TNH510/5_DOF_Robot_Arm/docs/mechatronic_project/report/tinh-toan-tai.md

# TÍNH TOÁN TẢI CHO TAY GẮP

Mục tiêu thiết kế tay gắp:

+ Cải thiện nhược điểm của tay gắp cũ: Không linh hoạt, chỉ có thể gắp vật với hình dạng cố định

+ Thông số vật cần gắp :
  
  | Hình dạng        | Kích thước ước tính | Dạng tay gắp lựa chọn     |
  | ---------------- | ------------------- | ------------------------- |
  | Hình vuông, tròn | max: 15x15x15       | Cơ cấu tay quay con trượt |

+ Tham khảo:
  
  [(PDF) Nghiên cứu thiết kế và điều khiển tay máy gắp các thùng CARTON sắp xếp lên PALLET | CƯỜNG Nguyễn Mạnh - Academia.edu](https://www.academia.edu/44552057/Nghi%C3%AAn_c%E1%BB%A9u_thi%E1%BA%BFt_k%E1%BA%BF_v%C3%A0_%C4%91i%E1%BB%81u_khi%E1%BB%83n_tay_m%C3%A1y_g%E1%BA%AFp_c%C3%A1c_th%C3%B9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)[(PDF) Nghiên cứu thiết kế và điều khiển tay máy gắp các thùng CARTON sắp xếp lên PALLET | CƯỜNG Nguyễn Mạnh - Academia.edu](https://www.academia.edu/44552057/Nghi%C3%AAn_c%E1%BB%A9u_thi%E1%BA%BFt_k%E1%BA%BF_v%C3%A0_%C4%91i%E1%BB%81u_khi%E1%BB%83n_tay_m%C3%A1y_g%E1%BA%AFp_c%C3%A1c_th%C3%B9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)

+ Link thông số động cơ: https://www.tinytronics.nl/shop/en/mechanics-and-actuators/motors/servomotors/td-8120mg-waterproof-digital-servo-20kg

+
