TNH510/5_DOF_Robot_Arm/control_glove/docs/UART_NOTE.txt

- ENTER AT MODE:
    + Connect all pins and VCC (NOT CONNECT SET PIN)
    + Connect SET PIN to GND
- Test on terminal:
    + MUST CHOOSE: Baurate 9600, Mode auto send CR+LF
    + Test: Send "AT" and wait for respone
- Exit AT MODE:
    + MUST DISCONNECT SET PIN FIRST
    + Disconnect VCC and checks
-----------------------------------------------------------
Send: AT+RX
Rp:
OK+B115200<\r><\n>
 OK+C150<\r><\n>
 OK+RP:+8dBm<\r><\n>
 OK+FU3
-------------------------------
AT
AT+P5
AT+FU1
