TNH510/5_DOF_Robot_Arm/control_glove/docs/thiet_ke_chon_bo_truyen.md

# Thiết kế bộ truyền cho khớp khủy tay găng tay điều khiển
## Yêu cầu bộ truyền
- Nhỏ gọn do cần đeo trong thời gian dài
- Chỉ cần truyền ở khoảng cách gần do chỉ cần truyền đến biến trở
- Chịu được lực gây ra khi gập và duỗi khủy tay
## Các loại bộ truyền có thể lựa chọn
- Bộ truyền xích: Cồng kềnh, không phù hợp để đeo lên tay
- Bộ truyền đai: Dễ tìm mua, nhỏ gọn tuy nhiên so với bộ truyền bánh răng thì vẫn
cồng kềnh hơn, tốn diện tích thiết kế hơn, giá thành đắt hơn
- Bộ truyền bánh răng trụ: Dễ tìm mua, nhỏ gọn dễ thiết kế
## Tính toán lựa chọn các kích thước
- Kích thước đã biết: 
  - Trục biến trở: 6mm
- Chọn trục tại vị trí khủy tay là 6mm
- Chọn bánh răng trụ đồng: [Bánh răng trụ thép](https://www.thegioiic.com/1m40t-6-banh-rang-40-rang-buoc-3-14mm-day-dai-10mm-lo-6mm) 
- Bộ truyền bánh răng có tỉ số truyền 1:1
## Vẽ mô hình 3D
