TNH510/5_DOF_Robot_Arm/control_glove/docs/general.md

## Găng tay điều khiển 
### Các thành phần cần có:
- Bộ điều khiển trung tâm: STM32F4
- Cảm biến phát hiện chuyển động: MPU6050
- Cảm biến từ trường: HMC5883L
- Pin
- Nút nhấn
- Module RF
- Găng tay
