TNH510/5_DOF_Robot_Arm/docs/final_project/thach/Content_to_be_done.md

# Những nội dung chính
## Kiến thức cơ bản
### Giới thiệu về C#
1. Sơ lược về C#
2. Ứng dụng của C#
### Giới thiệu về WPF trong C#
1. Sơ lược về WPF
2. Ứng dụng của WPF
3. Làm việc với giao diện
   - Điều khiển trên giao diện
   - Cách cài đặt thư viện
4. Làm việc với code
   - Giới thiệu về Timer
   - Giới thiệu về Luồng (Thread)
   - Giới thiệu sơ lược về cách tạo hàm tạo biến trong C#
     - Cấu trúc quản lí code
     - Các kiểu khai báo dữ liệu.
     - Các kiểu tạo hàm
