TNH510/5_DOF_Robot_Arm/docs/final_project/other/adaptive_control.md

1. Connect UART
2. Click the ENABLE button (Glove_Connect_Click function)
3. Type as format: "Xaxis","Yaxis", "Zaxis", "theta5"
4. Enjoy
