TNH510/5_DOF_Robot_Arm/docs/final_project/hieu/main_idea.md

# Những nội dung chính
## Kiến thức cơ bản
### Vi điều khiển ARM Cotex M3/M4
1. Giới thiệu về vi điều khiển ARM Cotex M
2. Ngôn ngữ lập trình C
### Cảm biến gygroscope, cảm biến gia tốc và cảm biến từ trường
1. Cảm biến Gygroscope
2. Cảm biến gia tốc
3. Cảm biến từ trường
### Biểu diễn hướng của vật thể trong không gian
1. Các góc Euler
2. Ma trận Quaternion
### Chuẩn giao tiếp UART và I2C
1. UART
2. I2C
## Thiết kế nguyên lí và cách điều khiển 
1. Các nghiên cứu trên thế giới
2. Lựa chọn giải pháp
3. Thiết kế lưu đồ giải thuật cho hệ thống
## Tính toán lựa chọn phần cứng cho găng tay điều khiển
1. Chọn lựa linh kiện chính
-  Vi điều khiển STM32F401CCU
- Cảm biến 6 trục MPU6050
- Cảm biến từ trường HMC5883L
- Biến trở
- Module UART không dây GT-38
1. Thiết kế mạch in
2. Thiết kế cơ khí 
## Quá trình thực hiện
1. Thực hiện giao tiếp giữa MCU và các cảm biến
2. Tiến hành lấy data và calib lại các cảm biến
3. Viết thuật toán lọc nhiễu và xử lí giá trị góc thu được
4. Giao tiếp không dây giữa vi điều khiển và máy tính
5. Tiến hành vẽ mạch in và in mạch thử nghiệm
6. Tiến hành chế tạo mô hình găng tay thử nghiệm
7. Thực hiện tính toán động học thuận của găng tay
8. Viết thuật toán chuyển đổi từ vị trí cánh tay sang vị trí của robot cần điều khiển
9. Tiến hành chạy thử nghiệm
10.  Cải tiến và hoàn thiện thiết kế mạch in
11.  Hoàn thiện phần thiết kế cơ khí
12.  Tối ưu hóa tín hiệu điều khiển
