TNH510/5_DOF_Robot_Arm/docs/mechatronic_project/gripper/note.md

<div align="center">
  <h1>GRIPPER RESEARCH</h1>
</div>
<div align = "justify">
<p>
    Based on the mobility of the robotic grippers, exists three main categories that classify the design of the grippers:
    - Completely constrained.
    - Underconstrained.
    - Deformable.
</p>
</div>

## 1. Completely contrained

<div align = "justify">
    <p>
        Completely constrained finger mechanisms are devices with a DOF equivalent to their number of actuators, which allows the trajectory of the tip of the finger to follow a predefined path. Note that the number of DOF is computed using the Gruebler-Kutzbach:
    </p>
</div>
<blockquote>
    <div align = "center">
        <p>M = 3L - 2J</p>
    </div>
</blockquote>
<div align = "justify">
    <p>
        Where:
        <li>M: the total DOF</li>
        <li>L: The number of the links</li>
        <li>J: The number of the joints</li>
    </p>
</div>

### 1.1. Compliant Mechanism
