TNH510/5_DOF_Robot_Arm/docs/final_project/thach/moment_robot/moment_robot.md

# Runtime (D1400 -> 1409) --> Trigger M3200(Reset error) + M600 (Relay to start runtime)
1. Send data from uart
2. Receive data with x y z and velocity
3. Velocity will be analyze
4. trigger velocity in a special memory
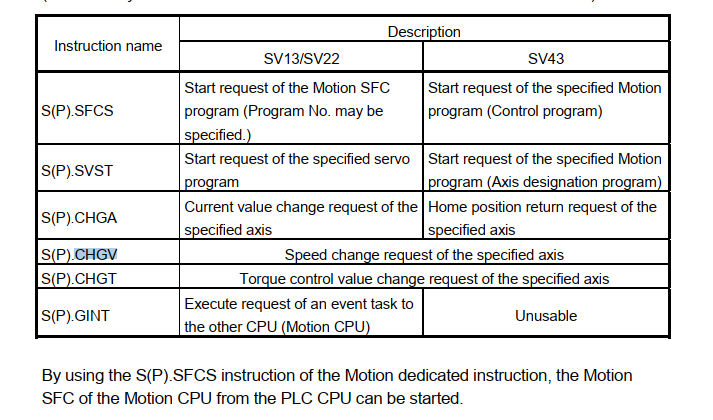
[picture p1: docs/final_project/thach/moment_robot/image.png]
5.
