TNH510/5_DOF_Robot_Arm/drawing/ban_ve_dien/PLC.pdf

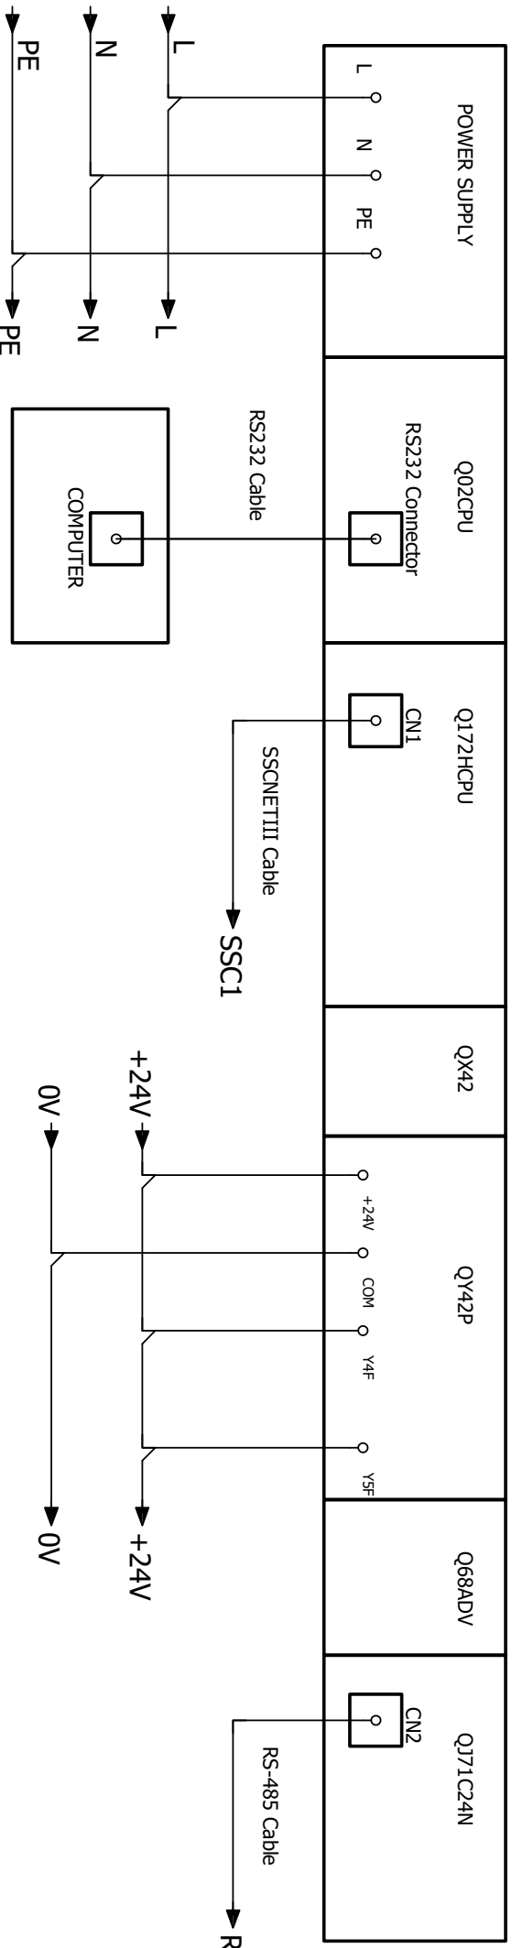
[picture p39: figure]

PLC Q02 30.12.23 Trường ĐH. SPKT TPHCM - Khoa: CKM Kiểm tra Người vẽ Gang 01.03 1:2 POWER SUPPLY Q02CPU Q172HCPU QX42 QY42P Q68ADV QJ71C24N COMPUTER RS232 Cable CN1 RS232 Connector SSCNETIII Cable CN2RS-485 Cable L N PE +24V COM Y4F Y5F PENL PENL SSC1 +24V0V 0V+24V RS-485 N.X. Quang Lê Tấn Lộc
