TNH510/5_DOF_Robot_Arm/tong_hop_ban_ve/ban_ve_thiet_bi_theo_doi_chuyen_dong/pdf/HCMUTE-0011-001.pdf

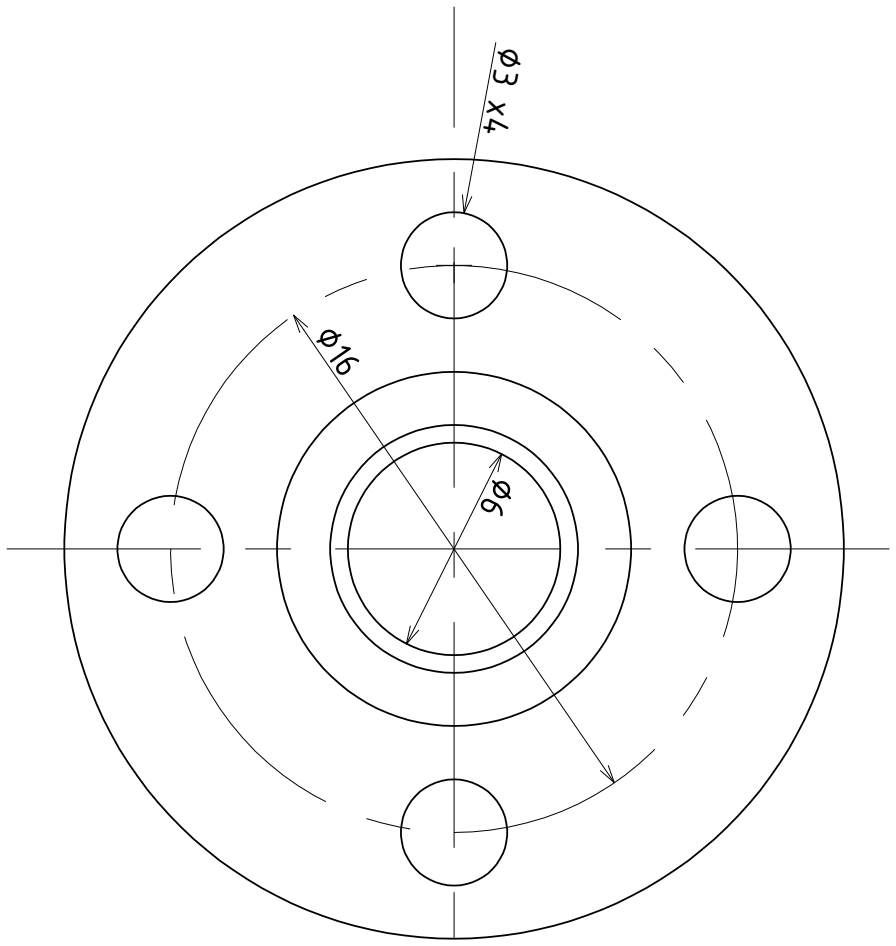
[picture p41: figure]

ĐỆM MẶT BÍCH 23.06.24 Trần Ngọc Hiểu Trường ĐH. SPKT TPHCM - Khoa: CKM Kiểm tra Người vẽ Nhựa PLA 5:1 ∅22 ∅7 ∅10 ∅3 x4 ∅6 HCMUTE-0011-001 N.X.Quang 6.3 2 ±IT13 – Các bề mặt khác: – Bề mặt bị bao: h13 – Bề mặt bao: H13 Sai lệch giới hạn của các kích thước không chỉ dẫn: Các góc bo không chỉ dẫn kích thước có bán kính 2mm ∅16
