TNH510/5_DOF_Robot_Arm/tong_hop_ban_ve/ban_ve_thiet_bi_theo_doi_chuyen_dong/pdf/HCMUTE-0013-001.pdf

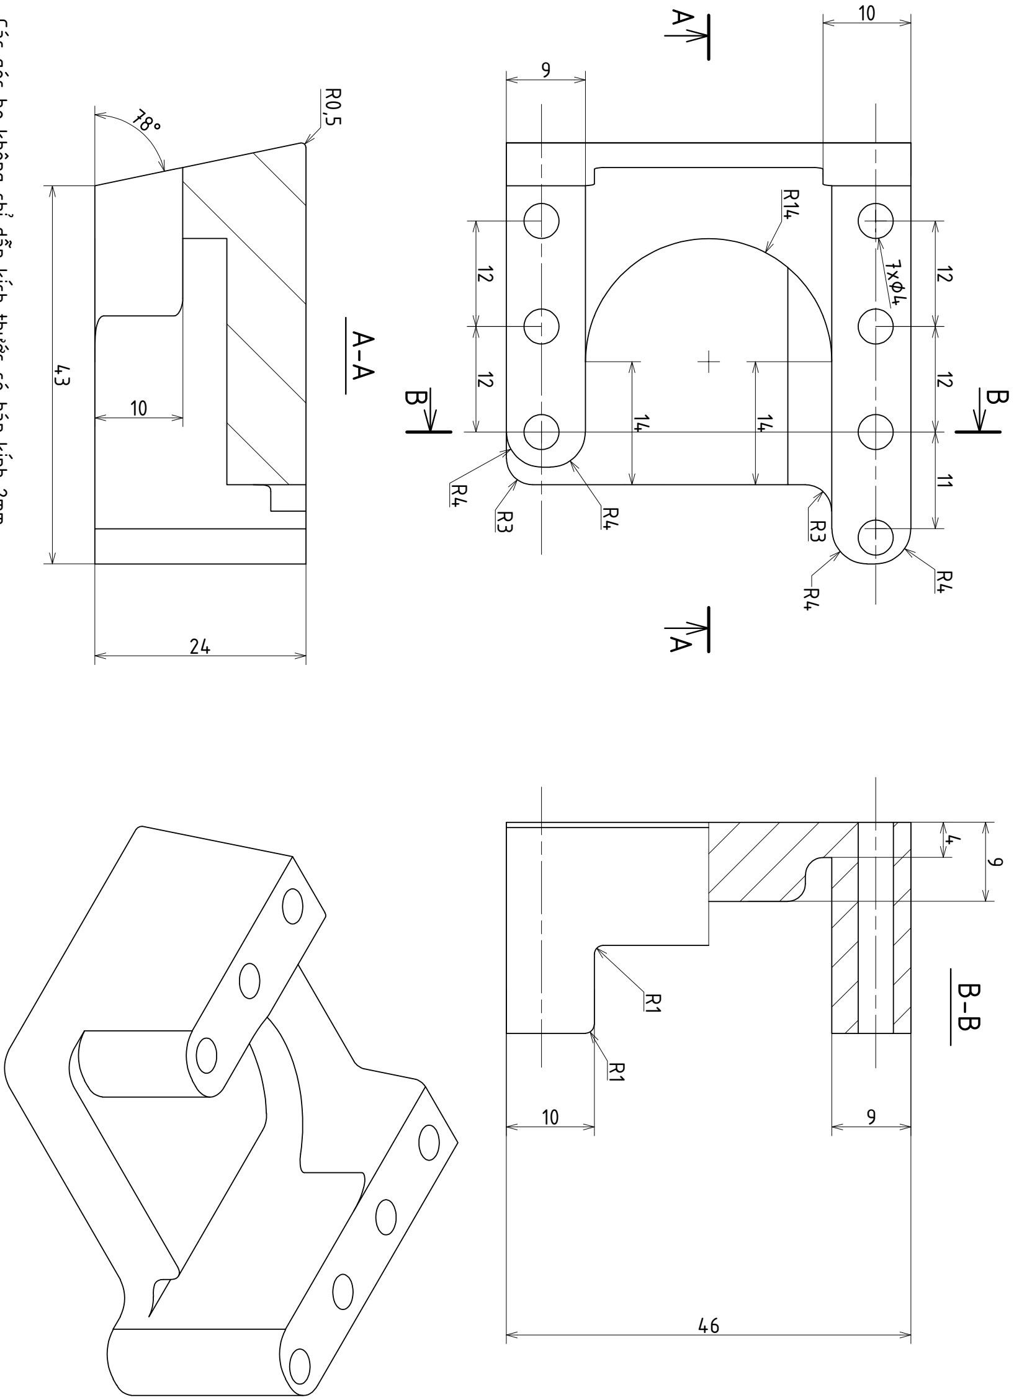
[picture p42: figure]

A A BB A-A B-B ĐỆM NỐI CẲNG TAY 23.06.24 Trần Ngọc Hiểu Trường ĐH. SPKT TPHCM - Khoa: CKM Kiểm tra Người vẽ Mica đen 2:1 HCMUTE-0013-001 N.X.Quang 6.3 2 ±IT13 – Các bề mặt khác: – Bề mặt bị bao: h13 – Bề mặt bao: H13 Sai lệch giới hạn của các kích thước không chỉ dẫn: 7x∅4 R3 R4R4 R4R4 Các góc bo không chỉ dẫn kích thước có bán kính 2mm
