TNH510/5_DOF_Robot_Arm/drawing/ban_ve_dien/New project/PLC-BANGTAI1.pdf

PLC - BĂNG TẢI 30.06.24 Trường ĐH. SPKT TPHCM - Khoa: CKM Kiểm tra Người vẽ 01.03 N.X. Quang Lê Tấn Lộc Module UART PLC S7-1214C Module IO IO-Links AL1100 Module UART to TTL Profinet RS232 Connector Module GT38 Sensor O5D150(1) Sensor O5D150(2) Bộ điều khiển băng tải Buck - Boost INOUT 0V0V 5V5V TXTX RXRX X1 X3 Q8.7 0V 24V RUN 1413 /2.6 K1 A1 A2 /6.6 14 13 /3.8 14 13 /6.7 A2A1 K1 I7.5 1413 START 0V 5V 0V 24V +24V / 4.7 0V / 4.7
