TNH510/5_DOF_Robot_Arm/docs/report/Project_report.md

# HỒ SƠ TRƯỚC VÀ TẠI BUỔI BẢO VỆ

- [ ] Poster khổ A1 đứng (594x841) được in và trưng bày tại sảnh tòa nhà khoa Cơ khí chế tạo máy (mỗi nhóm chuẩn bị 8 nam châm để gắn poster) từ ngày ... đến ...
- [ ] Trưng bày mô hình máy / máy tại sảnh tòa nhà khoa Cơ khí chế tạo máy từ ngày ... đến ...
- [ ] Thuyết minh ĐATN bìa mềm (01 cuốn, có tờ nhiệm vụ và chữ kí của GVHD)
- [ ] Báo cáo tóm tắt (05 cuốn).
- [ ] Tập bản vẽ
- [ ] Nhận xét của GVHD đã có chữ kí (SV nhận từ GVHD hoặc GVHD chuyển cho VPK trước 3 ngày hoặc GVHD trực tiếp cho thư kí hội đồng trước ngày ...)
- [ ] Nhận xét của GVPB đã có chữ kí (SV nhận từ GVPB và chuyển cho VPK hoặc GVPB đưa trực tiếp cho thư kí hội đồng trước 20/3/2024)
- [ ] Phiếu chấm điểm dành cho các thành viên của hội đồng bảo vệ (đã điền sẵn thông tin về sinh viên, tên đề tài và in theo số lượng thành viên hội đồng)
# HỒ SƠ SAU BẢO VỆ
- [ ] Sinh viên sửa chữa thuyết minh, bản vẽ, báo cáo tóm tắt theo yêu cầu của GVPB và hội đồng. Chuẩn bị biên bản chỉnh sửa xin chữ kí xác nhận của GVHD.
- [ ] Chuẩn bị 02 bộ hồ sơ đặt trogn túi nilon đựng hồ sơ bao gồm:
> - [ ] Thuyết minh ĐATN đóng bìa mạ vàng, 
> - [ ] Tập bản vẽ tóm tắt, 
> - [ ] Biên bản chỉnh sửa ĐATN. 
> - [ ] Bên ngoài túi nilon đựng hồ sơ dán tờ thông tin đề tài như biểu mẫu hướng dẫn.
- [ ] Sinh viên nộp 01 bộ hồ sơ cho thư viện, nhận giấy xác nhận đã nộp ĐATN từ thư viện
- [ ] Sinh viên nộp 01 bộ hồ sơ, giấy xác nhận đã nộp ĐATN của thư viện cho GVHD chậm nhất đến ngày ...
