TNH510/5_DOF_Robot_Arm/video_link/link_video_do_an_tot_nghiep.md

# Link video đồ án tốt nghiệp
[Link Google Drive](https://drive.google.com/drive/folders/1jYKLXKs6jVpjPCr_2RwzEJFNu_sJjdsJ?usp=sharing)
