TNH510/5_DOF_Robot_Arm/docs/final_project/thach/WPF.md

# Những nội dung chính
## Thiết kế, lập trình giao diện hệ thống với WPF
Lí do chọn PLC trong việc điều khiển robot
- Tầm quan trọng của PLC trong công nghiệp
- Khả năng của PLC trong điều khiển robot.
## Viết chương trình điều khiển cho robot
1. **Giới thiệu tổng quan về C# và Q02HCPU**
   1. Cách cấu hình thông qua phần mềm Communication Setup Utility
   2. Thư viện hỗ trợ
   3. Chức năng cơ bản
   4. Các hàm cơ bản

## Giới thiệu về giao diện WPF trong C#
1. **Sơ lược về WPF**
2. **Ứng dụng của WPF**
3. **Làm việc với giao diện điều khiển**
   - Điều khiển trên giao diện
   - Cách cài đặt thư viện.
4. **Làm việc với code**
   - Giới thiệu về Timer.
   - Giới thiệu về Luồng (Thread).
   - Giới thiệu sơ lược về cấu trúc chương trình.
     - Cấu trúc quản lí code.
     - Các kiểu khai báo dữ liệu.
