TNH510/5_DOF_Robot_Arm/docs/mechatronic_project/report/chuong_6_thach.docx

BỘ GIÁO DỤC VÀ ĐÀO TẠO

TRƯỜNG ĐẠI HỌC SƯ PHẠM KỸ THUẬT THÀNH PHỐ HỒ CHÍ MINH

KHOA CƠ KHÍ CHẾ TẠO MÁY


ĐỒ ÁN CƠ ĐIỆN TỬ

Đề tài: “NGHIÊN CỨU, PHÁT TRIỂN TAY MÁY 5 BẬC TỰ DO ỨNG DỤNG TRONG BỐC XẾP”

GVHD: TS. NGUYỄN XUÂN QUANG

SVTH: TRẦN NGỌC HIỂU

MSSV: 20146127

SVTH: NGUYỄN BÁ VŨ THẠCH

MSSV: 20146530

SVTH: LÊ TẤN LỘC

MSSV: 20146121

Tp. Hồ Chí Minh, tháng 12/2023

TRƯỜNG ĐẠI HỌC SƯ PHẠM KỸ THUẬT THÀNH PHỐ HỒ CHÍ MINH

KHOA CƠ KHÍ CHẾ TẠO MÁY

BỘ MÔN CƠ ĐIỆN TỬ

Không có mô tả ảnh.

ĐỒ ÁN CƠ ĐIỆN TỬ

Đề tài: “NGHIÊN CỨU, PHÁT TRIỂN TAY MÁY 5 BẬC TỰ DO ỨNG DỤNG TRONG BỐC XẾP”

GVHD: TS. NGUYỄN XUÂN QUANG

SVTH: TRẦN NGỌC HIỂU

MSSV: 20146127

SVTH: NGUYỄN BÁ VŨ THẠCH

MSSV: 20146530

SVTH: LÊ TẤN LỘC

MSSV: 20146121

Tp. Hồ Chí Minh, tháng 12/2023

TRƯỜNG ĐẠI HỌC SƯ PHẠM KỸ THUẬT TP.HCM

KHOA CƠ KHÍ CHẾ TẠO MÁY

Bộ môn: Cơ điện tử

CỘNG HÒA XÃ HỘI CHỦ NGHĨA VIỆT NAM

Độc lập – Tự do – Hạnh phúc

# NHIỆM VỤ ĐỒ ÁN CƠ ĐIỆN TỬ

Học kỳ I/ Năm học 2023 – 2024

Giảng viên hướng dẫn: TS. Nguyễn Xuân Quang

Sinh viên thực hiện:

1. Trần Ngọc Hiểu. MSSV: 20146127. Điện thoại: 0328743450.
2. Nguyễn Bá Vũ Thạch. MSSV: 20146530. Điện thoại: ….
3. Lê Tấn Lộc. MSSV: 20146121. Điện thoại: ….
1. Mã số đề tài: …
- Tên đề tài: Nghiên cứu phát triển tay máy 5 bậc tự do ứng dụng trong bốc xếp.
2. Các số liệu, tài liệu ban đầu

Nguyên lý hoạt động: Tay máy 5 bậc tự do được sử dụng để bốc các sản phẩm hình hộp chữ nhật với nhiều kích thước khác nhau chuyển từ hệ thống băng tải này sang băng tải khác, quỹ đạo chuyển động của tay máy được điều khiển từ máy tính.

Chức năng: Gắp và xếp có chọn lọc các loại sản phẩm.

Yêu cầu kỹ thuật:

- Tay máy có thể gắp các sản phẩm hình hộp chữ nhật với đa dạng kích thước.
- Có thể hoạt động dựa trên chương trình được lập trình từ trước bởi người dùng.
3. Nội dung chính của đồ án

Hoàn thiện bản vẽ cơ khí, bản vẽ điện, tính toán động học, động lực học, viết chương trình điều khiển và giám sát trên máy tính.

Thiết kế lại tay gắp của robot.

4. Các sản phẩm dự kiến

Tay máy 5 bậc tự do và găng tay điều khiển.

5. Ngày giao đồ án: 30/09/2023
6. Ngày nộp đồ án: 05/01/2024
7. Ngôn ngữ trình bày: Bản báo cáo: Tiếng Anh ☐ Tiếng Việt ☐

Trình bày bảo vệ: Tiếng Anh ☐ Tiếng Việt ☐

TRƯỞNG KHOA TRƯỞNG BỘ MÔN GIẢNG VIÊN HƯỚNG DẪN

(Ký, ghi rõ họ tên) (Ký, ghi rõ họ tên) (Ký, ghi rõ họ tên)

☐ Được phép bảo vệ: ............................................

(GVHD ký, ghi rõ họ tên)

TRƯỜNG ĐẠI HỌC SƯ PHẠM KỸ THUẬT TP.HCM

KHOA CƠ KHÍ CHẾ TẠO MÁY

Bộ môn: Cơ điện tử

CỘNG HÒA XÃ HỘI CHỦ NGHĨA VIỆT NAM

Độc lập – Tự do – Hạnh phúc

# PHIẾU NHẬN XÉT ĐỒ ÁN CƠ ĐIỆN TỬ

(Dành cho giảng viên hướng dẫn)

Họ tên sinh viên:

Trần Ngọc Hiểu :20146127

Nguyễn Bá Vũ Thạch :20146530

Lê Tấn Lộc :20146121

- Tên đề tài: Nghiên cứu phát triển tay máy 5 bậc tự do ứng dụng trong bốc xếp.

Ngành đào tạo: Công nghệ kỹ thuật cơ điện tử.

Giảng viên hướng dẫn: Nguyễn Xuân Quang

Ý KIẾN NHẬN XÉT

1. Nhận xét về tinh thần, thái độ làm việc của sinh viên.
2. Nhận xét về kết quả thực hiện của đồ án cơ điện tử
  2.1. Kết cấu, cách thức trình bày đồ án cơ điện tử

………………………………………………………………………………………………………………………………………………………………………………………………………………………………………………………………………………....................................

  2.2. Nội dung đồ án cơ điện tử

………………………………………………………………………………………………………………………………………………………………………………………………………………………………………………………………………………....................................

  2.3. Kết quả đạt được

………………………………………………………………………………………………………………………………………………………………………………………………………………………………………………………………………………....................................

  2.4. Những tồn tại (nếu có)

………………………………………………………………………………………………………………………………………………………………………………………………………………………………………………………………………………....................................

3. Đánh giá

TT | Mục đánh giá | Điểm tối đa | Điểm đạt được
1. | Hình thức và kết cấu ĐACĐT | 30
| Đúng format với đầy đủ cả hình thức và nội dung của các mục | 10
| Mục tiêu, nhiệm vụ, tổng quan của đề tài | 10
| Tính cấp thiết của đề tài | 10
2. | Nội dung ĐACĐT | 50
| Khả năng ứng dụng kiến thức toán học, khoa học và kỹ thuật, khoa học xã hội… | 5
| Khả năng thực hiện/phân tích/tổng hợp/đánh giá | 10
| Khả năng thiết kế chế tạo một hệ thống, thành phần, hoặc quy trình đáp ứng yêu cầu đưa ra với những ràng buộc thực tế. | 15
| Khả năng cải tiến và phát triển | 5
| Khả năng sử dụng công cụ kỹ thuật, phần mềm chuyên ngành… | 5
3. | Đánh giá về khả năng ứng dụng của đề tài. | 10
4. | Sản phẩm cụ thể của ĐACĐT | 10
| Tổng | 100

4. Kết luận:

☐ Được phép bảo vệ

☐ Không được phép bảo vệ

TP.HCM, ngày.....tháng.....năm

Giảng viên hướng dẫn

(Ký, ghi rõ họ tên)

TRƯỜNG ĐẠI HỌC SƯ PHẠM KỸ THUẬT TP.HCM

KHOA CƠ KHÍ CHẾ TẠO MÁY

Bộ môn: Cơ điện tử

CỘNG HÒA XÃ HỘI CHỦ NGHĨA VIỆT NAM

Độc lập – Tự do – Hạnh phúc

# PHIẾU NHẬN XÉT ĐỒ ÁN CƠ ĐIỆN TỬ

(Dành cho giảng viên phản biện)

Họ tên sinh viên:

Trần Ngọc Hiểu Trần :20146127

Nguyễn Bá Vũ Thạch :20146530

Lê Tấn Lộc :20146121

Tên đề tài: Nghiên cứu phát triển tay máy 5 bậc tự do ứng dụng trong bốc xếp.

Ngành đào tạo: Công nghệ kỹ thuật cơ điện tử.

Giảng viên hướng dẫn: Nguyễn Xuân Quang

Ý KIẾN NHẬN XÉT

1. Nhận xét về tinh thần, thái độ làm việc của sinh viên.
2. Nhận xét về kết quả thực hiện của đồ án cơ điện tử
  2.1. Kết cấu, cách thức trình bày đồ án cơ điện tử

………………………………………………………………………………………………………………………………………………………………………………………………………………………………………………………………………………....................................

  2.2. Nội dung đồ án cơ điện tử

………………………………………………………………………………………………………………………………………………………………………………………………………………………………………………………………………………....................................

  2.3. Kết quả đạt được

………………………………………………………………………………………………………………………………………………………………………………………………………………………………………………………………………………....................................

  2.4. Những tồn tại (nếu có)

………………………………………………………………………………………………………………………………………………………………………………………………………………………………………………………………………………....................................

3. Đánh giá

TT | Mục đánh giá | Điểm tối đa | Điểm đạt được
1. | Hình thức và kết cấu ĐACĐT | 30
| Đúng format với đầy đủ cả hình thức và nội dung của các mục | 10
| Mục tiêu, nhiệm vụ, tổng quan của đề tài | 10
| Tính cấp thiết của đề tài | 10
2. | Nội dung ĐACĐT | 50
| Khả năng ứng dụng kiến thức toán học, khoa học và kỹ thuật, khoa học xã hội… | 5
| Khả năng thực hiện/phân tích/tổng hợp/đánh giá | 10
| Khả năng thiết kế chế tạo một hệ thống, thành phần, hoặc quy trình đáp ứng yêu cầu đưa ra với những ràng buộc thực tế. | 15
| Khả năng cải tiến và phát triển | 5
| Khả năng sử dụng công cụ kỹ thuật, phần mềm chuyên ngành… | 5
3. | Đánh giá về khả năng ứng dụng của đề tài. | 10
4. | Sản phẩm cụ thể của ĐACĐT | 10
| Tổng | 100

4. Kết luận:

☐ Được phép bảo vệ

☐ Không được phép bảo vệ

TP.HCM, ngày.....tháng.....năm

Giảng viên phản biện

(Ký, ghi rõ họ tên)

# LỜI CẢM ƠN

Lời đầu tiên nhóm xin gửi lời cảm ơn sâu sắc đối với thầy hướng dẫn đề tài là thầy Nguyễn Xuân Quang đã luôn đồng hành với nhóm trong quãng thời gian một học kỳ vừa qua. Thầy đã kịp thời có những giúp đỡ, sự định hướng và giải đáp những thắc mắc của nhóm trong lúc khó khăn khi thực hiện đồ án "Tay máy 5 bậc tự do và điều khiển chuyển động bằng cử động tay ứng dụng trong xếp sản phẩm".

Bên cạnh đó nhóm cũng xin cảm ơn các thầy cô thuộc khoa Cơ khí Chế tạo máy đã tận tình chỉ dẫn, trang bị những kiến thức cần thiết cho chúng em ngay từ khi bước vào giảng đường đại học đến nay. Những kiến thức đó là nền tảng rất quý báu và hữu ích, được sử dụng trong đồ án này.

Tuy nhiên vì kiến thức chuyên môn và mỗi cá nhân trong nhóm còn thiếu kinh nghiệm thực tế nên đề tài không tránh khỏi những thiếu sót. Nhóm rất mong được sự góp ý, chỉ bảo thêm của quý thầy cô để bài báo cáo này hoàn thiện hơn.

Cuối cùng, nhóm xin một lần nữa gửi lời cảm ơn chân thành đến Quý thầy cô.

TP.Hồ Chí Minh, tháng 12 năm 2023

Sinh viên thực hiện

Trần Ngọc Hiểu

Nguyễn Bá Vũ Thạch

Lê Tấn Lộc

# TÓM TẮT ĐỀ TÀI

Sự xuất hiện của robot đã tạo nên một cuộc cách mạng thay đổi cuộc sống của con người nói chung và nền công nghiệp nói riêng.

Trong nhận thức của nhiều người, hình ảnh robot là những chú robot với trí thông minh nhân tạo, có thể giao tiếp, giúp đỡ việc nhà, bán hàng trong siêu thị, chăm sóc các cụ già hay trông trẻ…

Nhưng robot cũng có vai trò đặc biệt quan trọng trong công nghiệp và sự xuất hiện ngày một nhiều của robot trong những ngành công nghiệp, chế tạo, lắp ráp và sản xuất hiện đại ở khắp các nhà máy, công xưởng trên thế giới, giúp tiết kiệm nhân công và chi phí vận hành, tăng năng suất lao động.

Một trong những robot phổ biến nhất trong thế giới sản xuất là cánh tay robot. Cánh tay robot trong hầu hết các trường hợp được lập trình và sử dụng để thực hiện các nhiệm vụ cụ thể, phổ biến nhất cho sản xuất, chế tạo và các ứng dụng công nghiệp.

Tuy nhiên, ở Việt Nam chỉ mới có thể lắp ráp chứ chưa thể thiết kế và chế tạo được một cánh tay robot như nước ngoài. Vì vậy nhóm thực hiện đề tài này để giải quyết bài toán về thiết kế, chế tạo một cánh tay robot có thể điều khiển bằng cử động tay ứng dụng trong xếp các sản phẩm như các loại hộp.

# CHƯƠNG 1: GIỚI THIỆU CHUNG

## 1.1. Tính cấp thiết của đề tài

Tác động của cánh tay robot công nghiệp trong ngành sản xuất ngày càng lớn với ưu điểm tiết kiệm chi phí, năng suất và hiệu quả cao hơn. Nhiều công ty có cánh tay robot có thể tiết kiệm chi phí như lao động tay nghề thấp, ít lãng phí và sai sót của con người. Ở một số khu vực, các cánh tay robot có thể lấp đầy các vị trí mà nhà tuyển dụng yêu cầu.

Tuy nhiên, hiện nay các cánh tay robot được áp dụng trong các dây chuyền sản xuất ở Việt Nam đều được nhập nguyên con từ nước ngoài hoặc mua linh kiện nước ngoài và lắp ráp ở Việt Nam. Một số hãng thường hay gặp trên thị trường có thể kể đến là ABB/Fanuc/Yaskawa. Và thường thì chúng sẽ hoạt động trên một quy trình cho trước cố định.

Trên cơ sở đó, nhóm đã thực hiện đồ án này với mong muốn có thể thiết kế, chế tạo một cánh tay robot "Made in Vietnam” có thể đáp ứng tốt các yêu cầu khi xếp, dỡ hàng hóa, gắp sản phẩm với hiệu quả gần như cánh tay nhập ngoại. Bên cạnh đó, cánh tay không chỉ được điều khiển theo chu trình có sẵn mà còn có thể được điều khiển thông qua thao tác tay của người vận hành.

## 1.2. Mục tiêu đề tài

- Chọn cấu hình cánh tay robot thích hợp với yêu cầu đặt ra.

- Tính toán bài toán động học tay máy.

- Tính toán bài toán động lực học tay máy.

- Xây dựng hệ thống điều khiển cánh tay robot.

- Xây dựng giao diện điều khiển, giám sát hoạt động cánh tay robot.

## 1.3. Giới hạn đề tài

Tay máy 5 bậc tự do được sử dụng để bốc các sản phẩm hình hộp chữ nhật chuyển từ hệ thống băng tải này sang băng tải hệ thống băng tải khác với quỹ đạo chuyển động của tay máy được điều khiển dựa vào phần mềm trên máy tính.

+ Hình dạng: Hình hộp chữ nhật

+ Vật liệu: Hộp bìa giấy

+ Kích thước: Có ít nhất chiều rộng hoặc chiều dài không quá 140 mm, 2 chiều còn lại không quá 300 mm

## 1.4. Kết cấu của đồ án cơ điện tử

Nội dung báo cáo gồm 8 chương:

- Chương 1: Giới thiệu
- Chương 2: Cơ sở lý thuyết
- Chương 3: Động học và động lực học tay máy
- Chương 4: Tính toán, thiết kế phần cơ khí
- Chương 5: Thiết kế hệ thống điều khiển bằng PLC
- Chương 6: Thiết kế ứng dụng giám sát và ứng dụng điều khiển
- Chương 7: Kết quả, nhận xét, hướng phát triển

# CHƯƠNG 2: CƠ SỞ LÝ THUYẾT

## 2.1. Cơ sở lý thuyết về công nghệ

## 2.2 Cơ sở lý thuyết về cơ khí

## 2.3 Cơ sở lý thuyết về điện điện tử

## 2.4 Cơ sở lý thuyết về lập trình giao diện

# CHƯƠNG 3: NGHIÊN CỨU ĐỘNG HỌC VÀ ĐỘNG LỰC HỌC TAY MÁY

# Tính toán

# Mô phỏng MATLAB

## 3.1. Động học vị trí

## 3.1.1 Động học thuận

Sơ đồ động robot

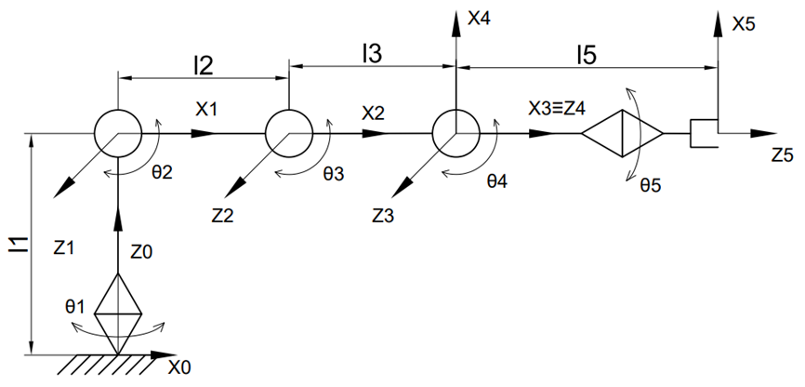
[picture p45: figure]

Hình 3.1: Sơ đồ động robot

Bảng DH

Khâu | θ | l | α | d | Biến
1 | θ1 | 0 | π/2 | l1 | θ1
2 | θ2 | l2 | 0 | 0 | θ2
3 | θ3 | l3 | 0 | 0 | θ3
4 | θ4 + π/2 | 0 | π/2 | 0 | θ4
5 | θ5 | 0 | 0 | l5 | θ5

Bảng 3.1: Bảng Denavit–Hartenberg của robot

Các ma trận chuyển trục và động học thuận

Ma trận chuyển trục Ai:

A_i = [c_i , -γ_i s_i , σ_i s_i , l_i c_i s_i , γ_i c_i , -σ_i c_i , l_i s_i 0, σ_i , γ_i , d_i 0, 0, 0, 1] (1)

A_1 = [c_1 , 0, s_1 , 0s_1 , 0, -c_1 , 00, 1, 0, l_1 0, 0, 0, 1] A_2 = [c_2 , -s_2 , 0, l_2 c_2 s_2 , c_2 , 0, l_2 s_2 0, 0, 1, 00, 0, 0, 1]

A_3 = [c_3 , -s_3 , 0, l_3 c_3 s_3 , c_3 , 0, l_3 s_3 0, 0, 1, 00, 0, 0, 1] A_4 = [-s_4 , 0, c_4 , 0c_4 , 0, s_4 , 00, 1, 0, 00, 0, 0, 1]

A_5 = [c_5 , -s_5 , 0, 0s_5 , c_5 , 0, 00, 0, 1, l_5 0, 0, 0, 1]

⁰T5 = A1 A2 A3 A4 A5

= [s_1 s_5 -s_234 c_1 c_5 , c_5 s_1 +s_234 c_1 s_5 , c_234 c_1 , c_1 (l_3 c_23 +l_2 c_2 +l_5 c_234 )-s_234 c_5 s_1 -c_1 s_5 , -c_1 c_5 +s_234 s_1 s_5 , c_234 s_1 , s_1 (l_3 c_23 +l_2 c_2 +l_5 c_234 )c_234 c_5 , -c_234 s_5 , s_234 , l_1 +l_3 s_23 +l_2 s_2 +l_5 s_234 0, 0, 0, 1] (2)

Theo động học thuận, tọa độ điểm P là:

{P_x = cosθ_1 (l_3 cos(θ_2 +θ_3 )+l_2 cosθ_2 +l_5 cos(θ_2 +θ_3 +θ_4 ))P_y = sinθ_1 (l_3 cos(θ_2 +θ_3 )+l_2 cosθ_2 +l_5 cos(θ_2 +θ_3 +θ_4 ))P_z = l_1 +l_3 sin(θ_2 +θ_3 )+l_2 sinθ_2 +l_5 sin(θ_2 +θ_3 +θ_4 )

Mô phỏng MATLAB

- Các giới hạn của các khớp
- Không gian hoạt động

## 3.2. Động học nghịch

Giá trị đầu vào Px, Py, Pz, φ, γ

{, P_x = cosθ_1 (l_3 cos(θ_2 +θ_3 )+l_2 cosθ_2 +l_5 cos(θ_2 +θ_3 +θ_4 ))P_y = sinθ_1 (l_3 cos(θ_2 +θ_3 )+l_2 cosθ_2 +l_5 cos(θ_2 +θ_3 +θ_4 ))P_z = l_1 +l_3 sin(θ_2 +θ_3 )+l_2 sinθ_2 +l_5 sin(θ_2 +θ_3 +θ_4 ) , , φ=θ_1 +θ_5 , γ=θ_2 +θ_3 +θ_4

(P_x)/(P_y)=(cosθ_1)/(sinθ_1)

⇒ θ_1 =atan2(P_y ,P_x ) (4)

⇒ θ_5 =φ-θ_1

Đặt

m=√(P_x^2 +P_y^2) -l_5 cos(θ_2 +θ_3 +θ_4 )=l_3 cos(θ_2 +θ_3 )+l_2 cosθ_2

n=P_z -l_1 -l_5 sin(θ_2 +θ_3 +θ_4 )=l_3 sin(θ_2 +θ_3 )+l_2 sinθ_2

m^2 +n^2 =l_3 ^2 +l_2 ^2 +2l_3 l_2 cosθ_3

⇒cosθ_3 =(m^2 +n^2 -l_3 ^2 -l_2 ^2)/(2l_3 l_2)

⇒sinθ_3 =±√(1-(cosθ_3 )^2)

⇒ θ_3 =atan2(sinθ_3 ,cosθ_3 ) (5)

{, m=l_3 cos(θ_2 +θ_3 )+l_2 cosθ_2 =cosθ_2 (l_3 cosθ_3 +l_2 )+sinθ_2 (-l_3 sinθ_3 ), n=l_3 sin(θ_2 +θ_3 )+l_2 sinθ_2 =cosθ_2 (l_3 sinθ_3 )+sinθ_2 (l_3 cosθ_3 +l_2 )

[mn]=[l_3 cosθ_3 +l_2 , -l_3 sinθ_3 l_3 sinθ_3 , l_3 cosθ_3 +l_2 ][cosθ_2 sinθ_2 ]

⇒cosθ_2 =(m(l_3 cosθ_3 +l_2 )+n(l_3 sinθ_3 ))/D

sinθ_2 =(n(l_3 cosθ_3 +l_2 )-m(l_3 sinθ_3 ))/D

⇒ θ_2 =atan2(sinθ_2 ,cosθ_2 ) (6)

⇒ θ_4 =β-θ_2 -θ_3

3.2 Động học vận tốc

3.2.1 Động học thuận

Ma trận Jacobian vận tốc dài của khâu

J_(v1) =[0, 0, 00, 0, 00, 0, 0 0, 00, 00, 0] (22)

J_(v2) =[-l_(c2) c_2 s_1 , -l_(c2) c_1 s_2 , 0l_(c2) c_1 c_2 , -l_(c2) s_1 s_2 , 00, l_(c2) c_2 , 0 0, 00, 00, 0] (23)

J_(v3) =[-s_1 (l_(c3) c_23 +l_2 c_2 ), -c_1 (l_(c3) s_23 +l_2 s_2 ), -l_(c3) s_23 c_1 c_1 (l_(c3) c_23 +l_2 c_2 ), -s_1 (l_(c3) s_23 +l_2 s_2 ), -l_(c3) s_23 s_1 0, l_(c3) c_23 +l_2 c_2 , l_(c3) c_23 0, 00, 00, 0] (24)

J_(v4) =[-s_1 (l_3 c_23 +l_2 c_2 +l_(c4) c_234 ), -c_1 (l_3 s_23 +l_2 s_2 +l_(c4) s_234 ), -c_1 (l_3 s_23 +l_(c4) s_234 )c_1 (l_3 c_23 +l_2 c_2 +l_(c4) c_234 ), -s_1 (l_3 s_23 +l_2 s_2 +l_(c4) s_234 ), -s_1 (l_3 s_23 +l_(c4) s_234 )0, l_3 c_23 +l_2 c_2 +l_(c4) c_234 , l_3 c_23 +l_(c4) c_234 -l_(c4) s_234 c_1 , 0-l_(c4) s_234 s_1 , 0l_(c4) c_234 , 0]

(25)

J_(v5) =[-s_1 (l_3 c_23 +l_2 c_2 +l_(c5) c_234 ), -c_1 (l_3 s_23 +l_2 s_2 +l_(c5) s_234 ), -c_1 (l_3 s_23 +l_(c5) s_234 )c_1 (l_3 c_23 +l_2 c_2 +l_(c5) c_234 ), -s_1 (l_3 s_23 +l_2 s_2 +l_(c5) s_234 ), -s_1 (l_3 s_23 +l_(c5) s_234 )0, l_3 c_23 +l_2 c_2 +l_(c5) c_234 , l_3 c_23 +l_(c5) c_234 -l_(c5) s_234 c_1 , 0-l_(c5) s_234 s_1 , 0l_(c5) c_234 , 0]

(26)

Vận tốc góc khâu

⁰ ω_i =ω_1 +R_1 ω_2 +…+R_(i-1) ω_i

ω_1 =[00θ_1 ] ; ω_2 =[00θ_2 ] ; ω_3 =[00θ_3 ] ; ω_4 =[00θ_4 ] ; ω_5 =[00θ_5 ] (27)

⁰ ω_1 =[00θ_1 ] ; ⁰ ω_2 =[θ_2 s_1 -θ_2 c_1 θ_1 ] ; ⁰ ω_3 =[(θ_2 +θ_3 )s_1 -(θ_2 +θ_3 )c_1 θ_1 ] ; ⁰ ω_4 =[-(θ_2 +θ_3 +θ_4 )s_1 (θ_2 +θ_3 +θ_4 )c_1 θ_1 ] ;

⁰ ω_5 =[-(θ_2 +θ_3 +θ_4 )s_1 +θ_5 c_234 c_1 (θ_2 +θ_3 +θ_4 )c_1 +θ_5 c_234 s_1 θ_1 +θ_5 s_234 ] ; (28)

Ma trận Jacobian vận tốc góc của khâu

J_(ω1) =[0, 0, 00, 0, 01, 0, 0 0, 00, 00, 0] ; J_(ω2) =[0, s_1 , 00, -c_1 , 01, 0, 0 0, 00, 00, 0] ; J_(ω3) =[0, s_1 , s_1 0, -c_1 , -c_1 1, 0, 0 0, 00, 00, 0] ;

J_(ω4) =[0, s_1 , s_1 0, -c_1 , -c_1 1, 0, 0 s_1 , 0-c_1 , 00, 0] ; J_(ω5) =[0, s_1 , s_1 0, -c_1 , -c_1 1, 0, 0 s_1 , c_234 c_1 -c_1 , c_234 s_1 0, s_234 ] ; (29)

## 3.3. Động lực học

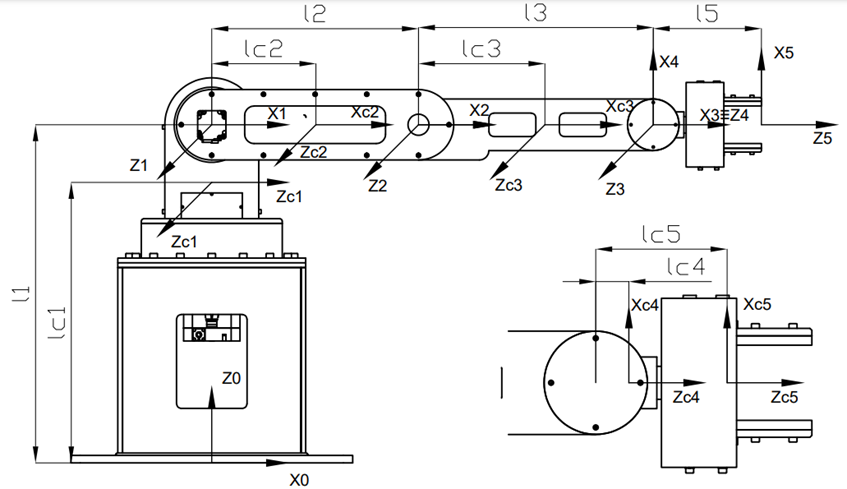
[picture p46: figure]

Hình 3.2: Sơ đồ tính động học robot

Phương trình động lực học

τ_k =∑_j d_(kj) q_j +∑_(i,j) ((∂d_(kj))/(∂q_i)-1/2(∂d_(ij))/(∂q_k))q_i q_j -(∂P)/(∂q_k) (8)

Hoặc

τ=D(q)q+V(q,q)+G(q) (9)

Với

q = [θ1 θ2 θ3 θ4 θ5]T (10)

q=[θ_1 θ_2 θ_3 θ_4 θ_5 ] T (11)

q=[θ_1 θ_2 θ_3 θ_4 θ_5 ] T (12)

(13)

Jvi là ma trận Jacobian vận tốc dài của khâu i

Jωi là ma trận Jacobian vận tốc góc của khâu i

Ri = ⁰Ri là ma trận biểu diễn hướng của hệ trục đặt ở trọng tâm khâu i

Ii là ma trận quán tính của khâu i

Thế năng P=∑_(i=1)^n g^T r_(ci) m_i (14)

g = [0 0 g]T là vectơ gia tốc trọng trường với g ≈ 9,81 m/s²

Tại tâm khối lượng của khâu i đặt hệ trục tọa độ c thứ i. Hệ trục tọa độ c thứ i có ba trục xci yci zci song song với ba trục xi yi zi của hệ trục tọa độ thứ i. Do đó ma trận biểu diễn hướng của hệ trục đặt tại độ c thứ i bằng với ma trận chỉ hướng của hệ trục tọa độ thứ i.

Ma trận biểu diễn hướng của hệ trục đặt ở trọng tâm khâu

R_1 =[c_1 , 0, s_1 s_1 , 0, -c_1 0, 1, 0] ; R_2 =[c_1 c_2 , -c_1 s_2 , s_1 s_1 c_2 , -s_1 s_2 , -c_1 s_2 , c_2 , 0] ; R_3 =[c_1 c_23 , -c_1 s_23 , s_1 s_1 c_23 , -s_1 s_23 , -c_1 s_23 , c_23 , 0]

R_4 =[-c_1 s_234 , s_1 , c_1 c_234 -s_1 s_234 , -c_1 , s_1 c_234 c_234 , 0, s_234 ] ;

R_5 =[s_1 s_5 -s_234 c_1 c_5 , s_1 c_5 +s_234 c_1 s_5 , c_234 c_1 -c_1 s_5 -s_234 s_1 c_5 , -c_1 c_5 +s_234 s_1 s_5 , c_234 s_1 c_234 c_5 , -c_234 s_5 , s_234 ] (15

Ma trận moment quán tính khâu trong hệ tọa độ đặt ở trọng tâm khâu

I=[I_(xx) , I_(xy) , I_(xz) I_(yx) , I_(yy) , I_(yz) I_(zx) , I_(zy) , I_(zz) ] (16)

Với

I_(xy) =I_(yx) (17)

I_(xz) =I_(zx) (18)

I_(yz) =I_(zy) (19)

Xem khâu 2,3,4 có dạng thanh thẳng tiết diện ngang không đáng kể; khâu 1,5 có dạng hình trụ tròn ⇒ I_(xy) =I_(yx) = I_(xz) =I_(zx) = I_(yz) =I_(zy) = 0

I_1 =[I_(xx1) , 0, 00, I_(yy1) , 00, 0, I_(xx1) ] ; I_2 =[0, 0, 00, I_(yy2) , 00, 0, I_(yy2) ] ; I_3 =[0, 0, 00, I_(yy3) , 00, 0, I_(yy3) ] ;

I_4 =[I_(yy4) , 0, 00, I_(yy4) , 00, 0, 0] ; I_5 =[I_(yy5) , 0, 00, I_(yy5) , 00, 0, I_(zz5) ] (20)

Ma trận biểu diễn vị trí trọng tâm khâu trong hệ tọa độ cơ sở

p_(c1) =[00l_(c1) ] ; p_(c2) =[l_(c2) c_1 c_2 l_(c2) s_1 c_2 l_1 +l_(c2) s_2 ] ; p_(c3) =[c_1 (l_(c3) c_23 +l_2 c_2 )s_1 (l_(c3) c_23 +l_2 c_2 )l_1 +l_(c3) s_23 +l_2 s_2 ] ;

p_(c4) =[c_1 (l_3 c_23 +l_2 c_2 +l_(c4) c_234 )s_1 (l_3 c_23 +l_2 c_2 +l_(c4) c_234 )l_1 +l_3 s_23 +l_2 s_2 +l_(c4) s_234 ]

p_(c5) =[c_1 (l_3 c_23 +l_2 c_2 +l_(c5) c_234 )s_1 (l_3 c_23 +l_2 c_2 +l_(c5) c_234 )l_1 +l_3 s_23 +l_2 s_2 +l_(c5) s_234 ] (21)

Ma trận quán tính

D(q)=[d_11 , d_12 , d_13 , d_14 , d_15 d_21 , d_22 , d_23 , d_24 , d_25 d_31 , d_32 , d_33 , d_34 , d_35 d_41 , d_42 , d_43 , d_44 , d_45 d_51 , d_52 , d_54 , d_54 , d_55 ] (30)

Vector hướng tâm

V(q,q)=[v_1 , v_2 , v_3 , v_4 , v_5 ] ^T được tính với công thức

v_k =∑_(i,j) ((∂d_(kj))/(∂q_i)-1/2(∂d_(ij))/(∂q_k))q_i q_j (31)

Vector trọng lực

G(q)=[g_1 , g_2 , g_3 , g_4 , g_5 ] ^T được tính với công thức g_k =(∂P)/(∂q_k) (32)

Véc tơ lực

τ=[τ_1 , τ_2 , τ_3 , τ_4 , τ_5 ] ^T =D(q)q+V(q,q)+G(q) (33)

Trong đó:

Ixx1=461147 N.mm² ; Iyy1=299920 N.mm² ; Iyy2=803322 N.mm² ; Iyy3=1604504 N.mm² Iyy4=6328 N.mm² ; Iyy5=24861 N.mm² ; Izz5=14388 N.mm²

m1=27,5 [kg]; m2=21 [kg]; m3=25,1 [kg]; m4=3 [kg]; m5=5,2 [kg];

l1=690 [mm]; l2=440 [mm]; l3=500 [mm]; l5=230 [mm];

lc1=660 [mm]; lc2=255 [mm]; lc3=143 [mm]; lc4=6 [mm]; lc5=143 [mm];

g=9,81 [m/s²]

Để xác định được giá trị moment tại các khâu cần phải có các giá trị θ,θ,θ do đó cần tạo một quỹ đạo chuyển động mẫu cho robot từ đó tìm được θ,θ,θ

Trong một chu kì robot gắp hàng từ vị trí A sang vị trí B rồi đến vị trí C sau đó qua B và về vị trí A và tiếp tục lặp lại. Giả sử chọn quỹ đạo di chuyển của tay gắp là đường thẳng với vị trí A(800,0,400), vị trí B(0,600,1000), vị trí C(-800,0,400)

Điều kiện:

γ=θ_2 +θ_3 +θ_4 =(-π)/2 hay tay gắp luôn luôn vuông góc với mặt đất và hướng xuống

φ=θ_1 +θ_5 =0

Do quỹ đạo đi từ vị trí A sang vị trí B rồi đến vị trí C và từ vị trí C đi qua B về vị trí A là như nhau nên chỉ tính toán trên đoạn từ vị trí A qua vị trí B và đến vị trí C.

Thời gian thực hiện đi từ vị trí A qua vị trí B và đến vị trí C là nửa nửa chu kì là 2,5 giây.

Với quỹ đạo như trên ta xác định được biểu đồ vị trí khâu chấp hành cuối trong nửa chu kì từ 0 đến 2,5 giây. Từ đó ta tìm được biểu đồ giá trị của θ,θ và θ .

# CHƯƠNG 4: NGHIÊN CỨU, PHÁT TRIỂN THIẾT KẾ CƠ KHÍ

# Nghiên cứu cơ khí phần cánh tay robot

# Phát triển phần đầu tay gắp cho cánh tay robot

# CHƯƠNG 5: THIẾT KẾ HỆ THỐNG ĐIỀU KHIỂN

# Thiết kế hệ thống điện

# Thiết kế giải thuật điều khiển khiển

# CHƯƠNG 6: THIẾT KẾ ỨNG DỤNG GIÁM SÁT VÀ ĐIỀU KHIỂN

# Thiết kế giao diện điều khiển bằng C#

# Thiết kế giao diện giám sát bằng MATLAB

# CHƯƠNG 7: THI CÔNG, THỰC NGHIỆM VÀ PHÂN TÍCH KẾT QUẢ

# Thi công cơ khí

# Thi công hệ thống điện

# Thi công ứng dụng điều khiển

# Thực nghiệm chạy robot

# Phân tích kết quả

# CHƯƠNG 8: KẾT LUẬN

# Các vấn đề đã đạt được

# Các hạn chế của hệ thống

# Các giải pháp và hướng phát triển trong tương lai
