TNH510/5_DOF_Robot_Arm/docs/mechatronic_project/report/hieu/chuong_3_hieu.docx

# CHƯƠNG 3: NGHIÊN CỨU ĐỘNG HỌC VÀ ĐỘNG LỰC HỌC TAY MÁY

# 3.1 Tính toán

# 3.1.3 Tính toán động lực học


Hình 3.2: Sơ đồ tính động học robot

Phương trình động lực học tổng quát

τ_k =∑_j d_(kj) q_j +∑_(i,j) ((∂d_(kj))/(∂q_i)-1/2(∂d_(ij))/(∂q_k))q_i q_j -(∂P)/(∂q_k)

Hay

τ=D(q)q+V(q,q)+G(q)

với

D(q) là ma trận quán tính

V(q,q) là vector hướng tâm

G(q) là vector trọng lực

+Tính ma trận quán tính D(q) :

Ta có:

- Ma trận chỉ hướng Ri là ma trận lấy các phần tử của 3 hàng và 3 cột đầu của ma trận chuyển vị Ti (đã tính ở phần động học thuận)

R_1 =[c_1 , 0, s_1 s_1 , 0, -c_1 0, 1, 0] R_2 =[c_1 c_2 , -c_1 s_2 , s_1 s_1 c_2 , -s_1 s_2 , -c_1 s_2 , c_2 , 0] R_3 =[c_1 c_23 , -c_1 s_23 , s_1 s_1 c_23 , -s_1 s_23 , -c_1 s_23 , c_23 , 0]

R_4 =[-c_1 s_234 , s_1 , c_1 c_234 -s_1 s_234 , -c_1 , s_1 c_234 c_234 , 0, s_234 ]

R_5 =[s_1 s_5 -s_234 c_1 c_5 , s_1 c_5 +s_234 c_1 s_5 , c_234 c_1 -c_1 s_5 -s_234 s_1 c_5 , -c_1 c_5 +s_234 s_1 s_5 , c_234 s_1 c_234 c_5 , -c_234 s_5 , s_234 ]

- Ma trận moment quán tính Ii (là ma trận đặt trưng cho moment quán tính của các khâu)

I=[I_(xx) , I_(xy) , I_(xz) I_(yx) , I_(yy) , I_(yz) I_(zx) , I_(zy) , I_(zz) ]

Để đơn giản hóa việc tính toán, giả sử các khâu đều đối xứng qua các trục xx, yy, zz

Ta có

I_(xy) =I_(yx)

I_(xz) =I_(zx)

I_(yz) =I_(zy)

Xét hình dáng của các khâu 2,3,4 là thanh thẳng có tiết diện ngnang không đáng kể.

Xét hình dáng của các khâu 1,5 là hình trụ tròn.

Ta có hình dáng tổng quát cùng vị trí đặt trục tọa độ như sau:

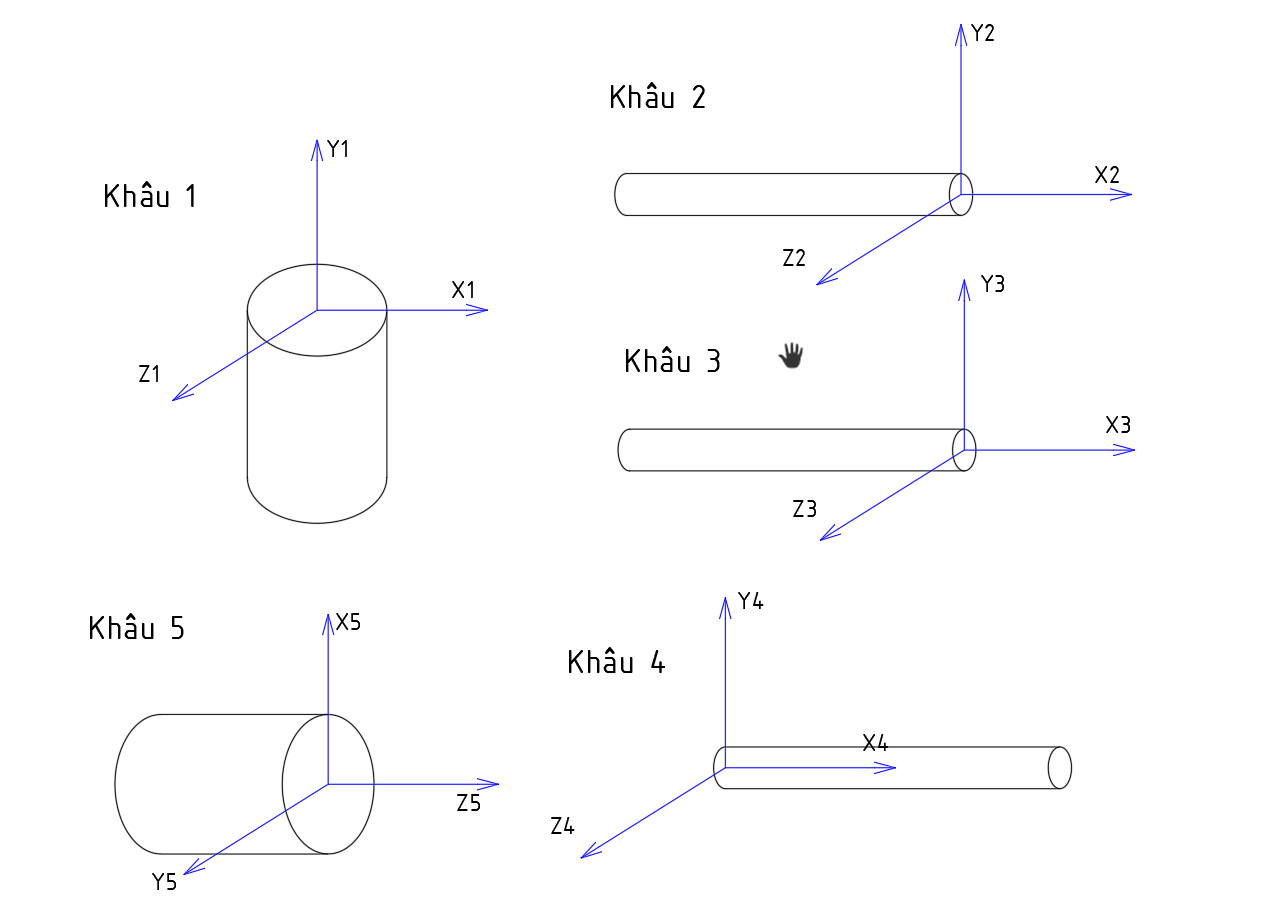
[picture p79: figure]

Ta có:

I1: I_(xx) = I_(xx1) , I_(yy) = I_(yy1) , I_(zz) = I_(xx) =I_(xx1)

I2: I_(xx) ≈ 0 , I_(yy) = I_(yy2) , I_(zz) = I_(yy) =I_(yy2)

I3: I_(xx) ≈ 0 , I_(yy) = I_(yy3) , I_(zz) = I_(yy) =I_(yy3)

I4: I_(xx) = I_(yy) =I_(yy4) , I_(yy) = I_(yy4) , I_(zz) ≈ 0

I5: I_(xx) = I_(yy) =I_(yy5) , I_(yy) = I_(yy5) , I_(zz) = I_(zz) =I_(zz5)

Tổng hợp lại ta có:

I_1 =[I_(xx1) , 0, 00, I_(yy1) , 00, 0, I_(xx1) ] ; I_2 =[0, 0, 00, I_(yy2) , 00, 0, I_(yy2) ] ; I_3 =[0, 0, 00, I_(yy3) , 00, 0, I_(yy3) ] ;

I_4 =[I_(yy4) , 0, 00, I_(yy4) , 00, 0, 0] ; I_5 =[I_(yy5) , 0, 00, I_(yy5) , 00, 0, I_(zz5) ]

Sử dụng công thức tính moment quán tính cho các khối cơ bản ta xác định được giá trị của các phần tử trong ma trận I.

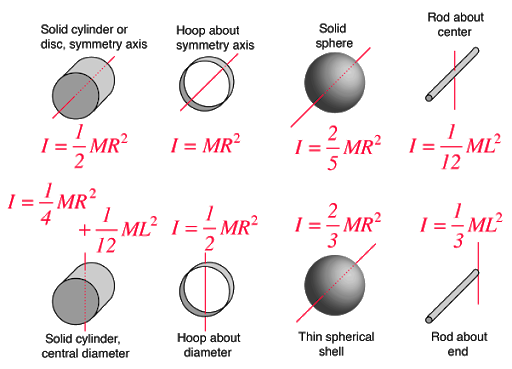
[picture p80: figure]
Momen quán tính là gì? | Cốp Pha Việt

- Ma trận biểu diễn vi trí trọng tâm khâu p_(ci) so với hệ tọa độ gốc O0 (Các giá trị được tính bằng phương pháp hình học)

p_(c1) =[00l_(c1) ] ; p_(c2) =[l_(c2) c_1 c_2 l_(c2) s_1 c_2 l_1 +l_(c2) s_2 ] ; p_(c3) =[c_1 (l_(c3) c_23 +l_2 c_2 )s_1 (l_(c3) c_23 +l_2 c_2 )l_1 +l_(c3) s_23 +l_2 s_2 ] ;

p_(c4) =[c_1 (l_3 c_23 +l_2 c_2 +l_(c4) c_234 )s_1 (l_3 c_23 +l_2 c_2 +l_(c4) c_234 )l_1 +l_3 s_23 +l_2 s_2 +l_(c4) s_234 ]

p_(c5) =[c_1 (l_3 c_23 +l_2 c_2 +l_(c5) c_234 )s_1 (l_3 c_23 +l_2 c_2 +l_(c5) c_234 )l_1 +l_3 s_23 +l_2 s_2 +l_(c5) s_234 ]

- Ma trận Jacobi khâu

Ma trận Jacobi vận tốc gốc ω_i :

⁰ ω_i =ω_1 +R_1 ω_2 +…+R_(i-1) ω_i với ω_i là vận tốc gốc của khâu thứ i

R_(i-1) là ma trận chỉ hướng của khâu thứ i

Ta có:

ω_1 =[00θ_1 ] ; ω_2 =[00θ_2 ] ; ω_3 =[00θ_3 ] ; ω_4 =[00θ_4 ] ; ω_5 =[00θ_5 ]

⁰ ω_1 =[00θ_1 ] ; ⁰ ω_2 =[θ_2 s_1 -θ_2 c_1 θ_1 ] ; ⁰ ω_3 =[(θ_2 +θ_3 )s_1 -(θ_2 +θ_3 )c_1 θ_1 ] ; ⁰ ω_4 =[-(θ_2 +θ_3 +θ_4 )s_1 (θ_2 +θ_3 +θ_4 )c_1 θ_1 ] ;

⁰ ω_5 =[-(θ_2 +θ_3 +θ_4 )s_1 +θ_5 c_234 c_1 (θ_2 +θ_3 +θ_4 )c_1 +θ_5 c_234 s_1 θ_1 +θ_5 s_234 ] ;

Ma trận Jacobi vận tốc dài J_(vi) :

J_(v1) =[(dpc1[1])/(dθ_1), 0, 0 0 0(dpc1[2])/(dθ_1), 0, 0 0 0(dpc1[3])/(dθ_1), 0, 0 0 0 ] J_(v2) =[(dpc2[1])/(dθ_1), (dpc2[1])/(dθ_2), 0 0 0(dpc2[2])/(dθ_1), (dpc2[2])/(dθ_2), 0 0 0(dpc2[3])/(dθ_1), (dpc2[3])/(dθ_2), 0 0 0 ]

J_(v3) =[(dpc3[1])/(dθ_1), (dpc3[1])/(dθ_2), (dpc3[1])/(dθ_3) 0 0(dpc3[2])/(dθ_1), (dpc3[2])/(dθ_2), (dpc3[2])/(dθ_3) 0 0(dpc3[3])/(dθ_1), (dpc3[3])/(dθ_2), (dpc3[3])/(dθ_3) 0 0 ] J_(v4) =[(dpc4[1])/(dθ_1), (dpc4[1])/(dθ_2), (dpc4[1])/(dθ_3) (dpc4[1])/(dθ_4) 0(dpc4[2])/(dθ_1), (dpc4[2])/(dθ_2), (dpc4[2])/(dθ_3) (dpc4[1])/(dθ_4) 0(dpc4[3])/(dθ_1), (dpc4[3])/(dθ_2), (dpc4[3])/(dθ_3) (dpc4[1])/(dθ_4) 0 ]

J_(v5) =[(dpc5[1])/(dθ_1), (dpc5[1])/(dθ_2), (dpc5[1])/(dθ_3) (dpc5[1])/(dθ_4) (dpc5[1])/(dθ_5)(dpc5[2])/(dθ_1), (dpc5[2])/(dθ_2), (dpc5[2])/(dθ_3) (dpc5[2])/(dθ_4) (dpc5[2])/(dθ_5)(dpc5[3])/(dθ_1), (dpc5[3])/(dθ_2), (dpc5[3])/(dθ_3) (dpc5[3])/(dθ_4) (dpc5[3])/(dθ_5) ]

Kết quả:

J_(v1) =[0, 0, 00, 0, 00, 0, 0 0, 00, 00, 0] (22)

J_(v2) =[-l_(c2) c_2 s_1 , -l_(c2) c_1 s_2 , 0l_(c2) c_1 c_2 , -l_(c2) s_1 s_2 , 00, l_(c2) c_2 , 0 0, 00, 00, 0] (23)

J_(v3) =[-s_1 (l_(c3) c_23 +l_2 c_2 ), -c_1 (l_(c3) s_23 +l_2 s_2 ), -l_(c3) s_23 c_1 c_1 (l_(c3) c_23 +l_2 c_2 ), -s_1 (l_(c3) s_23 +l_2 s_2 ), -l_(c3) s_23 s_1 0, l_(c3) c_23 +l_2 c_2 , l_(c3) c_23 0, 00, 00, 0] (24)

J_(v4) =[-s_1 (l_3 c_23 +l_2 c_2 +l_(c4) c_234 ), -c_1 (l_3 s_23 +l_2 s_2 +l_(c4) s_234 ), -c_1 (l_3 s_23 +l_(c4) s_234 )c_1 (l_3 c_23 +l_2 c_2 +l_(c4) c_234 ), -s_1 (l_3 s_23 +l_2 s_2 +l_(c4) s_234 ), -s_1 (l_3 s_23 +l_(c4) s_234 )0, l_3 c_23 +l_2 c_2 +l_(c4) c_234 , l_3 c_23 +l_(c4) c_234 -l_(c4) s_234 c_1 , 0-l_(c4) s_234 s_1 , 0l_(c4) c_234 , 0]

J_(v5) = [-s_1 (l_3 c_23 +l_2 c_2 +l_(c4) c_234 ), -c_1 (l_3 s_23 +l_2 s_2 +l_(c4) s_234 ), -c_1 (l_3 s_23 +l_(c4) s_234 )c_1 (l_3 c_23 +l_2 c_2 +l_(c4) c_234 ), -s_1 (l_3 s_23 +l_2 s_2 +l_(c4) s_234 ), -s_1 (l_3 s_23 +l_(c4) s_234 )0, l_3 c_23 +l_2 c_2 +l_(c4) c_234 , l_3 c_23 +l_(c4) c_234 -l_(c5) s_234 c_1 , 0-l_(c5) s_234 s_1 , 0l_(c5) c_234 , 0]

Với giá trị i chạy từ 1 đến 5, thay các giá trị vừa tính được vào biểu thức ban đầu, ta tìm được ma trận quán tính D(q).

D(q)=[d_11 , d_12 , d_13 , d_14 , d_15 d_21 , d_22 , d_23 , d_24 , d_25 d_31 , d_32 , d_33 , d_34 , d_35 d_41 , d_42 , d_43 , d_44 , d_45 d_51 , d_52 , d_54 , d_54 , d_55 ]

- Tính Vector hướng tâm V(q,q)

V(q,q)=[v_1 , v_2 , v_3 , v_4 , v_5 ] ^T

v_k =∑_(i,j) ((∂d_(kj))/(∂q_i)-1/2(∂d_(ij))/(∂q_k))q_i q_j với k chạy từ 1 đến 5 và i và j thể hiện vị trí phần tử của ma trận quán tính

- Tính Vector trọng lực G(q)

G(q)=[g_1 , g_2 , g_3 , g_4 , g_5 ] ^T với g_k =(∂P)/(∂q_k)

P là thế năng tổng cộng của cánh tay được tính bằng P=-∑_(i=1)^n m_i g^T p_(ci)

- với g_k =-∑_(i=1)^n m_i g^T (∂p_(ci))/(∂q_k)

Mà (∂p_(ci))/(∂q_k) chính là cột thứ k trong ma trận J_(vi)

- Tiến thành tính toán số liệu cụ thể

Ta có các thông số đã biết:

- m1=27,5 [kg]; m2=21 [kg]; m3=25,1 [kg]; m4=3 [kg]; m5=5,2 [kg];
- l1=690 [mm]; l2=440 [mm]; l3=500 [mm]; l5=230 [mm];
- lc1=660 [mm]; lc2=255 [mm]; lc3=143 [mm]; lc4=6 [mm]; lc5=143 [mm];
- g=9,81 [m/s²]
- Ixx1=461147 N.mm²; Iyy1=299920 N.mm²; Iyy2=803322 N.mm²; Iyy3=1604504 N.mm² Iyy4=6328 N.mm²; Iyy5=24861 N.mm²; Izz5=14388 N.mm²

Vì khối lượng tính toán rất phức tạp nên ta sẽ sử dụng MATLAB để tăng độ chính xác và tin cậy cho quá trình tính toán. Ta sẽ thế giá trị trực tiếp và áp dụng thêm điều kiện ràng buộc θ_2 +θ_3 +θ_4 =(-π)/2 để kết quả tính toán ngắn gọn nhất có thể.

- Xây dựng file MATLAB tính toán động lực học:

%% MA TRAN CHI HUONG (Ri)

syms l1 l2 l3 l4 l5 lc1 lc2 lc3 lc4 lc5

syms t1 t2 t3 t4 t5

R1 = [cos(t1) 0 sin(t1); sin(t1) 0 -cos(t1); 0 1 0];

R2 = [cos(t1)*cos(t2) -cos(t1)*sin(t2) sin(t1); sin(t1)*cos(t2) -sin(t1)*sin(t2) -cos(t1); sin(t2) cos(t2) 0];

R3 = [cos(t1)*cos(t2 + t3) -cos(t1)*sin(t2 + t3) sin(t1); sin(t1)*cos(t2 + t3) -sin(t1)*sin(t2 + t3) -cos(t1); sin(t2 + t3) cos(t2 + t3) 0];

R4 = [-cos(t1)*(-1) sin(t1) cos(t1)*0; -sin(t1)*(-1) -cos(t1) sin(t1)*0; 0 0 (-1)];

R5 = [(sin(t1)*sin(t5) - (-1)*cos(t1)*cos(t5)) (sin(t1)*cos(t5) + (-1)*cos(t1)*sin(t5)) (0*cos(t1)); (-cos(t1)*sin(t5) - (-1)*sin(t1)*cos(t5) ) (-cos(t1)*cos(t5) + (-1)*sin(t1)*sin(t5)) (0*sin(t1)); 0*cos(t5) -0*sin(t5) (-1)];

%% MA TRAN MOMENT QUAN TINH (I)

syms Ixx1 Iyy1 Iyy2 Iyy3 Iyy4 Iyy5 Izz5

I1 = [Ixx1 0 0; 0 Iyy1 0; 0 0 Ixx1];

I2 = [0 0 0; 0 Iyy2 0; 0 0 Iyy2];

I3 = [0 0 0; 0 Iyy3 0; 0 0 Iyy3];

I4 = [Iyy4 0 0; 0 Iyy4 0; 0 0 0];

I5 = [Iyy5 0 0; 0 Iyy5 0; 0 0 Izz5];

%% MA TRAN BIEU DIEN VI TRI TRONG TAM KHAU (pci)

pc1 = [0 ; 0 ; lc1];

pc2 = [lc2*cos(t1)*cos(t2) ; lc2*sin(t1)*cos(t2) ; (l1 + lc2*sin(t2))];

pc3 = [(cos(t1)*(lc3*cos(t2 + t3) + l2*cos(t2))) ; (sin(t1)*(lc3*cos(t2 + t3) + l2*cos(t2))) ; (l1 + lc3*sin(t2 + t3) + l2*sin(t2))];

pc4 = [(cos(t1)*(l3*cos(t2 + t3) + l2*cos(t2) + lc4*0)) ; (sin(t1)*(l3*cos(t2 + t3) + l2*cos(t2) + lc4*0)) ; (l1 + l3*sin(t2 + t3) + l2*sin(t2) + lc4*sin((-pi / 2)))];

pc5 = [(cos(t1)*(l3*cos(t2 + t3) + l2*cos(t2) + lc5*0)) ; (sin(t1)*(l3*cos(t2 + t3) + l2*cos(t2) + lc5*0)) ; (l1 + l3*sin(t2 + t3) + l2*sin(t2) + lc5*sin((-pi / 2)))];

%% MA TRAN JACOBI KHAU (Jw)

Jw1 = [0 0 0 0 0; 0 0 0 0 0; 1 0 0 0 0];

Jw2 = [0 sin(t1) 0 0 0; 0 -cos(t1) 0 0 0; 1 0 0 0 0];

Jw3 = [0 sin(t1) sin(t1) 0 0; 0 -cos(t1) -cos(t1) 0 0; 1 0 0 0 0];

Jw4 = [0 sin(t1) sin(t1) sin(t1) 0; 0 -cos(t1) -cos(t1) -cos(t1) 0; 1 0 0 0 0];

Jw5 = [0 sin(t1) sin(t1) sin(t1) 0*cos(t1); 0 -cos(t1) -cos(t1) -cos(t1) 0*sin(t1); 1 0 0 0 (-1)];

%% MA TRAN JACOBI VAN TOC DAI (Jv)

Jv1 = [diff(pc1(1),t1) 0 0 0 0 ; diff(pc1(2),t1) 0 0 0 0; diff(pc1(3),t1) 0 0 0 0];

Jv2 = [diff(pc2(1),t1) diff(pc2(1),t2) 0 0 0 ; diff(pc2(2),t1) diff(pc2(2),t2) 0 0 0; diff(pc2(3),t1) diff(pc2(3),t2) 0 0 0];

Jv3 = [diff(pc3(1),t1) diff(pc3(1),t2) diff(pc3(1),t3) 0 0 ; diff(pc3(2),t1) diff(pc3(2),t2) diff(pc3(2),t3) 0 0; diff(pc3(3),t1) diff(pc3(3),t2) diff(pc3(3),t3) 0 0];

Jv4 = [diff(pc4(1),t1) diff(pc4(1),t2) diff(pc4(1),t3) diff(pc4(1),t4) 0 ; diff(pc4(2),t1) diff(pc4(2),t2) diff(pc4(2),t3) diff(pc4(2),t4) 0; diff(pc4(3),t1) diff(pc4(3),t2) diff(pc4(3),t3) diff(pc4(3),t4) 0];

Jv5 = [diff(pc5(1),t1) diff(pc5(1),t2) diff(pc5(1),t3) diff(pc5(1),t4) diff(pc5(1),t5) ; diff(pc5(2),t1) diff(pc5(2),t2) diff(pc5(2),t3) diff(pc5(2),t4) diff(pc5(2),t5); diff(pc5(3),t1) diff(pc5(3),t2) diff(pc5(3),t3) diff(pc5(3),t4) diff(pc5(3),t5)];

%% MA TRAN QUAN TINH

syms m1 m2 m3 m4 m5

m = [m1 ; m2 ; m3 ; m4 ; m5]

D1 = m1*(Jv1')*Jv1 + (Jw1')*R1*I1*(R1')*Jw1;

D2 = m2*(Jv2')*Jv2 + (Jw2')*R2*I2*(R2')*Jw2;

D3 = m3*(Jv3')*Jv3 + (Jw3')*R3*I3*(R3')*Jw3;

D4 = m4*(Jv4')*Jv4 + (Jw4')*R4*I4*(R4')*Jw4;

D5 = m5*(Jv5')*Jv5 + (Jw5')*R5*I5*(R5')*Jw5;

D = D1 + D2 + D3 + D4 + D5;

%% VECTOR HUONG TAM

V1 = 0; V2 = 0; V3 = 0; V4 = 0; V5 = 0;

syms t1_d t2_d t3_d t4_d t5_d

q_d = [t1_d ; t2_d ; t3_d ; t4_d ; t5_d]

q = [t1 ; t2 ; t3 ; t4 ; t5]

for i = 1:1:5

for j = 1:1:5

V1 = V1 + (diff(D(1,j),q(i)) - 1/2 * diff(D(i,j),q(1))) * q_d(i) * q_d(j);

V2 = V2 + (diff(D(2,j),q(i)) - 1/2 * diff(D(i,j),q(2))) * q_d(i) * q_d(j);

V3 = V3 + (diff(D(3,j),q(i)) - 1/2 * diff(D(i,j),q(3))) * q_d(i) * q_d(j);

V4 = V4 + (diff(D(4,j),q(i)) - 1/2 * diff(D(i,j),q(4))) * q_d(i) * q_d(j);

V5 = V5 + (diff(D(5,j),q(i)) - 1/2 * diff(D(i,j),q(5))) * q_d(i) * q_d(j);

end

end

V = [V1 ; V2 ; V3 ; V4 ; V5];

%% VECTOR TRONG LUC

gT = [0 , 0, -9.8]

G1 = - (m(1) * gT * Jv1(:, 1) + m(2) * gT * Jv2(:, 1) + m(3) * gT * Jv3(:, 1) + m(4) * gT * Jv4(:, 1) + m(5) * gT * Jv5(:, 1));

G2 = - (m(1) * gT * Jv1(:, 2) + m(2) * gT * Jv2(:, 2) + m(3) * gT * Jv3(:, 2) + m(4) * gT * Jv4(:, 2) + m(5) * gT * Jv5(:, 2));

G3 = - (m(1) * gT * Jv1(:, 3) + m(2) * gT * Jv2(:, 3) + m(3) * gT * Jv3(:, 3) + m(4) * gT * Jv4(:, 3) + m(5) * gT * Jv5(:, 3));

G4 = - (m(1) * gT * Jv1(:, 4) + m(2) * gT * Jv2(:, 4) + m(3) * gT * Jv3(:, 4) + m(4) * gT * Jv4(:, 4) + m(5) * gT * Jv5(:, 4));

G5 = - (m(1) * gT * Jv1(:, 5) + m(2) * gT * Jv2(:, 5) + m(3) * gT * Jv3(:, 5) + m(4) * gT * Jv4(:, 5) + m(5) * gT * Jv5(:, 5));

G = [simplify(G1) ; simplify(G2) ; simplify(G3) ; simplify(G4) ; simplify(G5)];

- Xác định tải tĩnh lớn nhất mà cánh tay robot chịu được:

Xét trường hợp cánh tay robot ở trạng thái tĩnh, khi đó các giá trị vận tốc và gia tốc sẽ bằng 0, từ đó dẫn đến D(q)q +V(q,q)=0 . Phương trình động lực học khi đó chỉ còn phụ thuộc vào vector trọng lực G(q) :

τ=D(q)q+V(q,q)+G(q)= G(q)

τ2 = (49*m4*(l3*cos(t2 + t3) + l2*cos(t2)))/5 + (49*m5*(l3*cos(t2 + t3) + l2*cos(t2)))/5 + (49*m3*(lc3*cos(t2 + t3) + l2*cos(t2)))/5 + (49*lc2*m2*cos(t2))/5

τ3 = (49*cos(t2 + t3)*(l3*m4 + l3*m5 + lc3*m3))/5

Khi đó, ta xác định vị trí mà cánh tay robot chịu moment lớn nhất. Về nguyên tắc, moment được xác định bằng tích của lực và độ dài cánh tay đòn. Lực ở đây chính là trọng lực của vật thể cần gắp, cánh tay đòn là khoảng cách từ vật gắp đến gốc tọa độ ban đầu của robot. Ta xác định được cấu hình mà cánh tay chịu lực lớn nhất đó chính là khi cánh tay bị duỗi thẳng như hình:

Khi đó, các giá trị góc như sau:

θ_1 =,θ_1 =,θ_1 =,θ_1 =,θ_1 =

Khối lượng các khâu là

Với khâu 5 gắn với vật cần gắp nên ta đặt là 1 biến số. Cho biến m5 tăng dần, ta thu được biểu đồ liên hệ giữa khối lượng vật càn gắp và moment phải chịu của các động cơ:

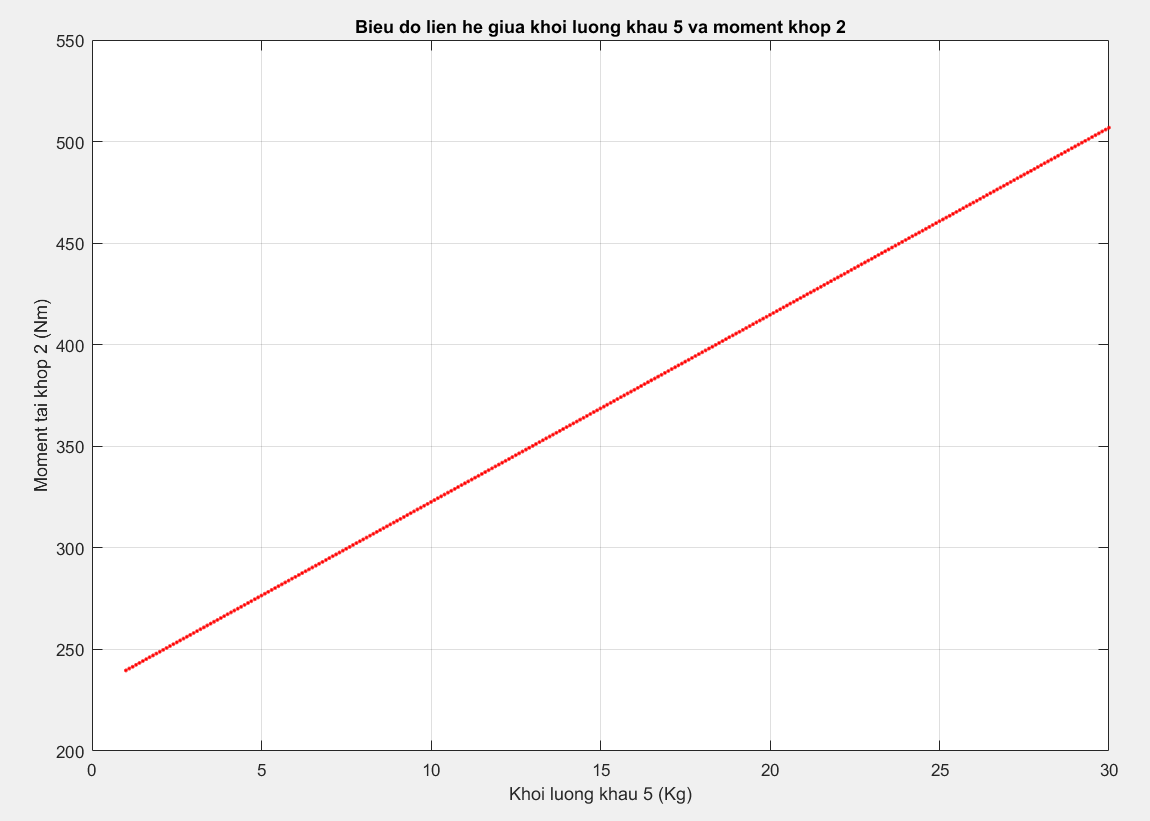
[picture p81: figure]

Tra thông số động cơ tại khớp 2 của robot (HG-KR73) ta có:

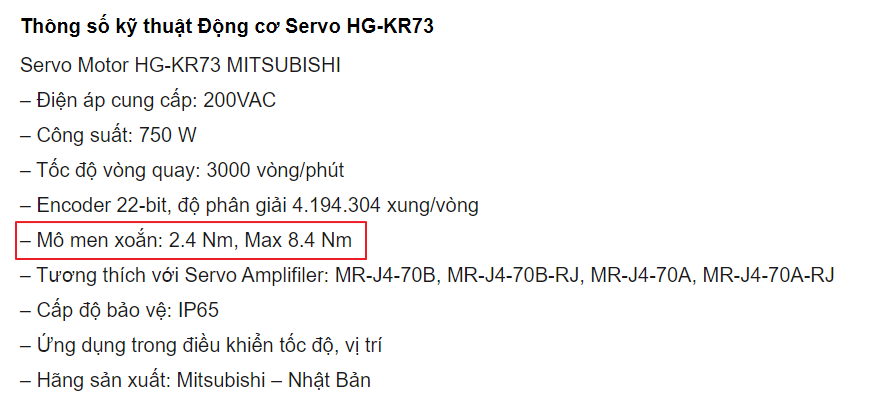
[picture p82: figure]

Bộ truyền Hamornic có tỉ số truyền 1:180, cho hiệu suất bộ truyền, do đó moment mà khớp 2 chịu được sẽ là:

T2max = 2.4 * 180 = 432 Nm

Suy ra khối lượng lớn nhất của khâu số 5 mà động cơ vẫn chịu được là 19Kg

Từ đó, vật lớn nhất mà robot gắp được sẽ khoảng 17kg
