TNH510/5_DOF_Robot_Arm/tong_hop_ban_ve/bia/ban ve chi tiet part 1.docx

BỘ GIÁO DỤC VÀ ĐÀO TẠO

TRƯỜNG ĐẠI HỌC SƯ PHẠM KỸ THUẬT TP.HCM

KHOA CƠ KHÍ CHẾ TẠO MÁY

BỘ MÔN CƠ ĐIỆN TỬ

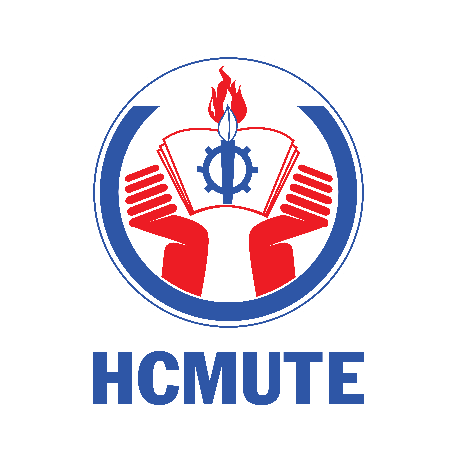
[picture p93: figure]

TẬP BẢN VẼ CHI TIẾT

Đề tài: “ĐIỀU KHIỂN TAY MÁY ỨNG DỤNG TRONG XẾP SẢN PHẨM”

GVHD: TS. NGUYỄN XUÂN QUANG

SVTH:

TRẦN NGỌC HIỂU 20146127

NGUYỄN BÁ VŨ THẠCH 20146530

LÊ TẤN LỘC 20146121

Tp. Hồ Chí Minh, tháng 7/2024

TẬP BẢN VẼ CHI TIẾT

CHO THIẾT BỊ THEO DÕI CHUYỂN ĐỘNG CÁNH TAY
