TNH510/5_DOF_Robot_Arm/tong_hop_ban_ve/bia/ban ve lap A3 part 2.docx

TẬP BẢN VẼ LẮP

CHO CÁNH TAY ROBOT 5 BẬC TỰ DO
