TNH510/5_DOF_Robot_Arm/tong_hop_ban_ve/bia/ban ve chi tiet part 2 - Copy.docx

TẬP BẢN VẼ CHI TIẾT

CHO CÁNH TAY ROBOT 5 BẬC TỰ DO
