TNH510/5_DOF_Robot_Arm/tong_hop_ban_ve/bia/ban ve điện part 2.docx

TẬP BẢN VẼ ĐIỆN

CHO CÁNH TAY ROBOT 5 BẬC TỰ DO
