TNH510/5_DOF_Robot_Arm/docs/final_project/main_final.docx

BỘ GIÁO DỤC VÀ ĐÀO TẠO

TRƯỜNG ĐẠI HỌC SƯ PHẠM KỸ THUẬT THÀNH PHỐ HỒ CHÍ MINH

KHOA CƠ KHÍ CHẾ TẠO MÁY


ĐỒ ÁN TỐT NGHIỆP

Đề tài: “ĐIỀU KHIỂN TAY MÁY ỨNG DỤNG TRONG XẾP SẢN PHẨM”

GVHD: TS. NGUYỄN XUÂN QUANG

SVTH: TRẦN NGỌC HIỂU

MSSV: 20146127

SVTH: NGUYỄN BÁ VŨ THẠCH

MSSV: 20146530

SVTH: LÊ TẤN LỘC

MSSV: 20146121

Tp. Hồ Chí Minh, tháng 6/2024

TRƯỜNG ĐẠI HỌC SƯ PHẠM KỸ THUẬT THÀNH PHỐ HỒ CHÍ MINH

KHOA CƠ KHÍ CHẾ TẠO MÁY

BỘ MÔN CƠ ĐIỆN TỬ

Không có mô tả ảnh.

ĐỒ ÁN TỐT NGHIỆP

Đề tài: “ĐIỀU KHIỂN TAY MÁY ỨNG DỤNG TRONG XẾP SẢN PHẨM”

GVHD: TS. NGUYỄN XUÂN QUANG

SVTH: TRẦN NGỌC HIỂU

MSSV: 20146127

SVTH: NGUYỄN BÁ VŨ THẠCH

MSSV: 20146530

SVTH: LÊ TẤN LỘC

MSSV: 20146121

Tp. Hồ Chí Minh, tháng 6/2024

TRƯỜNG ĐẠI HỌC SƯ PHẠM KỸ THUẬT TP.HCM

KHOA CƠ KHÍ CHẾ TẠO MÁY

Bộ môn: Cơ điện tử

CỘNG HÒA XÃ HỘI CHỦ NGHĨA VIỆT NAM

Độc lập – Tự do – Hạnh phúc

# NHIỆM VỤ ĐỒ ÁN TỐT NGHIỆP

Học kỳ I/ Năm học 2023 – 2024

Giảng viên hướng dẫn: TS. Nguyễn Xuân Quang

Sinh viên thực hiện:

1. Trần Ngọc Hiểu. MSSV: 20146127. Điện thoại: 0328743450.
2. Nguyễn Bá Vũ Thạch. MSSV: 20146530. Điện thoại: 0985075354
3. Lê Tấn Lộc. MSSV: 20146121. Điện thoại: 0877708465
1. Mã số đề tài: …
- Tên đề tài: Điều khiển tay máy ứng dụng trong xếp sản phẩm.
2. Các số liệu, tài liệu ban đầu

Nguyên lý hoạt động: Tay máy 5 bậc tự do được sử dụng để bốc các sản phẩm hình hộp chữ nhật với nhiều kích thước khác nhau chuyển từ hệ thống băng tải này sang băng tải khác, quỹ đạo chuyển động của tay máy được điều khiển từ máy tính.

Chức năng: Gắp và xếp có chọn lọc các loại sản phẩm.

Yêu cầu kỹ thuật:

- Tay máy có thể gắp các sản phẩm hình hộp chữ nhật với đa dạng kích thước.
- Có thể hoạt động dựa trên chương trình được lập trình từ trước bởi người dùng.
3. Nội dung chính của đồ án

Hoàn thiện bản vẽ cơ khí, bản vẽ điện, tính toán động học, động lực học, viết chương trình điều khiển và giám sát trên máy tính.

Thiết kế lại tay gắp của robot.

4. Các sản phẩm dự kiến

Tay máy 5 bậc tự do và găng tay điều khiển.

5. Ngày giao đồ án: 19/02/2024
6. Ngày nộp đồ án: 01/07/2024
7. Ngôn ngữ trình bày: Bản báo cáo: Tiếng Anh ☐ Tiếng Việt ☐

Trình bày bảo vệ: Tiếng Anh ☐ Tiếng Việt ☐

TRƯỞNG KHOA TRƯỞNG BỘ MÔN GIẢNG VIÊN HƯỚNG DẪN

(Ký, ghi rõ họ tên) (Ký, ghi rõ họ tên) (Ký, ghi rõ họ tên)

☐ Được phép bảo vệ: ............................................

(GVHD ký, ghi rõ họ tên)

TRƯỜNG ĐẠI HỌC SƯ PHẠM KỸ THUẬT TP.HCM

KHOA CƠ KHÍ CHẾ TẠO MÁY

Bộ môn: Cơ điện tử

CỘNG HÒA XÃ HỘI CHỦ NGHĨA VIỆT NAM

Độc lập – Tự do – Hạnh phúc

# PHIẾU NHẬN XÉT ĐỒ ÁN TỐT NGHIỆP

(Dành cho giảng viên hướng dẫn)

Họ tên sinh viên:

Trần Ngọc Hiểu :20146127

Nguyễn Bá Vũ Thạch :20146530

Lê Tấn Lộc :20146121

- Tên đề tài: Điều khiển tay máy ứng dụng trong xếp sản phẩm.

Ngành đào tạo: Công nghệ kỹ thuật cơ điện tử.

Giảng viên hướng dẫn: Nguyễn Xuân Quang

Ý KIẾN NHẬN XÉT

1. Nhận xét về tinh thần, thái độ làm việc của sinh viên.
2. Nhận xét về kết quả thực hiện của đồ án tốt nghiệp
  2.1. Kết cấu, cách thức trình bày đồ án tốt nghiệp

………………………………………………………………………………………………………………………………………………………………………………………………………………………………………………………………………………....................................

  2.2. Nội dung đồ án tốt nghiệp

………………………………………………………………………………………………………………………………………………………………………………………………………………………………………………………………………………....................................

  2.3. Kết quả đạt được

………………………………………………………………………………………………………………………………………………………………………………………………………………………………………………………………………………....................................

  2.4. Những tồn tại (nếu có)

………………………………………………………………………………………………………………………………………………………………………………………………………………………………………………………………………………....................................

3. Đánh giá

TT | Mục đánh giá | Điểm tối đa | Điểm đạt được
1. | Hình thức và kết cấu ĐACĐT | 30
| Đúng format với đầy đủ cả hình thức và nội dung của các mục | 10
| Mục tiêu, nhiệm vụ, tổng quan của đề tài | 10
| Tính cấp thiết của đề tài | 10
2. | Nội dung ĐACĐT | 50
| Khả năng ứng dụng kiến thức toán học, khoa học và kỹ thuật, khoa học xã hội… | 5
| Khả năng thực hiện/phân tích/tổng hợp/đánh giá | 10
| Khả năng thiết kế chế tạo một hệ thống, thành phần, hoặc quy trình đáp ứng yêu cầu đưa ra với những ràng buộc thực tế. | 15
| Khả năng cải tiến và phát triển | 5
| Khả năng sử dụng công cụ kỹ thuật, phần mềm chuyên ngành… | 5
3. | Đánh giá về khả năng ứng dụng của đề tài. | 10
4. | Sản phẩm cụ thể của ĐACĐT | 10
| Tổng | 100

4. Kết luận:

☐ Được phép bảo vệ

☐ Không được phép bảo vệ

TP.HCM, ngày.....tháng.....năm

Giảng viên hướng dẫn

(Ký, ghi rõ họ tên)

TRƯỜNG ĐẠI HỌC SƯ PHẠM KỸ THUẬT TP.HCM

KHOA CƠ KHÍ CHẾ TẠO MÁY

Bộ môn: Cơ điện tử

CỘNG HÒA XÃ HỘI CHỦ NGHĨA VIỆT NAM

Độc lập – Tự do – Hạnh phúc

# PHIẾU NHẬN XÉT ĐỒ ÁN TỐT NGHIỆP

(Dành cho giảng viên phản biện)

Họ tên sinh viên:

Trần Ngọc Hiểu :20146127

Nguyễn Bá Vũ Thạch :20146530

Lê Tấn Lộc :20146121

Tên đề tài: Điều khiển tay máy ứng dụng trong xếp sản phẩm.

Ngành đào tạo: Công nghệ kỹ thuật cơ điện tử.

Giảng viên hướng dẫn: Nguyễn Xuân Quang

Ý KIẾN NHẬN XÉT

1. Nhận xét về tinh thần, thái độ làm việc của sinh viên.
2. Nhận xét về kết quả thực hiện của đồ án tốt nghiệp
  2.1. Kết cấu, cách thức trình bày đồ án tốt nghiệp

………………………………………………………………………………………………………………………………………………………………………………………………………………………………………………………………………………....................................

  2.2. Nội dung đồ án tốt nghiệp

………………………………………………………………………………………………………………………………………………………………………………………………………………………………………………………………………………....................................

  2.3. Kết quả đạt được

………………………………………………………………………………………………………………………………………………………………………………………………………………………………………………………………………………....................................

  2.4. Những tồn tại (nếu có)

………………………………………………………………………………………………………………………………………………………………………………………………………………………………………………………………………………....................................

3. Đánh giá

TT | Mục đánh giá | Điểm tối đa | Điểm đạt được
1. | Hình thức và kết cấu ĐACĐT | 30
| Đúng format với đầy đủ cả hình thức và nội dung của các mục | 10
| Mục tiêu, nhiệm vụ, tổng quan của đề tài | 10
| Tính cấp thiết của đề tài | 10
2. | Nội dung ĐACĐT | 50
| Khả năng ứng dụng kiến thức toán học, khoa học và kỹ thuật, khoa học xã hội… | 5
| Khả năng thực hiện/phân tích/tổng hợp/đánh giá | 10
| Khả năng thiết kế chế tạo một hệ thống, thành phần, hoặc quy trình đáp ứng yêu cầu đưa ra với những ràng buộc thực tế. | 15
| Khả năng cải tiến và phát triển | 5
| Khả năng sử dụng công cụ kỹ thuật, phần mềm chuyên ngành… | 5
3. | Đánh giá về khả năng ứng dụng của đề tài. | 10
4. | Sản phẩm cụ thể của ĐACĐT | 10
| Tổng | 100

4. Kết luận:

☐ Được phép bảo vệ

☐ Không được phép bảo vệ

TP.HCM, ngày.....tháng.....năm

Giảng viên phản biện

(Ký, ghi rõ họ tên)

# LỜI CẢM ƠN

Lời đầu tiên nhóm xin gửi lời cảm ơn sâu sắc đối với thầy hướng dẫn đề tài là thầy Nguyễn Xuân Quang đã luôn đồng hành với nhóm trong quãng thời gian một học kỳ vừa qua. Thầy đã kịp thời có những giúp đỡ, sự định hướng và giải đáp những thắc mắc của nhóm trong lúc khó khăn khi thực hiện đồ án "Điều khiển tay máy ứng dụng trong xếp sản phẩm ".

Bên cạnh đó nhóm cũng xin cảm ơn các thầy cô thuộc khoa Cơ khí Chế tạo máy đã tận tình chỉ dẫn, trang bị những kiến thức cần thiết cho chúng em ngay từ khi bước vào giảng đường đại học đến nay. Những kiến thức đó là nền tảng rất quý báu và hữu ích, được sử dụng trong đồ án này.

Tuy nhiên vì kiến thức chuyên môn và mỗi cá nhân trong nhóm còn thiếu kinh nghiệm thực tế nên đề tài không tránh khỏi những thiếu sót. Nhóm rất mong được sự góp ý, chỉ bảo thêm của quý thầy cô để bài báo cáo này hoàn thiện hơn.

Cuối cùng, nhóm xin một lần nữa gửi lời cảm ơn chân thành đến Quý thầy cô.

TP. Hồ Chí Minh, tháng 06 năm 2024

Sinh viên thực hiện

Trần Ngọc Hiểu

Nguyễn Bá Vũ Thạch

Lê Tấn Lộc

# TÓM TẮT ĐỀ TÀI

Sự bùng nổ của công nghệ robot trong những năm gần đây đang tạo nên một cuộc cách mạng lớn trong đời sống con người cũng như các ngành công nghiệp. Trong khi robot được biết đến rộng rãi là những thiết bị giúp việc vặt, chăm sóc sức khỏe hoặc hỗ trợ bán hàng, thì trên thực tế chúng đang đóng một vai trò quan trọng hơn nhiều trong sản xuất công nghiệp.

Các nhà máy, xí nghiệp trên khắp thế giới ngày càng trang bị nhiều robot hơn để thực hiện các công đoạn lặp đi lặp lại, nhờ đó tiết kiệm chi phí nhân công và nâng cao năng suất, chất lượng. Một trong những loại robot phổ biến nhất là cánh tay robot, thường được lập trình để thực hiện các công việc chế tạo, lắp ráp hay xếp hộp sản phẩm.

Tại Việt Nam, chúng ta mới chỉ lắp ráp được cánh tay robot nhập khẩu, việc thiết kế và sản xuất trong nước vẫn còn nhiều hạn chế. Do đó, đề tài nghiên cứu của nhóm sinh viên chúng em nhằm giải quyết bài toán thiết kế và chế tạo một cánh tay robot có khả năng điều khiển bằng cử động tay, ứng dụng trong xếp hộp sản phẩm.

# CHƯƠNG 1: GIỚI THIỆU CHUNG

# 1.1. Tính cấp thiết của đề tài

# Tăng năng suất và hiệu quả sản xuất: Tay máy có thể làm việc liên tục và không mệt mỏi, giúp tăng năng suất và giảm thời gian sản xuất so với lao động thủ công

# Giảm chi phí lao động: Sử dụng tay máy có thể giảm chi phí lao động, đặc biệt trong các công việc lặp đi lặp lại và đòi hỏi độ chính xác cao. Việc này cũng giúp giảm bớt sự phụ thuộc vào nguồn lao động thủ công, vốn có thể khan hiếm hoặc không ổn định

# Đảm bảo an toàn lao động: Trong các ngành công nghiệp có môi trường làm việc nguy hiểm, việc sử dụng tay máy giúp bảo vệ sức khỏe và an toàn cho người lao động, giảm thiểu nguy cơ tai nạn lao động

# Nâng cao chất lượng sản phẩm: Tay máy có khả năng làm việc với độ chính xác cao, giúp giảm thiểu sai sót và nâng cao chất lượng sản phẩm.

# Ứng dụng công nghệ cao: Đề tài ứng dụng xử lý ảnh để nhận dạng vật thể nhằm phân loại sản phẩm trong công nghiệp, thiết kế và phát triển thiết bị theo dõi chuyển động kết hợp giữa chuyển động của người - máy nhằm nâng cao hiệu quả sản xuất và tạo ra các cơ hội nghiên cứu và phát triển mới.

# 1.2. Ý nghĩa khoa học và thực tiễn của đề tài

# 1.2.1. Ý nghĩa khoa học

# Mở rộng ứng dụng của tự động hóa trong sản xuất: Kết quả nghiên cứu có thể áp dụng vào nhiều lĩnh vực sản xuất khác nhau, từ đó mở rộng phạm vi ứng dụng của công nghệ tự động hóa, đặc biệt là trong việc xếp sản phẩm

# Phát triển các thuật toán và mô hình mới: Đề tài này có thể dẫn đến sự phát triển của các thuật toán điều khiển và mô hình mô phỏng mới, góp phần nâng cao hiệu suất và độ chính xác của các hệ thống tay máy

# Nghiên cứu và phát triển công nghệ điều khiển mới: Đề tài này tập trung vào việc phát triển các phương pháp điều khiển tiên tiến cho tay máy, góp phần nâng cao hiểu biết về cơ chế hoạt động và khả năng ứng dụng của các hệ thống robot trong công nghiệp

# 1.2.2. Ý nghĩa thực tiễn

# Tối ưu hóa quy trình xếp sản phẩm: Đề tài giúp cải thiện các quy trình xếp sản phẩm hiện tại, làm cho chúng trở nên hiệu quả và tiết kiệm thời gian hơn, đồng thời giảm thiểu sự cố và lỗi trong quá trình sản xuất

# Thúc đẩy sự đổi mới và sáng tạo trong sản xuất: Việc nghiên cứu và ứng dụng các phương pháp điều khiển tay máy tiên tiến sẽ thúc đẩy sự đổi mới và sáng tạo trong sản xuất, giúp các doanh nghiệp duy trì và nâng cao sức cạnh tranh trên thị trường

# Tạo điều kiện thuận lợi cho việc triển khai công nghệ mới: Đề tài cung cấp cơ sở lý thuyết và thực tiễn cho việc triển khai các công nghệ điều khiển tay máy mới, giúp các doanh nghiệp dễ dàng áp dụng các giải pháp công nghệ hiện đại vào quy trình sản xuất của mình

# 1.3. Mục tiêu nghiên cứu của đề tài

# Thiết kế giao diện sử dụng WPF nhằm giám sát, điều khiển cũng như mô phỏng robot một cách tùy biến và linh hoạt.

# Tính toán, thiết kế và chế tạo thiết bị theo dõi chuyển động, kết hợp chuyển động từ cơ thể người để thực hiện điều khiển cánh tay robot.

# Xây dựng thuật toán nhận diện và phân loại vật thể sử dụng camera công nghiệp.

# Xây dựng hệ thống tự động hóa trong bốc xếp và phân loại sản phẩm.

# Tạo quỹ đạo từ chuyển động của cơ thể người áp dụng cho việc điều khiển cánh tay robot.

# 1.4. Đối tượng và phạm vi nghiên cứu

# 1.4.1. Đối tượng nghiên cứu

# Cánh tay robot 5 bậc tự do

# Thiết bị theo dõi chuyển động

# Thuật toán nhận dạng vật thể

# 1.4.2. Phạm vi nghiên cứu

# Nghiên cứu, thiết kế thiết bị theo dõi chuyển động.

# Điều khiển cánh tay robot 5 bậc tự do sử dụng PLC Mitsubishi.

# Thiết kế và lập trình thuật toán nhận dạng vật thể sử dụng camera công nghiệp.

# Điều khiển băng tải và lấy dữ liệu từ cảm biến dùng PLC Siemens.

# Thiết kế, lập trình giao diện hệ thống với WPF.

# 1.5. Phương pháp nghiên cứu

# Tra cứu tài liệu các tài liệu của nhà sản xuất cũng như bên ngoài để hỗ trợ trong việc điều khiển robot và thuật toán nhận dạng vật thể.

# Kiểm tra các cơ sở lý thuyết bằng cách tính toán, thực nghiệm điều khiển robot nhằm so sánh và đối chiếu.

# 1.6. Kết cấu của đồ án tốt nghiệp

# Báo cáo đồ án tốt nghiệp được chia làm 6 chương, với các nội dung:

# CHƯƠNG 1: GIỚI THIỆU CHUNG: Trình bày rõ tính cấp thiết và mục đích chọn đề tài, mục tiêu nghiên cứu đề tài, đối tượng nghiên cứu và phạm vi nghiên cứu và đưa ra được những phương pháp được áp dụng để nghiên cứu đề tài.

# CHƯƠNG 2: TỔNG QUAN NGHIÊN CỨU ĐỀ TÀI: Đưa ra được những đặc tính và kết cấu của hệ thống điều khiển, liên hệ đến những nghiên cứu liên quan đến đề tài và nêu ra những gì còn tồn đọng của hệ thống điều khiển từ đó đặt ra những giải pháp và cải tiến phù hợp.

# CHƯƠNG 3: CƠ SỞ LÝ THUYẾT: Trình bày các lý thuyết được sử dụng để giải quyết vấn đề trong đề tài và hệ thống hóa các công thức cần sử dụng.

# CHƯƠNG 4: THIẾT KẾ PHẦN CỨNG HỆ THỐNG: Thiết kế phần cứng cho cánh tay robot, cho băng tải và thiết bị theo dõi chuyển động. Bao gồm: Thiết kế cơ khí và thiết kế điện.

# CHƯƠNG 5: XÂY DỰNG PHẦN MỀM CHO HỆ THỐNG: Xây dựng phần mềm cho cánh tay robot, băng tải kết hợp cảm biến và thiết bị theo dõi chuyển động.

# CHƯƠNG 6: KẾT LUẬN, HƯỚNG PHÁT TRIỂN: Kiểm nghiệm lại kết quả và đúc kết lại quá trình thực hiện đồ án tốt nghiệp.

# CHƯƠNG 2: TỔNG QUAN NGHIÊN CỨU ĐỀ TÀI

# 2.1. Giới thiệu về đối tượng nghiên cứu và các vấn đề liên quan dến đề tài nghiên cứu

# 2.1.1. Cánh tay robot 5 bậc tự do

# Tính toán và điều khiển vị trí cho robot.

# Tính toán và điều khiển vận tốc cho robot.

# Tính toán, thiết kế và điều khiển quỹ đạo mong muốn cho robot.

# Tính toán và điều khiển robot ứng dụng trong bốc xếp hàng hóa theo một dây chuyền tự động.

# 2.1.2. Thiết bị theo dõi chuyển động

# Tương tác giữa người và máy nhằm tối ưu hóa quá trình tạo quỹ đạo cho robot

# 2.1.3. Thuật toán nhận dạng vật thể

# Nhận dạng các loại hàng hóa khác nhau nhằm tự động hóa quá trình sản xuất và phân loại sản phẩm.

# 2.2. Đặc tính của hệ thống

# Khả năng điều khiển và tùy chỉnh linh hoạt

# Độ an toàn cao trong quá trình vận hành

# Tốc độ nhận dạng vật thể và xử lí cao

# 2.3. Kết cấu của hệ thống

# Chương trình điều khiển chính

# Bộ điều khiển PLC và cánh tay robot công nghiệp

# Cụm camera và băng tải kết hợp với cảm biến công nghiệp

# Thiết bị tương tác giữa người và máy

# 2.4. Các nghiên cứu liên quan đến đề tài

# 2.4.1. Nghiên cứu ngoài nước:

# Robot bán tự động vận hành từ xa với khả năng tránh chướng ngại vật thông qua điều khiển dự đoán mô hình: https://www.researchgate.net/publication/333335847_Semi-Autonomous_Robot_Teleoperation_With_Obstacle_Avoidance_via_Model_Predictive_Control

# Hệ thống theo dõi chuyển động cánh tay người không dây 7DOF: https://www.ncbi.nlm.nih.gov/pmc/articles/PMC7309037/

# Thuật toán điều khiển IMU và AHRS: https://x-io.co.uk/open-source-imu-and-ahrs-algorithms/

# Thuật toán lọc nhiễu Kanman: https://kdientu.duytan.edu.vn/media/133474/bo-loc-kalman.pdf

# 2.4.2. Nghiên cứu trong nước

# Thiết kế hệ thống điều khiển mô phỏng chuyển động cánh tay: https://www.slideshare.net/man2017/thit-k-h-thng-iu-khin-m-phng-chuyn-ng-cnh-taypdf

# TAY MÁY 5 BẬC TỰ DO VÀ ĐIỀU KHIỂN CHUYỂN ĐỘNG BẰNG CỬ ĐỘNG TAY ỨNG DỤNG TRONG XẾP SẢN PHẨM

# 2.5. Các tồn tại của hệ thống

# 2.5.1. Các tồn đọng của hệ thống

# Giao diện còn đơn giản, chưa thân thiện với người dùng, chưa có khả năng giám sát, mô phỏng robot.

# Cách điều khiển bằng găng tay chưa ổn định, khó có thể áp dụng vào thực tế.

# Hệ thống nhận diện vật thể còn phụ thuộc vào tool của hãng, nên chưa thể áp dụng linh hoạt vào thực tế.

# 2.5.2. Phương hướng giải quyết

# Sử dụng WPF thay cho Winform để tăng khả năng tùy biến của ứng dụng, viết thêm tính năng giám sát robot trên tool.

# Thiết kế lại thiết bị điều khiển robot dựa trên cử động của cánh tay thay vì dùng ngón tay

# Thực hiện lấy ảnh trực tiếp từ camera và viết lại thuật toán nhận dạng vật thể sử dụng C#

# CHƯƠNG 3: CƠ SỞ LÝ THUYẾT

## 3.1. Cơ sở lý thuyết về điều khiển

## 3.1.1. Lý thuyết về điều khiển robot

## 3.1.1.1. Tính toán động học cho cánh tay robot 5 DOF

## 3.1.1.1.1. Động học thuận

Sơ đồ động Robot:


Sơ đồ động Robot

Biểu diễn Denavit – Hartenberg:

Mô hình hóa Denavit-Hartenberg (Viết tắt là phương pháp D - H) là cách biểu diễn đơn giản mô hình các khâu và khớp của robot và có thể sử dụng cho bất cứ cấu hình robot nào, kể cả bài toán phức tạp hay đơn giản.

Áp dụng phương pháp D – H, ta gắn một hệ trục tham chiếu tới mỗi khớp và sau đó xác định sự chuyển vị từ khớp này đến khớp kế tiếp, với mỗi khớp chúng ta sẽ gắn trục z và trục x lên chúng (hình 3.1).

Áp dụng phương pháp D - H cho khớp 1, tương tự với các khớp còn lại. Ta có:

- Đánh số trục z của khớp 1 là 0. Như vậy, trục z biểu diễn khớp 1 là z0. Trục x sẽ song song với đường vuông góc chung giữa các trục khớp của khâu, tương tự với các khớp còn lại.
- Với:
- l: biểu diễn khoảng cách dường vuông góc chung giữa trục z0 và trục z1.
- θ1: góc quay từ trục x0 tới x1 xung quanh trục z0.
- α1: góc quay của trục z0 tới z1 xung quanh trục x1.
- d1: khoảng cách từ gốc tọa độ thứ 0 tới giao điểm của của trục z0 và x1 dọc theo trục z0.

→ Từ đó, ta có thể lập ra bảng D – H với 5 khớp một cách tương ứng dựa theo hình 3.1:

Bảng D-H:

Khâu | θ | l | α | d | Biến
1 | | 0 | | l1
2 | | | 0 | 0
3 | | | 0 | 0
4 | | 0 | | 0
5 | | 0 | 0 | l5

Bảng Denavit–Hartenberg của robot

Ở hệ trục thứ i sẽ mô tả ma trận vị trí và hướng so với hệ trục thứ i-1 như sau:

Ma trận chuyển trục Ai:

(1)

Với .

Từ đó, ta có ma trận chuyển trục của 5 khớp từ A1 đến A5 như sau:

Với kết quả trên, ta có ma trận chuyển vị tổng giữa nền Robot và cánh tay là:

=

(2)

Theo động học thuận, tọa độ điểm P là:

## 3.1.1.1.2. Động học nghịch

## Bài toán động học thuận gồm việc giải quyết vị trí và hướng của tay gắp hay cơ cấu chấp hành cuối khi biết tất cả các biến khớp. Bài toán động học nghịch yêu cầu tìm tập hay nhiều tập nghiệm của các khớp khi biết vị trí và hướng tay gắp.


Điều khiển vị trí của cánh tay robot

Với các giá trị đầu vào là Px, Py, Pz, φ, γ, Ta có:

(4)

Ta đặt:

(6)

## 3.1.1.2. Tính toán động lực học cho cánh tay robot 5DOF


Sơ đồ tính động học robot

Phương trình động lực học tổng quát:

Hay

Với

D(q) là ma trận quán tính

V(q,q) là vector hướng tâm

G(q) là vector trọng lực

Tính ma trận quán tính D(q) :

Ta có:

Ma trận chỉ hướng Ri là ma trận lấy các phần tử của 3 hàng và 3 cột đầu của ma trận chuyển vị Ti (đã tính ở phần động học thuận)

R_1 =[c_1 , 0, s_1 s_1 , 0, -c_1 0, 1, 0] R_2 =[c_1 c_2 , -c_1 s_2 , s_1 s_1 c_2 , -s_1 s_2 , -c_1 s_2 , c_2 , 0] R_3 =[c_1 c_23 , -c_1 s_23 , s_1 s_1 c_23 , -s_1 s_23 , -c_1 s_23 , c_23 , 0]

R_4 =[-c_1 s_234 , s_1 , c_1 c_234 -s_1 s_234 , -c_1 , s_1 c_234 c_234 , 0, s_234 ]

R_5 =[s_1 s_5 -s_234 c_1 c_5 , s_1 c_5 +s_234 c_1 s_5 , c_234 c_1 -c_1 s_5 -s_234 s_1 c_5 , -c_1 c_5 +s_234 s_1 s_5 , c_234 s_1 c_234 c_5 , -c_234 s_5 , s_234 ]

Ma trận moment quán tính Ii (là ma trận đặt trưng cho moment quán tính của các khâu)

I=[I_(xx) , I_(xy) , I_(xz) I_(yx) , I_(yy) , I_(yz) I_(zx) , I_(zy) , I_(zz) ]

Để đơn giản hóa việc tính toán, giả sử các khâu đều đối xứng qua các trục xx, yy, zz

Ta có

I_(xy) =I_(yx)

I_(xz) =I_(zx)

I_(yz) =I_(zy)

Xét hình dáng của các khâu 2,3,4 là thanh thẳng có tiết diện ngnang không đáng kể.

Xét hình dáng của các khâu 1,5 là hình trụ tròn.

Ta có hình dáng tổng quát cùng vị trí đặt trục tọa độ như sau:


Hình 3.16: Hình dáng tổng quát để tính Moment quán tính của các khớp

Ta có:

I1: I_(xx) = I_(xx1) , I_(yy) = I_(yy1) , I_(zz) = I_(xx) =I_(xx1)

I2: I_(xx) ≈ 0 , I_(yy) = I_(yy2) , I_(zz) = I_(yy) =I_(yy2)

I3: I_(xx) ≈ 0 , I_(yy) = I_(yy3) , I_(zz) = I_(yy) =I_(yy3)

I4: I_(xx) = I_(yy) =I_(yy4) , I_(yy) = I_(yy4) , I_(zz) ≈ 0

I5: I_(xx) = I_(yy) =I_(yy5) , I_(yy) = I_(yy5) , I_(zz) = I_(zz) =I_(zz5)

Tổng hợp lại ta có:

I_1 =[I_(xx1) , 0, 00, I_(yy1) , 00, 0, I_(xx1) ] ; I_2 =[0, 0, 00, I_(yy2) , 00, 0, I_(yy2) ] ; I_3 =[0, 0, 00, I_(yy3) , 00, 0, I_(yy3) ] ;

I_4 =[I_(yy4) , 0, 00, I_(yy4) , 00, 0, 0] ; I_5 =[I_(yy5) , 0, 00, I_(yy5) , 00, 0, I_(zz5) ]

Sử dụng công thức tính moment quán tính cho các khối cơ bản ta xác định được giá trị của các phần tử trong ma trận I.

Momen quán tính là gì? | Cốp Pha Việt

Các công thức tính moment quán tính cho các khối cơ bản

Ma trận biểu diễn vi trí trọng tâm khâu p_(ci) so với hệ tọa độ gốc O0 (Các giá trị được tính bằng phương pháp hình học)

p_(c1) =[00l_(c1) ] ; p_(c2) =[l_(c2) c_1 c_2 l_(c2) s_1 c_2 l_1 +l_(c2) s_2 ] ; p_(c3) =[c_1 (l_(c3) c_23 +l_2 c_2 )s_1 (l_(c3) c_23 +l_2 c_2 )l_1 +l_(c3) s_23 +l_2 s_2 ] ;

p_(c4) =[c_1 (l_3 c_23 +l_2 c_2 +l_(c4) c_234 )s_1 (l_3 c_23 +l_2 c_2 +l_(c4) c_234 )l_1 +l_3 s_23 +l_2 s_2 +l_(c4) s_234 ]

p_(c5) =[c_1 (l_3 c_23 +l_2 c_2 +l_(c5) c_234 )s_1 (l_3 c_23 +l_2 c_2 +l_(c5) c_234 )l_1 +l_3 s_23 +l_2 s_2 +l_(c5) s_234 ]

Ma trận Jacobi khâu

Ma trận Jacobi vận tốc gốc ω_i :

⁰ ω_i =ω_1 +R_1 ω_2 +…+R_(i-1) ω_i với ω_i là vận tốc gốc của khâu thứ i

R_(i-1) là ma trận chỉ hướng của khâu thứ i

Ta có:

ω_1 =[00θ_1 ] ; ω_2 =[00θ_2 ] ; ω_3 =[00θ_3 ] ; ω_4 =[00θ_4 ] ; ω_5 =[00θ_5 ]

⁰ ω_1 =[00θ_1 ] ; ⁰ ω_2 =[θ_2 s_1 -θ_2 c_1 θ_1 ] ; ⁰ ω_3 =[(θ_2 +θ_3 )s_1 -(θ_2 +θ_3 )c_1 θ_1 ] ; ⁰ ω_4 =[-(θ_2 +θ_3 +θ_4 )s_1 (θ_2 +θ_3 +θ_4 )c_1 θ_1 ] ;

⁰ ω_5 =[-(θ_2 +θ_3 +θ_4 )s_1 +θ_5 c_234 c_1 (θ_2 +θ_3 +θ_4 )c_1 +θ_5 c_234 s_1 θ_1 +θ_5 s_234 ] ;

Ma trận Jacobi vận tốc dài J_(vi) :

J_(v1) =[(dpc1[1])/(dθ_1), 0, 0 0 0(dpc1[2])/(dθ_1), 0, 0 0 0(dpc1[3])/(dθ_1), 0, 0 0 0 ] J_(v2) =[(dpc2[1])/(dθ_1), (dpc2[1])/(dθ_2), 0 0 0(dpc2[2])/(dθ_1), (dpc2[2])/(dθ_2), 0 0 0(dpc2[3])/(dθ_1), (dpc2[3])/(dθ_2), 0 0 0 ]

J_(v3) =[(dpc3[1])/(dθ_1), (dpc3[1])/(dθ_2), (dpc3[1])/(dθ_3) 0 0(dpc3[2])/(dθ_1), (dpc3[2])/(dθ_2), (dpc3[2])/(dθ_3) 0 0(dpc3[3])/(dθ_1), (dpc3[3])/(dθ_2), (dpc3[3])/(dθ_3) 0 0 ] J_(v4) =[(dpc4[1])/(dθ_1), (dpc4[1])/(dθ_2), (dpc4[1])/(dθ_3) (dpc4[1])/(dθ_4) 0(dpc4[2])/(dθ_1), (dpc4[2])/(dθ_2), (dpc4[2])/(dθ_3) (dpc4[1])/(dθ_4) 0(dpc4[3])/(dθ_1), (dpc4[3])/(dθ_2), (dpc4[3])/(dθ_3) (dpc4[1])/(dθ_4) 0 ]

J_(v5) =[(dpc5[1])/(dθ_1), (dpc5[1])/(dθ_2), (dpc5[1])/(dθ_3) (dpc5[1])/(dθ_4) (dpc5[1])/(dθ_5)(dpc5[2])/(dθ_1), (dpc5[2])/(dθ_2), (dpc5[2])/(dθ_3) (dpc5[2])/(dθ_4) (dpc5[2])/(dθ_5)(dpc5[3])/(dθ_1), (dpc5[3])/(dθ_2), (dpc5[3])/(dθ_3) (dpc5[3])/(dθ_4) (dpc5[3])/(dθ_5) ]

Kết quả:

J_(v1) =[0, 0, 00, 0, 00, 0, 0 0, 00, 00, 0] (22)

J_(v2) =[-l_(c2) c_2 s_1 , -l_(c2) c_1 s_2 , 0l_(c2) c_1 c_2 , -l_(c2) s_1 s_2 , 00, l_(c2) c_2 , 0 0, 00, 00, 0] (23)

J_(v3) =[-s_1 (l_(c3) c_23 +l_2 c_2 ), -c_1 (l_(c3) s_23 +l_2 s_2 ), -l_(c3) s_23 c_1 c_1 (l_(c3) c_23 +l_2 c_2 ), -s_1 (l_(c3) s_23 +l_2 s_2 ), -l_(c3) s_23 s_1 0, l_(c3) c_23 +l_2 c_2 , l_(c3) c_23 0, 00, 00, 0] (24)

J_(v4) =[-s_1 (l_3 c_23 +l_2 c_2 +l_(c4) c_234 ), -c_1 (l_3 s_23 +l_2 s_2 +l_(c4) s_234 ), -c_1 (l_3 s_23 +l_(c4) s_234 )c_1 (l_3 c_23 +l_2 c_2 +l_(c4) c_234 ), -s_1 (l_3 s_23 +l_2 s_2 +l_(c4) s_234 ), -s_1 (l_3 s_23 +l_(c4) s_234 )0, l_3 c_23 +l_2 c_2 +l_(c4) c_234 , l_3 c_23 +l_(c4) c_234 -l_(c4) s_234 c_1 , 0-l_(c4) s_234 s_1 , 0l_(c4) c_234 , 0]

Với giá trị i chạy từ 1 đến 5, thay các giá trị vừa tính được vào biểu thức ban đầu, ta tìm được ma trận quán tính D(q).

D(q)=[d_11 , d_12 , d_13 , d_14 , d_15 d_21 , d_22 , d_23 , d_24 , d_25 d_31 , d_32 , d_33 , d_34 , d_35 d_41 , d_42 , d_43 , d_44 , d_45 d_51 , d_52 , d_54 , d_54 , d_55 ]

Tính Vector hướng tâm V(q,q)

V(q,q)=[v_1 , v_2 , v_3 , v_4 , v_5 ] ^T

v_k =∑_(i,j) ((∂d_(kj))/(∂q_i)-1/2(∂d_(ij))/(∂q_k))q_i q_j với k chạy từ 1 đến 5 và i và j thể hiện vị trí phần tử của ma trận quán tính

- Tính Vector trọng lực G(q):

G(q)=[g_1 , g_2 , g_3 , g_4 , g_5 ] ^T với g_k =(∂P)/(∂q_k)

P là thế năng tổng cộng của cánh tay được tính bằng P=-∑_(i=1)^n m_i g^T p_(ci)

→ với g_k =-∑_(i=1)^n m_i g^T (∂p_(ci))/(∂q_k)

Mà (∂p_(ci))/(∂q_k) chính là cột thứ k trong ma trận J_(vi)

Tiến thành tính toán số liệu cụ thể

Ta có các thông số đã biết:

- m1=27,5 [kg]; m2=21 [kg]; m3=25,1 [kg]; m4=3 [kg]; m5=5,2 [kg];
- l1=690 [mm]; l2=440 [mm]; l3=500 [mm]; l5=230 [mm];
- lc1=660 [mm]; lc2=255 [mm]; lc3=143 [mm]; lc4=6 [mm]; lc5=143 [mm];
- g=9,81 [m/s²]
- Ixx1=461147 N.mm²; Iyy1=299920 N.mm²; Iyy2=803322 N.mm²; Iyy3=1604504 N.mm² Iyy4=6328 N.mm²; Iyy5=24861 N.mm²; Izz5=14388 N.mm²

Vì khối lượng tính toán rất phức tạp nên ta sẽ sử dụng MATLAB để tăng độ chính xác và tin cậy cho quá trình tính toán. Ta sẽ thế giá trị trực tiếp và áp dụng thêm điều kiện ràng buộc θ_2 +θ_3 +θ_4 =(-π)/2 để kết quả tính toán ngắn gọn nhất có thể.

Xác định tải tĩnh lớn nhất mà cánh tay robot chịu được:

Xét trường hợp cánh tay robot ở trạng thái tĩnh, khi đó các giá trị vận tốc và gia tốc sẽ bằng 0, từ đó dẫn đến D(q)q +V(q,q)=0 . Phương trình động lực học khi đó chỉ còn phụ thuộc vào vector trọng lực G(q) :

τ=D(q)q+V(q,q)+G(q)= G(q)

τ2 = (49*m4*(l3*cos(t2 + t3) + l2*cos(t2)))/5 + (49*m5*(l3*cos(t2 + t3) + l2*cos(t2)))/5 + (49*m3*(lc3*cos(t2 + t3) + l2*cos(t2)))/5 + (49*lc2*m2*cos(t2))/5

τ3 = (49*cos(t2 + t3)*(l3*m4 + l3*m5 + lc3*m3))/5

Khi đó, ta xác định vị trí mà cánh tay robot chịu moment lớn nhất. Về nguyên tắc, moment được xác định bằng tích của lực và độ dài cánh tay đòn. Lực ở đây chính là trọng lực của vật thể cần gắp, cánh tay đòn là khoảng cách từ vật gắp đến gốc tọa độ ban đầu của robot. Ta xác định được cấu hình mà cánh tay chịu lực lớn nhất đó chính là khi cánh tay bị duỗi thẳng như hình:

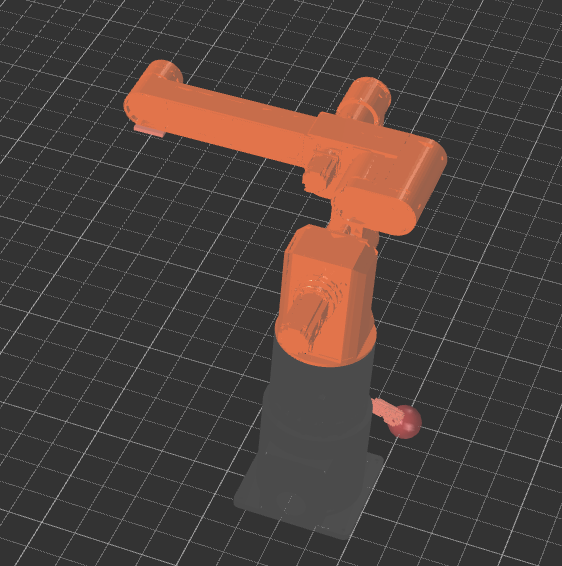
[picture p136: figure]

Vị trí của robot mà động cơ chịu moment lớn nhất thõa mãn đầu tay gắp vuông góc với mặt đất

Với khâu 5 gắn với vật cần gắp nên ta đặt là 1 biến số. Cho biến m5 tăng dần, ta thu được biểu đồ liên hệ giữa khối lượng vật càn gắp và moment phải chịu của các động cơ:


Mối liên hệ giữa khối lượng khâu 5 và moment phải chịu của khớp 2

Tra thông số động cơ tại khớp 2 của robot (HG-KR73) ta có:


Thông số động cơ tại khớp 2

Bộ truyền Hamornic có tỉ số truyền 1:180, cho hiệu suất bộ truyền, do đó moment mà khớp 2 chịu được sẽ là:

T2max = 2.4 * 180 = 432 Nm

Suy ra khối lượng lớn nhất của khâu số 5 mà động cơ vẫn chịu được là 19Kg

Từ đó, vật lớn nhất mà robot gắp được sẽ khoảng 17kg.

Ma trận Jacobi nghịch sử dụng phương pháp The Pseudo-Inverse:

Từ ma trận Jacobi thuận Jv5 . Vì ma trận cho robot 5 bậc tự do là một ma trận không vuông, ta không thể tính Jacobi nghịch theo cách thông thường. Ta sẽ áp dụng công thức Pseudo-Inverse:

Với và là vận tốc dài của robot trong tọa độ Oxyz, từ dó ta sẽ có được ma trận chứa vận tốc cho từng khớp của robot.

## Từ những kiến thức nêu trên, ta có thể áp dụng đưa vào hệ thống điều khiển để tính toán cũng như đưa ra những giải thuật điều khiển robot về vị trí cũng như vận tốc, đảm bảo tính linh hoạt và hiệu quả trong quy trình hoạt động.

## 3.1.2. Lý thuyết áp dụng trong thiết bị theo dõi chuyển động

## 3.2. Cơ sở lý thuyết về lập trình

## 3.2.1. Lập trình WPF

Windows Presentation Foundation (WPF) là một công nghệ của Microsoft dùng để xây dựng các ứng dụng giao diện đồ họa trên Windows. WPF cung cấp một hệ thống mạnh mẽ và linh hoạt để phát triển ứng dụng, sử dụng XAML (Extensible Application Markup Language) kết hợp với C# để thiết kế giao diện người dùng và xử lý logic.

## 3.2.1.1. Cấu trúc cơ bản của WPF

## 3.2.1.1.1. XAML

## Là ngôn ngữ đánh dấu XML-based dùng để định nghĩa và khởi tạo các đối tượng WPF.

<Window x:Class="WpfApp.MainWindow"

xmlns="http://schemas.microsoft.com/winfx/2006/xaml/presentation"

xmlns:x="http://schemas.microsoft.com/winfx/2006/xaml"

Title="MainWindow" Height="350" Width="525">

<Grid>

<Button Content="Click Me" HorizontalAlignment="Left" VerticalAlignment="Top" Width="100" Height="50" Click="Button_Click"/>

</Grid>

</Window>

## 3.2.1.1.2. Code-behind

## Là file C# chứa logic xử lý cho giao diện người dùng được định nghĩa trong XAML. Code-behind và XAML được liên kết với nhau thông qua thuộc tính ‘x:Class’

using System.Windows;

namespace WpfApp

{

public partial class MainWindow : Window

{

public MainWindow()

{

InitializeComponent();

}

private void Button_Click(object sender, RoutedEventArgs e)

{

MessageBox.Show("Button clicked!");

}

}

}

## 3.2.1.2. Giới thiệu về Helixtookit với WPF

## 3.2.1.2.1. Khái niệm

## Là một thư viện mã nguồn mở bổ sung cho WPF, cung cấp các công cụ và thành phần để làm việc với đồ họa 3D một cách dễ dàng và mạnh mẽ hơn. HelixToolkit mở rộng khả năng của WPF trong việc xử lý và hiển thị các mô hình 3D.

## 3.2.1.2.2. Tính năng chính của HelixToolkit

- Dễ dàng hiển thị mô hình 3D: Cung cấp các điều khiển và tiện ích để hiển thị các mô hình 3D với ít mã cần viết.
- Hỗ trợ nhiều định dạng mô hình 3D: Hỗ trợ đọc và hiển thị các định dạng mô hình phổ biến như .obj, .3ds, .stl, .lwo.
- Các công cụ tương tác: Bao gồm các công cụ để di chuyển, xoay, phóng to, thu nhỏ các mô hình 3D.
- Hiệu ứng và ánh sáng: Cung cấp các hiệu ứng và ánh sáng để cải thiện việc hiển thị mô hình 3D.

## 3.2.2. Lập trình C

Lập trình C là một trong những ngôn ngữ lập trình phổ biến và cơ bản nhất, được phát triển vào những năm 1970 bởi Dennis Ritchie tại Bell Labs. Ngôn ngữ C nổi bật với tính linh hoạt, hiệu suất cao và khả năng kiểm soát phần cứng, khiến nó trở thành một lựa chọn phổ biến trong nhiều lĩnh vực, từ phát triển hệ điều hành đến lập trình nhúng.

## 3.2.2.1. Cấu trúc cơ bản của chương trình C

## Một chương trình C cơ bản gồm các thành phần sau:

## Tiêu đề thư viện: Các thư viện chuẩn được đưa vào để cung cấp các hàm và macro hữu ích.

## Hàm chính (main): Điểm bắt đầu của chương trình, nơi thực hiện các lệnh và xử lý logic.

#include <stdio.h>

int main() {

printf("Hello, World!\n");

return 0;

}

## 3.2.2.2. Các khác niệm cơ bản trong chương trình C

## Một số khái niệm cơ bản cần được nắm trong ngôn ngữ lập trình C:

## Kiểu dữ liệu: Các kiểu dữ liệu cơ bản như kiểu số thực, kiểu số nguyên, kiểu ký tự và kiểu con trỏ.

## Toán tử và biểu thức: C hỗ trợ nhiều loại toán tử để thực hiện các phép toán số học, logic và so sánh.

## Cấu trúc điều khiển: Bao gồm các câu lệnh điều khiển như: If, Else if, Else, Switch… và vòng lặp như: For, While, Do-while…

## Hàm: là một phần của mã nguồn được định nghĩa để thực hiện một nhiệm vụ cụ thể. Hàm giúp phân chia chương trình thành các phần nhỏ, dễ quản lý và tái sử dụng

## Mảng và chuỗi: Mảng là một tập hợp các phần tử cùng kiểu dữ liệu, được lưu trữ liên tiếp trong bộ nhớ, Chuỗi là một mảng các ký tự kết thúc bằng ký tự null (‘\0’).

## Con trỏ: là một biến lưu trữ địa chỉ của một biến khác. Con trỏ rất mạnh mẽ và linh hoạt, cho phép thao tác trực tiếp với bộ nhớ.

## Cấu trúc (Struct): cho phép nhóm các biến khác nhau lại với nhau dưới một tên duy nhất, giúp quản lý dữ liệu phức tạp hơn.

## Quản lý bộ nhớ: các hàm để quản lý bộ nhớ động như malloc, calloc, realloc, và free.

## Tiền xử lý (Preprocessor): Trình tiền xử lý của C thực hiện các thao tác như bao gồm thư viện (#include), định nghĩa macro (#define), và các điều kiện tiền xử lý (#if, #ifdef, #ifndef)

## 3.2.3. Ngôn ngữ lập trình ladder/SFC trong PLC

## 3.2.3.1. Ngôn ngữ lập trình ladder

## Ladder Logic (hay còn gọi là Ladder Diagram - LD) là một ngôn ngữ lập trình được phát triển dựa trên sơ đồ mạch điện và sử dụng rộng rãi trong các hệ thống điều khiển công nghiệp. Nó được thiết kế để mô phỏng các mạch relay và contactor điện tử.

## 3.2.3.1.1. Cấu trúc cơ bản của ladder

## Rungs: Mỗi chương trình Ladder được chia thành các rungs (bậc thang), mỗi rung tương đương với một mạch điều khiển độc lập.

## Contacts: Đại diện cho các đầu vào và các điều kiện logic (NO - Normally Open, NC - Normally Closed).

## Coils: Đại diện cho các đầu ra, thường là các thiết bị hoặc tác vụ được điều khiển

## Timers and Counters: Được sử dụng để thực hiện các tác vụ liên quan đến thời gian và đếm.

## 3.2.3.2. Ngôn ngữ lập trình SFC

## 3.3. Cơ sở lý thuyết về xử lí ảnh

## 3.4. Cơ sở lý thuyết về điện – điện tử

# CHƯƠNG 4: THIẾT KẾ PHẦN CỨNG HỆ THỐNG

## 4.1. Thiết kế phần cứng cho cánh tay robot

## 4.2. Thiết kế phần cứng cho băng tải

## 4.3. Thiết kế phần cứng cho thiết bị theo dõi chuyển động

# CHƯƠNG 5: XÂY DỰNG PHẦN MỀM CHO HỆ THỐNG

## 5.1. Xây dựng phần mềm cho cánh tay robot

## 5.2. Xây dựng phần mềm cho băng tải

## 5.3. Xây dựng phần mềm cho thiết bị theo dõi chuyển động

## 5.4. Xây dựng giao diện giám sát, điều khiển cho hệ thống bằng WPF

# CHƯƠNG 6: KẾT QUẢ - THỰC NGHIỆM – HƯỚNG PHÁT TRIỂN
