TNH510/5_DOF_Robot_Arm/docs/powerpoint/thuyet_trinh_do_an_co_dien_tu.pptx

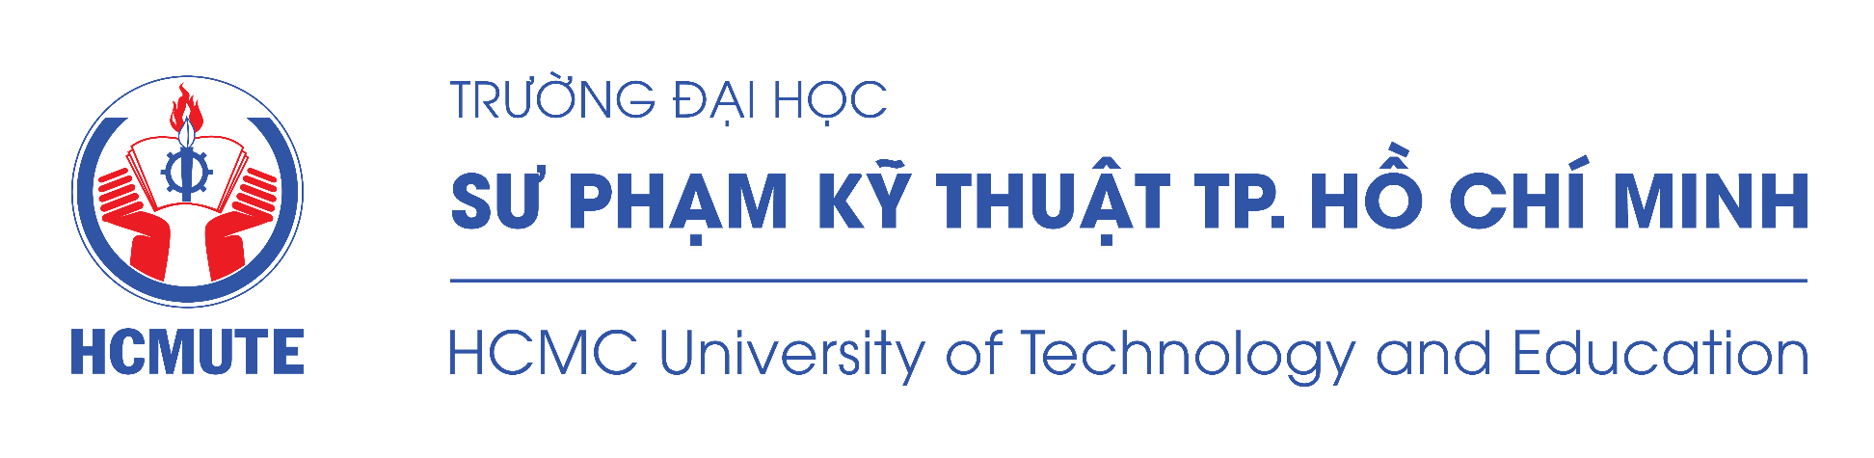
[picture p154: figure]

ĐỒ ÁN CƠ ĐIỆN TỬ

NGHIÊN CỨU, PHÁT TRIỂN TAY MÁY 5 BẬC TỰ DO ỨNG DỤNG TRONG BỐC XẾP

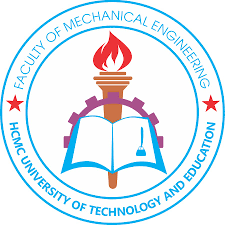
[picture p155: figure]

GVHD: TS. Nguyễn Xuân Quang
SVTH: Trần Ngọc Hiểu 20146127
Nguyễn Bá Vũ Thạch 20146530
Lê Tấn Lộc 20146121

## Slide 2

NỘI DUNG BÁO CÁO

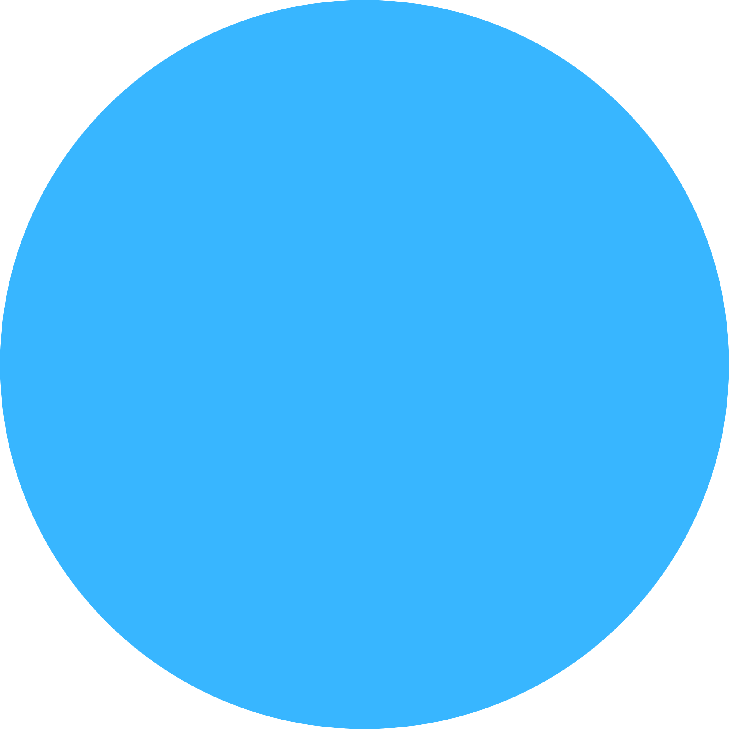
[picture p156: figure]

1

2

3

Tổng quan đề tài

- Cấu trúc đề tài đồ án
- Các nghiên cứu liên quan
- Mục tiêu và giới han đề tài

Quy trình thực hiện

Kết luận

- Kết quả đạt được
- Hạn chế
- Hướng phát triển

- Xây dựng thuật toán và hệ thống điều khiển
- Thiết kế giao diện điều khiển và giám sát
- Thiết kế găng tay điều khiển

## Slide 3

CẤU TRÚC ĐỀ TÀI ĐỒ ÁN

- Chương 1: Giới thiệu
- Chương 2: Cơ sở lý thuyết
- Chương 3: Động học và động lực học tay máy
- Chương 4: Tính toán, thiết kế phần cơ khí
- Chương 5: Thiết kế hệ thống điều khiển bằng PLC và STM32F207 ESP8266
- Chương 6: Thiết kế và thuật toán điều khiển găng tay
- Chương 7: Thiết kế ứng dụng giám sát và ứng dụng điều khiển
- Chương 8: Kết quả, nhận xét, hướng phát triển

## Slide 4

MỤC TIÊU VÀ GIỚI HẠN ĐỀ TÀI

Mục tiêu đề tài:
- Chọn cấu hình cánh tay robot thích hợp với yêu cầu đặt ra.
- Tính toán bài toán động học tay máy.
- Tính toán bài toán động lực học tay máy.
- Xây dựng hệ thống điều khiển cánh tay robot.
- Xây dựng giao diện điều khiển, giám sát hoạt động cánh tay robot.
- Thiết kế, chế tạo găng tay điều khiển.
Giới hạn đề tài:
Tay máy 5 bậc tự do được sử dụng để sắp xếp các sản phẩm hình hộp chuyển từ hệ thống băng tải này sang băng tải hệ thống băng tải khác. Ngoài ra tay máy còn có thể được điều khiển dựa vào cử động của bàn tay người dùng.
