TNH510/5_DOF_Robot_Arm/docs/final_project/ppt/main_ppt.pptx

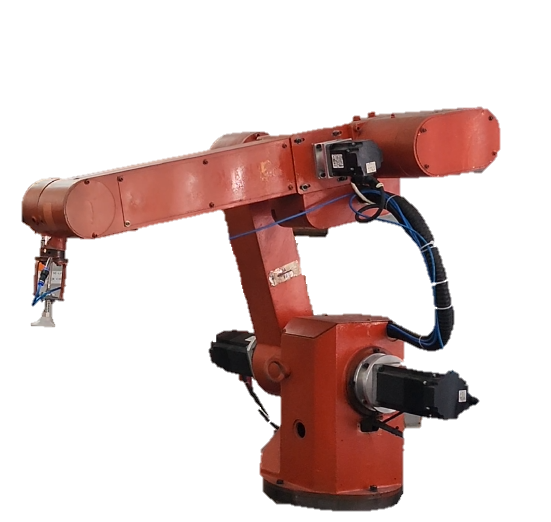
[picture p157: figure]
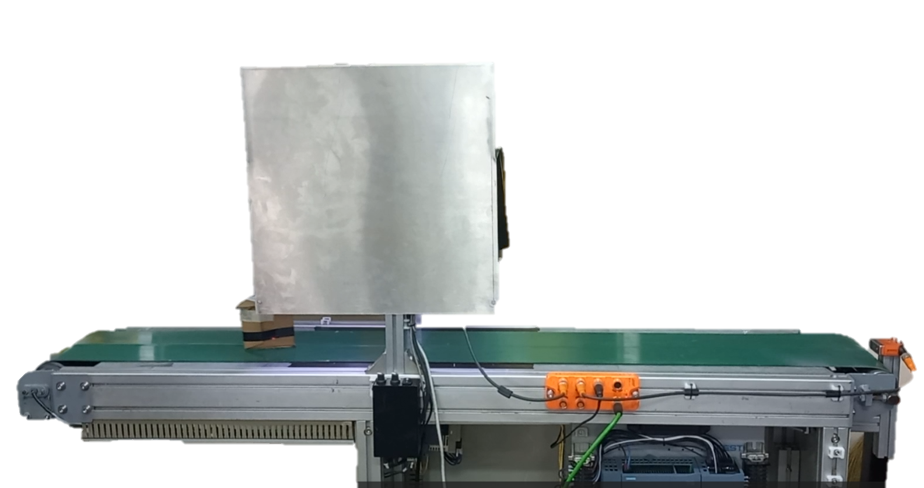
[picture p158: figure]
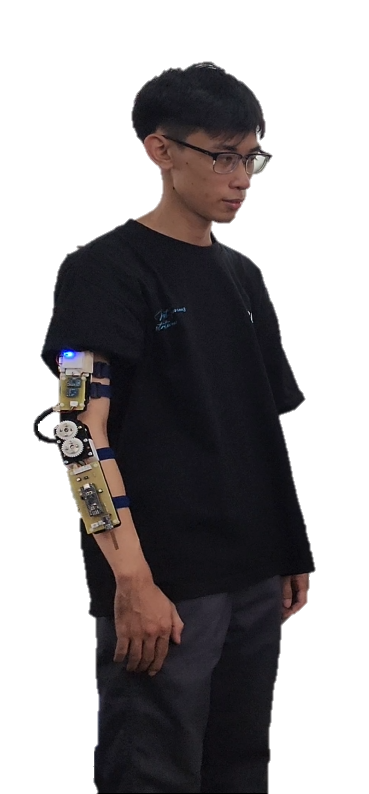
[picture p159: figure]
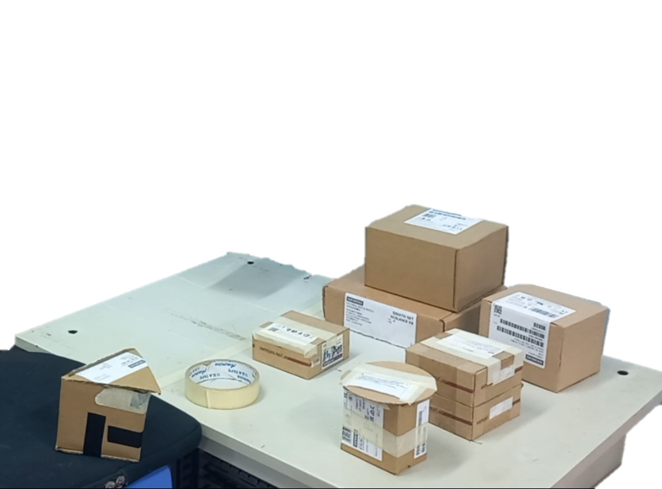
[picture p160: figure]

## Slide 2

## Slide 3
