TNH510/5_DOF_Robot_Arm/tong_hop_ban_ve/bia/tập bản vẽ chi tiết part 2.pdf

TẬP BẢN VẼ CHI TIẾT
CHO CÁNH TAY ROBOT 5 BẬC TỰ DO
