TNH510/5_DOF_Robot_Arm/drawing/tua_de_ban_ve/tap-ban-ve-chi-tiet.pdf

BỘ GIÁO DỤC VÀ ĐÀO TẠO

TRƯỜNG ĐẠI HỌC SƯ PHẠM KỸ THUẬT TP.HCM

KHOA CƠ KHÍ CHẾ TẠO MÁY

BỘ MÔN CƠ ĐIỆN TỬ

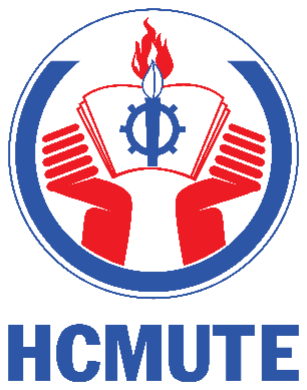
[picture p163: figure]

# TẬP BẢN VẼ CHI TIẾT

GVHD: TS. NGUYỄN XUÂN QUANG

SVTH:
TRẦN NGỌC HIỂU | 20146127

NGUYỄN BÁ VŨ THẠCH 20146530

LÊ TẤN LỘC | 20146121

Năm học: 2023-2024
