TNH510/5_DOF_Robot_Arm/tong_hop_ban_ve/ban_ve_canh_tay_robot/pdf/[K0]Vo_De.pdf

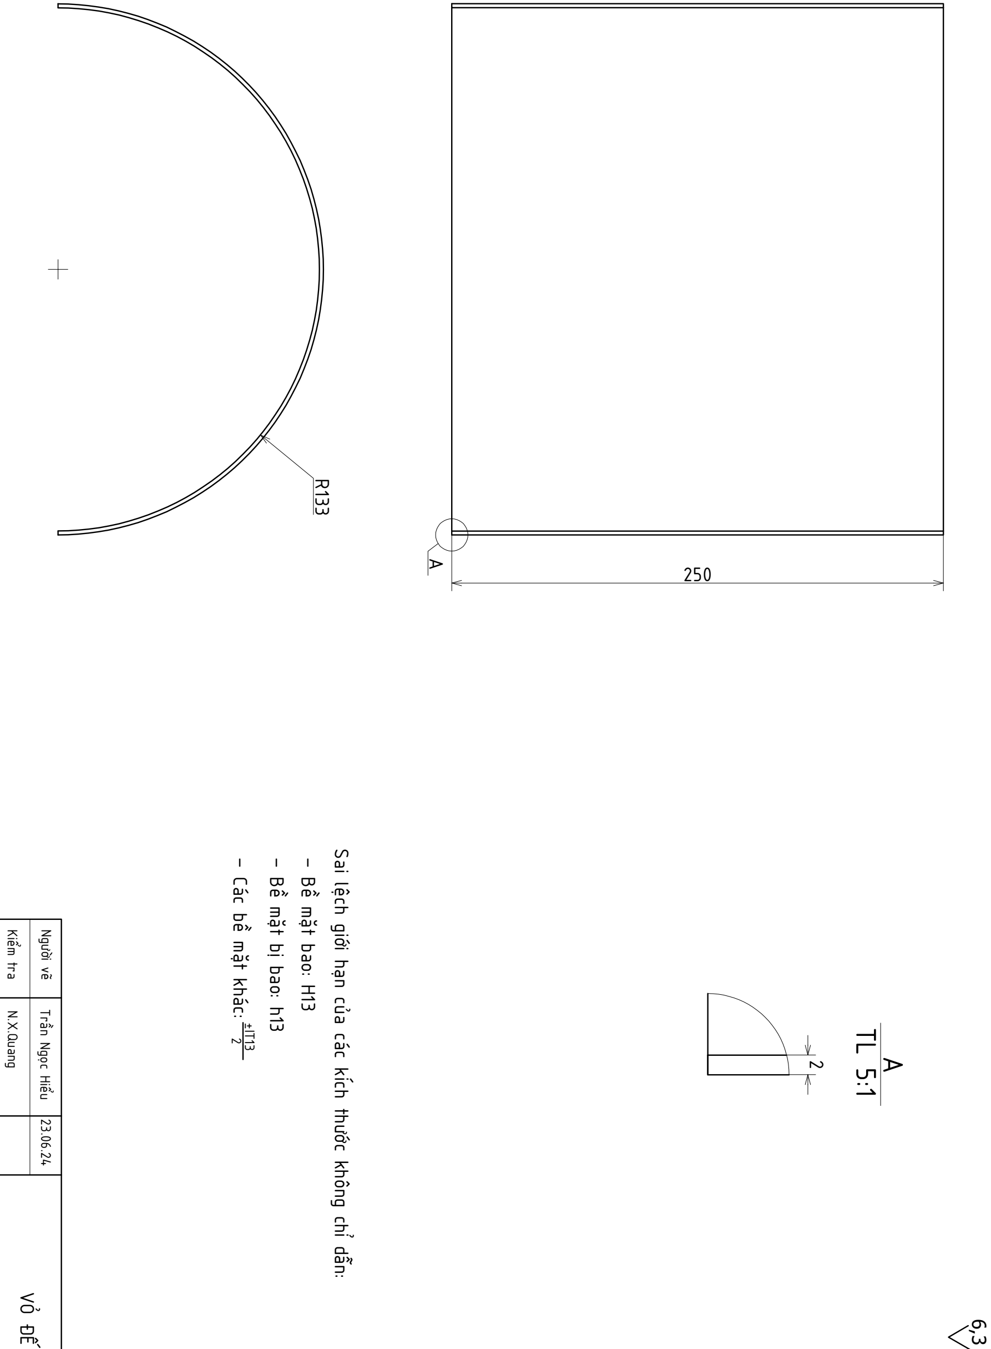
[picture p164: figure]
TL 5:1 A 23.06.24 N.X.Quang; Trần Ngọc Hiểu

2 ±IT13 – Các bề mặt khác: – Bề mặt bị bao: h13 – Bề mặt bao: H13 Sai lệch giới hạn của các kích thước không chỉ dẫn: VỎ ĐẾ Trường ĐH. SPKT TPHCM - Khoa: CKM Kiểm tra Người vẽ Sắt 1:2

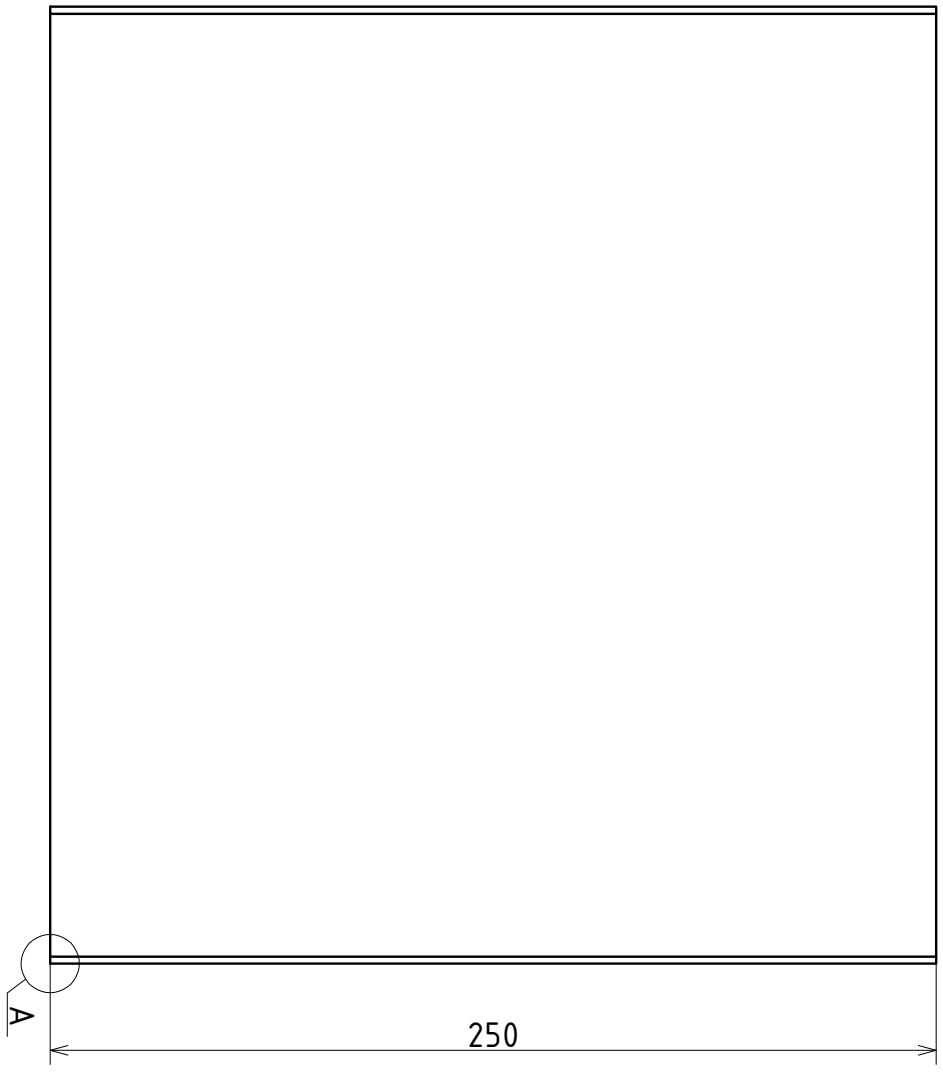
[picture p165: figure]
