TNH510/5_DOF_Robot_Arm/tong_hop_ban_ve/ban_ve_thiet_bi_theo_doi_chuyen_dong/pdf/HCMUTE-0005-001.pdf

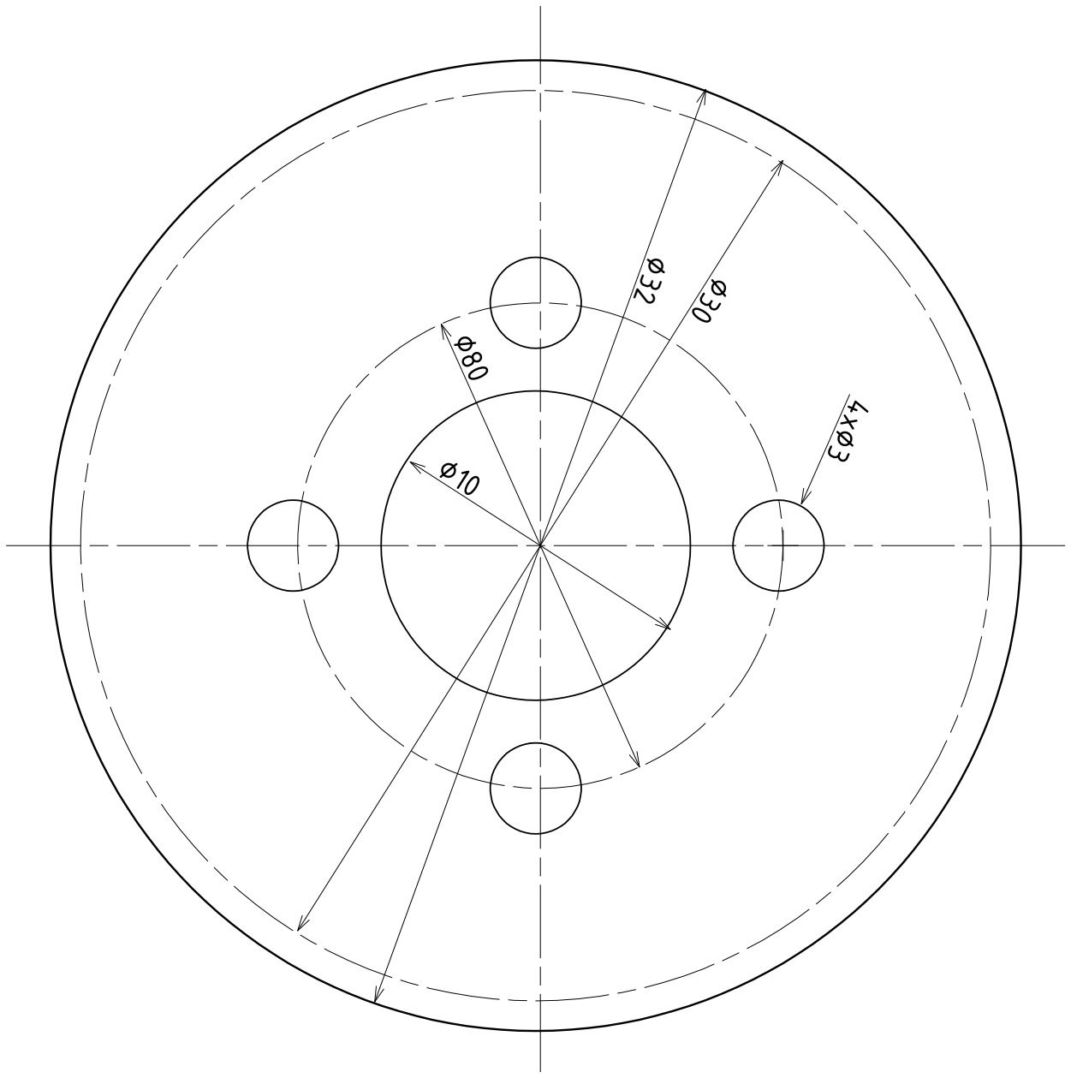
[picture p166: figure]

BÁNH RĂNG 23.06.24 Trần Ngọc Hiểu Trường ĐH. SPKT TPHCM - Khoa: CKM Kiểm tra Người vẽ ∅32 ∅30 5 ∅80 ∅10 Nhựa PLA 5:1 HCMUTE-0005-001 N.X.Quang 2 ±IT13 – Các bề mặt khác: – Bề mặt bị bao: h13 – Bề mặt bao: H13 Sai lệch giới hạn của các kích thước không chỉ dẫn: 6.3 Góc tiếp xúc a Số răng z = 30 Mô đun m = 1 ĐẶC TÍNH ĂN KHỚP = 20° 4x∅3
