TNH510/5_DOF_Robot_Arm/tong_hop_ban_ve/ban_ve_thiet_bi_theo_doi_chuyen_dong/pdf/HCMUTE-0007-001.pdf

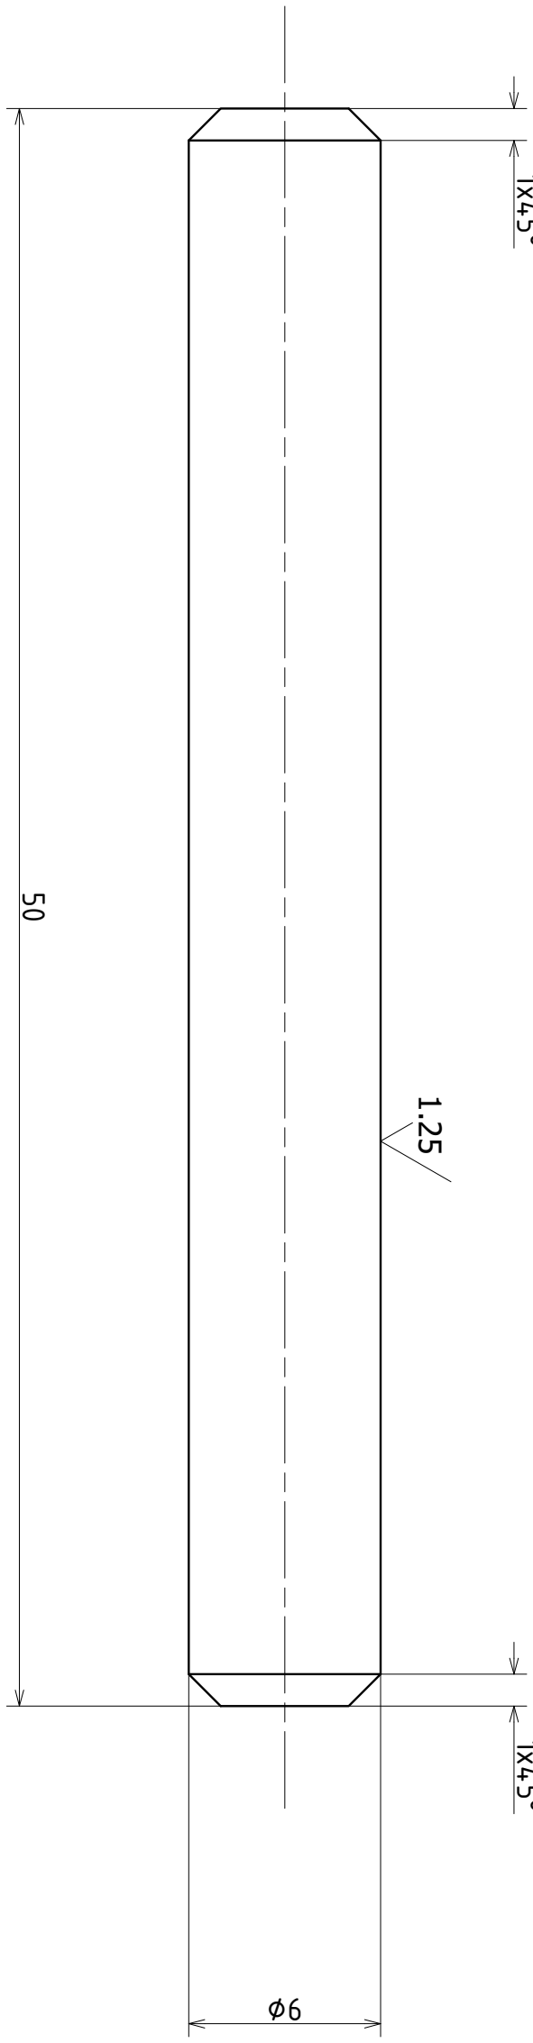
[picture p167: figure]

TRỤC KHỦY TAY 23.06.24 Trần Ngọc Hiểu Trường ĐH. SPKT TPHCM - Khoa: CKM Kiểm tra Người vẽ Thép 5:1 1x45° 1x45° 6.3 2 ±IT13 – Các bề mặt khác: – Bề mặt bị bao: h13 – Bề mặt bao: H13 Sai lệch giới hạn của các kích thước không chỉ dẫn: ∅6 50 HCMUTE-0007-001 N.X.Quang 1.25
