TNH510/5_DOF_Robot_Arm/tong_hop_ban_ve/ban_ve_thiet_bi_theo_doi_chuyen_dong/pdf/HCMUTE-0008-001.pdf

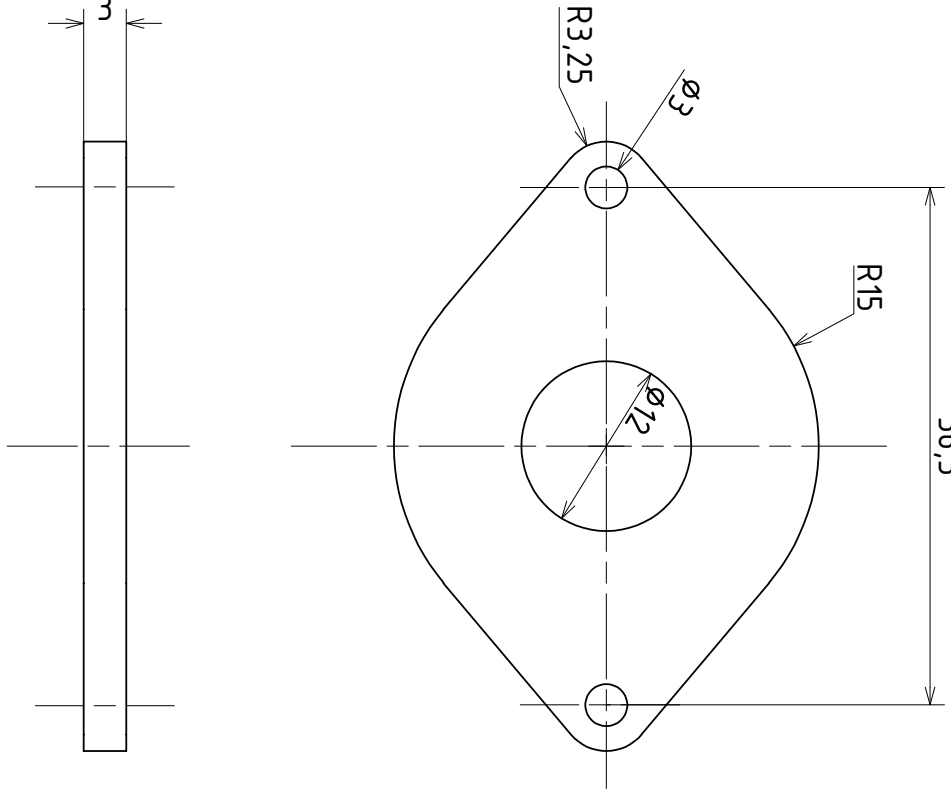
[picture p168: figure]

23.06.24 Trần Ngọc Hiểu Trường ĐH. SPKT TPHCM - Khoa: CKM Kiểm tra Người vẽ Mica đen 2:1 ∅12 R15 ∅3R3,25 3 36,5 HCMUTE-0008-001 N.X.Quang 6.3 2 ±IT13 – Các bề mặt khác: – Bề mặt bị bao: h13 – Bề mặt bao: H13 Sai lệch giới hạn của các kích thước không chỉ dẫn: MIẾNG CHE Ổ LĂN 1
