TNH510/5_DOF_Robot_Arm/tong_hop_ban_ve/ban_ve_thiet_bi_theo_doi_chuyen_dong/pdf/HCMUTE-0009-001.pdf

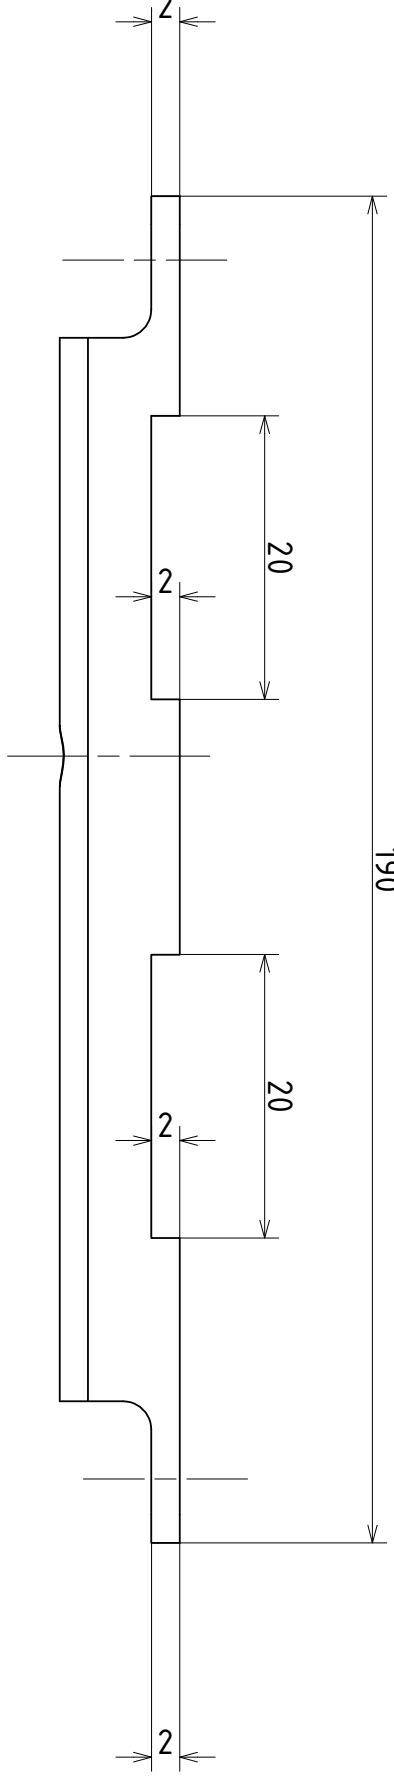
[picture p169: figure]
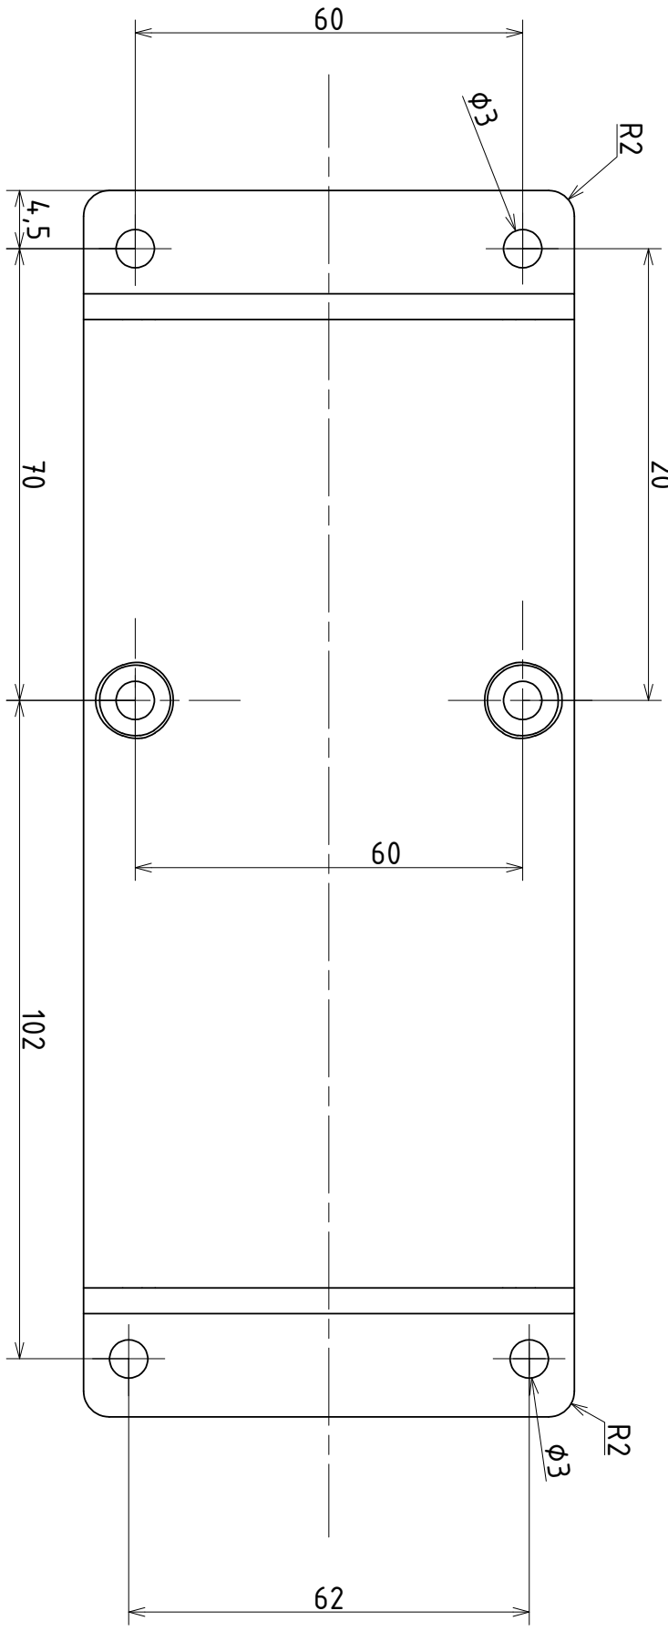
[picture p170: figure]

BB B-BMIẾNG ĐỆM CÁNH TAY 23.06.24 Trần Ngọc Hiểu Trường ĐH. SPKT TPHCM - Khoa: CKM Kiểm tra Người vẽ Nhựa PLA 2:1 HCMUTE-0009-001 N.X.Quang 6.3 2 ±IT13 – Các bề mặt khác: – Bề mặt bị bao: h13 – Bề mặt bao: H13 Sai lệch giới hạn của các kích thước không chỉ dẫn: 20

∅3 22 | 20 20 2 | 102 70 2 | 4,5 190 | R2 R2 Các góc bo không chỉ dẫn kích thước có bán kính 0.2mm | R2 R2 30° | 5 | ∅3

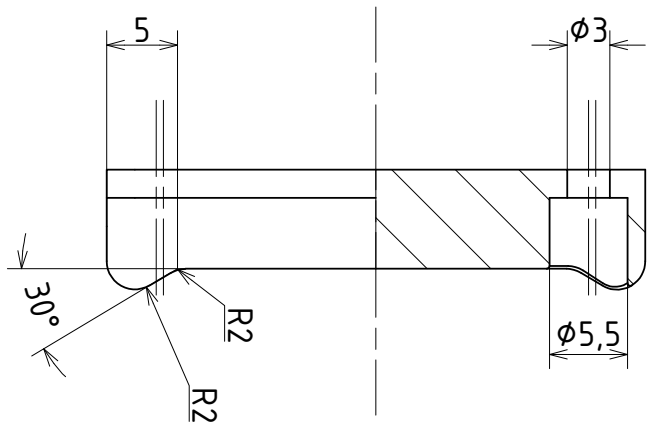
[picture p171: figure]
