TNH510/5_DOF_Robot_Arm/3d/robot_gripper/thuc-hien/Gripper_Loc/Gripper_Mica/Assem1_mica.PNG

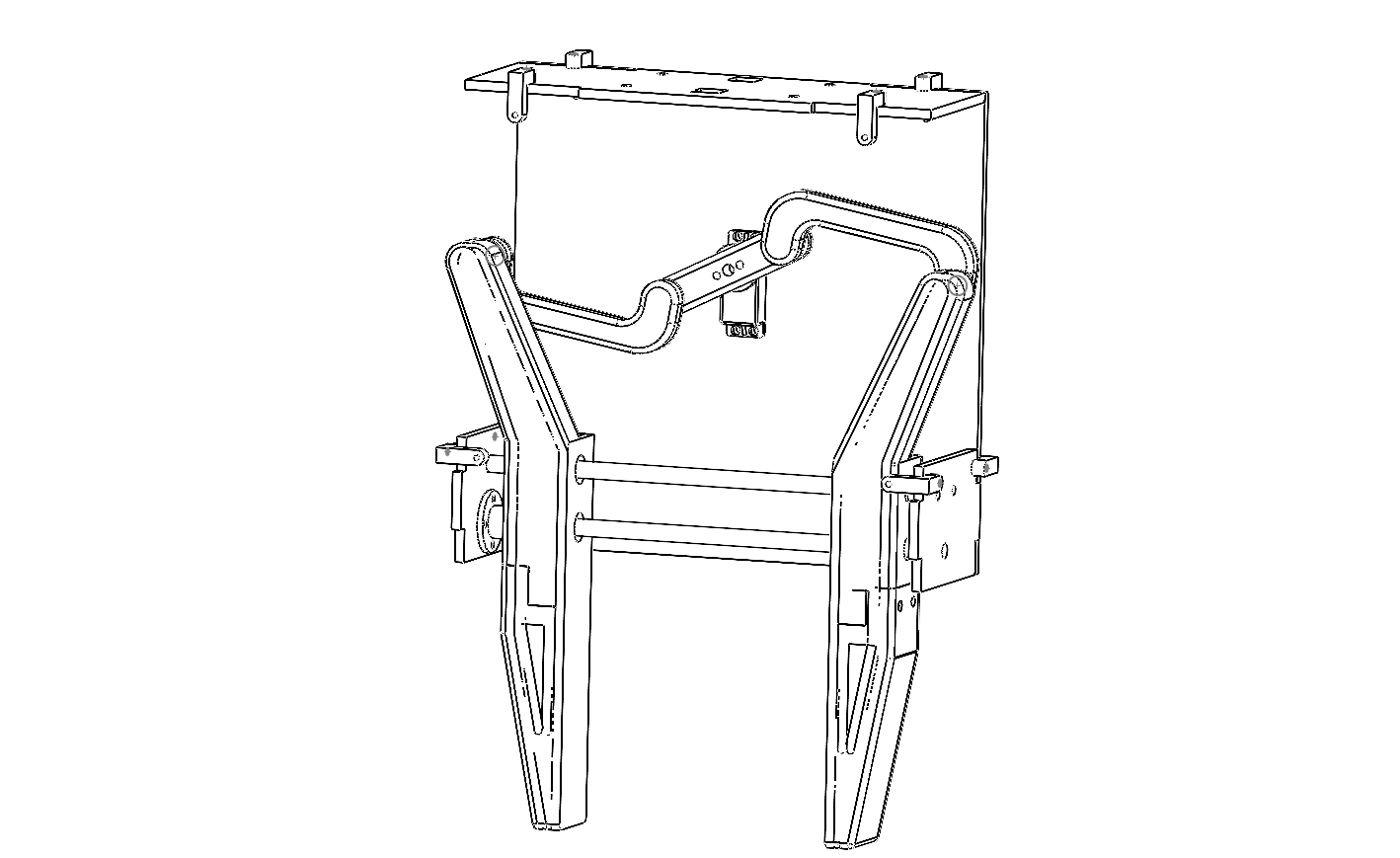
3d/robot_gripper/thuc-hien/Gripper_Loc/Gripper_Mica/Assem1_mica.PNG
