TNH510/5_DOF_Robot_Arm/control_glove/datasheet/stm32f401ccu.jpg

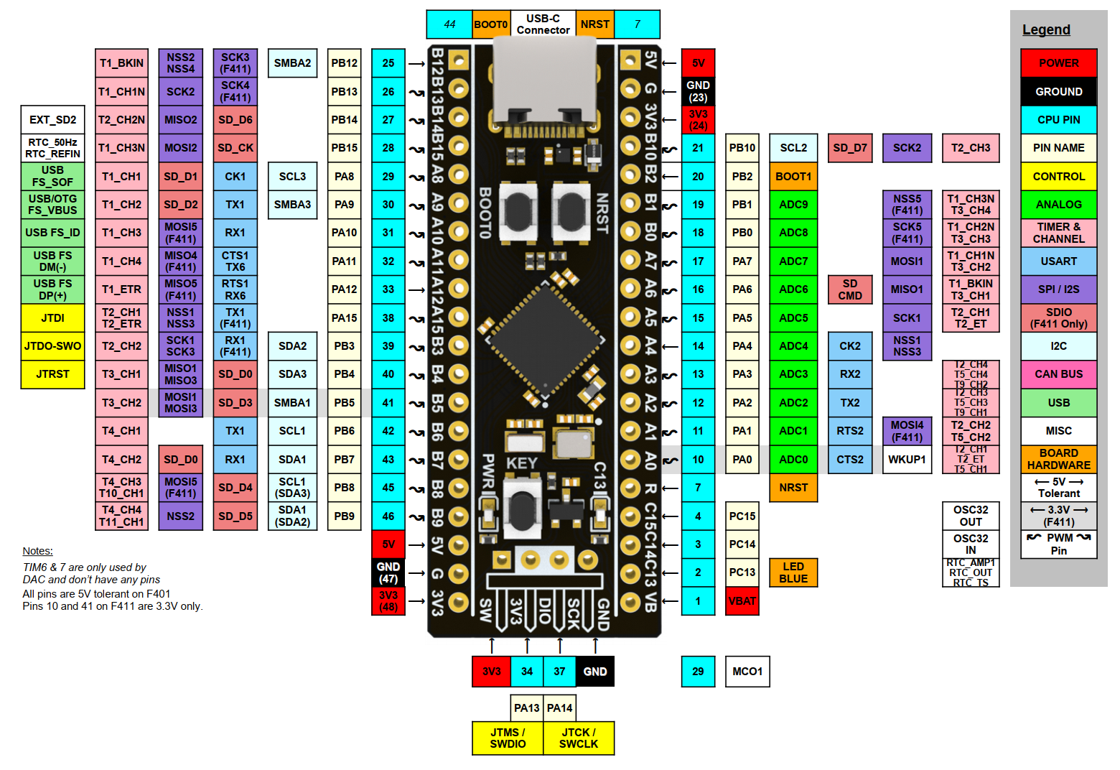
control_glove/datasheet/stm32f401ccu.jpg
