TNH510/5_DOF_Robot_Arm/control_glove/docs/2024-04-18 22 08 48.png

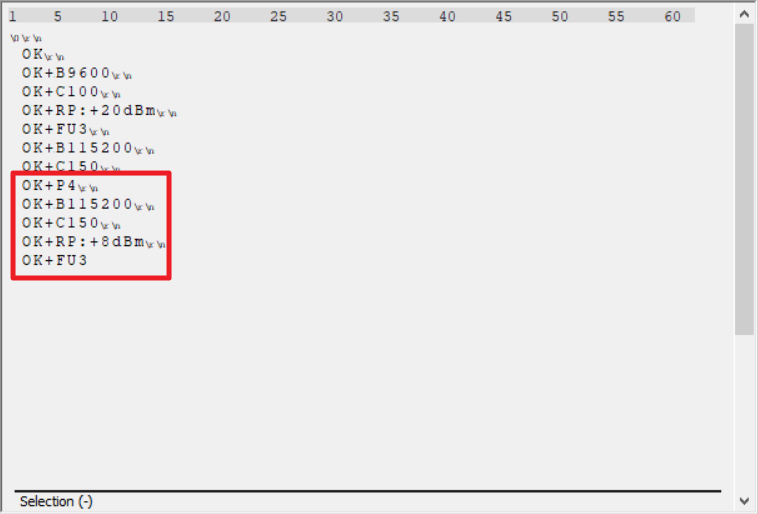
control_glove/docs/2024-04-18 22 08 48.png
