TNH510/5_DOF_Robot_Arm/control_glove/docs/bill/8.jpg

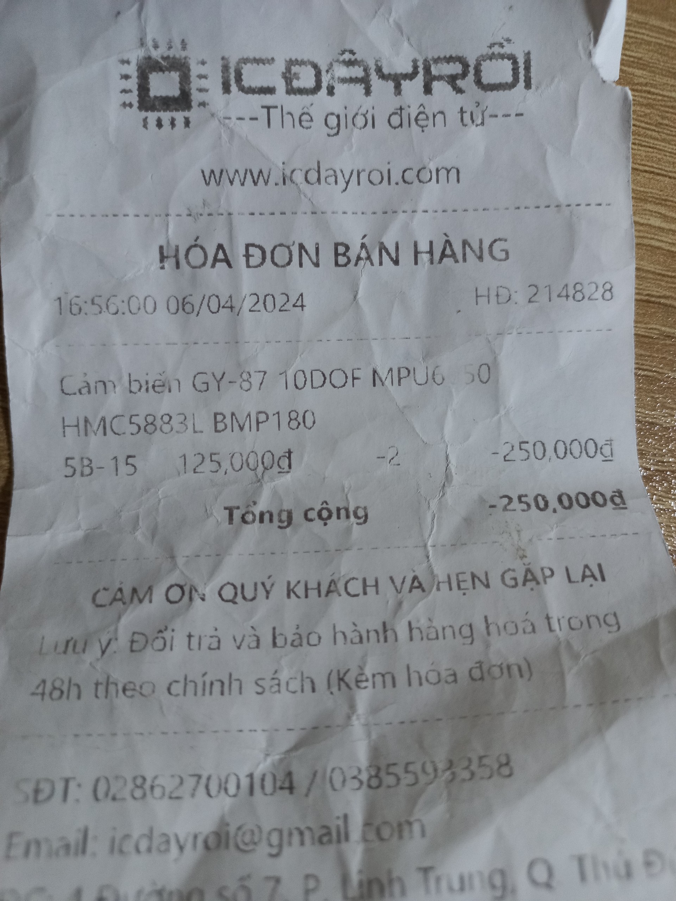
control_glove/docs/bill/8.jpg
