TNH510/5_DOF_Robot_Arm/control_glove/docs/bill/tổng hợp.jpg

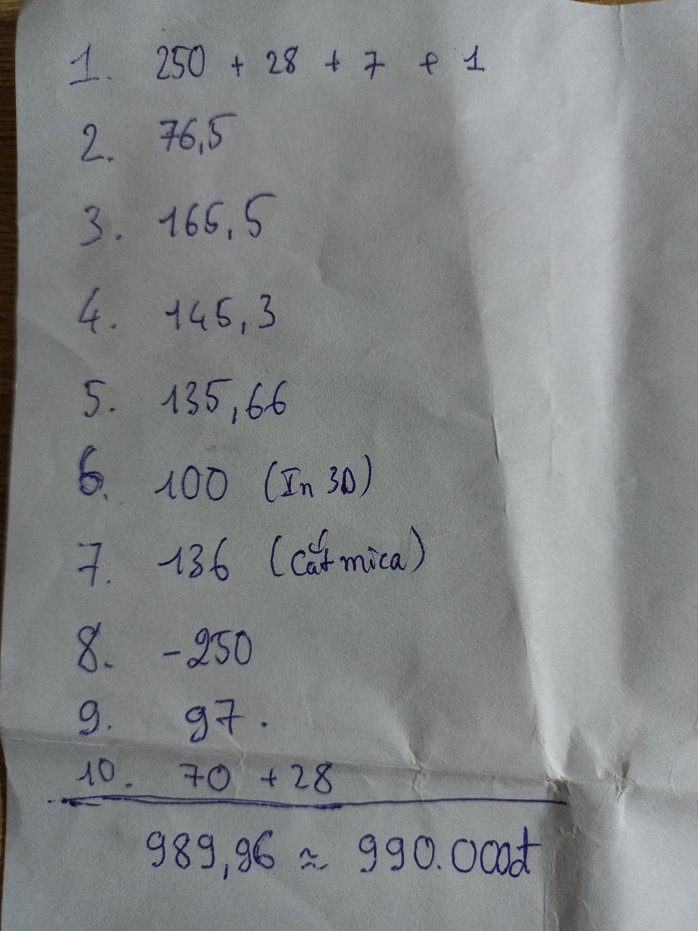
control_glove/docs/bill/tổng hợp.jpg
