TNH510/5_DOF_Robot_Arm/control_glove/docs/gang_tay.png

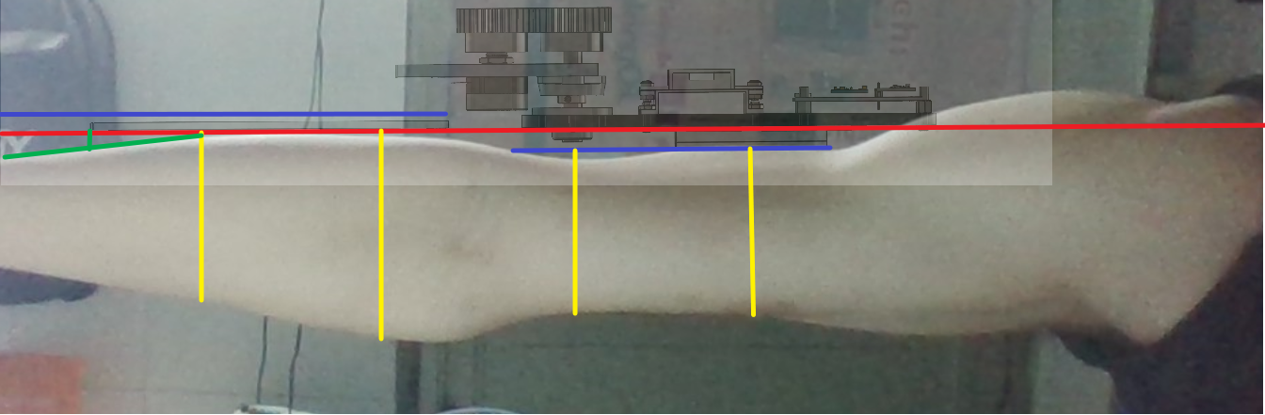
control_glove/docs/gang_tay.png
