TNH510/5_DOF_Robot_Arm/control_glove/docs/khong_gian_XZ.png

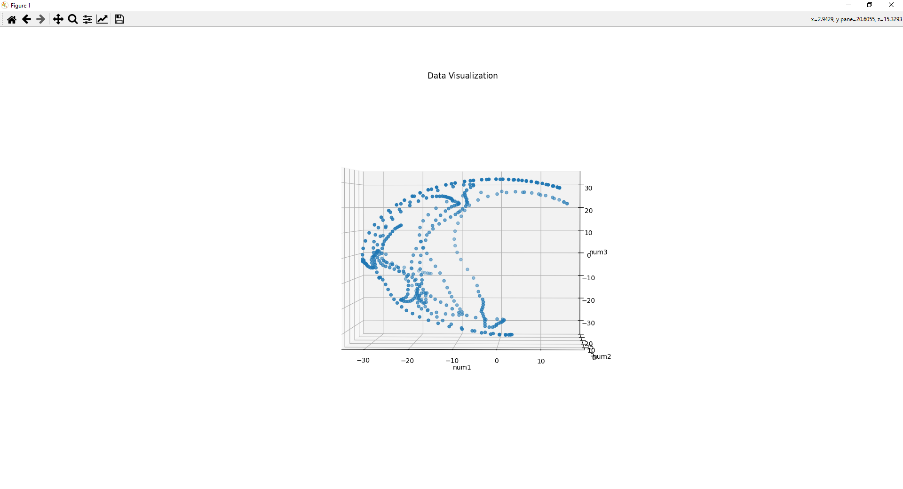
control_glove/docs/khong_gian_XZ.png
