TNH510/5_DOF_Robot_Arm/control_glove/docs/robot_safety_pos_x_y.png

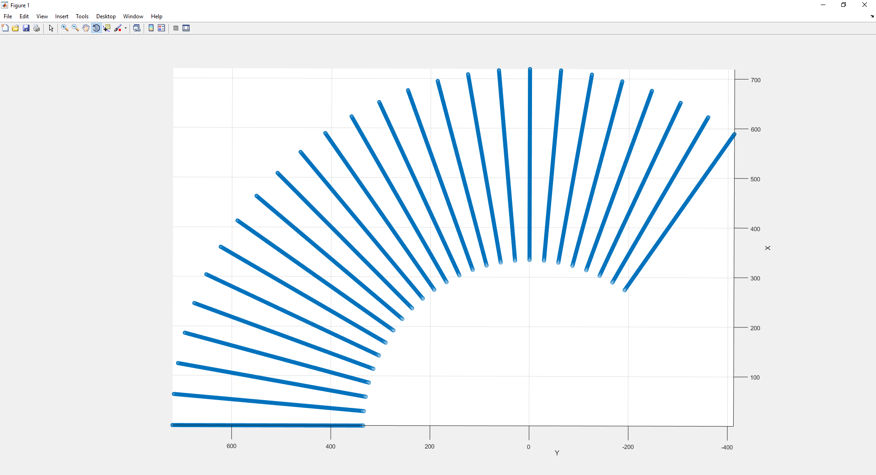
control_glove/docs/robot_safety_pos_x_y.png
