TNH510/5_DOF_Robot_Arm/control_glove/docs/tang_do_ben.png

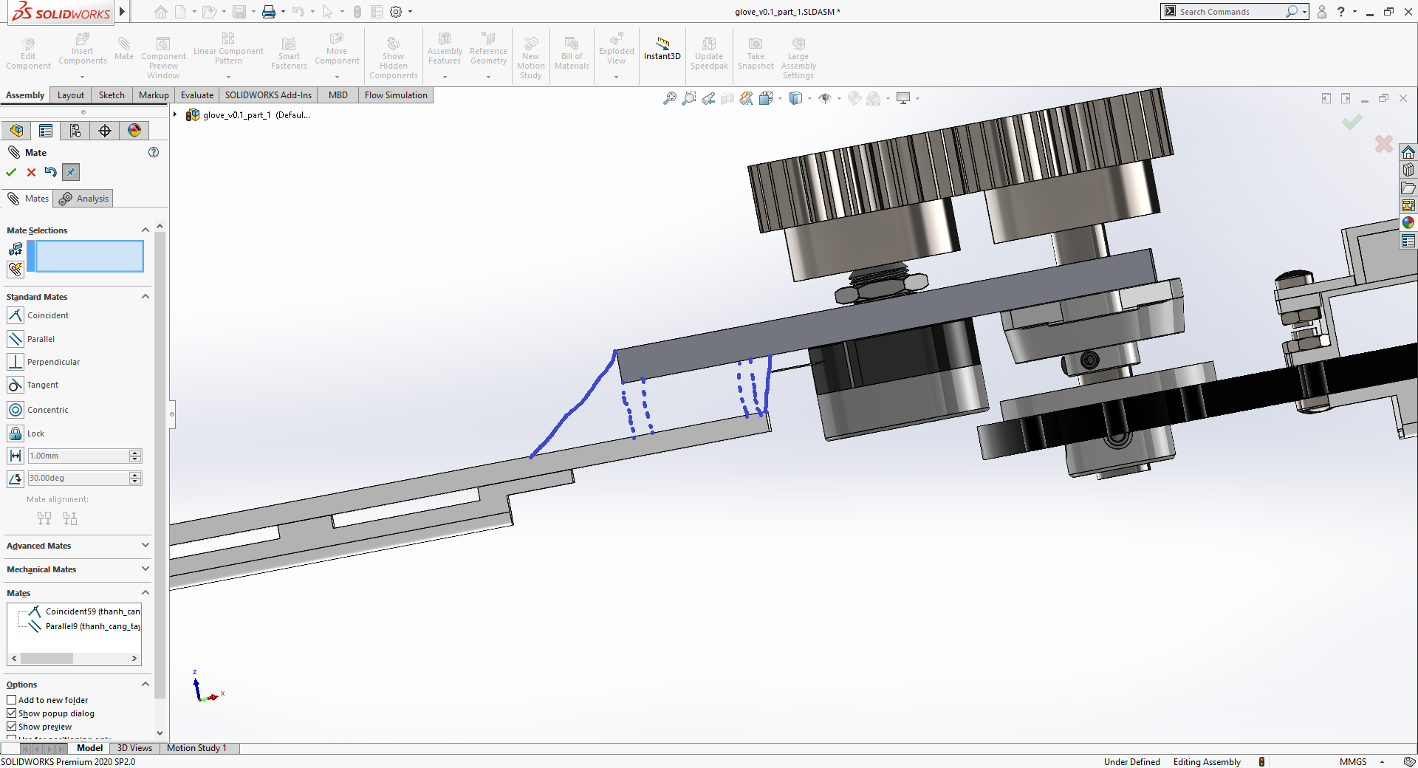
control_glove/docs/tang_do_ben.png
