TNH510/5_DOF_Robot_Arm/control_glove/docs/toi_uu_di_day.png

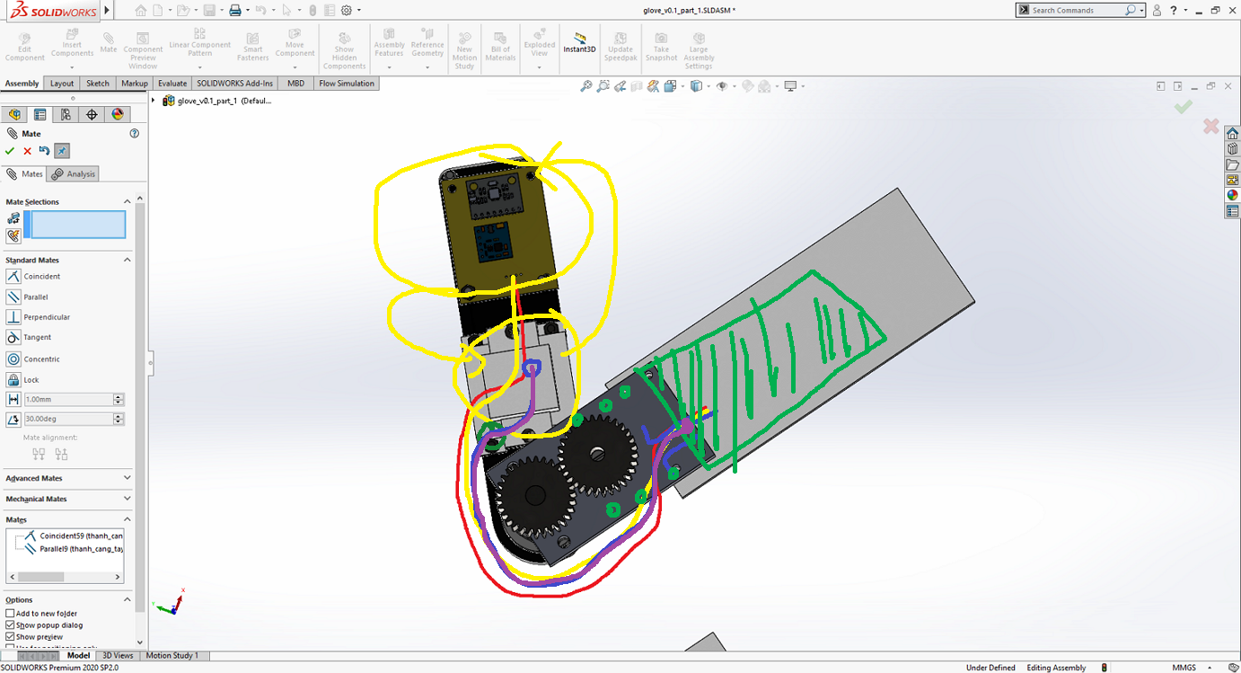
control_glove/docs/toi_uu_di_day.png
