TNH510/5_DOF_Robot_Arm/control_glove/docs/toi_uu_luc_va_di_day.png

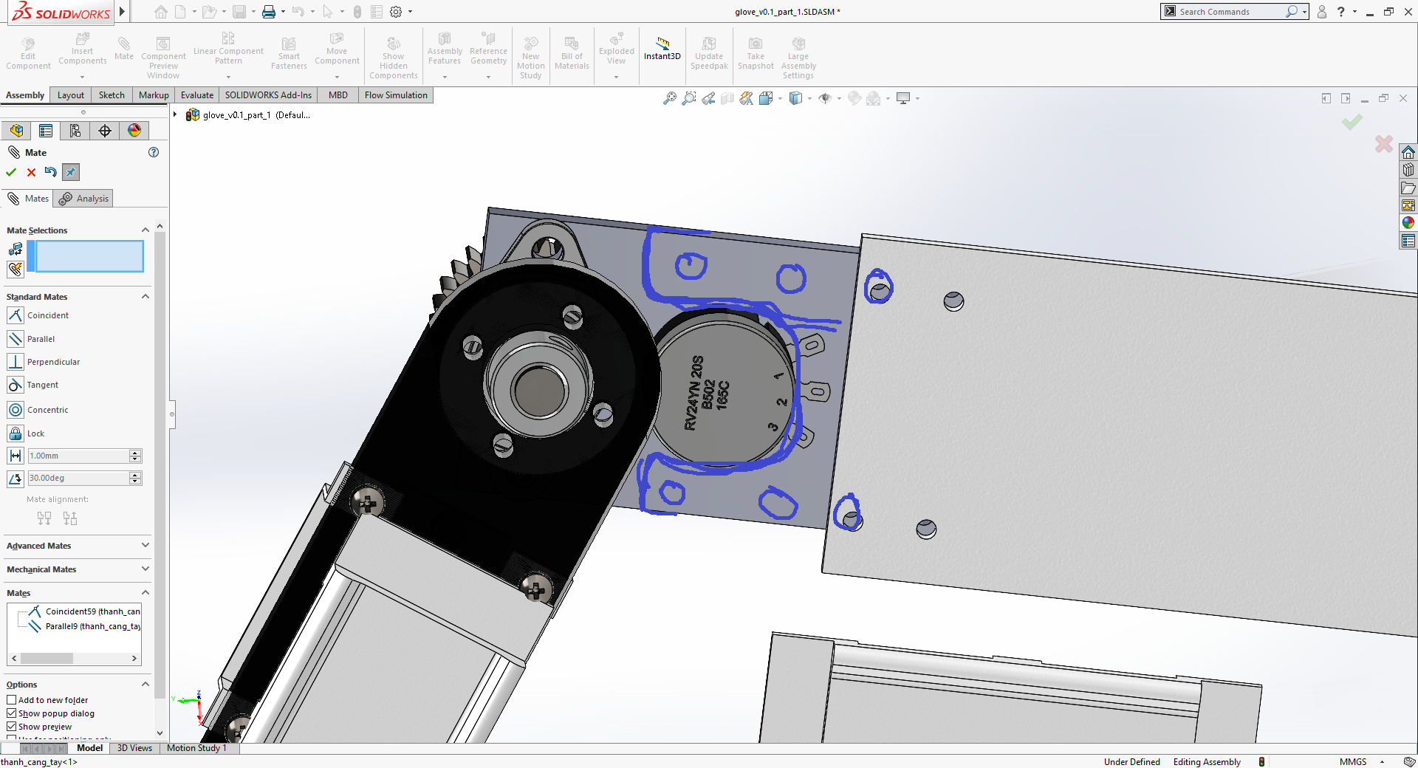
control_glove/docs/toi_uu_luc_va_di_day.png
