TNH510/5_DOF_Robot_Arm/control_glove/list/mach._on_appng.png

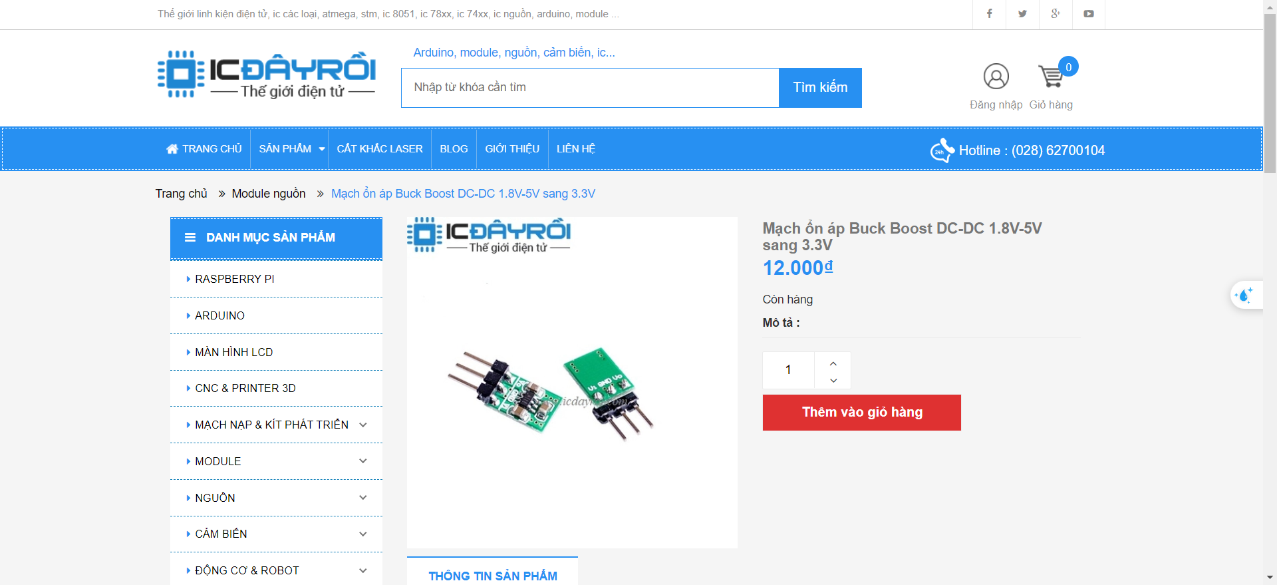
control_glove/list/mach._on_appng.png
