TNH510/5_DOF_Robot_Arm/control_glove/list/uart.png

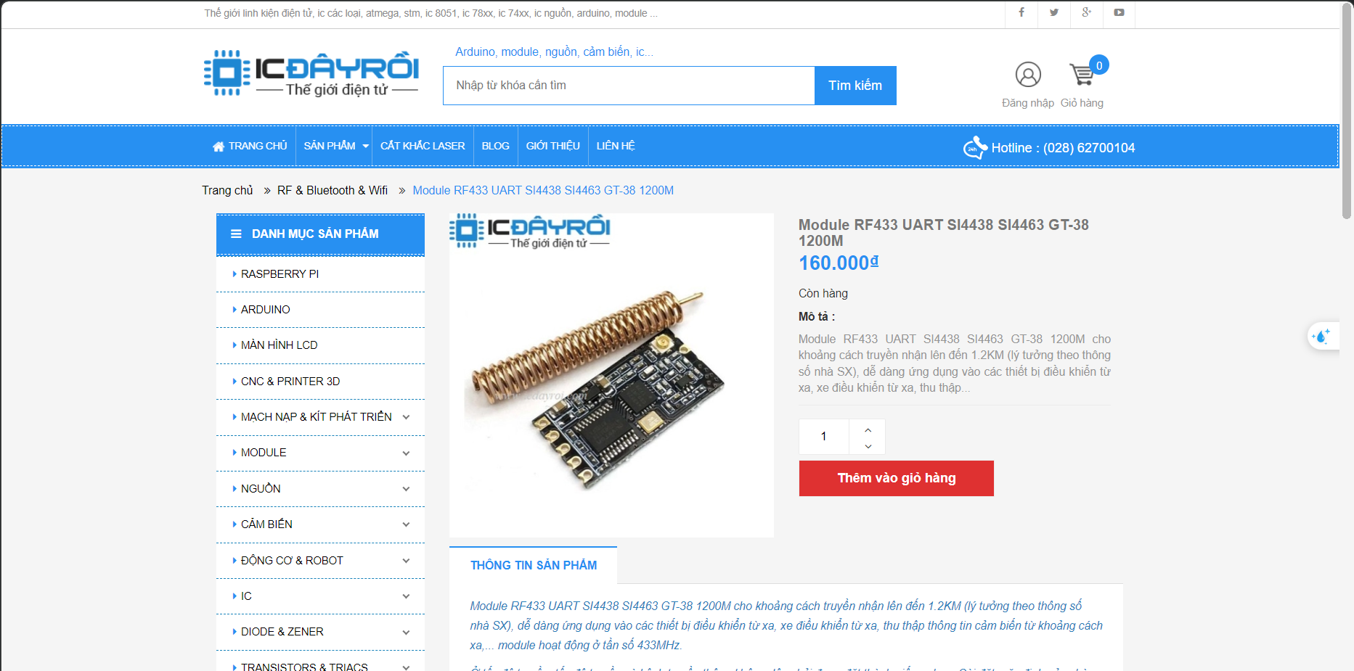
control_glove/list/uart.png
