TNH510/5_DOF_Robot_Arm/control_glove/pics/truc.png

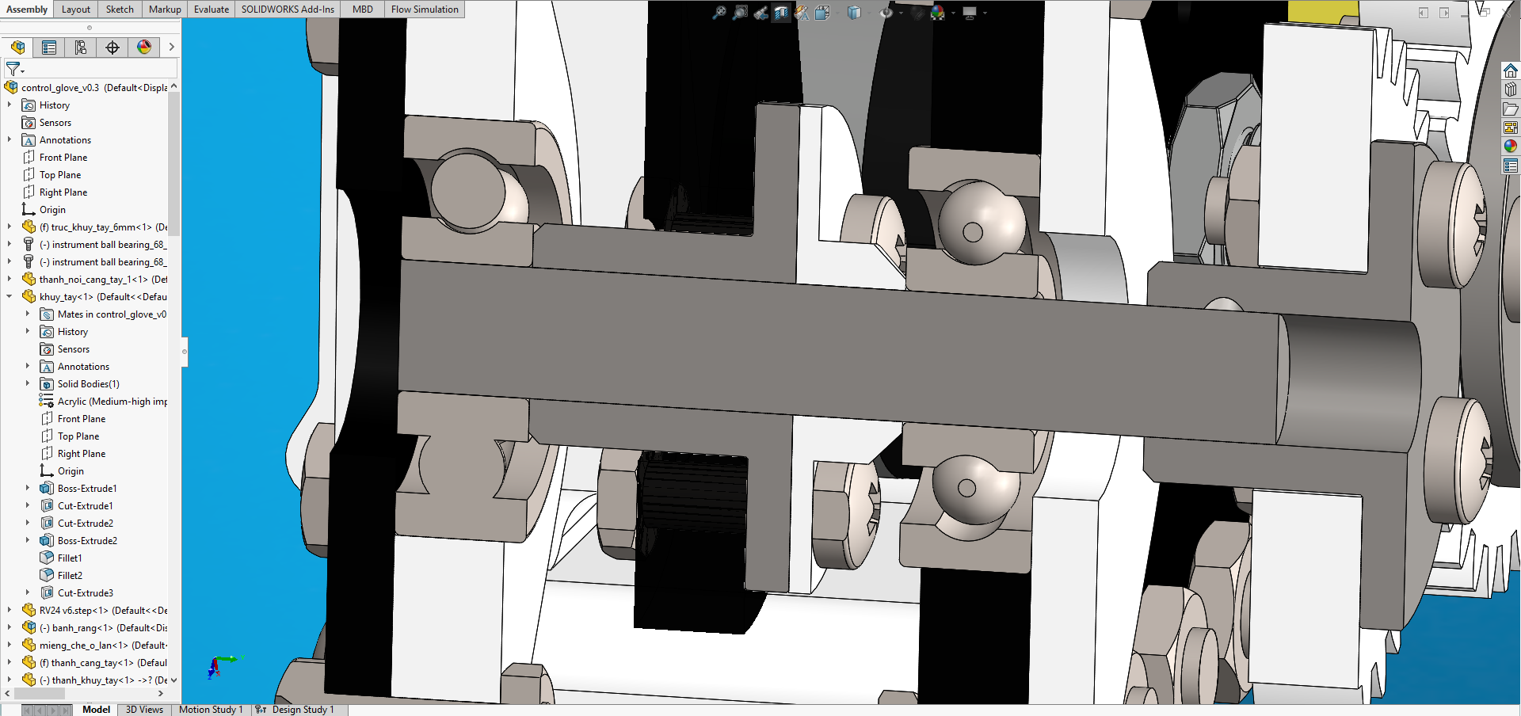
control_glove/pics/truc.png
