TNH510/5_DOF_Robot_Arm/control_glove/pics/view_1.png

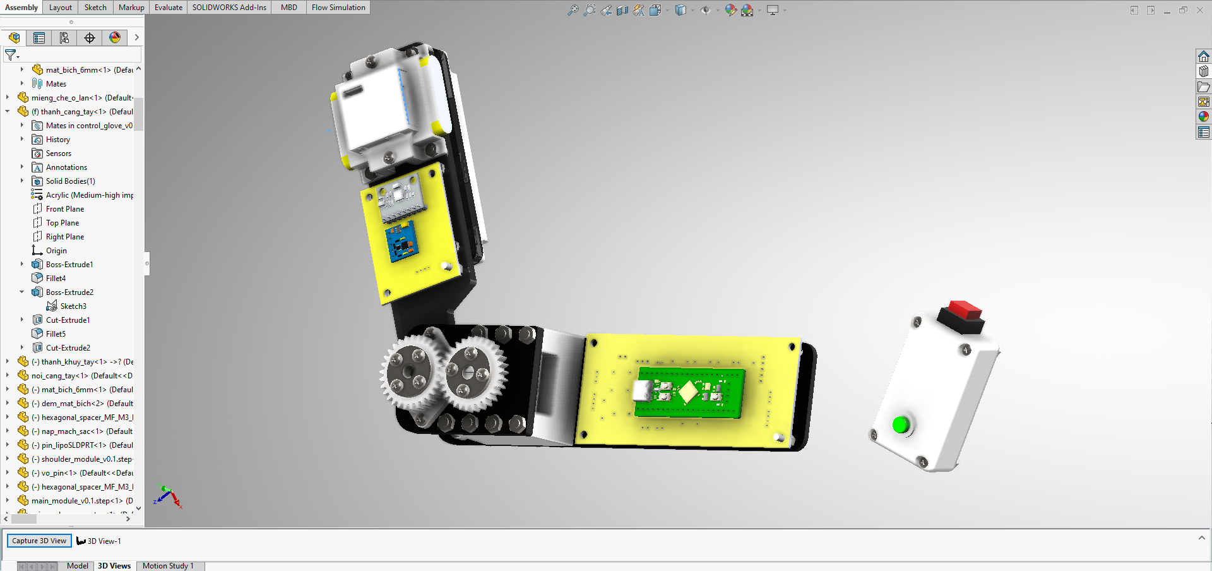
control_glove/pics/view_1.png
