TNH510/5_DOF_Robot_Arm/control_glove/reference/mag-cal-example-main/2024-04-18 14 19 38.png

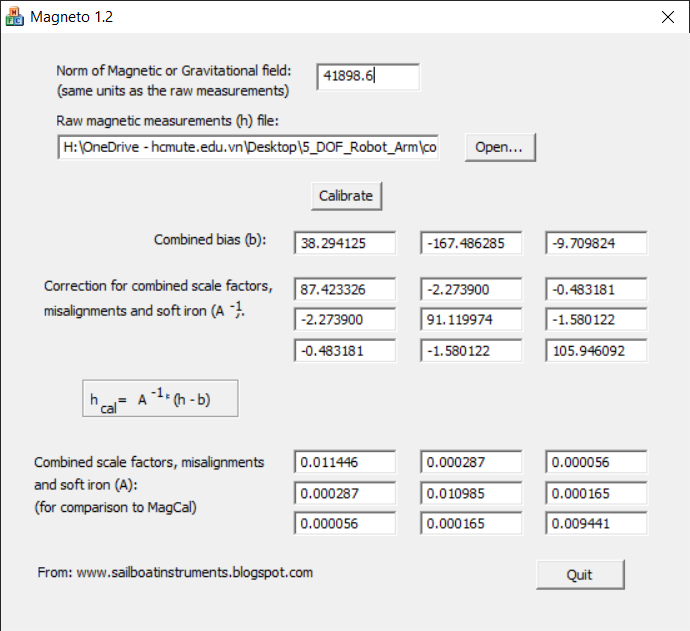
control_glove/reference/mag-cal-example-main/2024-04-18 14 19 38.png
