TNH510/5_DOF_Robot_Arm/docs/final_project/hieu/flowchart/smart_desk_clock_architecture.png

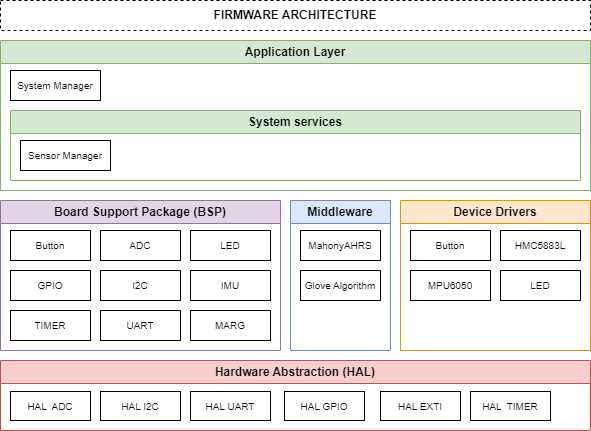
docs/final_project/hieu/flowchart/smart_desk_clock_architecture.png
