TNH510/5_DOF_Robot_Arm/docs/final_project/hieu/pics/control_use_panel.png

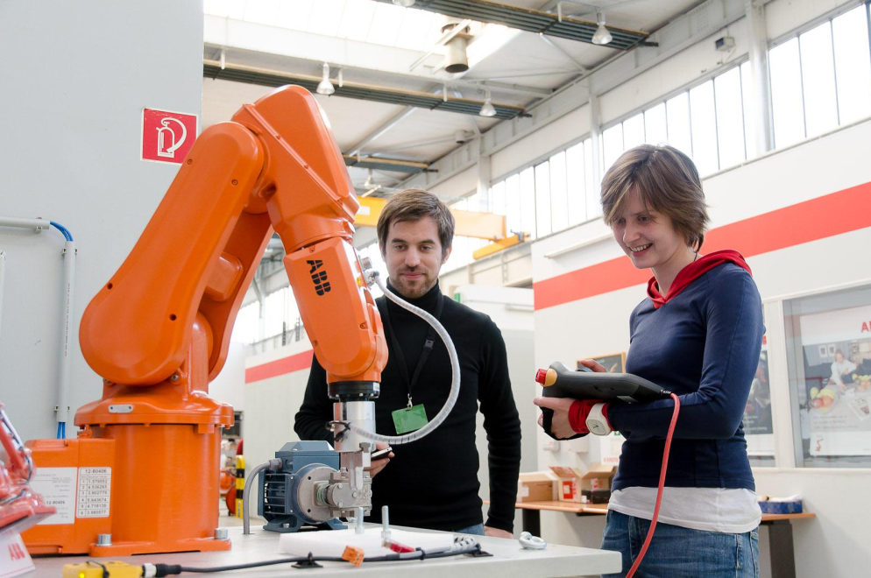
docs/final_project/hieu/pics/control_use_panel.png
