TNH510/5_DOF_Robot_Arm/docs/final_project/hieu/pics/e-controller.png

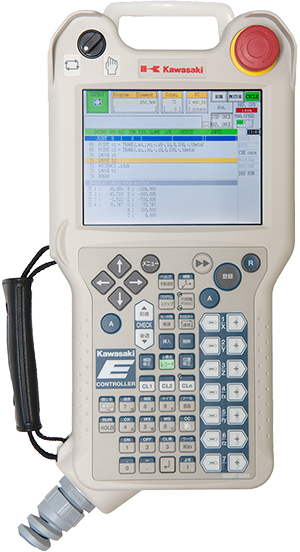
docs/final_project/hieu/pics/e-controller.png
