TNH510/5_DOF_Robot_Arm/docs/final_project/hieu/pics/smartPAD_KUKA.jpg

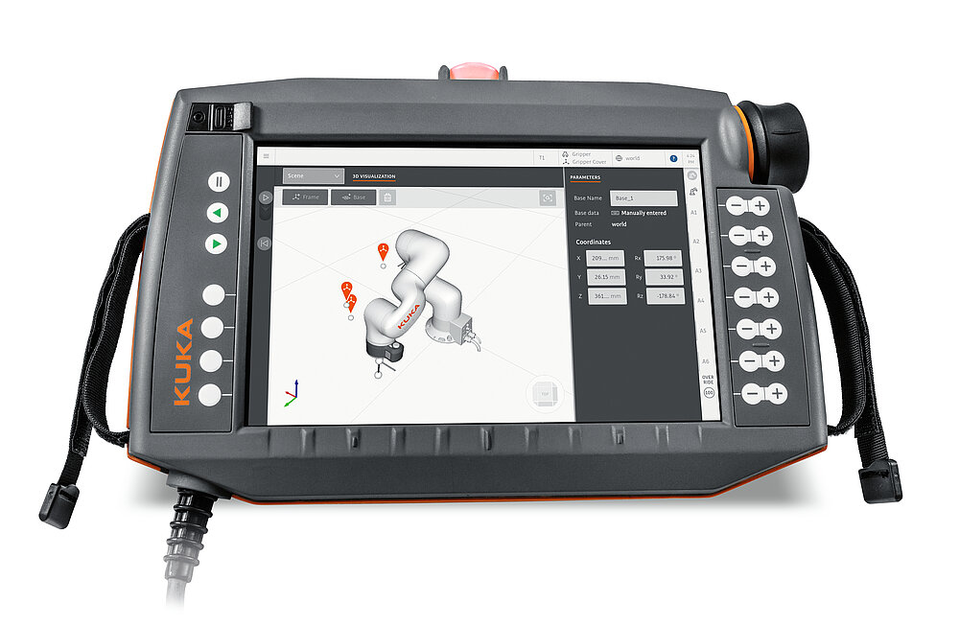
docs/final_project/hieu/pics/smartPAD_KUKA.jpg
