TNH510/5_DOF_Robot_Arm/docs/final_project/hieu/pics/thiet-ke-he-thong.png

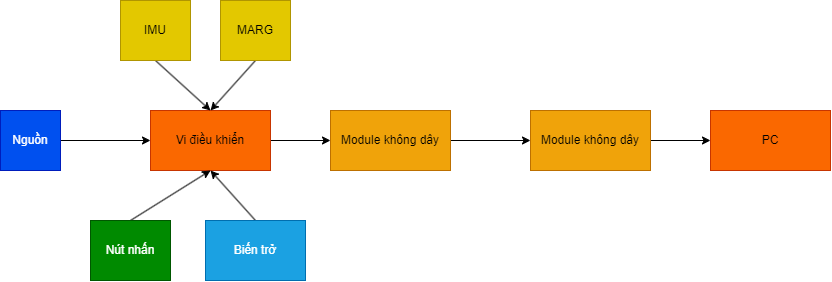
docs/final_project/hieu/pics/thiet-ke-he-thong.png
