TNH510/5_DOF_Robot_Arm/docs/final_project/thach/moment_robot/image-1.png

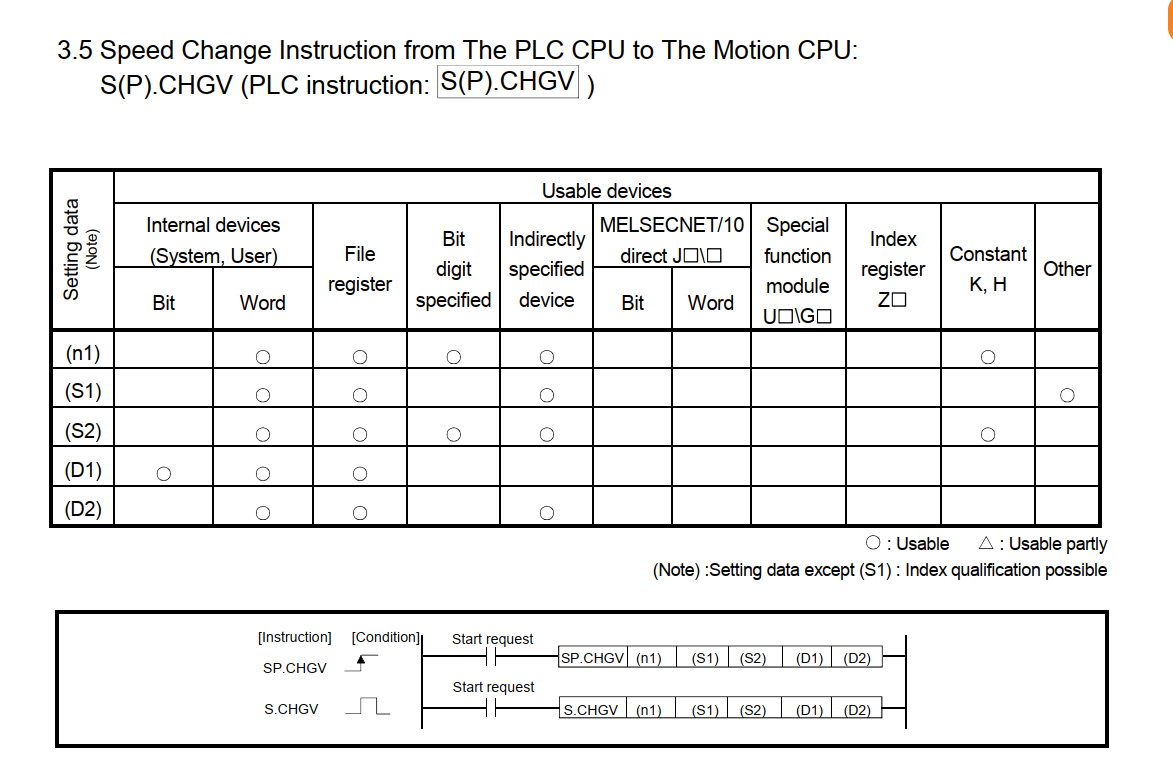
docs/final_project/thach/moment_robot/image-1.png
