TNH510/5_DOF_Robot_Arm/docs/mechatronic_project/note/chay_jog.png

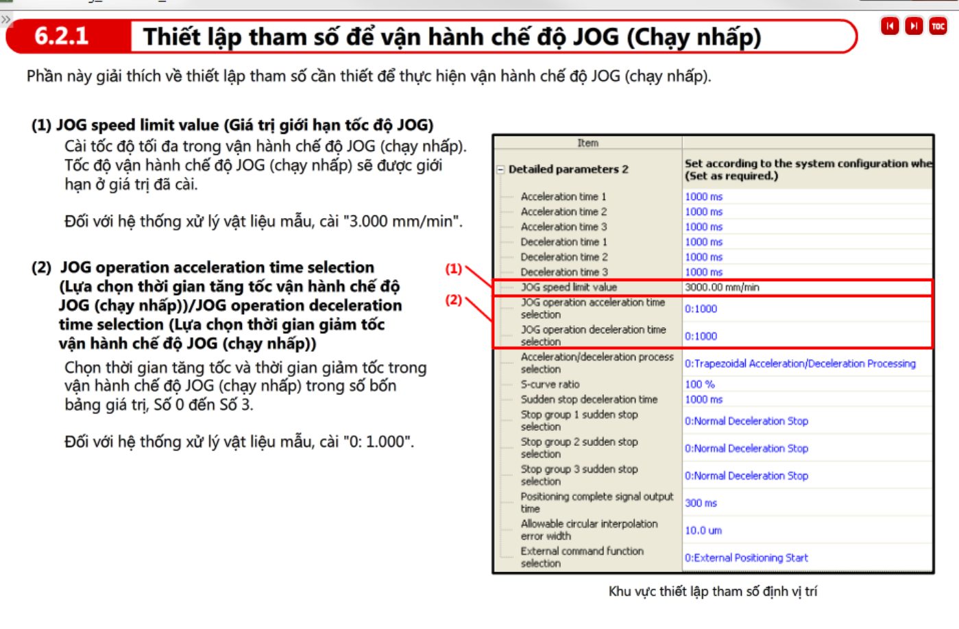
docs/mechatronic_project/note/chay_jog.png
