TNH510/5_DOF_Robot_Arm/docs/mechatronic_project/note/chuong_trinh_sfc.png

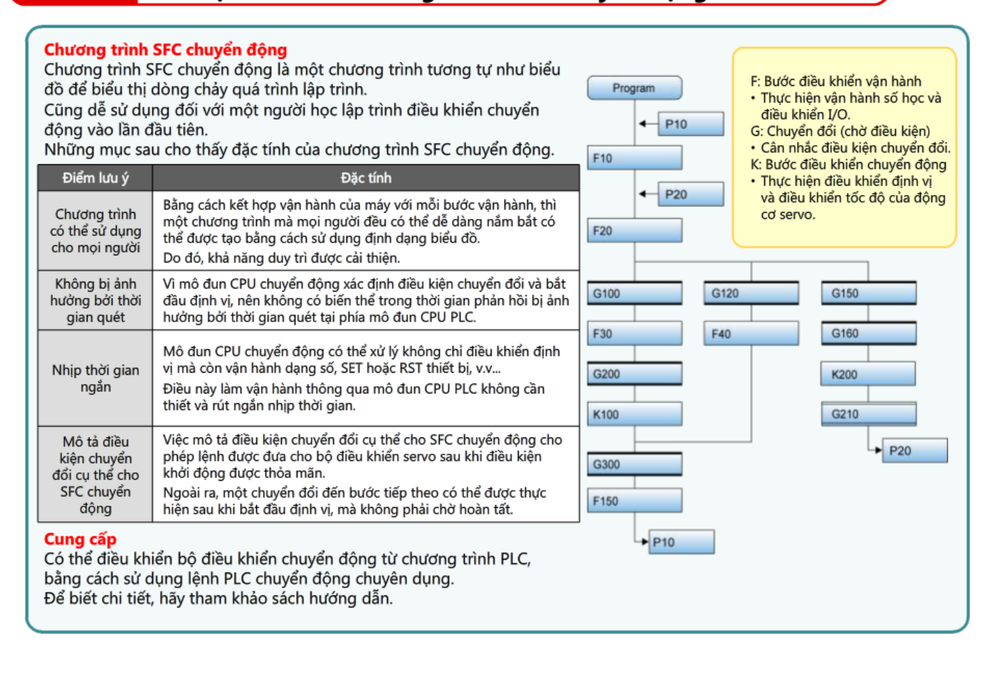
docs/mechatronic_project/note/chuong_trinh_sfc.png
