TNH510/5_DOF_Robot_Arm/docs/mechatronic_project/note/ki_hieu_bien_plc.png

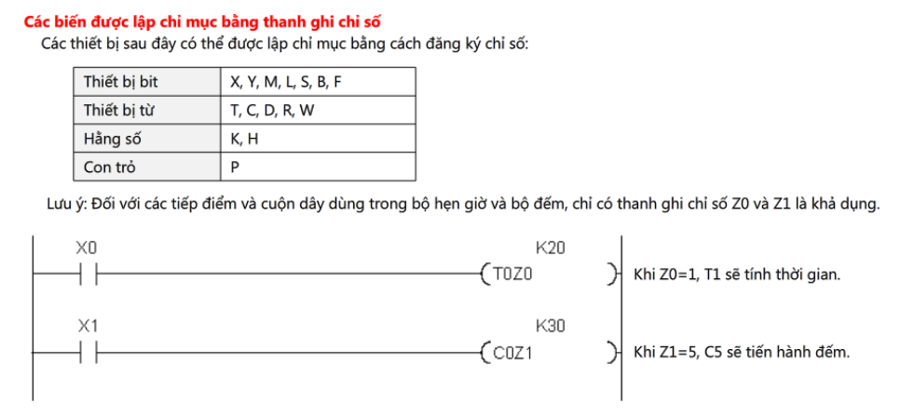
docs/mechatronic_project/note/ki_hieu_bien_plc.png
