TNH510/5_DOF_Robot_Arm/docs/mechatronic_project/note/kiemtra_so_thu_tu_module.png

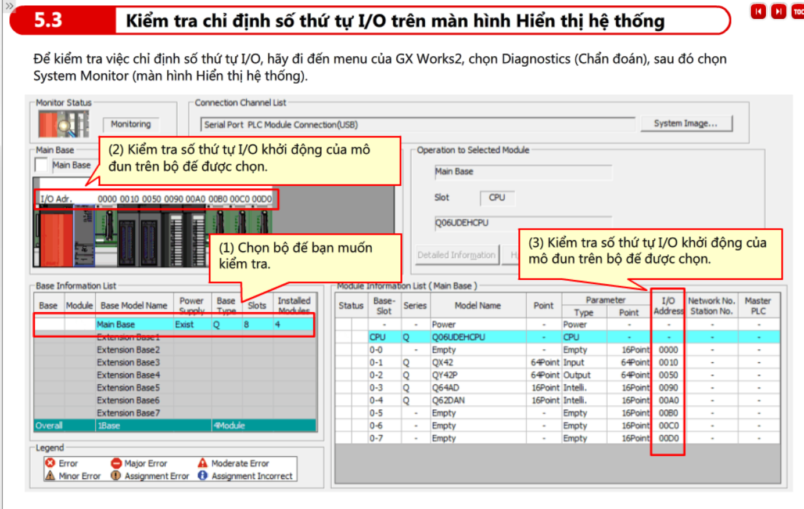
docs/mechatronic_project/note/kiemtra_so_thu_tu_module.png
