TNH510/5_DOF_Robot_Arm/docs/mechatronic_project/note/moi_quan_he_giua_cac_chuong_trinh.png

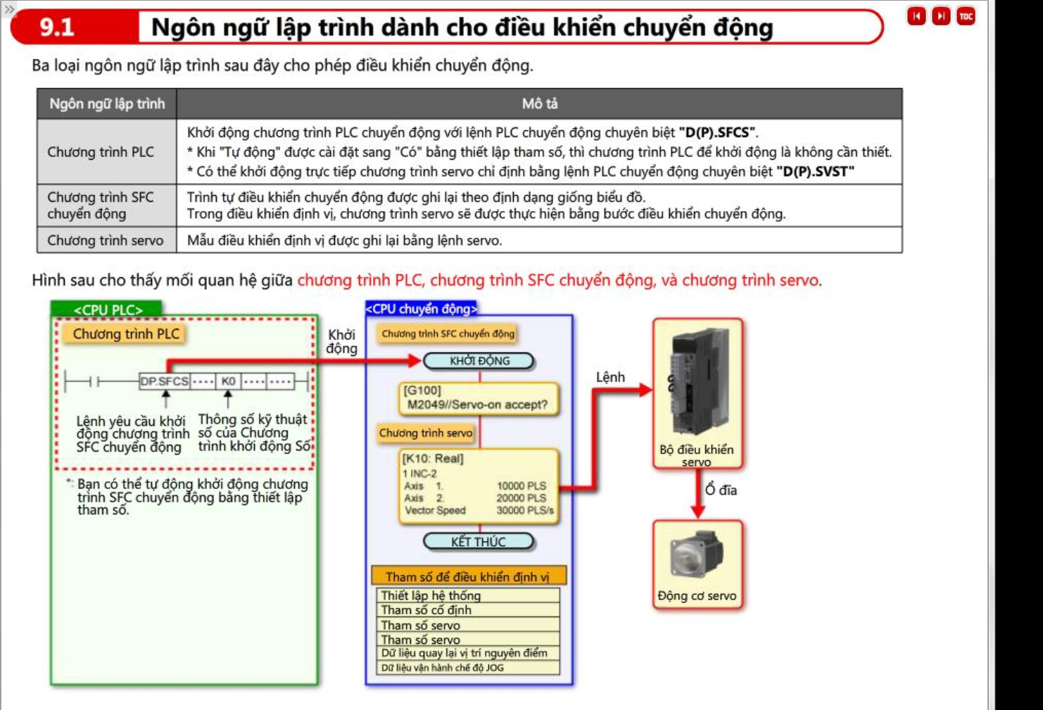
docs/mechatronic_project/note/moi_quan_he_giua_cac_chuong_trinh.png
