TNH510/5_DOF_Robot_Arm/docs/mechatronic_project/note/pin.png

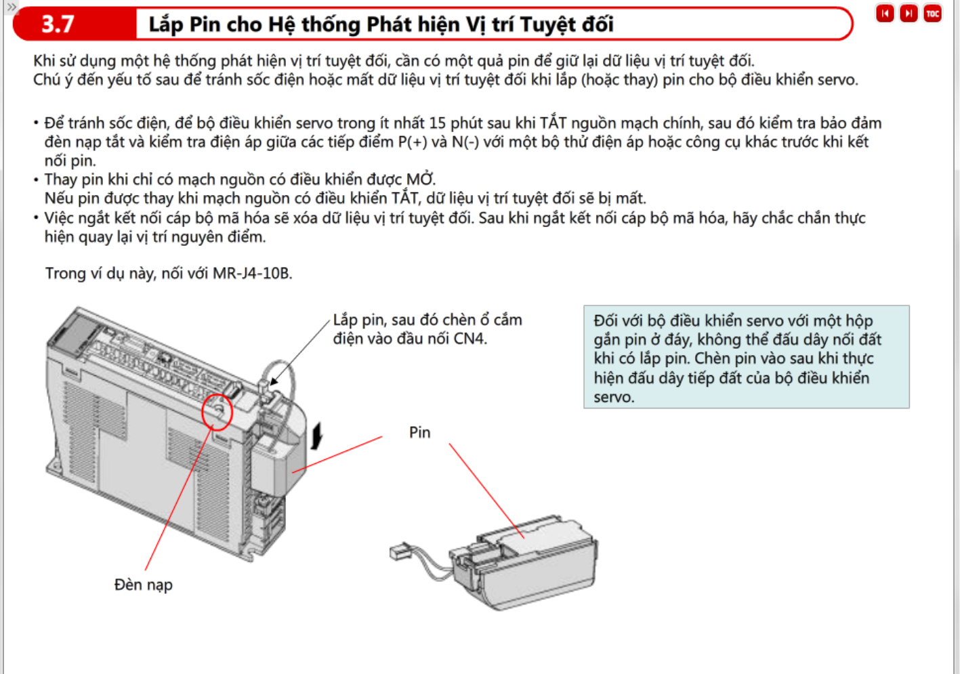
docs/mechatronic_project/note/pin.png
