TNH510/5_DOF_Robot_Arm/docs/mechatronic_project/note/so_thuc_trong_plc.png

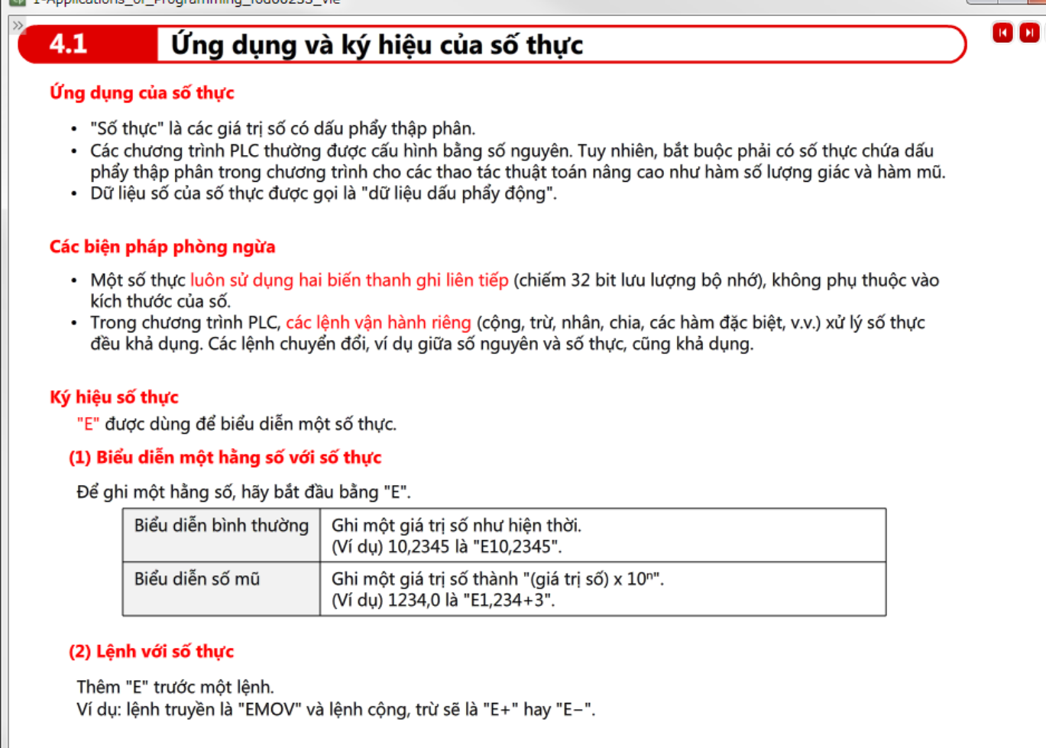
docs/mechatronic_project/note/so_thuc_trong_plc.png
