TNH510/5_DOF_Robot_Arm/docs/mechatronic_project/note/start_sfc_from_plc.png

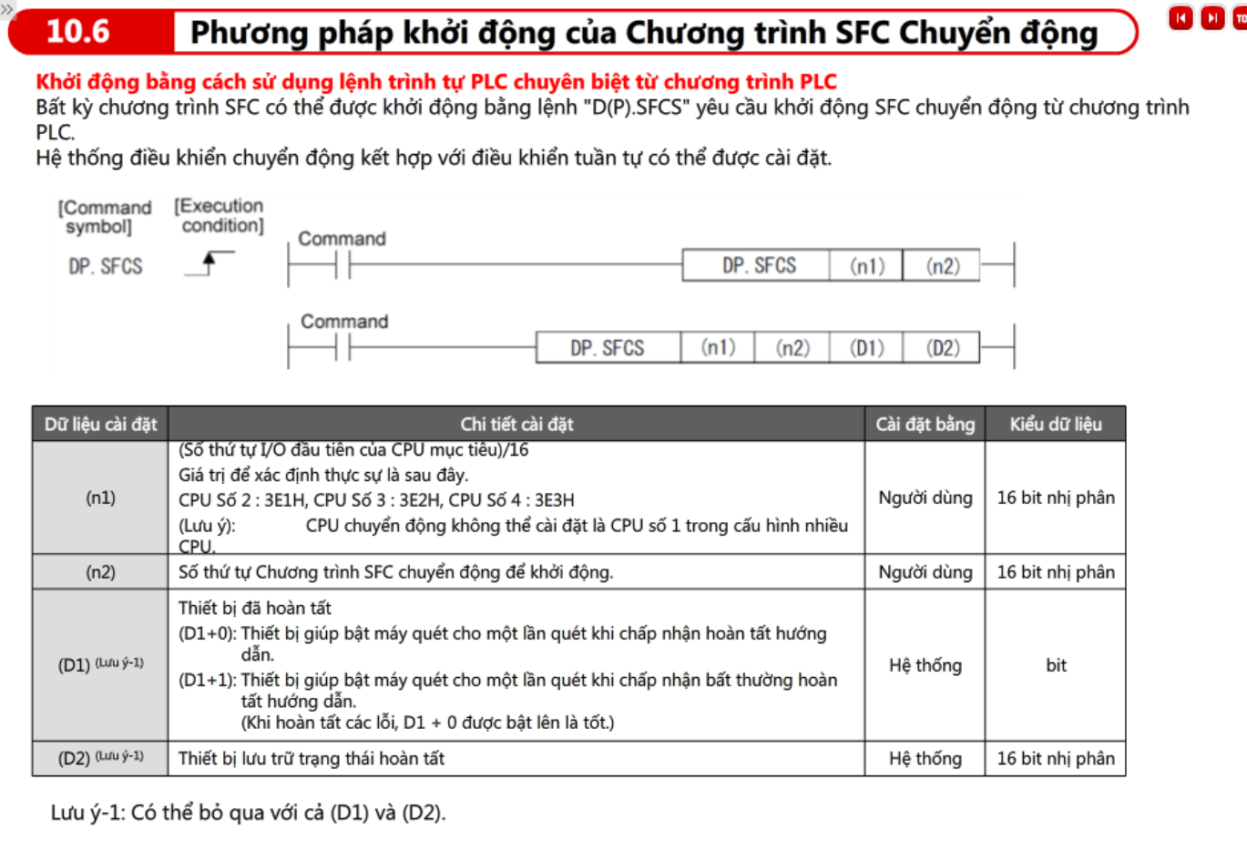
docs/mechatronic_project/note/start_sfc_from_plc.png
