TNH510/5_DOF_Robot_Arm/docs/mechatronic_project/pics/axis.png

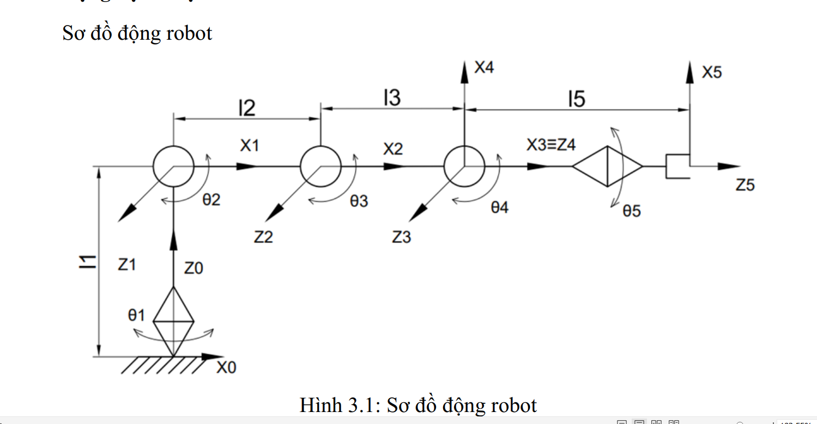
docs/mechatronic_project/pics/axis.png
