TNH510/5_DOF_Robot_Arm/docs/mechatronic_project/pics/general_hardware_connection.jpg

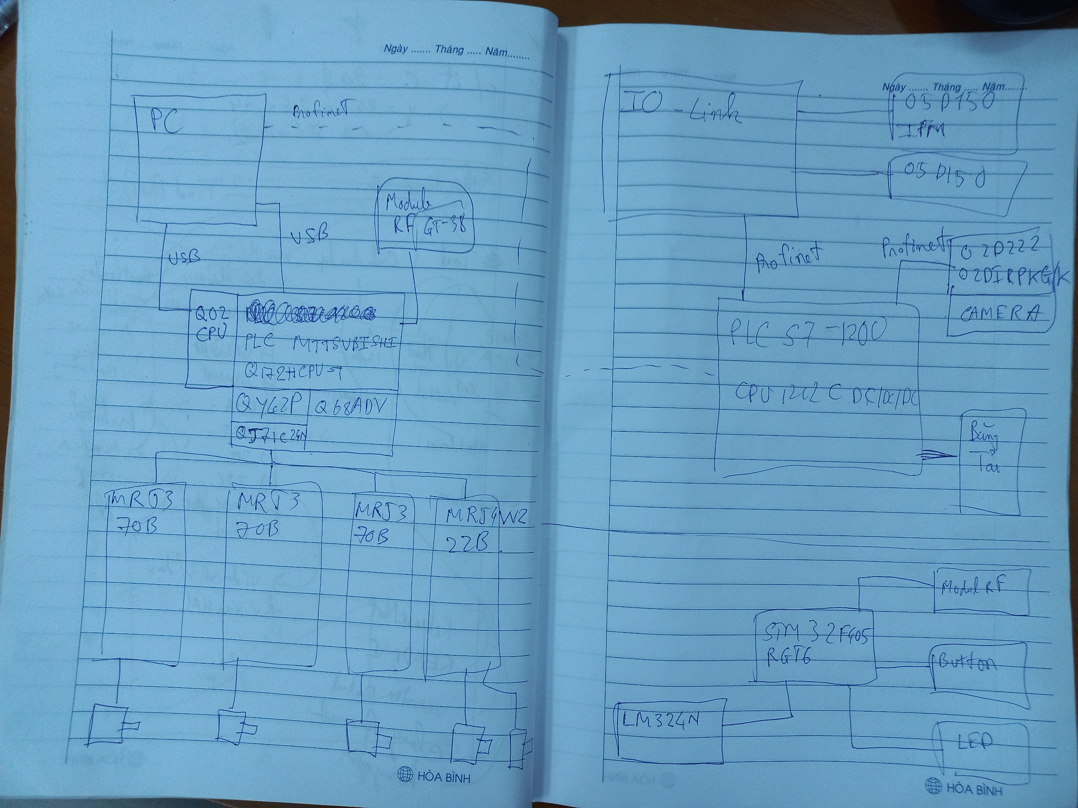
docs/mechatronic_project/pics/general_hardware_connection.jpg
