TNH510/5_DOF_Robot_Arm/docs/mechatronic_project/pics/khong_gian_xy.png

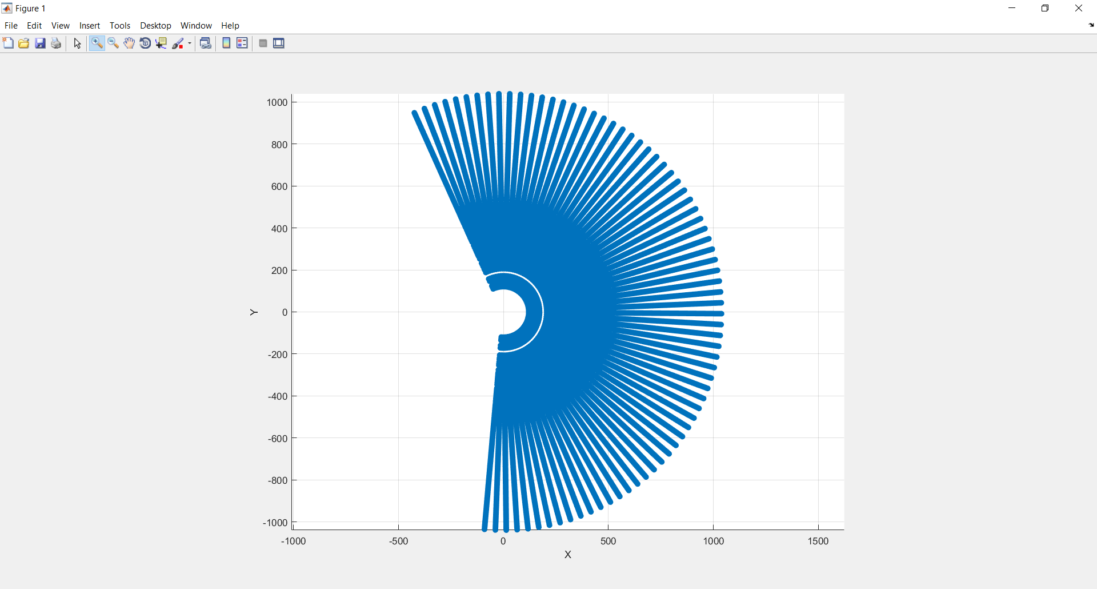
docs/mechatronic_project/pics/khong_gian_xy.png
