TNH510/5_DOF_Robot_Arm/docs/mechatronic_project/pics/m_bang_tai.jpg

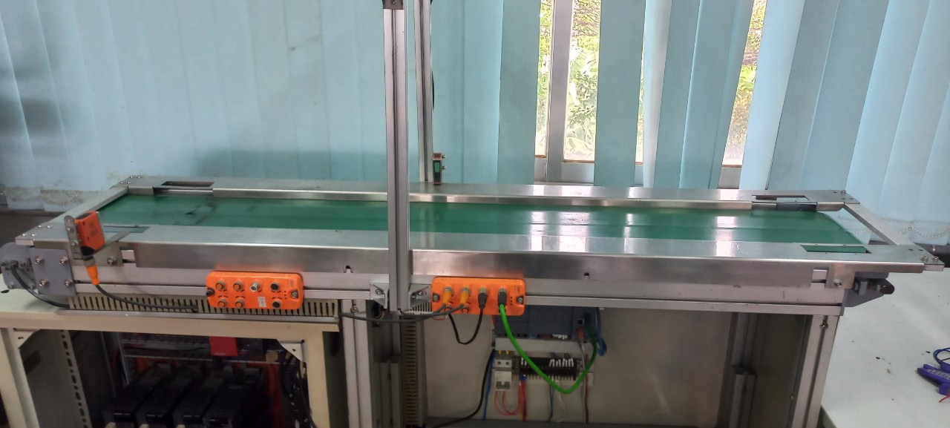
docs/mechatronic_project/pics/m_bang_tai.jpg
