TNH510/5_DOF_Robot_Arm/docs/mechatronic_project/pics/m_khau_1.jpg

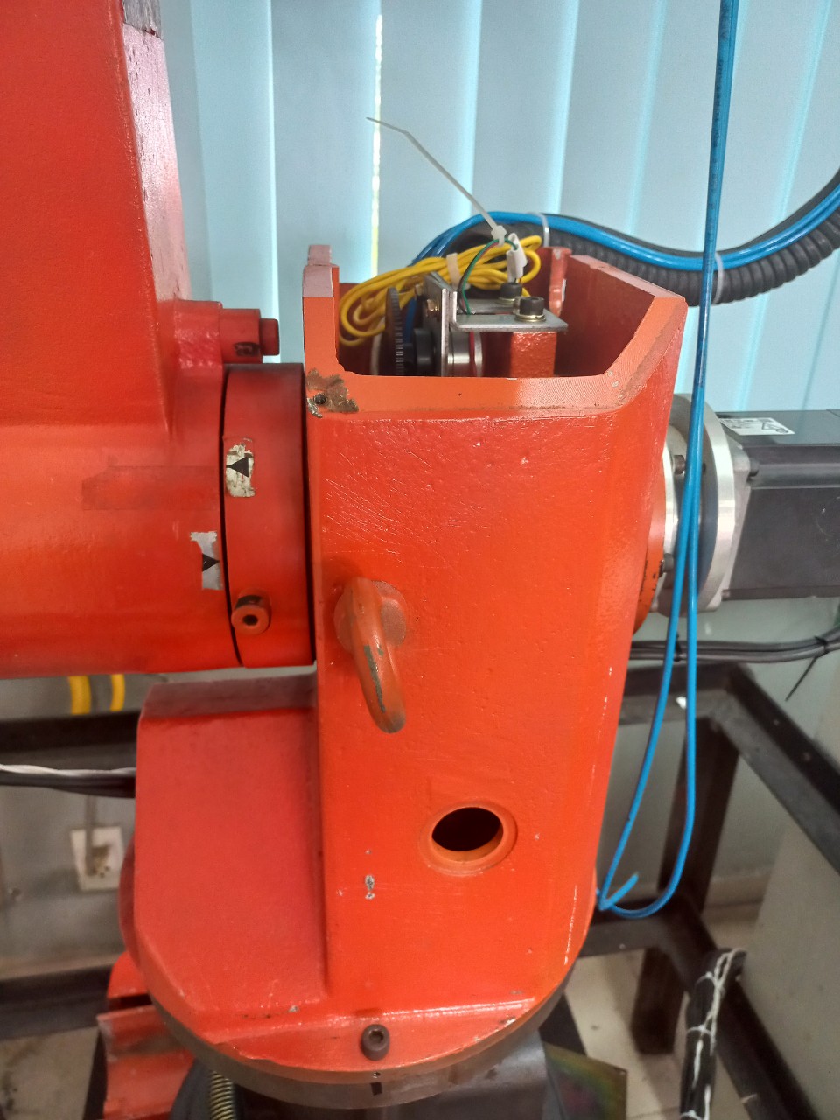
docs/mechatronic_project/pics/m_khau_1.jpg
