TNH510/5_DOF_Robot_Arm/docs/mechatronic_project/pics/m_khung_duoi.jpg

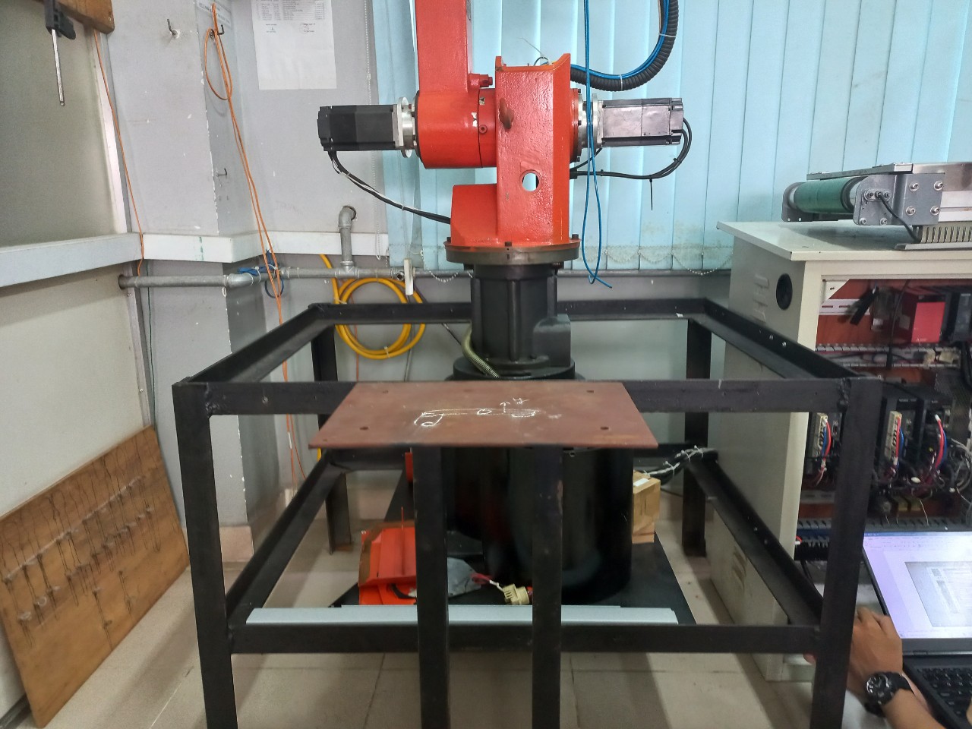
docs/mechatronic_project/pics/m_khung_duoi.jpg
