TNH510/5_DOF_Robot_Arm/docs/mechatronic_project/pics/requirement.jpg

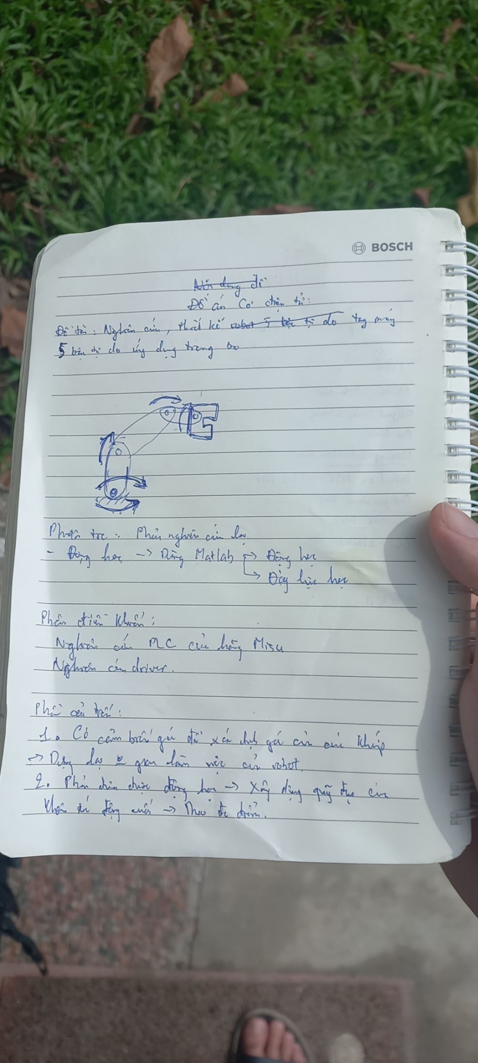
docs/mechatronic_project/pics/requirement.jpg
