TNH510/5_DOF_Robot_Arm/docs/mechatronic_project/pics/requirement_1.jpg

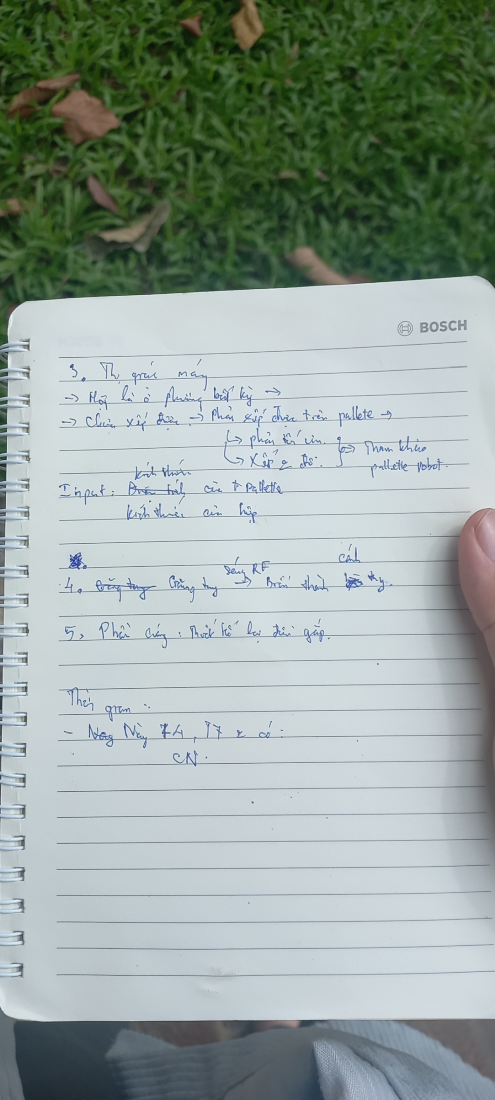
docs/mechatronic_project/pics/requirement_1.jpg
