TNH510/5_DOF_Robot_Arm/docs/mechatronic_project/pics/sfc_prog_format.jpg

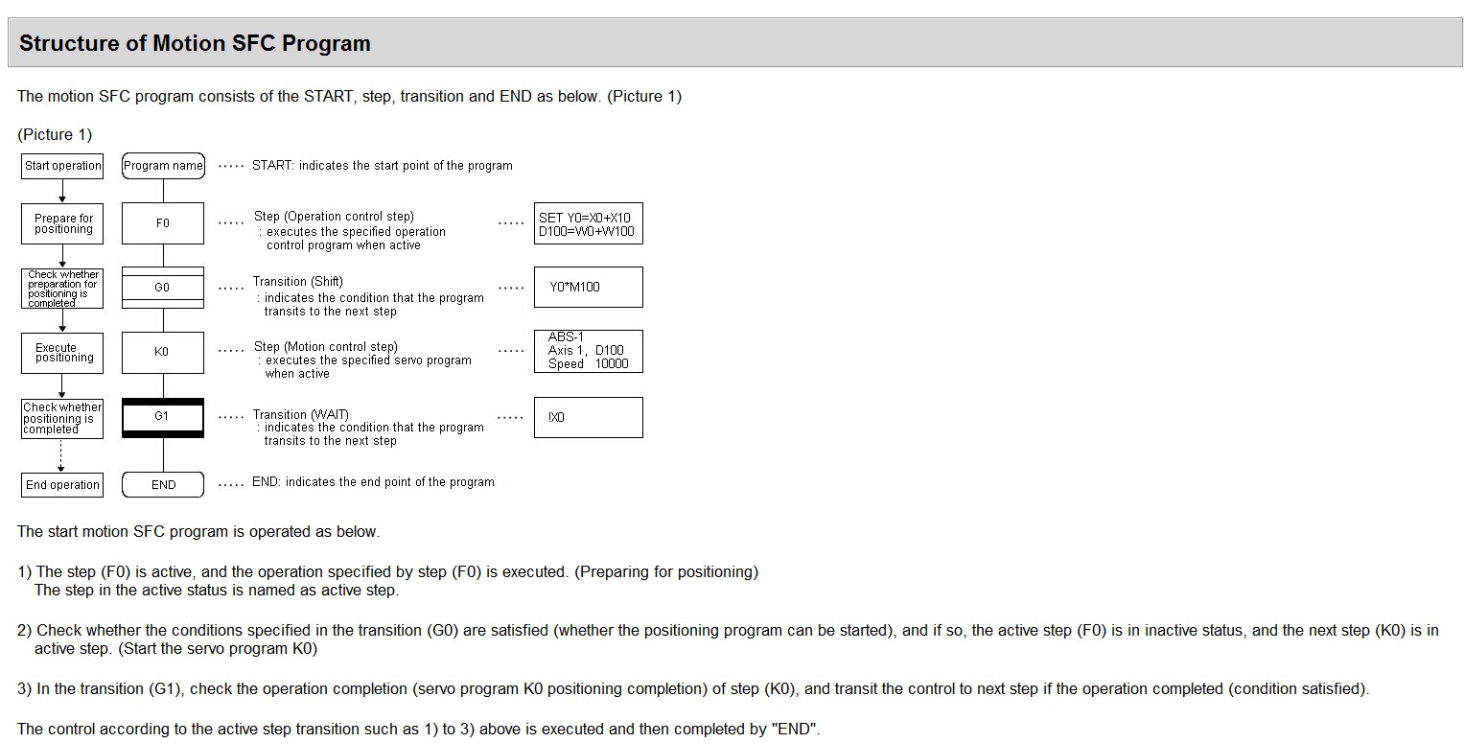
docs/mechatronic_project/pics/sfc_prog_format.jpg
