TNH510/5_DOF_Robot_Arm/docs/mechatronic_project/report/thach/flow_chart/chuong6_muc_1.png

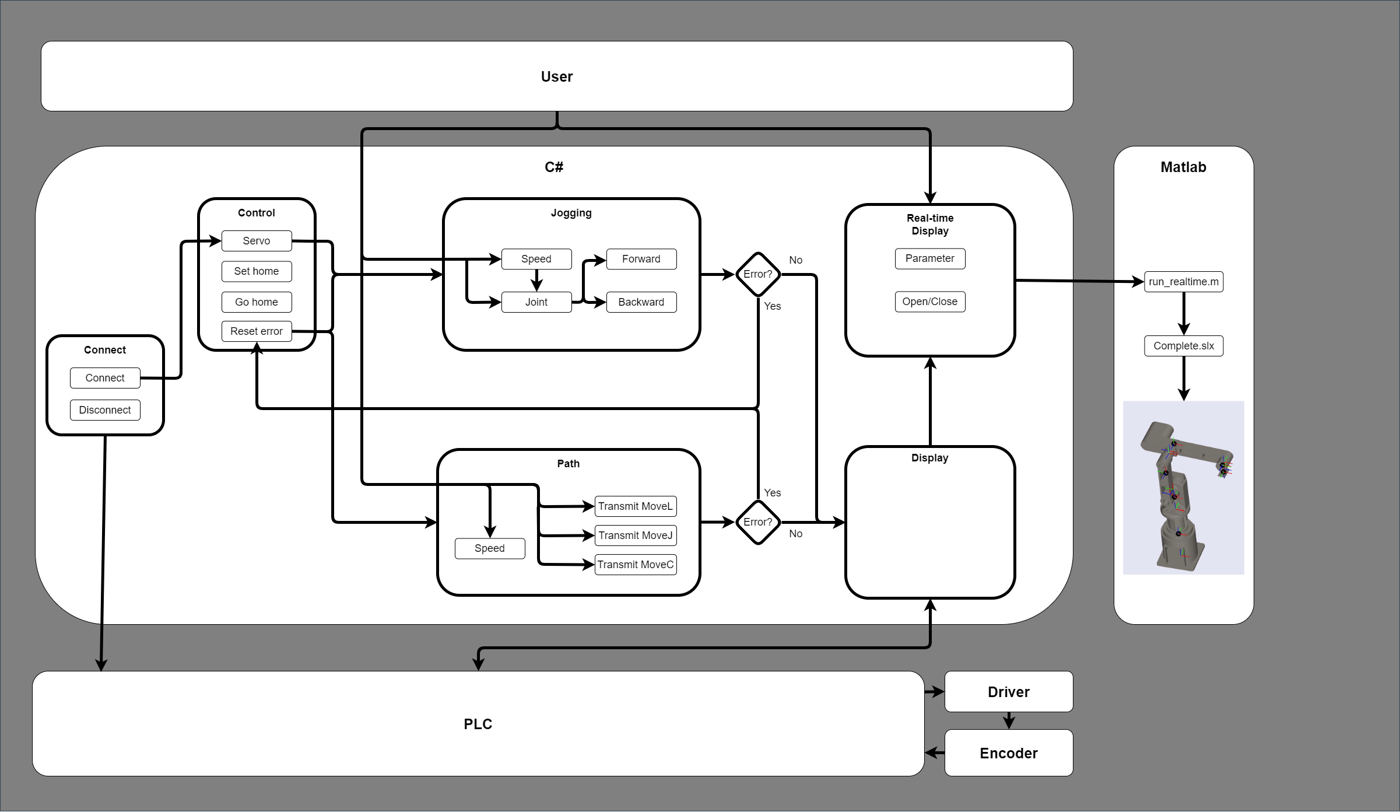
docs/mechatronic_project/report/thach/flow_chart/chuong6_muc_1.png
