TNH510/5_DOF_Robot_Arm/gui/robot-tool-c#/Images/2a45fe61348fd6894f2a9442b7e511b4.jpg

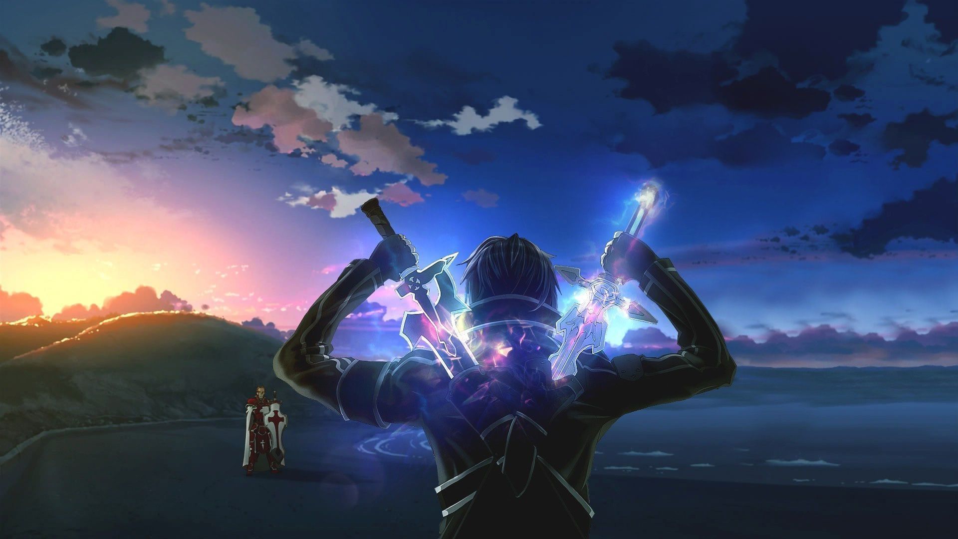
gui/robot-tool-c#/Images/2a45fe61348fd6894f2a9442b7e511b4.jpg
