TNH510/5_DOF_Robot_Arm/gui/robot-tool-c#/Images/bg_cv.jpg

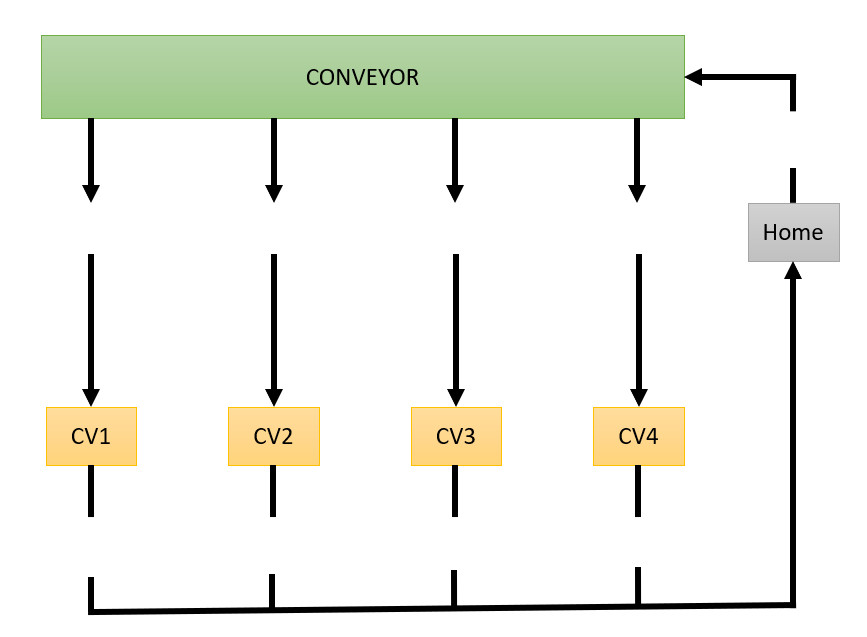
gui/robot-tool-c#/Images/bg_cv.jpg
