TNH510/5_DOF_Robot_Arm/gui/robot-tool-c#/Images/hinh-nen-windows-10-dep-32.jpg

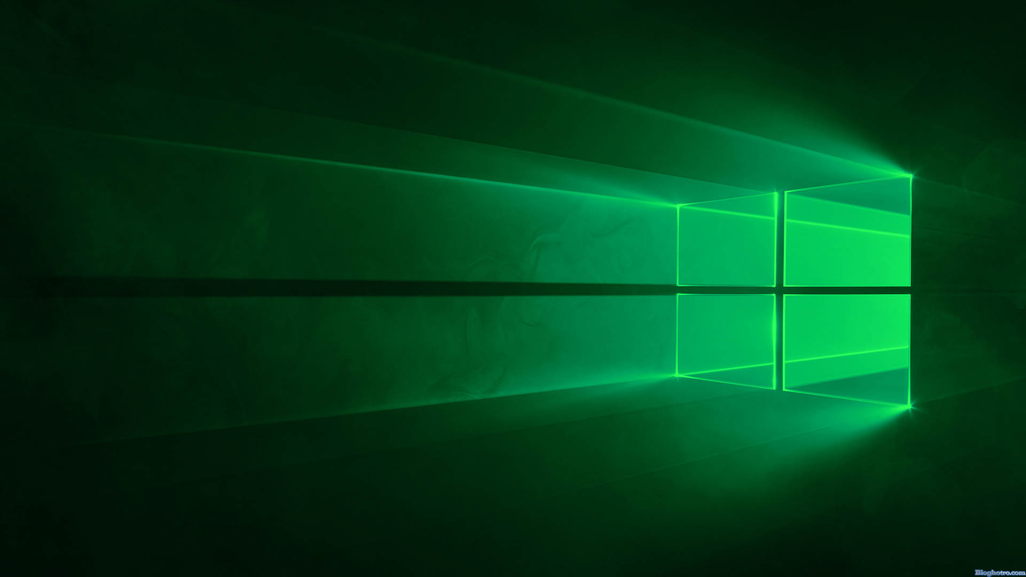
gui/robot-tool-c#/Images/hinh-nen-windows-10-dep-32.jpg
