TNH510/5_DOF_Robot_Arm/gui/robot-tool-c#/RobotArmHelix/hinh-nen-win-10-dep-nhat-04.jpg

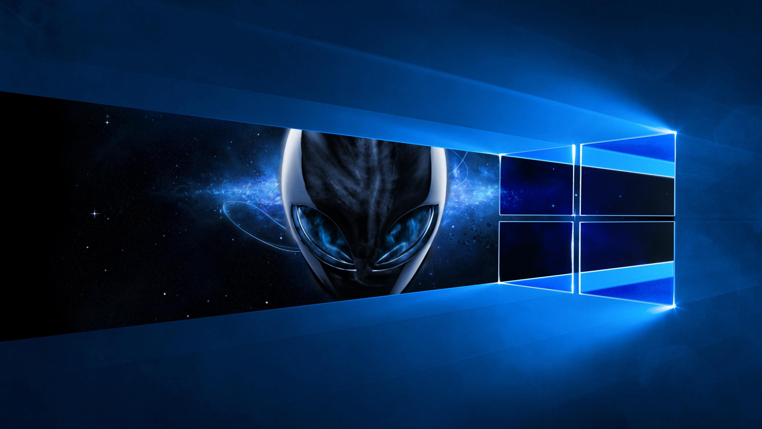
gui/robot-tool-c#/RobotArmHelix/hinh-nen-win-10-dep-nhat-04.jpg
