TNH510/5_DOF_Robot_Arm/gui/robot-tool-c#/RobotArmHelix/image/120.bmp

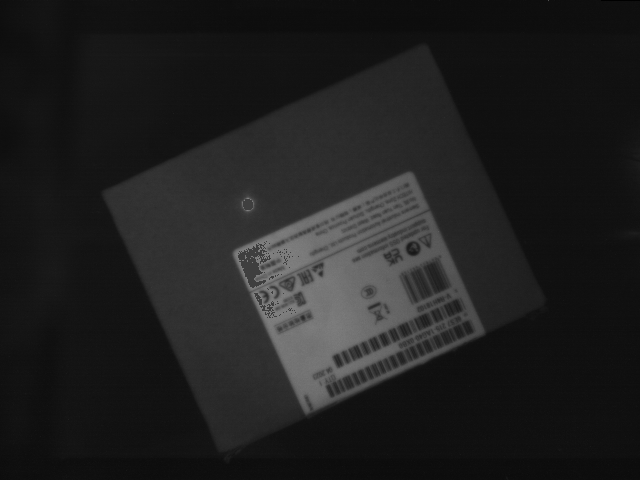
gui/robot-tool-c#/RobotArmHelix/image/120.bmp
