TNH510/5_DOF_Robot_Arm/plc/camera/read_success.png

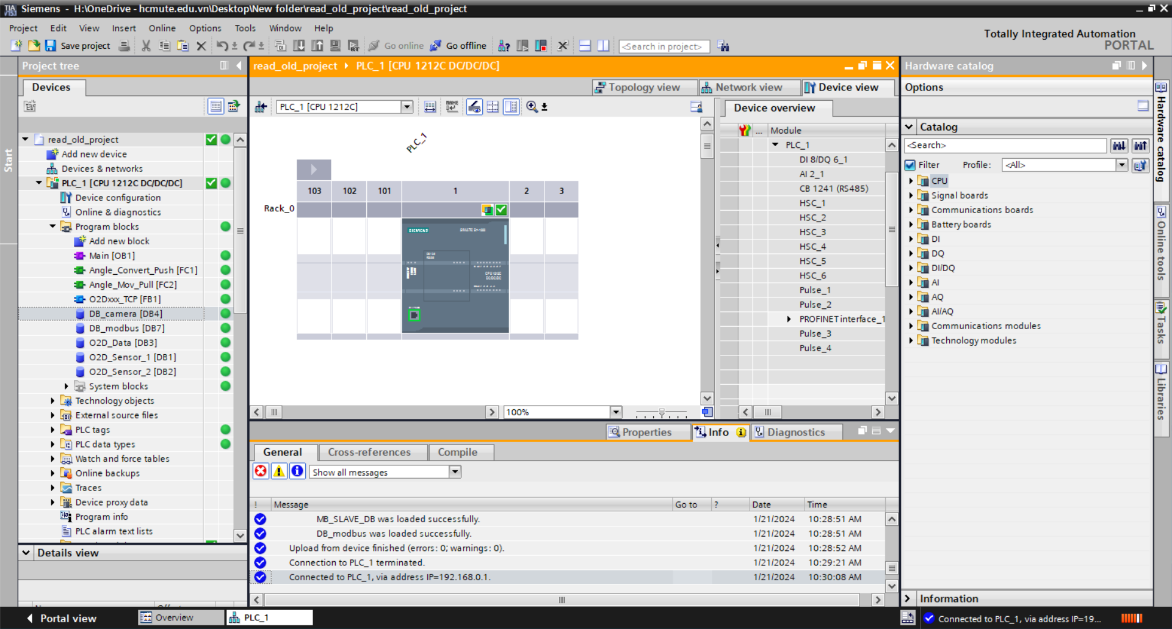
plc/camera/read_success.png
