TNH510/5_DOF_Robot_Arm/control_glove/list/component_list.md

# Control Glove v0.1 Components List

| Tên | Số lượng | Giá | Hình Ảnh |
| --- | --- | --- | --- |
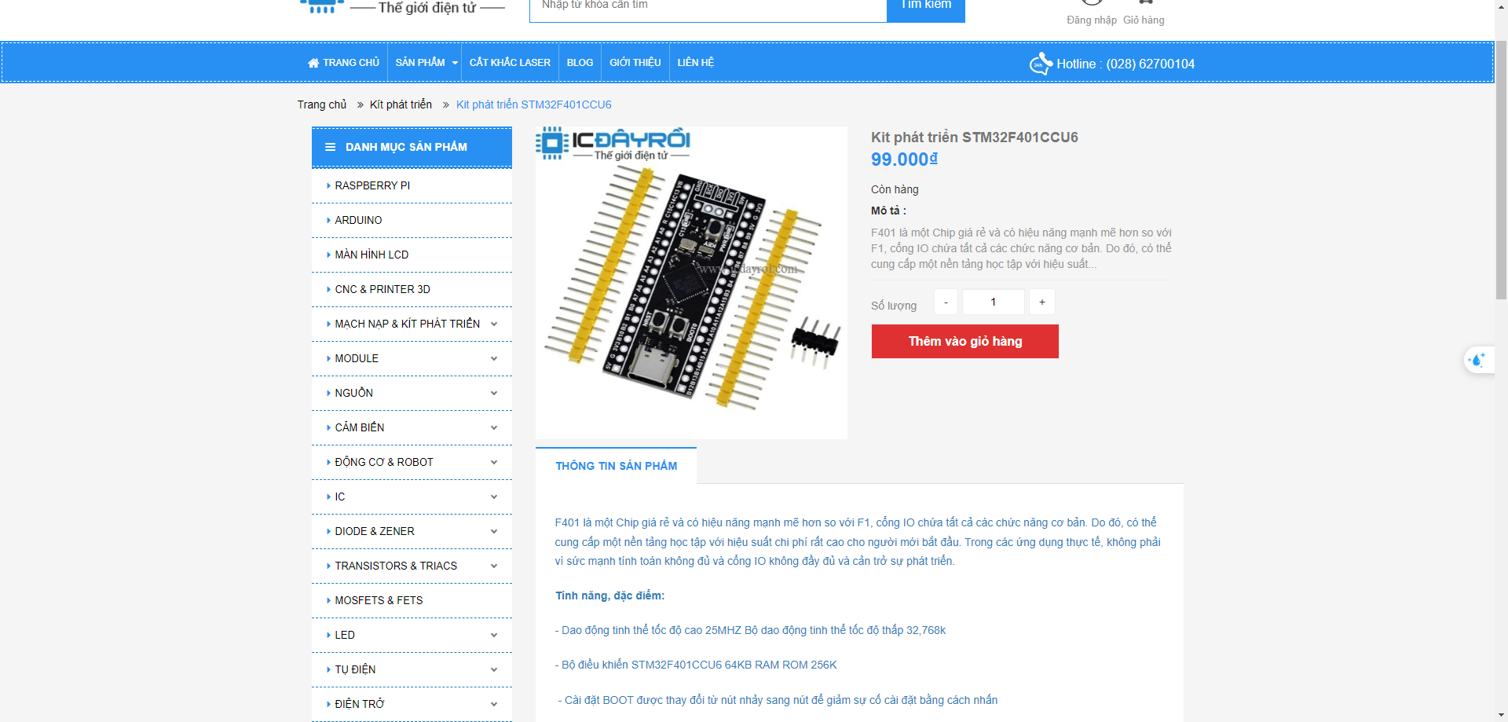
[picture p244: control_glove/list/module_stm32f4.png]
MiniSTM32F4x1
| MiniSTM32F4x1 Module | 1 | 99.000  |  |
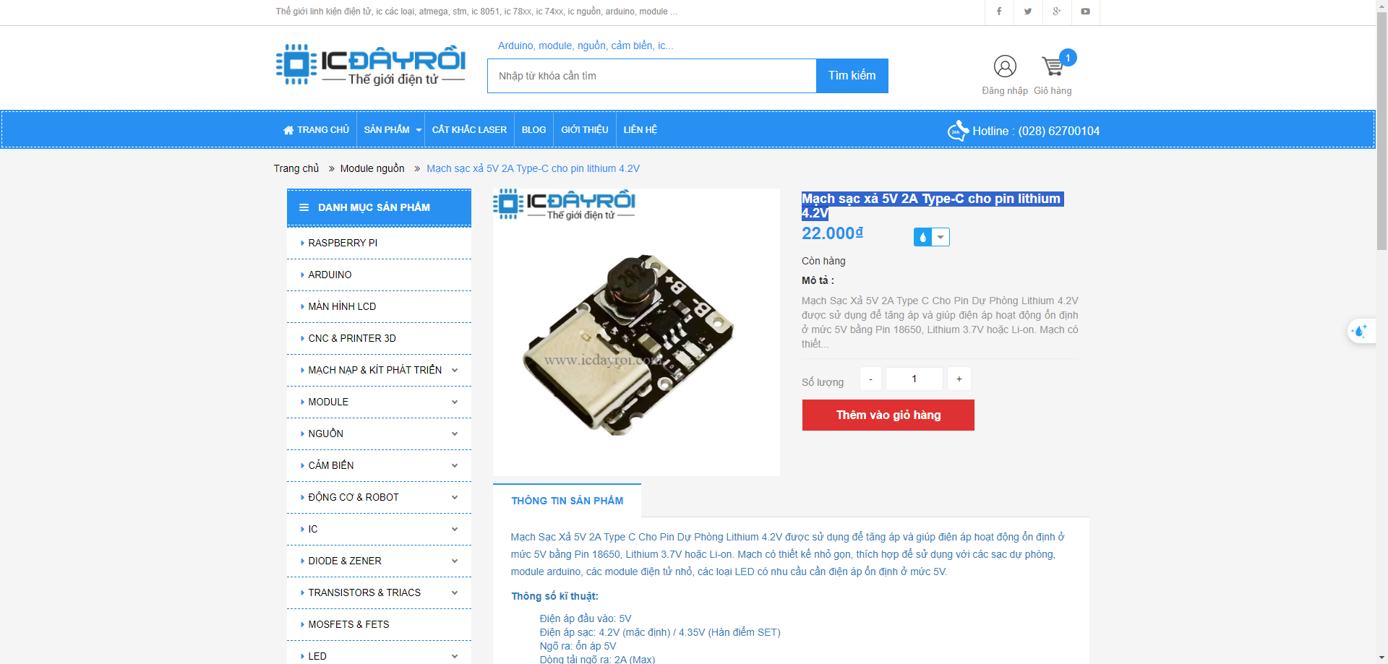
[picture p245: control_glove/list/mach_sac_xa.png]
Mạch sạc xả
| Mạch sạc xả 5V 2A Type-C cho pin lithium 4.2V | 1 | 22.000  |  |
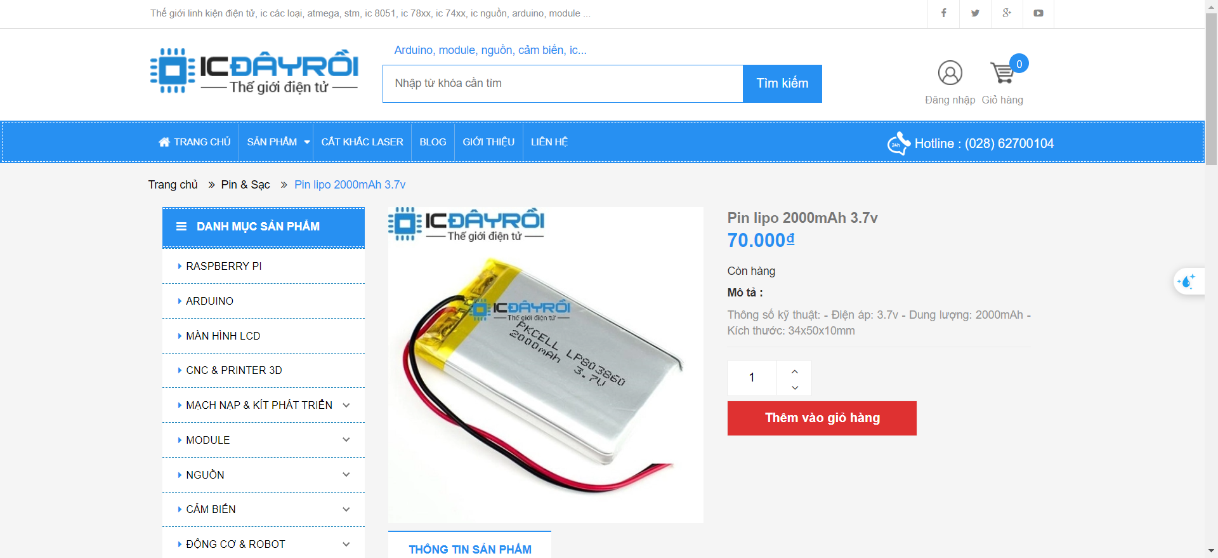
[picture p246: control_glove/list/pin_lipo.png]
Pin
| Pin Lipo 2000 mAh | 1 | 70.000  |  |
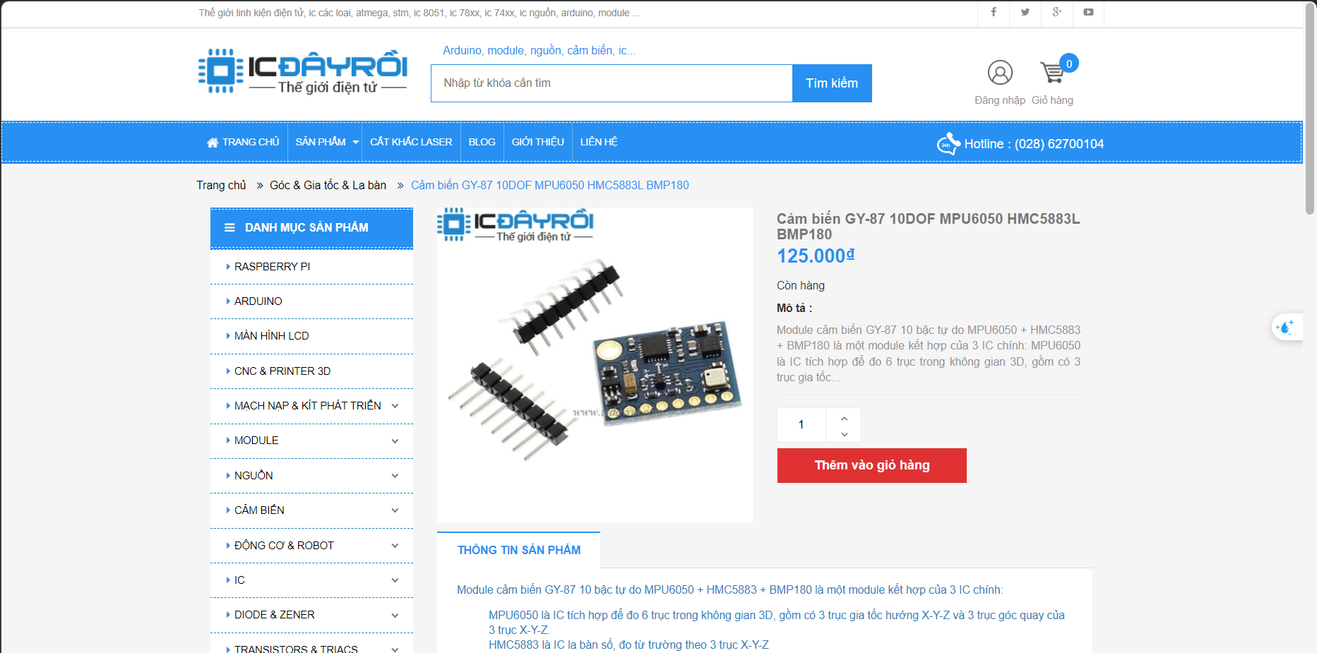
[picture p247: control_glove/list/imu.png]
IMU
| GY-87 | 2 | 125.000 |  |
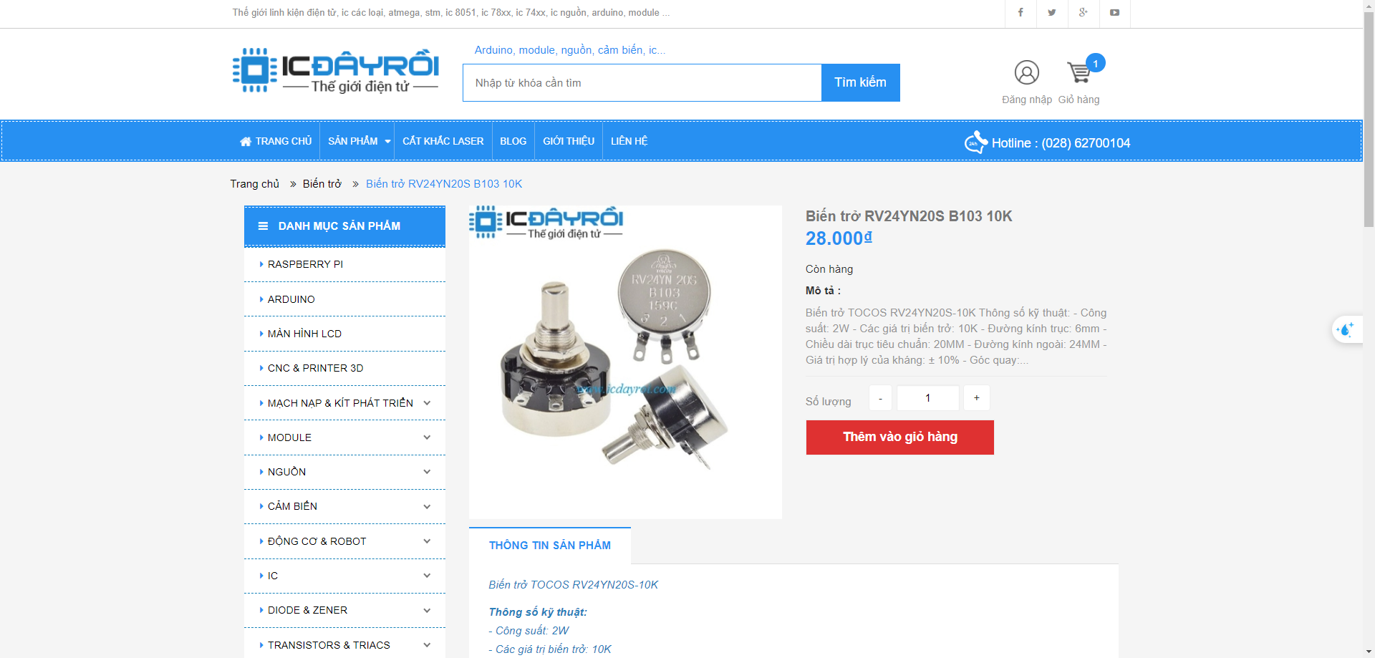
[picture p248: control_glove/list/bien_tro.png]
Biến trở
| Biến trở 10K | 1 | 28.000  |  |
| | | 469.000 | |
