TNH510/5_DOF_Robot_Arm/3d/robot_component/Inventor_Convert/Khau-0.PNG

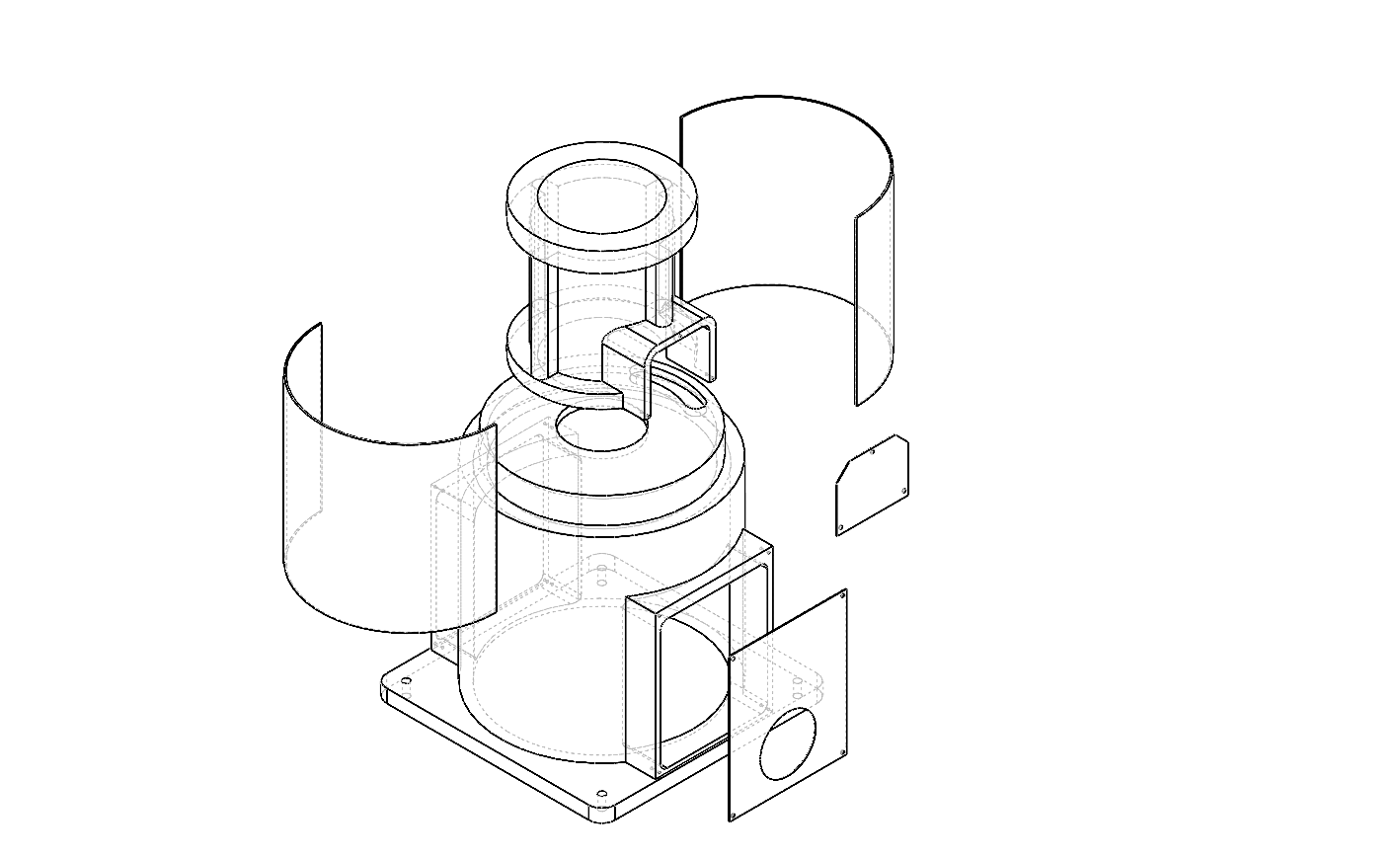
3d/robot_component/Inventor_Convert/Khau-0.PNG
