TNH510/5_DOF_Robot_Arm/3d/robot_component/Inventor_Convert/[KHAU-----3].SLDASM

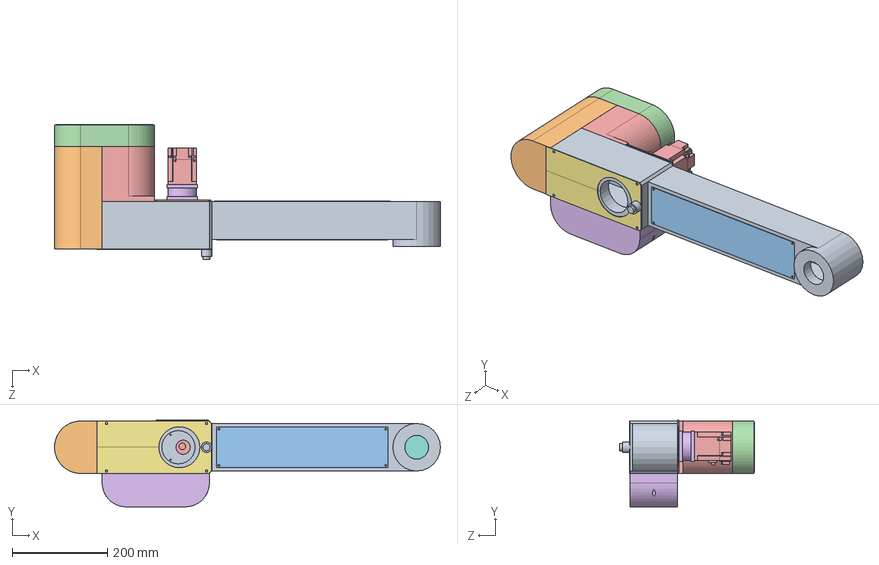
[picture p254: CAD file, 2024-07-07]
3d/robot_component/Inventor_Convert/[KHAU-----3].SLDASM
810.0 x 181.8 x 283.0 mm
[K3]Thân.stp
[K3[Nắp.stp
[K3]Căn_chỉnh_ĐC.stp
[K3]Đỡ DC.stp
[K3]Động_cơ.stp x 2
[K3]Mặt_Bích.stp
[K3]Nap.stp x 2
[K3]Nắp_Đầu.stp
[K3]Nắp_Đỡ DC.stp
[K3]Nắp_ĐộngCơ.stp
[K3]Nắp_Thân.stp
[K3]Nắp_Thân_22.stp
[K3]Ong.stp
[K3]Ốp.stp
