TNH510/5_DOF_Robot_Arm/3d/robot_final/robot.SLDASM

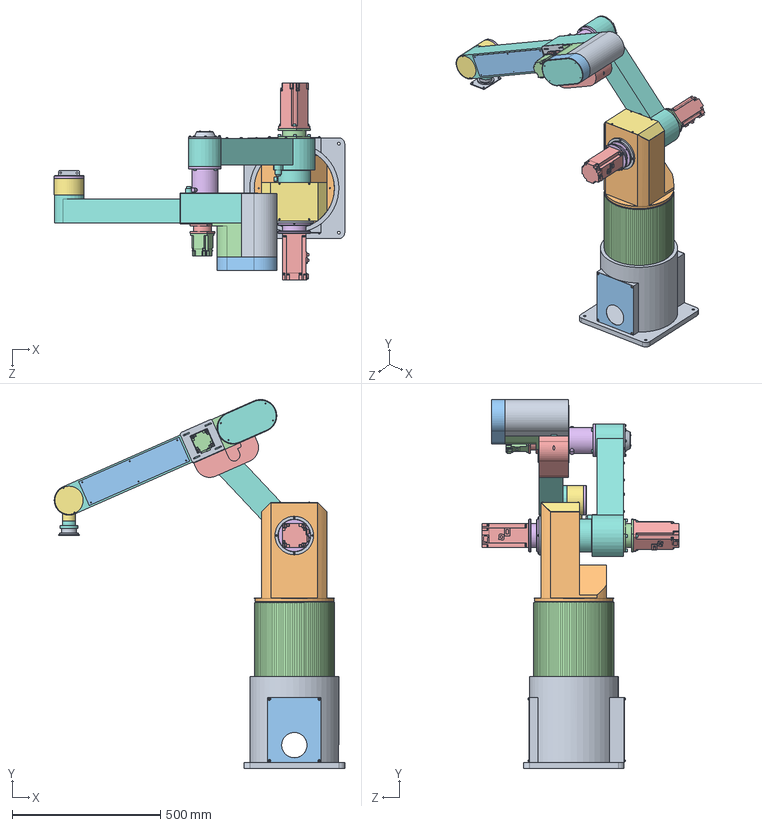
[picture p255: CAD file, 2024-07-07]
3d/robot_final/robot.SLDASM
978.9 x 1243.2 x 663.3 mm
[K0]De
[K0]Nắp.stp
[K0]Nắp_dây_điện.stp x 2
[K1]Động_cơ.stp x 2
[K0]Than_tru
[K0]Ốp_thân.stp x 4
socket button head screw_iso x 9
socket head cap screw_iso x 37
hex flange nut gradea_iso x 12
[K0]Truc
[K0]O_lan
[K0]Hop_giam_toc
socket countersunk head screw_iso x 3
[K1]Mặt_Bích.stp
[K1]Nắp_Đậy.stp
[K1]Vòng_Cản.stp
[K1]Mặt_nối.stp
[K1]Thân.oke
socket button head cap screw_am x 4
socket head cap screw_am x 13
pan cross head_am x 4
[K1]Truc
[K1]HopGiamToc
[K2]Thân_3D
[K2]Nắp.stp
[K2]Nắp_che.stp
[K2]Nắp_Thân.stp
[K2]Mặt_Bích.stp
[K2]Động_cơ.stp
[K2]Vòng_Cản.stp
pan head cross recess screw_iso x 8
[K3]Thân.stp
[K3[Nắp.stp
[K3]Căn_chỉnh_ĐC.stp
[K3]Đỡ DC.stp
[K3]Động_cơ.stp x 2
[K3]Mặt_Bích.stp
[K3]Nap.stp x 2
[K3]Nắp_Đầu.stp
[K3]Nắp_Đỡ DC.stp
[K3]Nắp_ĐộngCơ.stp
[K3]Nắp_Thân.stp
[K3]Nắp_Thân_22.stp
[K3]Ong.stp
[K3]Ốp.stp
[K4]Nắp.stp
[K4]Thân.stp
[K4]Trục.stp
Khop_6
