TNH510/5_DOF_Robot_Arm/3d/robot_gripper/Gripper_Mica/Assem1_mica.SLDASM

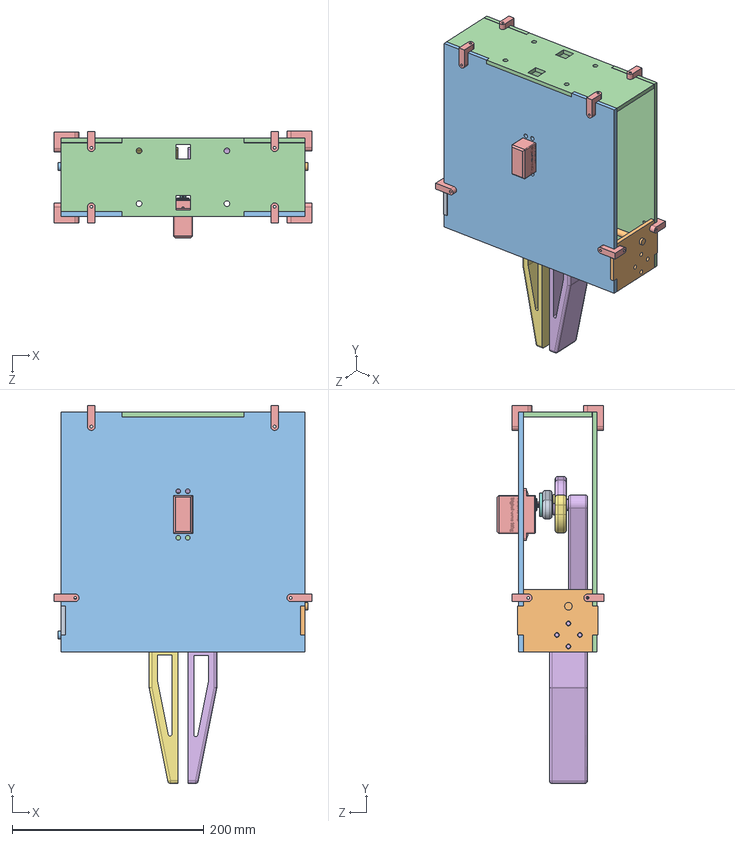
[picture p256: CAD file, 2024-07-06]
3d/robot_gripper/Gripper_Mica/Assem1_mica.SLDASM
269.0 x 394.5 x 111.5 mm
Part2_mica
Part2_mica - Copy
Part1_mica
Part3_mica
Servo 20 kg.stp
Part4-3 - Copy
Part2 - Copy
Part3 - Copy
Part1.1-print
Part1-print
