TNH510/5_DOF_Robot_Arm/3d/step_part/[K2]Assembly.STEP

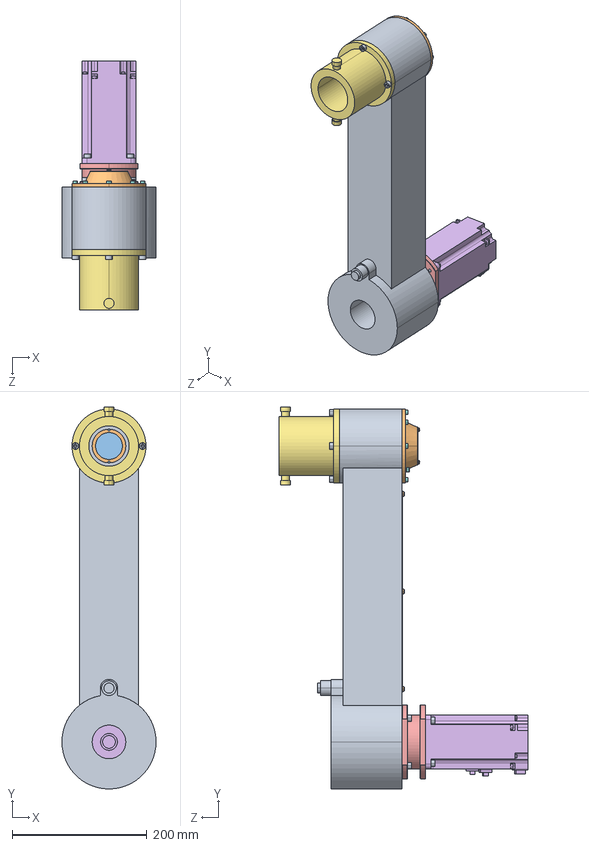
[picture p257: CAD file, 2024-07-05]
3d/step_part/[K2]Assembly.STEP
140.0 x 568.0 x 370.3 mm
[K2]Th滱_3D
[K2]N?p.stp
[K2]N?p_che.stp
[K2]N?p_Th滱.stp
[K2]M?t_B獳h.stp
[K2]ﾐ?ng_co.stp
[K2]V犥g_C?n.stp
socket head cap screw_iso_ISO 4762 M4 x 8 - 8S x 9
socket head cap screw_iso_ISO 4762 M6 x 16 - 16S x 12
pan head cross recess screw_iso_ISO 7045 - M4 x 8 - Z - 8S x 6
pan head cross recess screw_iso_ISO 7045 - M3 x 5 - Z - 5N x 2
