TNH510/5_DOF_Robot_Arm/control_glove/3d_new_version/banh_rang.SLDASM

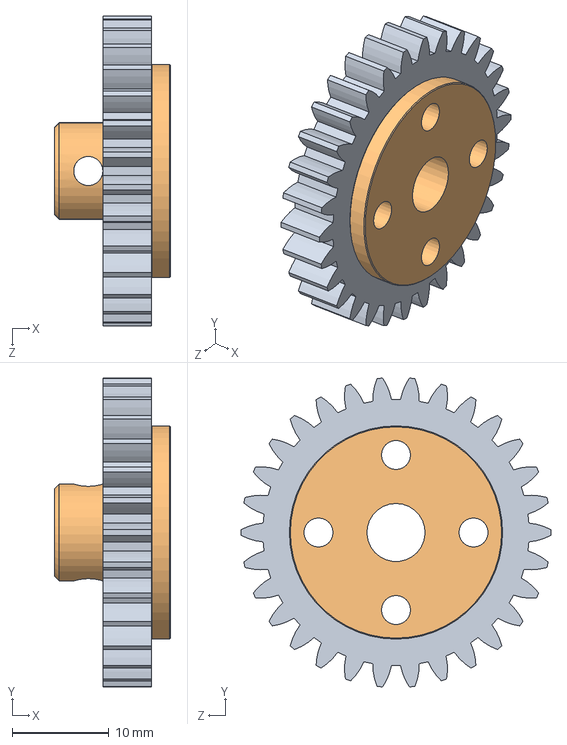
[picture p258: CAD file, 2024-07-03]
control_glove/3d_new_version/banh_rang.SLDASM
12.0 x 31.9 x 32.0 mm
spur gear_iso_m3
mat_bich_6mm
