TNH510/5_DOF_Robot_Arm/drawing/ban_ve_3d/K0/K0.SLDASM

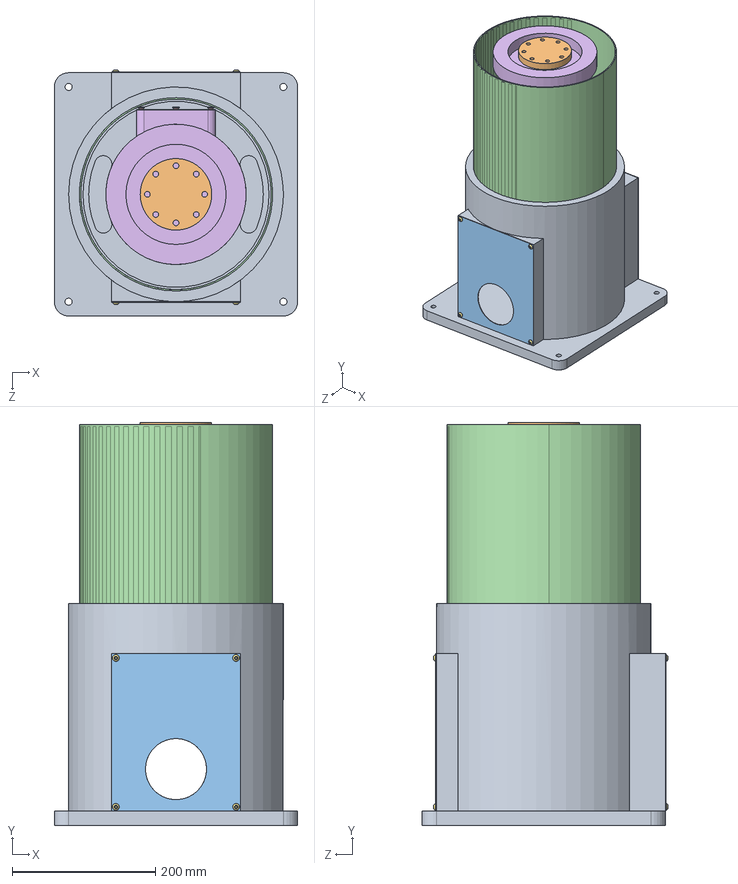
[picture p259: CAD file, 2024-07-07]
drawing/ban_ve_3d/K0/K0.SLDASM
340.0 x 563.0 x 343.8 mm
[K0]De
[K0]Nắp.stp
[K0]Nắp_dây_điện.stp x 2
[K1]Động_cơ.stp
[K0]Than_tru
socket button head screw_iso x 9
socket head cap screw_iso x 16
hex flange nut gradea_iso x 12
[K0]Truc
[K0]O_lan
[K0]Hop_giam_toc
socket countersunk head screw_iso x 3
[K0]Ốp_thân.stp x 2
