TNH510/5_DOF_Robot_Arm/drawing/ban_ve_3d/khau_4/[K4]Assembly.SLDASM

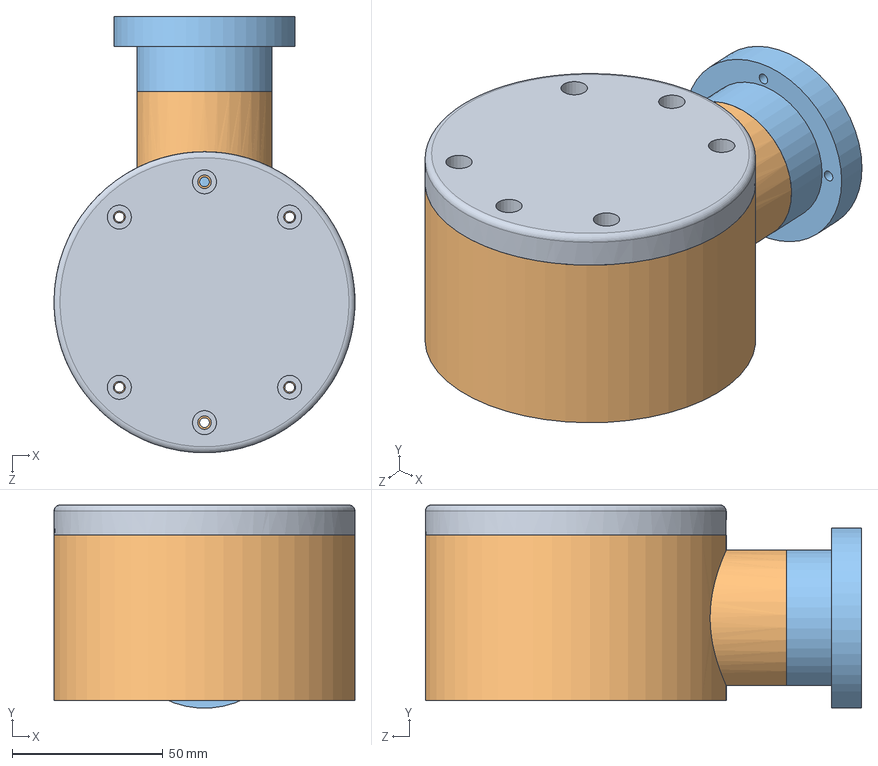
[picture p260: CAD file, 2024-07-07]
drawing/ban_ve_3d/khau_4/[K4]Assembly.SLDASM
100.0 x 67.4 x 145.0 mm
[K4]Nắp.stp
[K4]Thân.stp
[K4]Trục.stp
