TNH510/5_DOF_Robot_Arm/3d/robot_gripper/thuc-hien/Gripper_Loc/Assem1.SLDASM

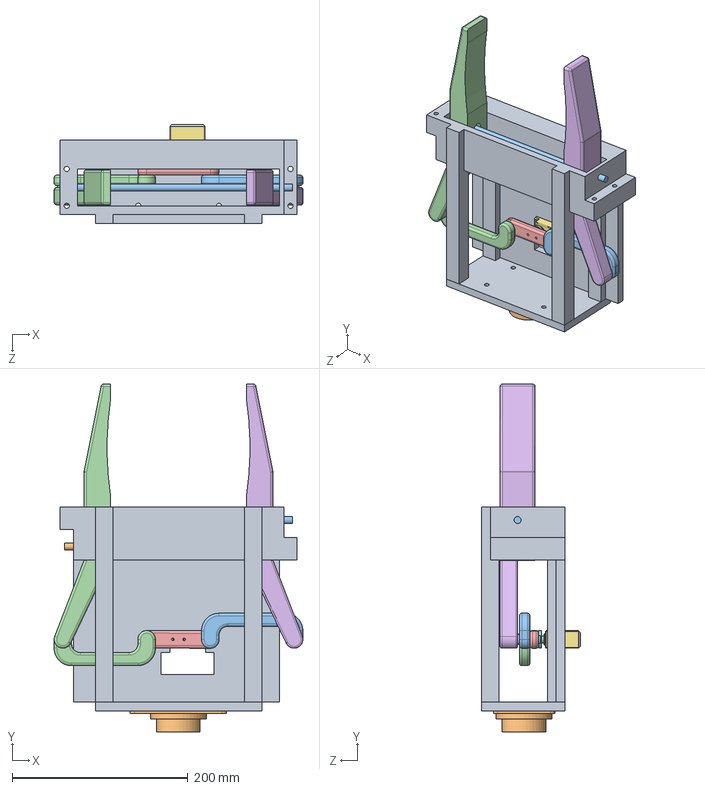
[picture p261: CAD file, 2023-12-29]
3d/robot_gripper/thuc-hien/Gripper_Loc/Assem1.SLDASM
283.5 x 396.5 x 112.5 mm
Part3 - Copy
Servo 20 kg.stp
Khop_6
Part4-3 - Copy
