TNH510/5_DOF_Robot_Arm/3d/robot_stl/robot - [K4]Assembly-1.STL

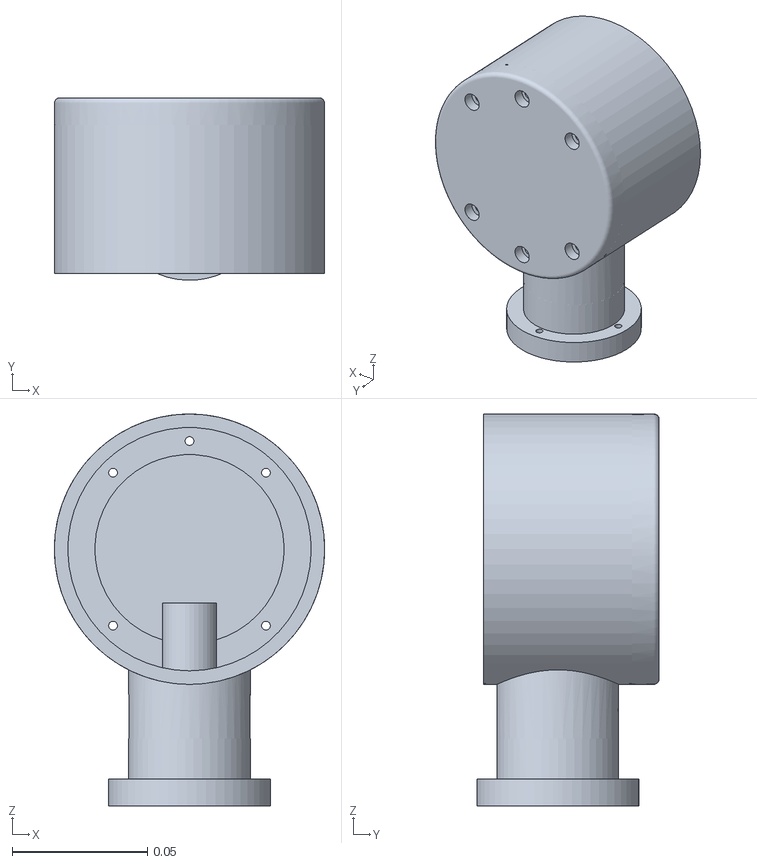
[picture p262: CAD file, 2024-01-22]
3d/robot_stl/robot - [K4]Assembly-1.STL
0.1 x 0.0675 x 0.145
