TNH510/5_DOF_Robot_Arm/control_glove/3d/glove_v0.1_part_1.SLDASM

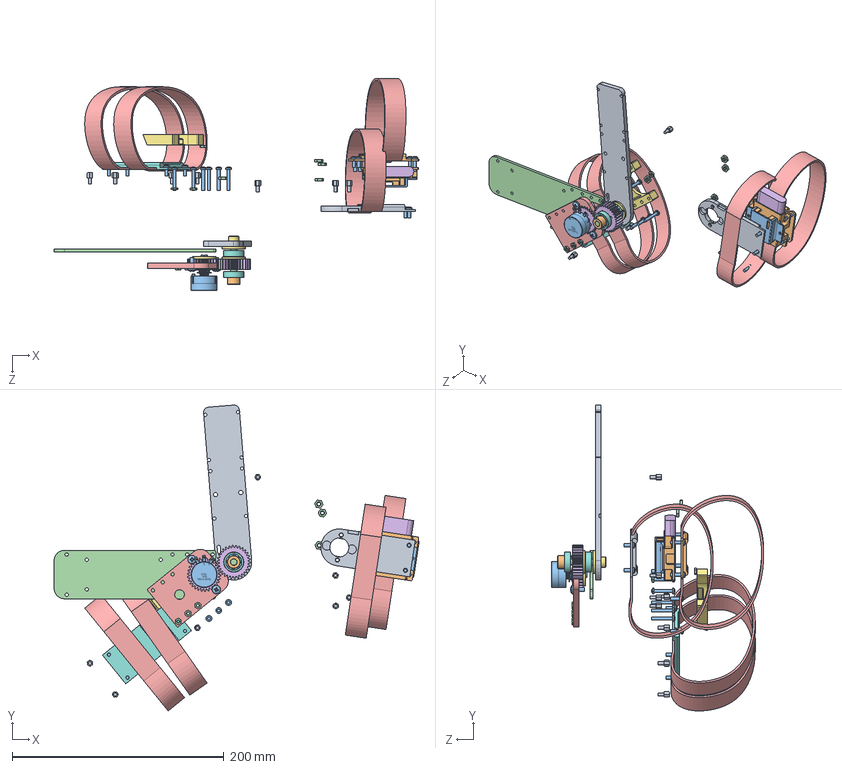
[picture p263: CAD file, 2024-06-17]
control_glove/3d/glove_v0.1_part_1.SLDASM
345.2 x 289.3 x 200.9 mm
hexagonal_spacer_MF_M3_H05_HEX5_FTD3_MTL8.step x 8
vo_pin
nap_mach_sac
truc_khuy_tay
khuy_tay
pin_lipoSLDPRT
noi_cang_tay
mieng_dem_cang_tay
mieng_dem_canh_tay
mieng_dem_canh_tay - 2
pan head cross recess screw_iso x 20
hex thin nut gradeb_iso x 12
day_vecro x 4
spur gear_iso_m3 x 2
6mm Rigid Flange Coupling v2.step x 3
instrument ball bearing_68_am x 2
thanh_khuy_tay
vong_chan_truc_6mm
RV24 v6.step
thanh_cang_tay
