TNH510/5_DOF_Robot_Arm/control_glove/3d_new_version/phan_canh_tay_asm.SLDASM

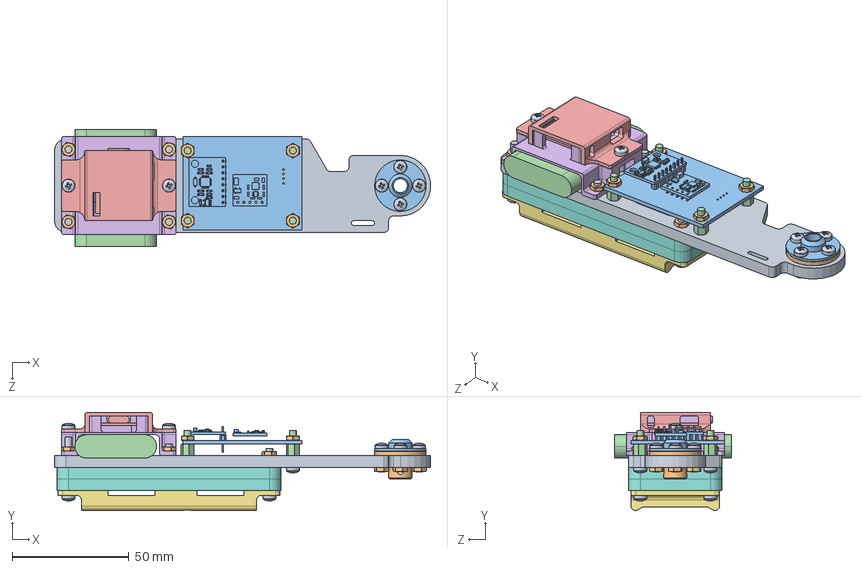
[picture p264: CAD file, 2024-07-03]
control_glove/3d_new_version/phan_canh_tay_asm.SLDASM
160.9 x 42.0 x 50.0 mm
thanh_khuy_tay
mat_bich_6mm
dem_mat_bich
hexagonal_spacer_MF_M3_H05_HEX5_FTD3_MTL8.step x 4
nap_mach_sac
vo_pin
mieng_dem_canh_tay - 2
mieng_lot_dem_canh_tay_1 x 2
pan head cross recess screw_iso x 16
hex thin nut chamfered gradeab_iso x 15
shoulder_module_v0.1.step
pin_lipoSLDPRT
mach_sac
