TNH510/5_DOF_Robot_Arm/3d/robot_gripper/thuc-hien/Gripper_Loc/Gripper_Mica/Mica_component/mica - complete.dxf

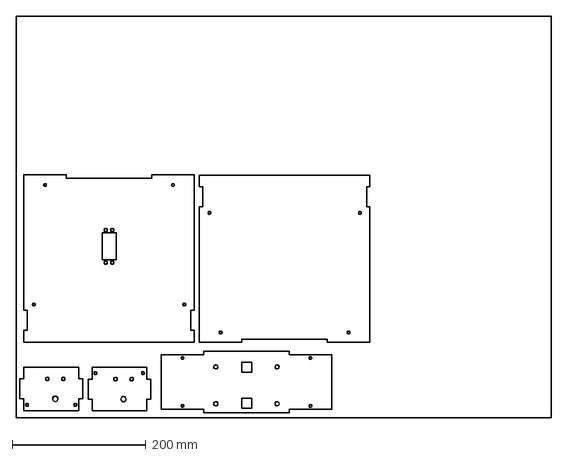
[picture p265: CAD file, 2023-12-29]
3d/robot_gripper/thuc-hien/Gripper_Loc/Gripper_Mica/Mica_component/mica - complete.dxf
800.0 x 600.0 mm
