TNH510/5_DOF_Robot_Arm/control_glove/3d_new_version/tay_cam_asm.SLDASM

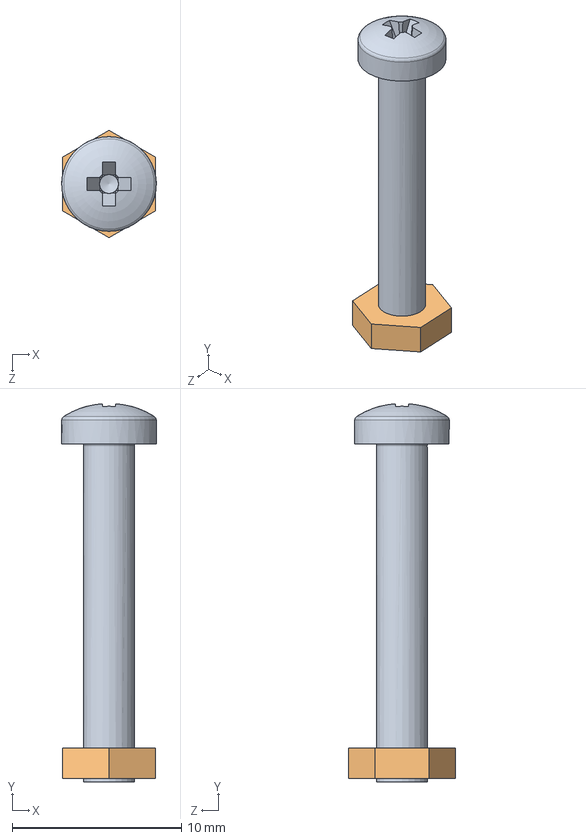
[picture p266: CAD file, 2024-06-29]
control_glove/3d_new_version/tay_cam_asm.SLDASM
5.60 x 22.4 x 6.35 mm
pan head cross recess screw_iso
hex thin nut gradeb_iso
