TNH510/5_DOF_Robot_Arm/3d/robot_component/Assem1.SLDASM

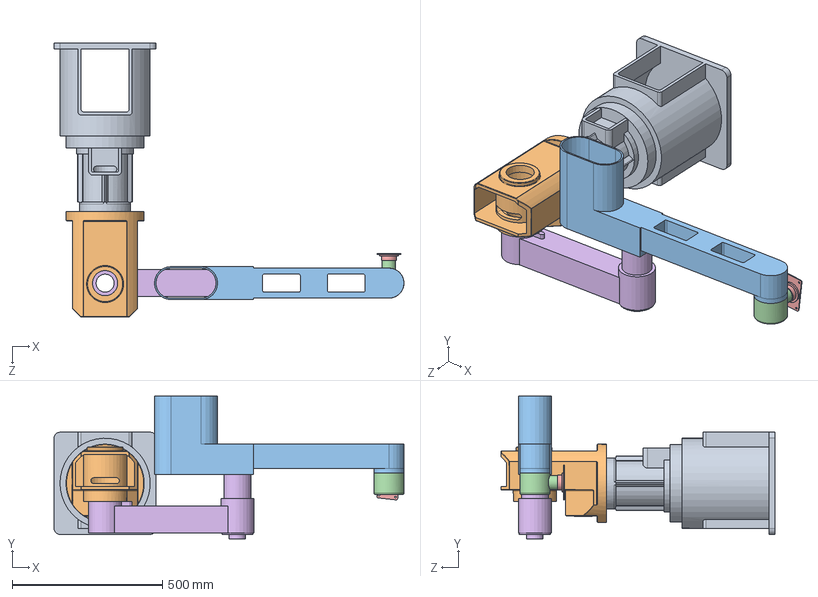
[picture p267: CAD file, 2024-07-06]
3d/robot_component/Assem1.SLDASM
1164.1 x 475.0 x 912.0 mm
Khop_1
Khop_2
Khop_4
Khop_5
Khop_6
Khop3
