TNH510/5_DOF_Robot_Arm/3d/robot_gripper_new/gripper.SLDASM

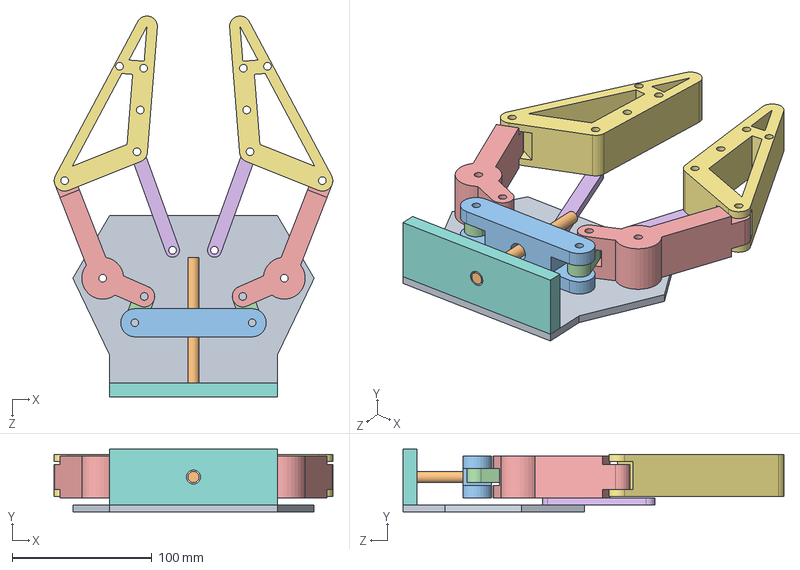
[picture p268: CAD file, 2024-01-22]
3d/robot_gripper_new/gripper.SLDASM
199.5 x 45.0 x 272.8 mm
