TNH510/5_DOF_Robot_Arm/3d/robot_gripper_new/demo/Gripper.SLDASM

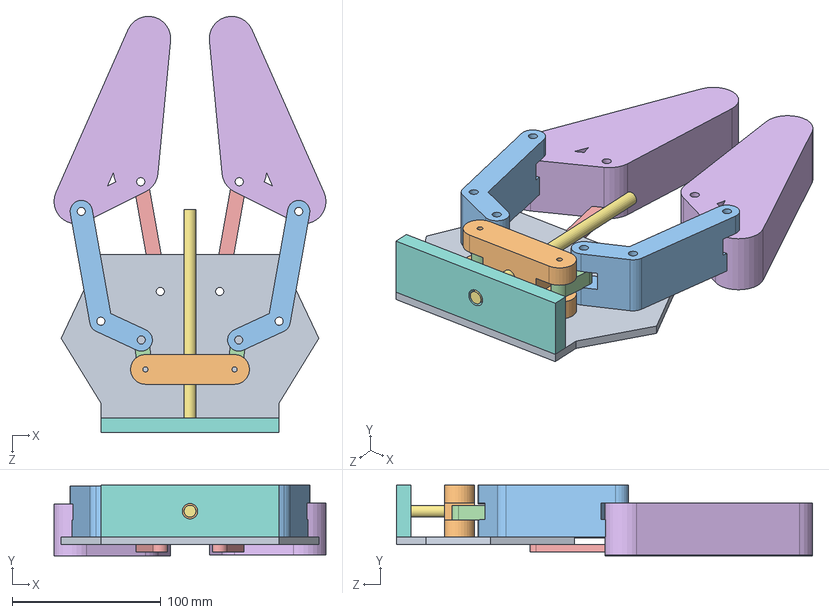
[picture p269: CAD file, 2024-01-22]
3d/robot_gripper_new/demo/Gripper.SLDASM
183.0 x 47.5 x 280.1 mm
