TNH510/5_DOF_Robot_Arm/3d/robot_gripper/thuc-hien/Gripper_Loc/Gripper_Mica/Assem1_mica.SLDASM

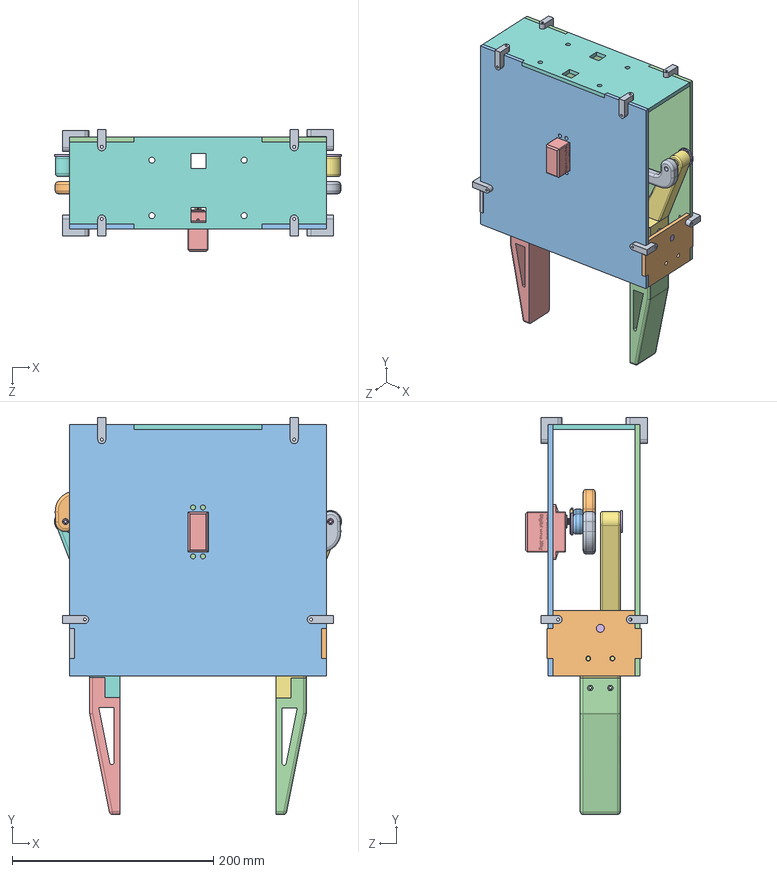
[picture p270: CAD file, 2024-01-04]
3d/robot_gripper/thuc-hien/Gripper_Loc/Gripper_Mica/Assem1_mica.SLDASM
285.2 x 394.5 x 121.5 mm
Part2_mica
Part2_mica - Copy
Part1_mica
Part3_mica
Servo 20 kg.stp
Part3 - Copy
Part2 - Copy
o-bi x 4
mat-bich-m3 x 4
Part1.left - p1
Part1.right - p1
Part4-3 - Copy
Part1.left - p2
Part1.right - p2
