TNH510/5_DOF_Robot_Arm/3d/robot_component/Inventor_Convert/[K3-K4].SLDASM

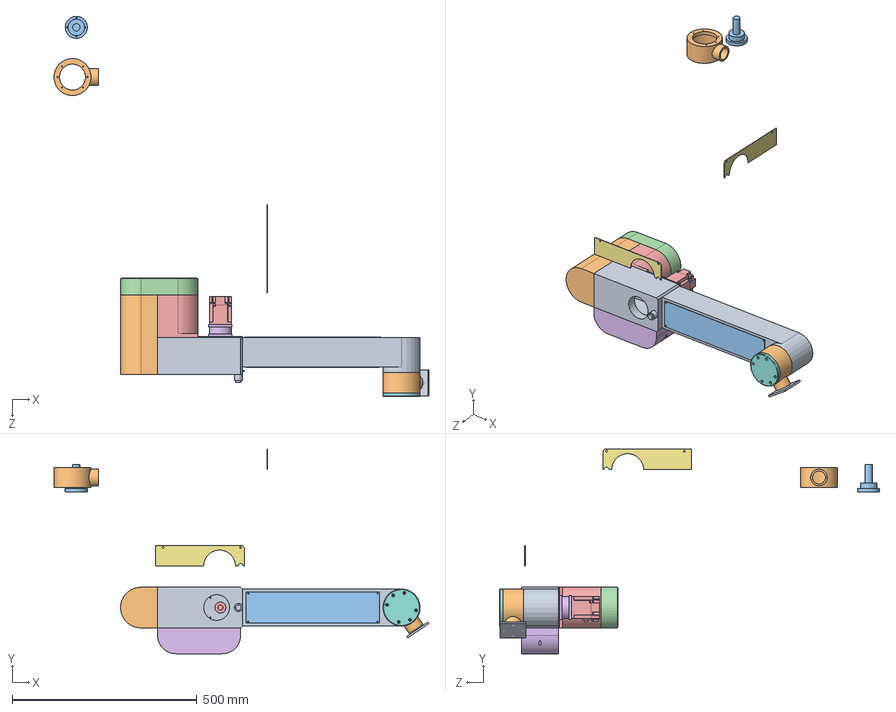
[picture p271: CAD file, 2024-01-04]
3d/robot_component/Inventor_Convert/[K3-K4].SLDASM
1014.1 x 553.1 x 1028.8 mm
[K3]Thân.stp
[K3[Nắp.stp
[K3]Căn_chỉnh_ĐC.stp
[K3]Đỡ DC.stp
[K3]Động_cơ.stp
[K3]Mặt_Bích.stp
[K3]Nap.stp x 2
[K3]Nắp_Đầu.stp
[K3]Nắp_Đỡ DC.stp
[K3]Nắp_ĐộngCơ.stp
[K3]Nắp_Thân.stp
[K3]Nắp_Thân_22.stp
[K3]Ong.stp
[K3]Ốp.stp
[K4]Động_cơ.stp
[K4]Nắp.stp
[K4]Tam noi.stp
[K4]Thân.stp x 2
[K4]Trục.stp
