TNH510/5_DOF_Robot_Arm/3d/robot_component/Inventor_Convert/K2.SLDASM

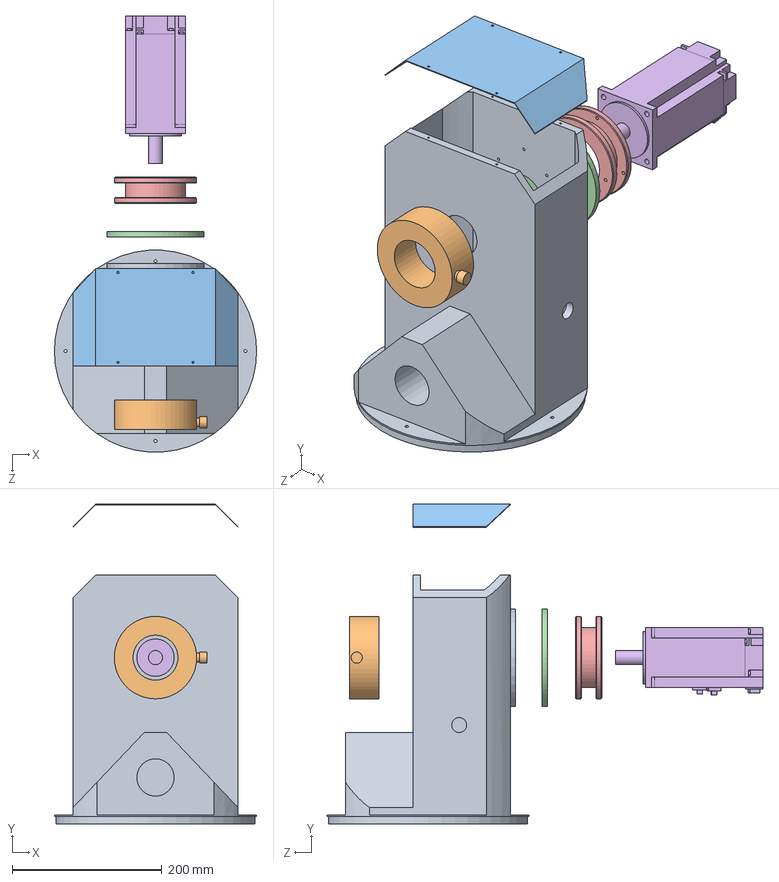
[picture p272: CAD file, 2024-01-01]
3d/robot_component/Inventor_Convert/K2.SLDASM
270.0 x 426.9 x 582.1 mm
[K1]Thân.stp
[K1]Vòng_Cản.stp
[K1]Nắp_Đậy.stp
[K1]Mặt_nối.stp
[K1]Mặt_Bích.stp
[K1]Động_cơ.stp
