TNH510/5_DOF_Robot_Arm/3d/robot_component/Khop3.SLDPRT

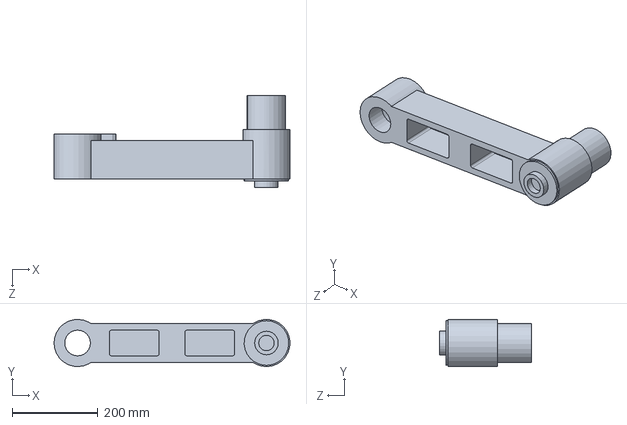
[picture p273: CAD file, 2024-07-06]
3d/robot_component/Khop3.SLDPRT
549.9 x 110.0 x 215.0 mm
