TNH510/5_DOF_Robot_Arm/3d/robot_gripper/thuc-hien/Gripper_Loc/Gripper_Mica/Part1.left - p1.SLDPRT

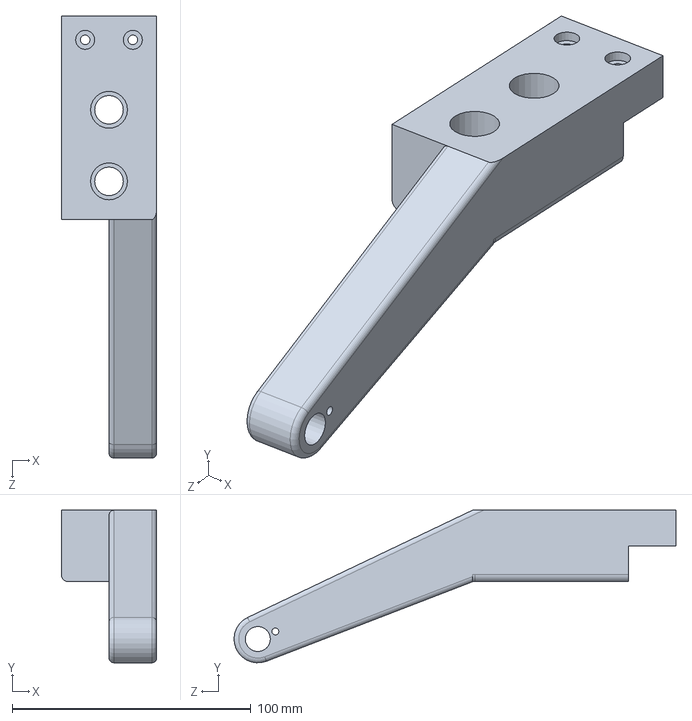
[picture p274: CAD file, 2024-01-04]
3d/robot_gripper/thuc-hien/Gripper_Loc/Gripper_Mica/Part1.left - p1.SLDPRT
40.0 x 64.0 x 185.3 mm
