TNH510/5_DOF_Robot_Arm/3d/robot_gripper/thuc-hien/Gripper_Loc/Print-component/Part4.STL

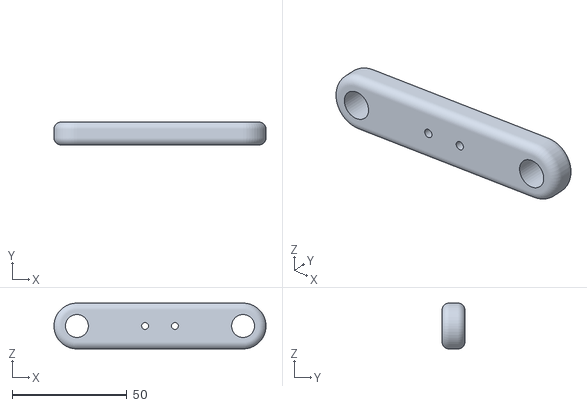
[picture p275: CAD file, 2023-12-29]
3d/robot_gripper/thuc-hien/Gripper_Loc/Print-component/Part4.STL
92.5 x 10.0 x 20.0
