TNH510/5_DOF_Robot_Arm/3d/robot_gripper_new/demo/Part3.SLDPRT

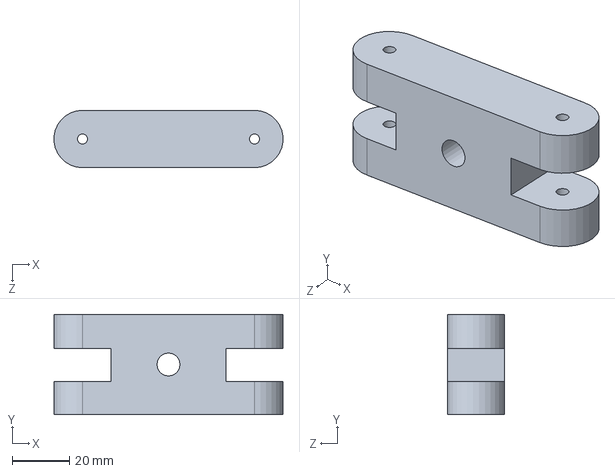
[picture p276: CAD file, 2024-01-22]
3d/robot_gripper_new/demo/Part3.SLDPRT
79.9 x 35.0 x 20.0 mm
