TNH510/5_DOF_Robot_Arm/3d/robot_gripper_new/Part4.SLDPRT

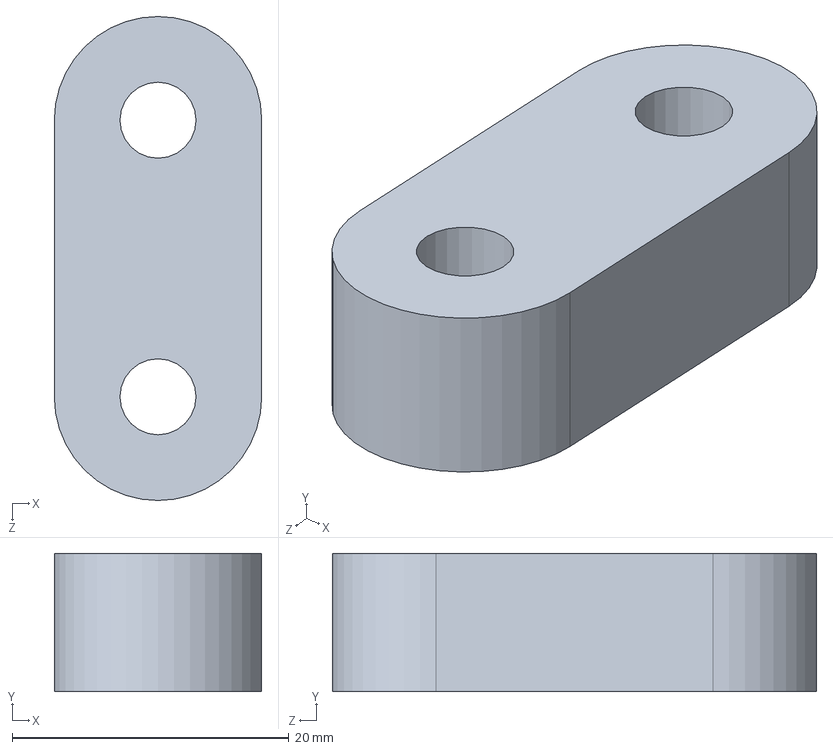
[picture p277: CAD file, 2024-01-22]
3d/robot_gripper_new/Part4.SLDPRT
15.0 x 10.0 x 35.0 mm
