TNH510/5_DOF_Robot_Arm/3d/robot_stl/robot - K1-1.STL

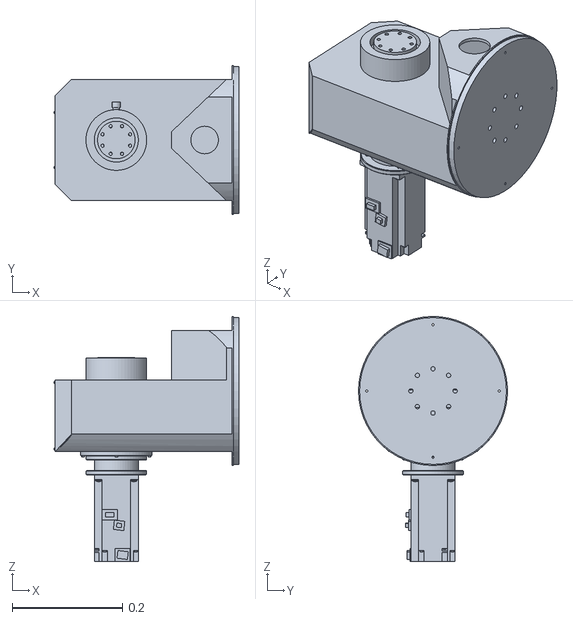
[picture p278: CAD file, 2024-01-22]
3d/robot_stl/robot - K1-1.STL
0.335 x 0.27 x 0.444
