TNH510/5_DOF_Robot_Arm/3d/stl_part/K4.STL

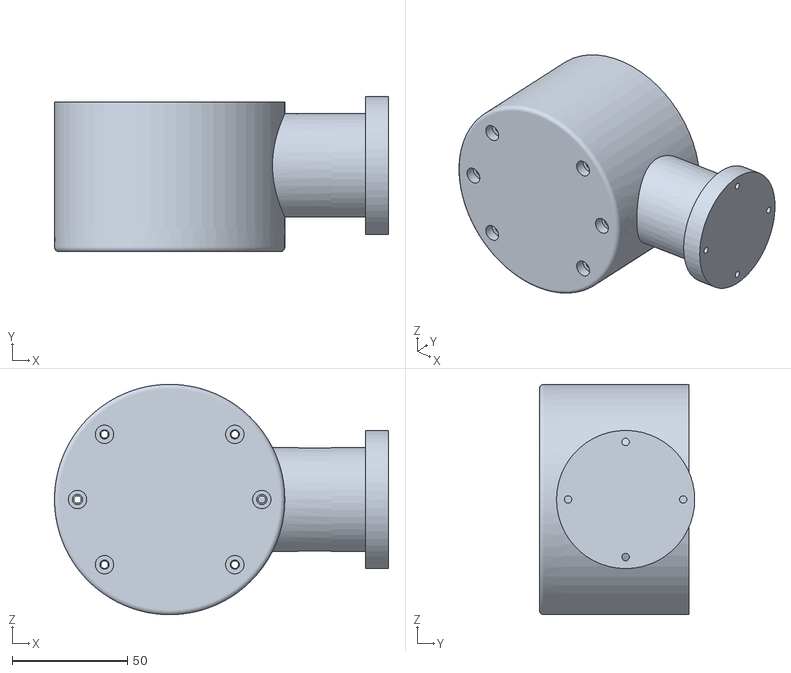
[picture p279: CAD file, 2024-01-22]
3d/stl_part/K4.STL
145.0 x 67.5 x 100.0
