TNH510/5_DOF_Robot_Arm/control_glove/2d/part_need_convert_2d/thanh_khuy_tay.SLDPRT

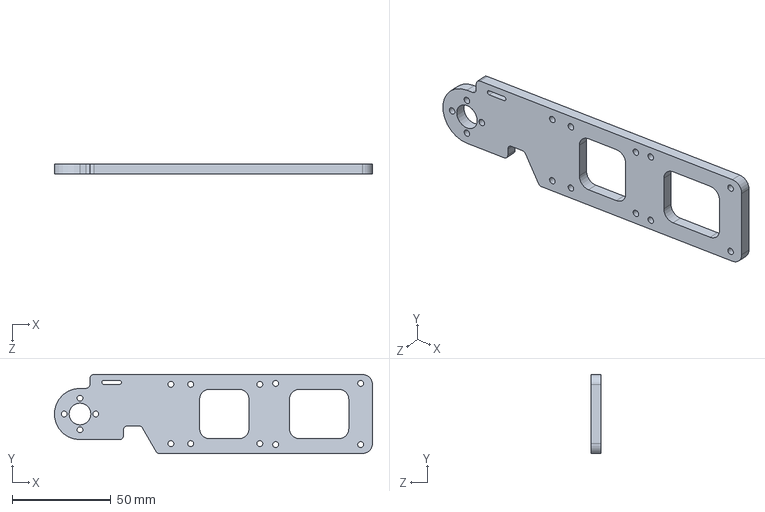
[picture p280: CAD file, 2024-07-05]
control_glove/2d/part_need_convert_2d/thanh_khuy_tay.SLDPRT
160.9 x 40.0 x 5.00 mm
