TNH510/5_DOF_Robot_Arm/control_glove/3d/in_cat/cat_mica/file_cat/khuy_tay_5mm.dxf

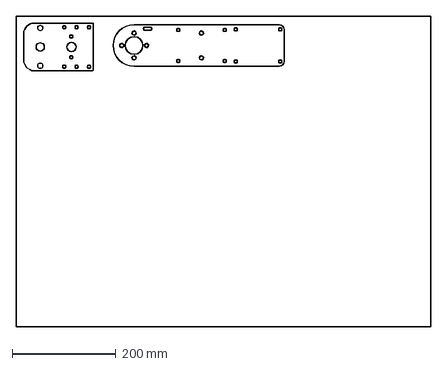
[picture p281: CAD file, 2024-05-24]
control_glove/3d/in_cat/cat_mica/file_cat/khuy_tay_5mm.dxf
800.0 x 600.0 mm
