TNH510/5_DOF_Robot_Arm/control_glove/3d/in_cat/cat_mica/file_gui/cat_lai_5mm.dxf

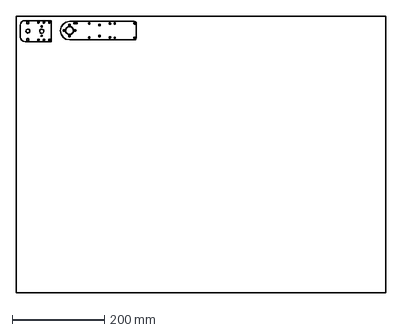
[picture p282: CAD file, 2024-05-28]
control_glove/3d/in_cat/cat_mica/file_gui/cat_lai_5mm.dxf
800.0 x 600.0 mm
