TNH510/5_DOF_Robot_Arm/control_glove/3d/in_cat/in_3d/vo_pin_v2.STL

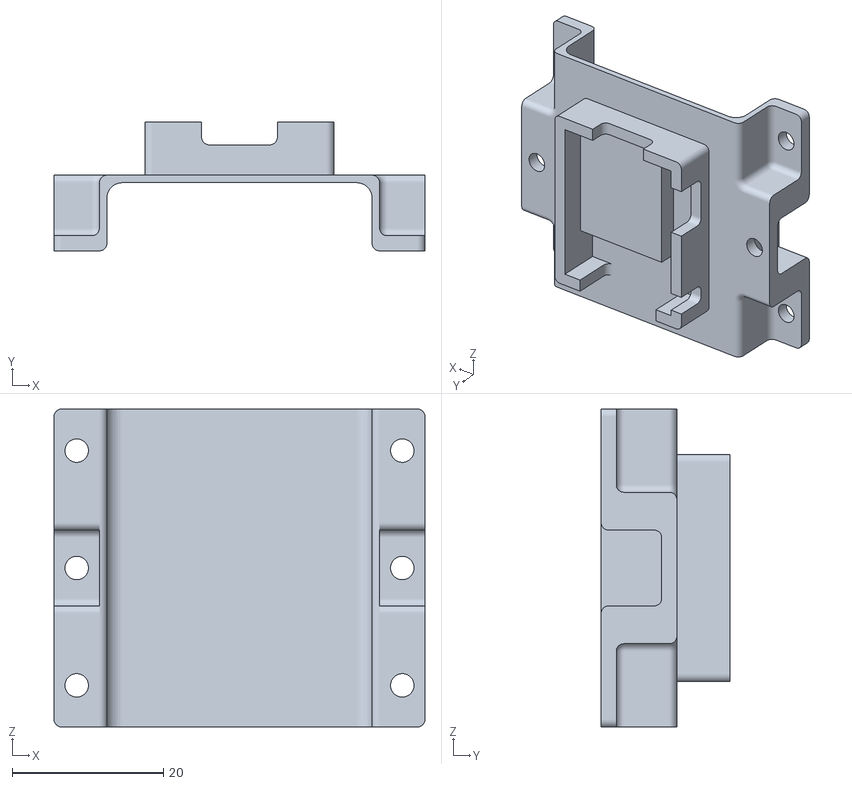
[picture p283: CAD file, 2024-06-07]
control_glove/3d/in_cat/in_3d/vo_pin_v2.STL
49.0 x 17.0 x 42.0
