TNH510/5_DOF_Robot_Arm/control_glove/3d/truc_khuy_tay_6mm.SLDPRT

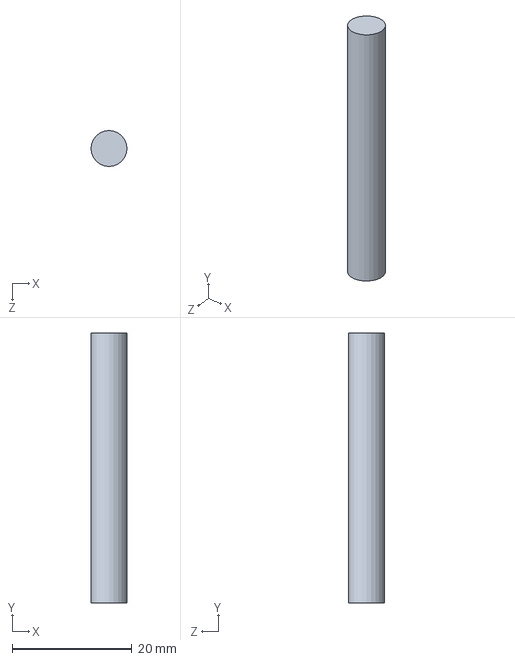
[picture p284: CAD file, 2024-06-29]
control_glove/3d/truc_khuy_tay_6mm.SLDPRT
6.00 x 45.0 x 6.00 mm
