TNH510/5_DOF_Robot_Arm/control_glove/3d_new_version/cat_mica/mica_3mm/3mm.dxf

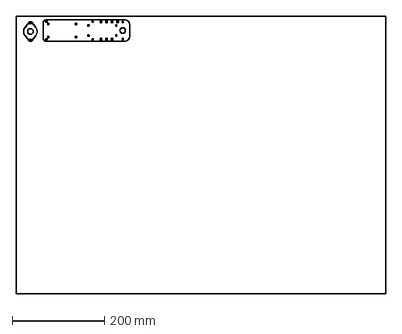
[picture p285: CAD file, 2024-06-28]
control_glove/3d_new_version/cat_mica/mica_3mm/3mm.dxf
800.0 x 600.0 mm
