TNH510/5_DOF_Robot_Arm/control_glove/3d_new_version/cat_mica/thanh_cang_tay.SLDPRT

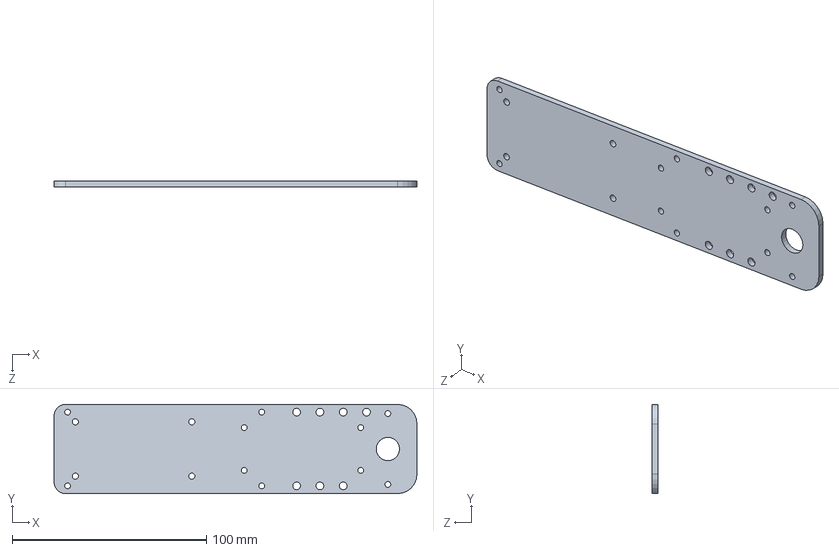
[picture p287: CAD file, 2024-06-28]
control_glove/3d_new_version/cat_mica/thanh_cang_tay.SLDPRT
187.0 x 46.0 x 3.00 mm
