TNH510/5_DOF_Robot_Arm/control_glove/3d_new_version/in_3d/60%/mieng_dem_canh_tay - 2.SLDPRT

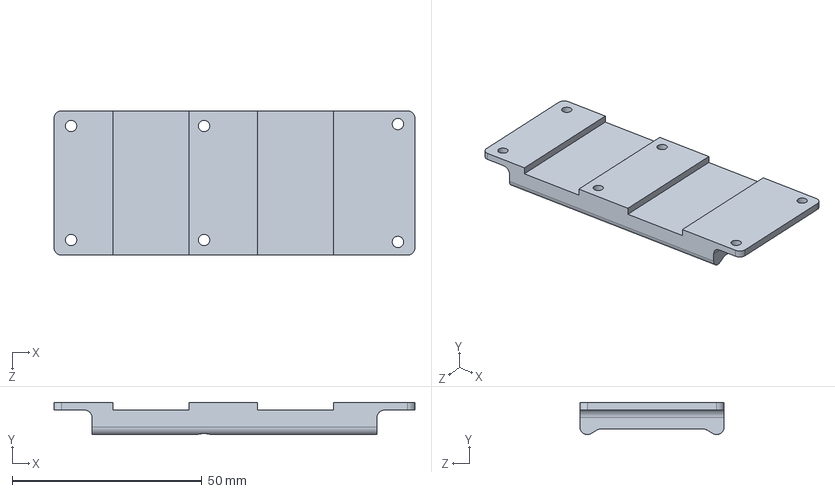
[picture p288: CAD file, 2024-06-21]
control_glove/3d_new_version/in_3d/60%/mieng_dem_canh_tay - 2.SLDPRT
95.0 x 8.47 x 38.0 mm
