TNH510/5_DOF_Robot_Arm/control_glove/3d_new_version/in_3d/90%/banh_rang_2.STL

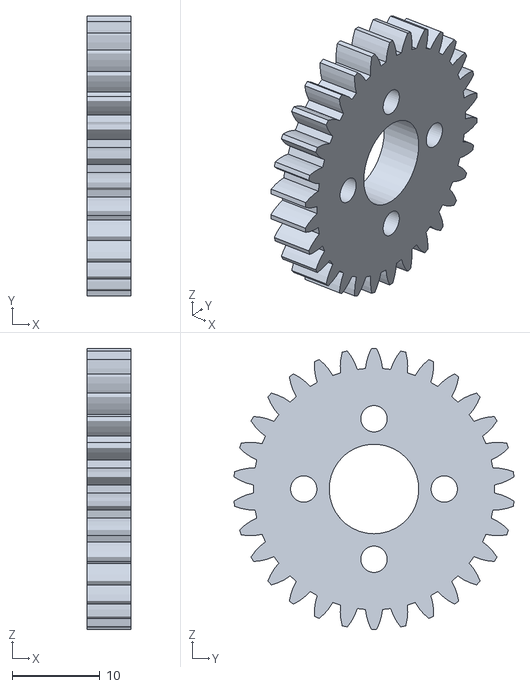
[picture p289: CAD file, 2024-06-28]
control_glove/3d_new_version/in_3d/90%/banh_rang_2.STL
5.00 x 31.9 x 32.0
