TNH510/5_DOF_Robot_Arm/control_glove/3d_new_version/in_3d/lan_2/vo_tay_cam_2.SLDPRT

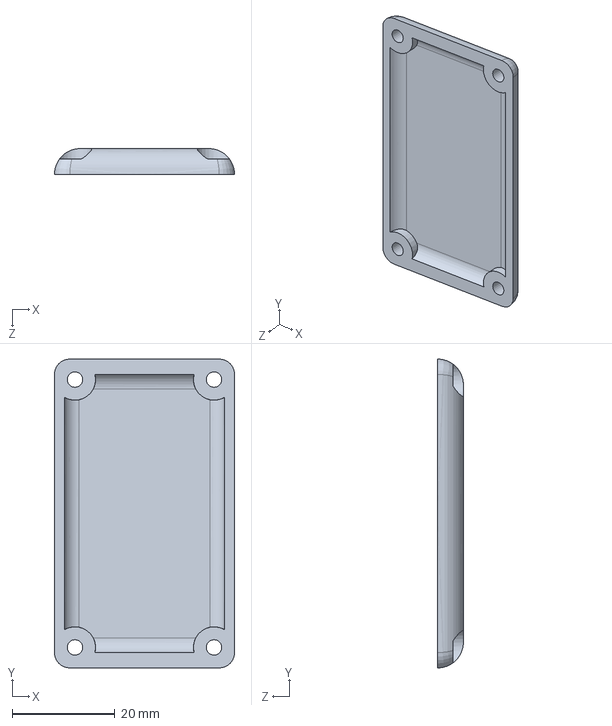
[picture p290: CAD file, 2024-06-28]
control_glove/3d_new_version/in_3d/lan_2/vo_tay_cam_2.SLDPRT
35.0 x 60.0 x 5.00 mm
