TNH510/5_DOF_Robot_Arm/control_glove/ban_ve_dien/control_glove_v0.1_dung_ki_hieu.dxf

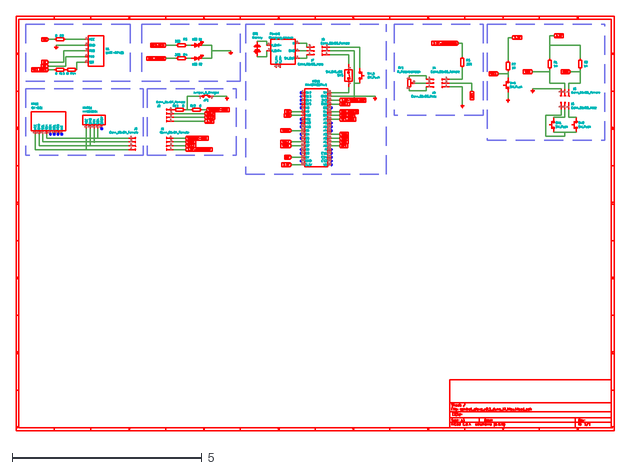
[picture p291: CAD file, 2024-06-28]
control_glove/ban_ve_dien/control_glove_v0.1_dung_ki_hieu.dxf
15.7 x 10.9
