TNH510/5_DOF_Robot_Arm/control_glove/pcb/control_glove_v0.1/kicad_lib/MPU6050.stp

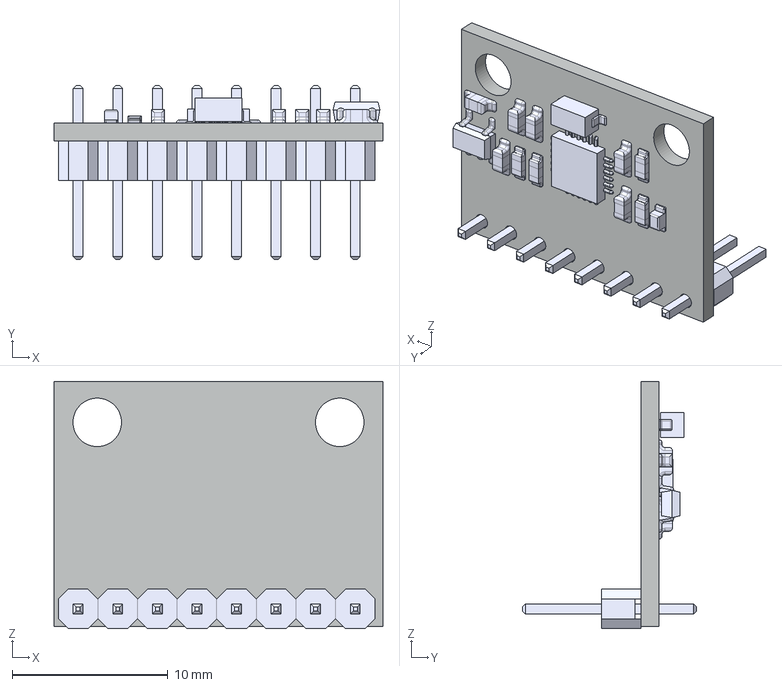
[picture p292: CAD file, 2024-05-06]
control_glove/pcb/control_glove_v0.1/kicad_lib/MPU6050.stp
21.1 x 11.2 x 15.9 mm
