TNH510/5_DOF_Robot_Arm/drawing/ban_ve_3d/K1/[K1]Vòng_Cản.stp.SLDPRT

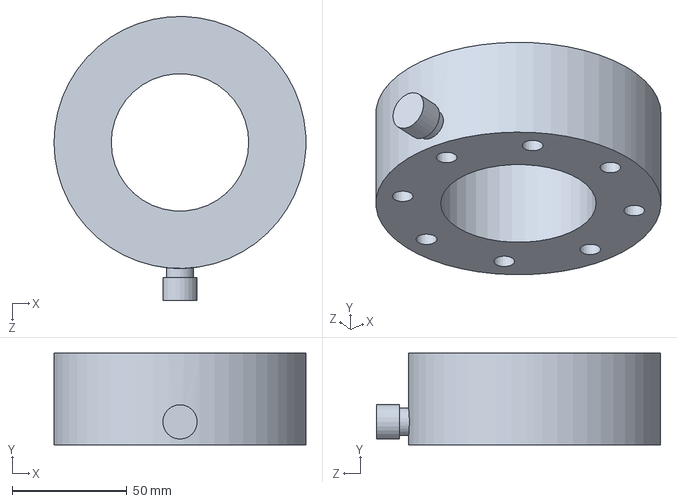
[picture p293: CAD file, 2024-07-07]
drawing/ban_ve_3d/K1/[K1]Vòng_Cản.stp.SLDPRT
110.0 x 40.0 x 124.0 mm
