TNH510/5_DOF_Robot_Arm/drawing/HOÀN CHỈNH/BẢN VẼ ĐIỆN/BĂNG TẢI/BĂNG TẢI.dxf

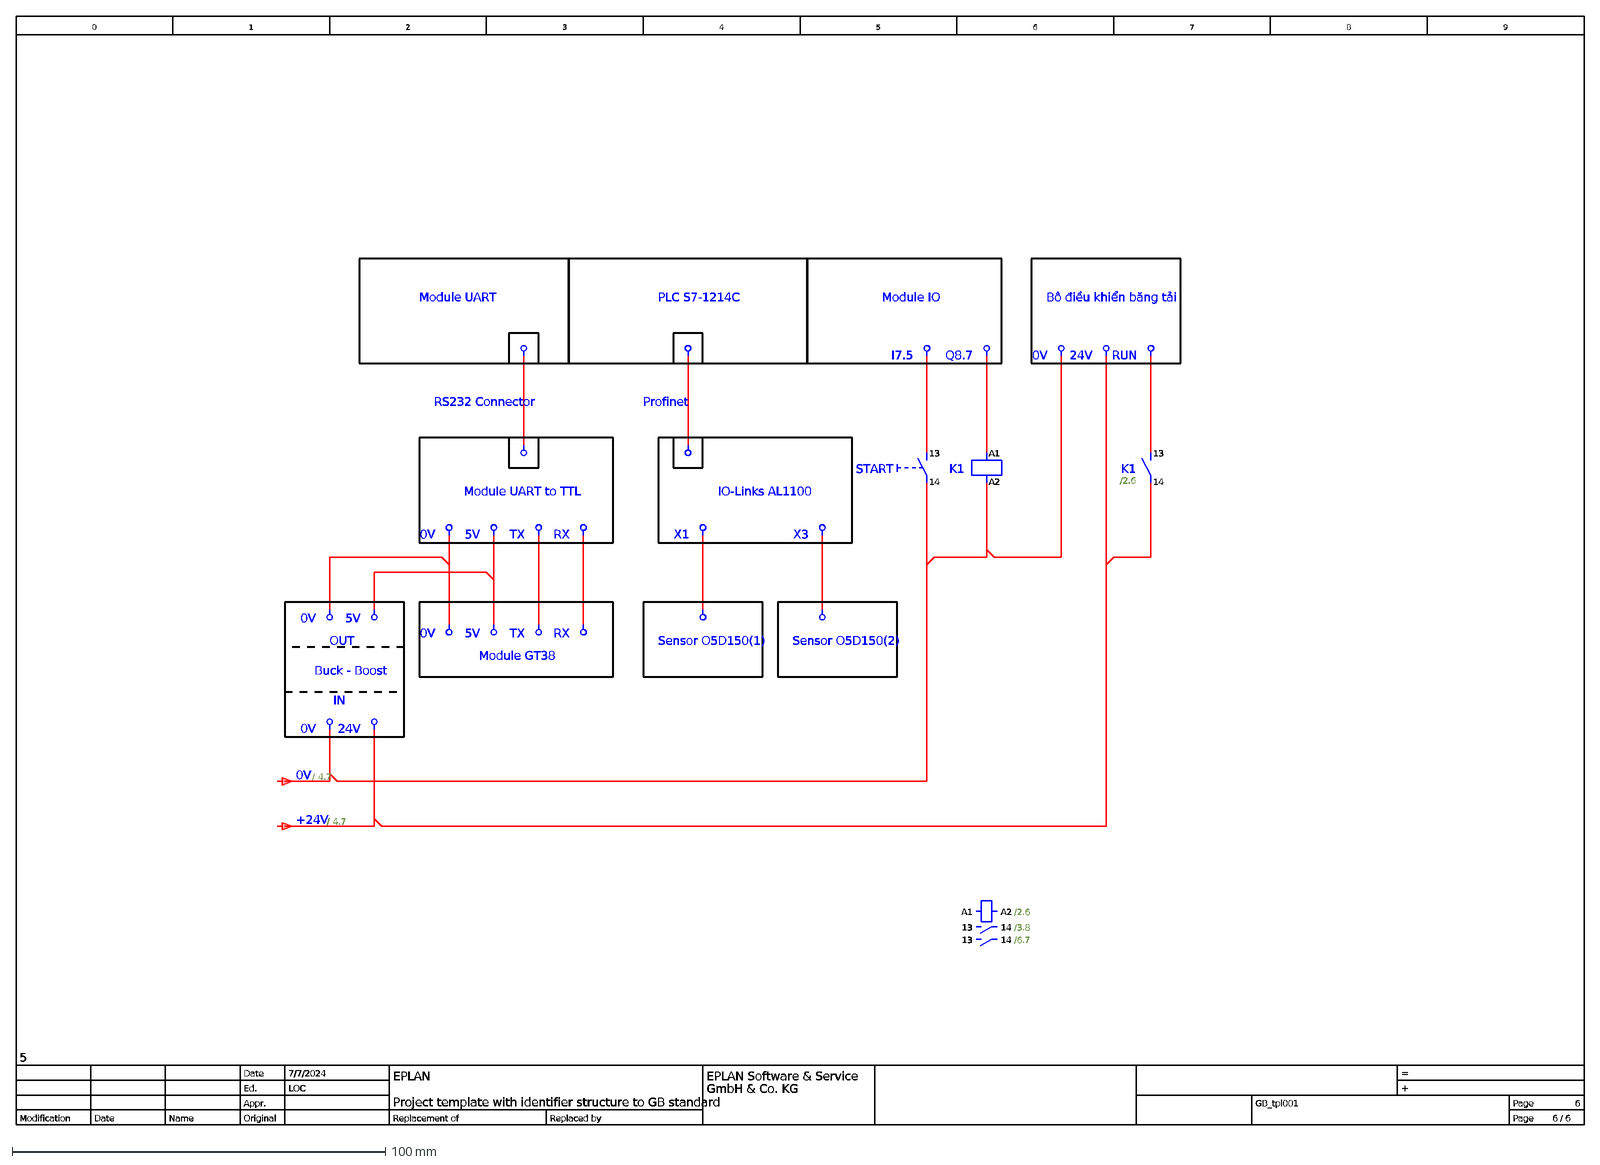
[picture p294: CAD file, 2024-08-18]
drawing/HOÀN CHỈNH/BẢN VẼ ĐIỆN/BĂNG TẢI/BĂNG TẢI.dxf
Project template with identifier structure to GB standard
5
GB_tpl001
EPLAN
LOC
1
0
7
6
8
9
3
4
7/7/2024
EPLAN Software & Service
2
GmbH & Co. KG
Page
Ed.
Original
+
Date
Replaced by
Modification
Appr.
Replacement of
=
Name
/
Module UART
PLC S7-1214C
Module IO
IO-Links AL1100
Module UART to TTL
Profinet
RS232 Connector
Module GT38
Sensor O5D150(1)
Sensor O5D150(2)
Bộ điều khiển băng tải
Buck - Boost
OUT
IN
0V
5V
TX
RX
X1
X3
Q8.7
24V
RUN
13
14
K1
/2.6
A1
A2
/3.8
/6.7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
