TNH510/5_DOF_Robot_Arm/drawing/HOÀN CHỈNH/BẢN VẼ ĐIỆN/CÁNH TAY ROBOT/CÁNH TAY ROBOT.dxf

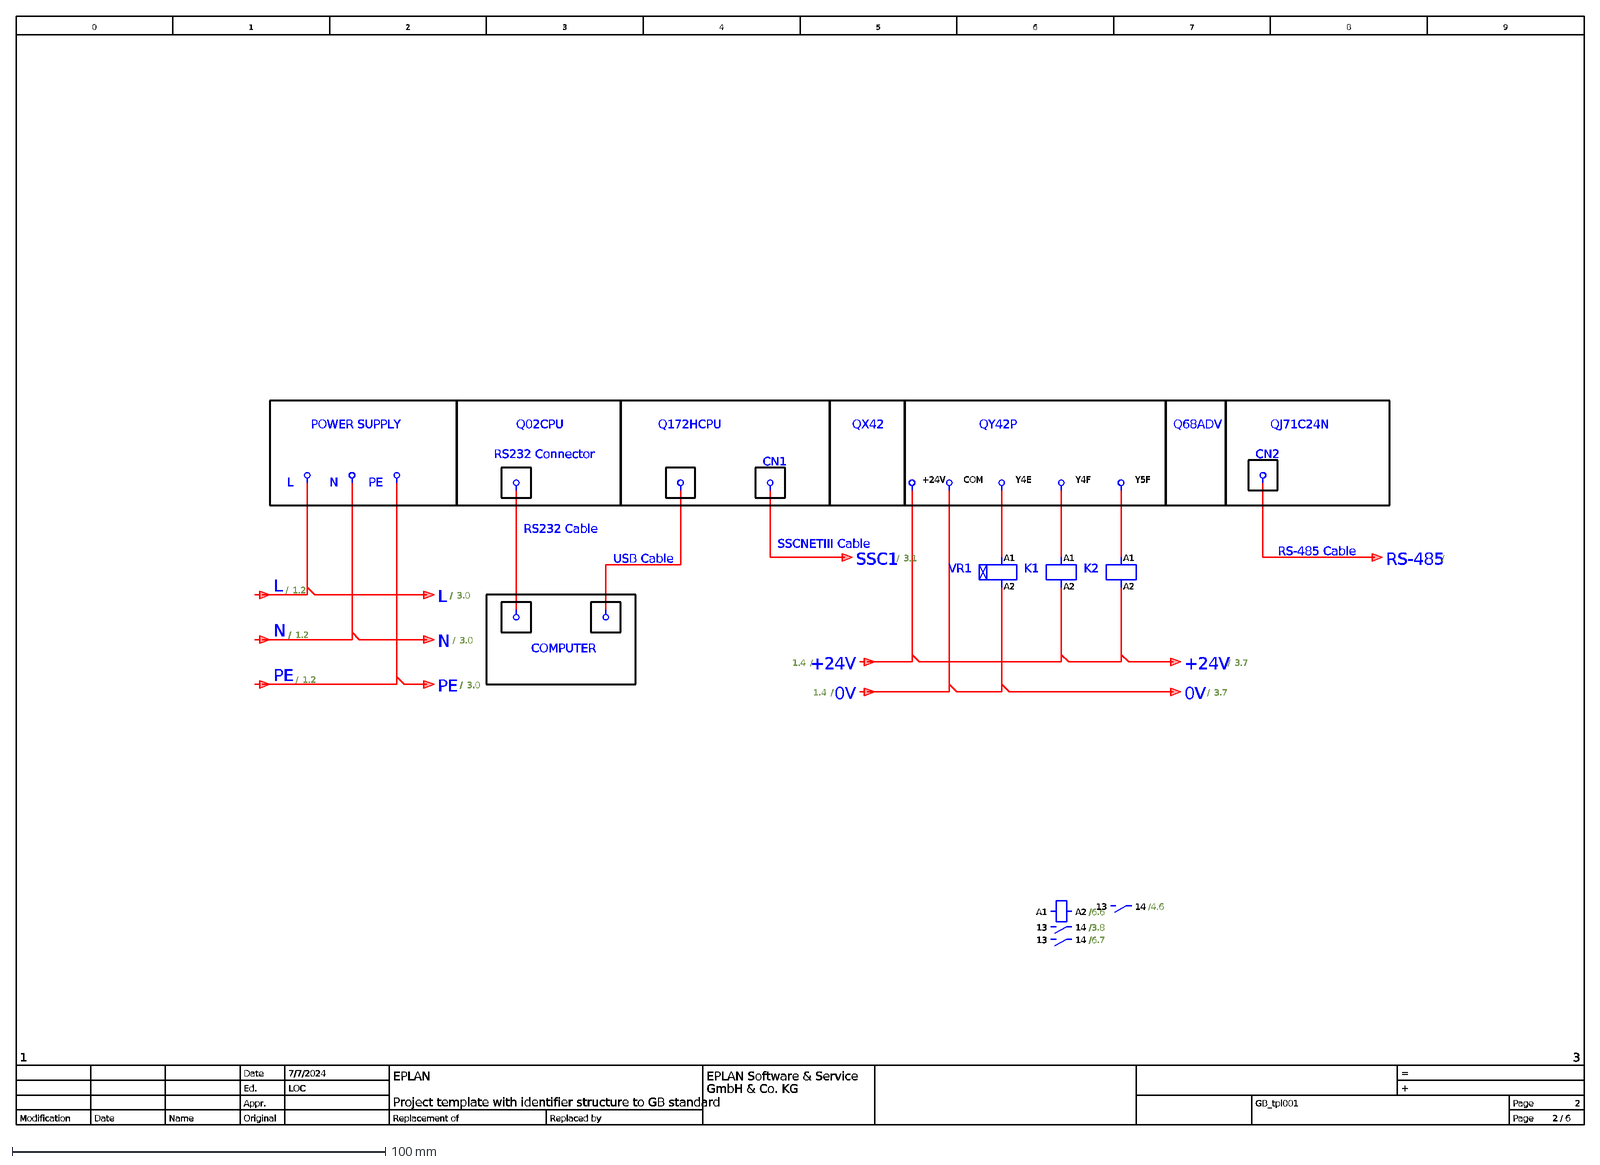
[picture p295: CAD file, 2024-08-18]
drawing/HOÀN CHỈNH/BẢN VẼ ĐIỆN/CÁNH TAY ROBOT/CÁNH TAY ROBOT.dxf
Project template with identifier structure to GB standard
1
GB_tpl001
EPLAN
LOC
0
7
6
8
9
3
4
7/7/2024
EPLAN Software & Service
2
5
GmbH & Co. KG
Page
Ed.
Original
+
Date
Replaced by
Modification
Appr.
Replacement of
=
Name
/
POWER SUPPLY
Q02CPU
Q172HCPU
QX42
QY42P
Q68ADV
QJ71C24N
COMPUTER
RS232 Cable
CN1
RS232 Connector
SSCNETIII Cable
CN2
RS-485 Cable
USB Cable
L
N
PE
+24V
COM
Y4F
Y5F
Y4E
VR1
A2
A1
K1
/6.6
14
13
/3.8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
