TNH510/5_DOF_Robot_Arm/matlab/guide_simulink/Assem1 - Khop_6-1.STL

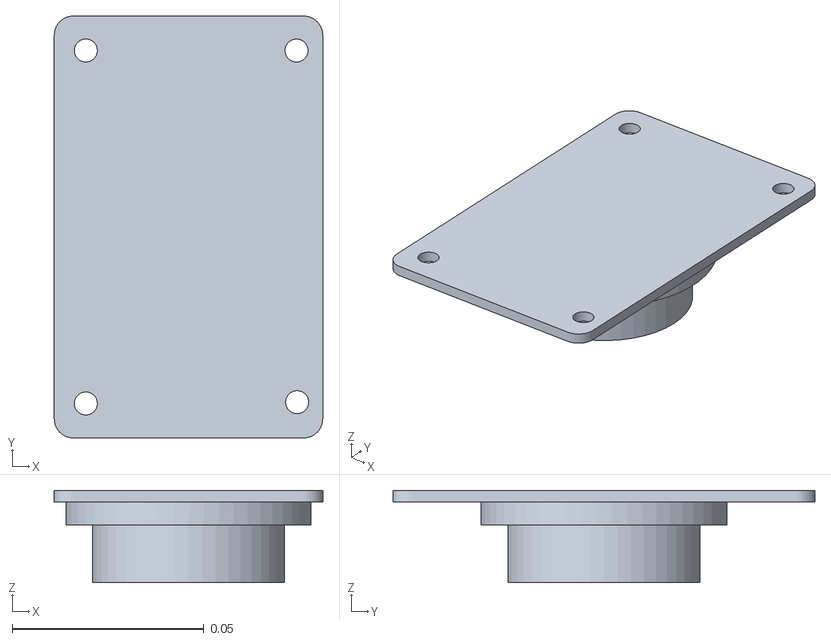
[picture p296: CAD file, 2023-11-08]
matlab/guide_simulink/Assem1 - Khop_6-1.STL
0.07 x 0.11 x 0.024
