TNH510/5_DOF_Robot_Arm/3d/robot_component/Inventor_Convert/[K3[Nắp.stp.SLDPRT

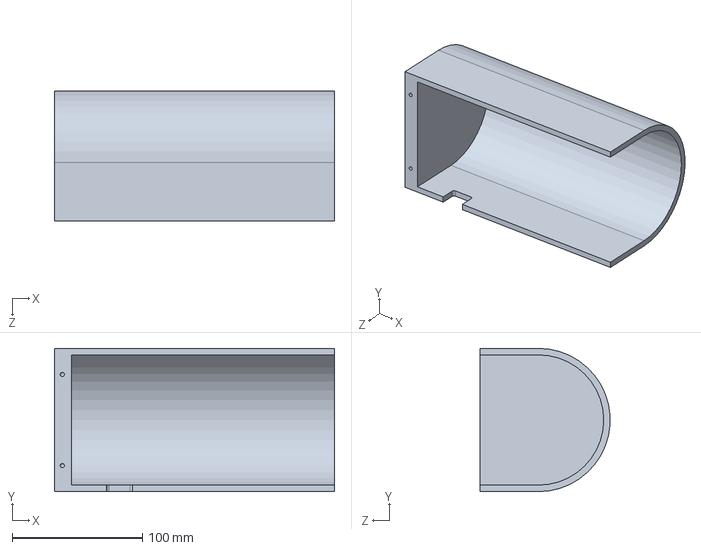
[picture p297: CAD file, 2024-07-07]
3d/robot_component/Inventor_Convert/[K3[Nắp.stp.SLDPRT
215.0 x 110.0 x 99.8 mm
