TNH510/5_DOF_Robot_Arm/3d/robot_component/Khop_2.SLDPRT

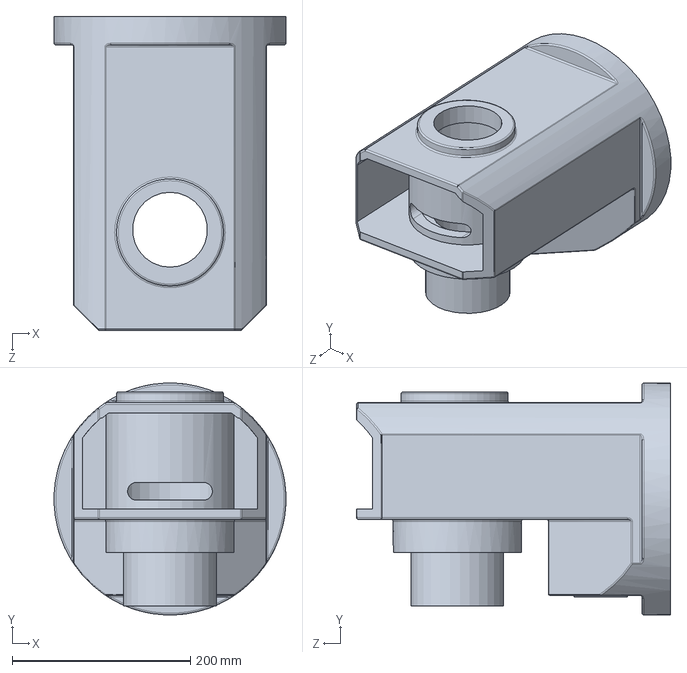
[picture p298: CAD file, 2024-07-06]
3d/robot_component/Khop_2.SLDPRT
260.0 x 259.8 x 352.0 mm
