TNH510/5_DOF_Robot_Arm/3d/robot_gripper/Gripper_Mica/Part5.SLDPRT

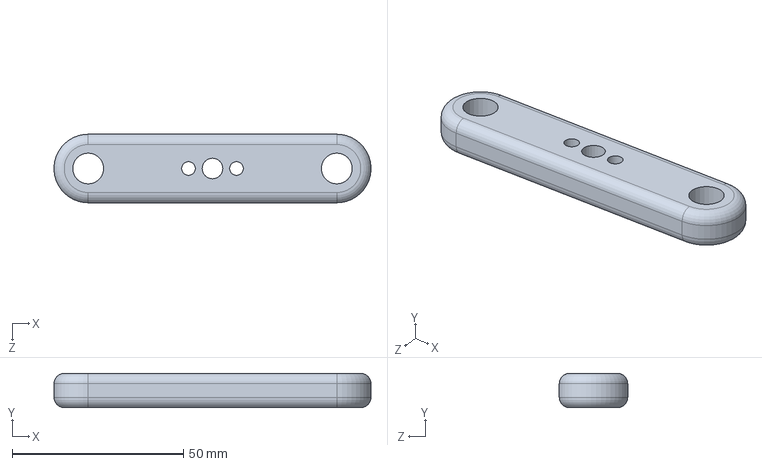
[picture p299: CAD file, 2024-01-08]
3d/robot_gripper/Gripper_Mica/Part5.SLDPRT
92.4 x 10.0 x 20.0 mm
