TNH510/5_DOF_Robot_Arm/3d/robot_gripper/thuc-hien/Gripper_Loc/Gripper_Mica/Mica_component/Part4.DXF

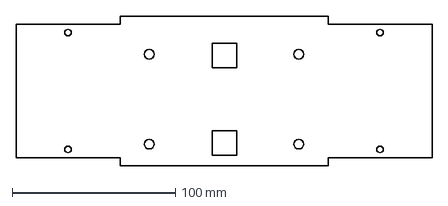
[picture p300: CAD file, 2023-12-29]
3d/robot_gripper/thuc-hien/Gripper_Loc/Gripper_Mica/Mica_component/Part4.DXF
255.0 x 91.6 mm
