TNH510/5_DOF_Robot_Arm/3d/robot_gripper/thuc-hien/Gripper_Loc/Gripper_Mica/Part1.right - p1.SLDPRT

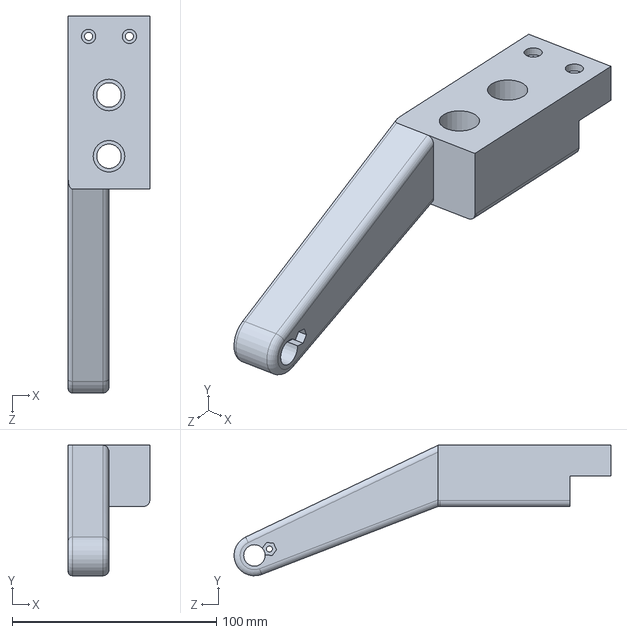
[picture p301: CAD file, 2024-01-04]
3d/robot_gripper/thuc-hien/Gripper_Loc/Gripper_Mica/Part1.right - p1.SLDPRT
40.0 x 64.0 x 184.7 mm
