TNH510/5_DOF_Robot_Arm/3d/robot_gripper/thuc-hien/Gripper_Loc/Print-component/Part1-1.SLDPRT

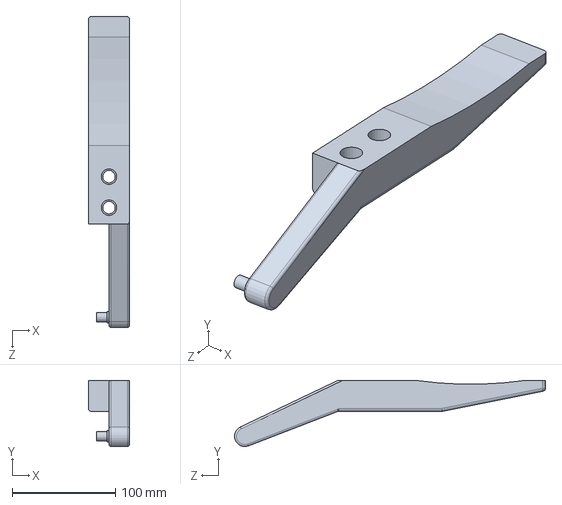
[picture p302: CAD file, 2023-12-29]
3d/robot_gripper/thuc-hien/Gripper_Loc/Print-component/Part1-1.SLDPRT
40.0 x 63.9 x 301.0 mm
