TNH510/5_DOF_Robot_Arm/3d/robot_gripper_new/demo/Part1.SLDPRT

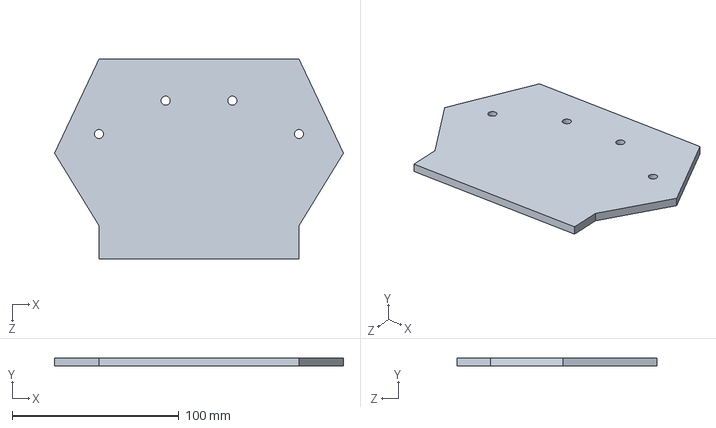
[picture p303: CAD file, 2024-01-22]
3d/robot_gripper_new/demo/Part1.SLDPRT
173.4 x 5.00 x 120.0 mm
