TNH510/5_DOF_Robot_Arm/3d/robot_gripper_new/Part1.SLDPRT

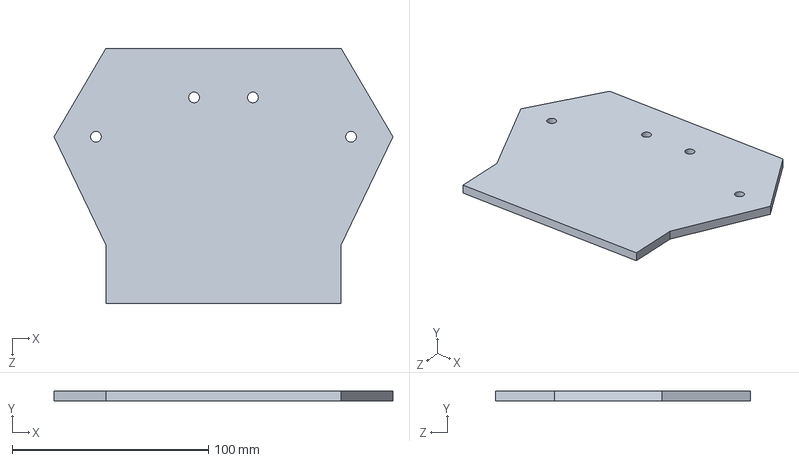
[picture p304: CAD file, 2024-01-22]
3d/robot_gripper_new/Part1.SLDPRT
172.8 x 5.00 x 130.0 mm
