TNH510/5_DOF_Robot_Arm/3d/step_part/K1.STEP

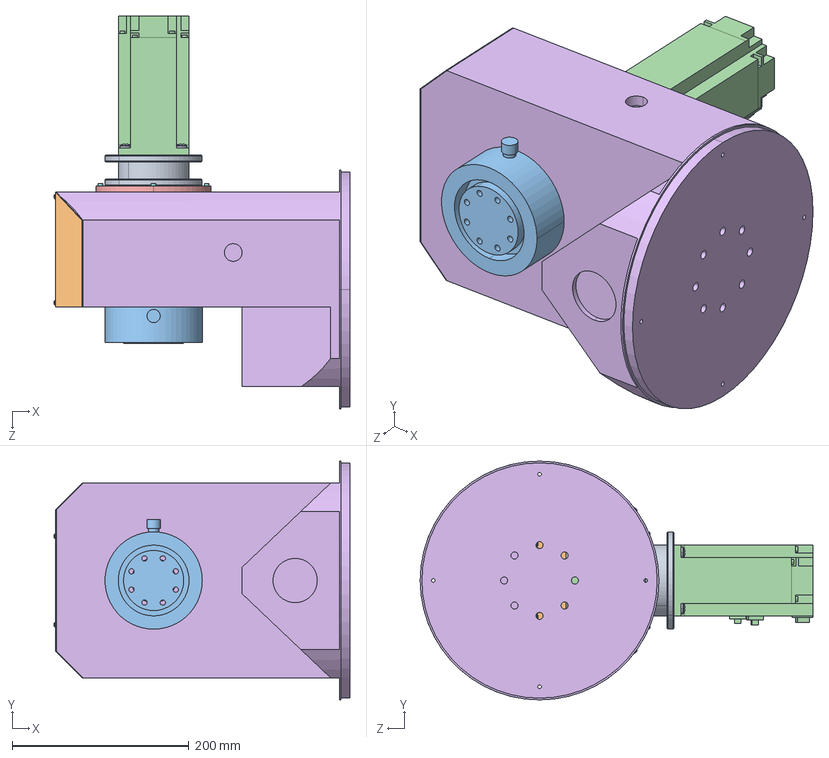
[picture p305: CAD file, 2024-07-05]
3d/step_part/K1.STEP
334.7 x 270.0 x 444.0 mm
[K1]M?t_B獳h.stp
[K1]N?p_ﾐ?y.stp
[K1]V犥g_C?n.stp
[K1]ﾐ?ng_co.stp
[K1]M?t_n?i.stp
[K1]Th滱.oke
socket button head cap screw_am_B18.3.4M - 3 x 0.5 x 3 SBHCS --N x 4
socket head cap screw_am_B18.3.1M - 3 x 0.5 x 20 Hex SHCS -- 20NHX x 4
pan cross head_am_B18.6.7M - M6 x 1.0 x 8 Type I Cross Recessed PHMS --8N x 4
socket head cap screw_am_B18.3.1M - 8 x 1.25 x 20 Hex SHCS -- 20NHX x 9
[K1]Truc
[K1]HopGiamToc
