TNH510/5_DOF_Robot_Arm/3d/stl_part/K5.STL

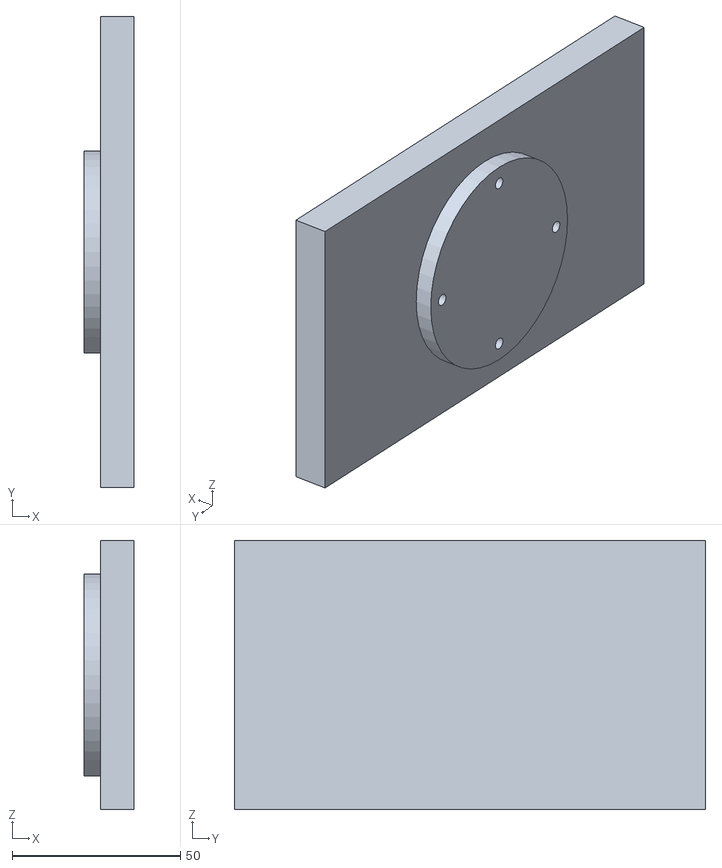
[picture p306: CAD file, 2024-01-22]
3d/stl_part/K5.STL
15.0 x 140.0 x 80.0
