TNH510/5_DOF_Robot_Arm/control_glove/3d/in_cat/cat_mica/file_gui/thanh_cang_tay_3mm.dxf

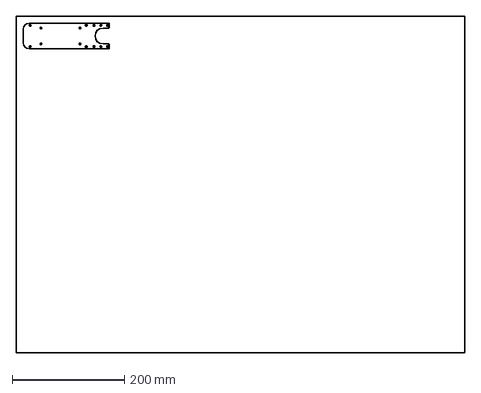
[picture p307: CAD file, 2024-05-24]
control_glove/3d/in_cat/cat_mica/file_gui/thanh_cang_tay_3mm.dxf
800.0 x 600.0 mm
