TNH510/5_DOF_Robot_Arm/control_glove/3d/in_cat/in_3d/nap_mach_sac_v2.STL

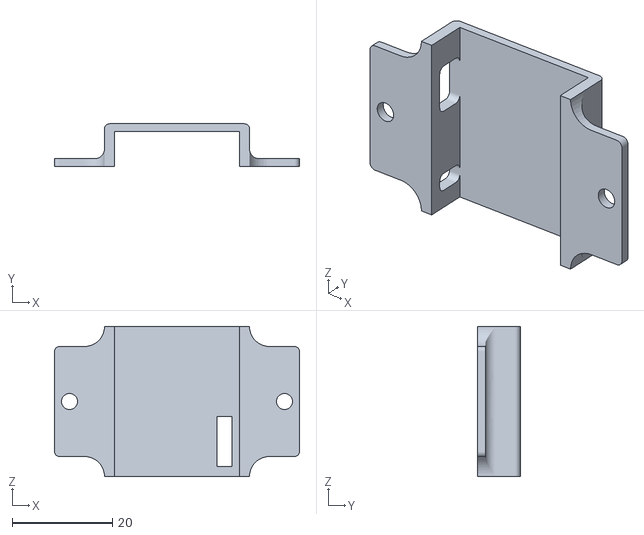
[picture p308: CAD file, 2024-06-07]
control_glove/3d/in_cat/in_3d/nap_mach_sac_v2.STL
49.0 x 8.50 x 30.0
