TNH510/5_DOF_Robot_Arm/control_glove/3d_new_version/cat_mica/khuy_tay.SLDPRT

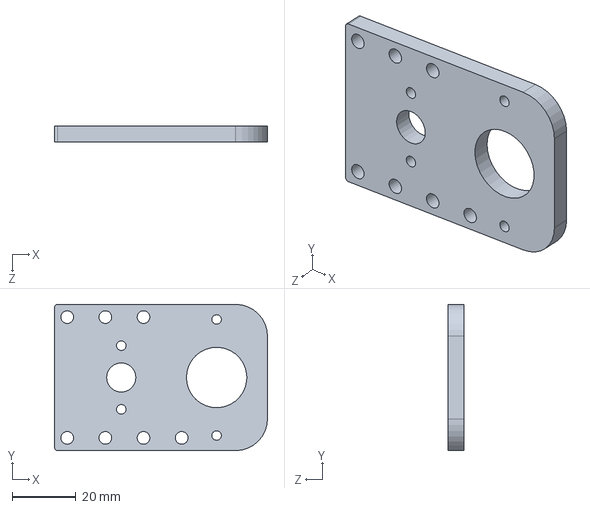
[picture p309: CAD file, 2024-06-28]
control_glove/3d_new_version/cat_mica/khuy_tay.SLDPRT
67.0 x 46.0 x 5.00 mm
