TNH510/5_DOF_Robot_Arm/control_glove/3d_new_version/in_3d/60%/mieng_dem_cang_tay.SLDPRT

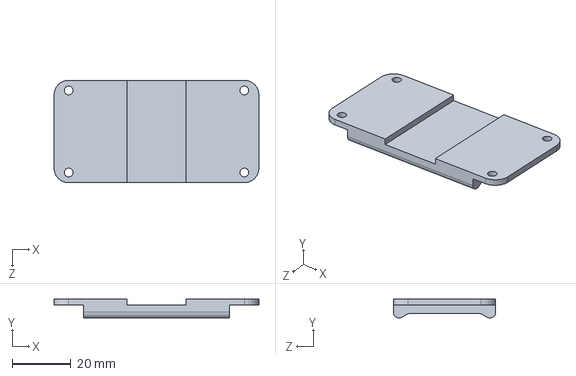
[picture p310: CAD file, 2024-06-21]
control_glove/3d_new_version/in_3d/60%/mieng_dem_cang_tay.SLDPRT
70.0 x 6.46 x 35.0 mm
