TNH510/5_DOF_Robot_Arm/control_glove/3d_new_version/in_3d/lan_2/tay_cam.SLDPRT

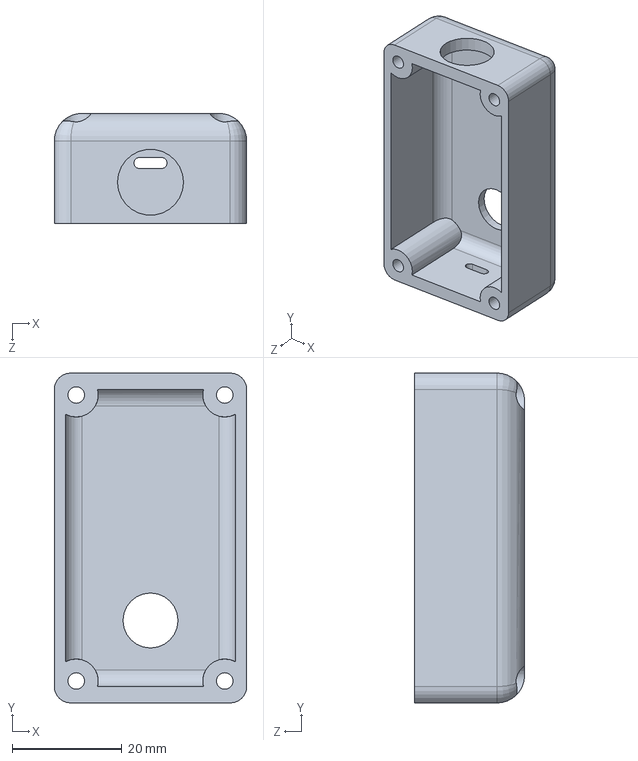
[picture p311: CAD file, 2024-06-28]
control_glove/3d_new_version/in_3d/lan_2/tay_cam.SLDPRT
35.0 x 60.0 x 20.0 mm
