TNH510/5_DOF_Robot_Arm/control_glove/pcb/control_glove_v0.1/kicad_lib/GY-271 HMC5883L Triple 3 Axis Digital Compass.step

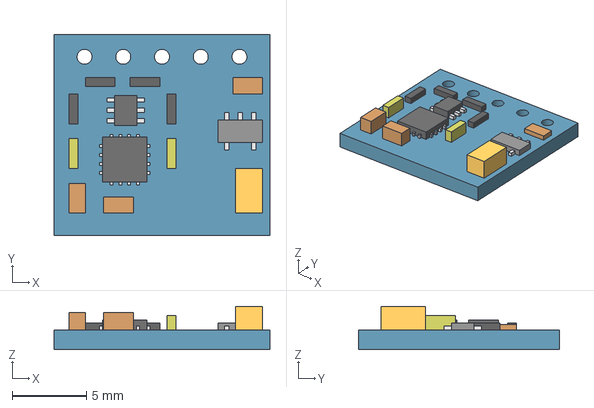
[picture p312: CAD file, 2024-05-06]
control_glove/pcb/control_glove_v0.1/kicad_lib/GY-271 HMC5883L Triple 3 Axis Digital Compass.step
14.5 x 13.5 x 2.90 mm
