TNH510/5_DOF_Robot_Arm/drawing/ban_ve_3d/K0/[K0]Ốp_thân.stp.SLDPRT

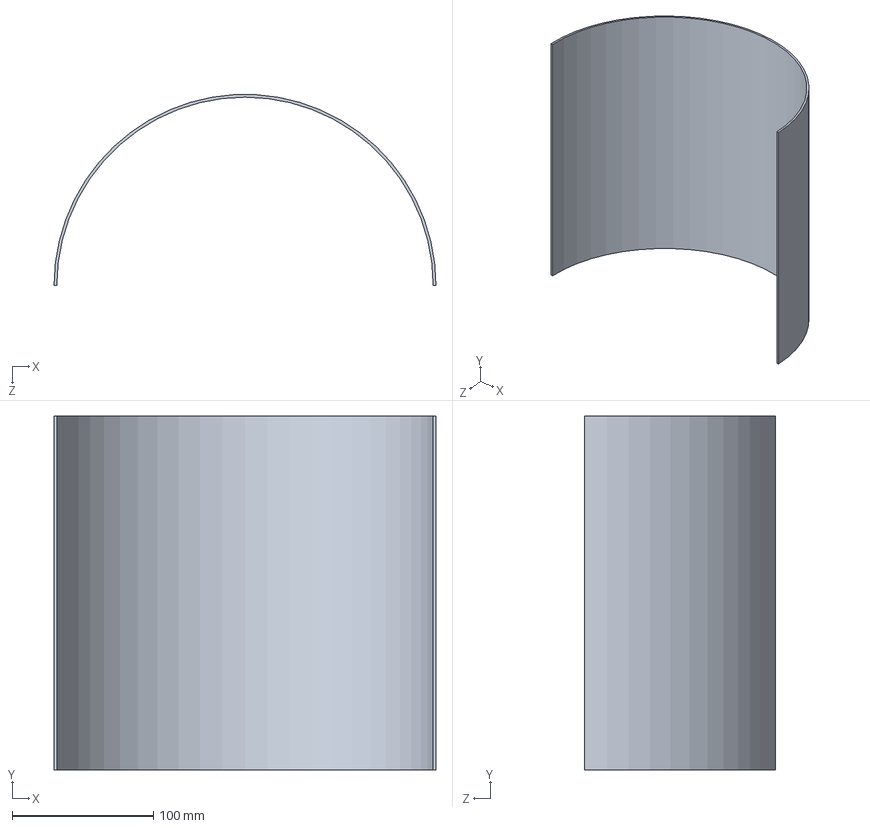
[picture p313: CAD file, 2024-07-07]
drawing/ban_ve_3d/K0/[K0]Ốp_thân.stp.SLDPRT
270.0 x 250.0 x 134.8 mm
