TNH510/5_DOF_Robot_Arm/drawing/ban_ve_3d/khau_2/[K2]Thân_3D.SLDPRT

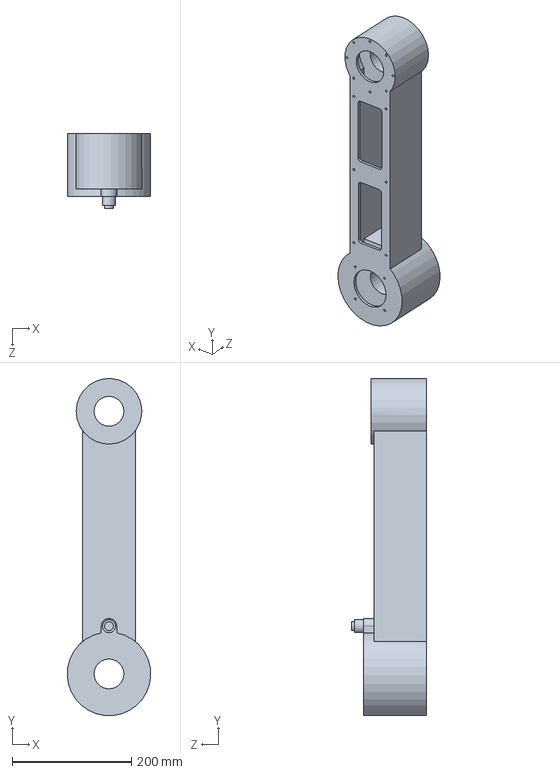
[picture p314: CAD file, 2024-01-04]
drawing/ban_ve_3d/khau_2/[K2]Thân_3D.SLDPRT
139.9 x 564.5 x 126.0 mm
