TNH510/5_DOF_Robot_Arm/drawing/ban_ve_dien/2.dxf

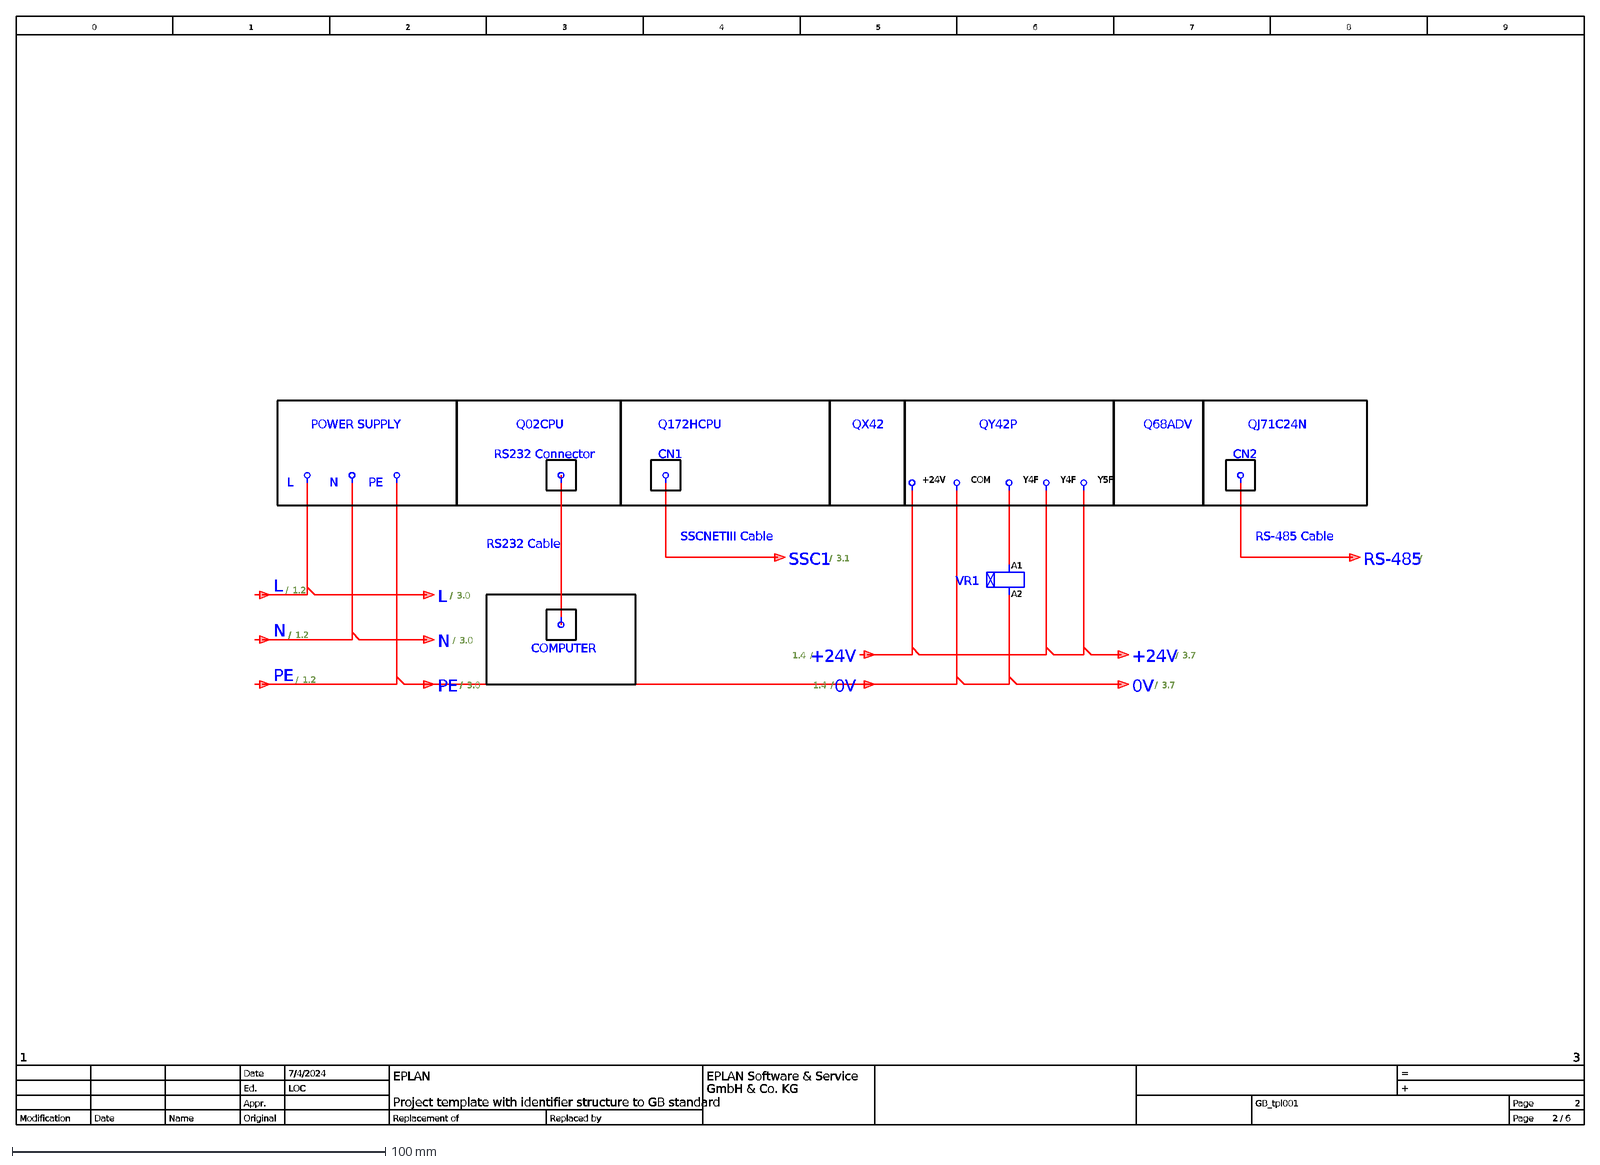
[picture p315: CAD file, 2024-07-05]
drawing/ban_ve_dien/2.dxf
Project template with identifier structure to GB standard
1
GB_tpl001
EPLAN
LOC
0
7
6
8
9
3
4
7/4/2024
EPLAN Software & Service
2
5
GmbH & Co. KG
Page
Ed.
Original
+
Date
Replaced by
Modification
Appr.
Replacement of
=
Name
/
POWER SUPPLY
Q02CPU
Q172HCPU
QX42
QY42P
Q68ADV
QJ71C24N
COMPUTER
RS232 Cable
CN1
RS232 Connector
SSCNETIII Cable
CN2
RS-485 Cable
L
N
PE
+24V
COM
Y4F
Y5F
A2
A1
VR1
1.2
3.0
SSC1
3.1
1.4
0V
3.7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
