TNH510/5_DOF_Robot_Arm/matlab/guide_simulink/Assem1 - Khop_1-1.STL

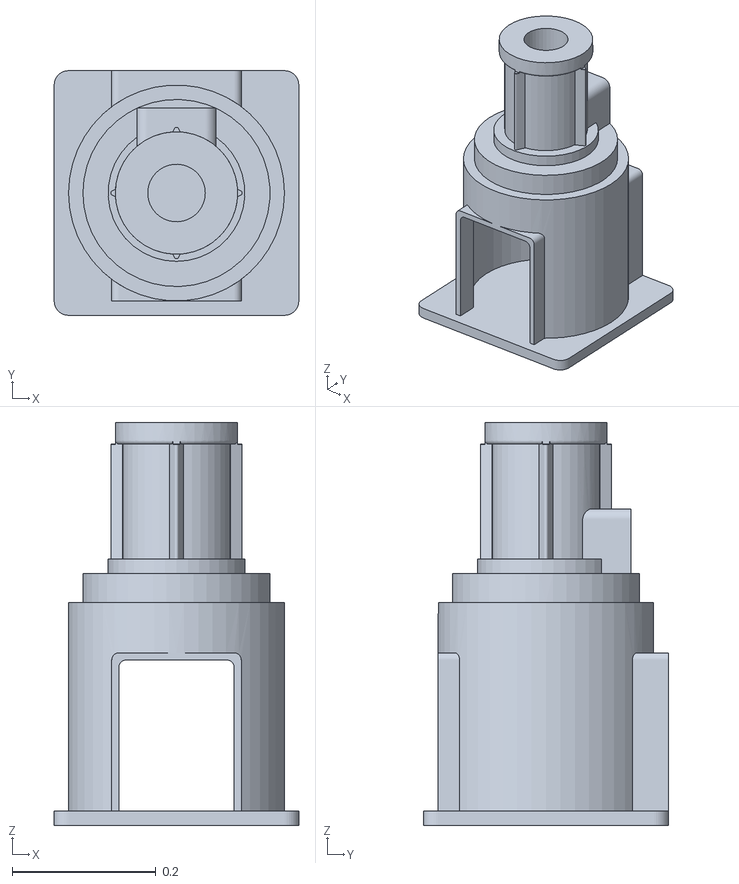
[picture p316: CAD file, 2023-11-08]
matlab/guide_simulink/Assem1 - Khop_1-1.STL
0.34 x 0.34 x 0.56
