TNH510/5_DOF_Robot_Arm/3d/robot_component/Inventor_Convert/[K3]Nắp_Đỡ DC.stp.SLDPRT

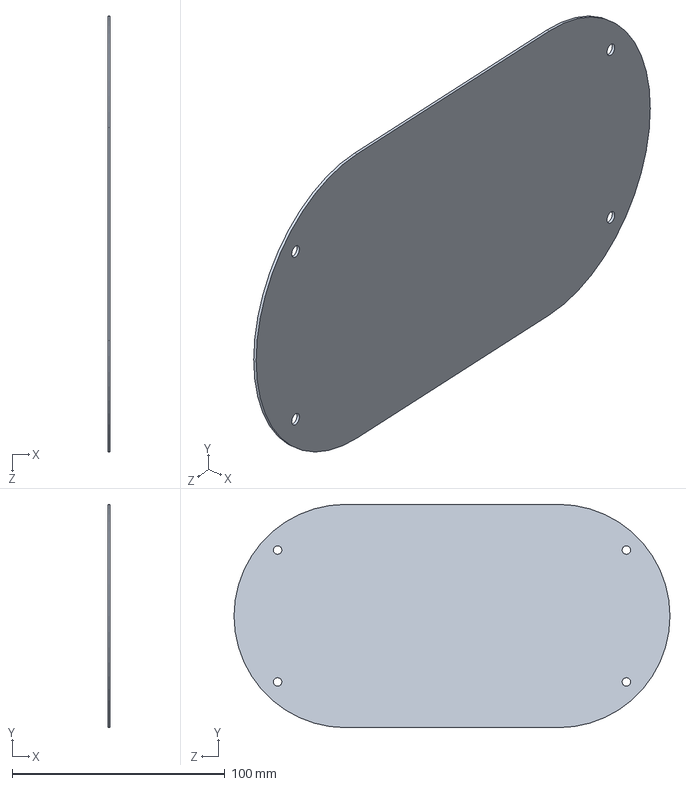
[picture p317: CAD file, 2024-07-07]
3d/robot_component/Inventor_Convert/[K3]Nắp_Đỡ DC.stp.SLDPRT
1.00 x 105.0 x 205.0 mm
