TNH510/5_DOF_Robot_Arm/3d/robot_component/Khop_4.SLDPRT

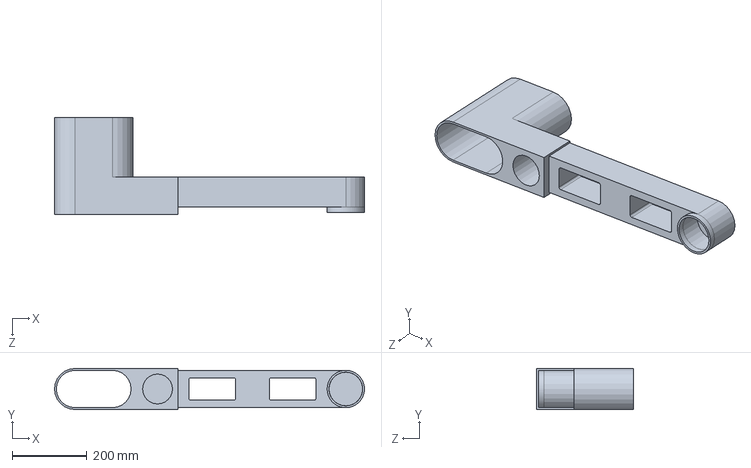
[picture p318: CAD file, 2024-07-06]
3d/robot_component/Khop_4.SLDPRT
830.0 x 110.0 x 260.0 mm
