TNH510/5_DOF_Robot_Arm/3d/robot_gripper/Gripper_Mica/Part1.1-print.SLDPRT

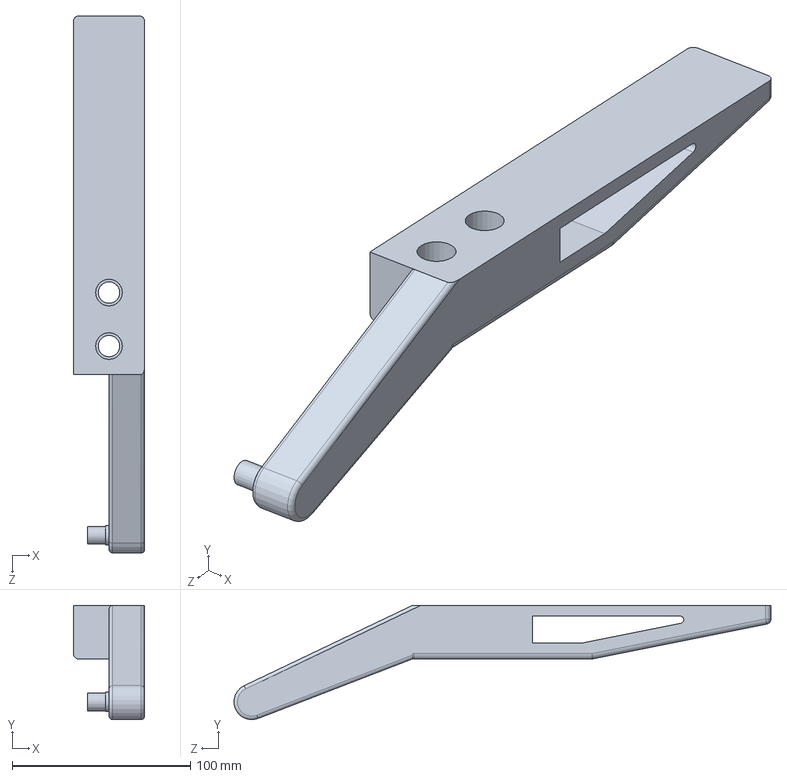
[picture p319: CAD file, 2023-11-30]
3d/robot_gripper/Gripper_Mica/Part1.1-print.SLDPRT
40.0 x 63.9 x 301.0 mm
