TNH510/5_DOF_Robot_Arm/3d/robot_gripper/thuc-hien/Gripper_Loc/Gripper_Mica/Part4-3.SLDPRT

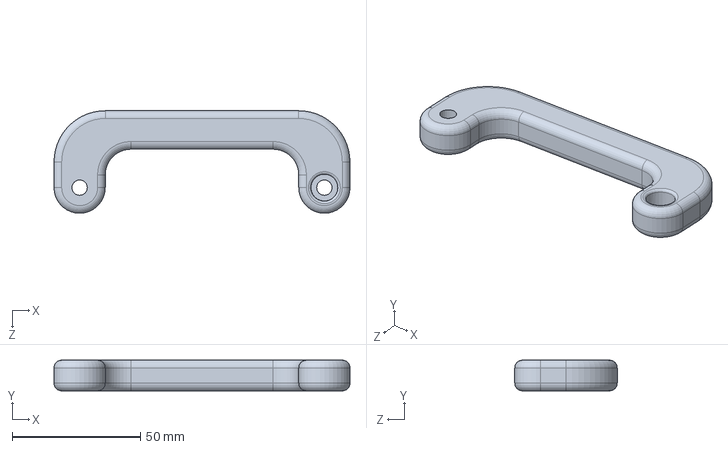
[picture p320: CAD file, 2024-01-04]
3d/robot_gripper/thuc-hien/Gripper_Loc/Gripper_Mica/Part4-3.SLDPRT
115.5 x 12.0 x 40.0 mm
