TNH510/5_DOF_Robot_Arm/3d/robot_gripper_new/demo/Part4.SLDPRT

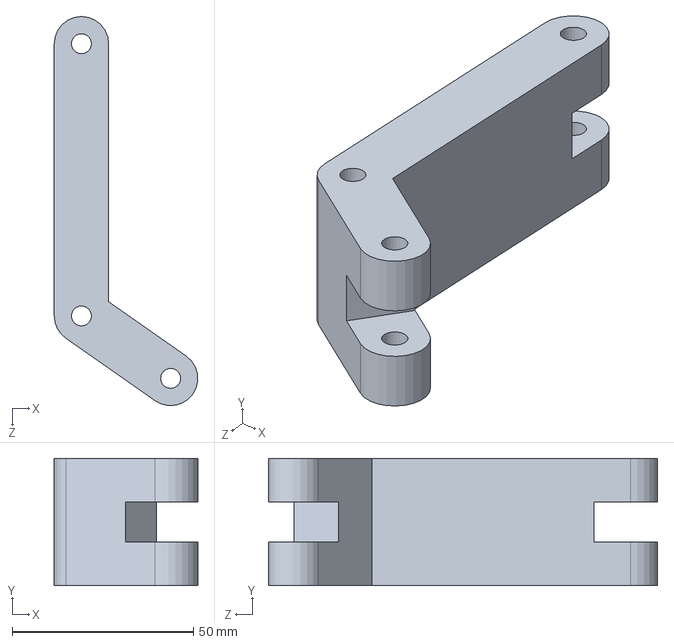
[picture p321: CAD file, 2024-01-22]
3d/robot_gripper_new/demo/Part4.SLDPRT
39.5 x 35.0 x 107.2 mm
