TNH510/5_DOF_Robot_Arm/3d/robot_gripper_new/Part8.SLDPRT

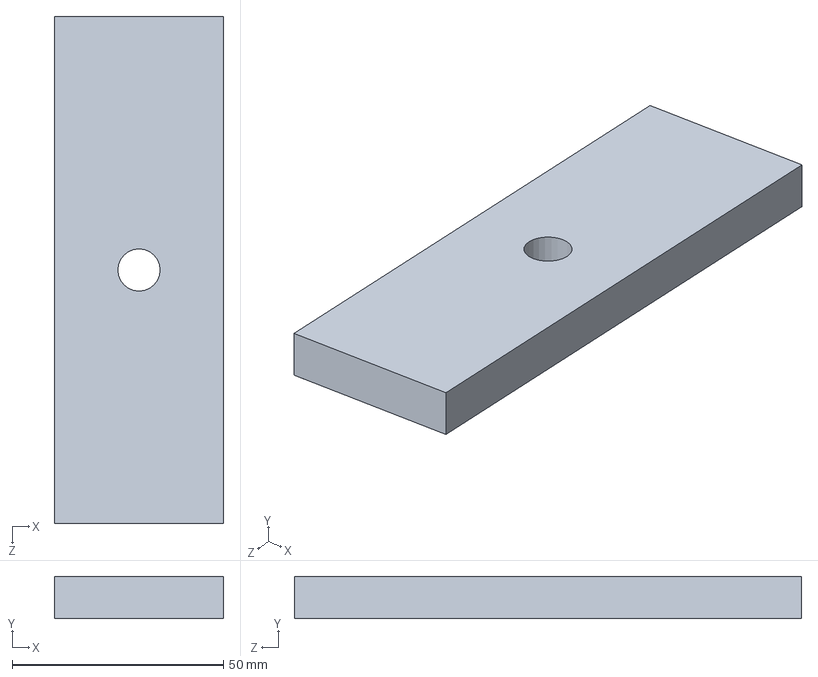
[picture p322: CAD file, 2024-01-22]
3d/robot_gripper_new/Part8.SLDPRT
40.0 x 10.0 x 120.0 mm
