TNH510/5_DOF_Robot_Arm/3d/robot_stl/robot - [KHAU-----3]-1.STL

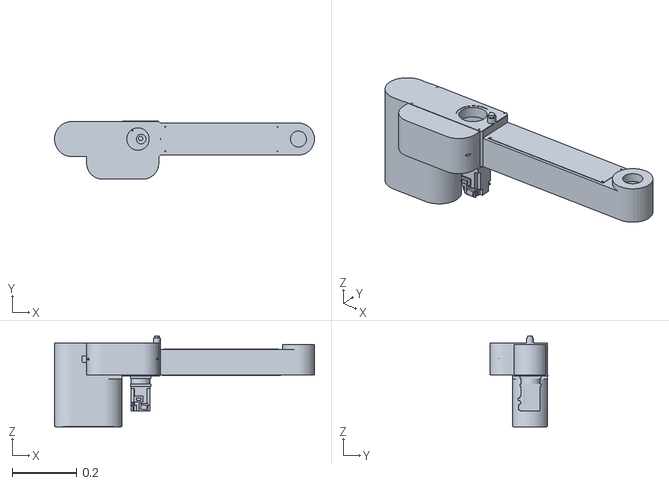
[picture p323: CAD file, 2024-01-22]
3d/robot_stl/robot - [KHAU-----3]-1.STL
0.81 x 0.182 x 0.283
