TNH510/5_DOF_Robot_Arm/control_glove/3d/in_cat/in_3d/mieng_dem_canh_tay - 2.STL

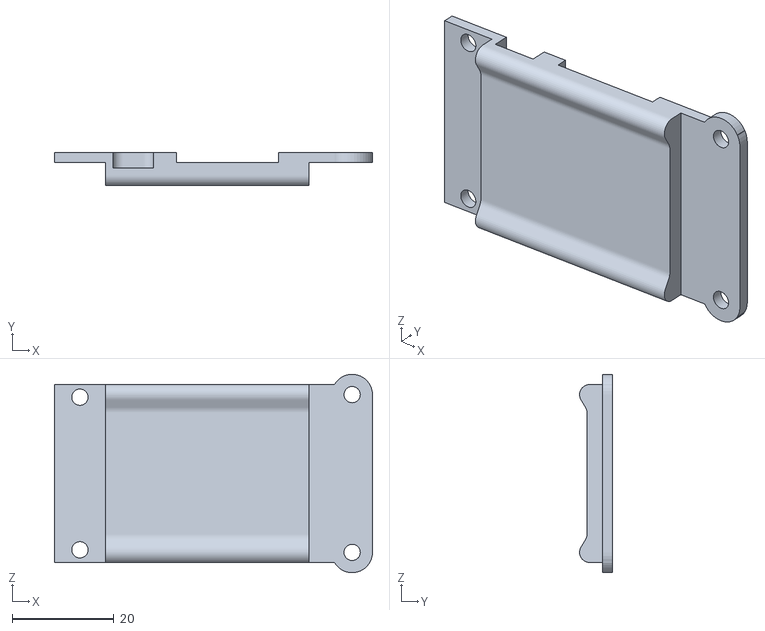
[picture p324: CAD file, 2024-05-24]
control_glove/3d/in_cat/in_3d/mieng_dem_canh_tay - 2.STL
62.5 x 6.46 x 39.0
