TNH510/5_DOF_Robot_Arm/control_glove/3d_new_version/in_3d/lan_2/noi_cang_tay.SLDPRT

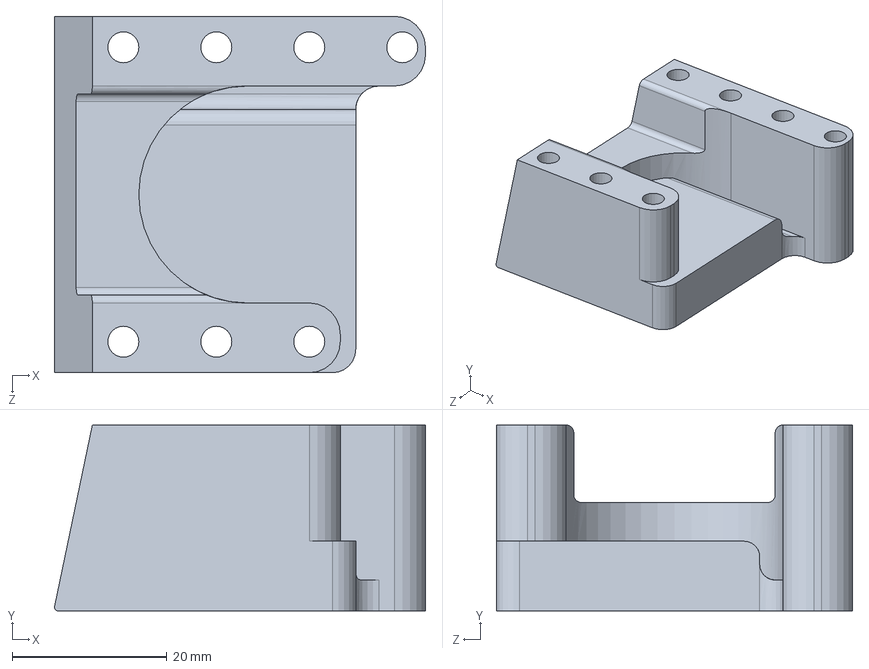
[picture p326: CAD file, 2024-06-21]
control_glove/3d_new_version/in_3d/lan_2/noi_cang_tay.SLDPRT
47.9 x 24.0 x 46.0 mm
