TNH510/5_DOF_Robot_Arm/drawing/ban_ve_3d/K0/[K1]Động_cơ.stp.SLDPRT

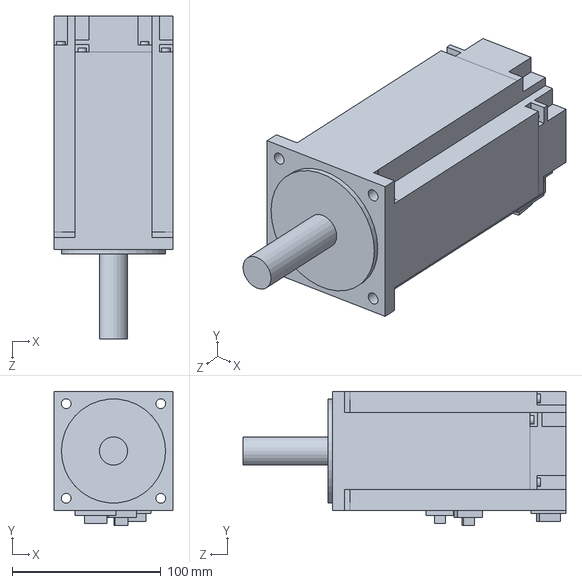
[picture p327: CAD file, 2024-07-07]
drawing/ban_ve_3d/K0/[K1]Động_cơ.stp.SLDPRT
80.0 x 90.1 x 217.0 mm
