TNH510/5_DOF_Robot_Arm/(list of files, cad)

Other CAD files:
drawing/ban_ve_3d/khau_2/[K2]Assembly.SLDASM
drawing/ban_ve_lap/temp/[K2]Assembly.DWG
control_glove/2d/solid_cad_files/canh_tay_cang_tay_asm.DWG
control_glove/2d/solid_cad_files/phan_canh_tay_asm.DWG
control_glove/2d/solid_cad_files/tay_cam_asm.DWG
3d/robot_gripper/thuc-hien/Gripper_Loc/Assem1_mica.DWG
3d/robot_gripper/thuc-hien/Gripper_Loc/Gripper_Mica/Printed_3d/Part1.left - p1 - x1 .STL
control_glove/2d/final_autocad/other/ban_ve_lap_thiet_bi_theo_doi_chuyen_dong.dwg
control_glove/2d/other/robot_cac_so_do.dwg
control_glove/2d/solid_cad_files/thanh_noi_canh_tay.DWG
control_glove/2d/thanh_cang_tay.dwg
docs/mechatronic_project/report/diagram/moment_quan_tinh.dwg
drawing/ban_ve_chi_tiet/ban_ve_cad_done/khau0/[K0]3.dwg
drawing/ban_ve_chi_tiet/hieu/[K1]Vòng cản.dwg
drawing/ban_ve_chi_tiet/khau_0/[K0]4.dwg
drawing/ban_ve_chi_tiet/khau_1/[K1]10.dwg
drawing/ban_ve_chi_tiet/loc/Khau_5/mica-mat-hong.dwg
drawing/ban_ve_chi_tiet/thach/[K2]Khau2_than.dwg
drawing/ban_ve_chi_tiet/thach/khau_2_temp/[K2]Thân_3D_temp.DWG
drawing/ban_ve_chi_tiet/thach/reference/[K2]Thân.dwg
drawing/ban_ve_dien/PLC Q02.dwg
drawing/ban_ve_lap/[K5]-1.dwg
drawing/ban_ve_lap/temp/robot.DWG
drawing/HOÀN CHỈNH/BẢN VẼ CHI TIẾT/CÁNH TAY ROBOT/HCMUTE_0011_001.dwg
drawing/HOÀN CHỈNH/BẢN VẼ CHI TIẾT/THIẾT BỊ THEO DÕI CHUYỂN ĐỘNG/HCMUTE-008.dwg
drawing/HOÀN CHỈNH/BẢN VẼ LẮP/CÁNH TAY ROBOT/A0/khau_0_A0.dwg
drawing/HOÀN CHỈNH/BẢN VẼ LẮP/CÁNH TAY ROBOT/A3/khau_1_A3.dwg
drawing/HOÀN CHỈNH/BẢN VẼ LẮP/THIẾT BỊ THEO DÕI CHUYỂN ĐỘNG/BAN_VE_LAP_THIET_BI_THEO_DOI_CHUYEN_DONG_A3.dwg
drawing/HOÀN CHỈNH/BẢN VẼ ĐIỆN/THIẾT BỊ THEO DÕI CHUYỂN ĐỘNG/THIẾT BỊ THEO DÕI CHUYỂN ĐỘNG.dwg
drawing/so_do_dat_luc/dat_luc.dwg
drawing/tham_khao/3D+2D/Bangve2D/[K3]Tấm căng động cơ 2.dwg
tong_hop_ban_ve/ban_ve_canh_tay_robot/dwg/A3_LAP/THIET_BI_THEO_DOI.dwg
tong_hop_ban_ve/ban_ve_canh_tay_robot/dwg/final/HCMUTE_0011_001.dwg
tong_hop_ban_ve/ban_ve_canh_tay_robot/dwg/hoan_thanh/[K0]1_oke.dwg
tong_hop_ban_ve/ban_ve_canh_tay_robot/dwg/rename/HCMUTE_0008_001_tmp.dwg
tong_hop_ban_ve/ban_ve_thiet_bi_theo_doi_chuyen_dong/dwg/BAN_VE_LAP_THIET_BI_THEO_DOI_CHUYEN_DONG.dwg
3d/robot_gripper/thuc-hien/Gripper_Loc/Gripper_Mica/Printed_3d/Part1.right - p1 - x1.STL
control_glove/2d/final_autocad/other/ban_ve_lap_tay_cam.dwg
control_glove/2d/part_need_convert_2d/thanh_cang_tay.SLDPRT
control_glove/2d/solid_cad_files/noi_khuy_tay.DWG
control_glove/2d/thanh_khuy_tay.dwg
control_glove/3d/in_cat/cat_mica/file_cat/thanh_khuy_tay.dwg
control_glove/3d_new_version/in_3d/90%/banh_rang.SLDPRT
drawing/ban_ve_3d/K1/K1.STEP
drawing/ban_ve_chi_tiet/hieu/[K1]Thân.dwg
drawing/ban_ve_chi_tiet/khau_0/[K0]1_oke.dwg
drawing/ban_ve_chi_tiet/khau_1/[K1]8.dwg
drawing/ban_ve_chi_tiet/loc/Khau_3/[K3]Nap.dwg
drawing/ban_ve_chi_tiet/loc/Khau_5/Part1-left-p1.dwg
drawing/ban_ve_chi_tiet/thach/reference/[K2]Nắp_Thân.dwg
drawing/HOÀN CHỈNH/BẢN VẼ CHI TIẾT/CÁNH TAY ROBOT/HCMUTE_0006_001.dwg
drawing/HOÀN CHỈNH/BẢN VẼ CHI TIẾT/THIẾT BỊ THEO DÕI CHUYỂN ĐỘNG/HCMUTE-002.dwg
drawing/HOÀN CHỈNH/BẢN VẼ LẮP/CÁNH TAY ROBOT/A0/khau_1_A0.dwg
drawing/HOÀN CHỈNH/BẢN VẼ LẮP/CÁNH TAY ROBOT/A3/khau_3_4_5_A3.dwg
drawing/HOÀN CHỈNH/BẢN VẼ LẮP/THIẾT BỊ THEO DÕI CHUYỂN ĐỘNG/BAN_VE_LAP_THIET_BI_THEO_DOI_CHUYEN_DONG_A0.dwg
drawing/tham_khao/3D+2D/Bangve2D/[K3]Tấm bắt_ĐộngCơ.dwg
tong_hop_ban_ve/ban_ve_canh_tay_robot/dwg/final/HCMUTE_0003_001.dwg
tong_hop_ban_ve/ban_ve_canh_tay_robot/dwg/hoan_thanh/[K1]7.dwg
tong_hop_ban_ve/ban_ve_canh_tay_robot/dwg/rename/HCMUTE_0014_001.dwg
3d/robot_gripper/thuc-hien/Gripper_Loc/Gripper_Mica/Printed_3d/Part4-3 - x2.STL
3d/robot_gripper/thuc-hien/Gripper_Loc/Part1.SLDPRT
3d/robot_gripper/thuc-hien/Gripper_Loc/Print-component/Part1.SLDPRT
3d/step_part/[KHAU-----3].STEP
3d/stl_part/K3.STL
control_glove/2d/solid_cad_files/mieng_dem_canh_tay.DWG
control_glove/2d/Template.dwg
control_glove/3d/in_cat/cat_mica/file_cat/khuy_tay.dwg
control_glove/3d_new_version/cat_mica/2d.DWG
drawing/ban_ve_3d/K1/[K1]Động_cơ.stp.SLDPRT
drawing/ban_ve_chi_tiet/hieu/[K0]Tấm ốp.dwg
drawing/ban_ve_chi_tiet/khau_0/[K0]2.dwg
drawing/ban_ve_chi_tiet/khau_1/[K1]9.dwg
drawing/ban_ve_chi_tiet/loc/Khau_5/Part 5.dwg
3d/robot_component/HG_KG73B.stp
3d/robot_component/Inventor_Convert/[K0]Nắp.stp
3d/robot_component/Inventor_Convert/[K0]Nắp.stp.SLDPRT
3d/robot_component/Inventor_Convert/[K0]Nắp_dây_điện.stp
3d/robot_component/Inventor_Convert/[K0]Thân_Trụ.stp
3d/robot_component/Inventor_Convert/[K0]Đế.stp
3d/robot_component/Inventor_Convert/[K0]Ốp_thân.stp
3d/robot_component/Inventor_Convert/[K1]Mặt_Bích.stp
3d/robot_component/Inventor_Convert/[K1]Mặt_nối.stp
3d/robot_component/Inventor_Convert/[K1]Nắp_Đậy.stp
3d/robot_component/Inventor_Convert/[K1]Thân.stp
3d/robot_component/Inventor_Convert/[K1]Vòng_Cản.stp
3d/robot_component/Inventor_Convert/[K1]Động_cơ.stp
3d/robot_component/Inventor_Convert/[K2]Mặt_Bích.stp
3d/robot_component/Inventor_Convert/[K2]Mặt_Bích.stp.SLDPRT
3d/robot_component/Inventor_Convert/[K2]Mặt_Bích_mod.stp
3d/robot_component/Inventor_Convert/[K2]Mặt_Bích_mod.stp.SLDPRT
3d/robot_component/Inventor_Convert/[K2]Nắp.stp
3d/robot_component/Inventor_Convert/[K2]Nắp.stp.SLDPRT
3d/robot_component/Inventor_Convert/[K2]Nắp_Thân.stp
3d/robot_component/Inventor_Convert/[K2]Nắp_che.stp
3d/robot_component/Inventor_Convert/[K2]Thân.stp
3d/robot_component/Inventor_Convert/[K2]Vòng_Cản.stp
3d/robot_component/Inventor_Convert/[K2]Động_cơ.stp
3d/robot_component/Inventor_Convert/[K3[Nắp.stp
3d/robot_component/Inventor_Convert/[K3]Căn_chỉnh_ĐC.stp
3d/robot_component/Inventor_Convert/[K3]Căn_chỉnh_ĐC.stp.SLDPRT
3d/robot_component/Inventor_Convert/[K3]Mặt_Bích.stp
3d/robot_component/Inventor_Convert/[K3]Mặt_Bích.stp.SLDPRT
3d/robot_component/Inventor_Convert/[K3]Nap.stp
3d/robot_component/Inventor_Convert/[K3]Nap.stp.SLDPRT
3d/robot_component/Inventor_Convert/[K3]Nắp_Thân.stp
3d/robot_component/Inventor_Convert/[K3]Nắp_Thân.stp.SLDPRT
3d/robot_component/Inventor_Convert/[K3]Nắp_Thân_22.stp
3d/robot_component/Inventor_Convert/[K3]Nắp_Thân_22.stp.SLDPRT
3d/robot_component/Inventor_Convert/[K3]Nắp_Đầu.stp
3d/robot_component/Inventor_Convert/[K3]Nắp_Đầu.stp.SLDPRT
3d/robot_component/Inventor_Convert/[K3]Nắp_ĐộngCơ.stp
3d/robot_component/Inventor_Convert/[K3]Nắp_ĐộngCơ.stp.SLDPRT
3d/robot_component/Inventor_Convert/[K3]Nắp_Đỡ DC.stp
3d/robot_component/Inventor_Convert/[K3]Ong.stp
3d/robot_component/Inventor_Convert/[K3]Ong.stp.SLDPRT
3d/robot_component/Inventor_Convert/[K3]Thân.stp
3d/robot_component/Inventor_Convert/[K3]Thân.stp.SLDPRT
3d/robot_component/Inventor_Convert/[K3]Động_cơ.stp
3d/robot_component/Inventor_Convert/[K3]Đỡ DC.stp
3d/robot_component/Inventor_Convert/[K3]Đỡ DC.stp.SLDPRT
3d/robot_component/Inventor_Convert/[K3]Ốp.stp
3d/robot_component/Inventor_Convert/[K3]Ốp.stp.SLDPRT
3d/robot_component/Inventor_Convert/[K4]Nắp.stp
3d/robot_component/Inventor_Convert/[K4]Nắp.stp.SLDPRT
3d/robot_component/Inventor_Convert/[K4]Tam noi.stp
3d/robot_component/Inventor_Convert/[K4]Tam noi.stp.SLDPRT
3d/robot_component/Inventor_Convert/[K4]Thân.stp
3d/robot_component/Inventor_Convert/[K4]Thân.stp.SLDPRT
3d/robot_component/Inventor_Convert/[K4]Trục.stp
3d/robot_component/Inventor_Convert/[K4]Trục.stp.SLDPRT
3d/robot_component/Inventor_Convert/[K4]Động_cơ.stp
3d/robot_component/Inventor_Convert/[K4]Động_cơ.stp.SLDPRT
3d/robot_component/Khop_3.SLDPRT
3d/robot_component/Khop_5.SLDPRT
3d/robot_component/Khop_6.SLDPRT
3d/robot_component/[K3]Động_cơ.stp.SLDPRT
3d/robot_final/robot.SLDDRW
3d/robot_gripper/Gripper_Mica/Part1-print.SLDPRT
3d/robot_gripper/Gripper_Mica/Part1-print.STL
3d/robot_gripper/Gripper_Mica/Part1.1-print.STL
3d/robot_gripper/Gripper_Mica/Part1x2.STL
3d/robot_gripper/Gripper_Mica/Part3x8.STL
3d/robot_gripper/Gripper_Mica/Part5.STL
3d/robot_gripper/thuc-hien/Gripper_Loc/Gripper_Mica/Khop_noi_mat_bich.stp.SLDPRT
3d/robot_gripper/thuc-hien/Gripper_Loc/Gripper_Mica/Mica_component/Part1_mica.DXF
3d/robot_gripper/thuc-hien/Gripper_Loc/Gripper_Mica/Mica_component/Part1_mica.dwg
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
