TNH510/5_DOF_Robot_Arm/drawing/print/ban-ve-chi-tiet.pdf

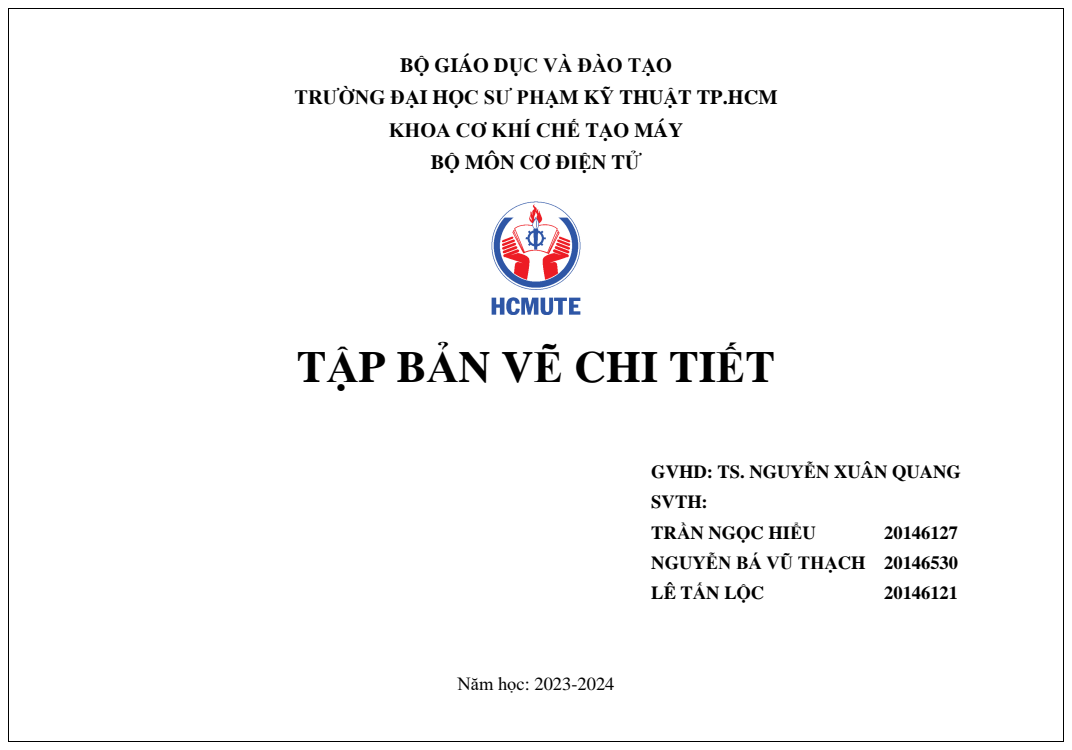
[picture p332: page 1]
TRẦN NGỌC HIỂU; LÊ TẤN LỘC; Năm học: 2023-2024

BỘ GIÁO DỤC VÀ ĐÀO TẠO

TRƯỜNG ĐẠI HỌC SƯ PHẠM KỸ THUẬT TP.HCM

KHOA CƠ KHÍ CHẾ TẠO MÁY
BỘ MÔN CƠ ĐIỆN TỬ

TẬP BẢN VẼ CHI TIẾT

GVHD: TS. NGUYỄN XUÂN QUANG

SVTH:
NGUYỄN BÁ VŨ THẠCH 20146530

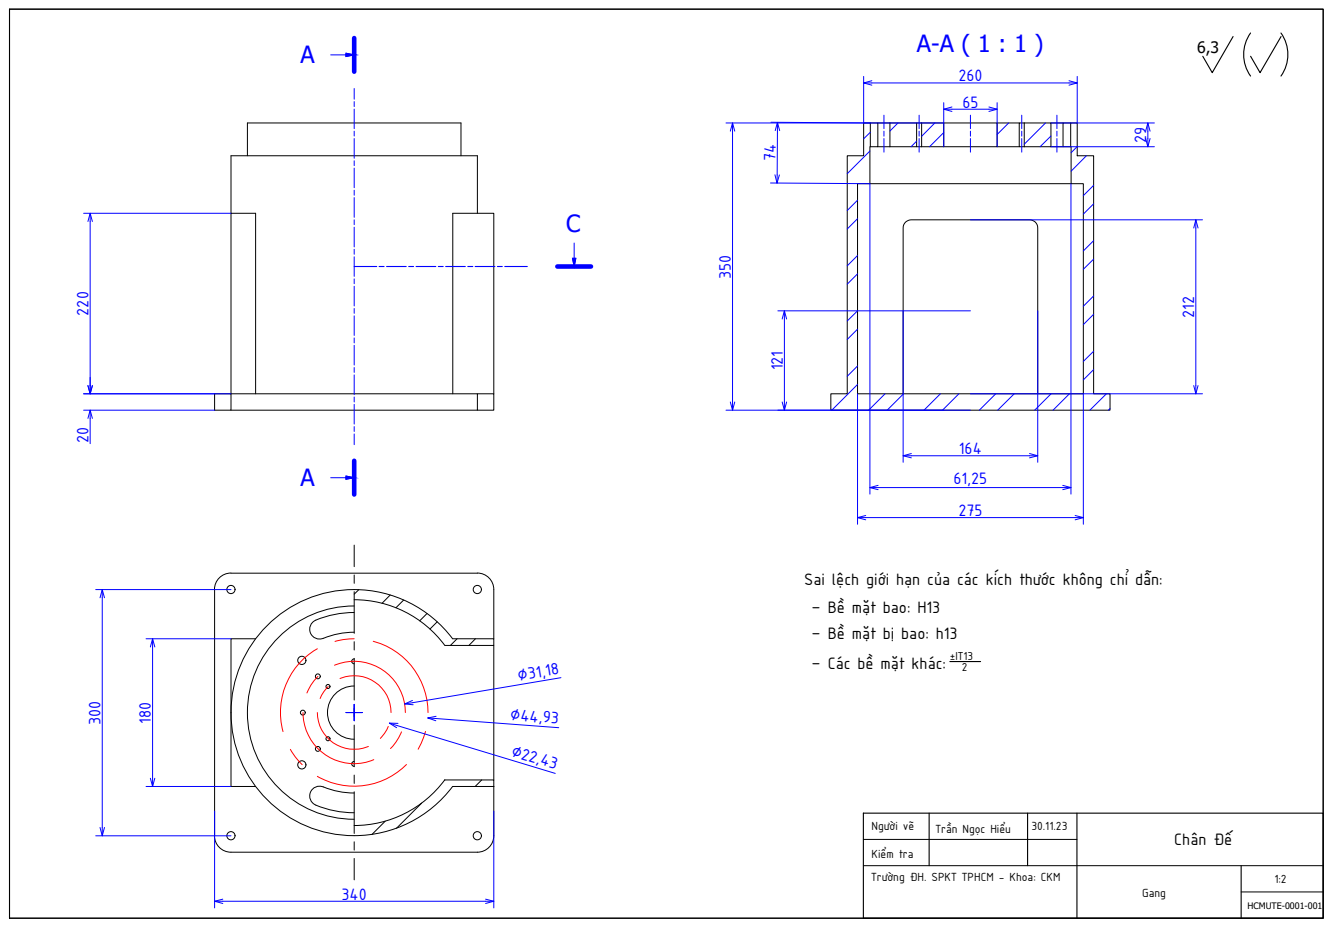
[picture p333: page 2]
Gang; HCMUTE-0001-001 1:2 6,3 ∅44,93 ∅31,18 ∅22,43 340

Sai lệch giới hạn của các kích thước không chỉ dẫn:

– Bề mặt bao: H13
– Bề mặt bị bao: h13
2 ±IT13 – Các bề mặt khác:

30.11.23 Kiểm tra Người vẽ | Chân Đế Trần Ngọc Hiểu

Trường ĐH. SPKT TPHCM - Khoa: CKM

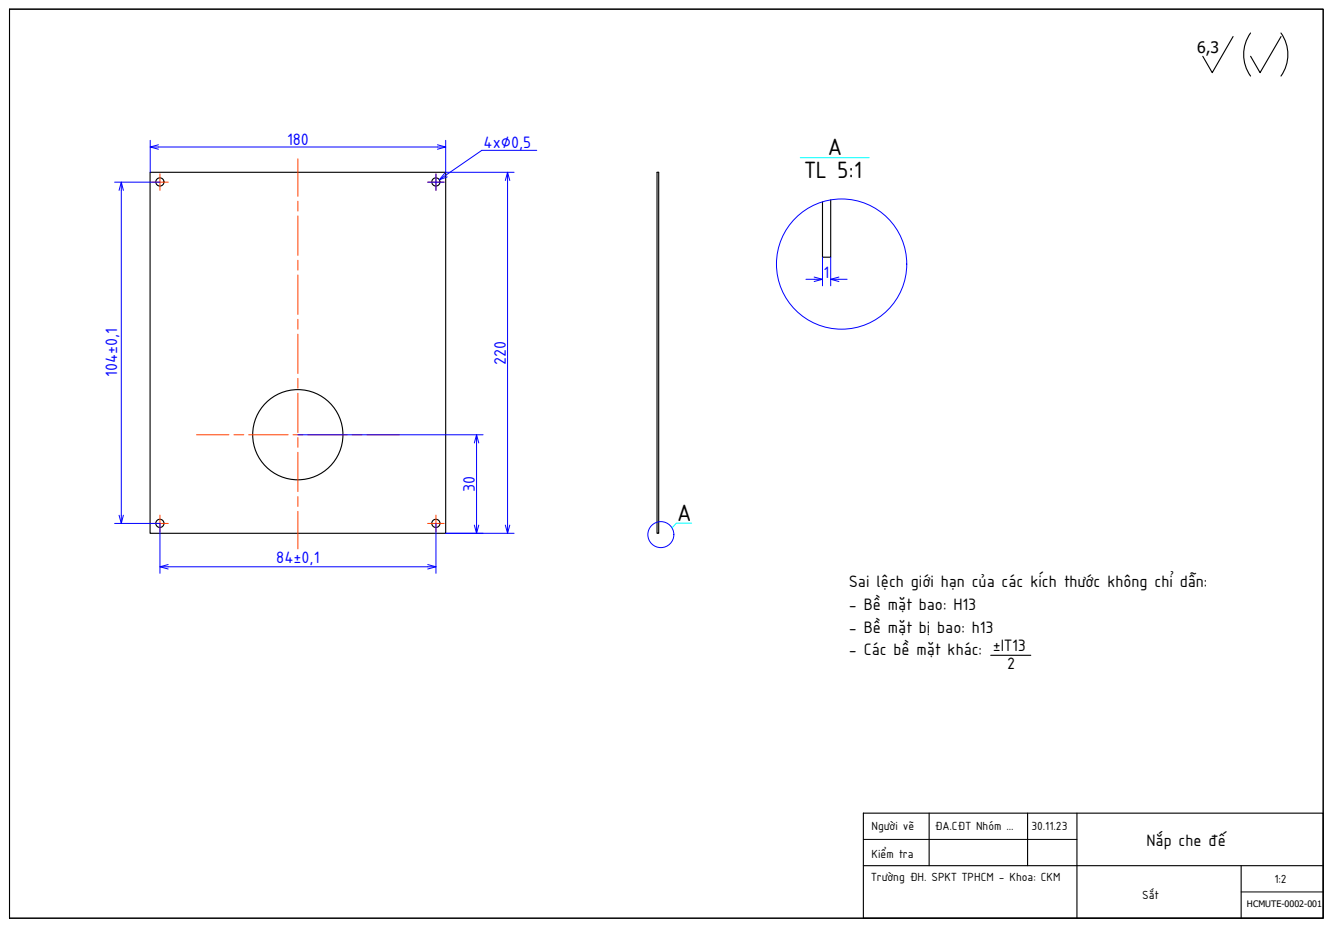
[picture p334: page 3]
Nắp che đế ĐA.CĐT Nhóm ...; 30.11.23 Kiểm tra Người vẽ; Sắt; HCMUTE-0002-001 1:2 6,3 180; - Các bề mặt khác: ±IT13 2 TL 5:1 A

30 4x∅0,5 Sai lệch giới hạn của các kích thước không chỉ dẫn:

- Bề mặt bao: H13
- Bề mặt bị bao: h13

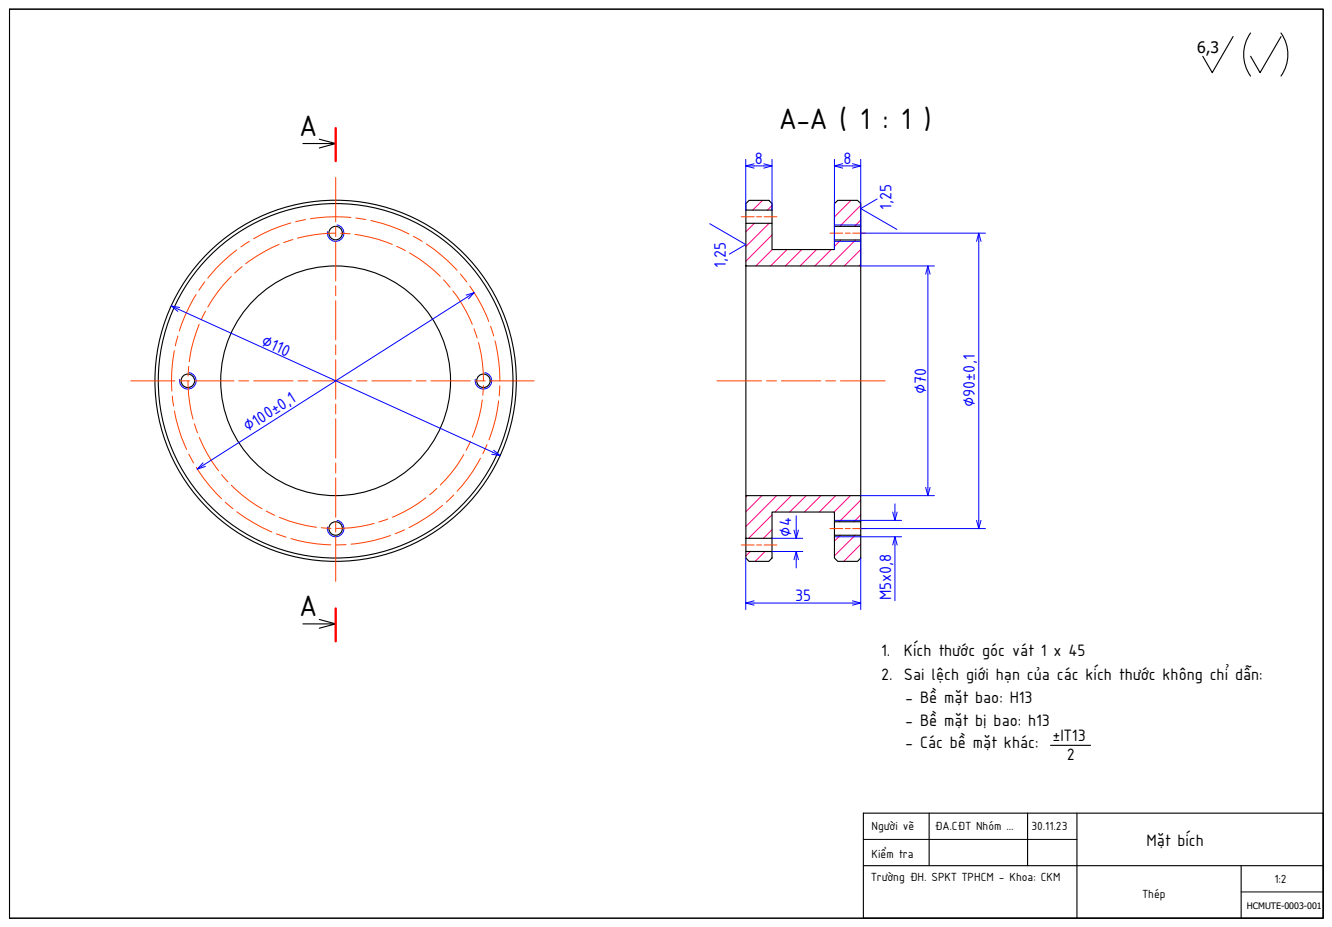
[picture p335: page 4]
Mặt bích ĐA.CĐT Nhóm ...; 30.11.23 Kiểm tra Người vẽ; Thép; HCMUTE-0003-001 1:2 6,3 1. Kích thước góc vát 1 x 45 2. Sai lệch giới hạn của các kích thước không chỉ dẫn: - Bề mặt bao: H13 - Bề mặt bị bao: h13 - Các bề mặt khác: ±IT13 2

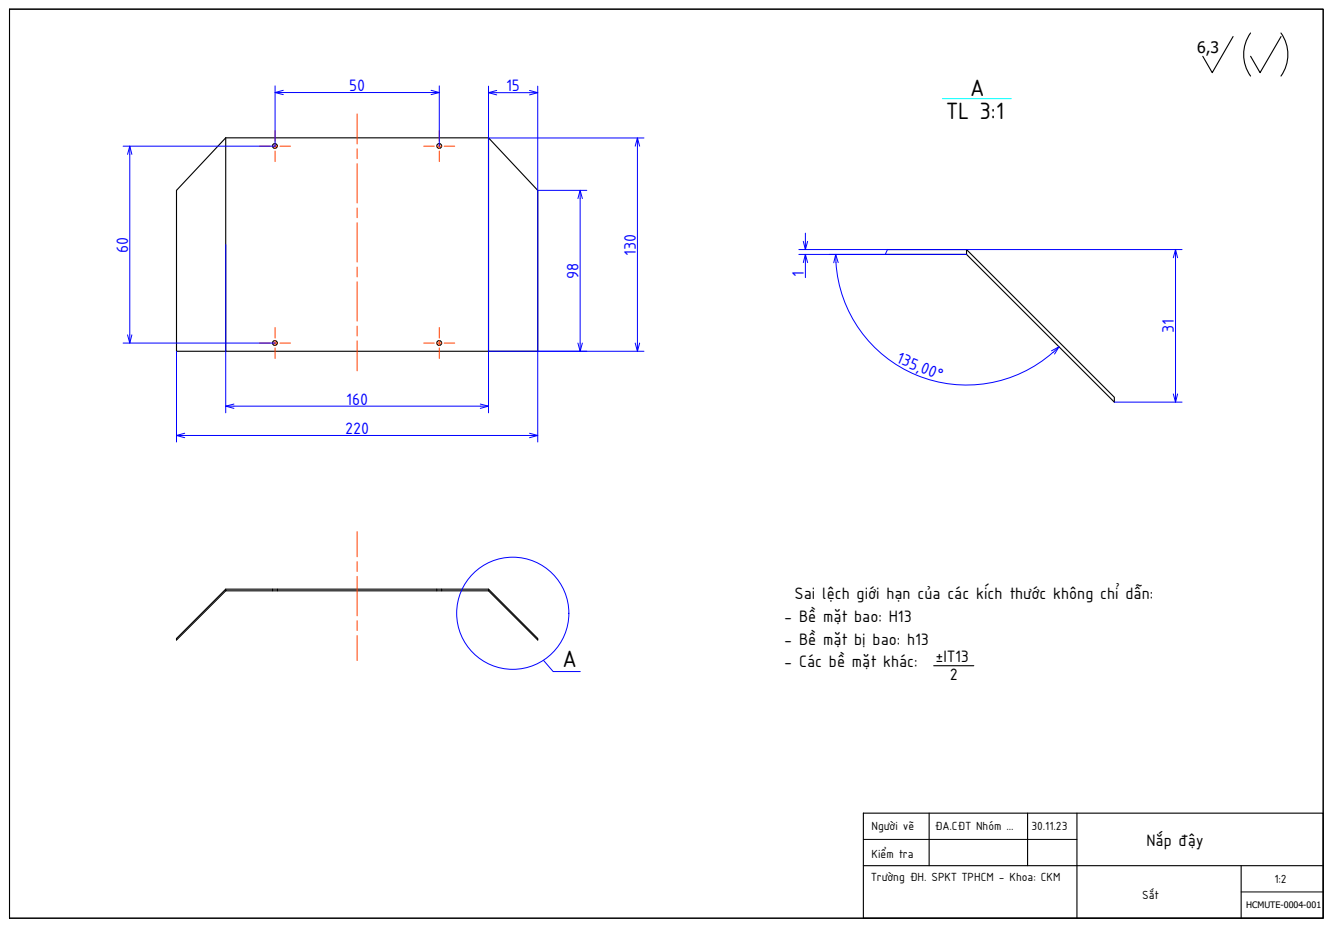
[picture p336: page 5]
Nắp đậy ĐA.CĐT Nhóm ...; 30.11.23 Kiểm tra Người vẽ; Sắt; HCMUTE-0004-001 1:2 6,3 Sai lệch giới hạn của các kích thước không chỉ dẫn: - Bề mặt bao: H13 - Bề mặt bị bao: h13 - Các bề mặt khác:

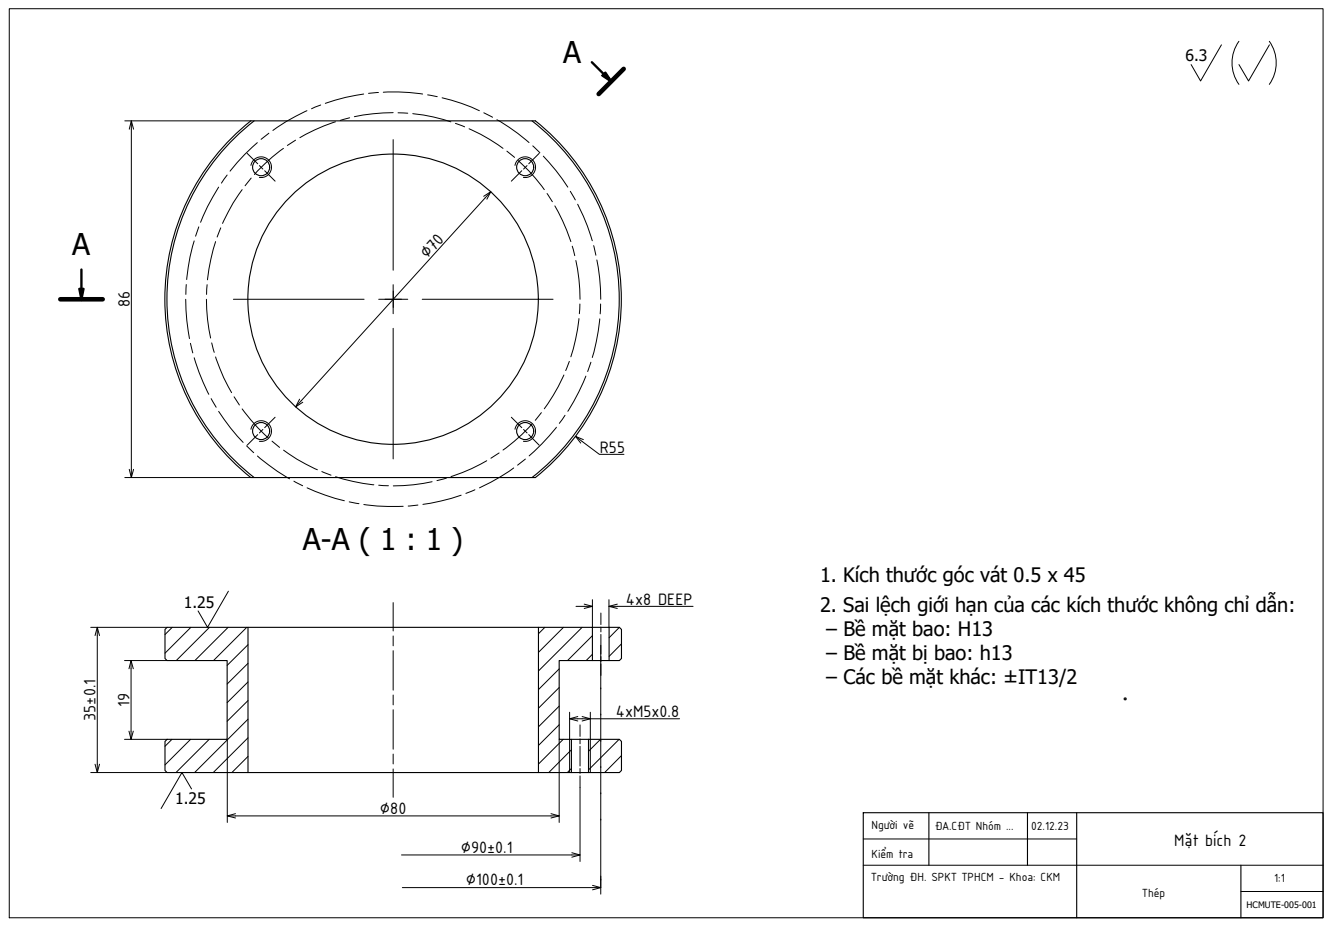
[picture p337: page 6]
2. Sai lệch giới hạn của các kích thước không chỉ dẫn: ~ 1. Kích thước góc vát 0.5 x 45 A A; Mặt bích 2 ĐA.CĐT Nhóm ...; 02.12.23 Kiểm tra Người vẽ; Thép; HCMUTE-005-001 1:1 6.3 ∅70; 19 4xM5x0.8 ∅100±0.1 ∅80 4x8 DEEP ∅90±0.1

– Bề mặt bao: H13
– Bề mặt bị bao: h13
– Các bề mặt khác: ±IT13/2

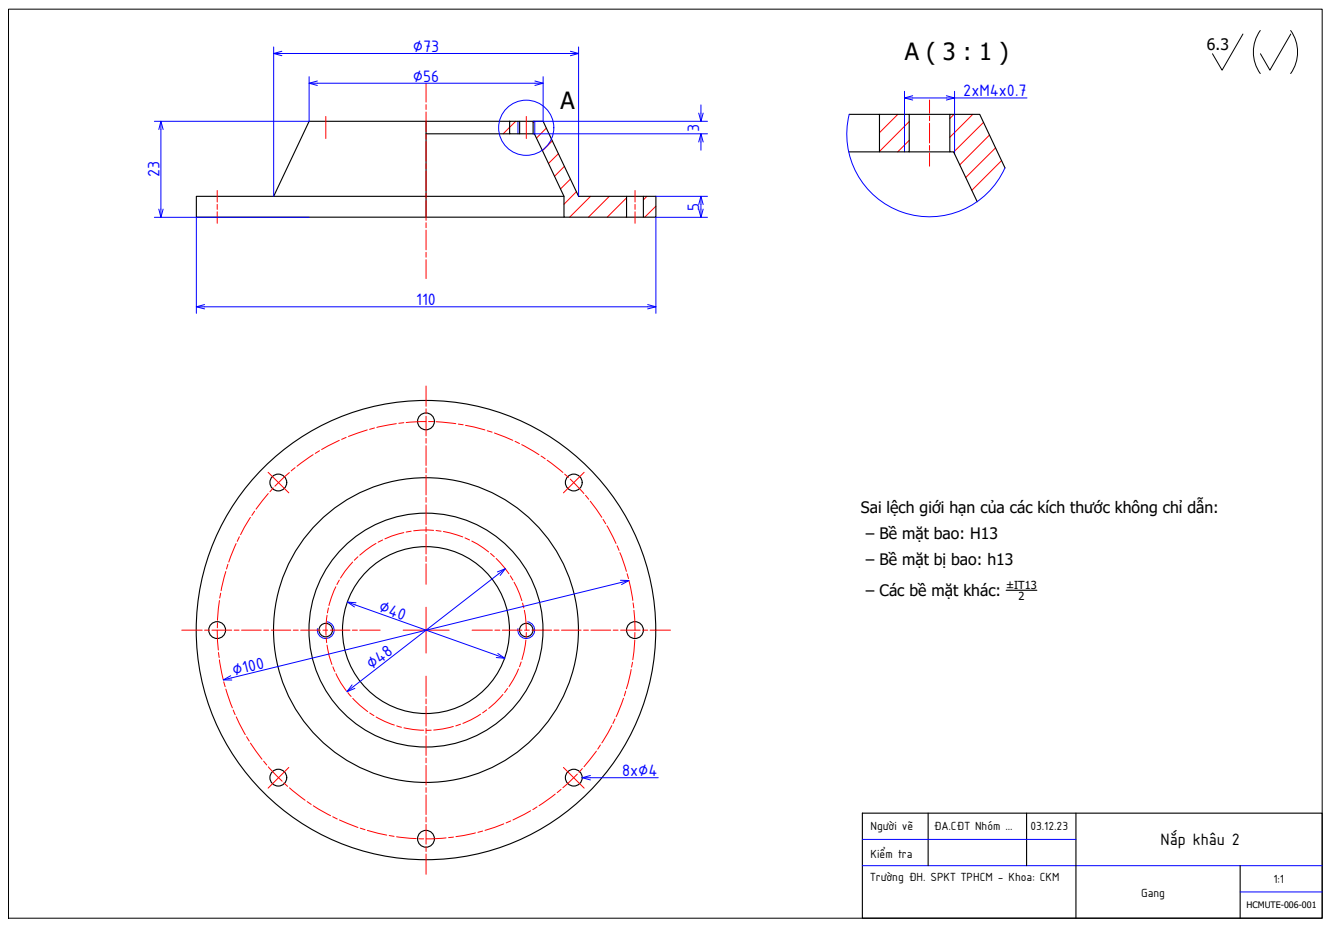
[picture p338: page 7]
Nắp khâu 2 ĐA.CĐT Nhóm ...; 03.12.23 Kiểm tra Người vẽ; Gang; HCMUTE-006-001 1:1 ∅40∅48 ∅100

23 2xM4x0.7 A ( 3 : 1 ) A 2 ±IT13 – Các bề mặt khác: – Bề mặt bị bao: h13 – Bề mặt bao: H13 Sai lệch giới hạn của các kích thước không chỉ dẫn:6.3 5

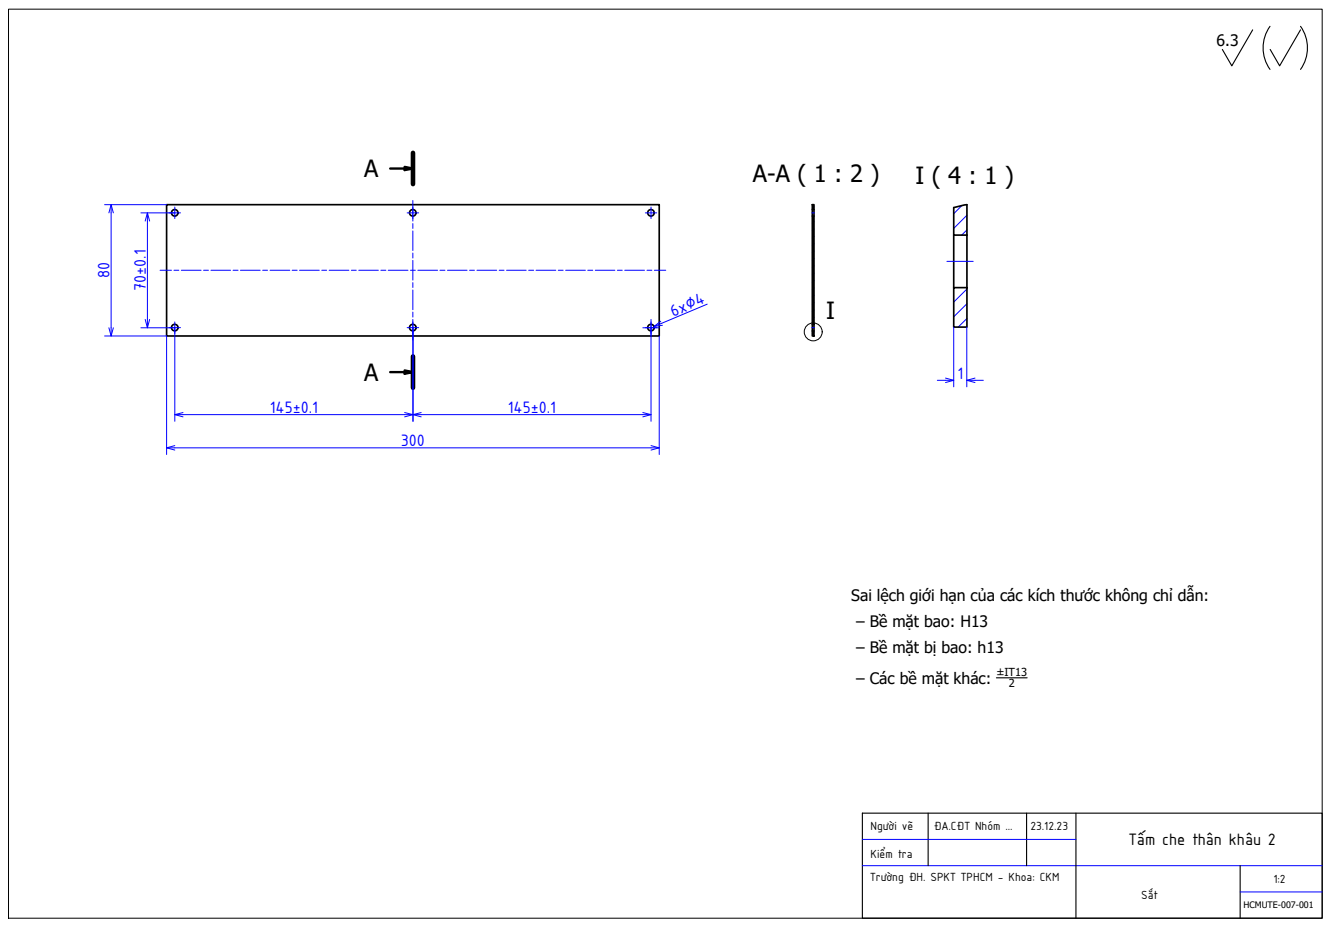
[picture p339: page 8]
Tấm che thân khâu 2 ĐA.CĐT Nhóm ...; 23.12.23 Kiểm tra Người vẽ; Sắt; HCMUTE-007-001 1:2 AA

70±0.1 1 6x∅4 300 145±0.1 145±0.1 I 2 ±IT13 – Các bề mặt khác: – Bề mặt bị bao: h13 – Bề mặt bao: H13 Sai lệch giới hạn của các kích thước không chỉ dẫn: 6.3

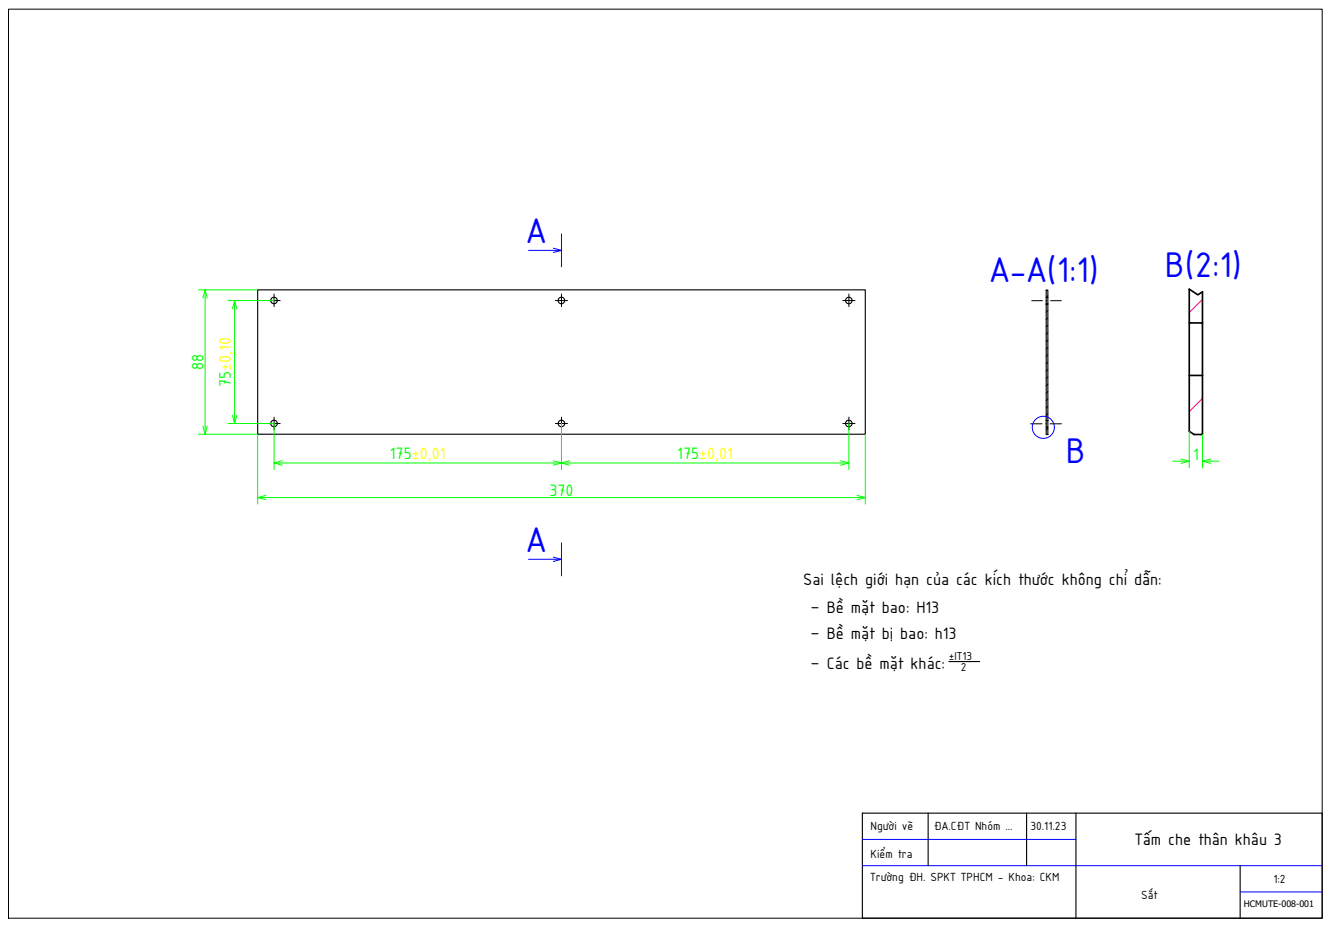
[picture p340: page 9]
Tấm che thân khâu 3 ĐA.CĐT Nhóm ...; 30.11.23 Kiểm tra Người vẽ; Sắt; HCMUTE-008-001 1:2 175±0,01

Sai lệch giới hạn của các kích thước không chỉ dẫn:

– Bề mặt bao: H13
– Bề mặt bị bao: h13
2 ±IT13 – Các bề mặt khác:

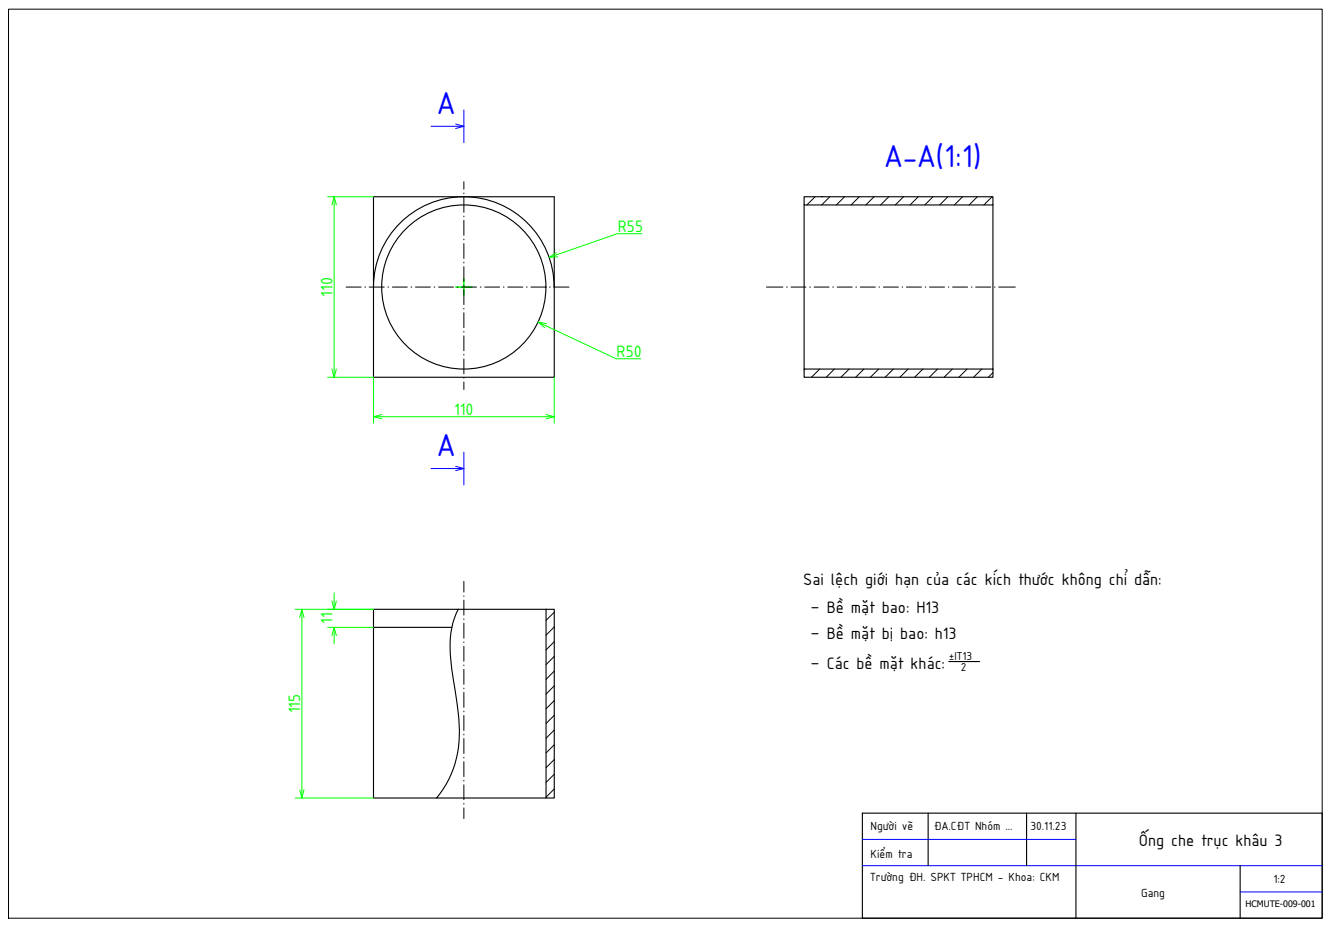
[picture p341: page 10]
Ống che trục khâu 3 ĐA.CĐT Nhóm ...; 30.11.23 Kiểm tra Người vẽ; Gang; HCMUTE-009-001 1:2 R50 R55

Sai lệch giới hạn của các kích thước không chỉ dẫn:

– Bề mặt bao: H13
– Bề mặt bị bao: h13
2 ±IT13 – Các bề mặt khác:

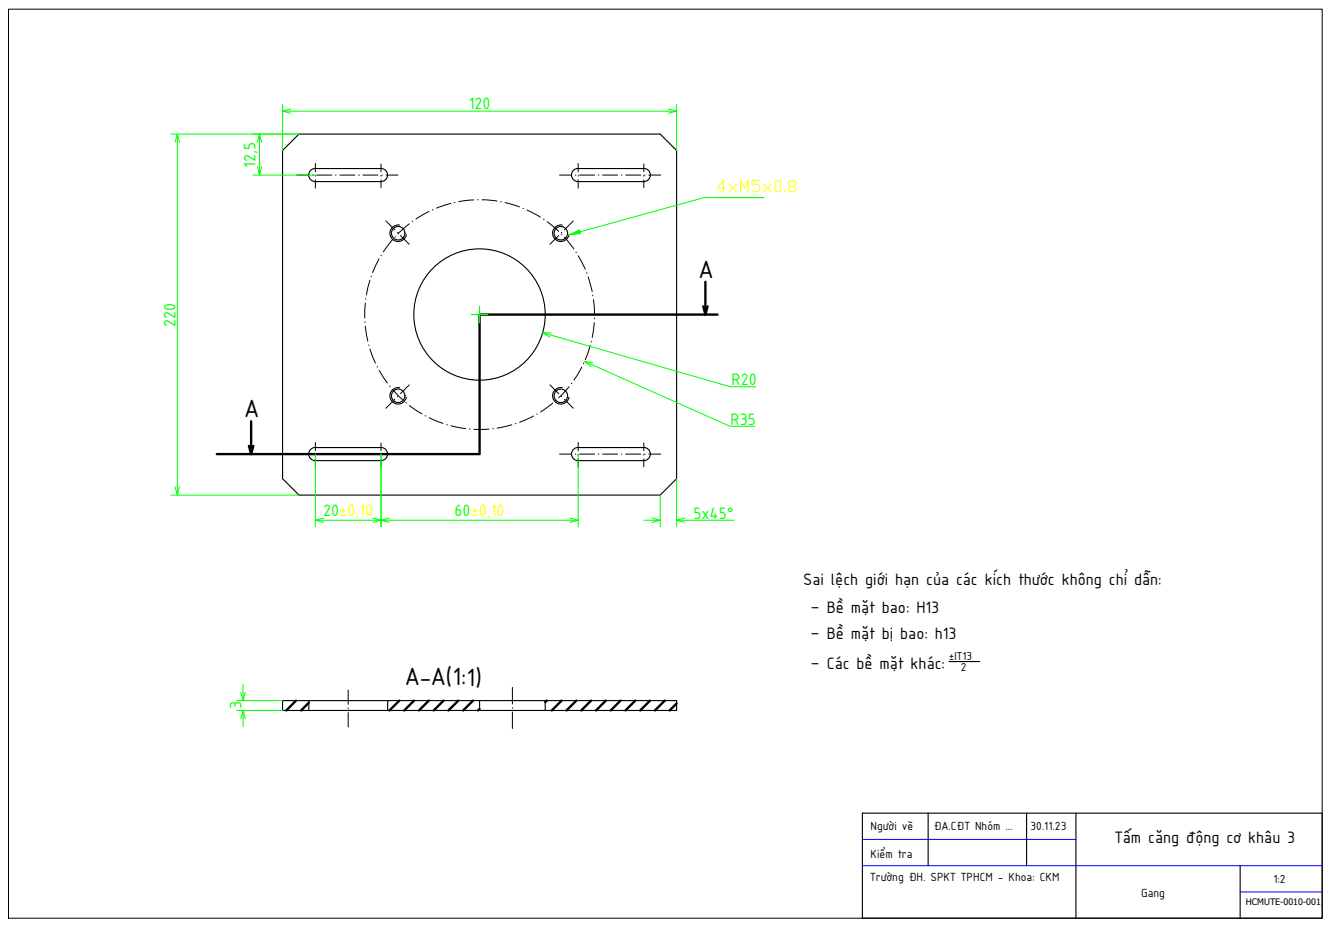
[picture p342: page 11]
Tấm căng động cơ khâu 3 ĐA.CĐT Nhóm ...; 30.11.23 Kiểm tra Người vẽ; Gang; HCMUTE-0010-001 1:2 A

Sai lệch giới hạn của các kích thước không chỉ dẫn:

– Bề mặt bao: H13
– Bề mặt bị bao: h13
2 ±IT13 – Các bề mặt khác:

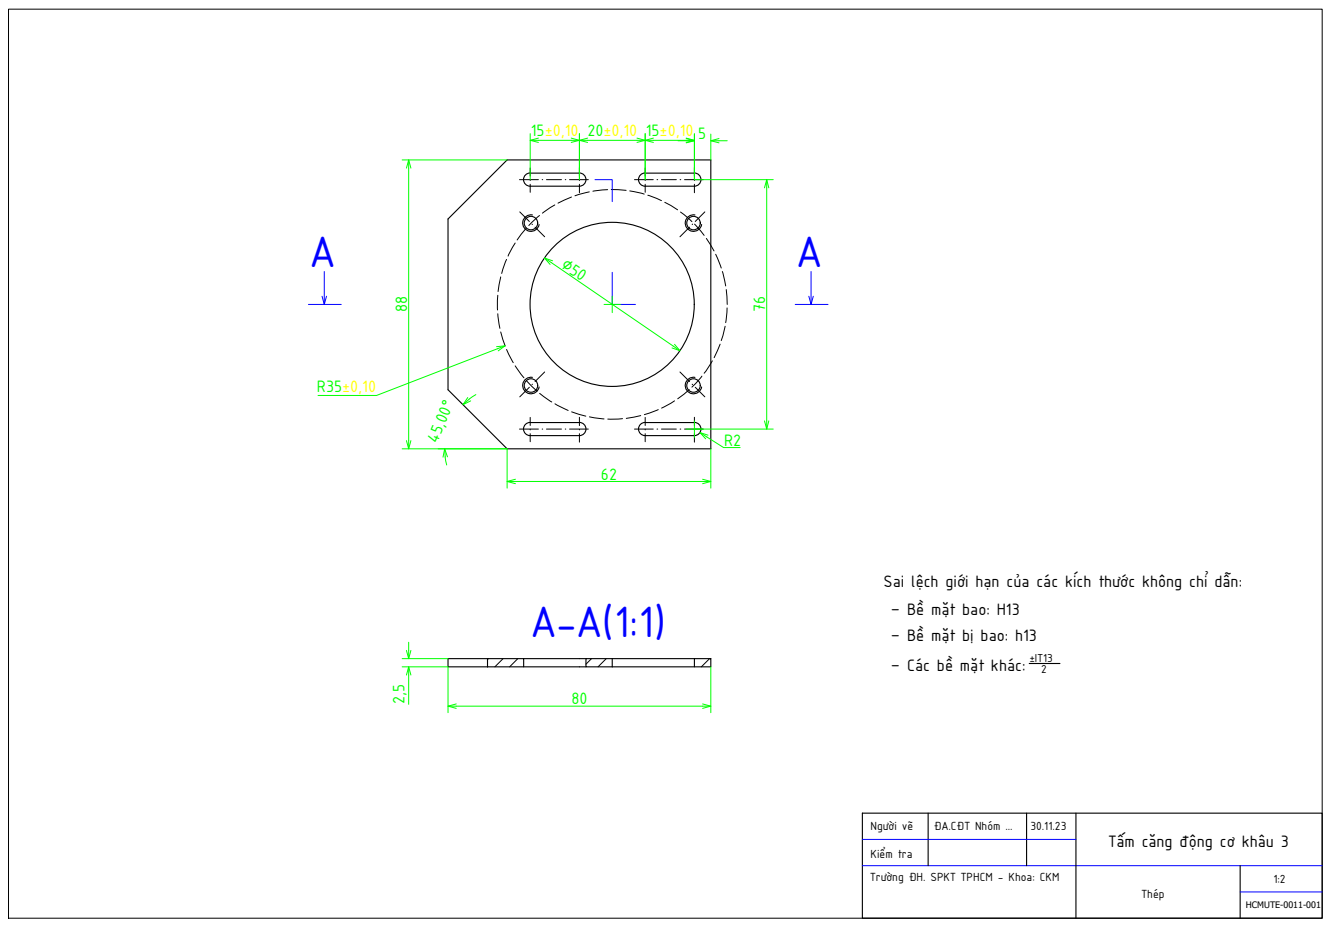
[picture p343: page 12]
Tấm căng động cơ khâu 3 ĐA.CĐT Nhóm ...; 30.11.23 Kiểm tra Người vẽ; Thép; HCMUTE-0011-001 1:2 A

Sai lệch giới hạn của các kích thước không chỉ dẫn:

– Bề mặt bao: H13
– Bề mặt bị bao: h13
2 ±IT13 – Các bề mặt khác:

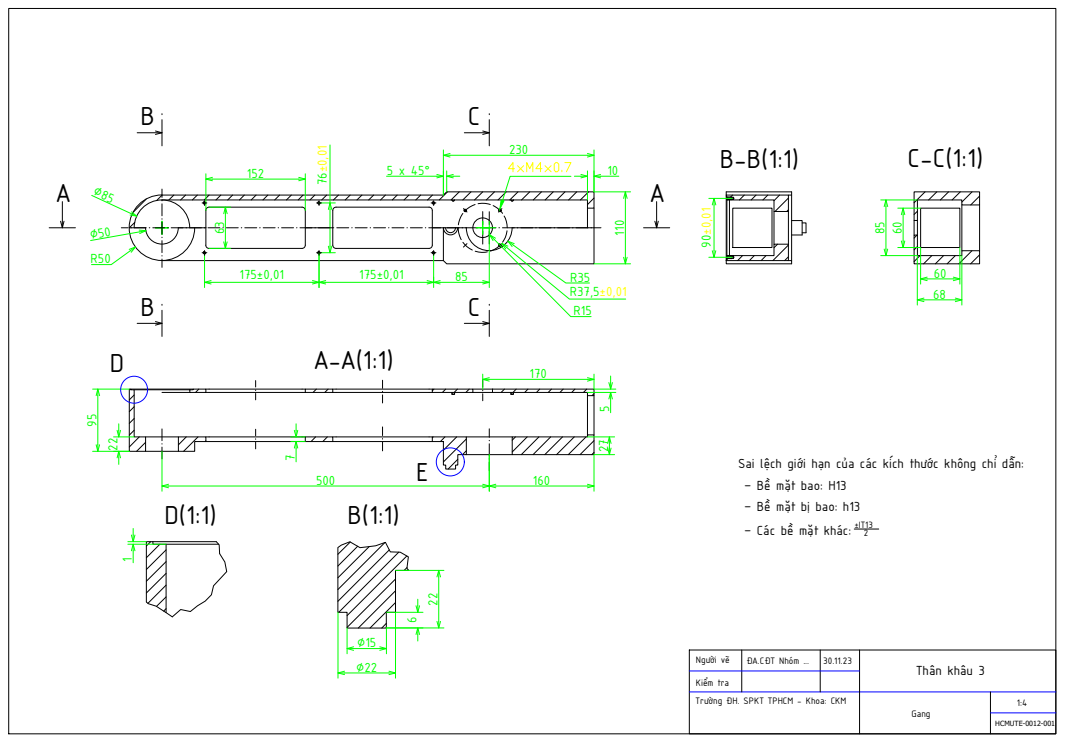
[picture p344: page 13]
Sai lệch giới hạn của các kích thước không chỉ dẫn: Thân khâu 3 ĐA.CĐT Nhóm ...; 30.11.23 Kiểm tra Người vẽ; Gang; HCMUTE-0012-001 1:4 ∅85∅50 R50

– Bề mặt bao: H13
– Bề mặt bị bao: h13
2 ±IT13 – Các bề mặt khác:

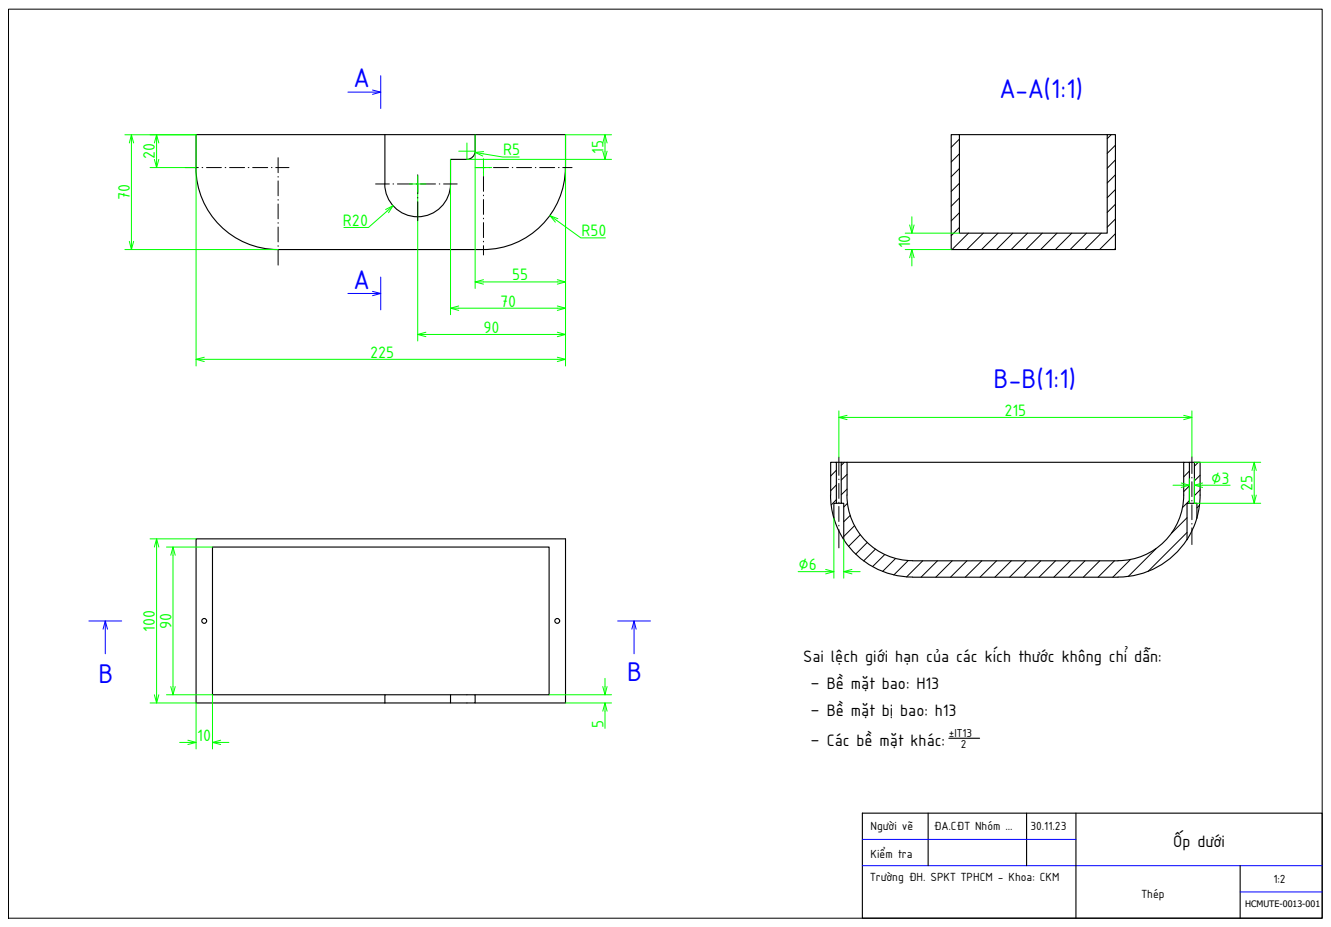
[picture p345: page 14]
Ốp dưới ĐA.CĐT Nhóm ...; 30.11.23 Kiểm tra Người vẽ; Thép; HCMUTE-0013-001 1:2 225

Sai lệch giới hạn của các kích thước không chỉ dẫn:

– Bề mặt bao: H13
– Bề mặt bị bao: h13
2 ±IT13 – Các bề mặt khác:

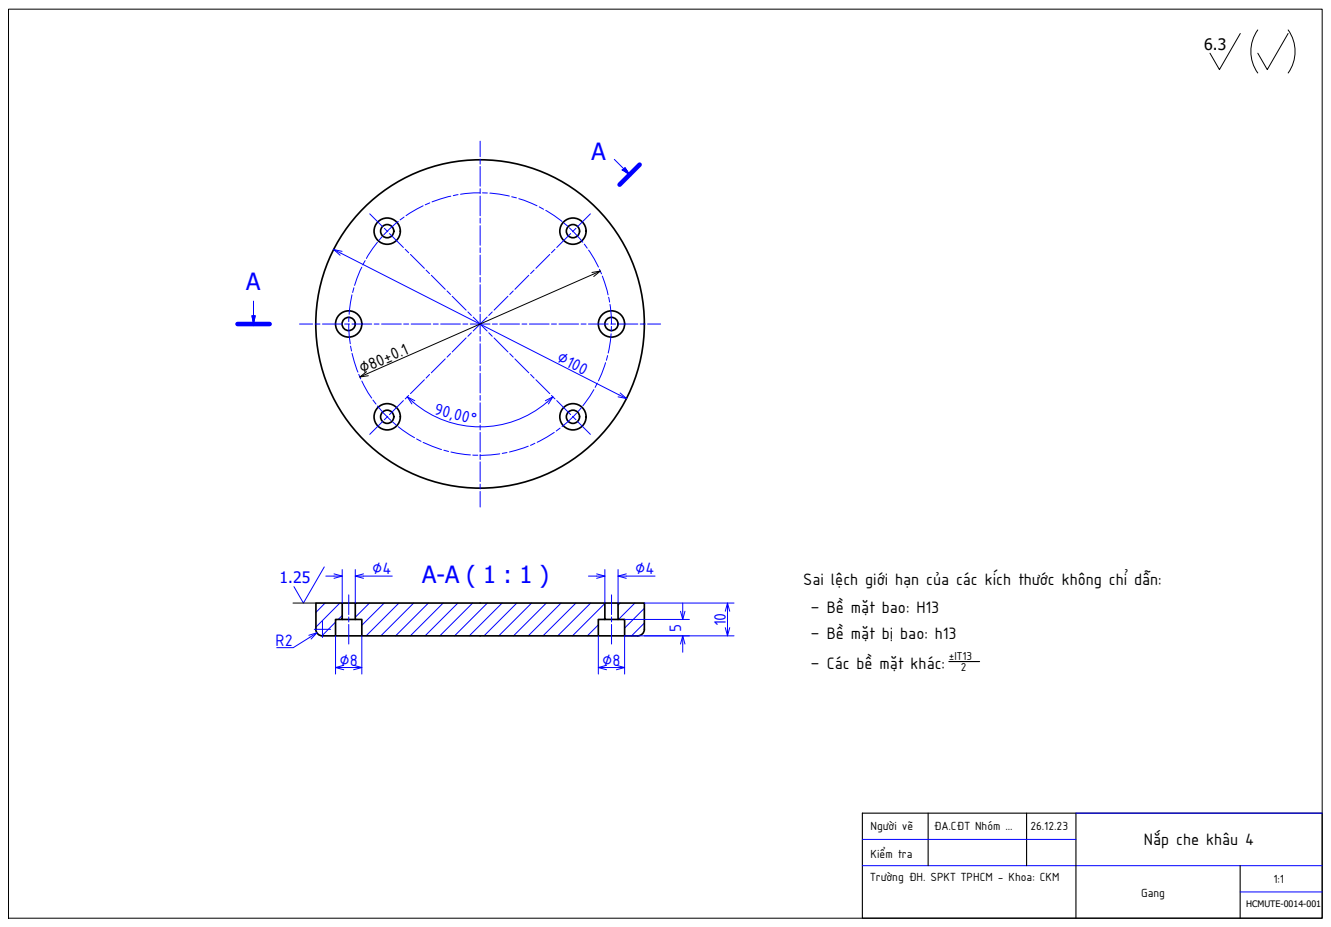
[picture p346: page 15]
Nắp che khâu 4 ĐA.CĐT Nhóm ...; 26.12.23 Kiểm tra Người vẽ; Gang; HCMUTE-0014-001 1:1 1.25 R2

Sai lệch giới hạn của các kích thước không chỉ dẫn:

– Bề mặt bao: H13
– Bề mặt bị bao: h13
2 ±IT13 – Các bề mặt khác:

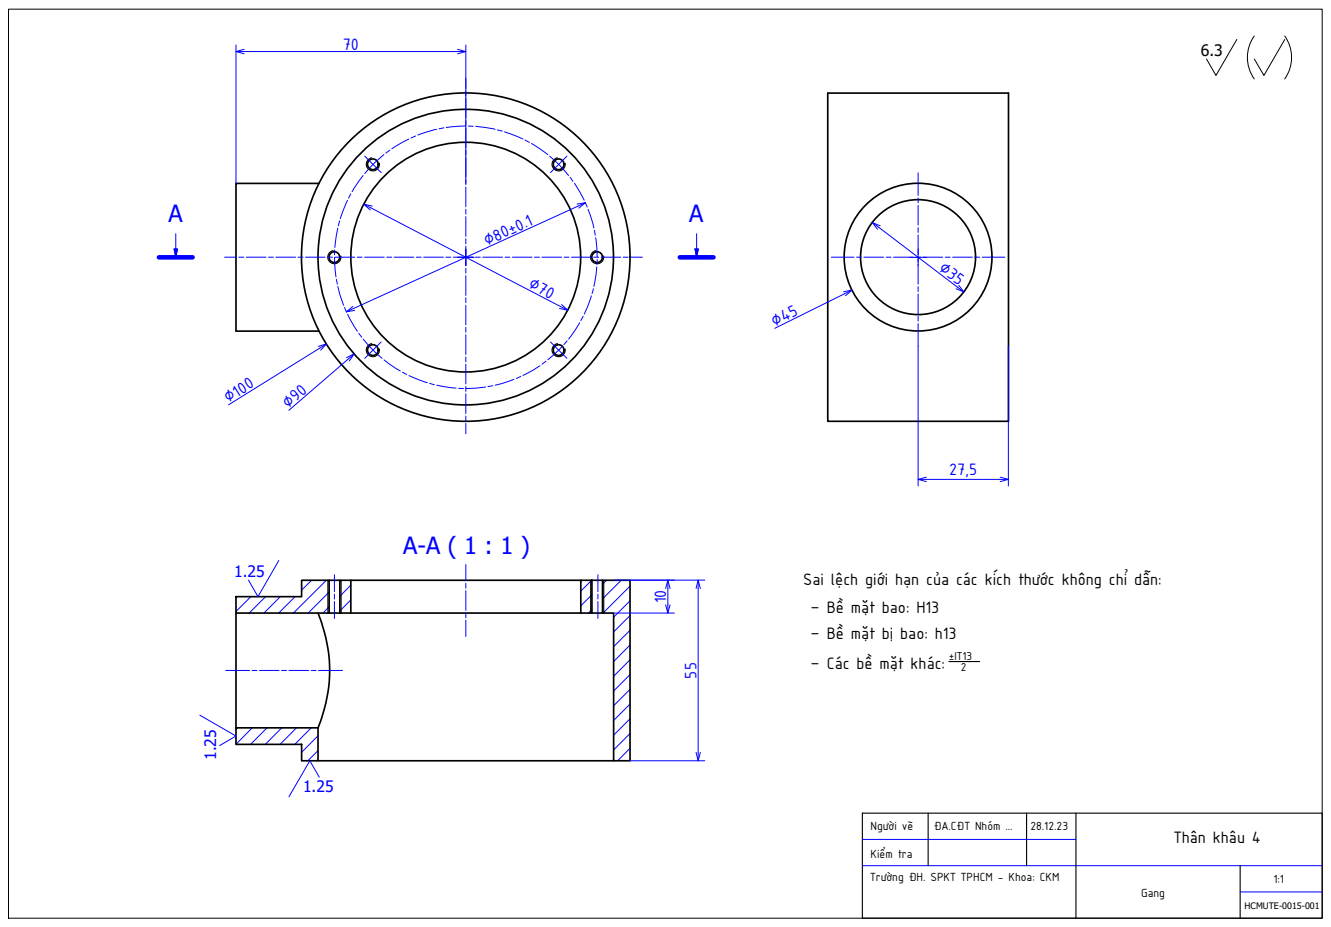
[picture p347: page 16]
Sai lệch giới hạn của các kích thước không chỉ dẫn: Thân khâu 4 ĐA.CĐT Nhóm ...; 28.12.23 Kiểm tra Người vẽ; Gang; HCMUTE-0015-001 1:1 70

– Bề mặt bao: H13
– Bề mặt bị bao: h13
2 ±IT13 – Các bề mặt khác:

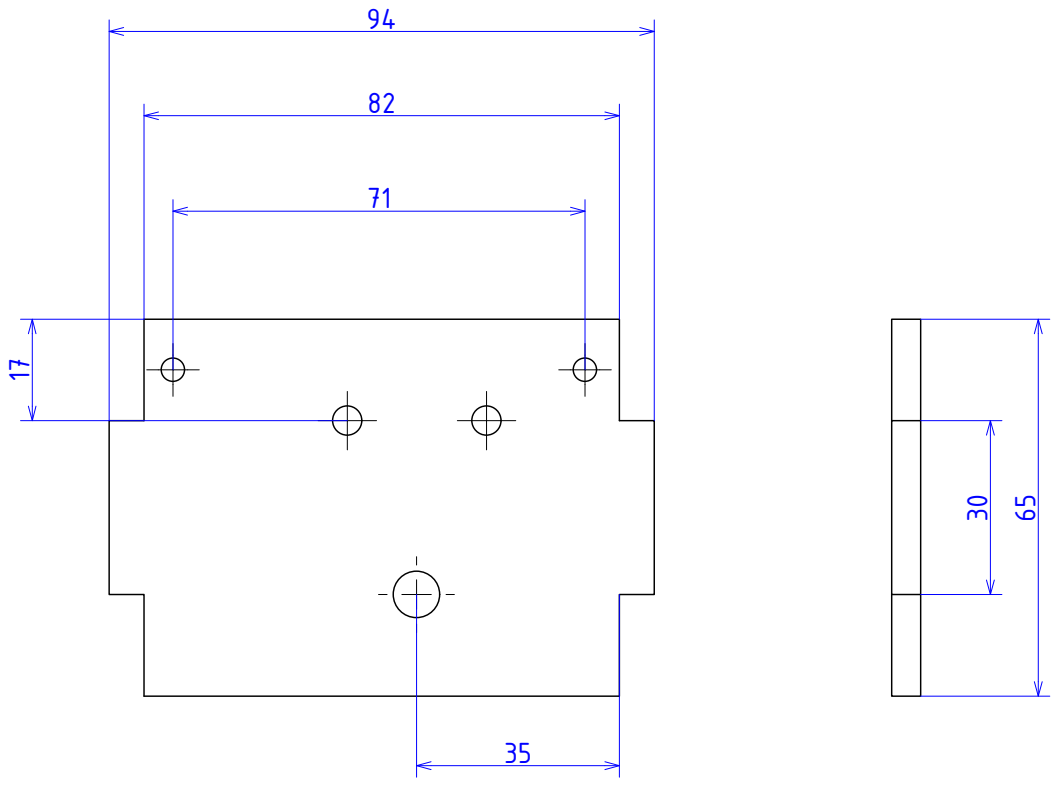
[picture p348: page 17]
MẶT BÊN Lê Tấn Lộc; 30.11.23 Kiểm tra Người vẽ; Gang; HCMUTE-0016-001 1:2 948271; 17 N.X. Quang

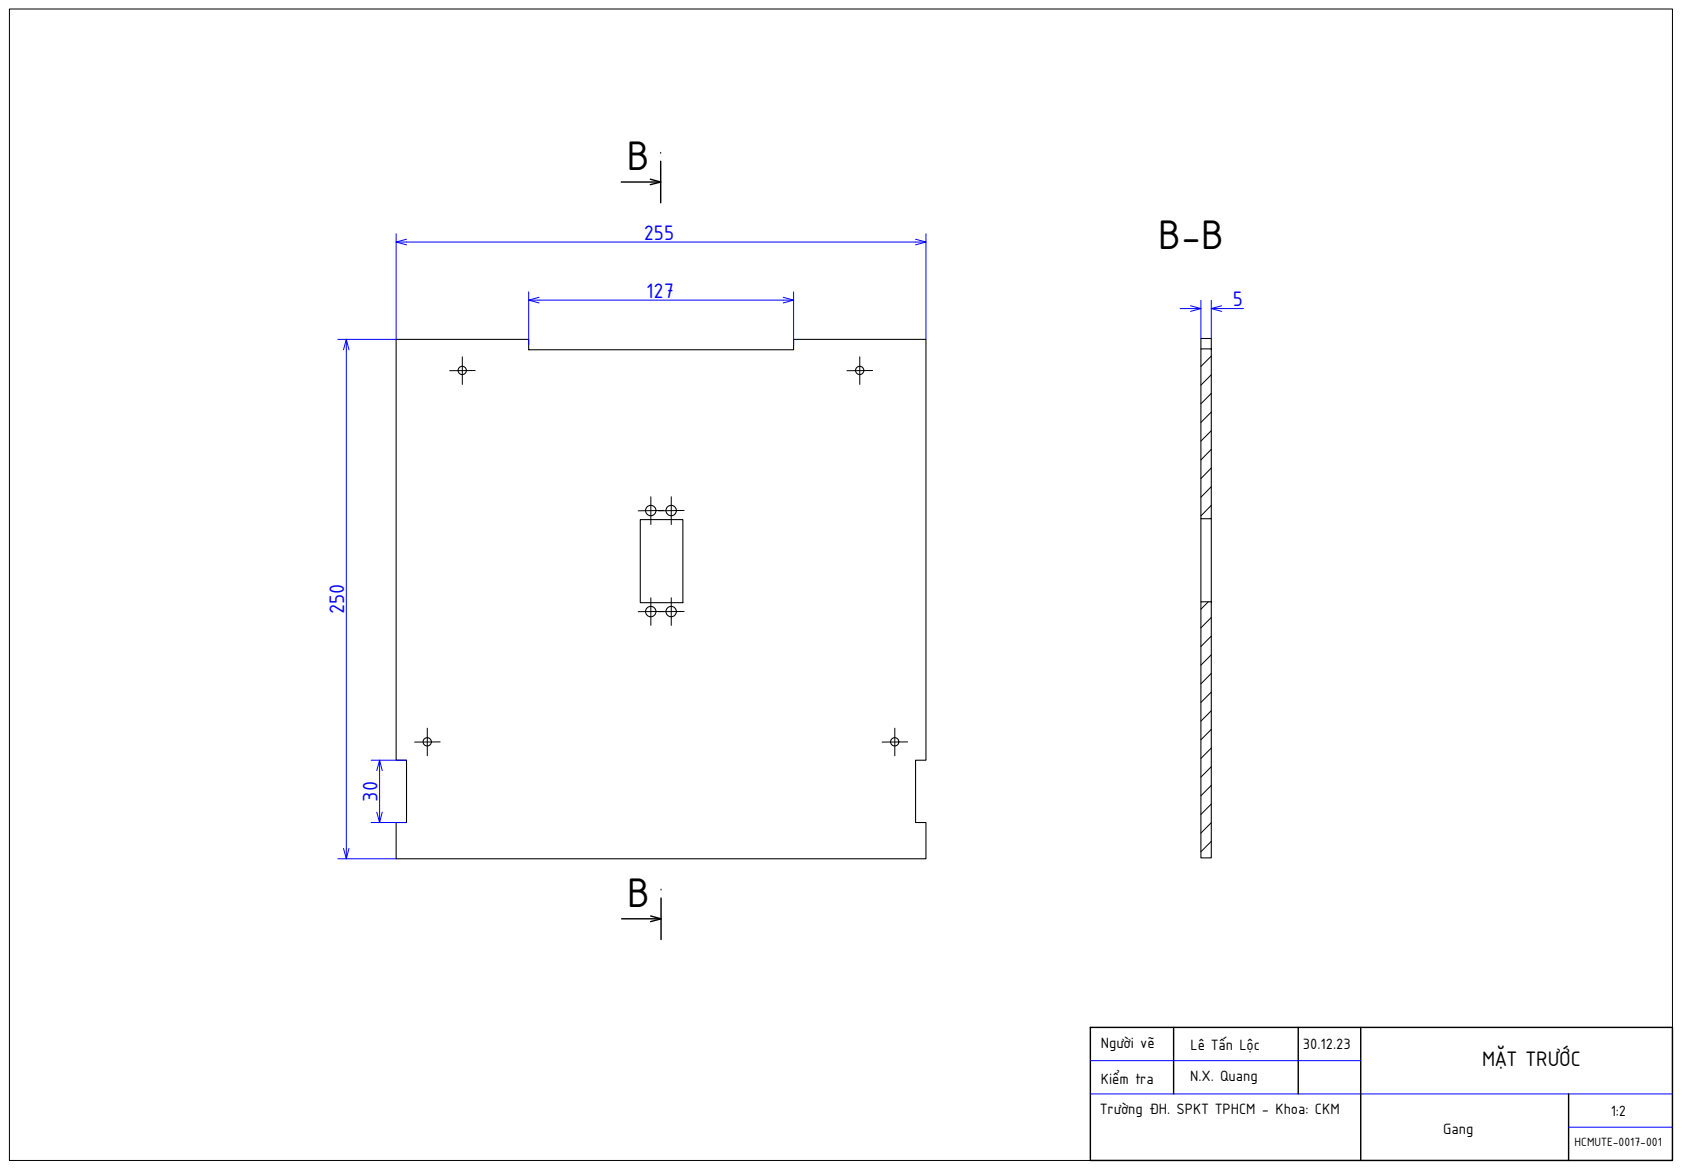
[picture p349: page 18]
MẶT TRƯỚC Lê Tấn Lộc; 30.12.23 Kiểm tra Người vẽ; Gang; HCMUTE-0017-001 1:2 255 127

30 5 BB B-BN.X. Quang

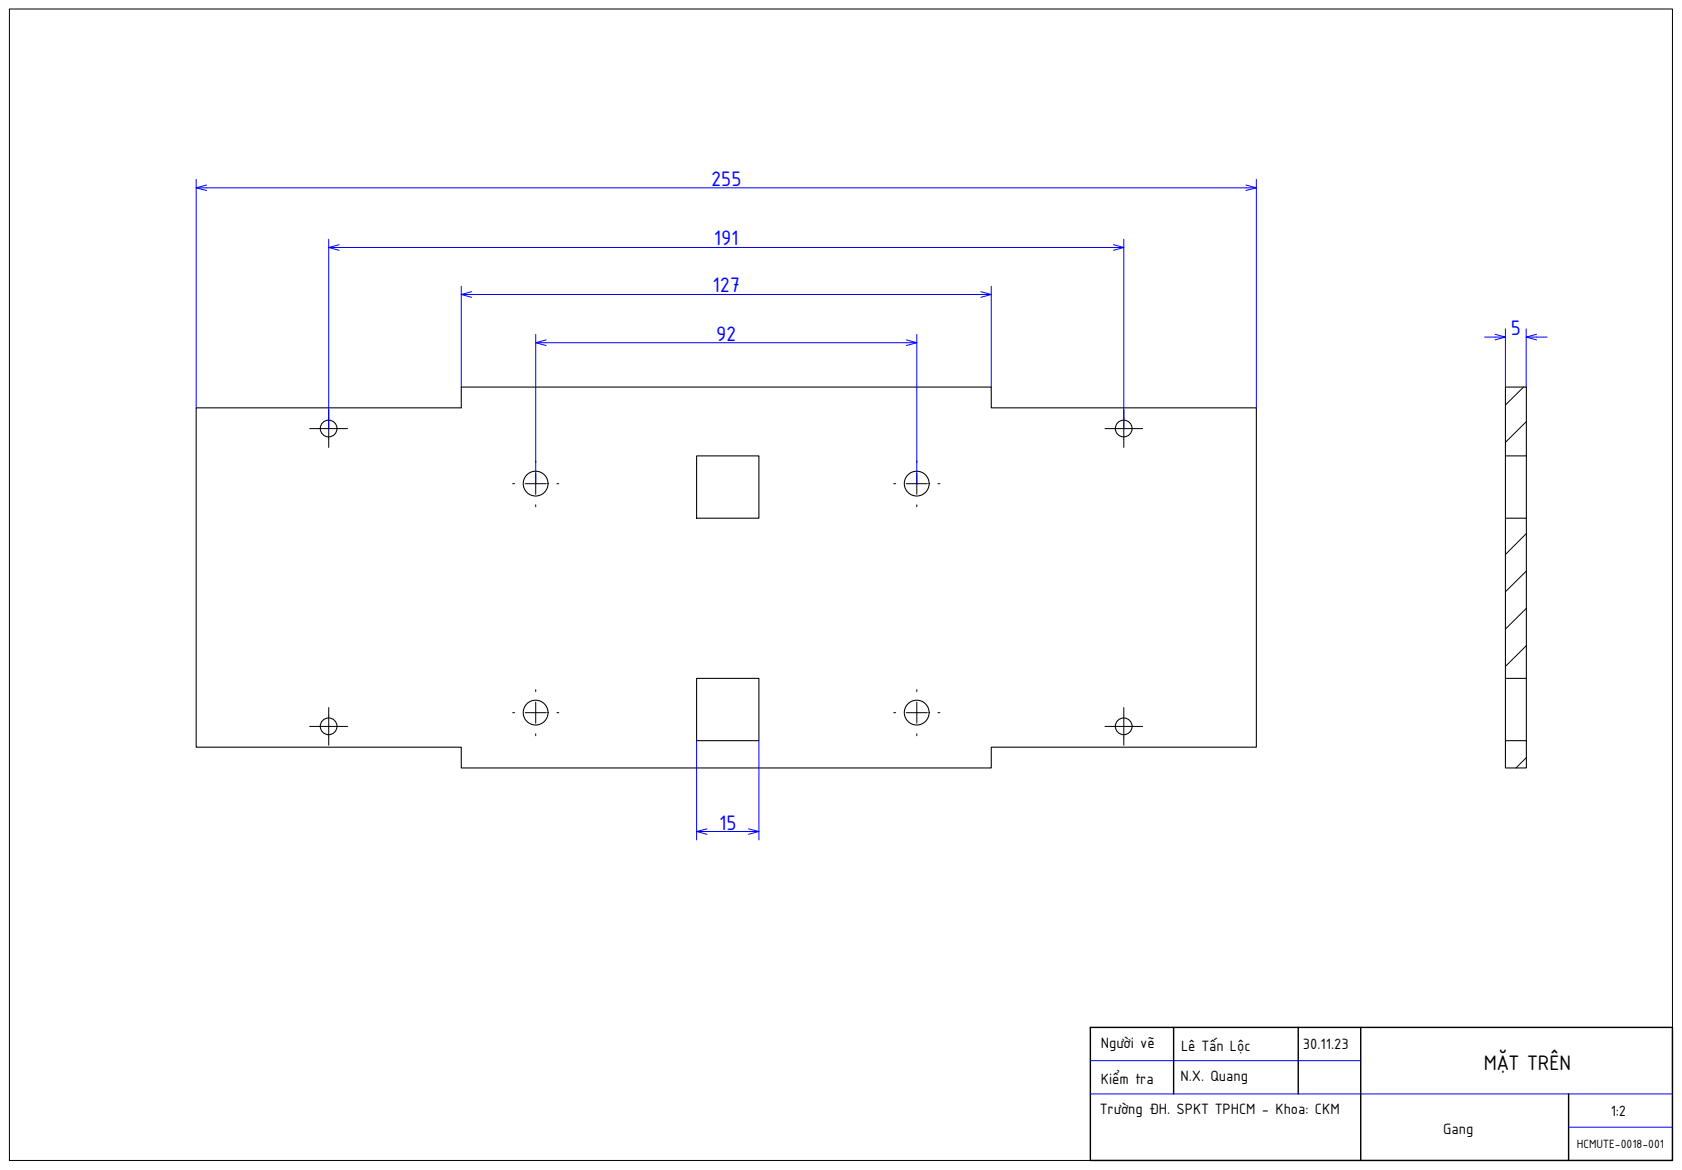
[picture p350: page 19]
MẶT TRÊN Lê Tấn Lộc; 30.11.23 Kiểm tra Người vẽ; Gang; HCMUTE-0018-001 N.X. Quang

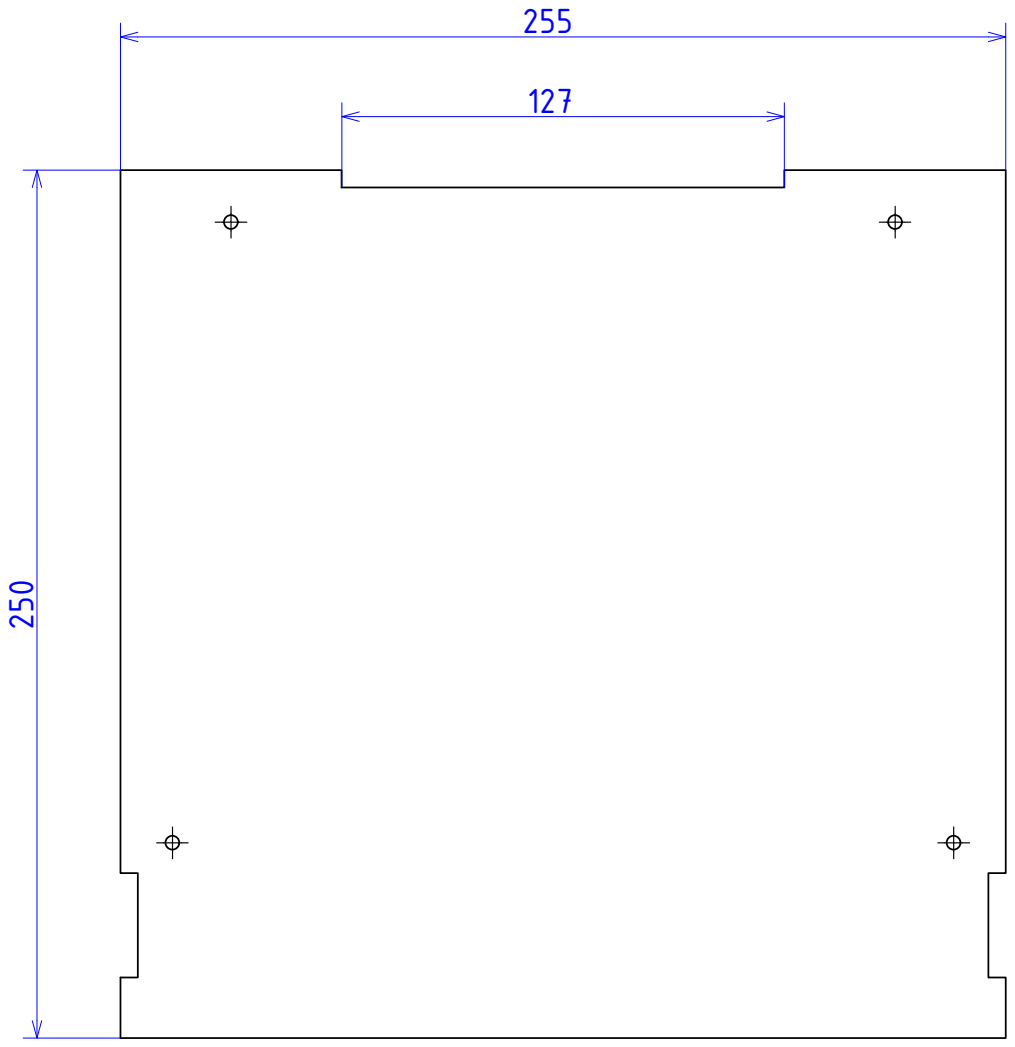
[picture p351: page 20]
MẶT TRƯỚC Lê Tấn Lộc; 30.11.23 Kiểm tra Người vẽ; Gang; 250 127 HCMUTE-0019-001 N.X. Quang

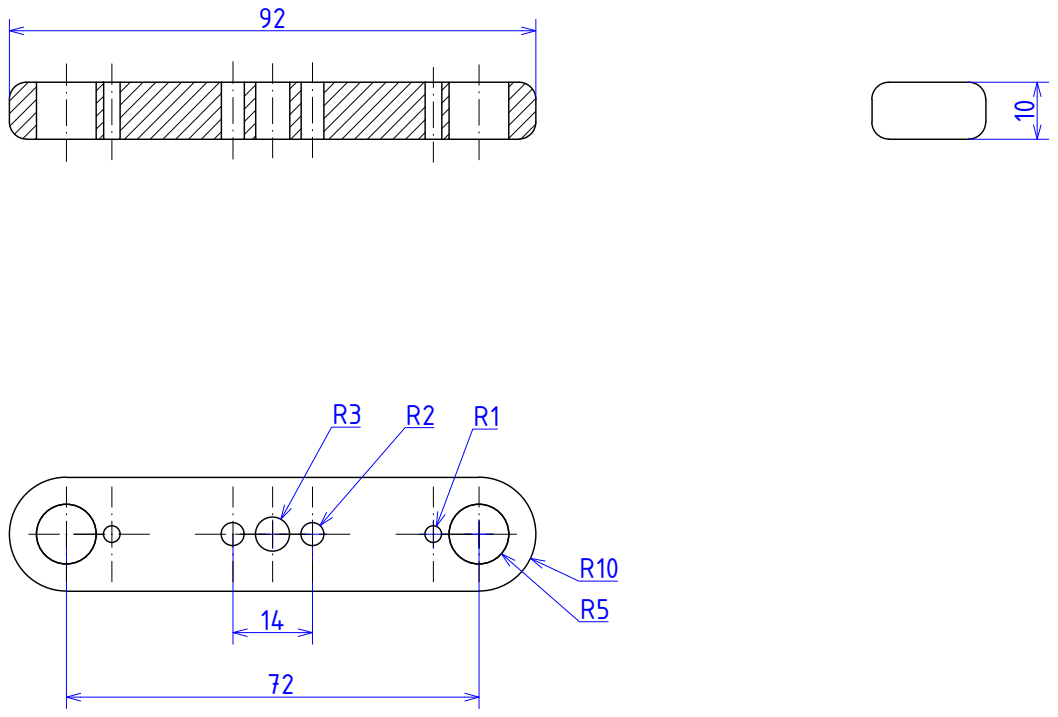
[picture p352: page 21]

10 9272 14 R10 R5 R3 R2 R1 HCMUTE-0020-001 Lê Tấn Lộc N.X. Quang

TAY QUAY 30.12.23 Kiểm tra Người vẽ

Gang | 1:2

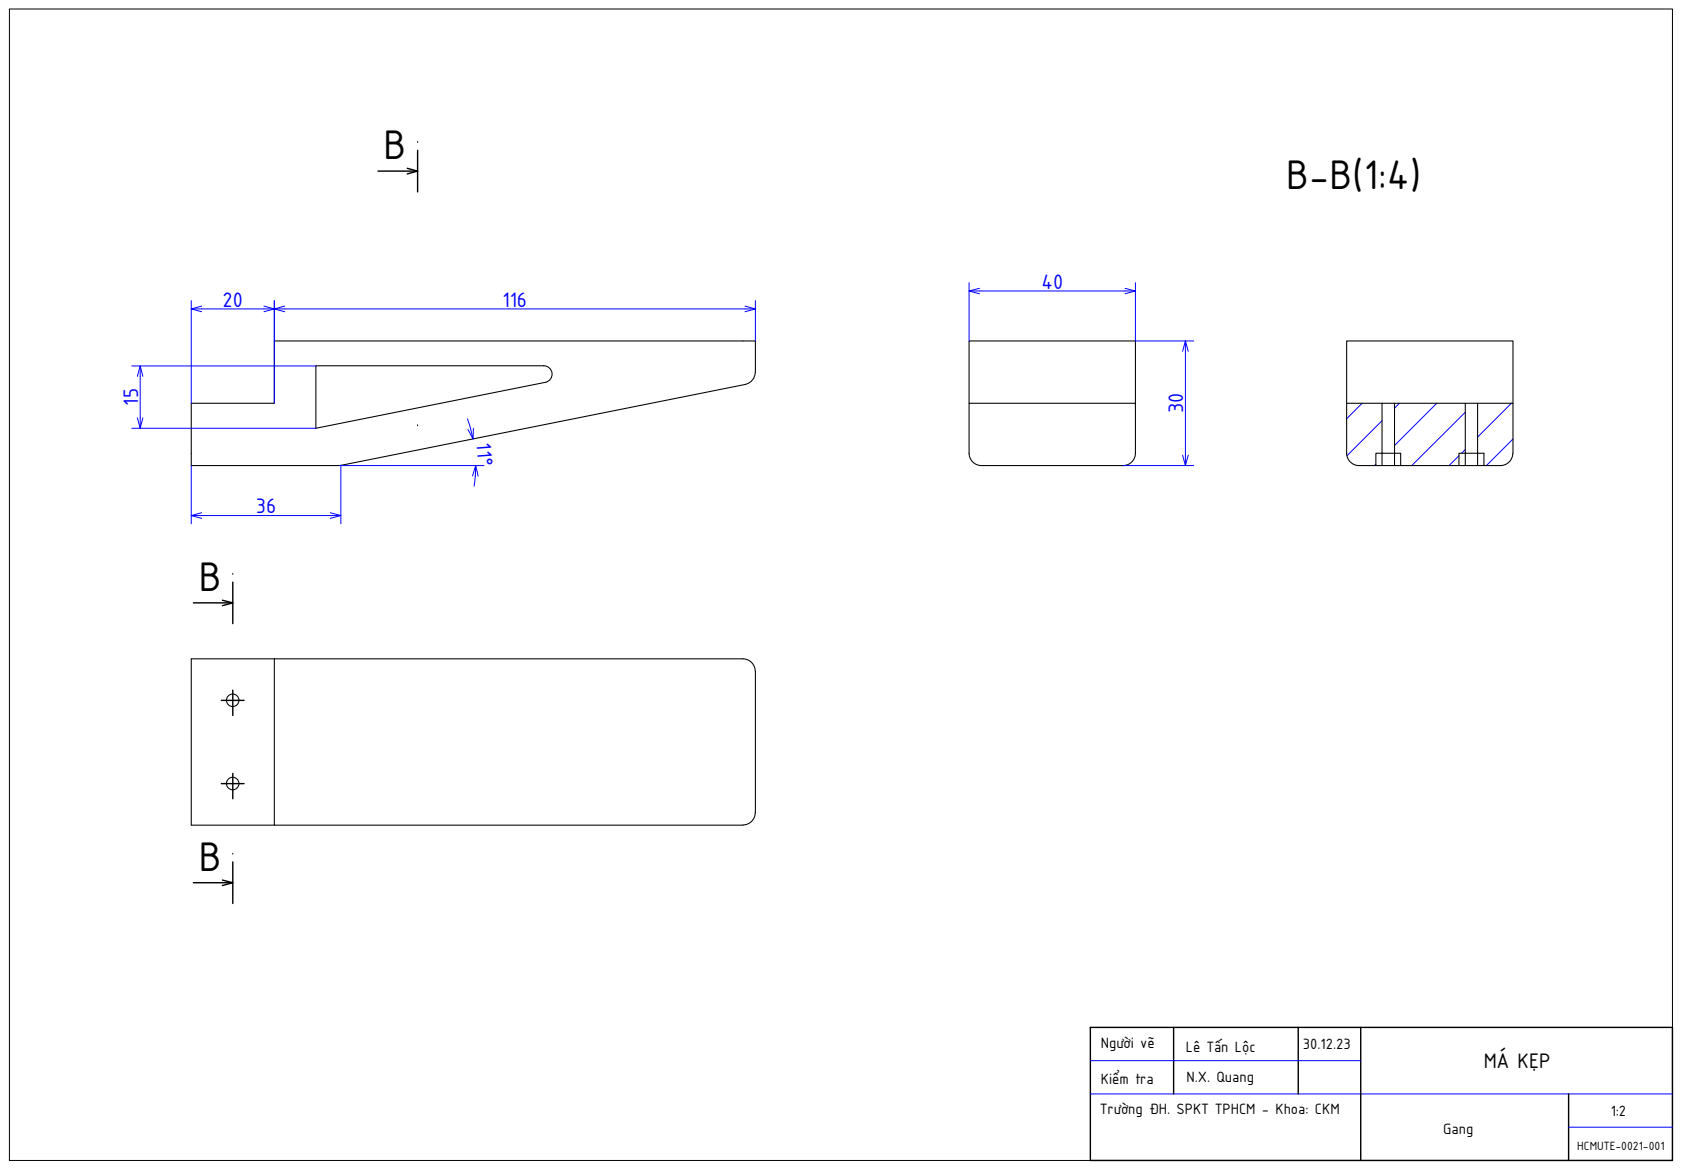
[picture p353: page 22]
Gang

15 BB20 HCMUTE-0021-001 Lê Tấn Lộc N.X. Quang

MÁ KẸP 30.12.23 Kiểm tra Người vẽ

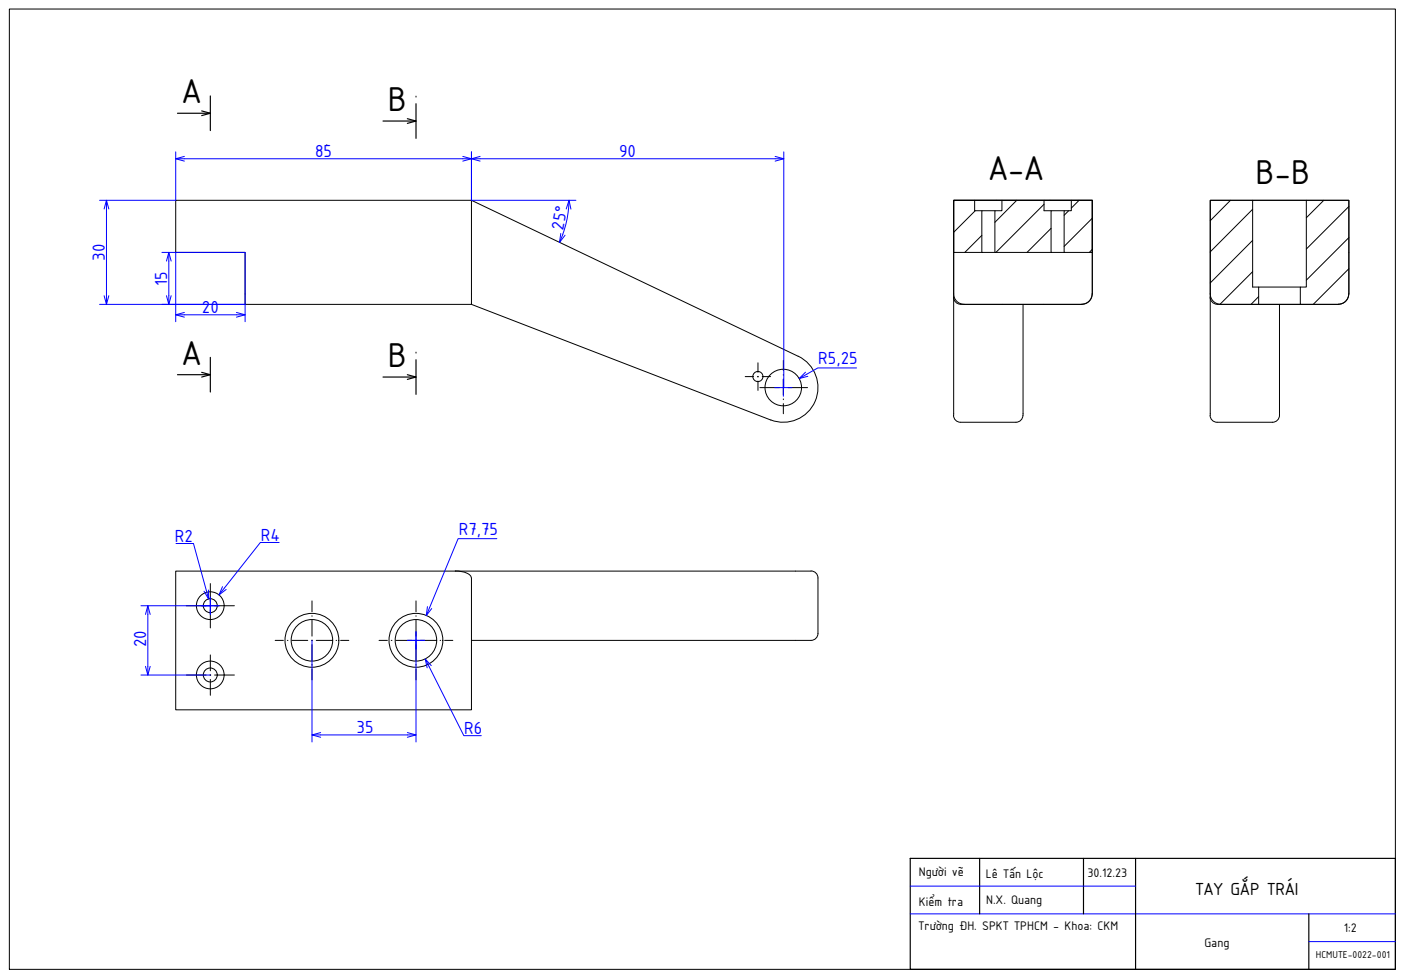
[picture p354: page 23]
TAY GẮP TRÁI Lê Tấn Lộc; 30.12.23 Kiểm tra Người vẽ; Gang; 20 35 HCMUTE-0022-001 N.X. Quang

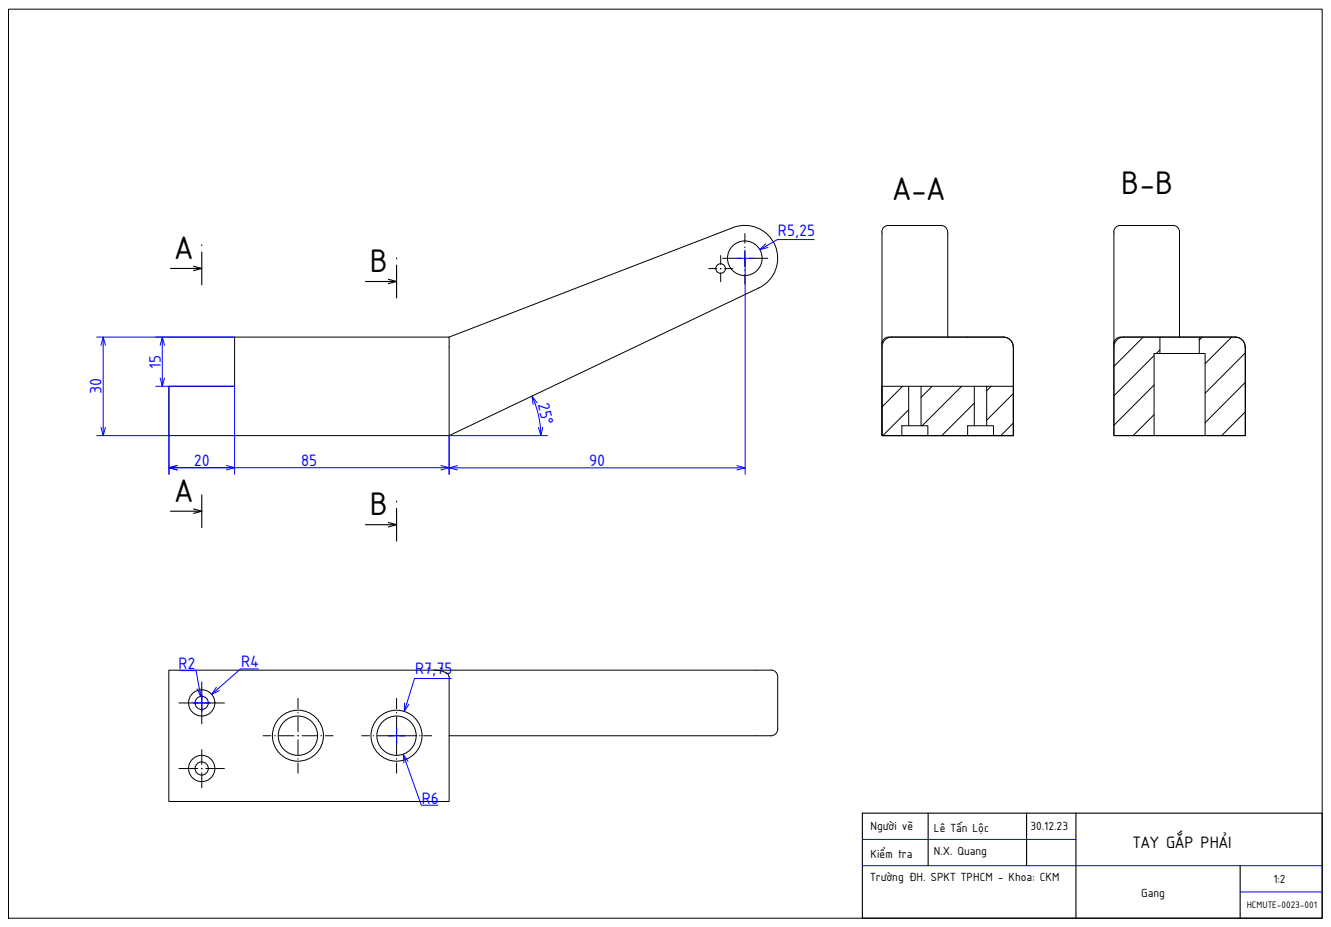
[picture p355: page 24]
TAY GẮP PHẢI Lê Tấn Lộc; 30.12.23 Kiểm tra Người vẽ; Gang; 30 R7,75 R6 R2 R4 B-B HCMUTE-0023-001 N.X. Quang

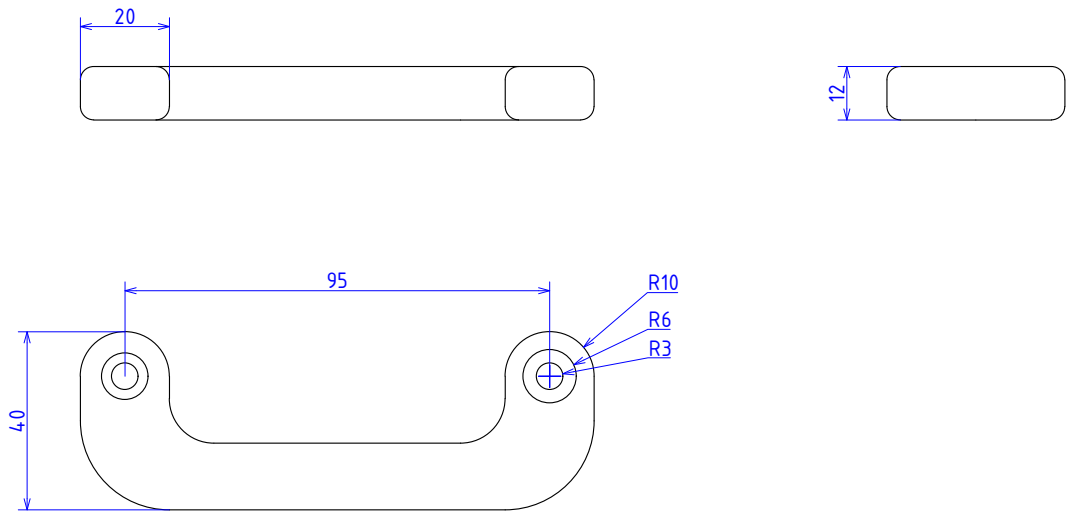
[picture p356: page 25]
Gang

12 HCMUTE-0024-001 N.X. Quang Lê Tấn Lộc

KHỚP NỐI 30.12.23 Kiểm tra Người vẽ
