TNH510/5_DOF_Robot_Arm/drawing/print/ban-ve-lap.pdf

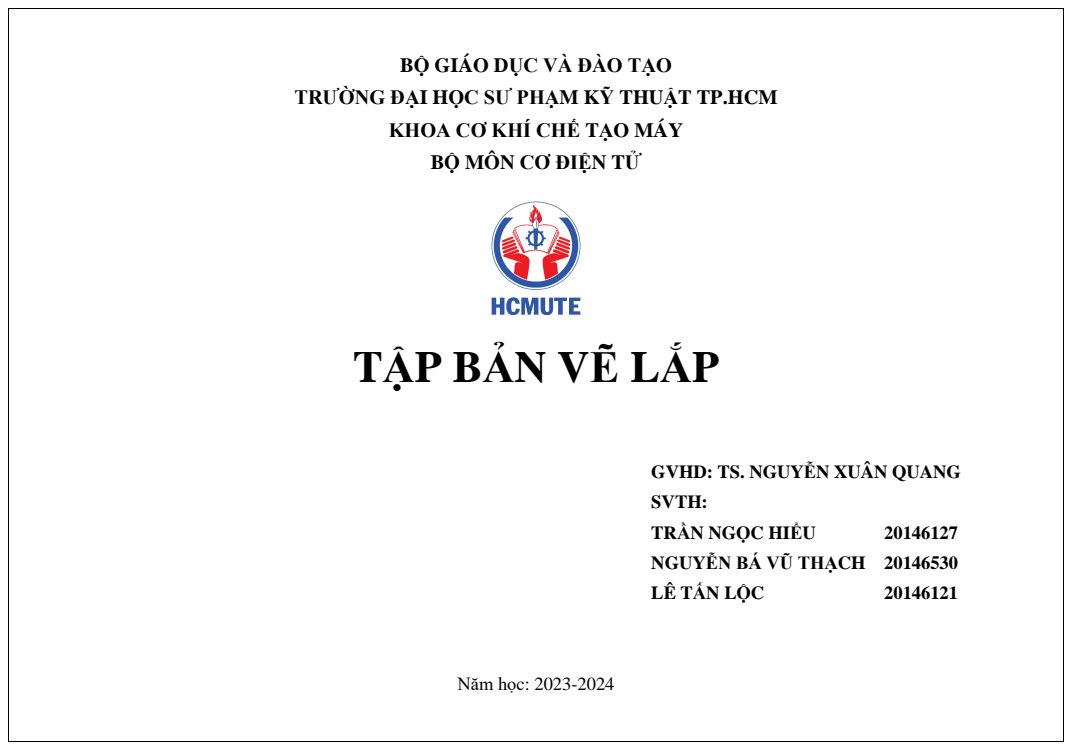
[picture p357: page 1]
TRẦN NGỌC HIỂU; LÊ TẤN LỘC; Năm học: 2023-2024

BỘ GIÁO DỤC VÀ ĐÀO TẠO

TRƯỜNG ĐẠI HỌC SƯ PHẠM KỸ THUẬT TP.HCM

KHOA CƠ KHÍ CHẾ TẠO MÁY
BỘ MÔN CƠ ĐIỆN TỬ

TẬP BẢN VẼ LẮP

GVHD: TS. NGUYỄN XUÂN QUANG

SVTH:
NGUYỄN BÁ VŨ THẠCH 20146530

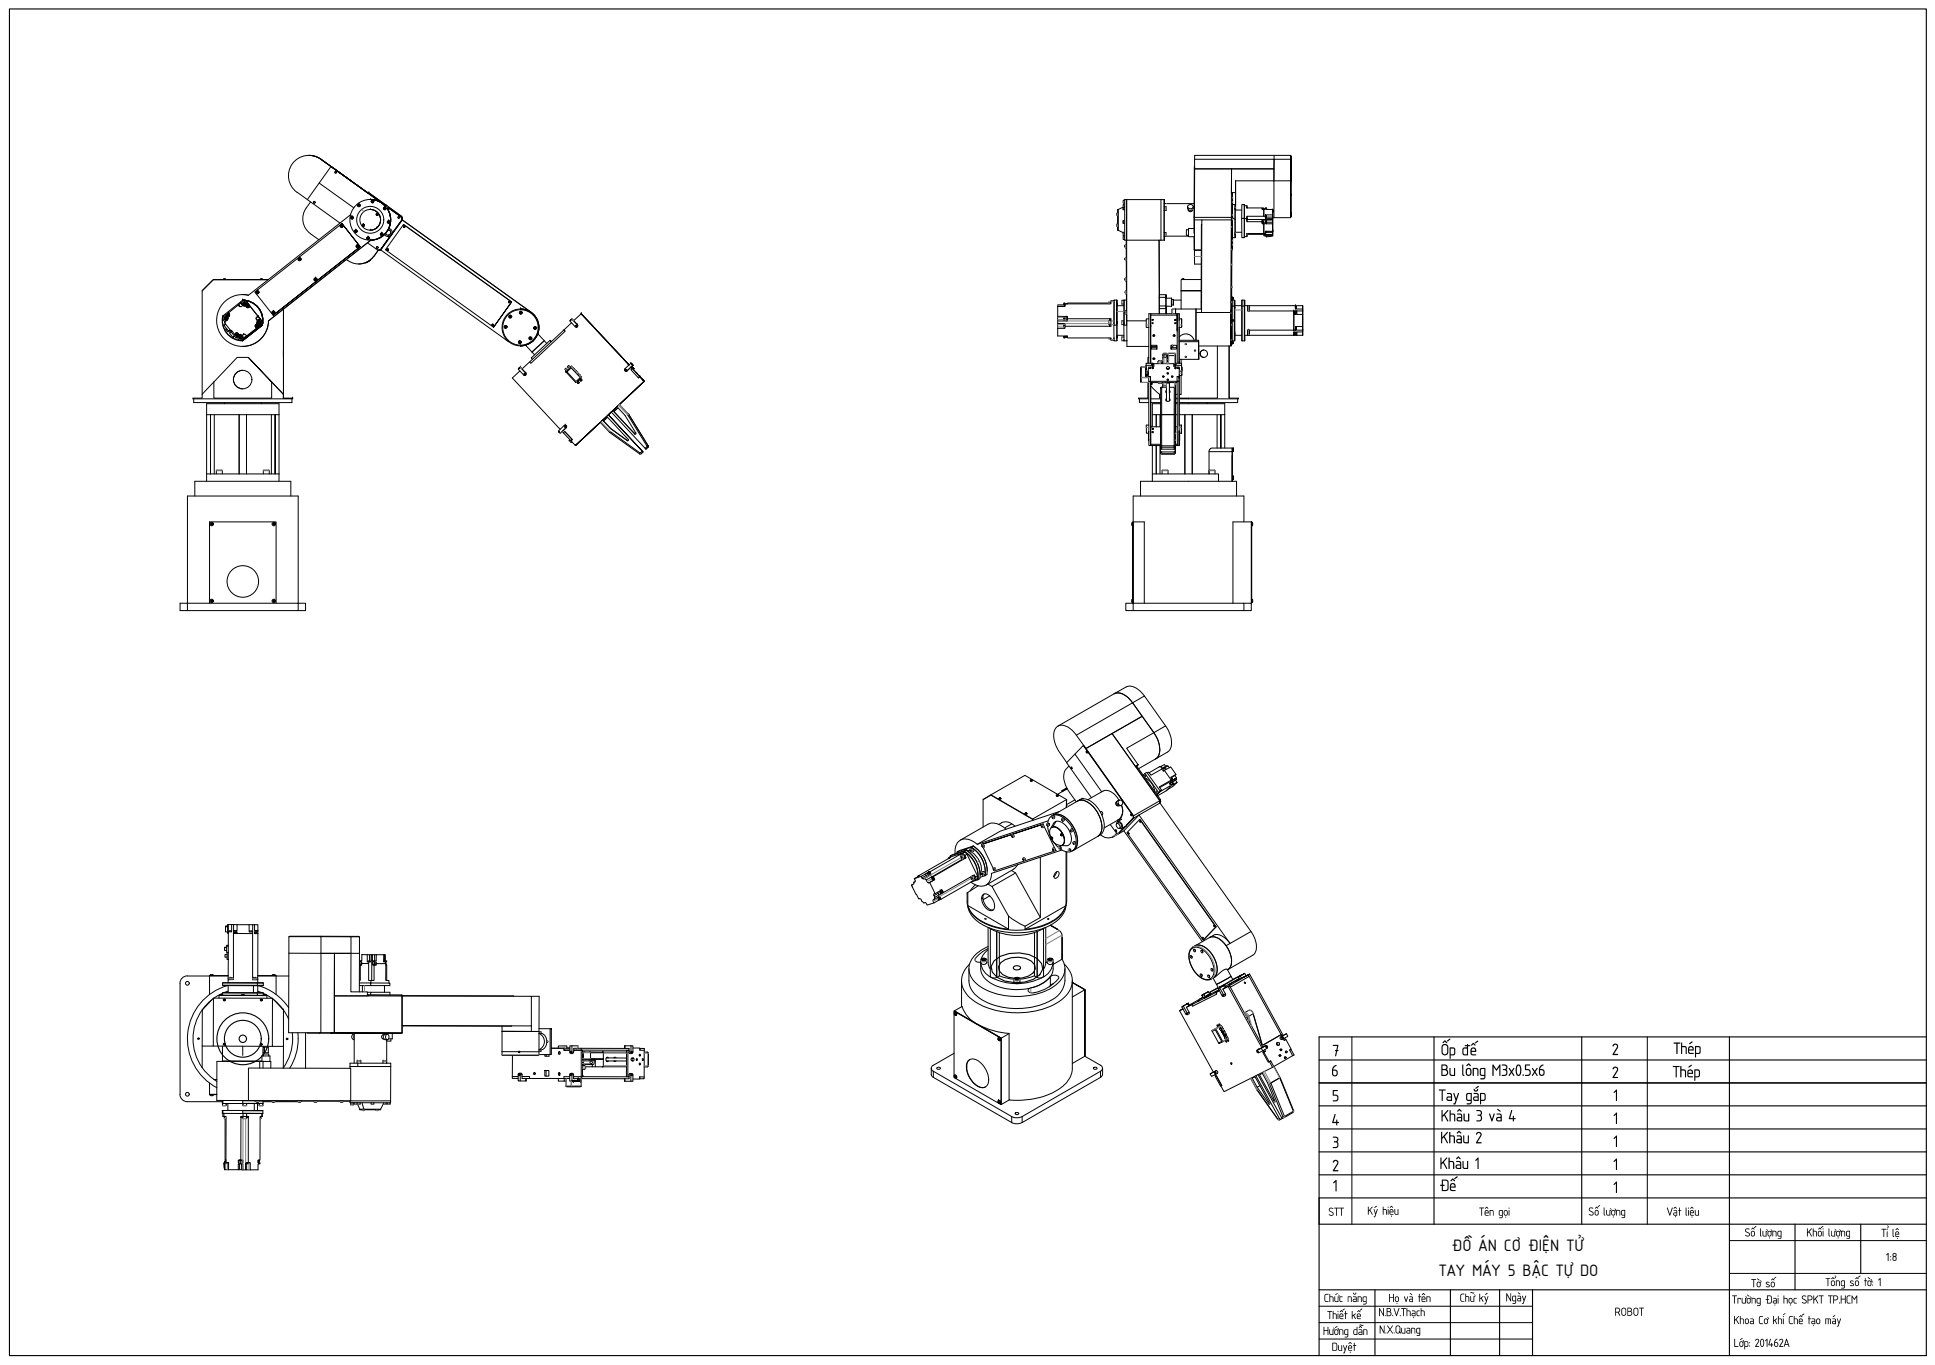
[picture p358: page 2]
Chức năng Thiết kế; Hướng dẫn; Họ và tên N.B.V.Thạch STT; Ký hiệu; Trường Đại học SPKT TP.HCM; 1 Khâu 1; 1 N.X.Quang; TAY MÁY 5 BẬC TỰ DO Khâu 3 và 4; ROBOT Chữ ký; Ngày; Số lượng; Khối lượng; Tổng số tờ: 1; 1:8 Tên gọi; Vật liệu; Lớp: 201462A; Khâu 2; 1 Tay gắp; Bu lông M3x0.5x6; Thép Ốp đế; Thép

1 ĐỒ ÁN CƠ ĐIỆN TỬ

Khoa Cơ khí Chế tạo máy

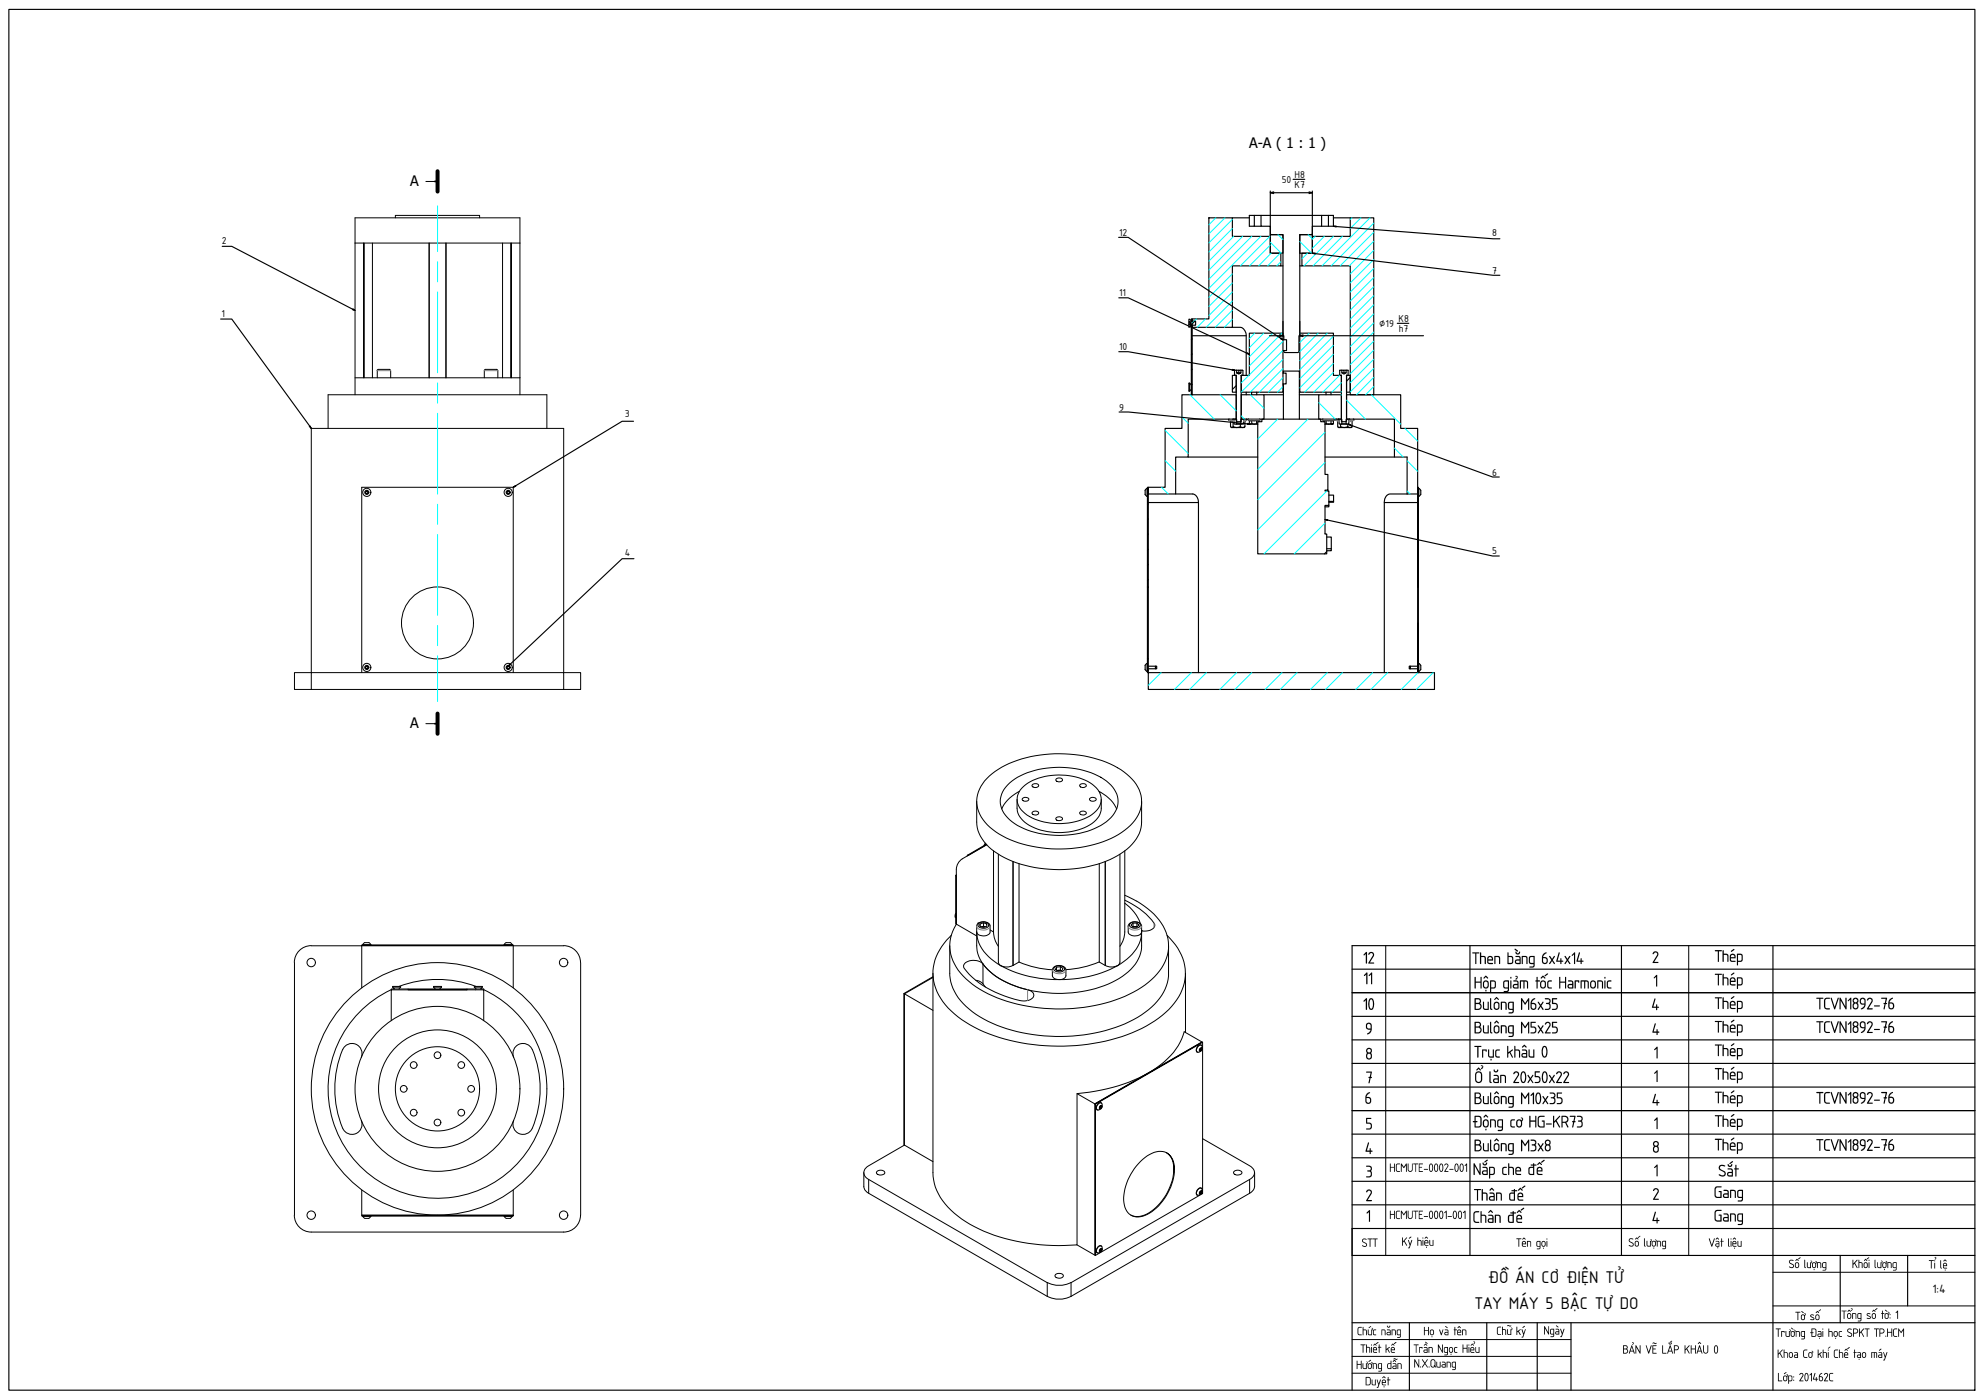
[picture p359: page 3]
∅19 K8h7 Chức năng; Trần Ngọc Hiểu STT; Ký hiệu 125; Trường Đại học SPKT TP.HCM Khoa Cơ khí Chế tạo máy Chân đế; Gang Thân đế; 2 N.X.Quang; 1 ĐỒ ÁN CƠ ĐIỆN TỬ TAY MÁY 5 BẬC TỰ DOBẢN VẼ LẮP KHÂU 0 Chữ ký; Ngày; Số lượng; Khối lượng; Tổng số tờ: 1; 1:4 Tên gọi; Vật liệu; Lớp: 201462C 34; Nắp che đế; 8 Động cơ HG-KR73 6710; Ổ lăn 20x50x22 891112; Trục khâu 0; 14144112 Bulông M3x8 Bulông M10x35 Bulông M6x35 Bulông M5x25 Hộp giảm tốc Harmonic Then bằng 6x4x14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

Họ và tên

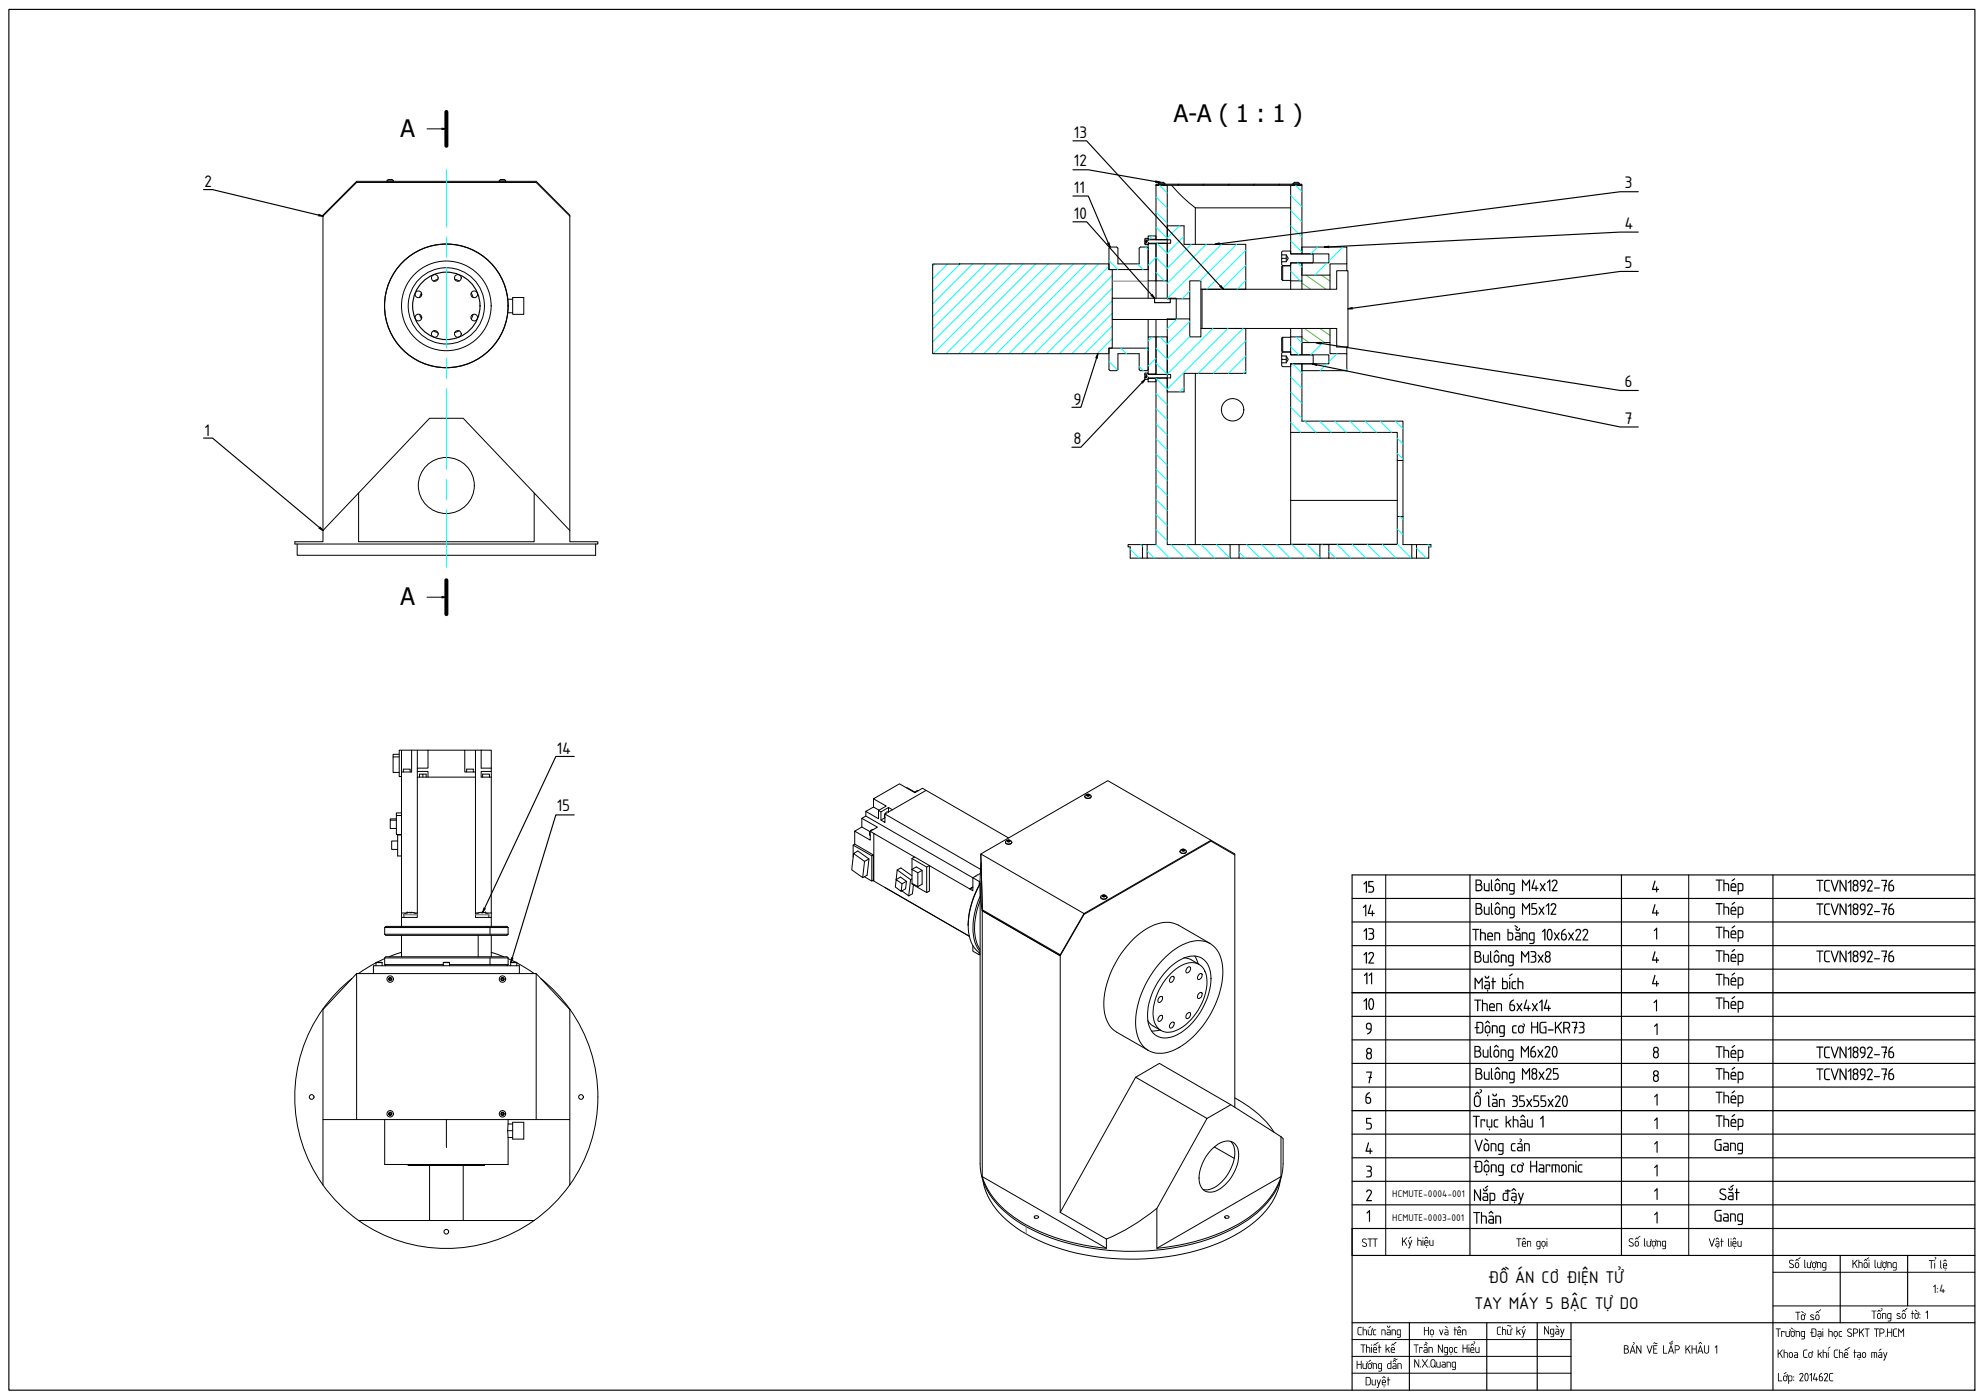
[picture p360: page 4]
Chức năng; Trần Ngọc Hiểu STT; Ký hiệu 125; Trường Đại học SPKT TP.HCM Khoa Cơ khí Chế tạo máy Thân; Gang Nắp đậy; 1 N.X.Quang; 1 ĐỒ ÁN CƠ ĐIỆN TỬ TAY MÁY 5 BẬC TỰ DOBẢN VẼ LẮP KHÂU 1 Chữ ký; Ngày; Số lượng; Khối lượng; Tổng số tờ: 1; 1:4 Tên gọi; Vật liệu; Lớp: 201462C 34; Động cơ Harmonic; 1 Trục khâu 1 6710; Bulông M8x25 89111213; Bulông M6x20; 118141841 Vòng cản Ổ lăn 35x55x20 Mặt bích Động cơ HG-KR73 Then 6x4x14 Bulông M3x8 Then bằng 10x6x22 1415; Bulông M5x12 Bulông M4x12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

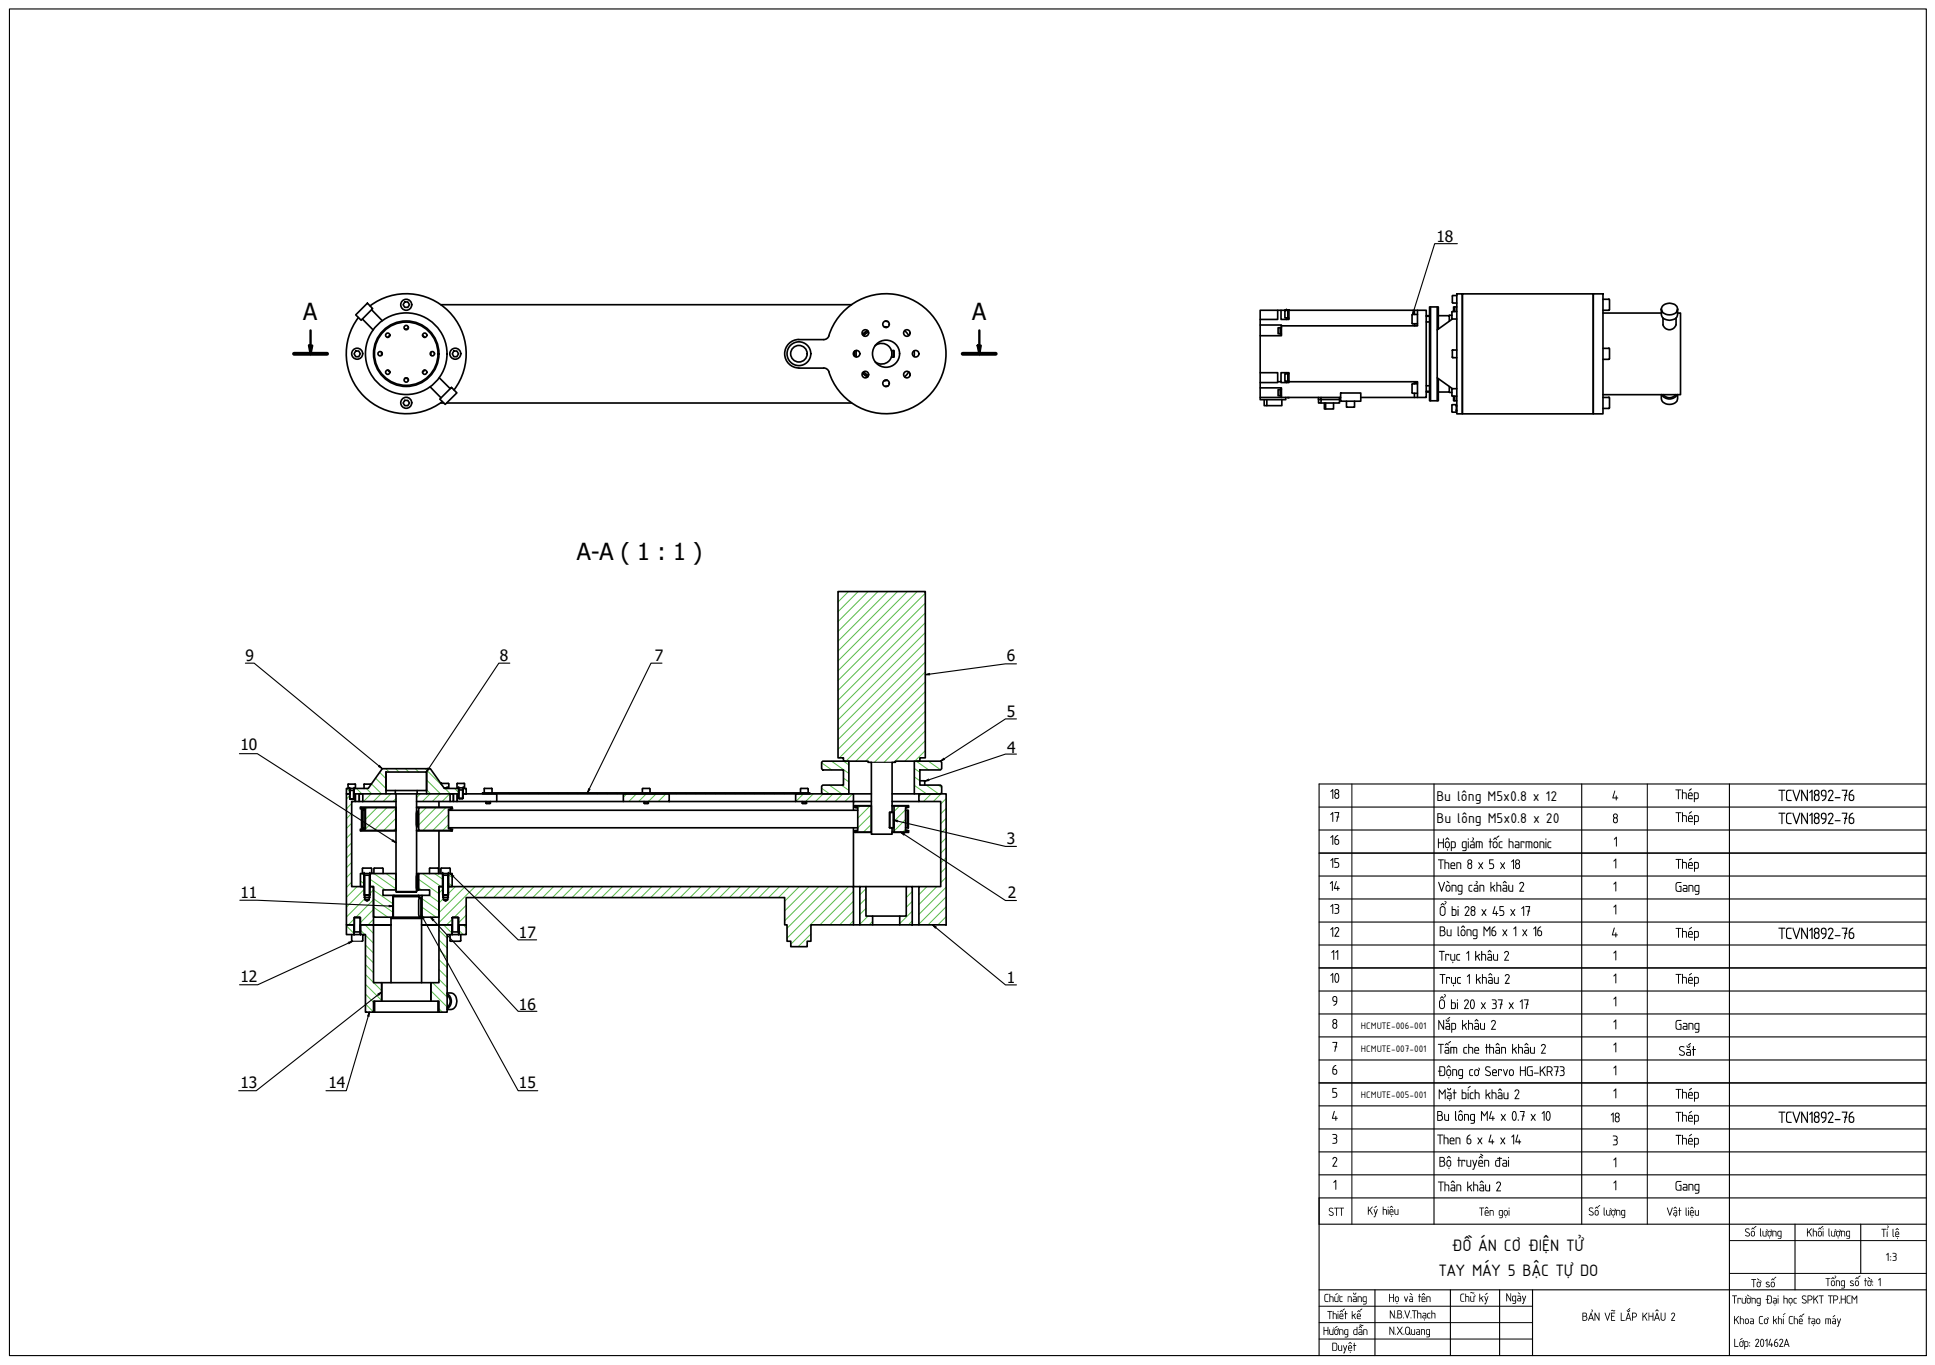
[picture p361: page 5]
Chức năng; Họ và tên N.B.V.Thạch STT; Ký hiệu; Trường Đại học SPKT TP.HCM; Chữ ký; Ngày; Số lượng; Khối lượng; Tổng số tờ: 1; 1:3 Tên gọi; Vật liệu; Lớp: 201462A Then 6 x 4 x 14; 18 Mặt bích khâu 2; Thép Thép Thép Gang; Thép Thép Thép Gang Thép Thép GangSắt; HCMUTE-005-001 HCMUTE-007-001 HCMUTE-006-001; TCVN1892-76 TCVN1892-76 TCVN1892-76 TCVN1892-76

Nắp khâu 2 Then 8 x 5 x 18 Bu lông M5x0.8 x 12 Bu lông M5x0.8 x 20 Trục 1 khâu 2 Vòng cản khâu 2 Ổ bi 28 x 45 x 17 Ổ bi 20 x 37 x 17 Hộp giảm tốc harmonic Trục 1 khâu 2 Bu lông M6 x 1 x 16

Tấm che thân khâu 2

Động cơ Servo HG-KR73
Bu lông M4 x 0.7 x 10
3 ĐỒ ÁN CƠ ĐIỆN TỬ

Khoa Cơ khí Chế tạo máy Thân khâu 2 Bộ truyền đai N.X.Quang

TAY MÁY 5 BẬC TỰ DO

BẢN VẼ LẮP KHÂU 2

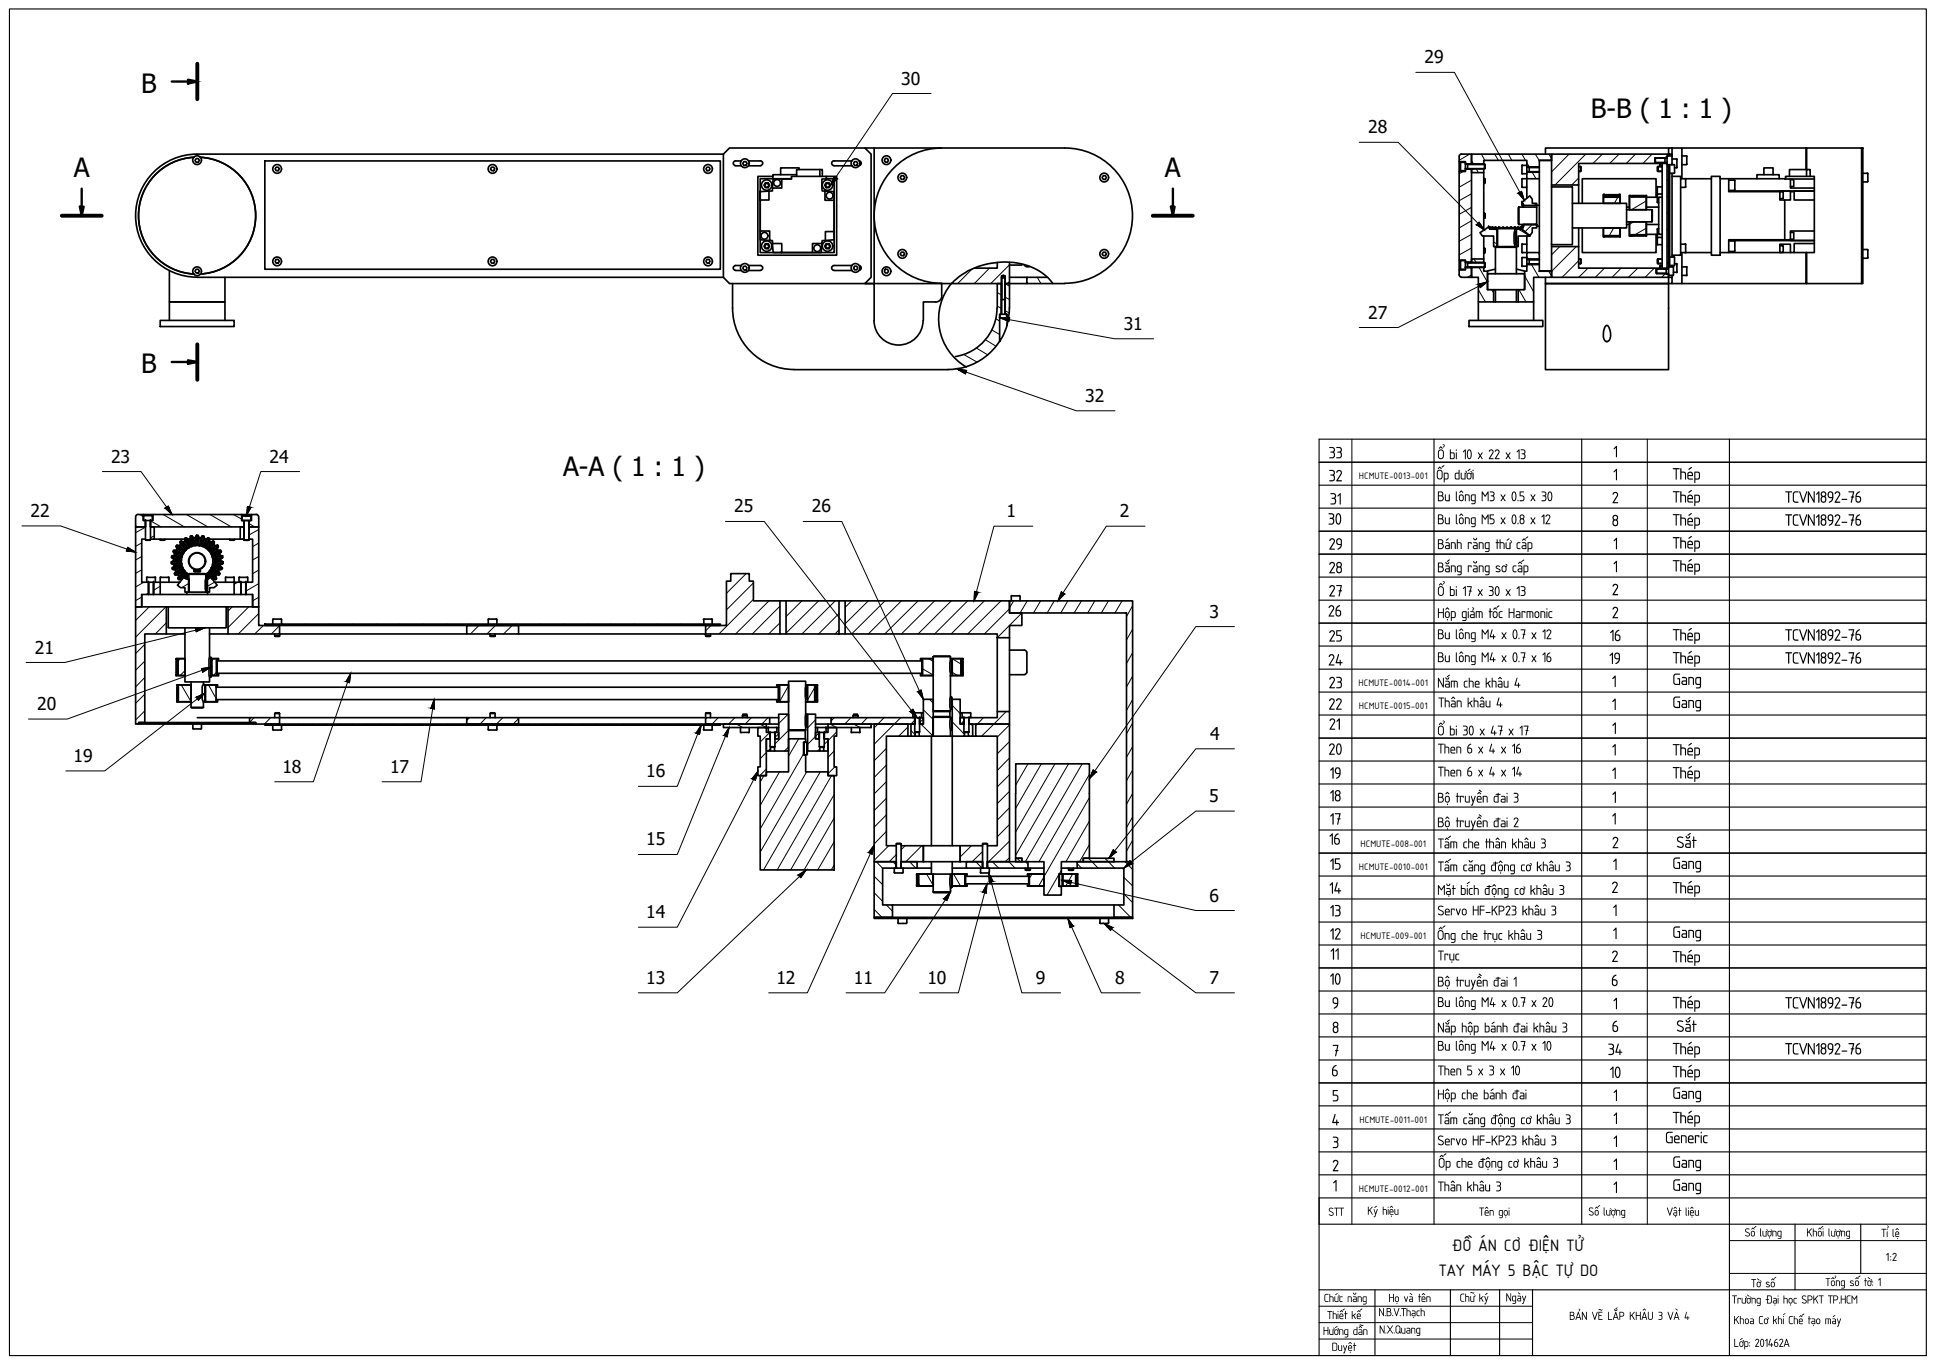
[picture p362: page 6]
27 Chức năng; Họ và tên N.B.V.Thạch STT; Ký hiệu 125; Trường Đại học SPKT TP.HCM Khoa Cơ khí Chế tạo máy Thân khâu 3; Gang Generic N.X.Quang; 1 ĐỒ ÁN CƠ ĐIỆN TỬ TAY MÁY 5 BẬC TỰ DO BẢN VẼ LẮP KHÂU 3 VÀ 4 Chữ ký; Ngày; Số lượng; Khối lượng; Tổng số tờ: 1; 1:2 Tên gọi; Vật liệu; Lớp: 201462A 34; 1 HCMUTE-0011-001 HCMUTE-009-001 HCMUTE-0010-001 HCMUTE-008-001 HCMUTE-0013-001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

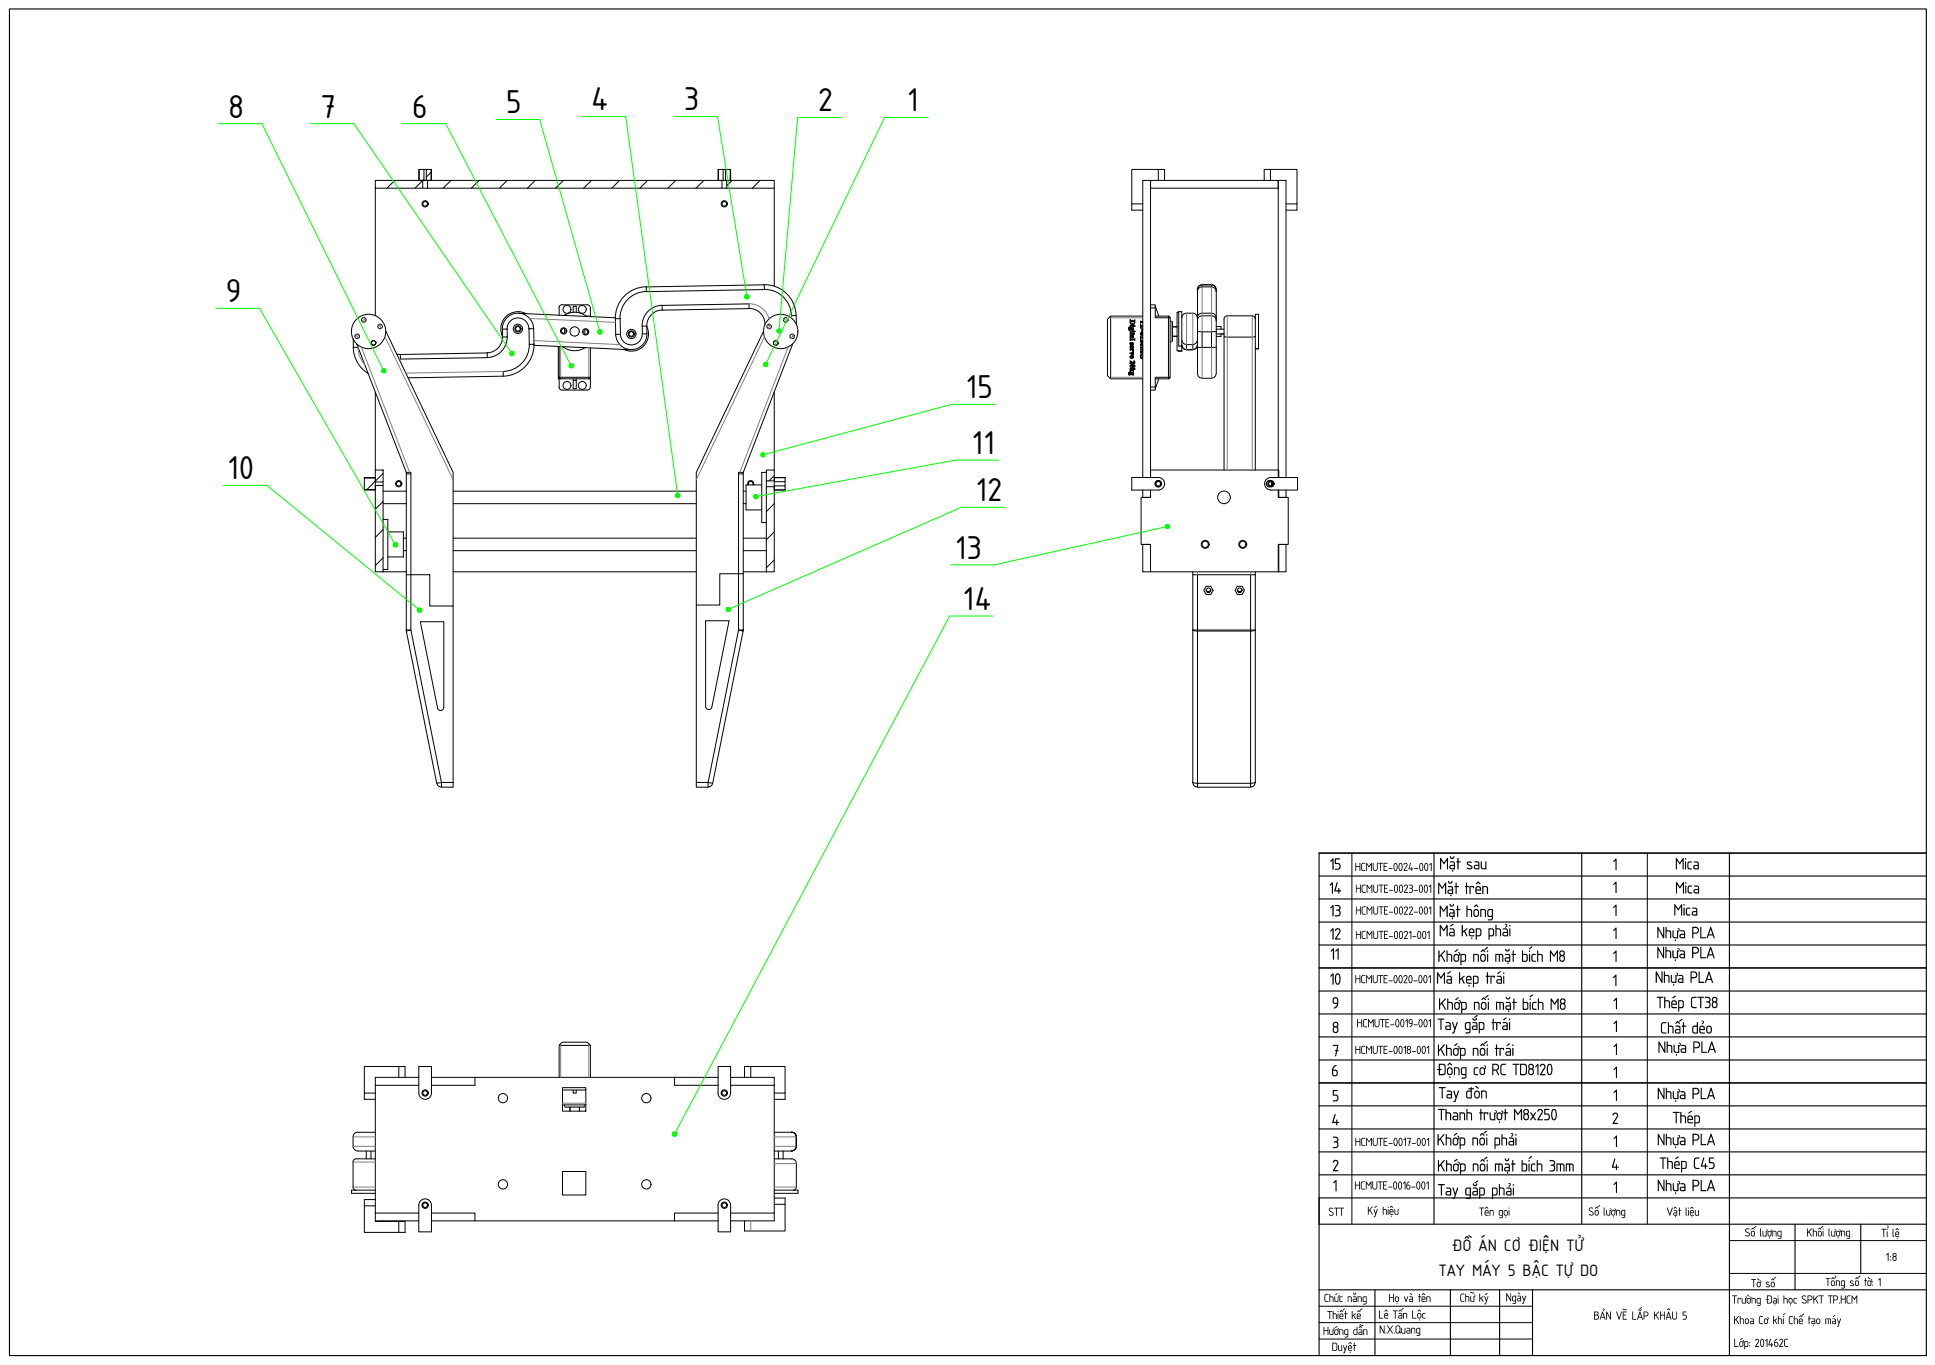
[picture p363: page 7]
Lê Tấn Lộc STT; Ký hiệu; Trường Đại học SPKT TP.HCM; Khoa Cơ khí Chế tạo máy HCMUTE-0016-001; Tay gắp phải; Nhựa PLA Khớp nối mặt bích 3mm; Thép C45 Nhựa PLA N.X.Quang; TAY MÁY 5 BẬC TỰ DO Thanh trượt M8x250; BẢN VẼ LẮP KHÂU 5; Thép Chữ ký; Ngày; Số lượng; Khối lượng; Tổng số tờ: 1; 1:8 Tên gọi; Vật liệu; Lớp: 201462C; Khớp nối phải; 2 Tay đòn; Động cơ RC TD8120 Khớp nối trái; Nhựa PLA; Chất dẻo; Nhựa PLA Mica Thép CT38; Mặt sau; MicaMica Nhựa PLA Nhựa PLA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

Mặt trên
Mặt hông
Má kẹp phải
Khớp nối mặt bích M8
Má kẹp trái
Tay gắp trái

Nhựa PLA Chức năng

1 ĐỒ ÁN CƠ ĐIỆN TỬ
