TNH510/5_DOF_Robot_Arm/docs/final_project/final_test_data/moment/moment_oke.xlsx

Axis1
Number of sampling data
Sampling time interval(ms)
Time | Analog 2 | Analog 3 | Digital 1 | Digital 2 | Digital 3 | Digital 4
ms | Torque | Droop pulses (by 1 pls.) | INP | Not selected | Not selected | Not selected
0 | -2.8 | -3221 | 0 | 0 | 0 | 0
47.111064 | -1.7 | -3127 | 0 | 0 | 0 | 0
94.222128 | -2.6 | -3180 | 0 | 0 | 0 | 0
141.333192 | -3.7 | -3283 | 0 | 0 | 0 | 0
188.444256 | -3.5 | -3266 | 0 | 0 | 0 | 0
235.55532 | -3.3 | -3116 | 0 | 0 | 0 | 0
282.666384 | -3.4 | -3104 | 0 | 0 | 0 | 0
329.777448 | -2.6 | -3076 | 0 | 0 | 0 | 0
376.888512 | -2.6 | -3060 | 0 | 0 | 0 | 0
423.999576 | -3.9 | -3146 | 0 | 0 | 0 | 0
471.11064 | -4 | -3160 | 0 | 0 | 0 | 0
518.221704 | -3.3 | -2996 | 0 | 0 | 0 | 0
565.332768 | -2.9 | -2950 | 0 | 0 | 0 | 0
612.443832 | -3.1 | -2913 | 0 | 0 | 0 | 0
659.554896 | -2.4 | -2868 | 0 | 0 | 0 | 0
706.66596 | -2 | -2934 | 0 | 0 | 0 | 0
753.777024 | -3.3 | -3050 | 0 | 0 | 0 | 0
800.888088 | -3.4 | -3014 | 0 | 0 | 0 | 0
847.999152 | -2.5 | -2823 | 0 | 0 | 0 | 0
895.110216 | -2.5 | -2844 | 0 | 0 | 0 | 0
942.22128 | -2.9 | -2846 | 0 | 0 | 0 | 0
989.332344 | -2.5 | -2790 | 0 | 0 | 0 | 0
1036.443408 | -2.2 | -2864 | 0 | 0 | 0 | 0
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
