TNH510/5_DOF_Robot_Arm/docs/final_project/final_test_data/moment/moment_oke.csv

Axis1
Number of sampling data | 640
Sampling time interval(ms) | 47.111
Time | Analog 1 | Analog 2 | Analog 3 | Digital 1 | Digital 2 | Digital 3 | Digital 4
ms | Motor speed | Torque | Droop pulses (by 1 pls.) | INP | Not selected | Not selected | Not selected
0.000000 | -20.000000 | -2.800000 | -3221.000000 | 0.000000 | 0.000000 | 0.000000 | 0.000000
47.111064 | -20.000000 | -1.700000 | -3127.000000 | 0.000000 | 0.000000 | 0.000000 | 0.000000
94.222128 | -21.000000 | -2.600000 | -3180.000000 | 0.000000 | 0.000000 | 0.000000 | 0.000000
141.333192 | -20.000000 | -3.700000 | -3283.000000 | 0.000000 | 0.000000 | 0.000000 | 0.000000
188.444256 | -19.000000 | -3.500000 | -3266.000000 | 0.000000 | 0.000000 | 0.000000 | 0.000000
235.555320 | -21.000000 | -3.300000 | -3116.000000 | 0.000000 | 0.000000 | 0.000000 | 0.000000
282.666384 | -21.000000 | -3.400000 | -3104.000000 | 0.000000 | 0.000000 | 0.000000 | 0.000000
329.777448 | -19.000000 | -2.600000 | -3076.000000 | 0.000000 | 0.000000 | 0.000000 | 0.000000
376.888512 | -19.000000 | -2.600000 | -3060.000000 | 0.000000 | 0.000000 | 0.000000 | 0.000000
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
