TNH510/5_DOF_Robot_Arm/docs/final_project/final_test_data/moment/moment_oke.jpg

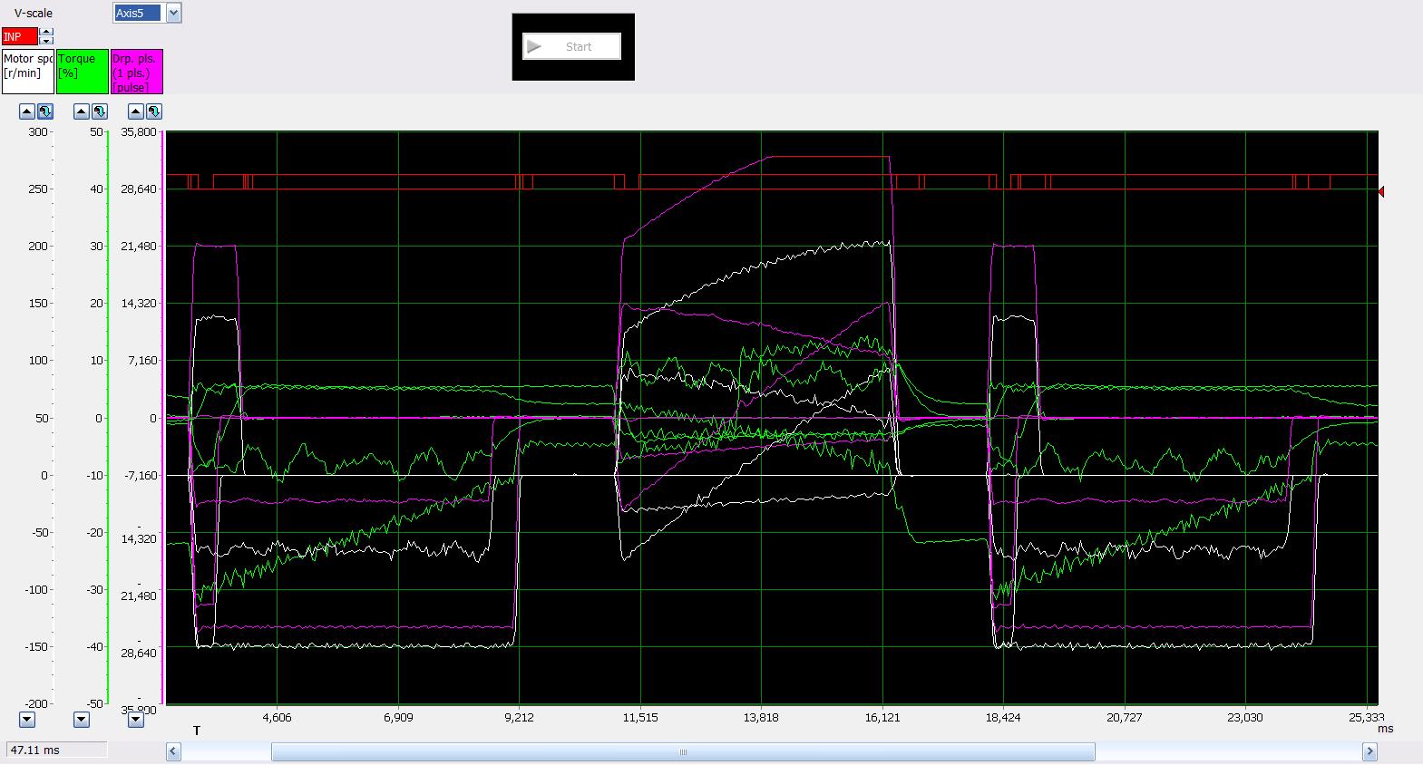
docs/final_project/final_test_data/moment/moment_oke.jpg
