TNH510/5_DOF_Robot_Arm/(threads)

Thread 11 (2023-10-26):

Thiết kế cơ khí và trình bày tính toán, mô phỏng cho đầu tay gắp

TNH510, 2023-10-26:

hieutranngoc-itr, 2023-11-18:
- [ ] Thiết kế xong phần 3D cơ khí hoàn thiện (tiêu chí nhỏ gọn nhất, tối ưu nhất) (Nhớ check phần tính toán để chừng viết báo cáo dễ hơn)
- [ ] In 3D và cắt mica, hoàn thành lắp ráp hoàn chỉnh và test chuyển động OK
- [ ] Thiết kế mạch điều khiển cho động cơ RC-Servo (có thể gồm 1 STM32, Mạch nguồn cho STM32, dây UART ?, ...)
- [ ] Gia công và lắp ráp vào đầu tay gắp sao cho đẹp, hợp lí, hiệu quả nhất
- [ ] Điều khiển được đầu tay gắp từ PLC hoặc máy tính (ưu tiên PLC hơn vì gần và hiệu quả hơn)

Thread 3 (2023-10-26):

Mô phỏng động học thuận, nghịch của robot

TNH510, 2023-10-26:
- [x] Tạo lại project simulink
- [x] Tạo guide chỉnh 5 góc robot mô phỏng
- [x] Tạo guide hiển thị động học thuận (Nhập góc, tính ra vị trí)
- [x] Tạo guide điều khiển động học nghịch (Nhập vị trí tự tính góc)

Closed 2023-11-08.

Thread 14 (2023-10-28):

Giao tiếp từ Máy tính tới PLC để điều khiển Robot qua C#

TNH510, 2023-10-28:
- [x] Connection
- [x] ON/OFF Servo
- [x] Go home
- [x] Set home
- [x] Clear error
- [x] Brake

Thachhcmute3001, 2023-10-29:
# A first-level heading
## A second-level heading
### A third-level heading

TNH510, 2023-10-29:
- [ ]

Closed 2023-11-02.

Thread 18 (2023-10-29):

Viết chương trình chạy 4 trục đồng thời trên PLC

TNH510, 2023-10-29:
- [x] Viết chương trình trên MT nhận value từ 4 ô nhớ
- [x] Viết chương trình trên GX enable/disable
- [x] Viết chương trình go home dùng nội suy 4 trục

Closed 2023-11-02.

Thread 22 (2023-11-08):

Nghiên cứu, tìm các nguồn nghiên cứu có liên quan đến găng tay robot

TNH510, 2023-11-08:
https://www.slideshare.net/man2017/thit-k-h-thng-iu-khin-m-phng-chuyn-ng-cnh-taypdf
https://www.researchgate.net/publication/333335847_Semi-Autonomous_Robot_Teleoperation_With_Obstacle_Avoidance_via_Model_Predictive_Control

https://www.ncbi.nlm.nih.gov/pmc/articles/PMC7309037/
https://x-io.co.uk/open-source-imu-and-ahrs-algorithms/

https://www.youtube.com/watch?v=5HuN9iL-zxU
Lọc nhiễu Kanman: https://kdientu.duytan.edu.vn/media/133474/bo-loc-kalman.pdf

hieutranngoc-itr, 2023-11-18:
- [ ] Thiết kế hệ thống cho găng tay điều khiển (các linh kiện cần sử dụng, module)
- [ ] Thiết kê mạch điện, nối dây, vẽ mạch
- [ ] Thiết kế cơ khí, cách sắp xếp, bố trí các linh kiện trên cánh tay
- [ ] Giao tiếp không dây qua RF giữa main board và máy tính
- [ ] Thu thập được dữ liệu góc từ cánh tay kết hợp lọc nhiễu KANMAN
- [ ] Nghiên cứu và hoàn thiện thuật toán điều khiển vị trí đầu tay gắp từ các góc trên cánh tay sao cho mượt mà nhất

Closed 2024-03-02.

Thread 24 (2023-11-08):

Điều khiển chạy quỹ đạo (thẳng, tròn) và mô phỏng trên MATLAB cho cánh tay robot

TNH510, 2023-11-08:
- [x] Điều khiển chạy được tương đối quỹ đạo đường thẳng và đường tròn theo đa điểm
- [x] Mô phỏng cánh tay robot chạy theo quỹ đạo trên MATLAB
- [x] Xác định vùng không gian hoạt động thỏa mãn các điều kiện của robot thực tế trên MATLAB

Closed 2023-11-18.

Thread 29 (2023-11-18):

Tính toán, trình bày về lực, điều khiển động cơ, ... cho đầu tay gắp

hieutranngoc-itr, 2023-11-18:
https://www.academia.edu/44552057/Nghi%C3%AAn_c%E1%BB%A9u_thi%E1%BA%BFt_k%E1%BA%BF_v%C3%A0_%C4%91i%E1%BB%81u_khi%E1%BB%83n_tay_m%C3%A1y_g%E1%BA%AFp_c%C3%A1c_th%C3%B9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

Closed 2024-01-08.

Thread 50 (2023-11-18):

Hoàn thiện file báo cáo đồ án (Format, các nội dung chém gió)

hieutranngoc-itr, 2023-11-18:

TNH510, 2023-12-29:
CHƯƠNG 2: CƠ SỞ LÝ THUYẾT
- [ ] Cơ sở lý thuyết về công nghệ
  - Các công nghệ và tính năng được ứng dụng trong robot bốc xếp
- [ ] Cơ sở lý thuyết về cơ khí
  - Cấu hình của robot
  - Các loại đầu tay gắp
- [ ] Cơ sở lý thuyết về điện điện tử
  - Hệ thống điều khiển bằng PLC cùng driver
- [ ] Cơ sở lý thuyết về lập trình giao diện
  - Lập trình giao diện trên máy tính

CHƯƠNG 3: NGHIÊN CỨU ĐỘNG HỌC VÀ ĐỘNG LỰC HỌC TAY MÁY
- [ ] Tính toán
    +	Tính toán động học thuận vị trí
    +	Tính toán động học nghịch vị trí
    +	Tính toán động lực học
- [ ] Mô phỏng MATLAB
    +	Xây dựng mô hình robot trên Simulink
    +	Mô phỏng vị trí dựa trên kết quả tính toán
CHƯƠNG 4: NGHIÊN CỨU, PHÁT TRIỂN THIẾT KẾ CƠ KHÍ
- [ ] Nghiên cứu cơ khí phần cánh tay robot
    +	Cấu tạo cơ khí của các khâu
    +	Các bộ truyền và thông số
    +	Thông số động cơ và công suất
- [ ] Phát triển phần đầu tay gắp cho cánh tay robot
    +	Các yêu cầu của đầu tay gắp
    +	Chọn loại cơ cấu cho tay gắp
    +	Tính toán lực và chọn động cơ (Vẽ biểu đồ lực và vị trí)
CHƯƠNG 5: THIẾT KẾ HỆ THỐNG ĐIỀU KHIỂN
- [ ] Thiết kế hệ thống điện
+	Hệ thống điện điều khiển (bản vẽ, giải thích)
- [ ] Thiết kế giải thuật điều khiển khiển
+	Các câu lệnh điều khiển
    +	Set Home
    +	Go Home
    +	Chạy JOG
    +	Chạy đơn điểm (MoveJ)
    +	Chạy đa điểm (MoveL, MoveC)
CHƯƠNG 6: THIẾT KẾ ỨNG DỤNG GIÁM SÁT VÀ ĐIỀU KHIỂN
- [ ] Thiết kế giao diện điều khiển bằng C#
    +	Tổng quan giao diện chính
    +	Kết nối với PLC từ máy tính
    +	Đọc giá trị góc trả về từ PLC
    +	Gửi câu lệnh điều khiển xuống PLC
    +	Kết nối với MATLAB để thực hiện xử lí dữ liệu góc
- [ ] Thiết kế giao diện giám sát bằng MATLAB
    +	Tổng quan về giao diện giám sát trên MATLAB
    +	Giao thức truyền và nhận thông tin từ C#
    +	Thể hiện hình dáng robot thực tế theo thời gian thực
    +	Vẽ đồ thị vị trí các góc, vị trí khâu chấp hành cuối và hỗ trợ xuất file data
CHƯƠNG 7: THI CÔNG, THỰC NGHIỆM VÀ PHÂN TÍCH KẾT QUẢ
- [ ] Thi công cơ khí
    +	Mô hình cơ khí thực tế của cánh tay robot
    +	Mô hình cơ khí thực tế của đầu tay gắp
- [ ] Thi công hệ thống điện
    +	Kết quả chụp hệ thống điện và set up khi kết nối với máy tính
- [ ] Thi công ứng dụng điều khiển
    +	Kết quả chạy thực tế của giao diện điều khiển và giám sát
- [ ] Thực nghiệm chạy robot
    +	Thiết kế hành trình chạy thực nghiệm
    +	Kết quả chạy thu được từ thực tế và trên giao diện giám sát
- [ ] Phân tích kết quả
    +	Về độ chính xác
    +	Về thời gian đáp ứng
    +	Về tính ổn định của hệ thống điều khiển và giám sát
CHƯƠNG 8: KẾT LUẬN
- [ ] Các vấn đề đã đạt được
- [ ] Các hạn chế của hệ thống
- [ ] Các giải pháp và hướng phát triển trong tương lai

Closed 2024-03-02.

Thread 56 (2023-12-29):

Báo cáo chương 3 - Động học, động lực học

Thachhcmute3001, 2023-12-29:
Thạch:
- [x] Tính toán
    +	[x] Tính toán động học thuận vị trí
    +	[x] Tính toán động học nghịch vị trí
- [x] Mô phỏng MATLAB
    +	[x] Xây dựng mô hình robot trên Simulink
        - [x] Link chi tiết từ Solidwork sang Matlab
        - [x] Xây dựng các khối điều khiển Robot
    +	[x] Mô phỏng vị trí dựa trên kết quả tính toán

Hiểu:
- [x] Tính toán
    +	[x] Tính toán động lực học
- [x] Mô phỏng MATLAB
    +	[x] Vẽ đồ thị biểu thị mối liên hệ giữa khối lượng vật gắp và moment tính được tại các khớp

Closed 2024-01-02.

Thread 57 (2023-12-29):

Báo cáo chương 6 - Ứng dụng giám sát và điều khiển

Thachhcmute3001, 2023-12-29:
@thachhcmute3001
- [x] Thiết kế giao diện điều khiển bằng C#
    +	[x] Tổng quan giao diện chính
    +	[x] Kết nối với PLC từ máy tính
    +	[x] Đọc giá trị góc trả về từ PLC
    +	[x] Gửi câu lệnh điều khiển xuống PLC
    +	[x] Kết nối với MATLAB để thực hiện xử lí dữ liệu góc

Hiểu:
- [ ] Thiết kế giao diện giám sát bằng MATLAB
    +	[ ] Tổng quan về giao diện giám sát trên MATLAB
    +	[ ] Giao thức truyền và nhận thông tin từ C#
    +	[ ] Thể hiện hình dáng robot thực tế theo thời gian thực
    +	[ ] Vẽ đồ thị vị trí các góc, vị trí khâu chấp hành cuối và hỗ trợ xuất file data

Closed 2024-01-03.

Thread 58 (2023-12-29):

Báo cáo chương 4 - Thiết kế cơ khí

TNH510, 2023-12-29:
CHƯƠNG 4: NGHIÊN CỨU, PHÁT TRIỂN THIẾT KẾ CƠ KHÍ
- [x] Nghiên cứu cơ khí phần cánh tay robot
    +	Cấu tạo cơ khí của các khâu
    +	Các bộ truyền và thông số
    +	Thông số động cơ và công suất
- [x] Phát triển phần đầu tay gắp cho cánh tay robot
    +	Các yêu cầu của đầu tay gắp
    +	Chọn loại cơ cấu cho tay gắp
    +	Tính toán lực và chọn động cơ (Vẽ biểu đồ lực và vị trí)

Closed 2024-01-02.

Thread 59 (2023-12-29):

Báo cáo chương 5 - Thiết kế hệ thống điều khiển

TNH510, 2023-12-29:
Lộc:
CHƯƠNG 5: THIẾT KẾ HỆ THỐNG ĐIỀU KHIỂN
- [ ] Thiết kế hệ thống điện
    +	Hệ thống điện điều khiển (bản vẽ, giải thích)
Hiểu:
- [x] Thiết kế giải thuật điều khiển khiển
+	Các câu lệnh điều khiển
    +	Set Home
    +	Go Home
    +	Chạy JOG
    +	Chạy đơn điểm (MoveJ)
    +	Chạy đa điểm (MoveL, MoveC)

Closed 2024-01-03.

Thread 74 (2024-03-02):

Nghiên cứu về phương pháp Madgwick algorithm lọc nhiễu cho IMU và MARG sensor

hieutranngoc-itr, 2024-03-02:
https://x-io.co.uk/open-source-imu-and-ahrs-algorithms/

https://www.youtube.com/watch?v=5HuN9iL-zxU
Lọc nhiễu Kanman: https://kdientu.duytan.edu.vn/media/133474/bo-loc-kalman.pdf

Closed 2024-03-16.

Thread 78 (2024-03-08):

Nghiên cứu, Thiết kế hệ thống cơ khí, chọn lựa linh kiện cho găng tay điều khiển

hieutranngoc-itr, 2024-03-08:
https://www.slideshare.net/man2017/thit-k-h-thng-iu-khin-m-phng-chuyn-ng-cnh-taypdf
https://www.researchgate.net/publication/333335847_Semi-Autonomous_Robot_Teleoperation_With_Obstacle_Avoidance_via_Model_Predictive_Control

https://www.ncbi.nlm.nih.gov/pmc/articles/PMC7309037/

Closed 2024-03-16.

Thread 85 (2024-03-23):

Thiết kế phần cứng cho găng tay điều khiển

hieutranngoc-itr, 2024-03-23:
https://www.ncbi.nlm.nih.gov/pmc/articles/PMC7309037/
https://www.youtube.com/watch?v=VOlzN9W4vVs

hieutranngoc-itr, 2024-03-29:
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

hieutranngoc-itr, 2024-03-29:
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

hieutranngoc-itr, 2024-05-10:
Đã chọn và đánh giá được tính khả thi của cơ cấu bánh răng, tiến hành mua và đo kích thước thật

Thread 88 (2024-04-06):

Xử lí góc và convert về tọa độ cánh tay người

hieutranngoc-itr, 2024-04-06:
https://www.researchgate.net/publication/360245258_IMU_Motion_Capture_Method_with_Adaptive_Tremor_Attenuation_in_Teleoperation_Robot_System
https://www.mdpi.com/2075-1702/11/7/669
https://en.wikipedia.org/wiki/Gimbal_lock#Solutions
https://automaticaddison.com/how-to-convert-a-quaternion-to-a-rotation-matrix/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
https://en.wikipedia.org/wiki/Euler_angles#Tait.E2.80.93Bryan_angles
https://www.andre-gaschler.com/rotationconverter/
https://www.quora.com/How-do-you-convert-a-quaternion-to-a-rotation-matrix-for-use-in-3D-calculations
https://www.andre-gaschler.com/rotationconverter/

hieutranngoc-itr, 2024-04-11:
Đã tính được động học thuận, còn bug chỗ set up hướng

Closed 2024-04-19.

Thread 93 (2024-04-18):

Viết phần thuật toán calib cho IMU và MARG trong C

hieutranngoc-itr, 2024-04-18:
https://www.magnetic-declination.com/
https://atadiat.com/en/e-magnetometer-soft-iron-and-hard-iron-calibration-why-how/
https://atadiat.com/en/e-towards-understanding-imu-frames-vpython-visualize-orientation/

Closed 2024-04-19.

Thread 94 (2024-04-20):

Viết thuật toán convert từ tọa độ cánh tay người sang tọa độ của Robot

hieutranngoc-itr, 2024-04-20:

hieutranngoc-itr, 2024-04-20:
+ Xác định không gian hoạt động của găng tay và các ràng buộc
+ Xác định không gian hoạt động của robot và kiểm tra
+ Vẽ 2 không gian hoạt động và tiến hành xác định hình dạng chung
+ Tiến hành tính hệ số convert và chạy mô phỏng
+ Tiến hành chạy thực tế

hieutranngoc-itr, 2024-04-20:
- Đã xác định được trục OXYZ sau khi tính kinematic (trục ban đầu trùng với trục khi thực hiện nạp các giá trị imu và marg vào biểu thức tính quaternion)
- Đã xác định được góc 0 độ của YAW là hướng Bắc (gần đúng)
- Đang tiến hành liên kết không gian cánh tay và robot lại

Closed 2024-05-06.

Thread 96 (2024-04-25):

Viết phần điều khiển robot từ vị trí truyền vào của găng tay qua UART

hieutranngoc-itr, 2024-04-25:
- [x] Điều khiển robot ảo
- [x] Điều khiển robot thật
- [x] Fix bug độ trễ cao khi truyền qua UART

Closed 2024-05-06.

Thread 103 (2024-05-19):

Tính toán bền cho găng tay

hieutranngoc-itr, 2024-05-19:
- [x] Thử tổng hợp kích thước các cánh tay của con người trưởng thành và chứng minh được thiết kế đeo là hợp lí
- [x] Tính toán bền tại khớp xoay (cơ cấu, trục, bánh răng, các lực đặt lên)

Thread 104 (2024-05-19):

Thêm phần calib vị trí ban đầu và nhân ma trận xoay để fix vị trí ban đầu khi sử dụng găng tay

hieutranngoc-itr, 2024-05-19:
- [ ] Nhân thêm 1 ma trận xoay quanh trục z với biến số bất kì
- [ ] Khi nhấn nút thì sẽ tự động set vị trí hiện tại là HOME, tự tính sai lệnh góc và set sai lệch đó vào ma trận xoay

Thread 106 (2024-05-19):

Đặt in 3D, đặt cắt mica và mua các linh kiện cho phần cơ khí

hieutranngoc-itr, 2024-05-19:
- [x] Chuẩn bị file MICA, đặt in MICA ở icdayroi
- [x] Chuẩn bị file in 3D, in các chi tiết
- [x] Lên list linh kiện cơ khí cần mua và tổng hợp lại (ốc, vít, ...)

Closed 2024-05-28.

Thread 114 (2024-05-28):

Báo cáo đồ án tốt nghiệp hoàn chỉnh

hieutranngoc-itr, 2024-05-28:
- [x] #117
- [x] #118
- [x] #119

hieutranngoc-itr, 2024-05-28:
- [ ] Hoàn thành phần tài liệu chi tiết về phần PLC và tool C# để điều khiển Cánh tay robot
- [ ] Hoàn thành phần tài liệu liên quan đến thiết kế, chế tạo, điều khiển găng tay robot
- [ ] Hoàn thành phần tài liệu liên quan đến đọc ảnh từ Camera và các thuật toán xử lí ảnh

Closed 2024-07-14.

Thread 117 (2024-05-28):

Hoàn thành tài liệu chi tiết về cách hoạt động của hệ thống PLC, tool C# để điều khiển robot

hieutranngoc-itr, 2024-05-28:

hieutranngoc-itr, 2024-05-28:
@Thachhcmute3001

Thachhcmute3001, 2024-06-01:
# Những nội dung chính
## Tổng quan về hệ thống điều khiển
Lí do chọn PLC trong việc điều khiển robot
- Tầm quan trọng của PLC trong công nghiệp
- Khả năng của PLC trong điều khiển robot.
1. **Sơ lược về Hệ thống điều khiển (Q02HCPU - Q02HCPU - Q172HCPU - MR-J[]-[]B)**
   1. **Mô hình chung cho hệ thống điều khiển**
      - Bao nhiêu bộ phận
      - Chức năng của từng bộ phận
      - Tiềm năng của hệ thống lắp đặt
      - Hạn chế của hệ thống
   2. **Giới thiệu từng module điều khiển**
      1. **Q02HCPU**
         - Vai trò \ Chức năng
      2. **Q172HCPU**
         - Vai trò \ Chức năng
      3. **MR-J[]-[]B**
         - Vai trò \ Chức năng
   3. **Cách lắp đặt hệ thống điều khiển**
      1. **Q02HCPU và máy tính thông qua GX Work2**
         1. **Q02HCPU:**
            - Những thành phần kết nối
            - Lưu ý trong việc lắp đặt kết nối với máy tính
         2. **Máy tính (GX Work2)**
            -  Cách kiểm tra kết nối với PLC
            -  Cách kết nối với PLC thông qua phần mềm
            -  Thiết đặt thông số trong GX Work2
         3. **Q02HCPU và QY42P:**
            - Những thành phần phần cứng kết nối
            - Lưu ý trong việc kết nối
      2. **Q172HCPU và những thành phần liên quan:**
         1. **Q172HCPU và Q02HCPU:**
            - Những thành phần phần cứng kết nối
            - Các thông số cài đặt
            - Lưu ý trong việc kết nối
         2. **Q172HCPU và Servo Motor:**
            - Những thành phần phần cứng kết nối của servo với PLC
            - Kết nối giữa servo với servo
            - Lưu ý trong việc kết nối
         3. **Q172HCPU và máy tính thông qua MT Developer:**
            -  Cách kiểm tra kết nối với PLC
            -  Cách kết nối với PLC thông qua phần mềm
            -  Thiết đặt thông số trong GX Work2
2. **Kiểm tra chức năng bằng phần mềm MT Developer và GX Work2**
   1. **MT Developer**
      - Giới thiệu chức năng giám sát và điều khiển trên phần mềm
      - Thực hiện chạy jog thử nghiệm cho từng servo motor
      - Kết luận thực nghiệm
   2. **GX Work2**
      - Giới thiệu chức năng giám sát và điều khiển trên phần mềm
      - Thực hiện chạy jog thử nghiệm cho từng servo motor
      - Kết luận thực nghiệm

## Viết chương trình điều khiển cho robot
1. **Chương trình trên GX Work2**
   1. Giới thiệu cấu trúc chương trình
   2. Cấu trúc vùng nhớ
   3. Các hàm cơ bản
   4. Chương trình liên kết giữa GX Work2 và MT Developer2
2. **Chương trình trên MT Developer2**
   1. Giới thiệu cấu trúc chương trình
   2. Cấu trúc vùng nhớ
   3. Các hàm cơ bản
3. **Giới thiệu tổng quan về C# và Q02HCPU**
   1. Cách cấu hình thông qua phần mềm Communication Setup Utility
   2. Thư viện hỗ trợ
   3. Chức năng cơ bản
   4. Các hàm cơ bản

## Giới thiệu về giao diện WPF trong C#
1. **Sơ lược về WPF**
2. **Ứng dụng của WPF**
3. **Làm việc với giao diện điều khiển**
   - Điều khiển trên giao diện
   - Cách cài đặt thư viện.
4. **Làm việc với code**
   - Giới thiệu về Timer.
   - Giới thiệu về Luồng (Thread).
   - Giới thiệu sơ lược về cấu trúc chương trình.
     - Cấu trúc quản lí code.
     - Các kiểu khai báo dữ liệu.

Thachhcmute3001, 2024-06-01:
Begin doing task tonight

Thachhcmute3001, 2024-06-01:
https://github.com/TNH510/5_DOF_Robot_Arm/assets/92521250/1f80161f-f903-4802-bb6e-4d16024903c1

hieutranngoc-itr, 2024-06-03:
Is this task completed @Thachhcmute3001 ?

Thachhcmute3001, 2024-06-03:
Not yet =)))

On Mon, Jun 3, 2024, 10:54 PM Hieu Tran Ngoc ***@***.***>
wrote:

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

Closed 2024-07-14.

Thread 127 (2024-05-31):

Hoàn tất phần nút nhấn trên găng tay điều khiển (Xử lí ngắt, test ổn định)

hieutranngoc-itr, 2024-05-31:

hieutranngoc-itr, 2024-05-31:
- Đã xử lí ổn định được sự kiện nút nhấn từ SW1,2,3 (nguyên nhân là do mối hàn không chắc chắn)
- Thông qua việc giảm power từ module UART cũng làm cho việc bật tắt LED không làm ảnh hưởng đến I2C

Closed 2024-05-31.

Thread 128 (2024-05-31):

Viết các tính năng điều khiển từ găng tay, tạo và lưu quỹ đạo liên tiếp

hieutranngoc-itr, 2024-05-31:
- [x] Lưu 1 trajectory cho 1 loại vật thể
- [x] Write data ngược để tạo quỹ đạo ngược về
- [x] Thiết kế quy trình cụ thể để điều khiển băng tải,, camera và robot

Closed 2024-07-14.

Thread 129 (2024-05-31):

Thay đổi phần giao thức UART để giảm lượng data gửi đi và thêm phần cho câu lệnh điều khiển từ găng tay

hieutranngoc-itr, 2024-05-31:
- [x] Thiết kế giao thức UART gồm 3 giá trị vị trí (3 * 3), câu lệnh 1 byte, 1 byte CRC-ATM:
[**x_3**][**x_2**][**x_1**][**y_3**][**y_2**][**y_1**][**z_3**][**z_2**][**z_1**][**CMD**][**CRC-ATM**]
- Thuật toán **CRC8-ATM**
```
static uint8_t lc709204f_calculate_crc_8_atm(uint8_t *data, uint16_t length)
{
  assert(data != NULL);

  uint8_t crc = 0;
  for (uint16_t i = 0; i < length; i++)
  {
    crc ^= data[i];

    for (uint8_t bit = 0; bit < 8; bit++)
    {
      if (crc & 0x80)
      {
        crc = (crc << 1) ^ 0x07;
      }
      else
      {
        crc <<= 1;
      }
    }
  }

  return crc;
}
```

hieutranngoc-itr, 2024-06-01:
@Thachhcmute3001

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

Thachhcmute3001, 2024-06-01:
Acknowledged

hieutranngoc-itr, 2024-06-01:
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

hieutranngoc-itr, 2024-06-01:
https://github.com/TNH510/Internet-of-Things @Thachhcmute3001

hieutranngoc-itr, 2024-06-03:
- [ ] Debug cách tối ưu tốc độ truyền từ module UART
- [ ] Test truyền nhận UART trên module HC-12
- [ ] Test và thêm phần điều khiển vận tốc dùng Jacobi nghịch

Thachhcmute3001, 2024-06-03:
:)) oh noo

On Mon, Jun 3, 2024, 10:45 PM Hieu Tran Ngoc ***@***.***>
wrote:

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

hieutranngoc-itr, 2024-06-03:
@Thachhcmute3001 Yeah, you look very awake 😃

Closed 2024-06-17.

Thread 133 (2024-06-03):

Debug cách tối ưu tốc độ truyền từ module UART

hieutranngoc-itr, 2024-06-03:
- Module uart tối ưu nhất khi gửi lượng data nhỏ nhất thay vì gửi 1 lần một lượng lớn data
- Đã tối ưu từ gửi 36 bytes trong 300 ms xuống được 19 bytes trong 210 ms mà không lỗi

Closed 2024-06-06.
