TNH510/5_DOF_Robot_Arm/drawing/print/ban_ve_dien_main.pdf

# BỘ GIÁO DỤC VÀ ĐÀO TẠO

# TRƯỜNG ĐẠI HỌC SƯ PHẠM KỸ THUẬT TP.HCM

# KHOA CƠ KHÍ CHẾ TẠO MÁY

# BỘ MÔN CƠ ĐIỆN TỬ


# TẬP BẢN VẼ ĐIỆN

# GVHD: TS. NGUYỄN XUÂN QUANG

# SVTH:

TRẦN NGỌC HIỂU | 20146127

# NGUYỄN BÁ VŨ THẠCH 20146530

LÊ TẤN LỘC | 20146121

# Năm học: 2023-2024

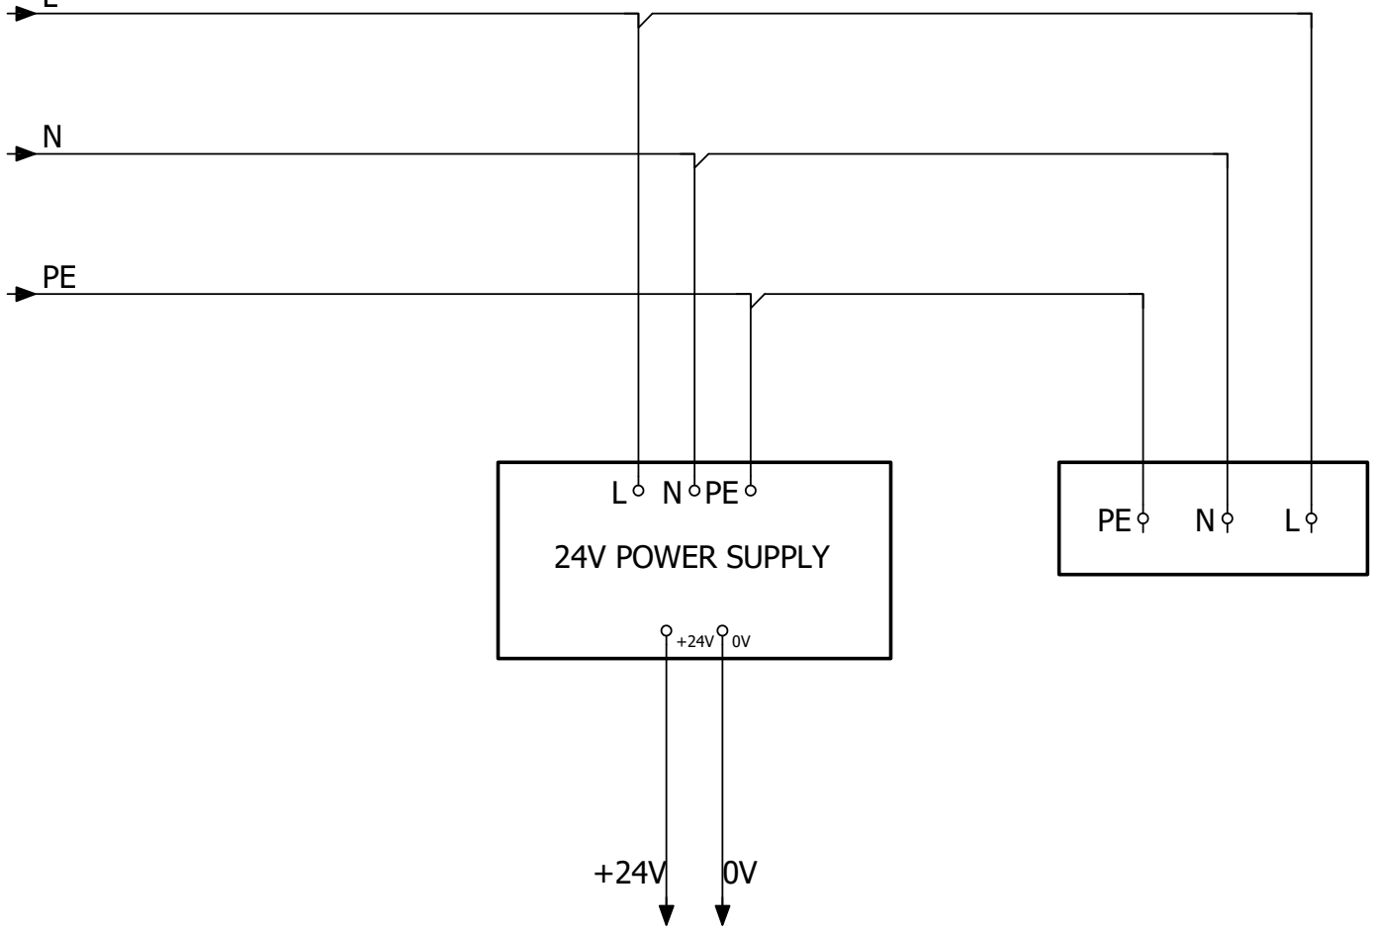
[picture p365: figure]

NGUỒN Lê Tấn Lộc | 03.01.24 Kiểm tra Người vẽ Trường ĐH. SPKT TPHCM - Khoa: CKM 24V POWER SUPPLY +24V 0V L N PE | PE | N | L LNPE | +24V | 0V | N.X. Quang

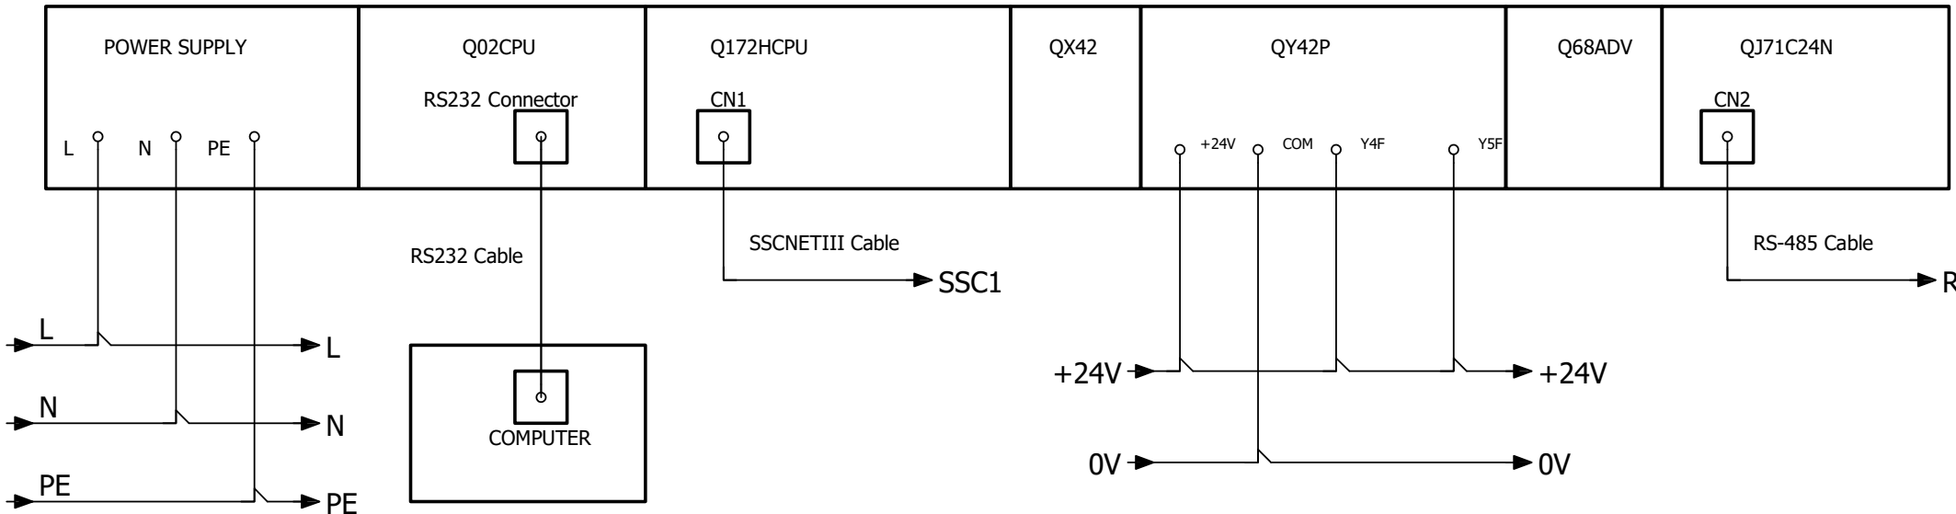
[picture p366: figure]

PLC Q02 ³⁰.12.23 Kiểm tra Người vẽ Trường ĐH. SPKT TPHCM - Khoa: CKM | Gang | 01.03 1:2 POWER SUPPLY | Q02CPU | Q172HCPU | QX42 | QY42P | Q68ADV | QJ71C24N COMPUTER RS232 Cable RS232 Connector | CN1SSCNETIII Cable | CN2RS-485 Cable L | N | PE | +24V | COM | Y4F | Y5F LNPE | LNPE | SSC1 | +24V0V | +24V 0V | RS-485 Lê Tấn Lộc N.X. Quang

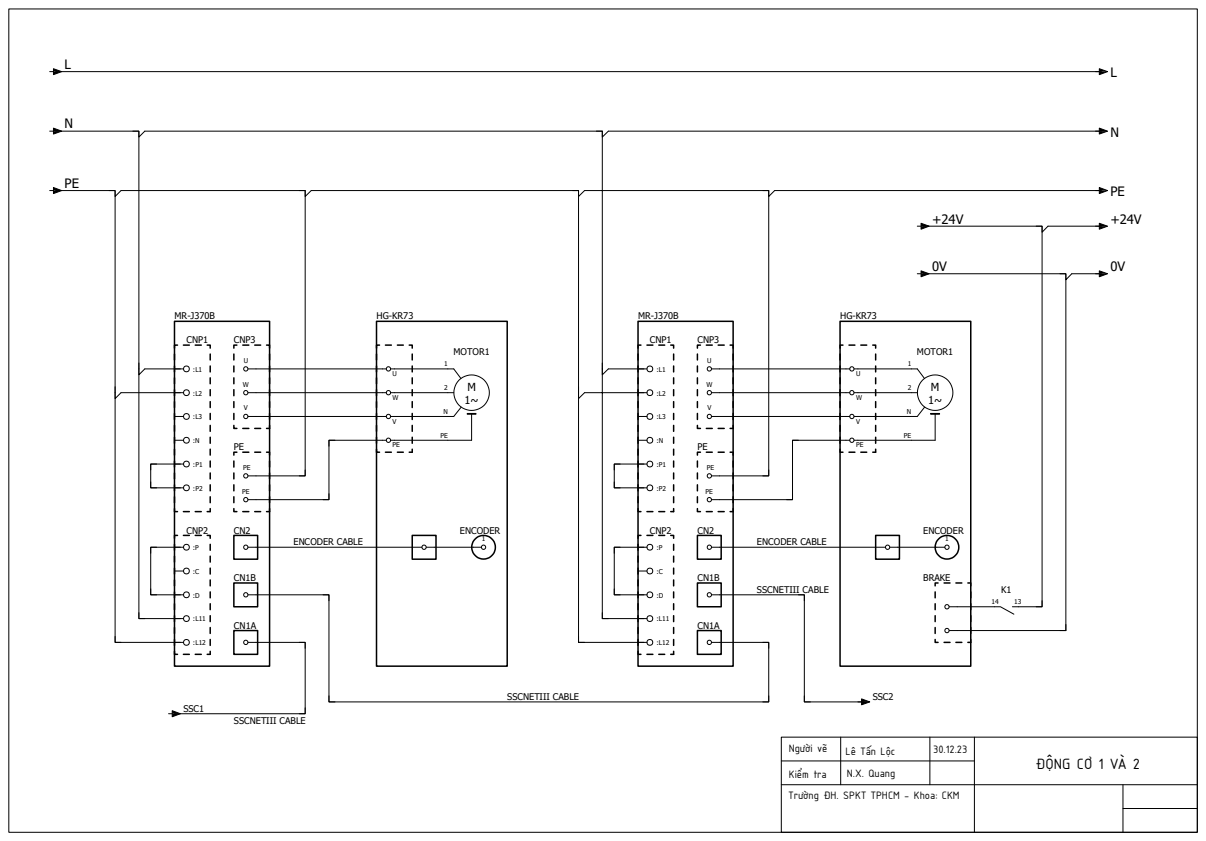
[picture p367: page 4]
ĐỘNG CƠ 1 VÀ 2 ³⁰.12.23 Kiểm tra Người vẽ Trường ĐH. SPKT TPHCM - Khoa: CKM CNP1 MR-J370B; CNP3 PE CNP2; ENCODER HG-KR73 ENCODER CABLE; MR-J370B CNP1; ENCODER ENCODER CABLE SSCNETIII CABLE SSCNETIII CABLE; SSCNETIII CABLE; BRAKE :L2 :L1 :L3 :N :P1 :P2 :C :P :D :L11 :L12; PE PEVWU; M1~ ¹²NPE MOTOR1 UWVPE; PE PEVWU :C :P :D :L11 :L12; 13 K1 LNPE; LNPE +24V 0V SSC1; SSC2; +24V 0V Lê Tấn Lộc N.X. Quang

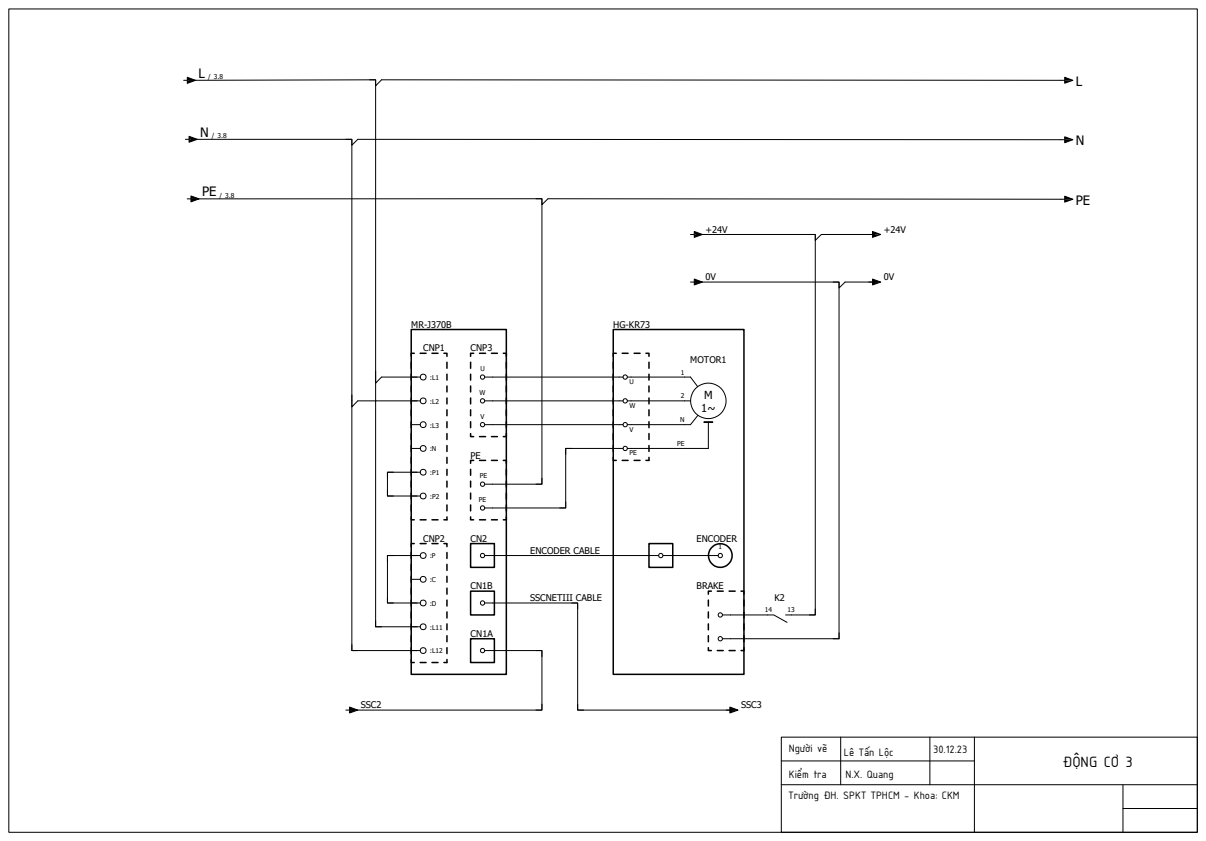
[picture p368: page 5]
ĐỘNG CƠ 3 ³⁰.12.23 Kiểm tra Người vẽ Trường ĐH. SPKT TPHCM - Khoa: CKM MR-J370B CNP1; CNP3 PE CNP2; ENCODER ENCODER CABLE SSCNETIII CABLE; BRAKE :L2 :L1 :L3 :N :P1 :P2; PE PEVWU :C :P :D :L11 :L12; M1~ ¹²NPE MOTOR1 UWVPE; LNPE +24V 0V; SSC3; +24V 0V SSC2; Lê Tấn Lộc N.X. Quang

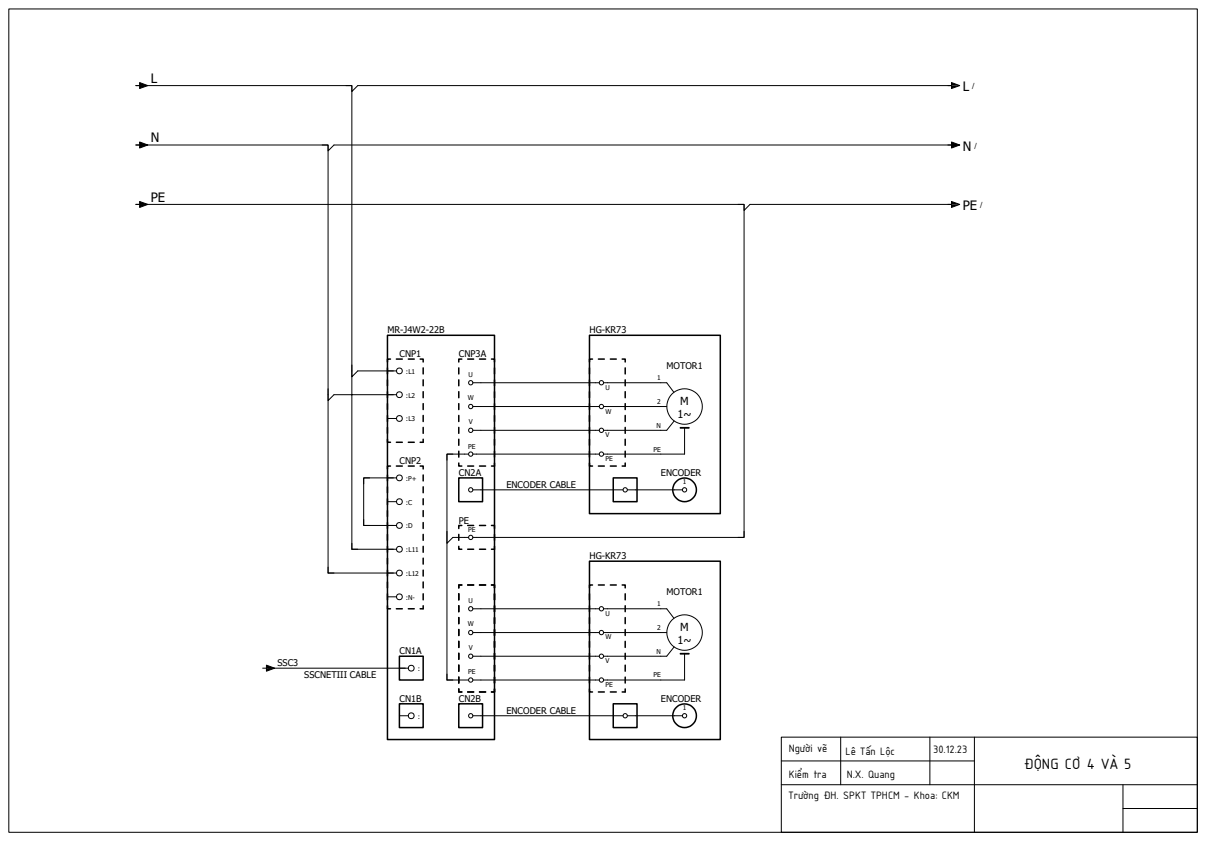
[picture p369: page 6]
ĐỘNG CƠ 4 VÀ 5 ³⁰.12.23 Kiểm tra Người vẽ Trường ĐH. SPKT TPHCM - Khoa: CKM MR-J4W2-22B CNP1; CNP3A PE CNP2; ENCODER ENCODER CABLE CN1B; ENCODER ENCODER CABLE SSCNETIII CABLE; VWU :C :P+ :D :L11 :L12; M1~ ¹²NPE MOTOR1 UWVPE; VWU PE PE PE; 1 : : LNPE; L / N / PE / SSC3; Lê Tấn Lộc N.X. Quang
