TNH510/5_DOF_Robot_Arm/drawing/ban_ve_dien/COMPLETE_ban_ve_dien_hoan_thanh.pdf

# BỘ GIÁO DỤC VÀ ĐÀO TẠO

# TRƯỜNG ĐẠI HỌC SƯ PHẠM KỸ THUẬT TP.HCM

# KHOA CƠ KHÍ CHẾ TẠO MÁY

# BỘ MÔN CƠ ĐIỆN TỬ

# TẬP BẢN VẼ ĐIỆN

# GVHD: TS. NGUYỄN XUÂN QUANG

# SVTH:

# TRẦN NGỌC HIỂU 20146127

# NGUYỄN BÁ VŨ THẠCH 20146530

# LÊ TẤN LỘC 20146121


# Năm học: 2023-2024


NGUỒN 03.01.24 Lê Tấn Lộc Trường ĐH. SPKT TPHCM - Khoa: CKM Kiểm tra Người vẽ 24V POWER SUPPLY +24V 0V L N PE PE N L PENL 0V +24V N.X. Quang

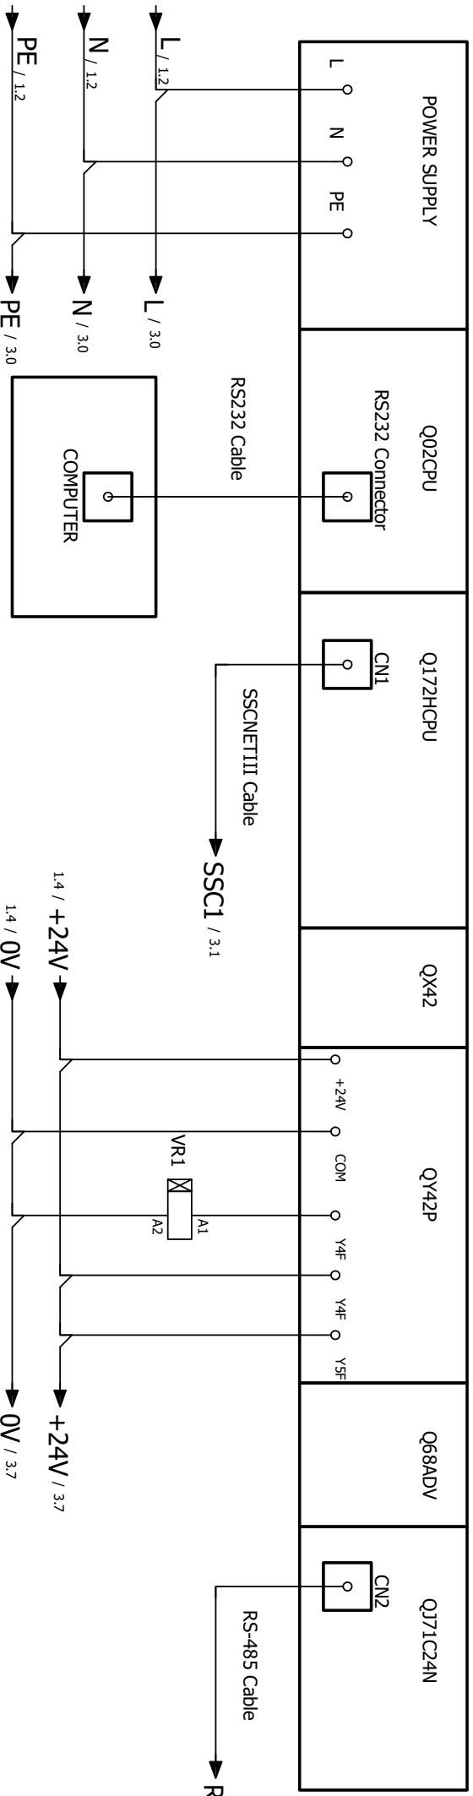
[picture p376: figure]

PLC - ROBOT 30.6.24 Trường ĐH. SPKT TPHCM - Khoa: CKM Kiểm tra Người vẽ N.X. Quang Lê Tấn Lộc POWER SUPPLY Q02CPU Q172HCPU QX42 QY42P Q68ADV QJ71C24N COMPUTER RS232 Cable CN1 RS232 Connector SSCNETIII Cable CN2RS-485 Cable L N PE +24V COM Y4F Y5F Y4F A2A1 VR1 L / 1.2 N / 1.2 PE / 1.2 L / 3.0 N / 3.0 PE / 3.0 SSC1 / 3.1 +24V / 1.4 0V / 1.4 +24V / 3.7 0V / 3.7 RS-485 /

PLC - BĂNG TẢI 30.6.24 Trường ĐH. SPKT TPHCM - Khoa: CKM Kiểm tra Người vẽ N.X. Quang Lê Tấn Lộc Module UART PLC S7-1214C Module IO IO-Links AL1100 Module UART to TTL Profinet RS232 Connector Module GT38 Sensor O5D150(1) Sensor O5D150(2) Bộ điều khiển băng tải Buck - Boost INOUT 0V0V 5V5V TXTX RXRX X1 X3 Q8.7 0V 24V RUN 1413 /6.6 K1 14 13 /3.8 14 13 /6.7 A2A1 K1 I7.5 1413 -S1 0V 5V 0V 24V +24V / 4.7 0V / 4.7


ĐỘNG CƠ 1 VÀ 2 30.12.23 Trường ĐH. SPKT TPHCM - Khoa: CKM Kiểm tra Người vẽ CNP1 MR-J370B PECNP3 CNP2 CN2 CN1A CN1B ENCODER HG-KR73 ENCODER CABLE MR-J370B CNP1 CNP3 PE CNP2 CN1A CN1B CN2 HG-KR73 ENCODER ENCODER CABLE SSCNETIII CABLE SSCNETIII CABLE SSCNETIII CABLE BRAKE :L12 :L11 :D :C :P :P2 :P1 :N :L3 :L2 :L1 PE PEVWU 1~M N21PE MOTOR1 PEVWU 1 :P2 :P1 :N :L3 :L2 :L1 PE PEVWU :L12 :L11 :D :C :P 1~M N21PE MOTOR1 PEVWU 1 13 14 K1 PENL PENL 0V+24V SSC1 SSC2 0V+24V N.X. Quang Lê Tấn Lộc


ĐỘNG CƠ 3 30.12.23 Trường ĐH. SPKT TPHCM - Khoa: CKM Kiểm tra Người vẽ MR-J370B CNP1 CNP3 PE CNP2 CN1A CN1B CN2 HG-KR73 ENCODER SSCNETIII CABLE ENCODER CABLE BRAKE :P2 :P1 :N :L3 :L2 :L1 PE PEVWU :L12 :L11 :D :C :P 1~M N21PE MOTOR1 PEVWU 1 13 14 K2 L / 3.8 N / 3.8 PE / 3.8 PENL 0V+24V SSC3 0V+24V SSC2 N.X. Quang Lê Tấn Lộc


ĐỘNG CƠ 4 VÀ 5 30.12.23 Trường ĐH. SPKT TPHCM - Khoa: CKM Kiểm tra Người vẽ MR-J4W2-22B CNP1 CNP3A PE CNP2 CN2B CN1A HG-KR73 ENCODER ENCODER CABLE CN1B CN2A HG-KR73 ENCODER ENCODER CABLE SSCNETIII CABLE :L3 :L2 :L1 VWU :L12 :L11 :D :C :P+ 1~M N21PE MOTOR1 PEVWU 1 :N- VWU PE PE PE 1~M N21PE MOTOR1 PEVWU 1 : : PENL L / N / PE / SSC3 N.X. Quang Lê Tấn Lộc

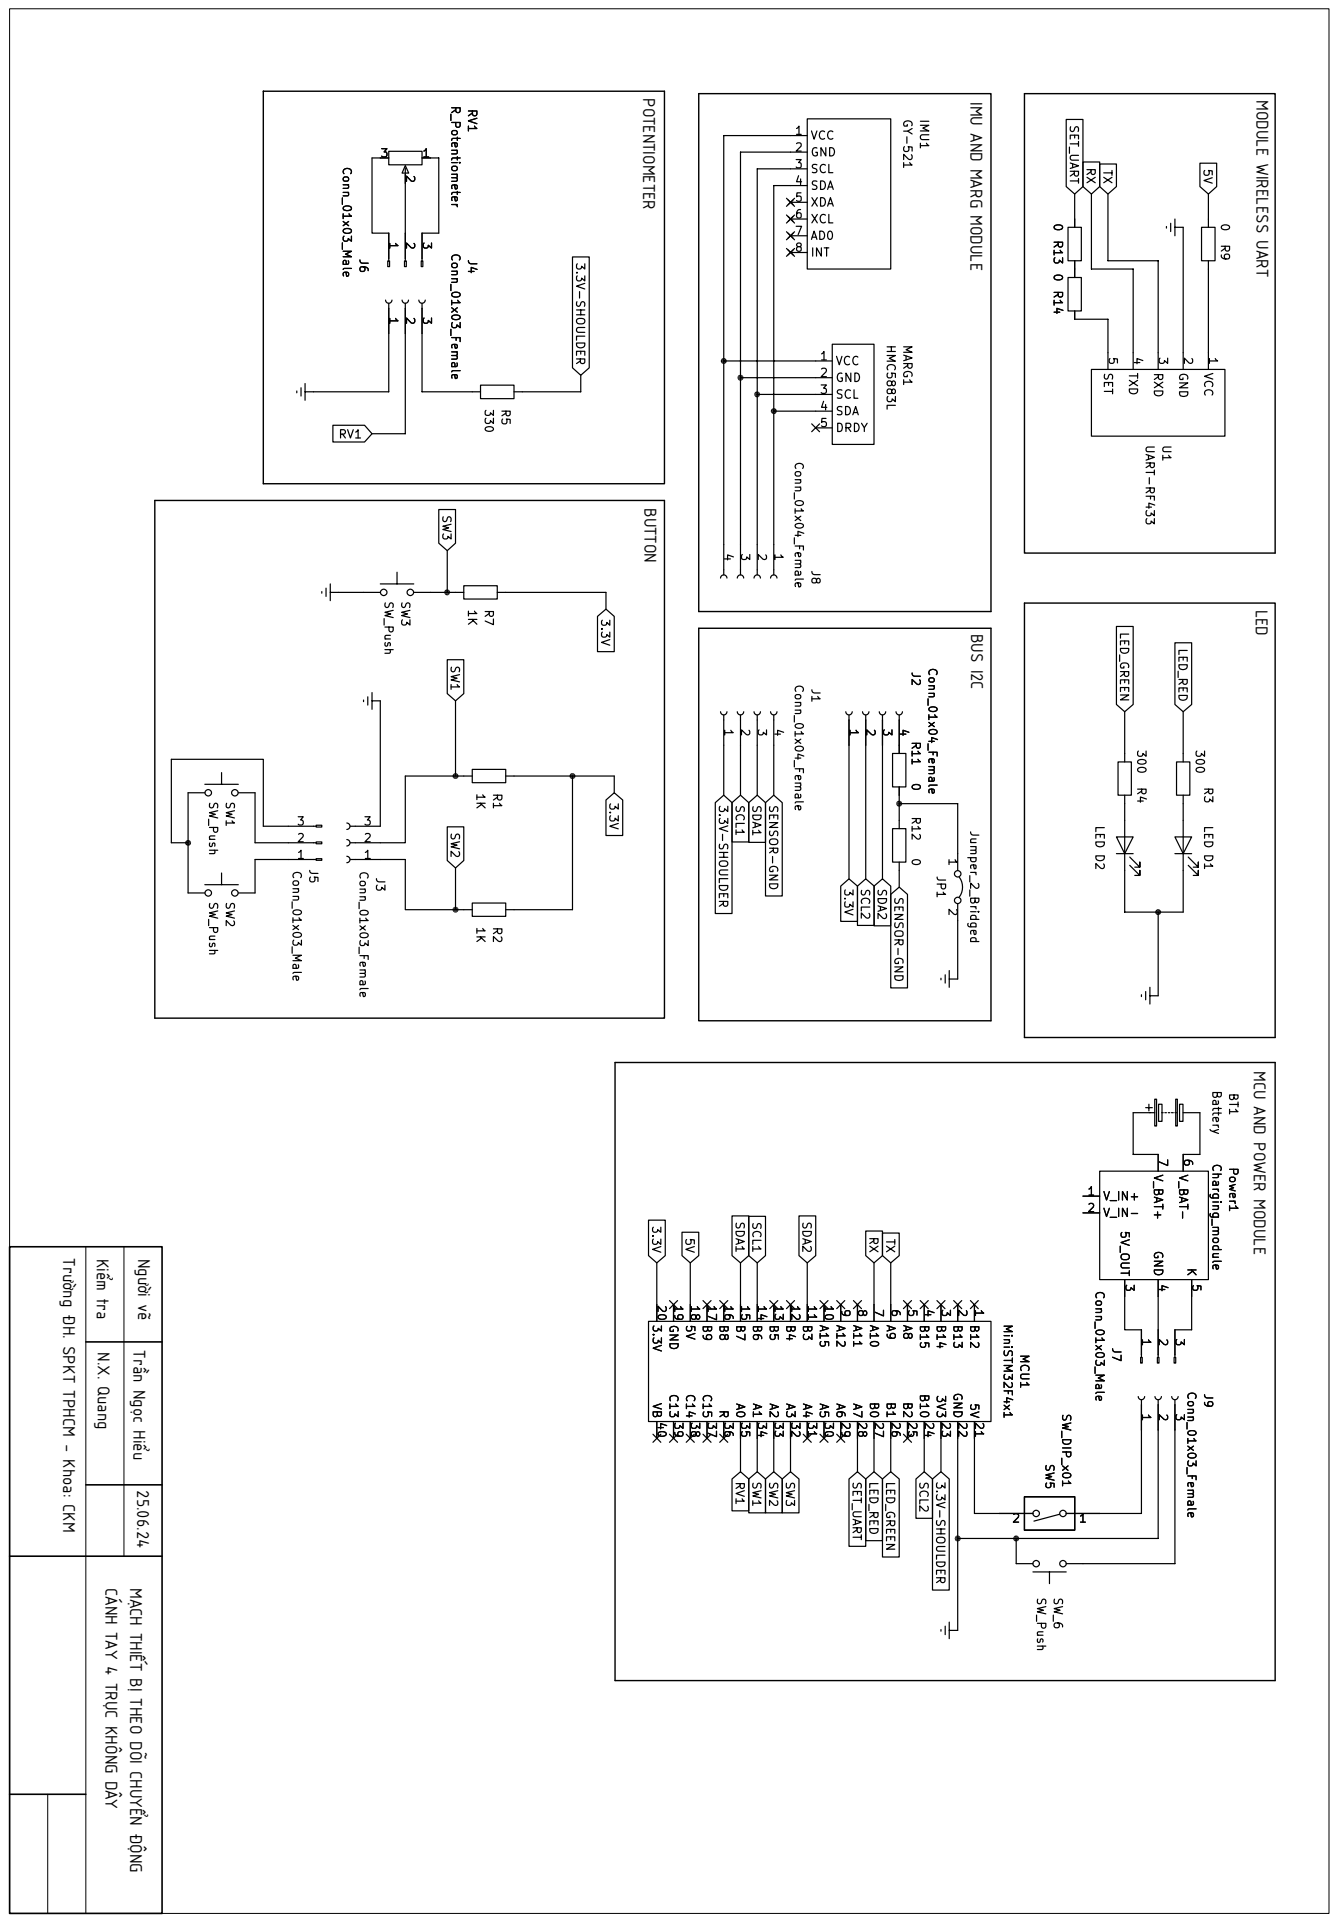
[picture p377: page 8]

CÁNH TAY 4 TRỤC KHÔNG DÂY MẠCH THIẾT BỊ THEO DÕI CHUYỂN ĐỘNG 25.06.24 Trường ĐH. SPKT TPHCM - Khoa: CKM Kiểm tra Người vẽ N.X. Quang Trần Ngọc Hiểu MODULE WIRELESS UART LED IMU AND MARG MODULE BUS I2C POTENTIOMETER BUTTON MCU AND POWER MODULE
