TNH510/5_DOF_Robot_Arm/drawing/tham_khao/22223DT159_Ban_Ve_Dien.pdf

### BỘ GIÁO DỤC VÀ ĐÀO TẠO

### TRƯỜNG ĐẠI HỌC SƯ PHẠM KỸ THUẬT THÀNH PHỐ HỒ CHÍ MINH

## KHOA CƠ KHÍ CHẾ TẠO MÁY

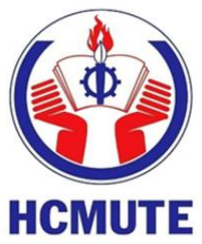
[picture p378: figure]

# TẬP BẢN VẼ ĐIỆN

Đề tài: “ĐIỀU KHIỂN TAY MÁY 5 BẬC TỰ DO ỨNG DỤNG TRONG XẾP SẢN PHẨM VÀ ĐIỀU KHIỂN CHUYỂN

# ĐỘNG BẰNG CỬ ĐỘNG TAY”

GVHD: TS. NGUYỄN XUÂN QUANG

SVTH: ĐOÀN THÁI DUY HIỂN

MSSV: 19146331

SVTH: NGUYỄN HỒNG THUẬN

MSSV: 19146399

SVTH: ĐINH CÔNG TOẠI

MSSV: 19146404

Tp. Hồ Chí Minh, tháng 07/2023

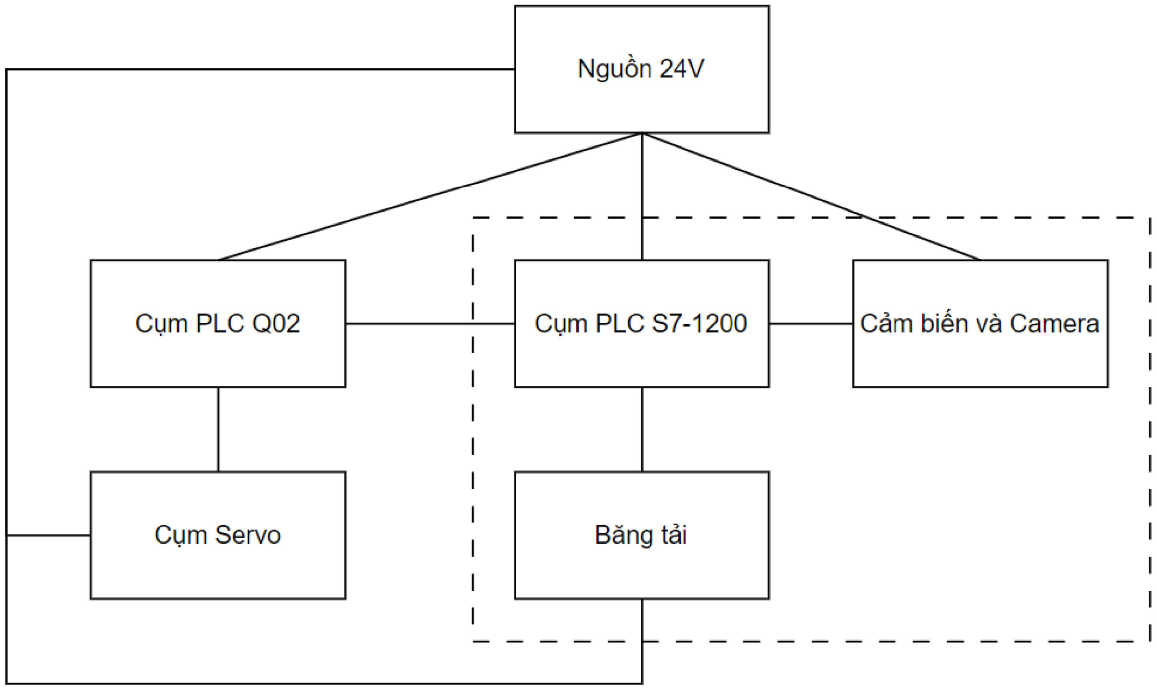
[picture p379: figure]

Người vẽ Kiểm tra | Đoàn T.D Hiển | 10.07.23 | TỔNG QUAN Trường ĐH.SPKT - Khoa: CKM | 01

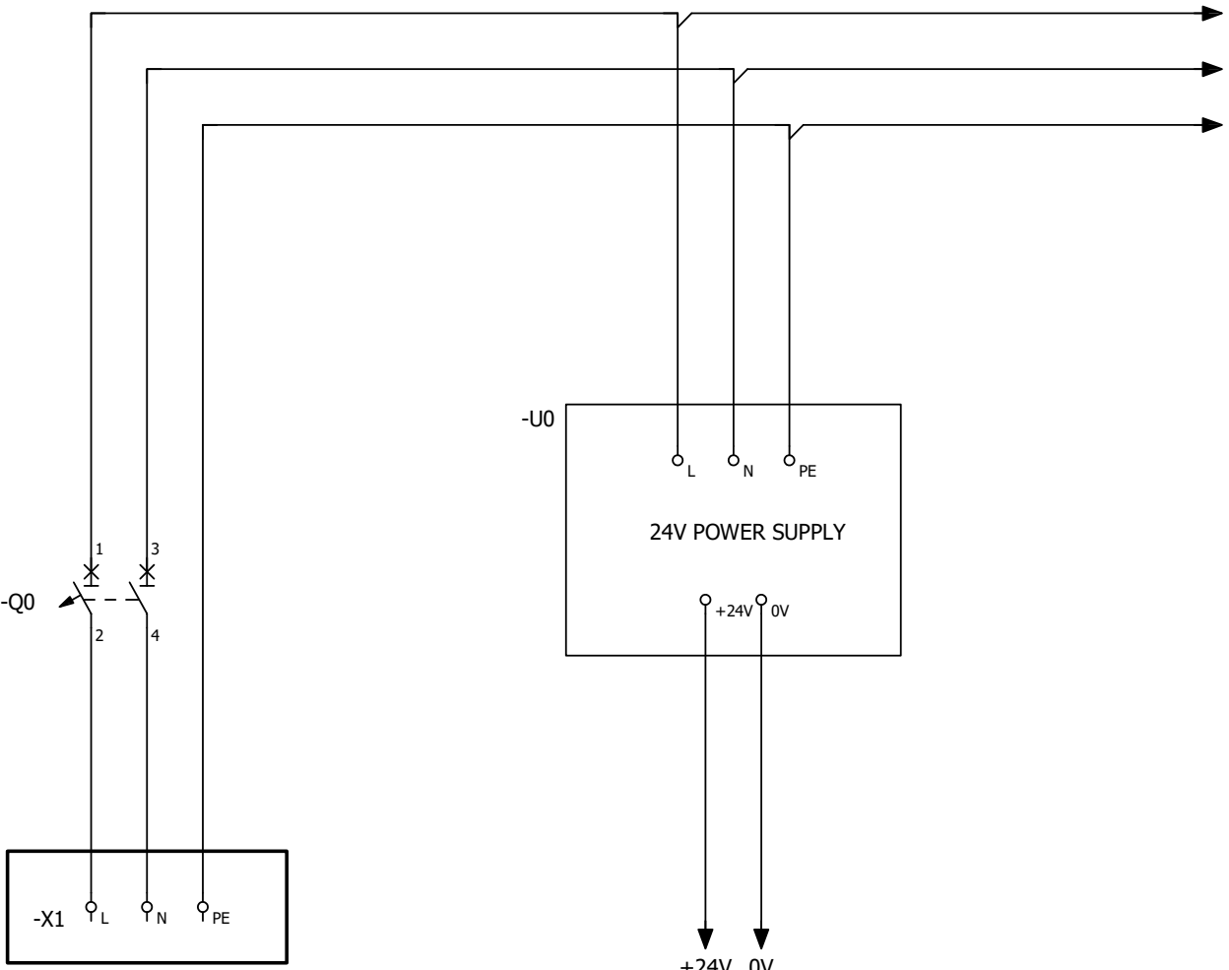
[picture p380: figure]

1 PHASE DISTRUBUTION | 24V POWER SUPPLY -X1 | L | N 12 | 34 -Q0 | PE | -U0 | L | N | PE +24V 0V | L / 3.2:E N / 3.2:E PE / 3.2:E +24V 3.4:D | 0V 3.4:D | Người vẽ Kiểm tra | Đoàn T.D Hiển | 10.07.23 | NGUỒN Trường ĐH.SPKT - Khoa: CKM | 02

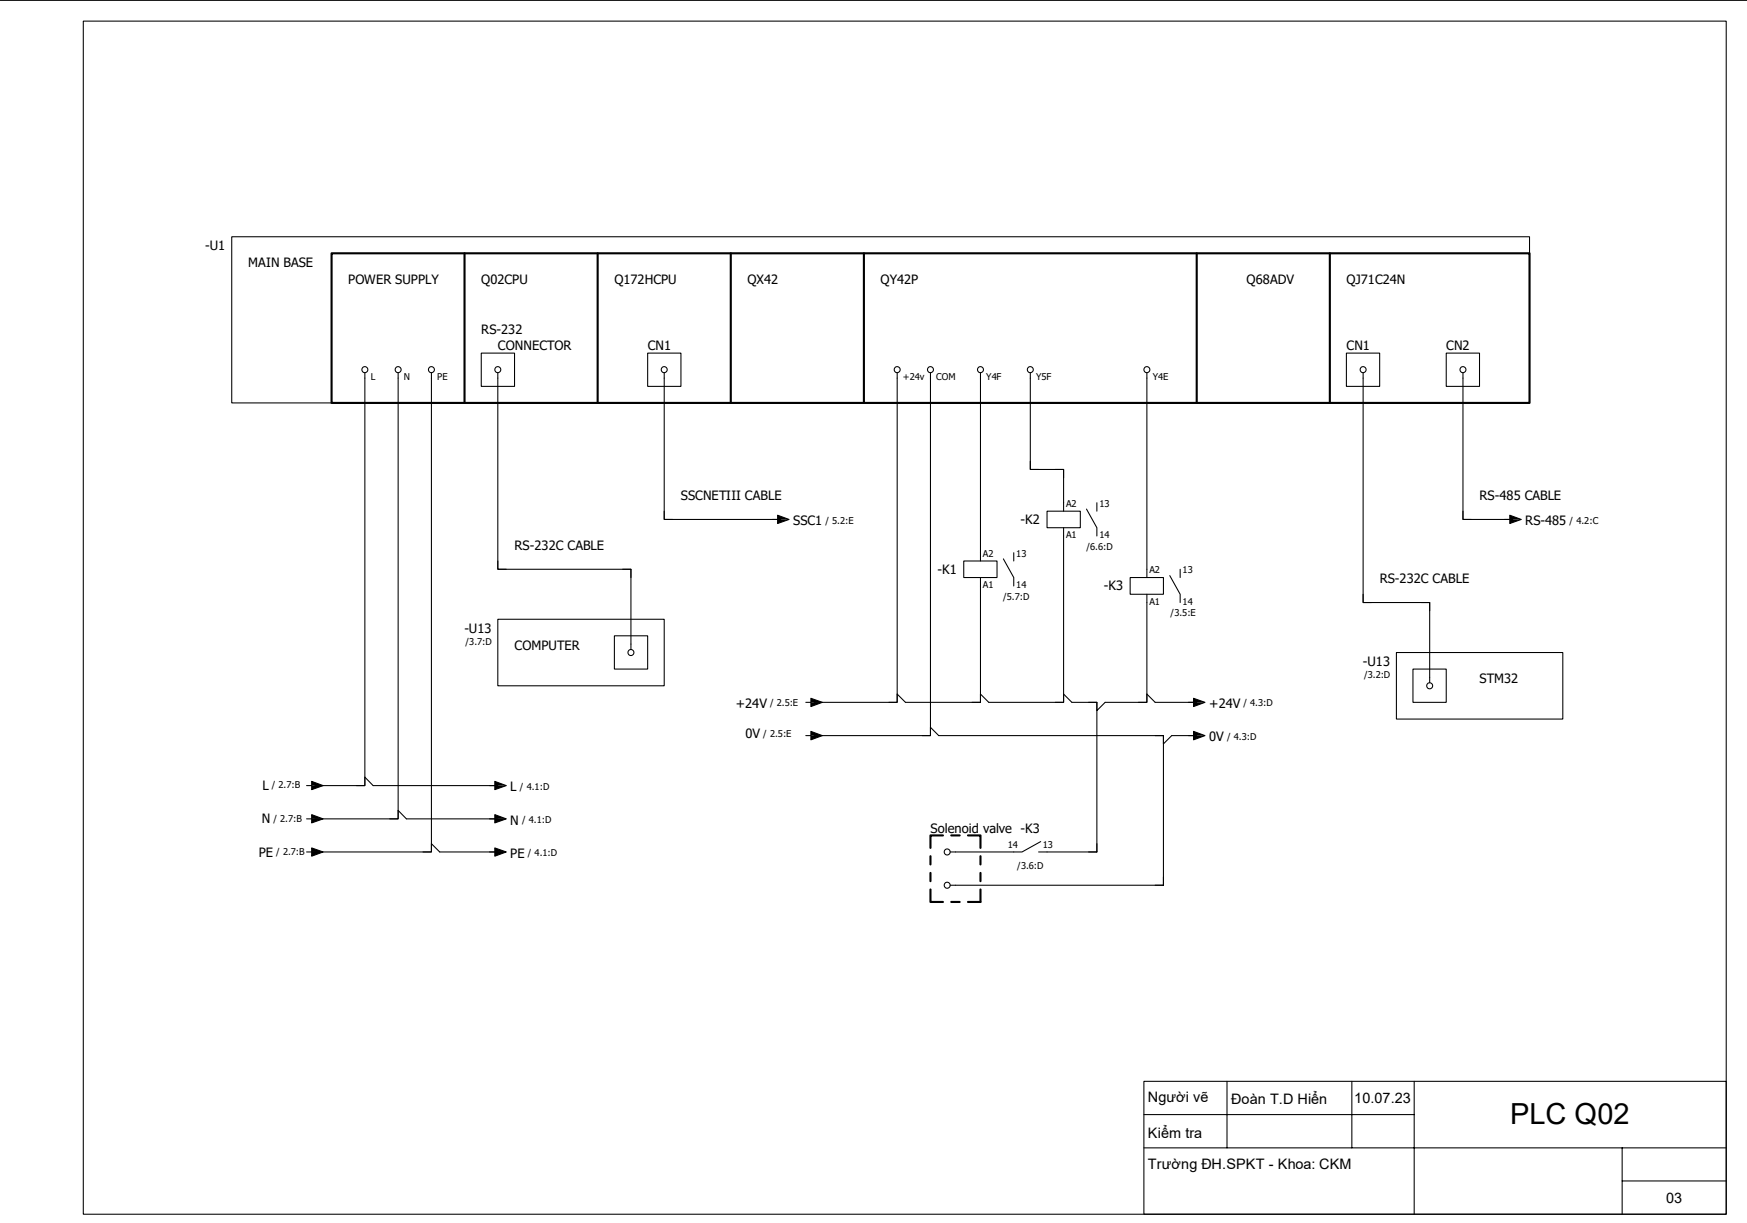
[picture p381: page 4]
MAIN BASE; POWER SUPPLY; Q02CPU; Q172HCPU; Q68ADV CN1 SSCNETIII CABLE RS-232 RS-232C CABLE COMPUTER CONNECTOR; QJ71C24N CN1 RS-232C CABLE CN2 RS-485 CABLE STM32 Solenoid valve -U1; +24v COM; SSC1 / 5.2:E +24V / 2.5:E 0V / 2.5:E; RS-485 / 4.2:C Người vẽ Kiểm tra; Đoàn T.D Hiển; PLC Q02 Trường ĐH.SPKT - Khoa: CKM

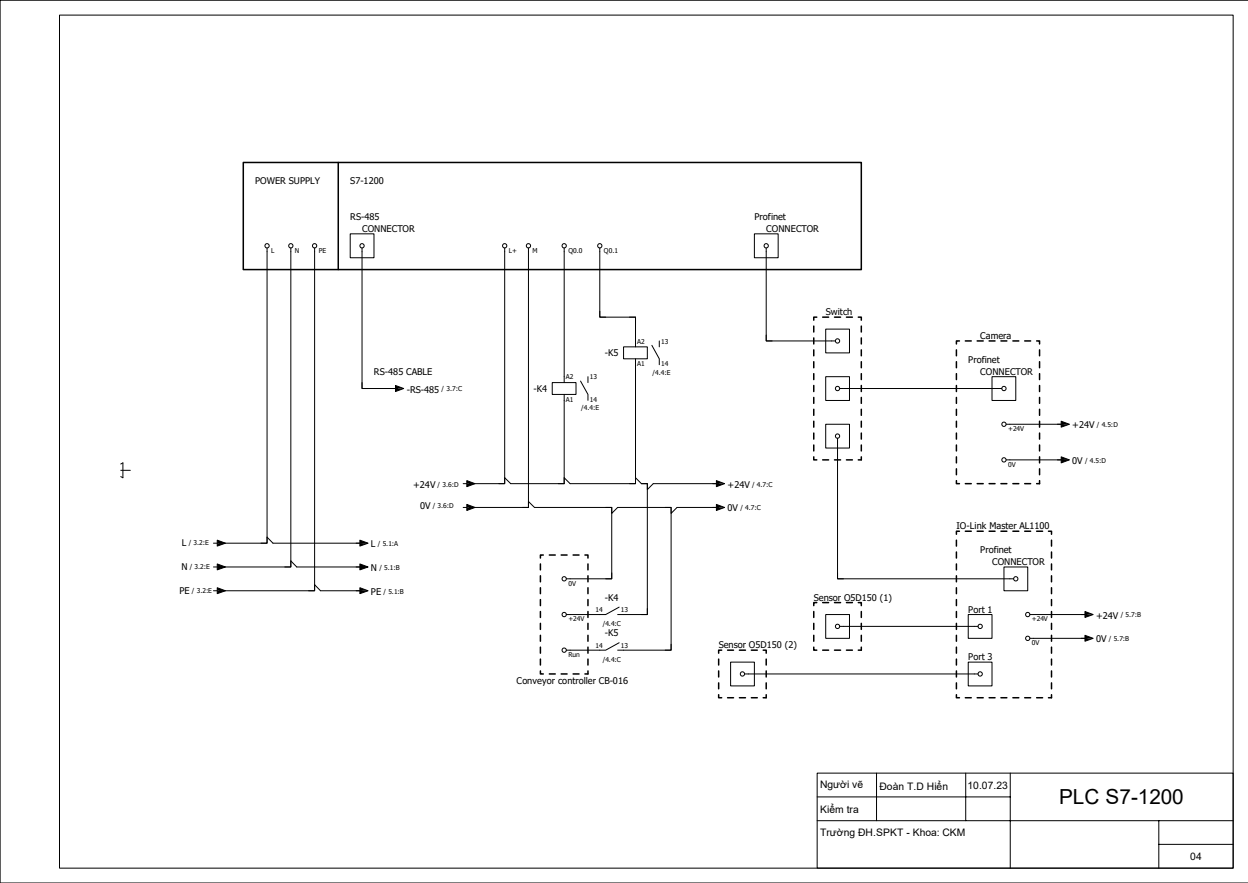
[picture p382: page 5]
POWER SUPPLY; S7-1200 RS-485RS-485 CABLE CONNECTOR; Profinet CONNECTOR Conveyor controller CB-016; Switch; Camera Profinet CONNECTOR Profinet CONNECTOR IO-Link Master AL1100 Port 1 Port 3 Sensor O5D150 (1) Sensor O5D150 (2) L; /4.4:E 1314 Run; +24V / 4.5:D 0V / 4.5:D+24V / 5.7:B 0V / 5.7:B Người vẽ Kiểm tra; Đoàn T.D Hiển; PLC S7-1200 Trường ĐH.SPKT - Khoa: CKM

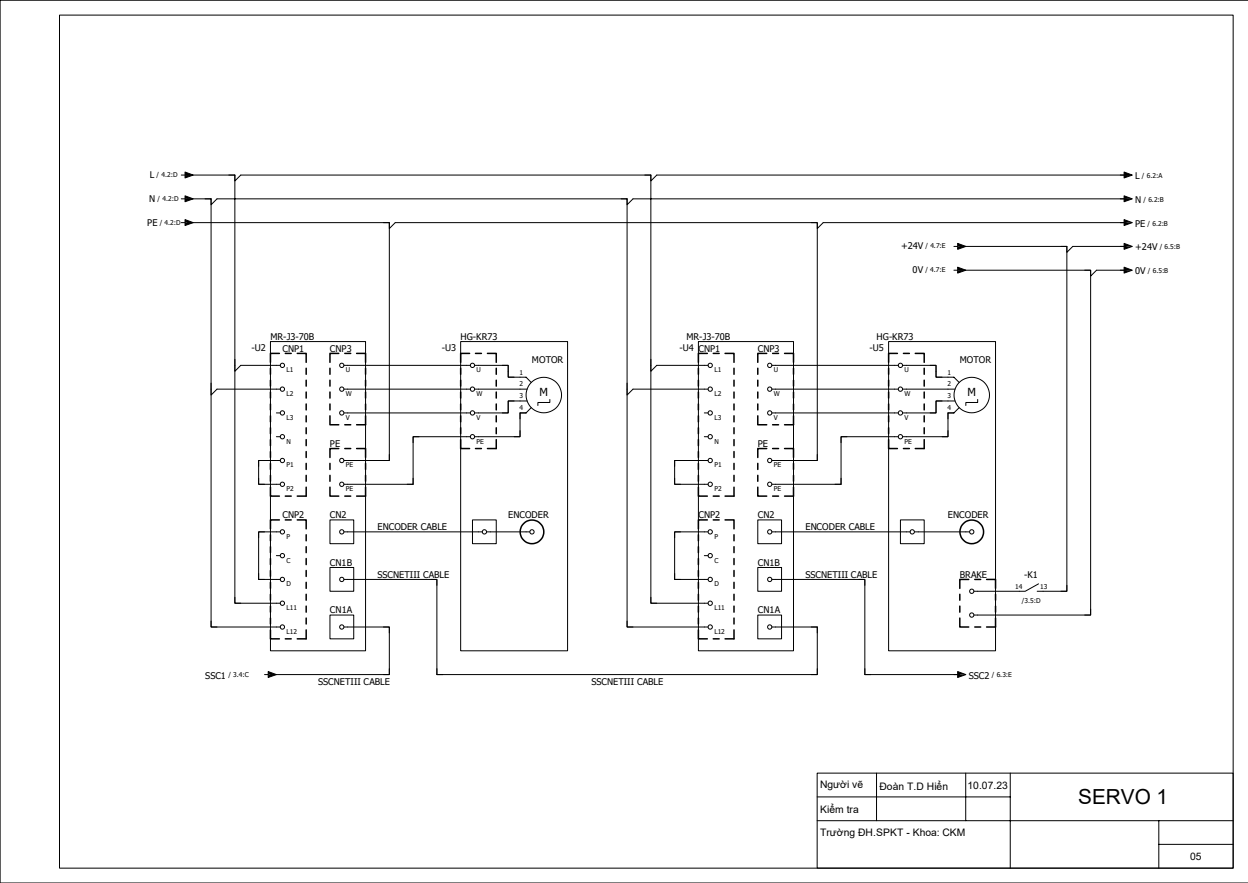
[picture p383: page 6]
CNP1 CNP2; CNP3 PECN2 CN1B CN1A; ENCODER; CNP3 PE ENCODER CABLE; ENCODER ENCODER CABLE SSCNETIII CABLE SSCNETIII CABLE; SSCNETIII CABLE; SSCNETIII CABLE MR-J3-70B; MOTOR; MOTOR BRAKE L1L2L3NP1P2PCDL11 L12; UWVPEPE -U2; UWVPE; L1L2L3NP1P2PCDL11 L12; UWVPEPE -U4; N / 6.2:B PE / 6.2:B L / 6.2:A SSC1 / 3.4:C; SSC2 / 6.3:E +24V / 4.7:E 0V / 4.7:E; 0V / 6.5:B +24V / 6.5:B Người vẽ Kiểm tra; Đoàn T.D Hiển; SERVO 1 Trường ĐH.SPKT - Khoa: CKM

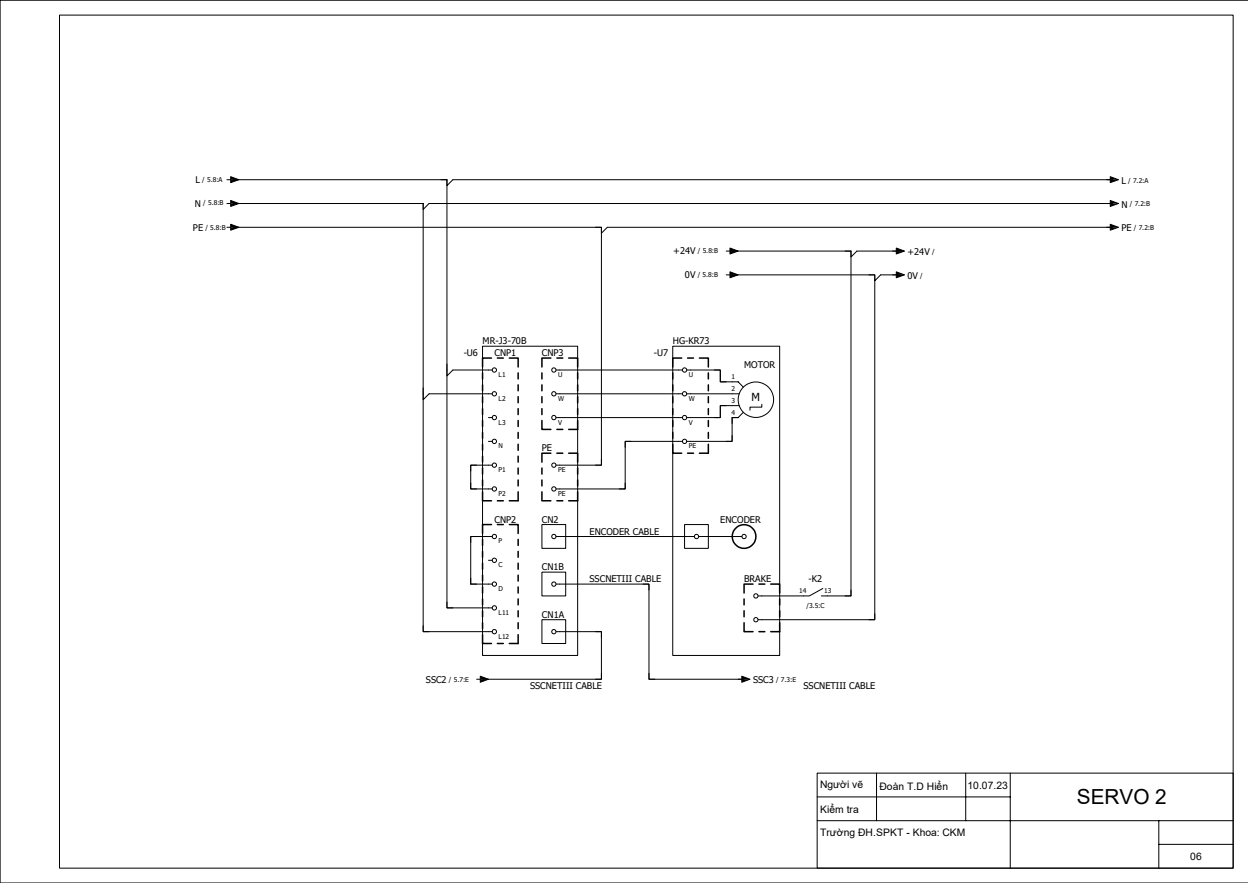
[picture p384: page 7]
CNP1 CNP2; CNP3 PECN2 CN1B CN1A; ENCODER ENCODER CABLE SSCNETIII CABLE SSCNETIII CABLE; SSCNETIII CABLE MR-J3-70B; MOTOR BRAKE L1L2L3NP1P2PCDL11 L12; UWVPEPE -U6; UWVPE; N / 7.2:B PE / 7.2:B L / 7.2:A SSC2 / 5.7:E; 0V / +24V / SSC3 / 7.3:E; Người vẽ Kiểm tra; Đoàn T.D Hiển; SERVO 2 Trường ĐH.SPKT - Khoa: CKM

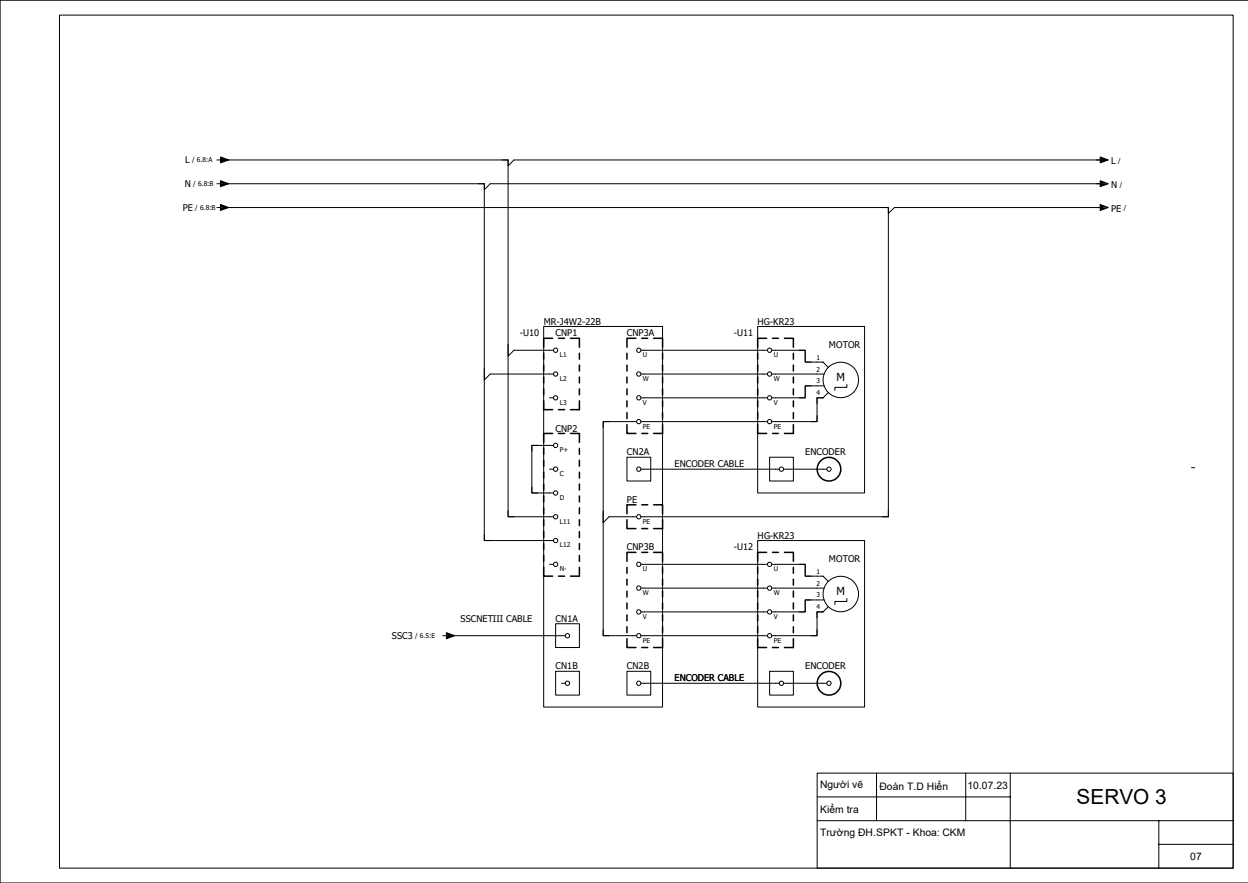
[picture p385: page 8]
CNP1 CNP2; CNP3A PECN2A; ENCODER ENCODER CABLE MR-J4W2-22B; MOTOR HG-KR23; MOTOR CNP3B CN2B; ENCODER ENCODER CABLE CN1B SSCNETIII CABLE; CN1A L1L2L3N- P+CDL11 L12; UWV -U10; UWVPE; M ¹²34 UWV; M ¹²34 -U12 PEPEPE L / 6.8:A N / 6.8:B PE / 6.8:B; N / PE / L / SSC3 / 6.5:E; Người vẽ Kiểm tra; Đoàn T.D Hiển; SERVO 3 Trường ĐH.SPKT - Khoa: CKM

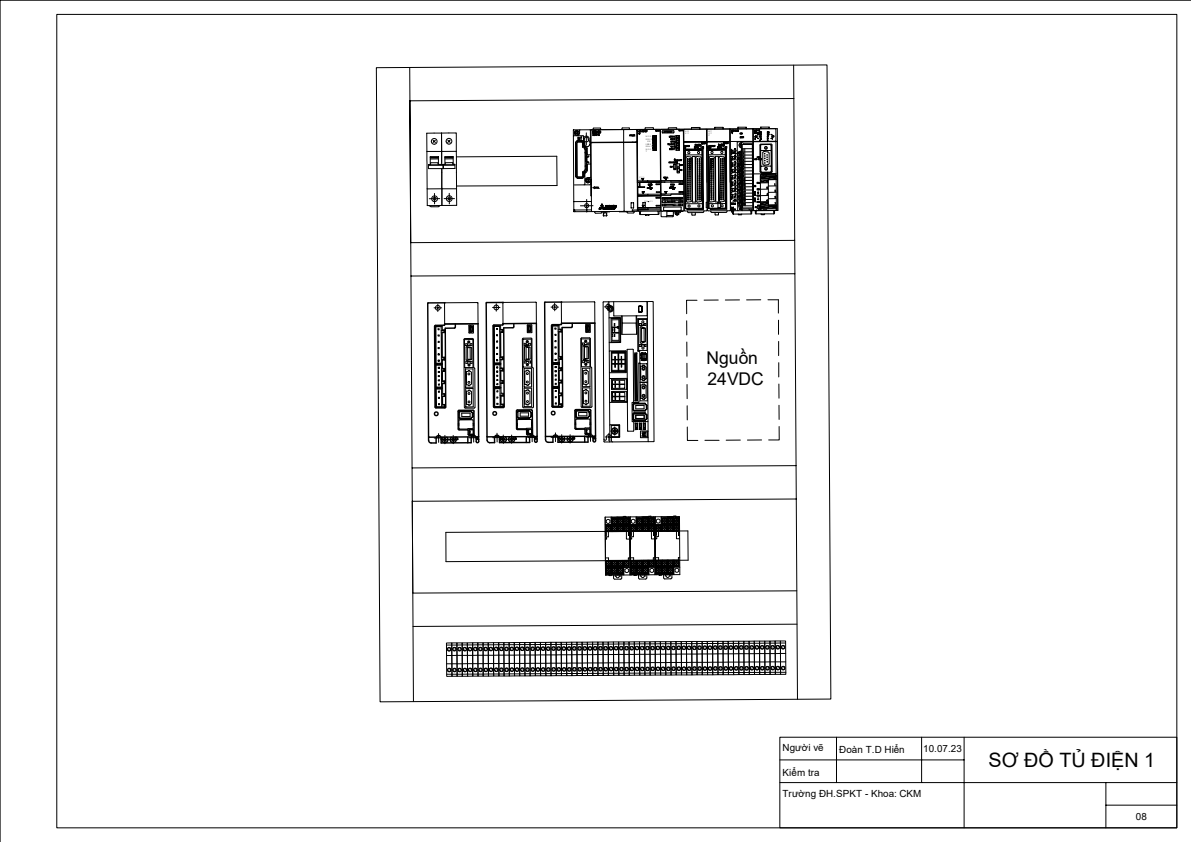
[picture p386: page 9]
ＰＵＬ Ｌ; ＲＵＮ ＥＲＲ ． ＢＡＴ． ＢＯＯ ＴＵＳＥ ＲＭＯＤ ＥＲＳ ２３ ２; ４ＡＱＸ４２; ＱＹ４２Ｐ Nguồn 24VDC Người vẽ Kiểm tra; Đoàn T.D Hiển; SƠ ĐỒ TỦ ĐIỆN 1 Trường ĐH.SPKT - Khoa: CKM

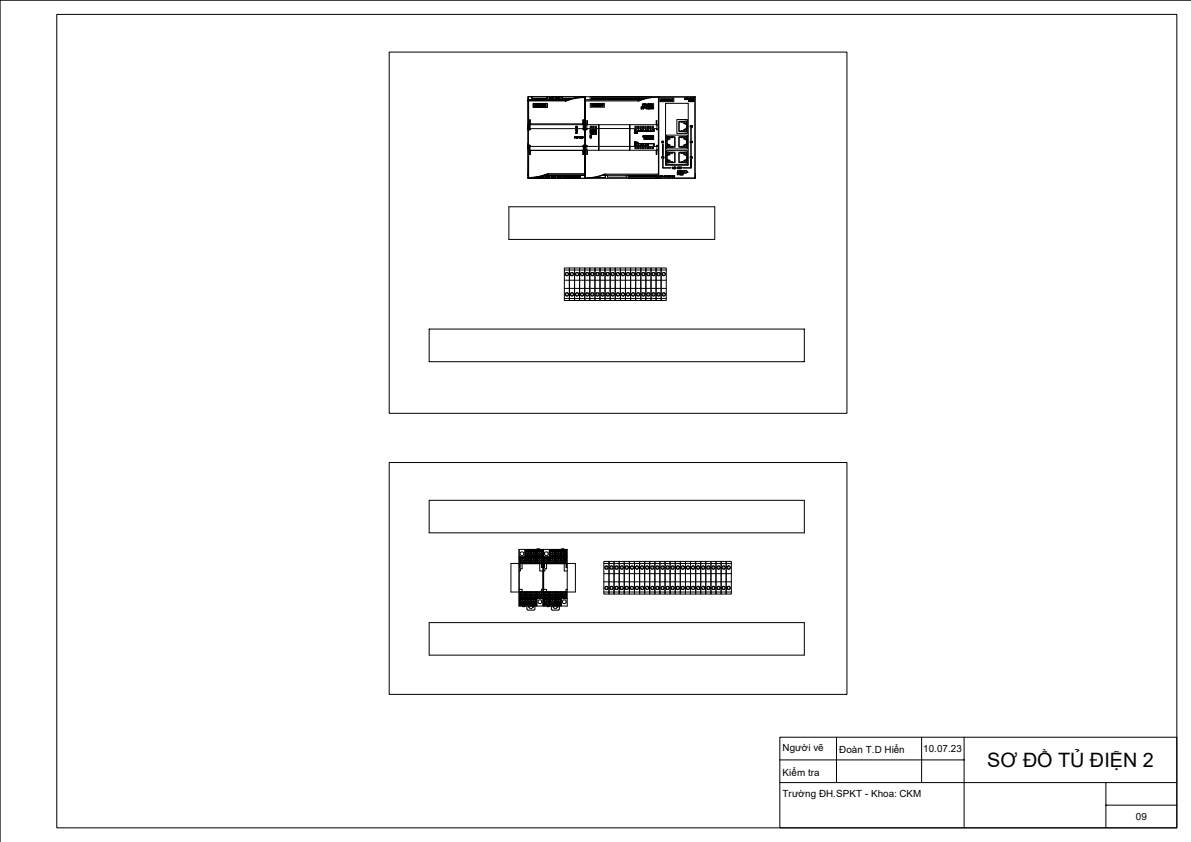
[picture p387: page 10]
Người vẽ Kiểm tra; Đoàn T.D Hiển; SƠ ĐỒ TỦ ĐIỆN 2 Trường ĐH.SPKT - Khoa: CKM
