TNH510/5_DOF_Robot_Arm/tong_hop_ban_ve/ban_ve_canh_tay_robot/pdf/HCMUTE_0006.pdf

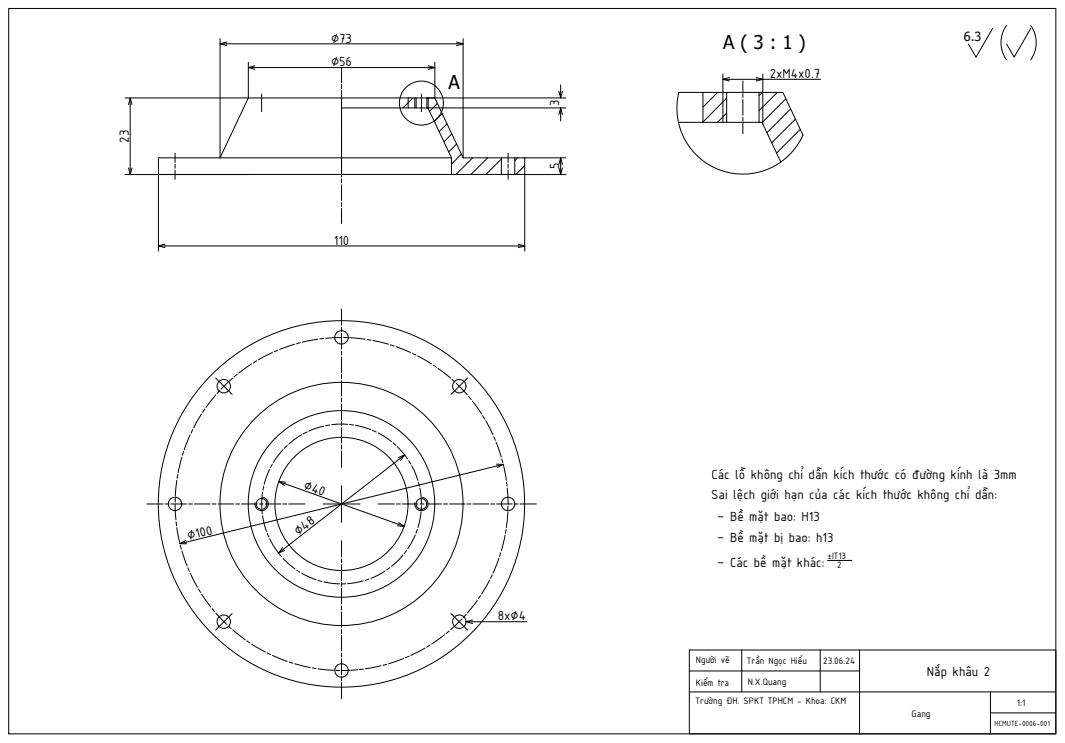
[picture p388: page 1]
Gang

23 2xM4x0.7 A ( 3 : 1 ) A 6.3 5 Trần Ngọc Hiểu 23.06.24 N.X.Quang 2 ±IT13 – Các bề mặt khác: – Bề mặt bị bao: h13 – Bề mặt bao: H13 Sai lệch giới hạn của các kích thước không chỉ dẫn: Các lỗ không chỉ dẫn kích thước có đường kính là 3mm HCMUTE-0006-001

Nắp khâu 2 Kiểm tra Người vẽ

Trường ĐH. SPKT TPHCM - Khoa: CKM
