TNH510/5_DOF_Robot_Arm/tong_hop_ban_ve/ban_ve_canh_tay_robot/pdf/HCMUTE_0007.pdf

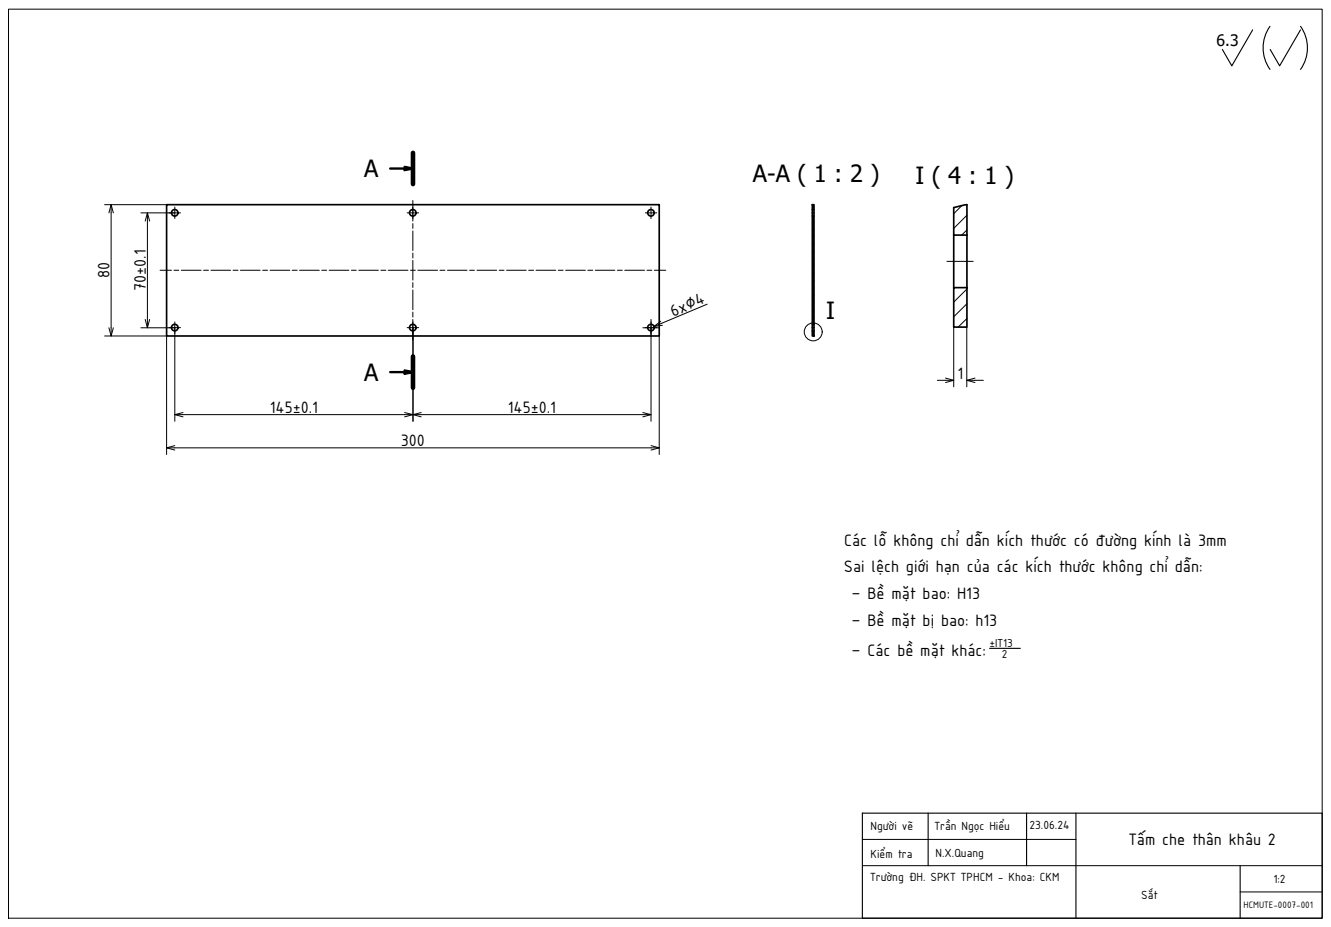
[picture p389: page 1]
Sắt; HCMUTE-0007-001 1:2 AA

70±0.1 1 6x∅4 300 145±0.1 145±0.1 I 6.3 Trần Ngọc Hiểu 23.06.24 N.X.Quang 2 ±IT13 – Các bề mặt khác: – Bề mặt bị bao: h13 – Bề mặt bao: H13 Sai lệch giới hạn của các kích thước không chỉ dẫn: Các lỗ không chỉ dẫn kích thước có đường kính là 3mm

Người vẽ | Tấm che thân khâu 2

Kiểm tra

Trường ĐH. SPKT TPHCM - Khoa: CKM
