TNH510/5_DOF_Robot_Arm/tong_hop_ban_ve/ban_ve_canh_tay_robot/pdf/HCMUTE_0023.pdf

100

110

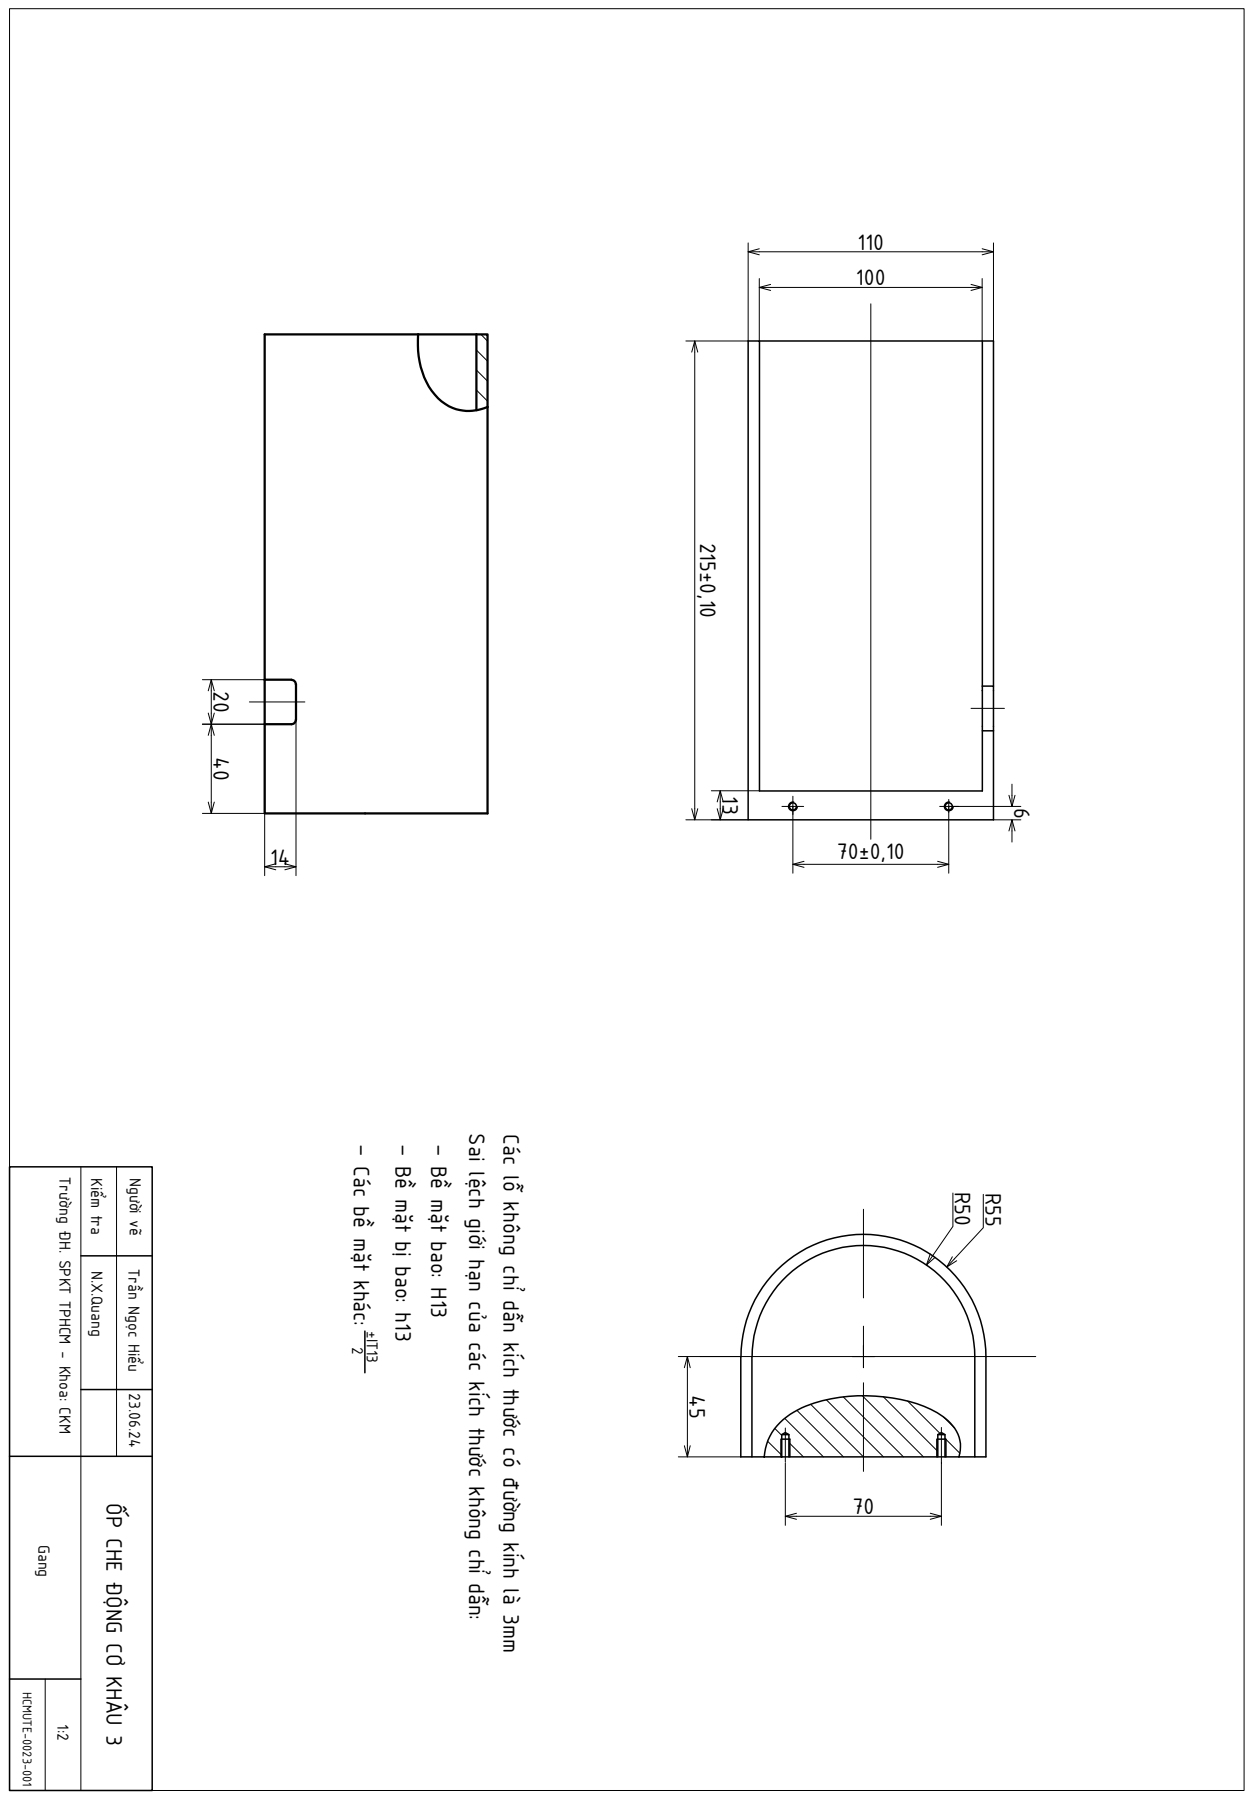
[picture p390: page 1]
70±0,10 ²¹⁵±0,10 13 20 40; 6 23.06.24 N.X.Quang; Trần Ngọc Hiểu; 2 ±IT13 – Các bề mặt khác:; – Bề mặt bị bao: h13 – Bề mặt bao: H13 Sai lệch giới hạn của các kích thước không chỉ dẫn: Các lỗ không chỉ dẫn kích thước có đường kính là 3mm HCMUTE-0023-001

ỐP CHE ĐỘNG CƠ KHÂU 3 Trường ĐH. SPKT TPHCM - Khoa: CKM Kiểm tra Người vẽ Gang 1:2
