TNH510/5_DOF_Robot_Arm/tong_hop_ban_ve/ban_ve_thiet_bi_theo_doi_chuyen_dong/pdf/HCMUTE-0001-001.pdf

38
28

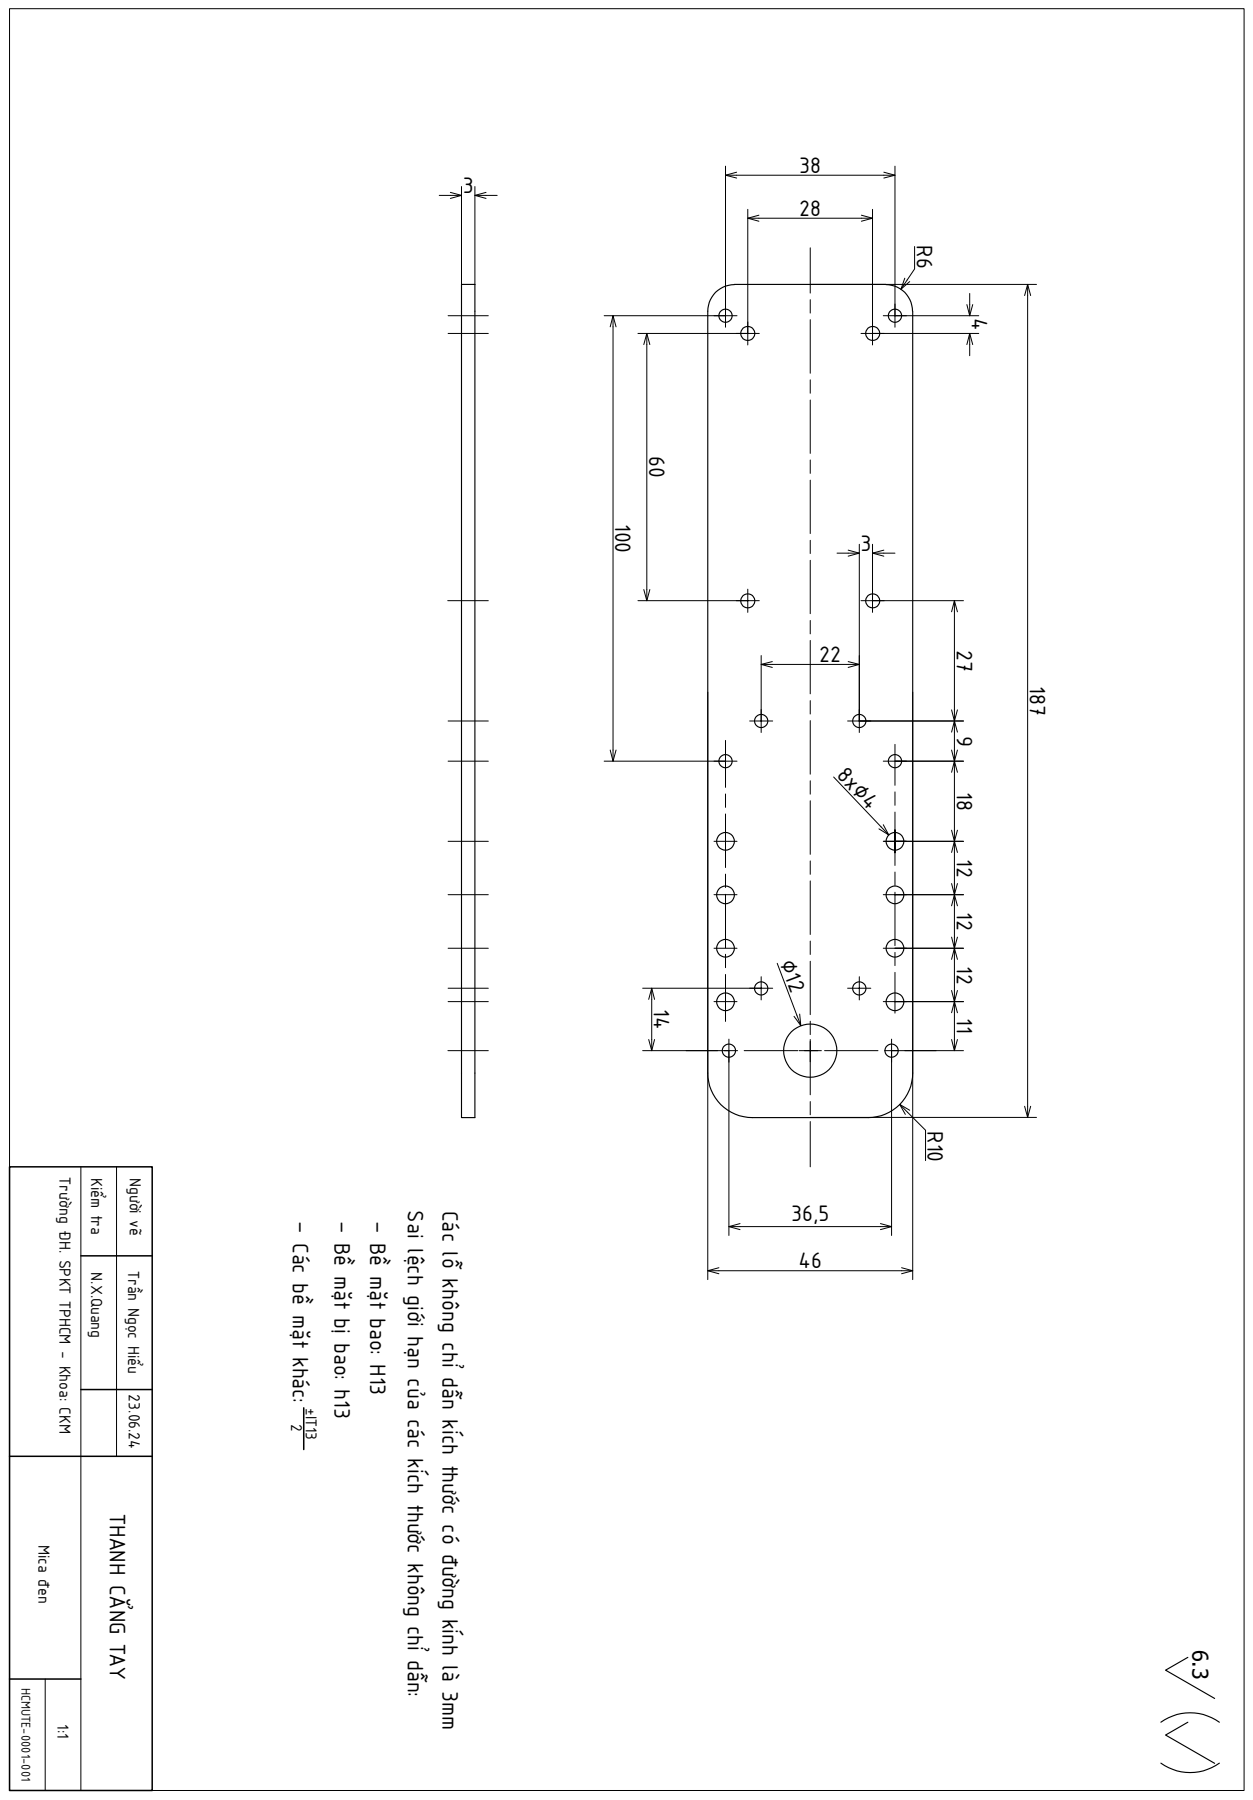
[picture p391: page 1]
12 3 2 ±IT13 – Các bề mặt khác:; – Bề mặt bị bao: h13 – Bề mặt bao: H13 Sai lệch giới hạn của các kích thước không chỉ dẫn:; 6.3 R6 R10 Các lỗ không chỉ dẫn kích thước có đường kính là 3mm

THANH CẲNG TAY 23.06.24 Trần Ngọc Hiểu Trường ĐH. SPKT TPHCM - Khoa: CKM Kiểm tra Người vẽ Mica đen 1:1 HCMUTE-0001-001 N.X.Quang
