TNH510/5_DOF_Robot_Arm/tong_hop_ban_ve/ban_ve_thiet_bi_theo_doi_chuyen_dong/pdf/HCMUTE-0002-001.pdf

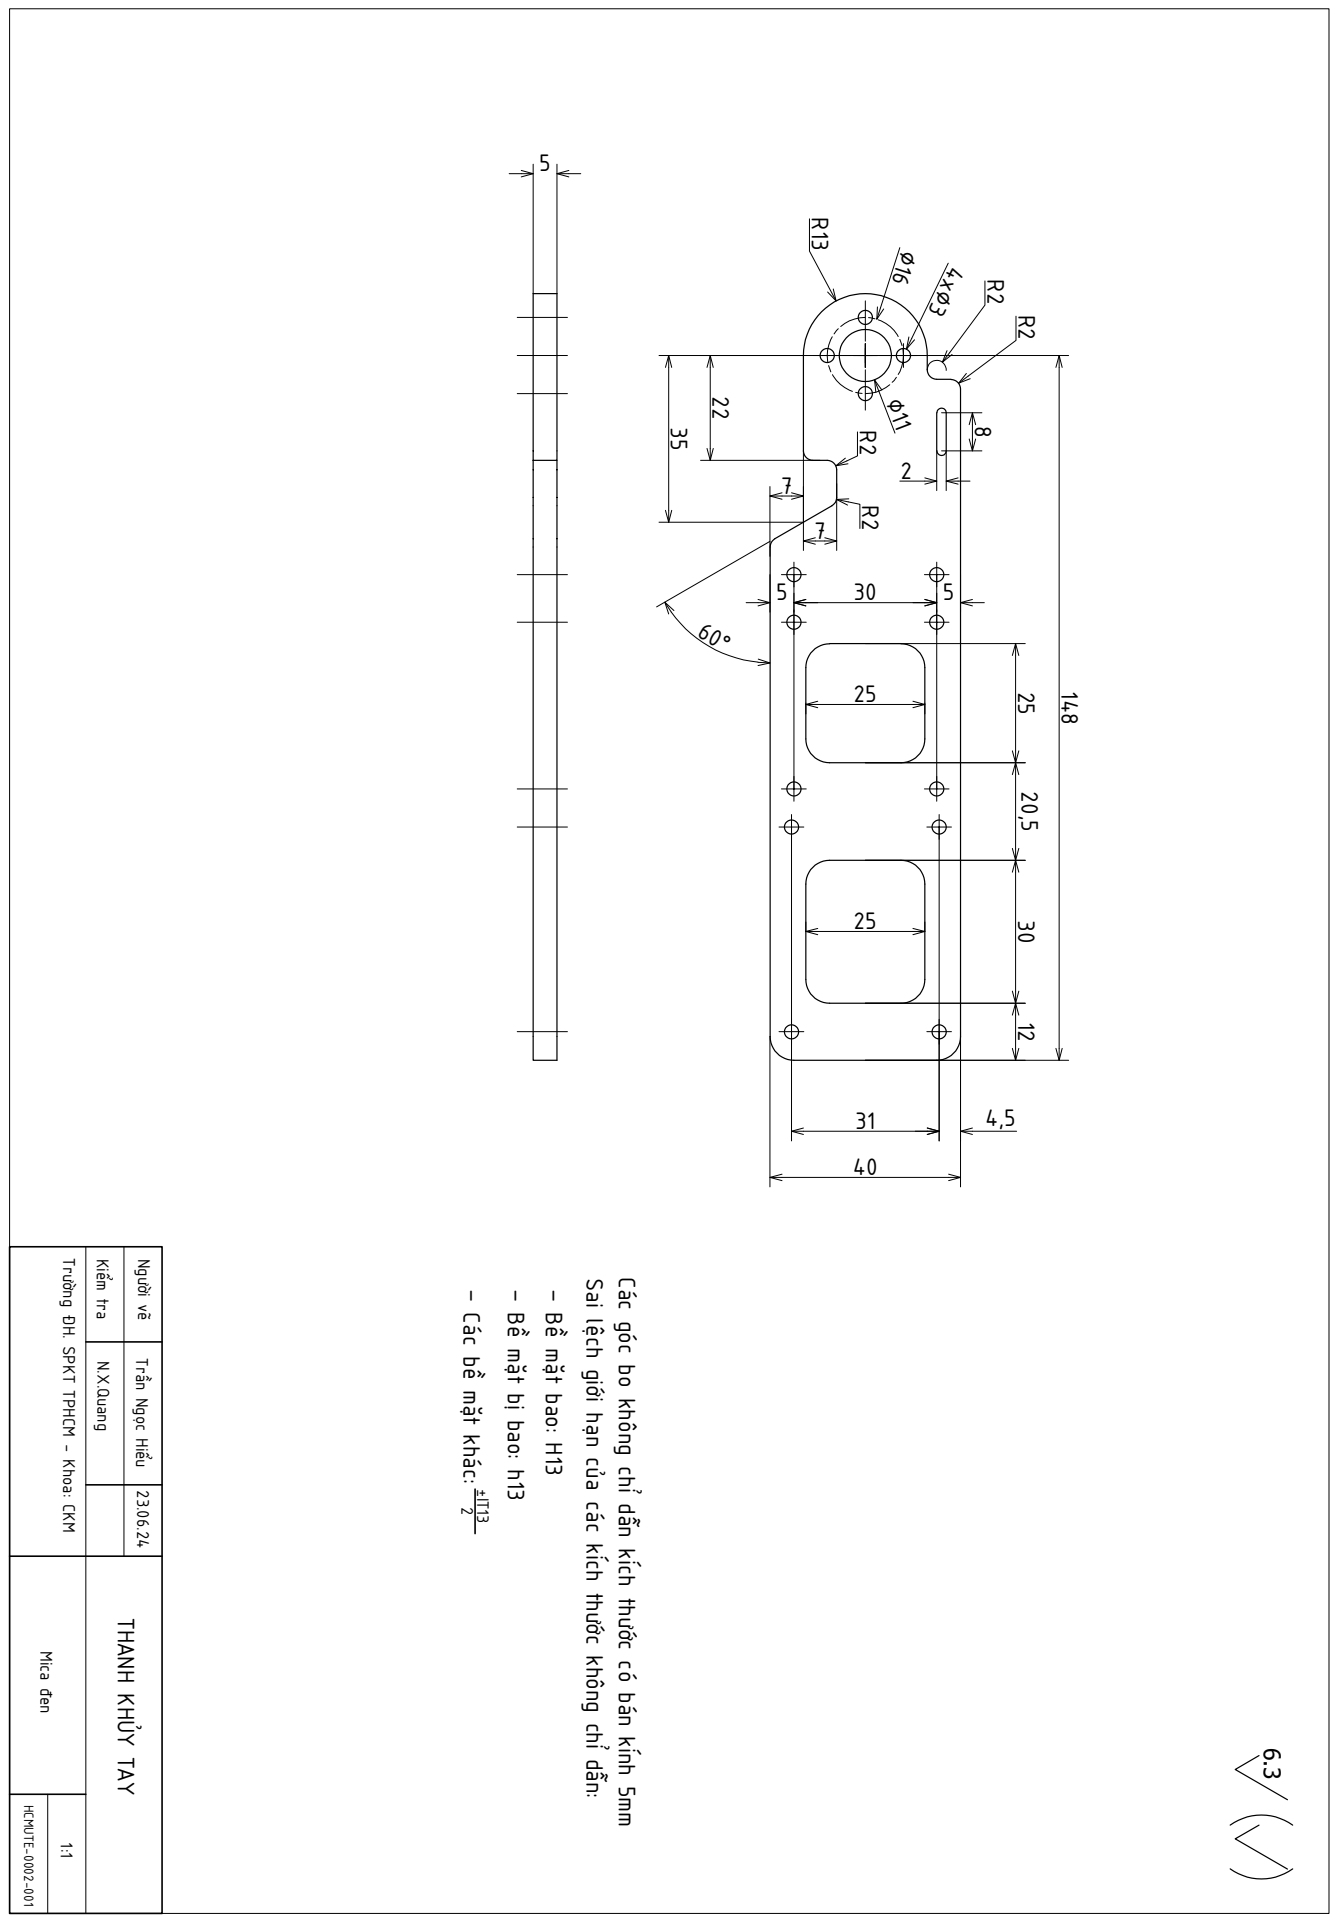
[picture p392: page 1]
5 ²² 2 ±IT13 – Các bề mặt khác:; – Bề mặt bị bao: h13 – Bề mặt bao: H13 Sai lệch giới hạn của các kích thước không chỉ dẫn:; R2 ∅16 ∅11 4x∅3 R2 R2 Các góc bo không chỉ dẫn kích thước có bán kính 5mm

THANH KHỦY TAY 23.06.24 Trần Ngọc Hiểu Trường ĐH. SPKT TPHCM - Khoa: CKM Kiểm tra Người vẽ Mica đen 1:1 HCMUTE-0002-001 N.X.Quang 148 R13 5 25 30 12 20,5
