TNH510/5_DOF_Robot_Arm/tong_hop_ban_ve/ban_ve_thiet_bi_theo_doi_chuyen_dong/pdf/HCMUTE-0003-001.pdf

22

30 8 | 3 ⁵ | 5 ∅3 25

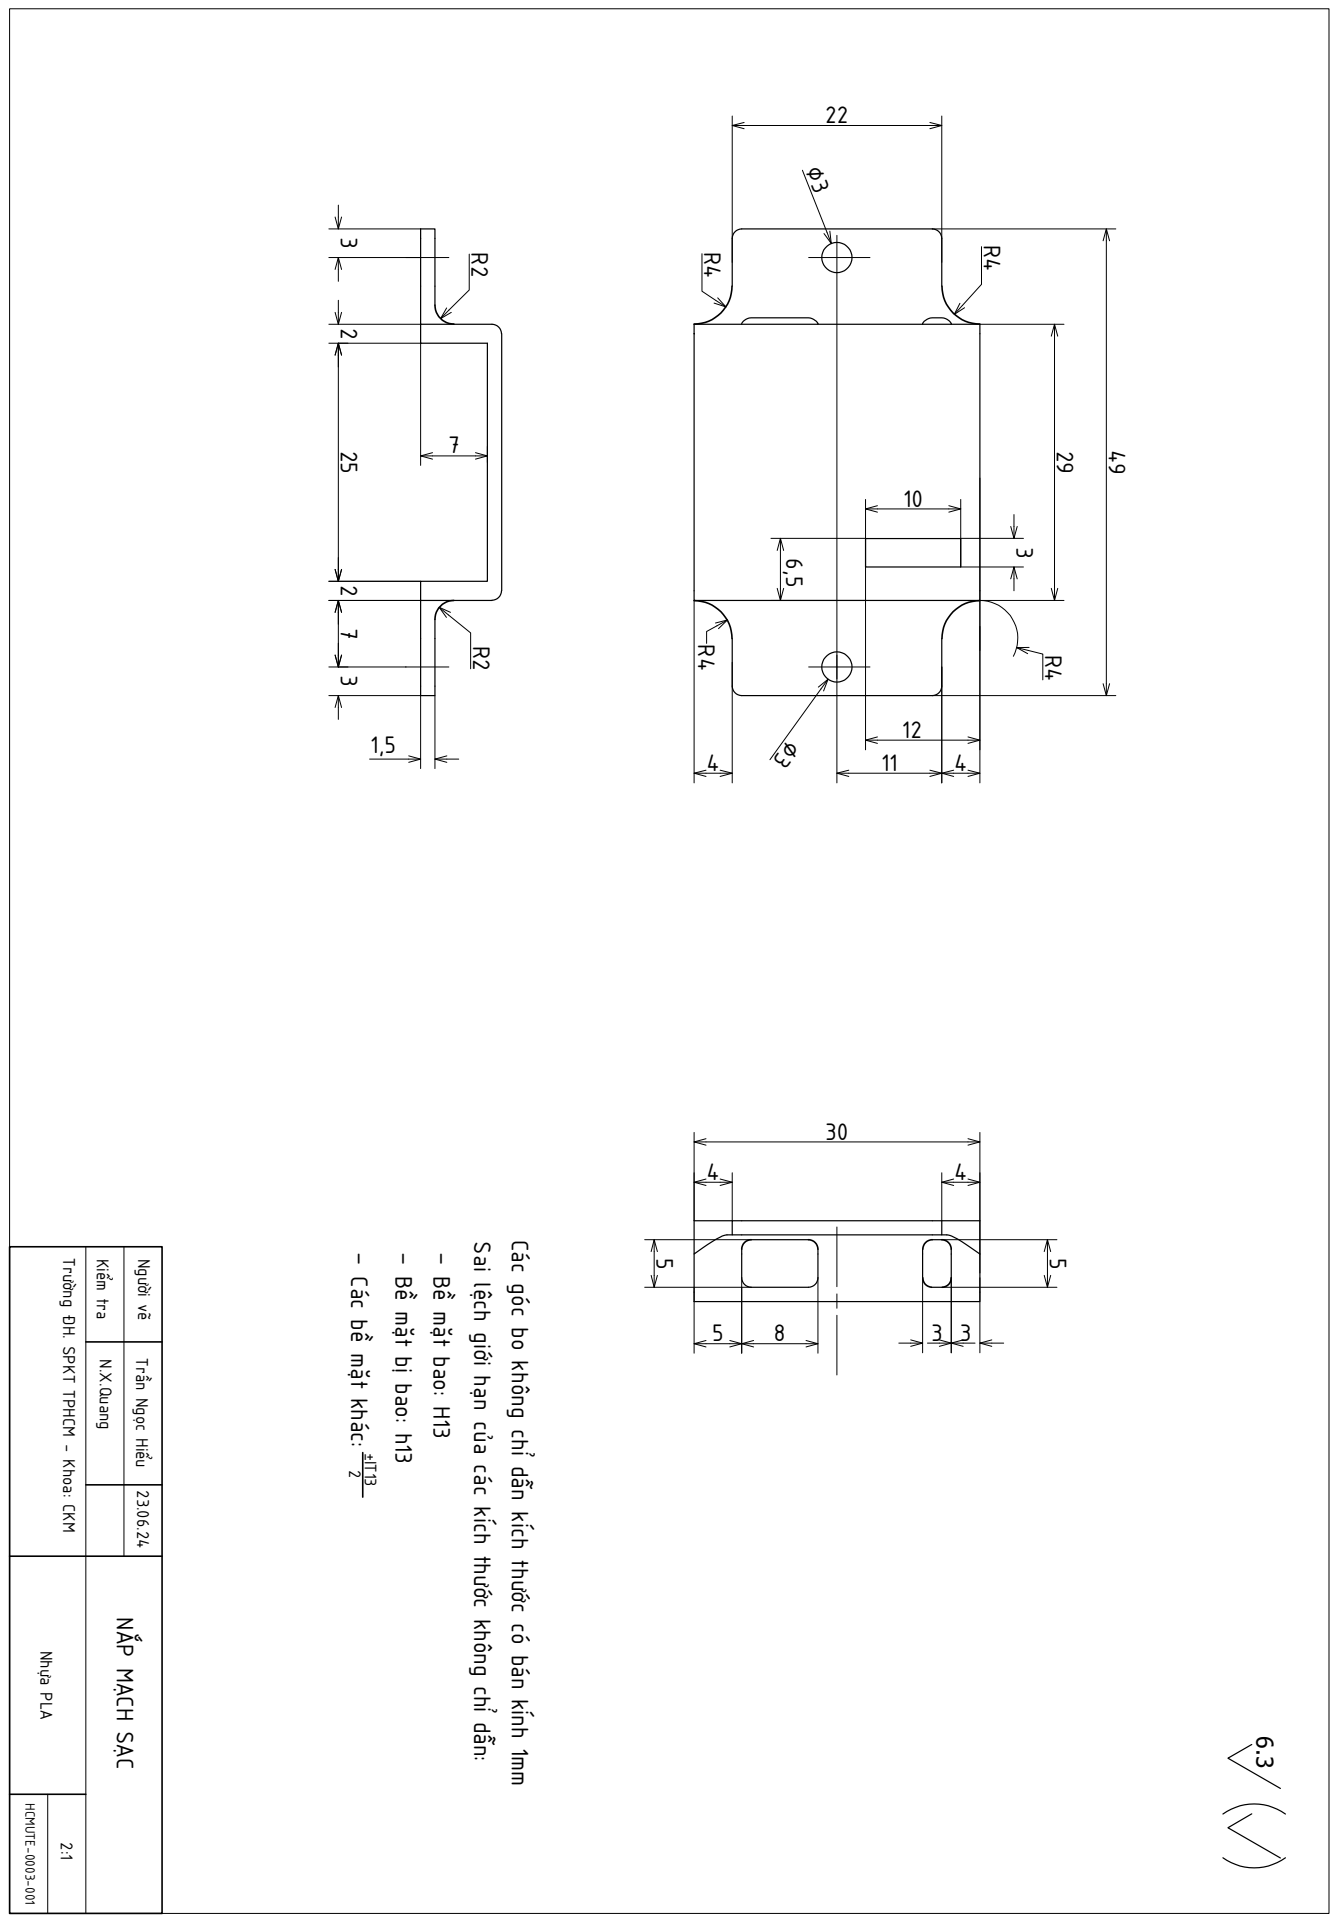
[picture p393: page 1]
1,5 ² HCMUTE-0003-001; N.X.Quang; 4 2 ±IT13 – Các bề mặt khác:; – Bề mặt bị bao: h13 – Bề mặt bao: H13 Sai lệch giới hạn của các kích thước không chỉ dẫn:; Các góc bo không chỉ dẫn kích thước có bán kính 1mm

NẮP MẠCH SẠC 23.06.24 Trần Ngọc Hiểu Trường ĐH. SPKT TPHCM - Khoa: CKM Kiểm tra Người vẽ Nhựa PLA 2:1 29 3 49
