TNH510/5_DOF_Robot_Arm/tong_hop_ban_ve/ban_ve_thiet_bi_theo_doi_chuyen_dong/pdf/HCMUTE-0004-001.pdf

5,5 | 15,5 | 15,5 10 11 | 5 3 5 3 | 6 5 11 5 | 1

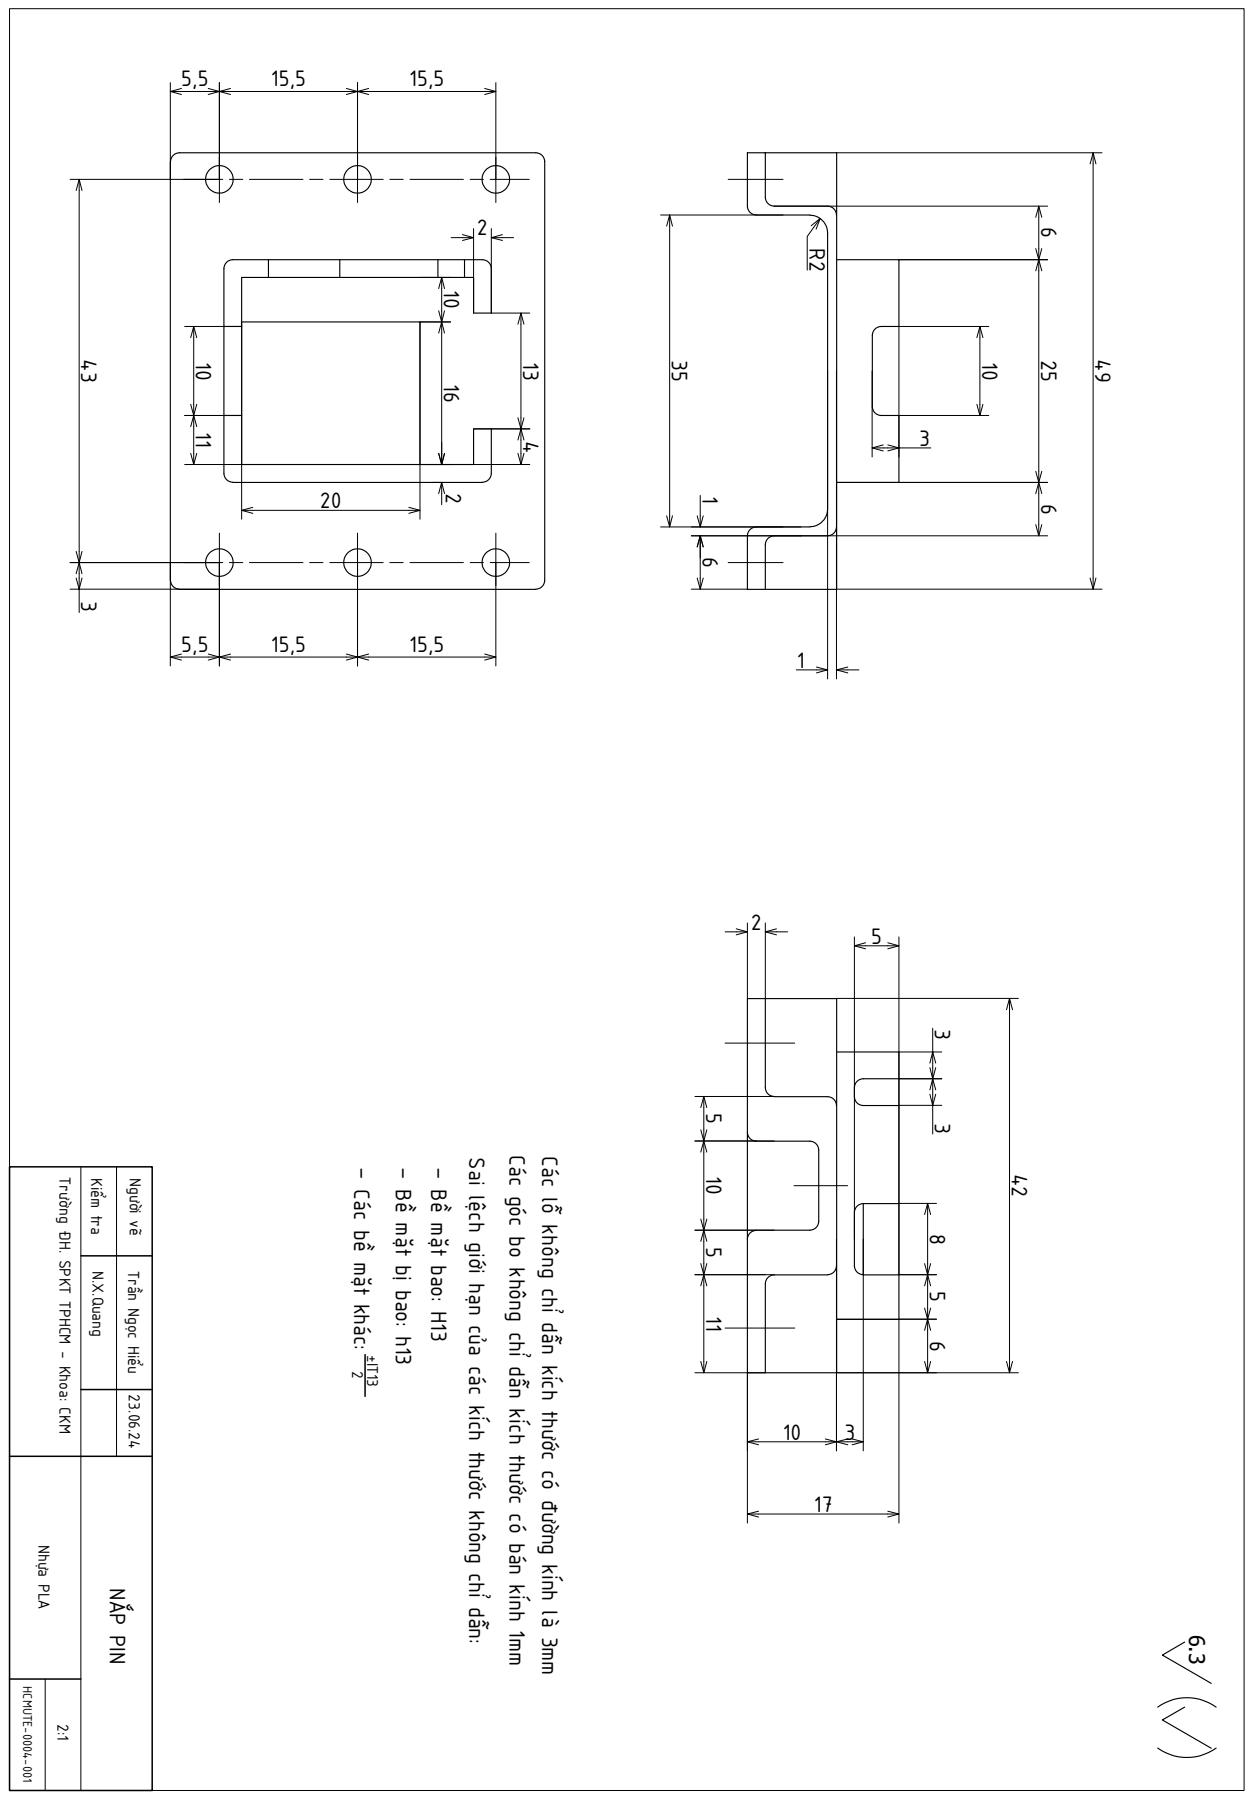
[picture p394: page 1]
3 8 HCMUTE-0004-001; N.X.Quang; 2 ±IT13 – Các bề mặt khác:; – Bề mặt bị bao: h13 – Bề mặt bao: H13 Sai lệch giới hạn của các kích thước không chỉ dẫn:; Các góc bo không chỉ dẫn kích thước có bán kính 1mm; Các lỗ không chỉ dẫn kích thước có đường kính là 3mm ⁴³ ³

NẮP PIN 23.06.24 Trần Ngọc Hiểu Trường ĐH. SPKT TPHCM - Khoa: CKM Kiểm tra Người vẽ Nhựa PLA 2:1 102549 R2 42
