TNH510/5_DOF_Robot_Arm/tong_hop_ban_ve/ban_ve_thiet_bi_theo_doi_chuyen_dong/pdf/HCMUTE-0006-001.pdf

38 ∅3

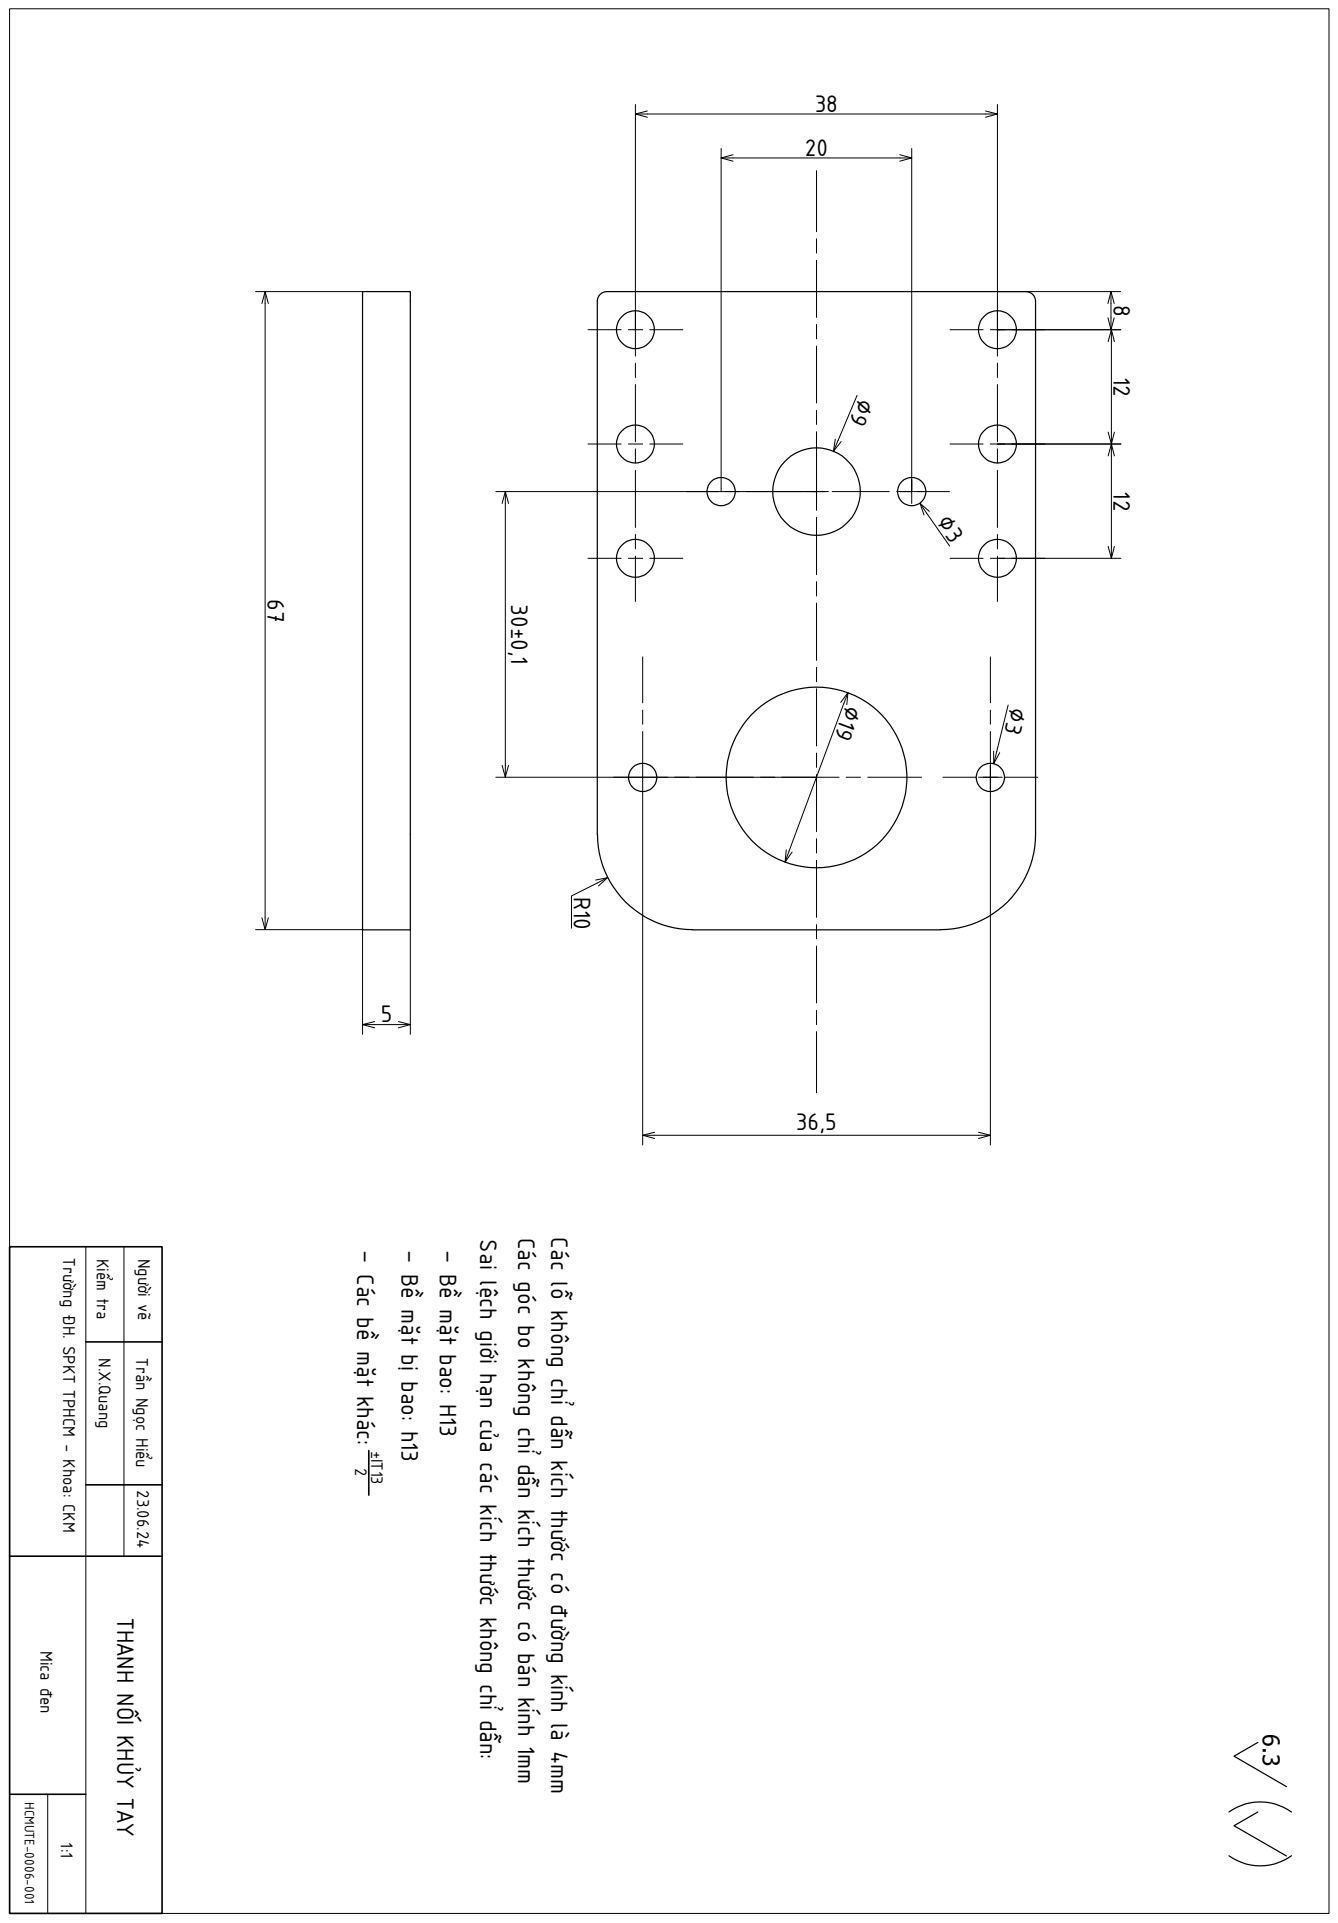
[picture p395: page 1]
∅3 2 ±IT13 – Các bề mặt khác:; – Bề mặt bị bao: h13 – Bề mặt bao: H13 Sai lệch giới hạn của các kích thước không chỉ dẫn:; Các góc bo không chỉ dẫn kích thước có bán kính 1mm; 6.3 Các lỗ không chỉ dẫn kích thước có đường kính là 4mm HCMUTE-0006-001; N.X.Quang

THANH NỐI KHỦY TAY 23.06.24 Trần Ngọc Hiểu Trường ĐH. SPKT TPHCM - Khoa: CKM Kiểm tra Người vẽ Mica đen 1:1 12 12 ∅19 ∅9
