TNH510/5_DOF_Robot_Arm/control_glove/pcb/control_glove_v0.1/schematic.pdf

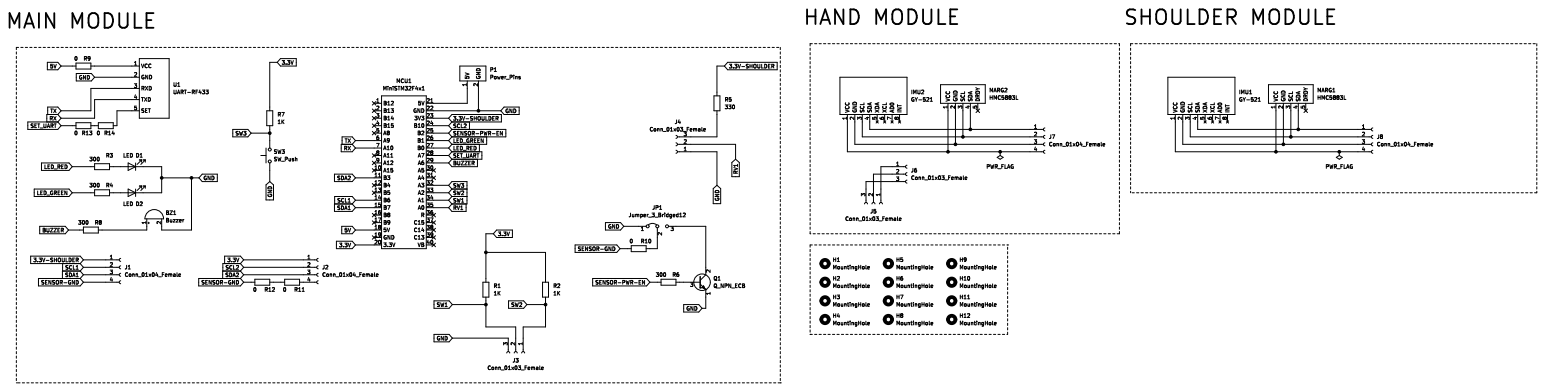
[picture p396: page 1]
