TNH510/5_DOF_Robot_Arm/control_glove/pcb/pcb_final.pdf

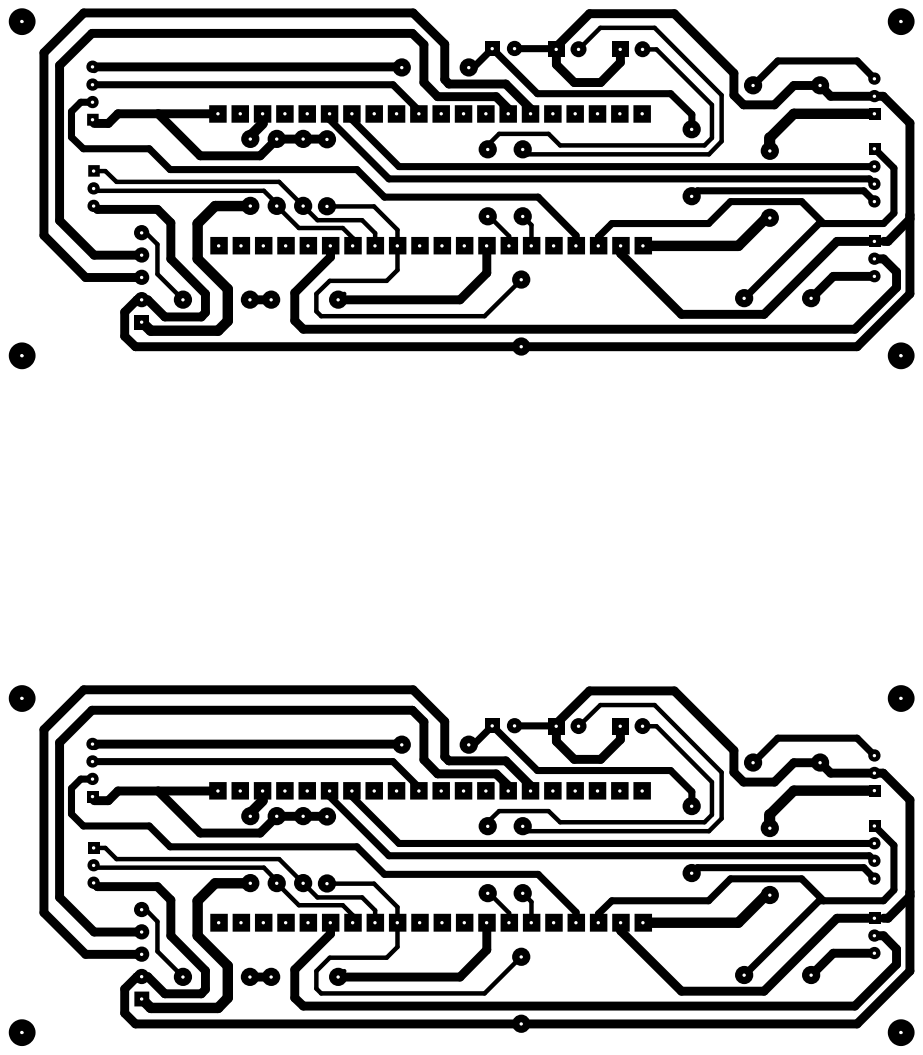
[picture p397: page 1]
