TNH510/5_DOF_Robot_Arm/tong_hop_ban_ve/ban_ve_canh_tay_robot/pdf/khau_0_A0-BAN VE A0.pdf

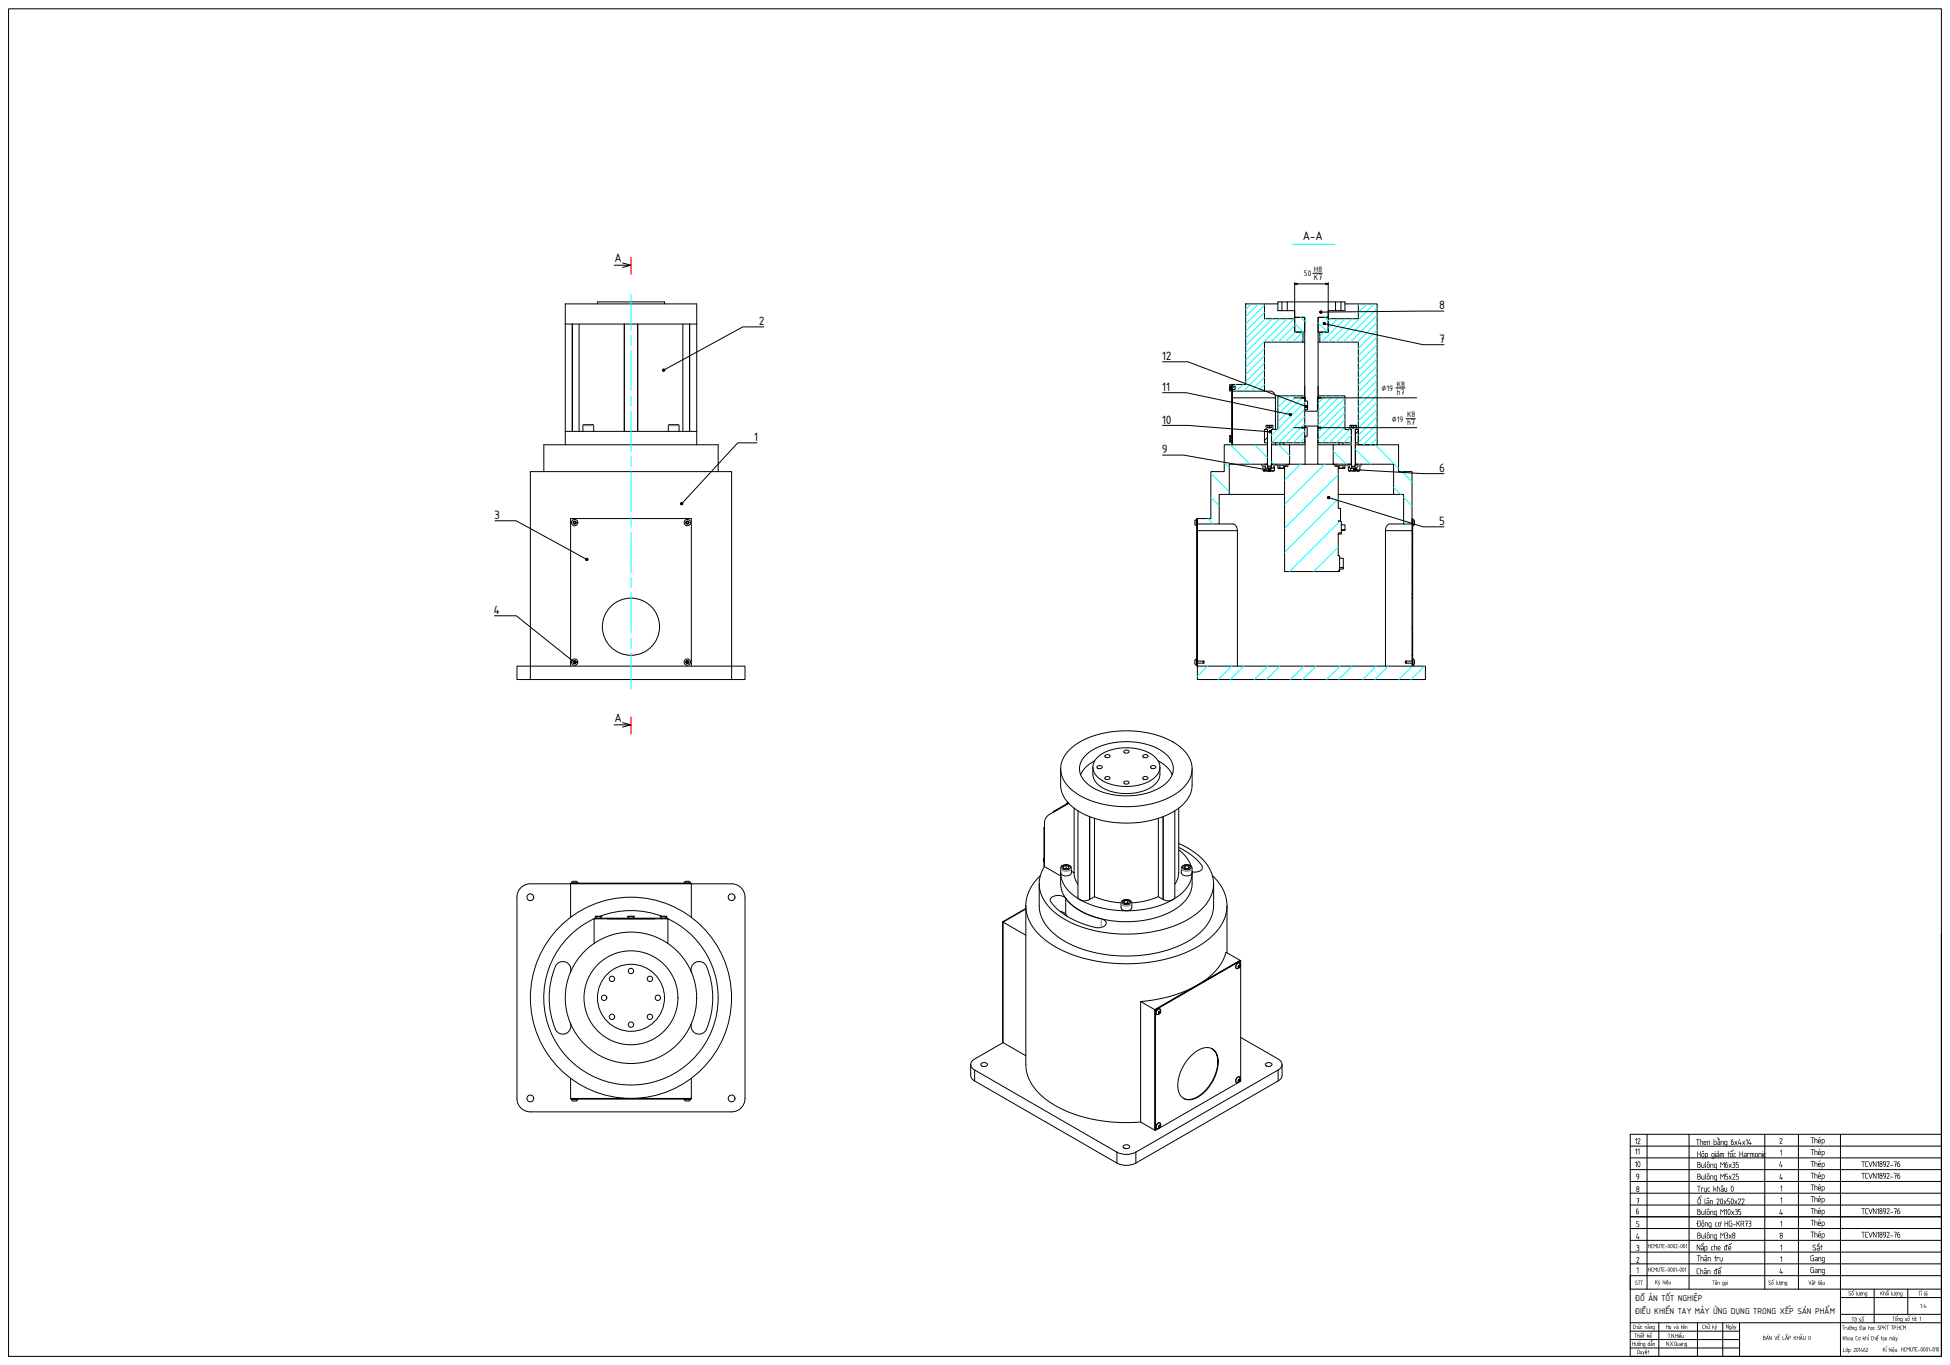
[picture p398: page 1]
Chức năng; T.N.Hiểu STT; Ký hiệu; Trường Đại học SPKT TP.HCM Khoa Cơ khí Chế tạo máy N.X.Quang ĐỒ ÁN TỐT NGHIỆP ĐIỀU KHIỂN TAY MÁY ỨNG DỤNG TRONG XẾP SẢN PHẨM BẢN VẼ LẮP KHÂU 0 Chữ ký; Ngày; Số lượng; Khối lượng; 1:4 Tên gọi; Vật liệu; Kí hiệu:; HCMUTE-0001-810 Tổng số tờ: 1

8 | | 12 Bulông M3x8 Bulông M10x35 Bulông M6x35 Bulông M5x25 Hộp giảm tốc Harmonic Then bằng 6x4x14 1 | Gang Sắt Thép Thép Thép Thép Thép Thép Thép Thép Thép | TCVN1892-76 TCVN1892-76 TCVN1892-76 TCVN1892-76 HCMUTE-0002-001 HCMUTE-0001-001
91112 | Trục khâu 0

710 | Ổ lăn 20x50x22 | 4

6 | | 14
5 | Chân đế
Nắp che đế Thân trụ | 1 3 1 4

8 Động cơ HG-KR73

4 | Gang

Họ và tên | Lớp: 201462

Thiết kế
Hướng dẫn
Duyệt
