TNH510/5_DOF_Robot_Arm/tong_hop_ban_ve/ban_ve_canh_tay_robot/pdf/UTE_02.pdf

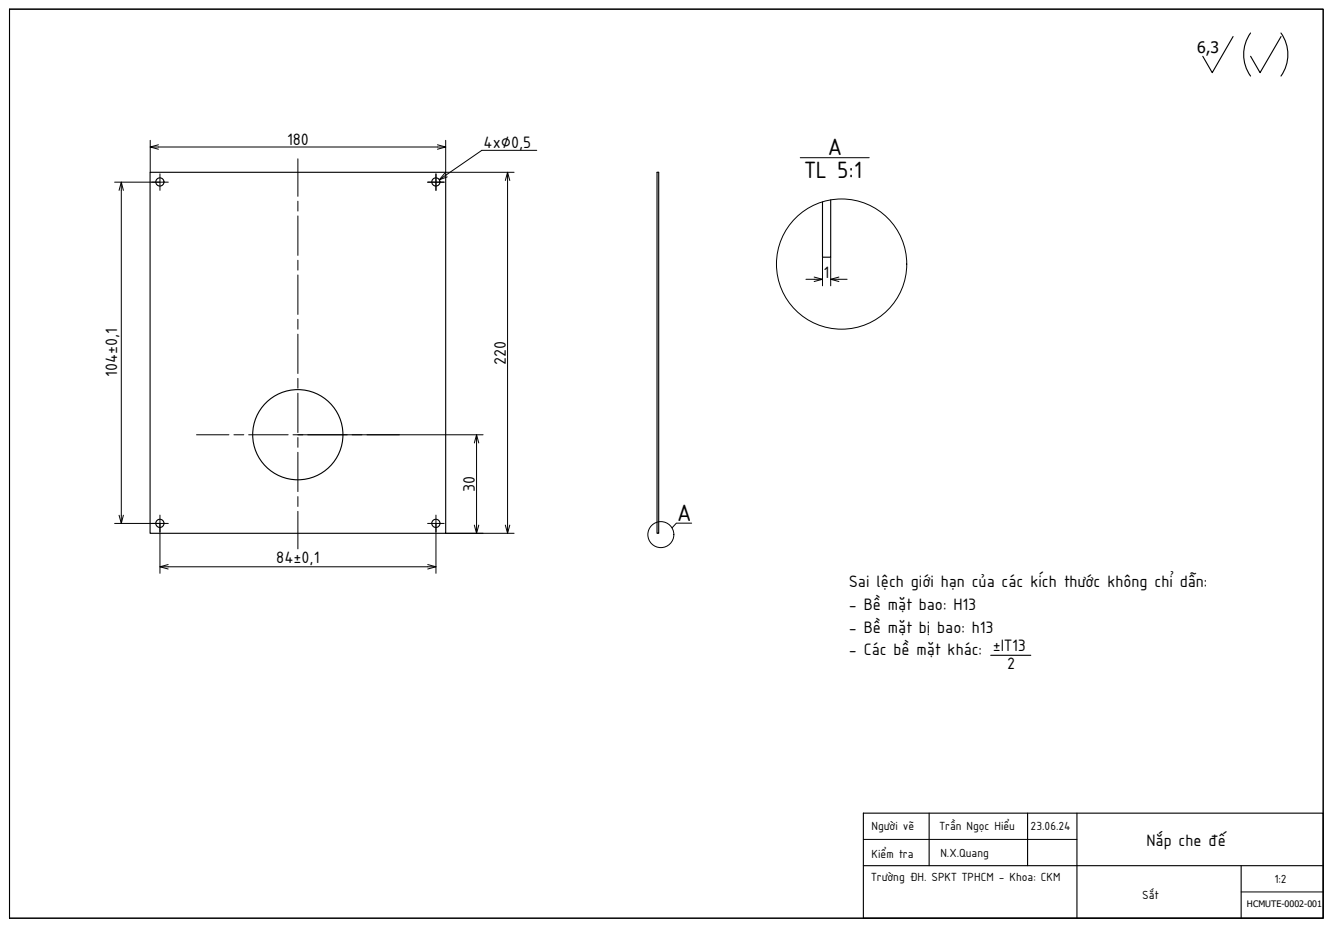
[picture p399: page 1]
Sắt; HCMUTE-0002-001 1:2 6,3 180; - Các bề mặt khác: ±IT13 2 TL 5:1 A; Trần Ngọc Hiểu; 23.06.24 N.X.Quang

30 4x∅0,5 Sai lệch giới hạn của các kích thước không chỉ dẫn:

- Bề mặt bao: H13
- Bề mặt bị bao: h13

Nắp che đế Kiểm tra Người vẽ

Trường ĐH. SPKT TPHCM - Khoa: CKM
