TNH510/5_DOF_Robot_Arm/tong_hop_ban_ve/ban_ve_canh_tay_robot/pdf/BAN_VE_LAP_ROBOT.pdf

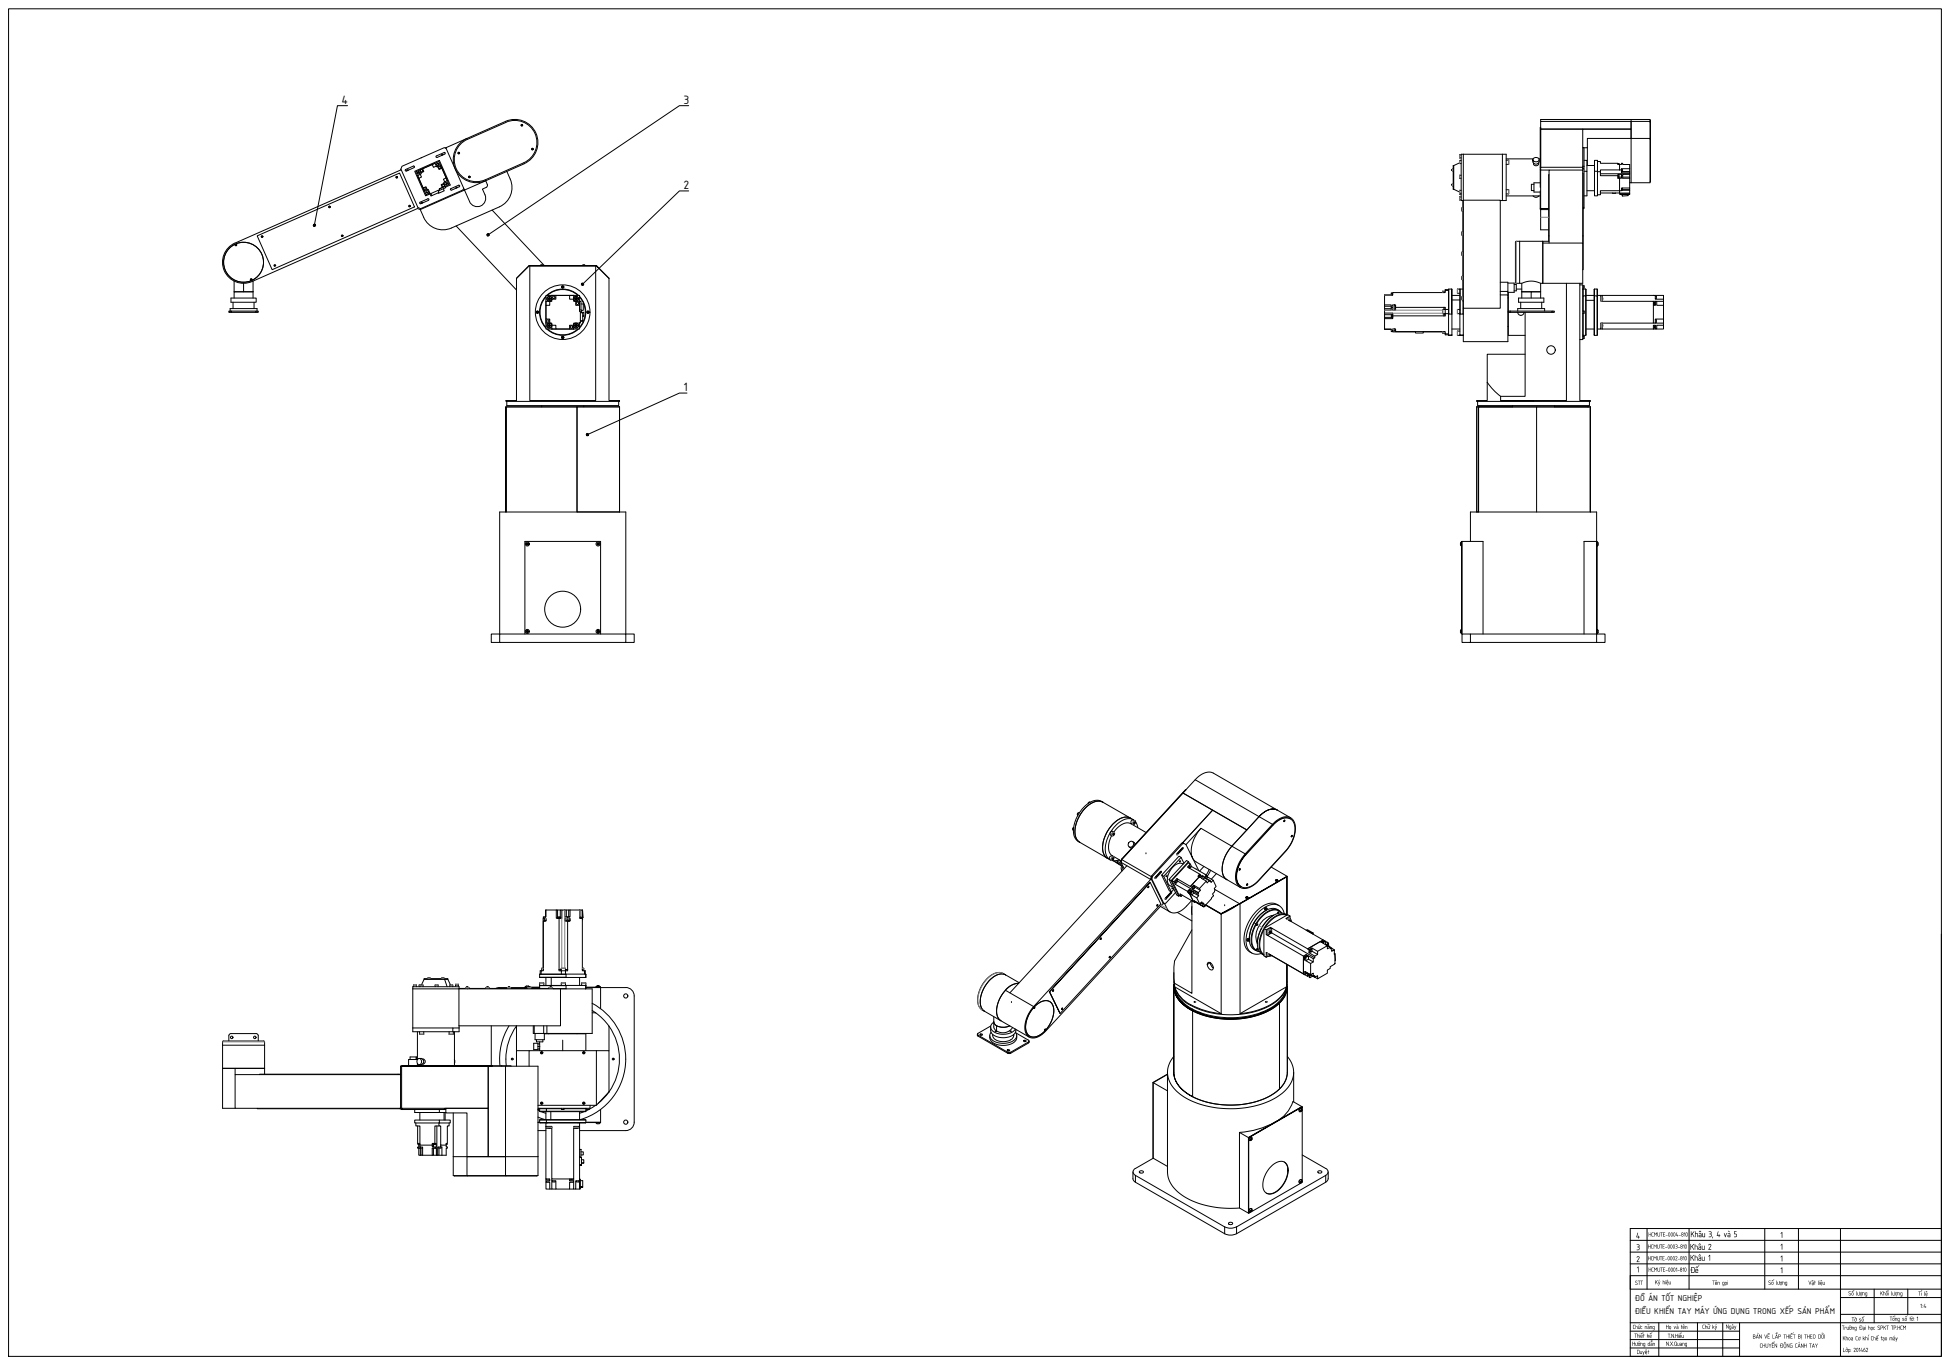
[picture p400: page 1]
T.N.Hiểu STT; Ký hiệu; Trường Đại học SPKT TP.HCM Khoa Cơ khí Chế tạo máy N.X.Quang ĐỒ ÁN TỐT NGHIỆP ĐIỀU KHIỂN TAY MÁY ỨNG DỤNG TRONG XẾP SẢN PHẨM BẢN VẼ LẮP THIẾT BỊ THEO DÕI CHUYỂN ĐỘNG CÁNH TAY Chữ ký; Ngày; Số lượng; Khối lượng; Tổng số tờ: 1; 1:4 Tên gọi; Vật liệu; Lớp: 201462 12; 1 Khâu 1; Khâu 2 Khâu 3, 4 và 5; HCMUTE-0001-810 HCMUTE-0002-810 HCMUTE-0003-810 HCMUTE-0004-810

Chức năng | Họ và tên
Thiết kế
Hướng dẫn
Duyệt
