TNH510/5_DOF_Robot_Arm/tong_hop_ban_ve/ban_ve_canh_tay_robot/pdf/khau_1_A0-BAN VE A0.pdf

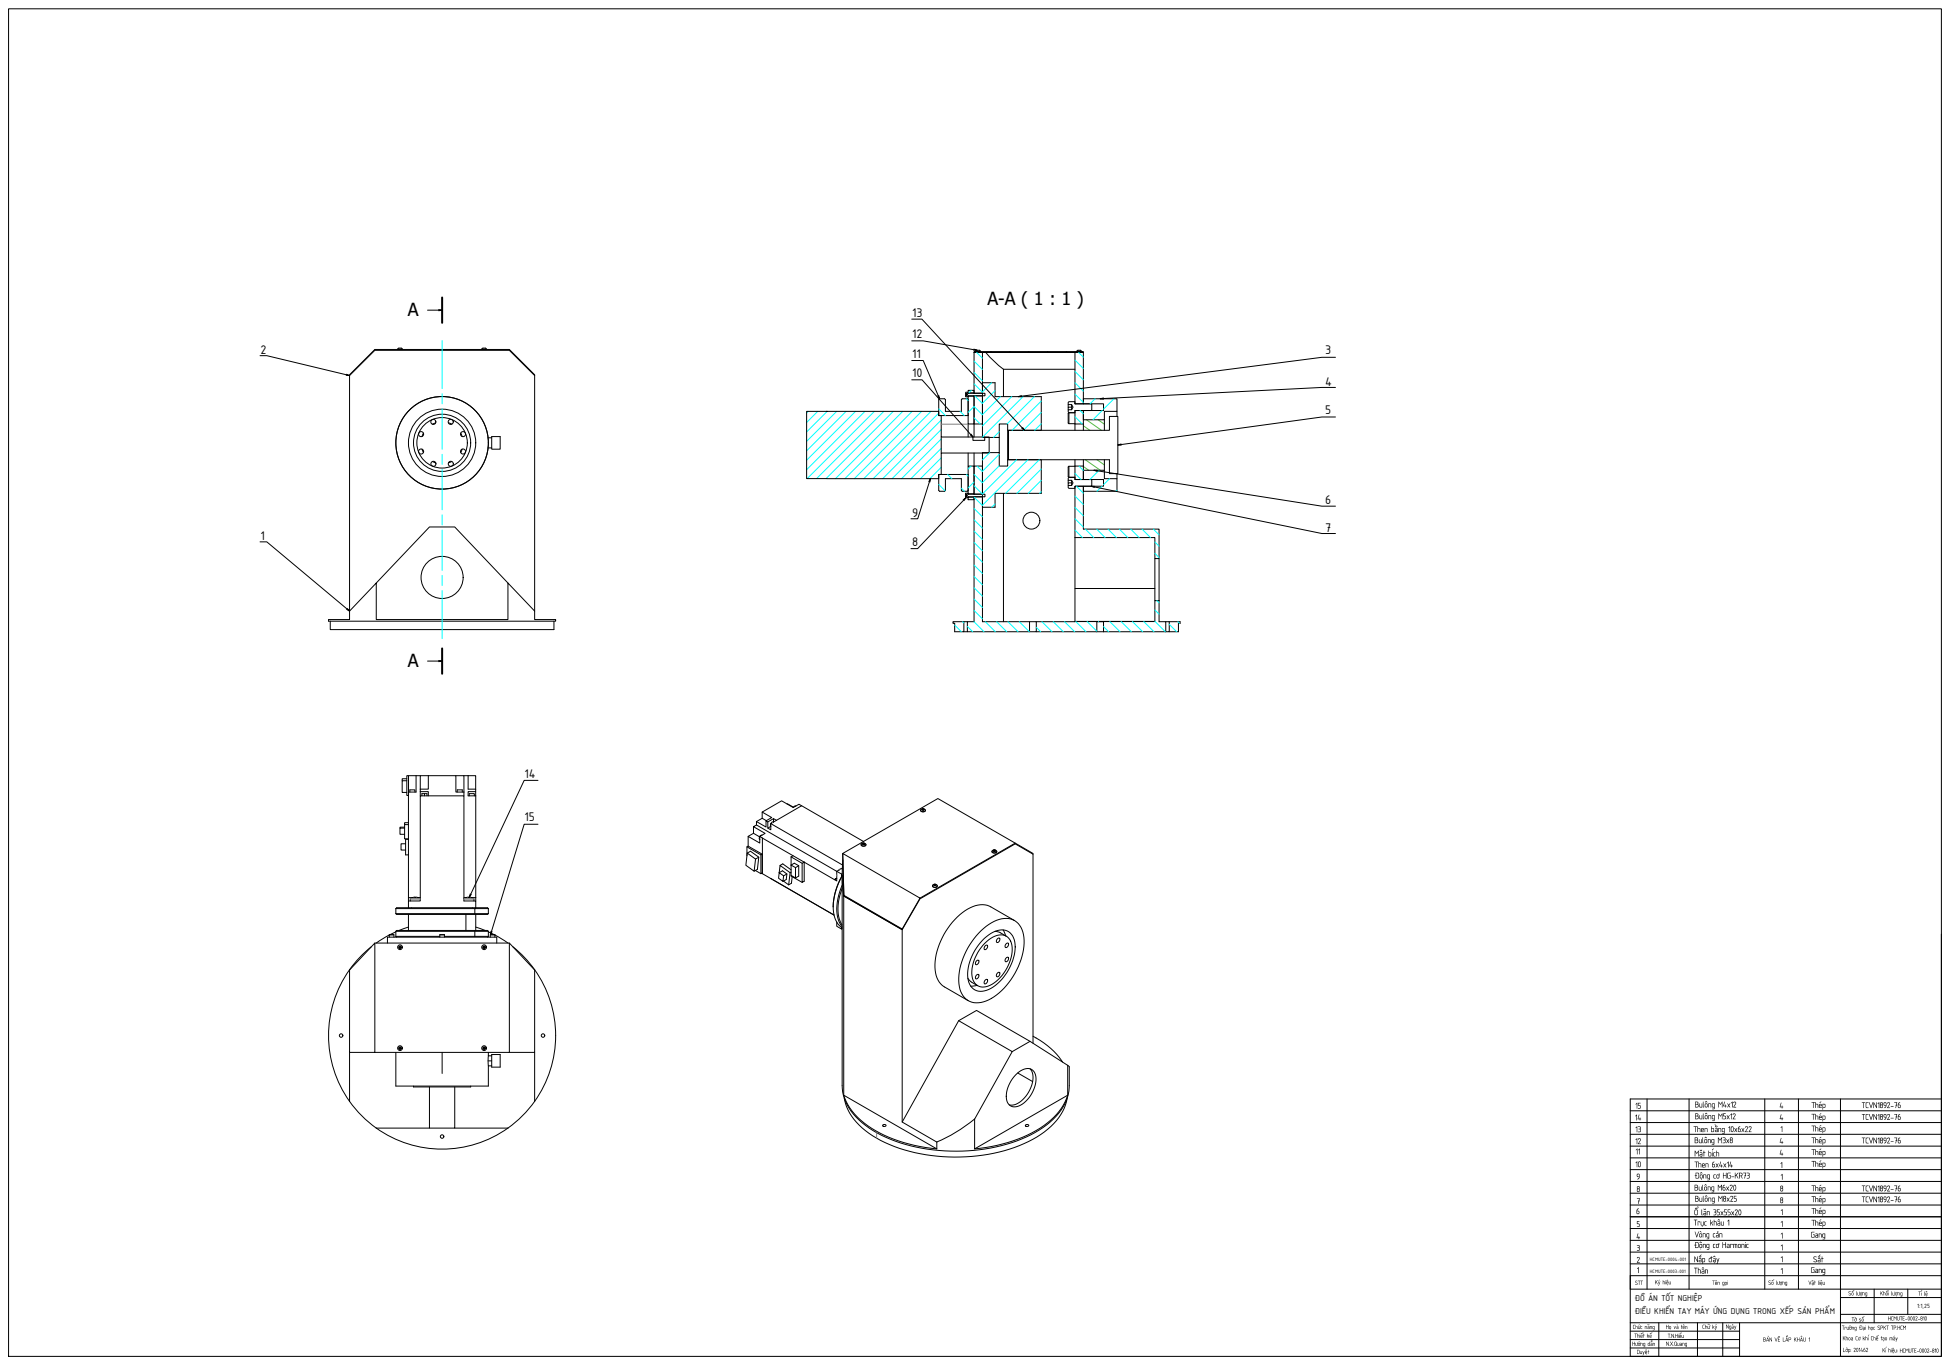
[picture p401: page 1]
T.N.Hiểu STT; Ký hiệu; Trường Đại học SPKT TP.HCM Khoa Cơ khí Chế tạo máy N.X.Quang ĐỒ ÁN TỐT NGHIỆP ĐIỀU KHIỂN TAY MÁY ỨNG DỤNG TRONG XẾP SẢN PHẨM Chữ ký; Ngày; Số lượng; Khối lượng; 1:1,25 Tên gọi; Vật liệu; Lớp: 201462 125; Thân; Gang Nắp đậy; Động cơ Harmonic; 1 Trục khâu 1 6710; Bulông M8x25 89111213; Bulông M6x20; 118141841 Vòng cản Ổ lăn 35x55x20 Mặt bích Động cơ HG-KR73 Then 6x4x14 Bulông M3x8 Then bằng 10x6x22 1415; Bulông M5x12 Bulông M4x12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

Chức năng | Họ và tên
Thiết kế
Hướng dẫn
Duyệt
