TNH510/5_DOF_Robot_Arm/tong_hop_ban_ve/ban_ve_canh_tay_robot/pdf/khau_2_A0-BAN VE A0.pdf

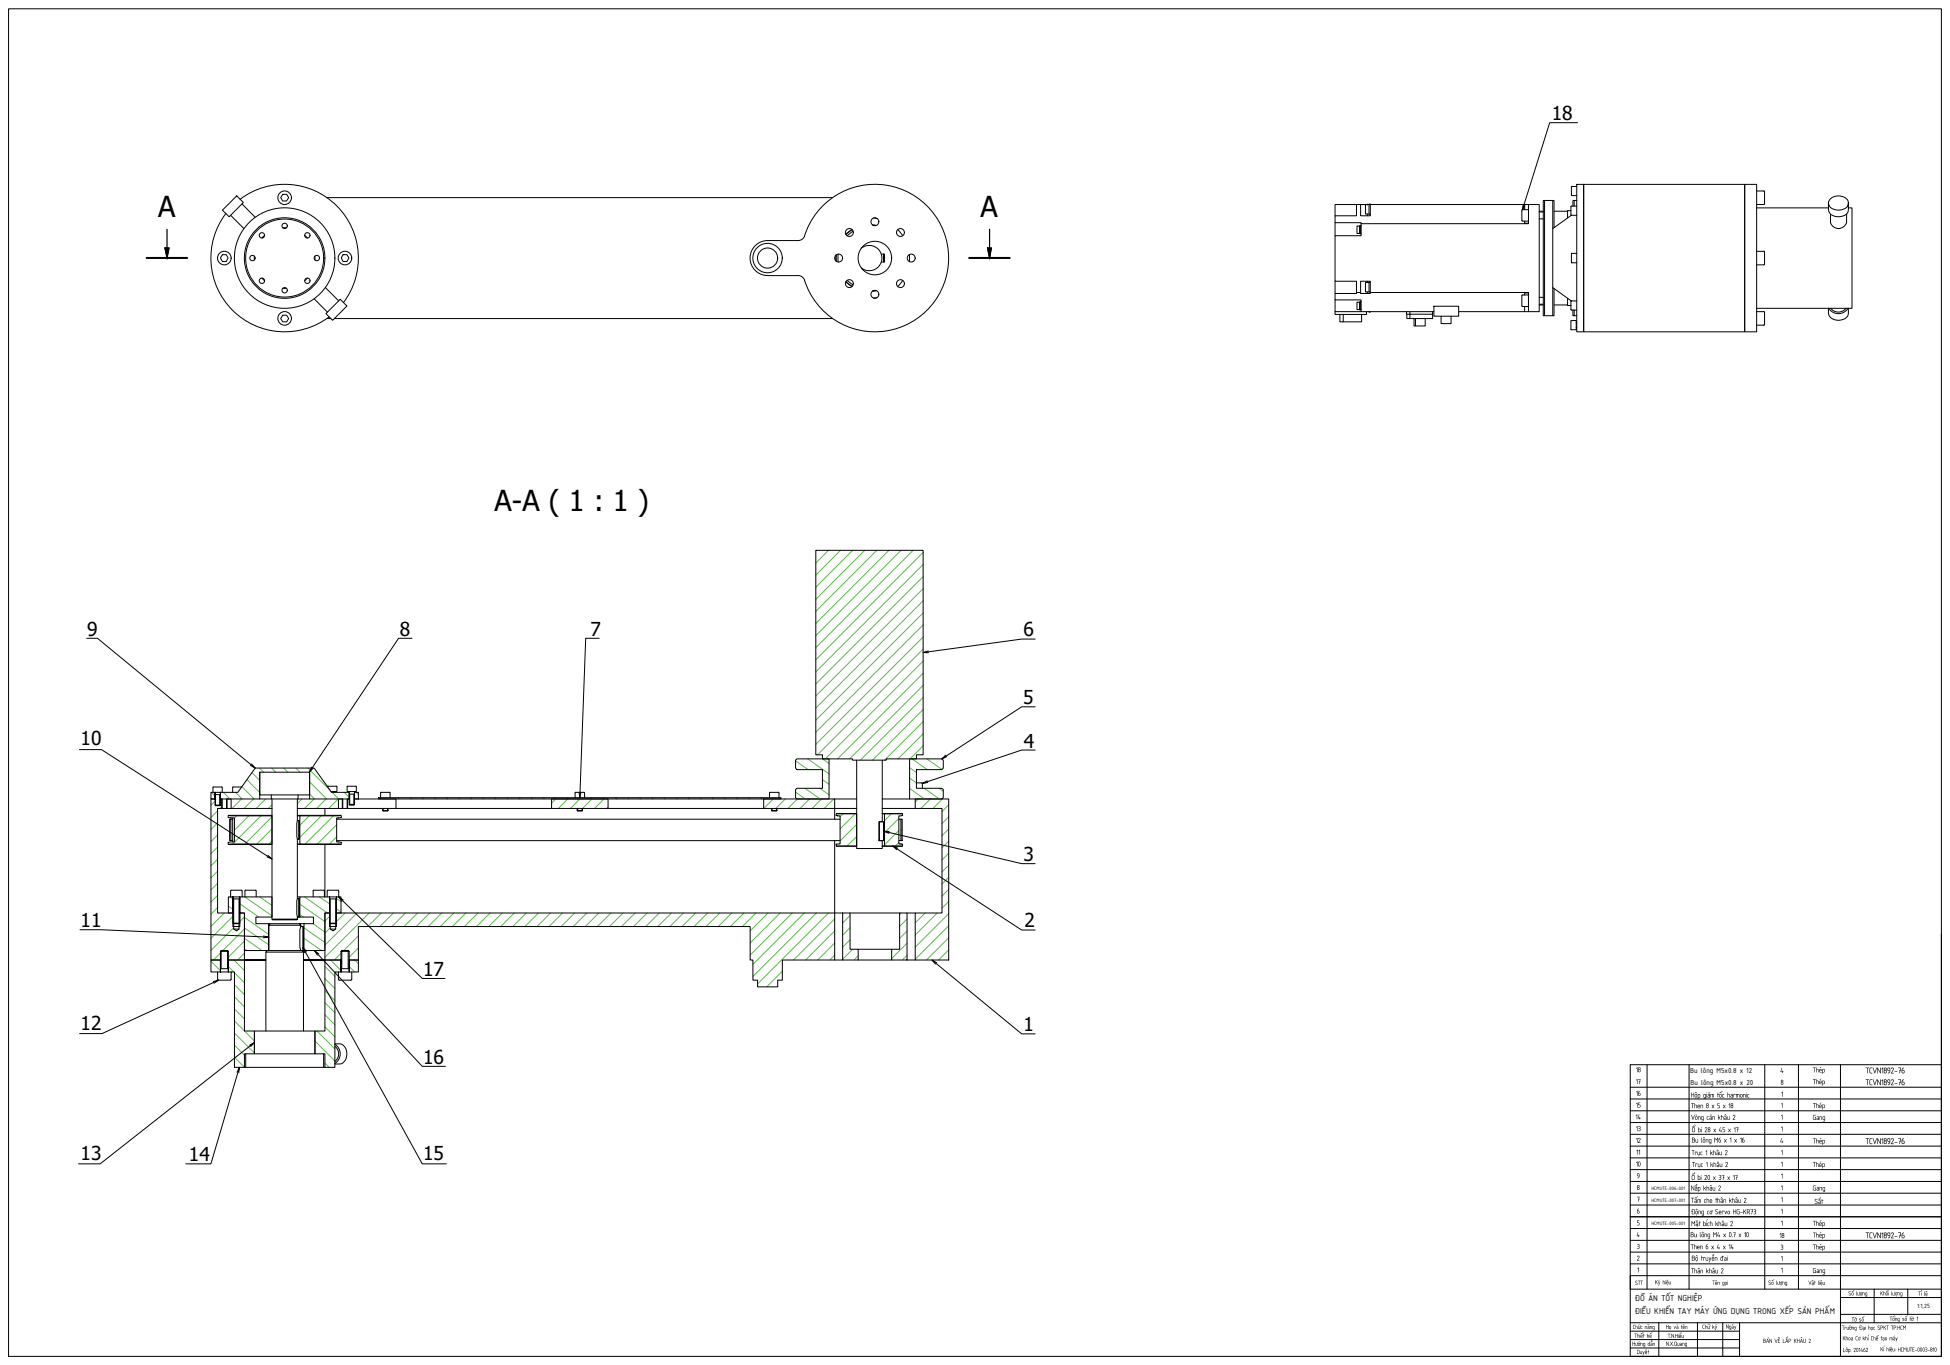
[picture p402: page 1]
Chức năng; T.N.Hiểu STT; Ký hiệu; Trường Đại học SPKT TP.HCM Khoa Cơ khí Chế tạo máy N.X.Quang ĐỒ ÁN TỐT NGHIỆP ĐIỀU KHIỂN TAY MÁY ỨNG DỤNG TRONG XẾP SẢN PHẨM Chữ ký; Ngày; Số lượng; Khối lượng; Tổng số tờ: 1; 1:1,25 Tên gọi; Vật liệu; Lớp: 201462 1; Thân khâu 2 Bộ truyền đai; 3 Bu lông M4 x 0.7 x 10 Then 6 x 4 x 14; 18 Mặt bích khâu 2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

Tấm che thân khâu 2

Động cơ Servo HG-KR73

Họ và tên | Kí hiệu: HCMUTE-0003-810

Thiết kế
Hướng dẫn
Duyệt
