TNH510/5_DOF_Robot_Arm/tong_hop_ban_ve/ban_ve_canh_tay_robot/pdf/HCMUTE_0001.pdf

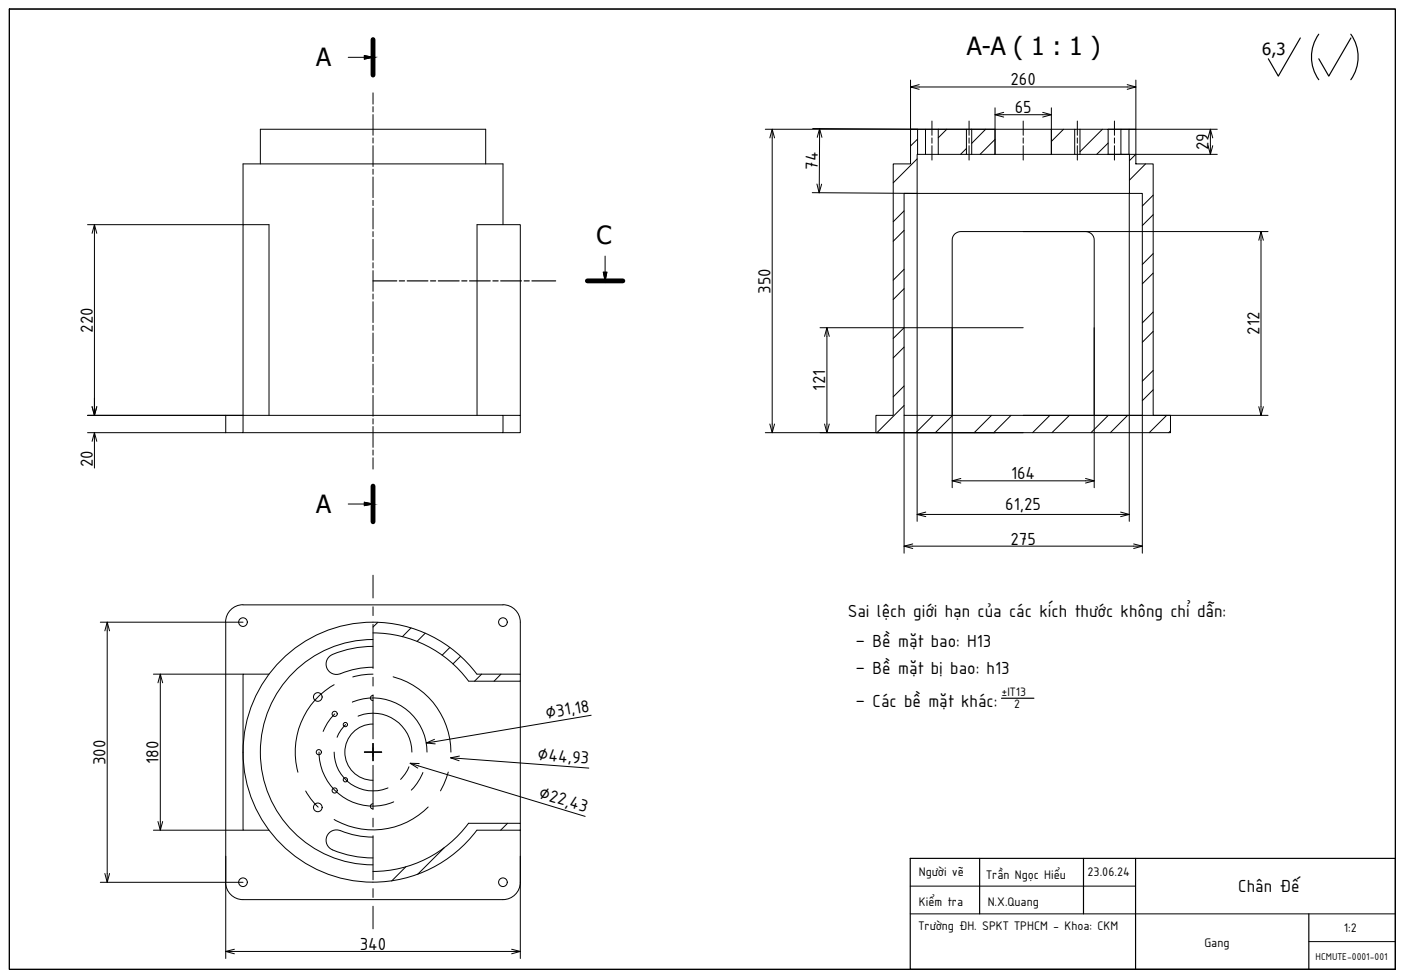
[picture p403: page 1]
Gang; HCMUTE-0001-001 1:2 6,3 ∅44,93 ∅31,18 ∅22,43 340; 212 164 275 61,25 260 65 A C A A-A ( 1 : 1 )23.06.24 N.X.Quang

Sai lệch giới hạn của các kích thước không chỉ dẫn:

– Bề mặt bao: H13
– Bề mặt bị bao: h13
2 ±IT13 – Các bề mặt khác:

Người vẽ | Chân Đế Trần Ngọc Hiểu

Kiểm tra

Trường ĐH. SPKT TPHCM - Khoa: CKM
