TNH510/5_DOF_Robot_Arm/tong_hop_ban_ve/ban_ve_canh_tay_robot/pdf/HCMUTE_0004.pdf

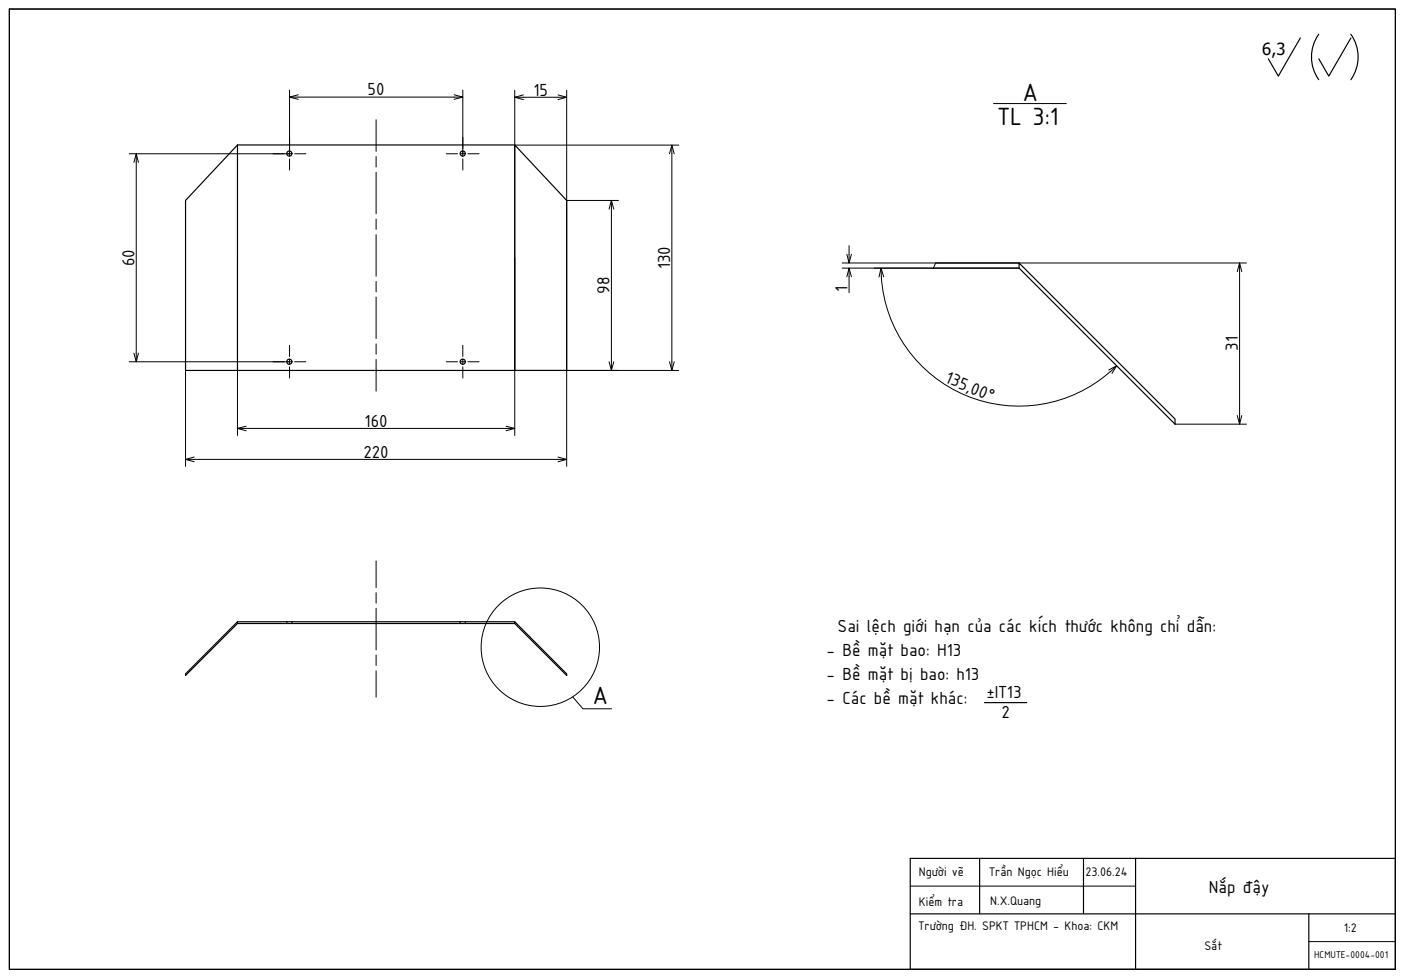
[picture p404: page 1]
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

98 220 15 A Trần Ngọc Hiểu 23.06.24 N.X.Quang

Nắp đậy Kiểm tra Người vẽ

Trường ĐH. SPKT TPHCM - Khoa: CKM
