TNH510/5_DOF_Robot_Arm/tong_hop_ban_ve/ban_ve_canh_tay_robot/pdf/HCMUTE_0008.pdf

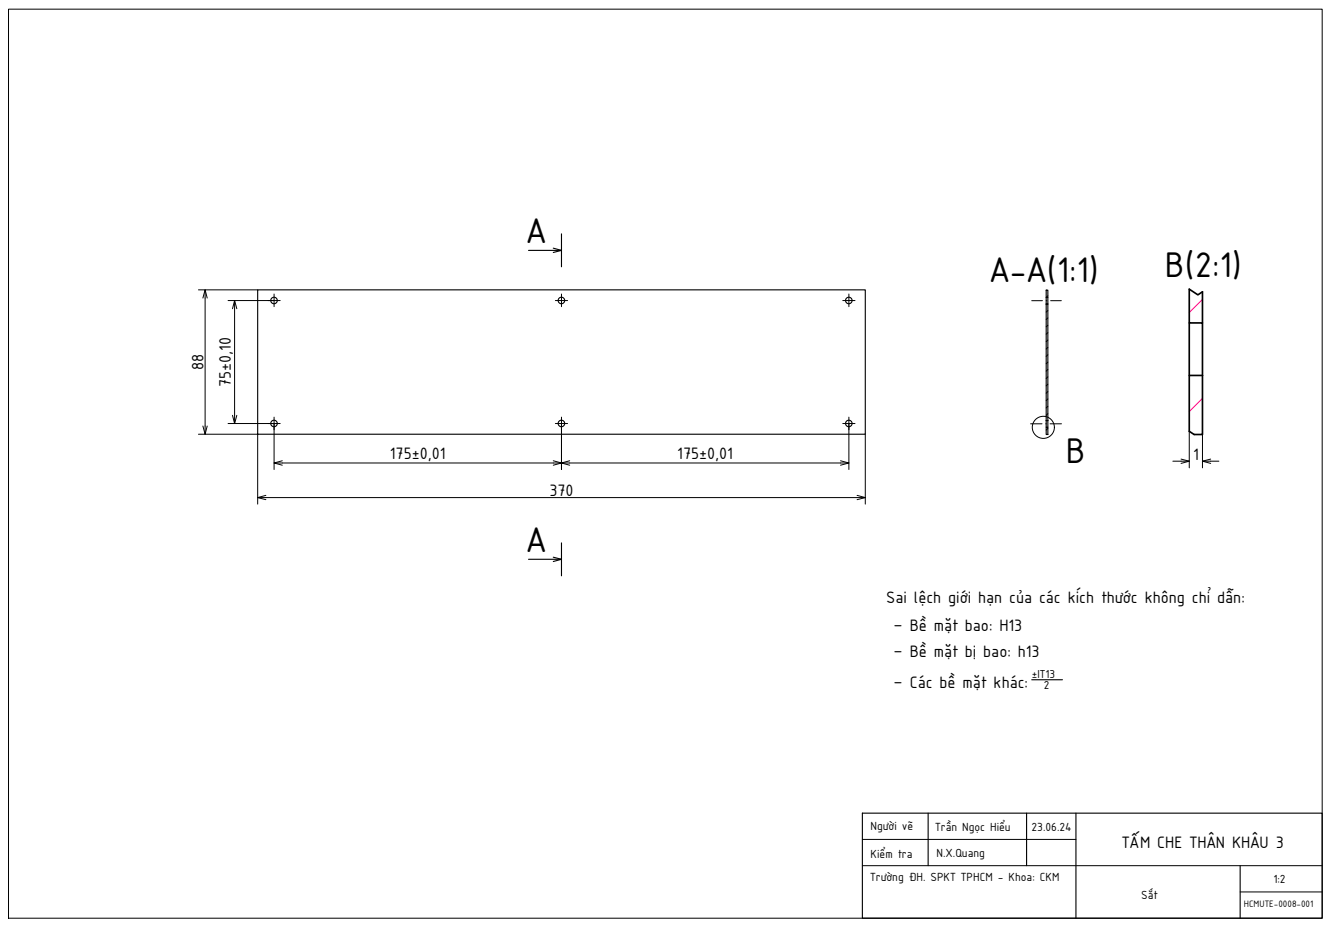
[picture p405: page 1]
Sắt; HCMUTE-0008-001 1:2 175±0,01

±0,10 370 AA A-A(1:1) B(2:1) B 1 2 ±IT13 – Các bề mặt khác: – Bề mặt bị bao: h13 – Bề mặt bao: H13 Sai lệch giới hạn của các kích thước không chỉ dẫn:

Trần Ngọc Hiểu | 23.06.24 N.X.Quang | TẤM CHE THÂN KHÂU 3 Kiểm tra Người vẽ

Trường ĐH. SPKT TPHCM - Khoa: CKM
