TNH510/5_DOF_Robot_Arm/tong_hop_ban_ve/ban_ve_canh_tay_robot/pdf/HCMUTE_0009.pdf

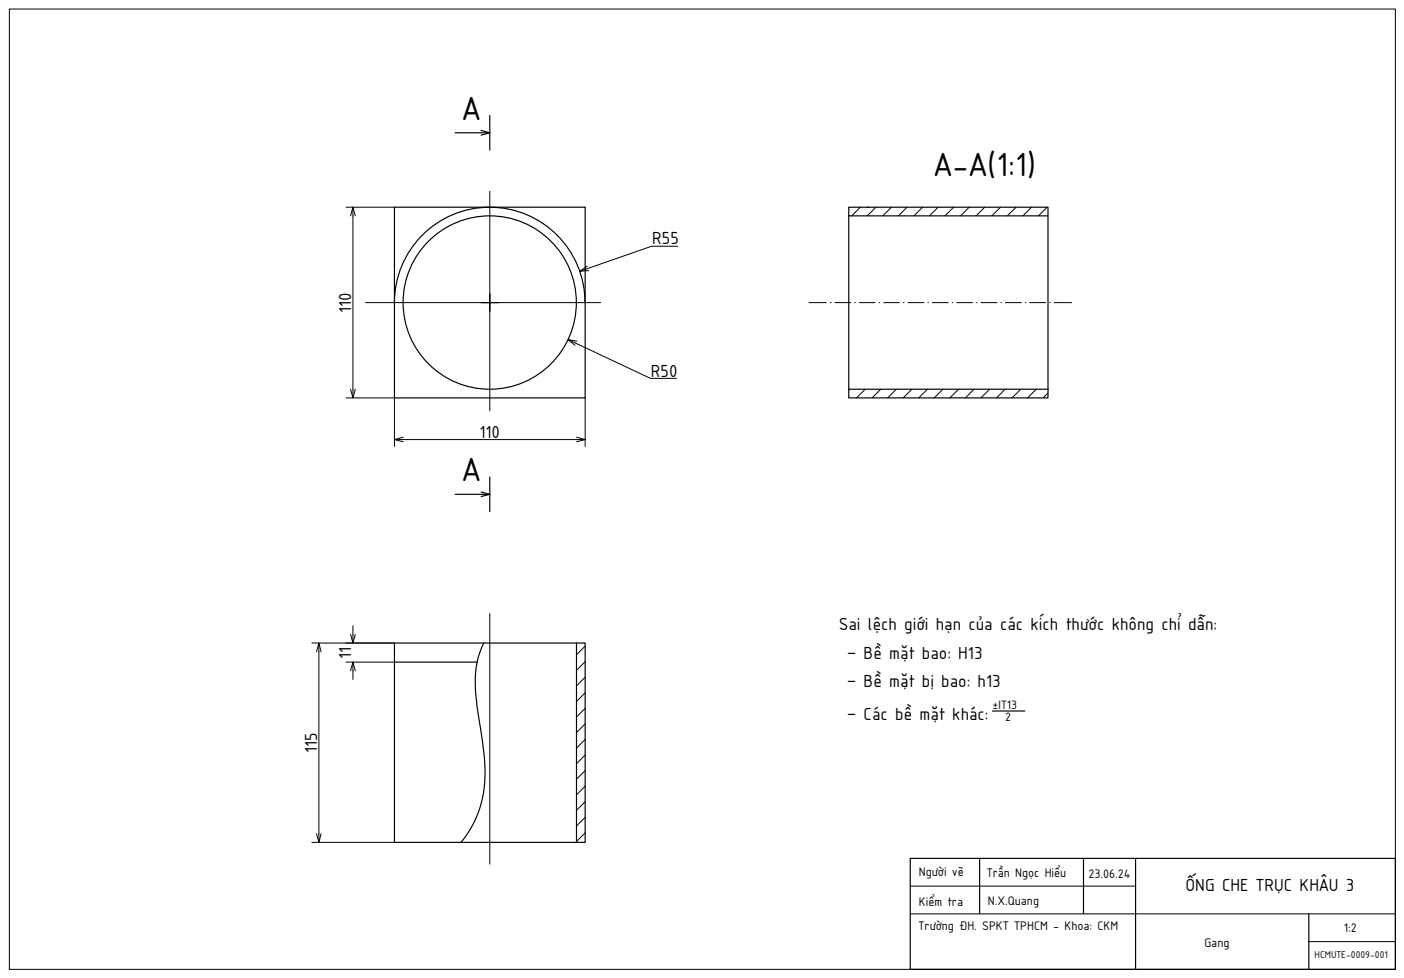
[picture p406: page 1]
Gang; HCMUTE-0009-001 1:2 R50 R55

115 AA A-A(1:1) 2 ±IT13 – Các bề mặt khác: – Bề mặt bị bao: h13 – Bề mặt bao: H13 Sai lệch giới hạn của các kích thước không chỉ dẫn:

Người vẽ | Trần Ngọc Hiểu | 23.06.24 N.X.Quang | ỐNG CHE TRỤC KHÂU 3

Kiểm tra

Trường ĐH. SPKT TPHCM - Khoa: CKM
