TNH510/5_DOF_Robot_Arm/tong_hop_ban_ve/ban_ve_canh_tay_robot/pdf/HCMUTE_0010.pdf

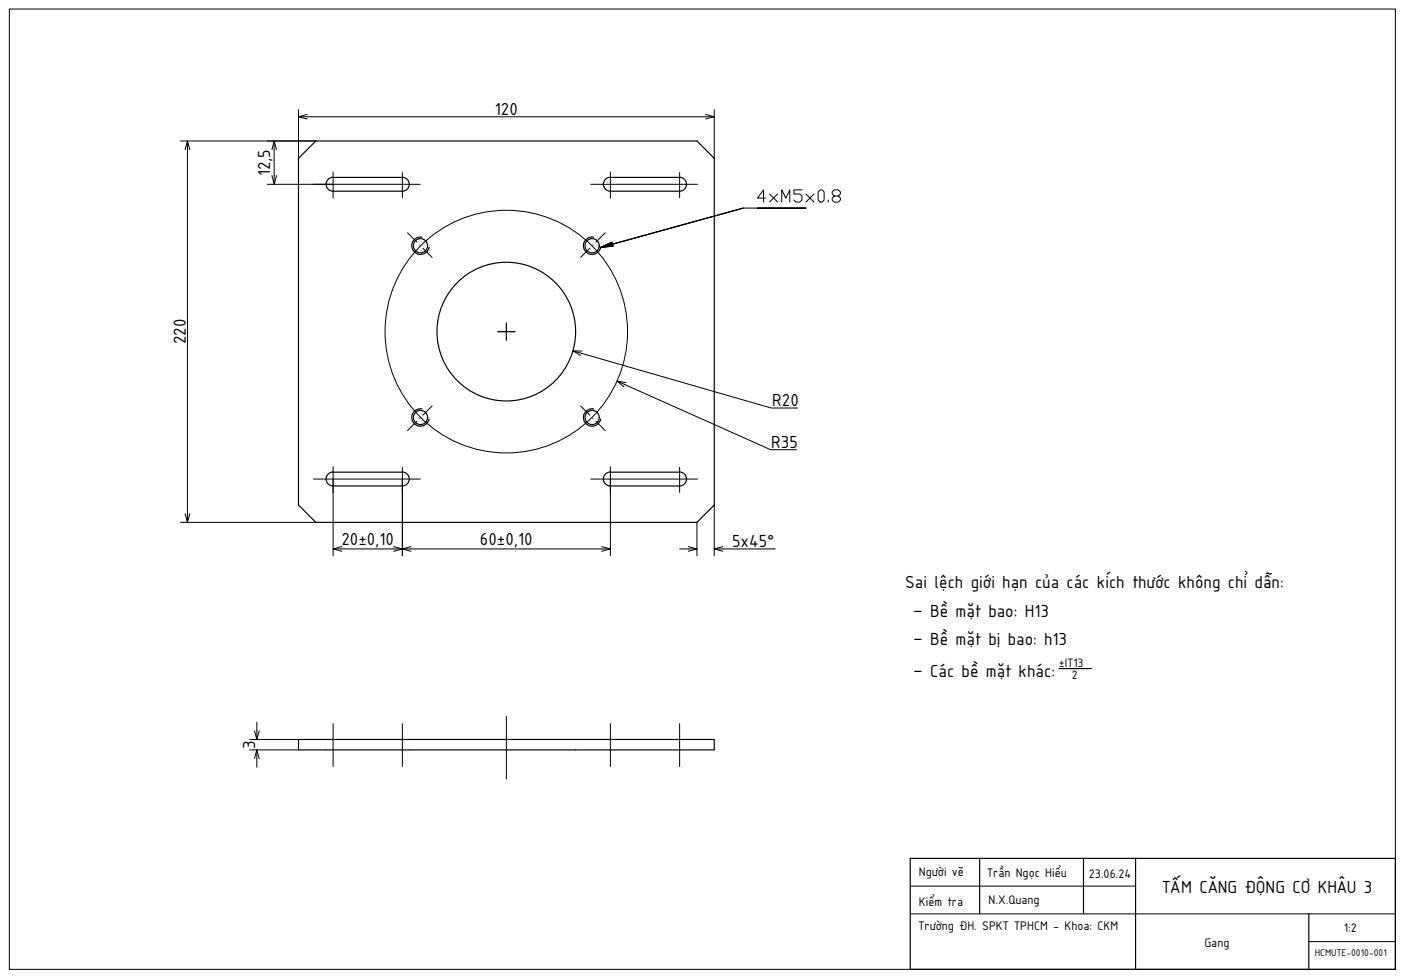
[picture p407: page 1]

12,5 3 120 20±0,10 60±0,10 5x45°R35 R20 2 ±IT13 – Các bề mặt khác: – Bề mặt bị bao: h13 – Bề mặt bao: H13 Sai lệch giới hạn của các kích thước không chỉ dẫn:

Trần Ngọc Hiểu | 23.06.24 N.X.Quang | TẤM CĂNG ĐỘNG CƠ KHÂU 3 Kiểm tra Người vẽ

Trường ĐH. SPKT TPHCM - Khoa: CKM | Gang | HCMUTE-0010-001 1:2
