TNH510/5_DOF_Robot_Arm/tong_hop_ban_ve/ban_ve_canh_tay_robot/pdf/HCMUTE_0011.pdf

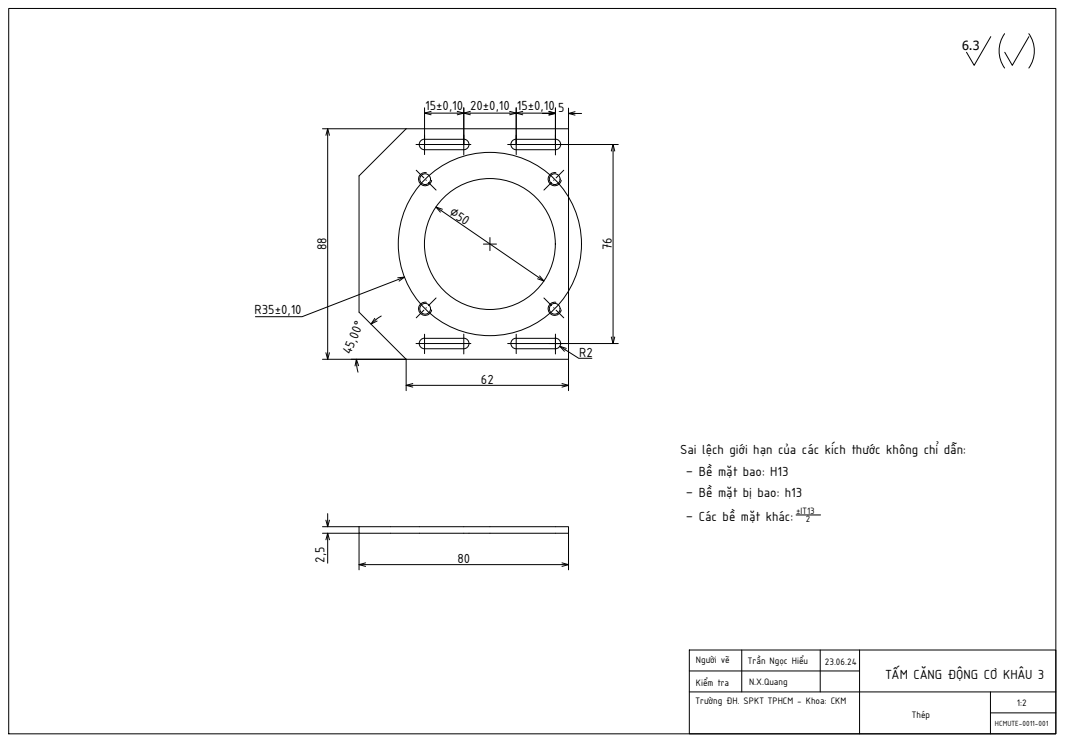
[picture p408: page 1]
Trần Ngọc Hiểu; 23.06.24 N.X.Quang

Sai lệch giới hạn của các kích thước không chỉ dẫn:

– Bề mặt bao: H13
– Bề mặt bị bao: h13

2,5 80 2 ±IT13 – Các bề mặt khác:

TẤM CĂNG ĐỘNG CƠ KHÂU 3 Kiểm tra Người vẽ

Trường ĐH. SPKT TPHCM - Khoa: CKM | Thép | HCMUTE-0011-001 1:2
