TNH510/5_DOF_Robot_Arm/tong_hop_ban_ve/ban_ve_canh_tay_robot/pdf/HCMUTE_0012.pdf

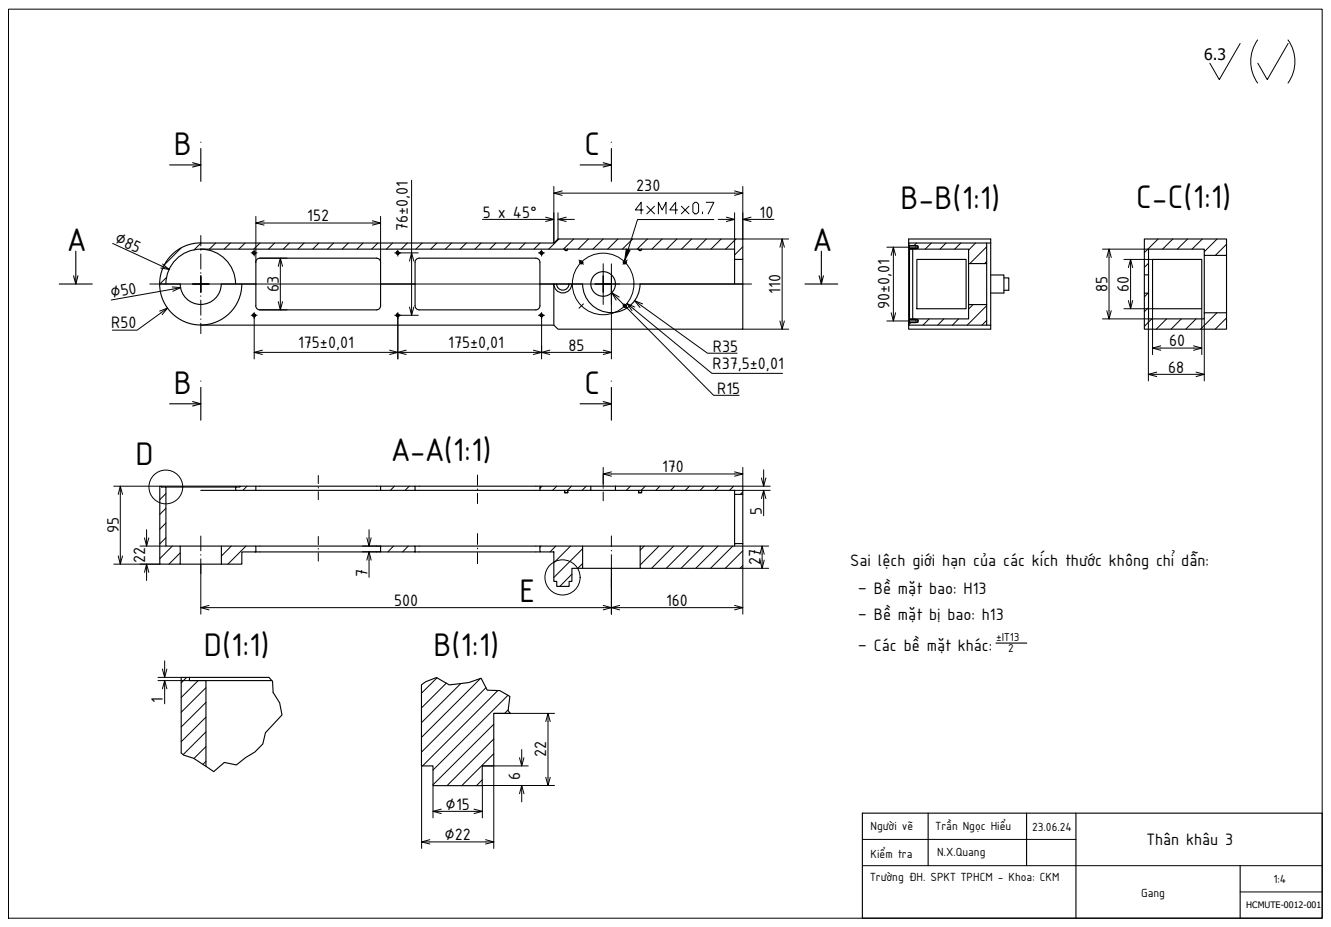
[picture p409: page 1]
Gang; HCMUTE-0012-001 1:4 ∅85∅50 R50

22 ∅15 ∅22 BB CC A A D E A-A(1:1) D(1:1) B(1:1) B-B(1:1) C-C(1:1) 2 ±IT13 – Các bề mặt khác: – Bề mặt bị bao: h13 – Bề mặt bao: H13 Sai lệch giới hạn của các kích thước không chỉ dẫn: Trần Ngọc Hiểu 23.06.24 N.X.Quang 6.3

Thân khâu 3 Kiểm tra Người vẽ

Trường ĐH. SPKT TPHCM - Khoa: CKM
