TNH510/5_DOF_Robot_Arm/tong_hop_ban_ve/ban_ve_canh_tay_robot/pdf/HCMUTE_0013.pdf

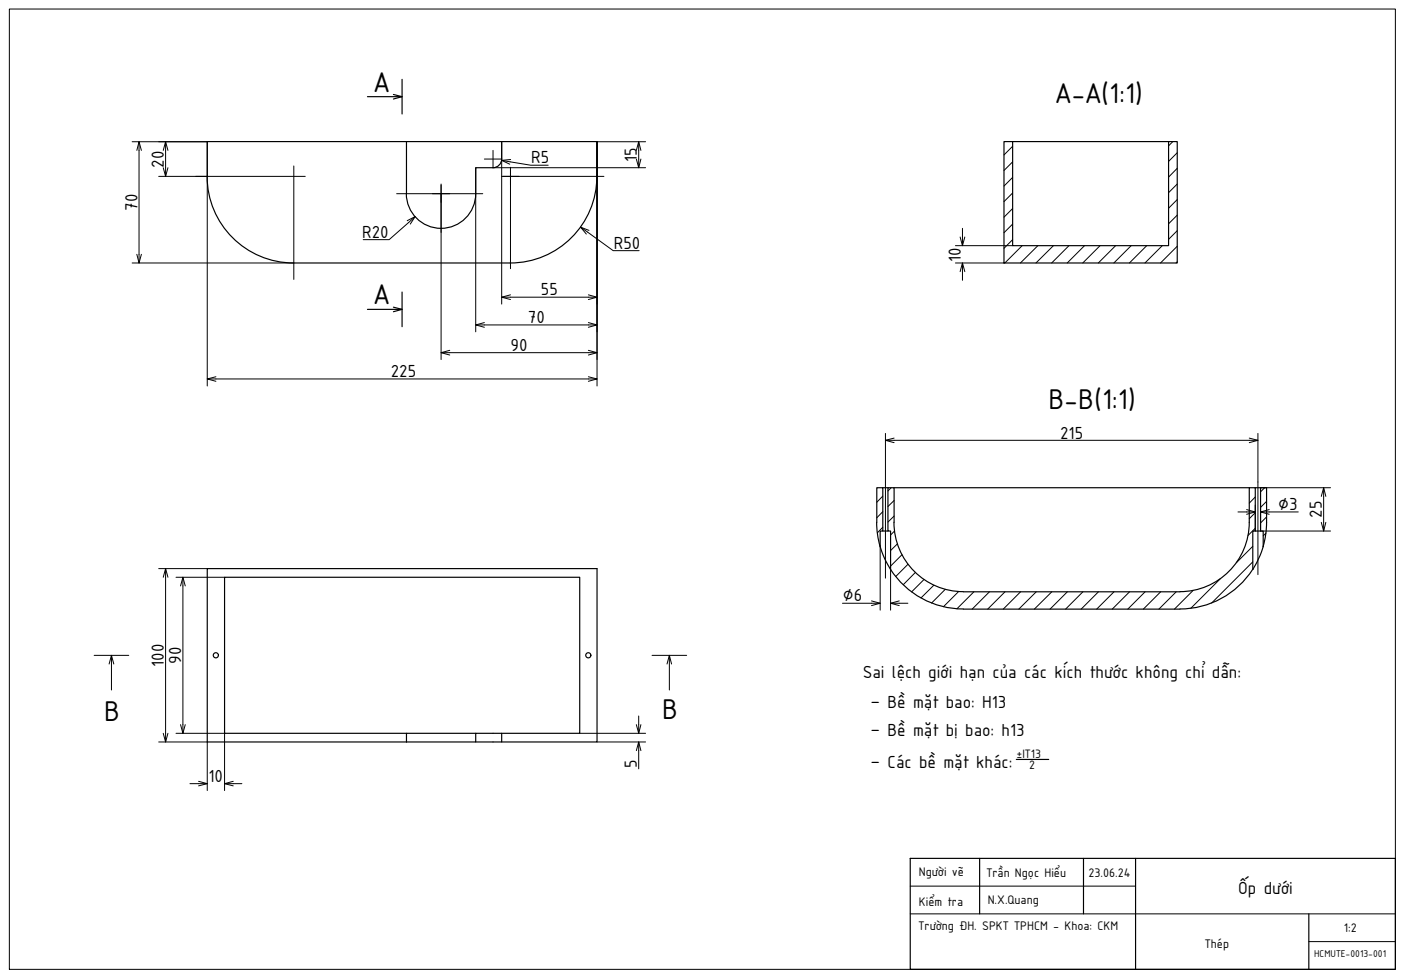
[picture p410: page 1]
Thép; HCMUTE-0013-001 1:2 225

25 AA B B B-B(1:1) A-A(1:1) 2 ±IT13 – Các bề mặt khác: – Bề mặt bị bao: h13 – Bề mặt bao: H13 Sai lệch giới hạn của các kích thước không chỉ dẫn:

Trần Ngọc Hiểu | 23.06.24 N.X.Quang | Ốp dưới Kiểm tra Người vẽ

Trường ĐH. SPKT TPHCM - Khoa: CKM
