TNH510/5_DOF_Robot_Arm/tong_hop_ban_ve/ban_ve_canh_tay_robot/pdf/HCMUTE_0014.pdf

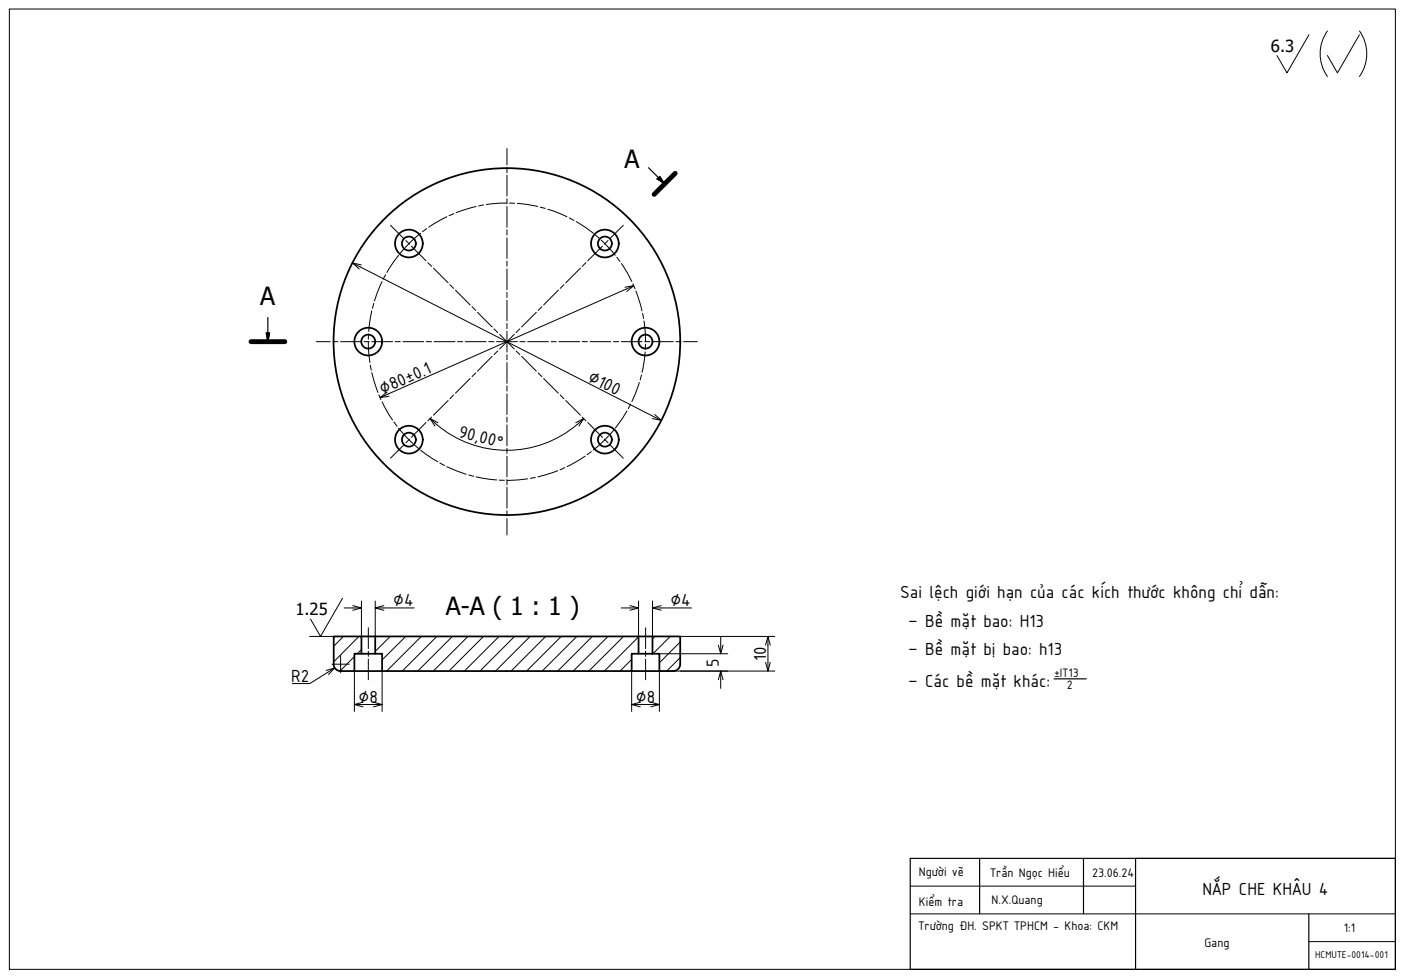
[picture p411: page 1]
Gang; HCMUTE-0014-001 1:1 1.25 R2

10 A-A ( 1 : 1 ) 2 ±IT13 – Các bề mặt khác: – Bề mặt bị bao: h13 – Bề mặt bao: H13 Sai lệch giới hạn của các kích thước không chỉ dẫn:

Trần Ngọc Hiểu | 23.06.24 N.X.Quang | NẮP CHE KHÂU 4 Kiểm tra Người vẽ

Trường ĐH. SPKT TPHCM - Khoa: CKM
