TNH510/5_DOF_Robot_Arm/tong_hop_ban_ve/ban_ve_canh_tay_robot/pdf/HCMUTE_0015.pdf

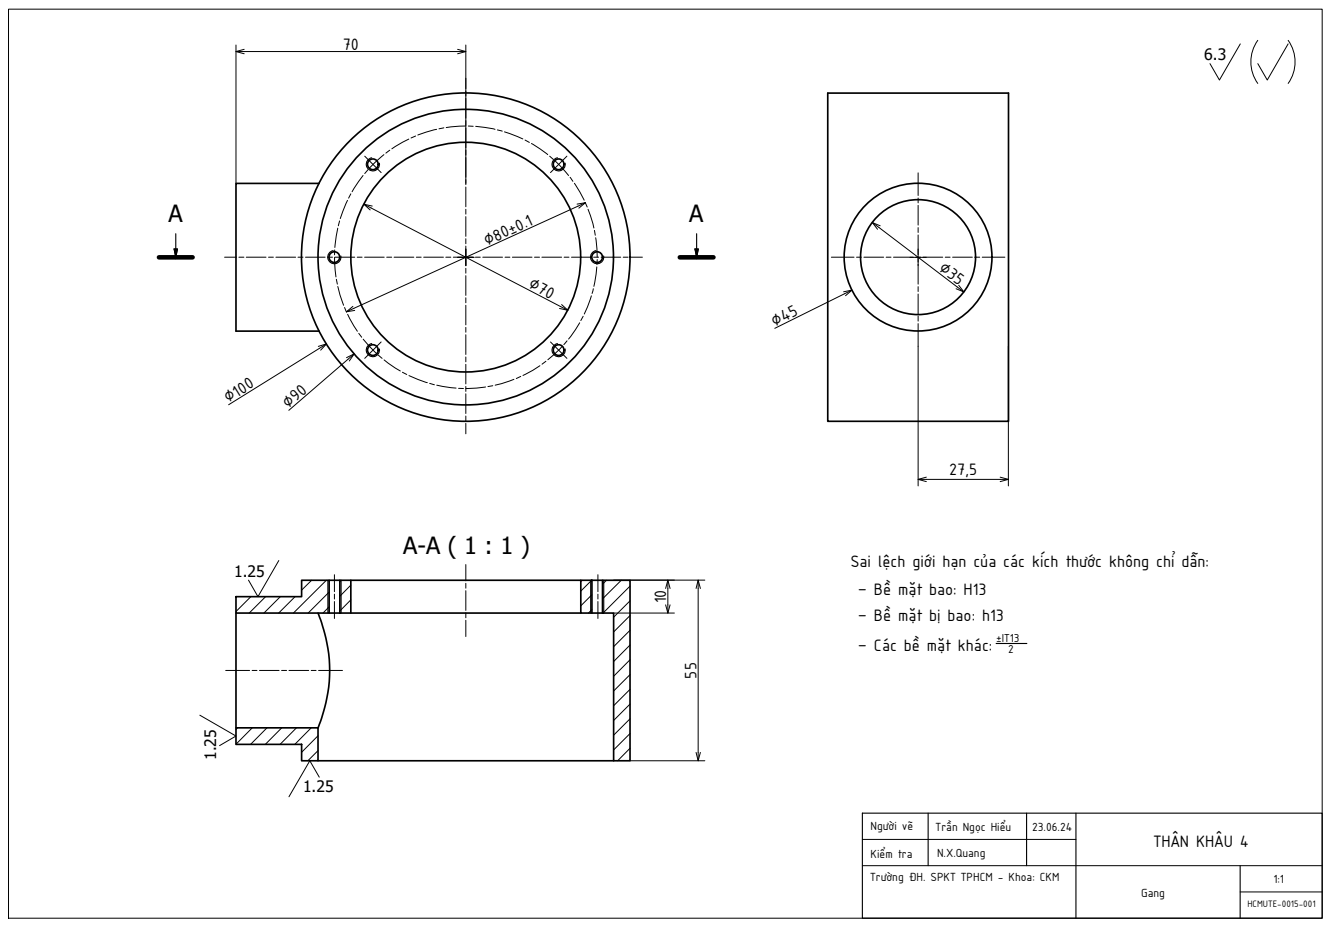
[picture p412: page 1]
Gang; HCMUTE-0015-001 1:1 70; Trần Ngọc Hiểu; 23.06.24 N.X.Quang

∅35 27,5 2 ±IT13 – Các bề mặt khác: – Bề mặt bị bao: h13 – Bề mặt bao: H13 Sai lệch giới hạn của các kích thước không chỉ dẫn:

Người vẽ | THÂN KHÂU 4

Kiểm tra

Trường ĐH. SPKT TPHCM - Khoa: CKM
