TNH510/5_DOF_Robot_Arm/tong_hop_ban_ve/ban_ve_canh_tay_robot/pdf/HCMUTE_0016.pdf

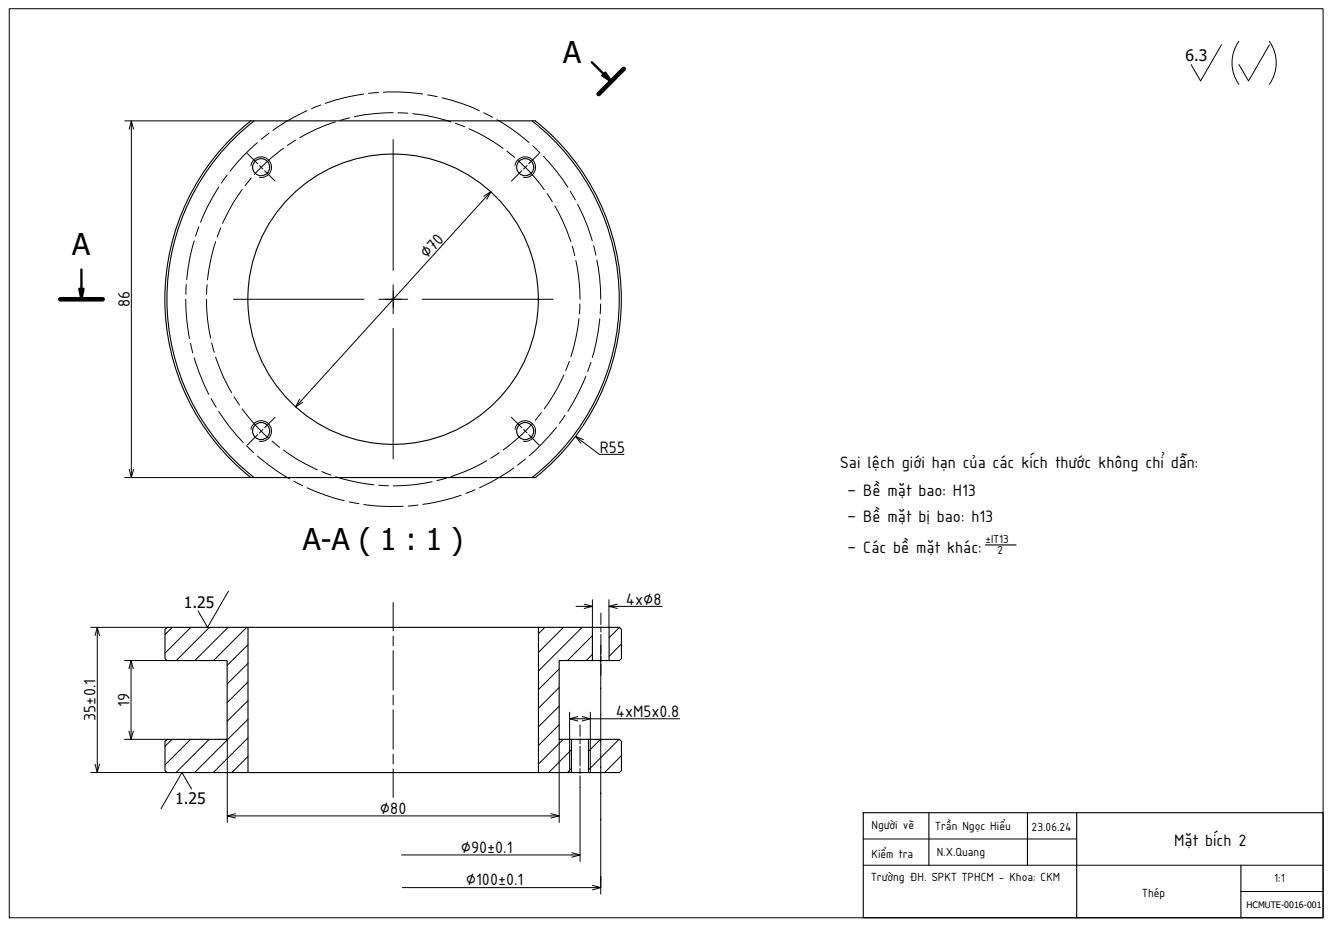
[picture p413: page 1]
Thép; HCMUTE-0016-001 1:1 6.3 ∅70

Sai lệch giới hạn của các kích thước không chỉ dẫn:

– Bề mặt bao: H13
– Bề mặt bị bao: h13

19 4xM5x0.8 ∅100±0.1 ∅80 4x∅8 ∅90±0.1 2 ±IT13 – Các bề mặt khác:

Trần Ngọc Hiểu | 23.06.24 N.X.Quang | Mặt bích 2 Kiểm tra Người vẽ

Trường ĐH. SPKT TPHCM - Khoa: CKM
