TNH510/5_DOF_Robot_Arm/tong_hop_ban_ve/ban_ve_canh_tay_robot/pdf/HCMUTE_unknow.pdf

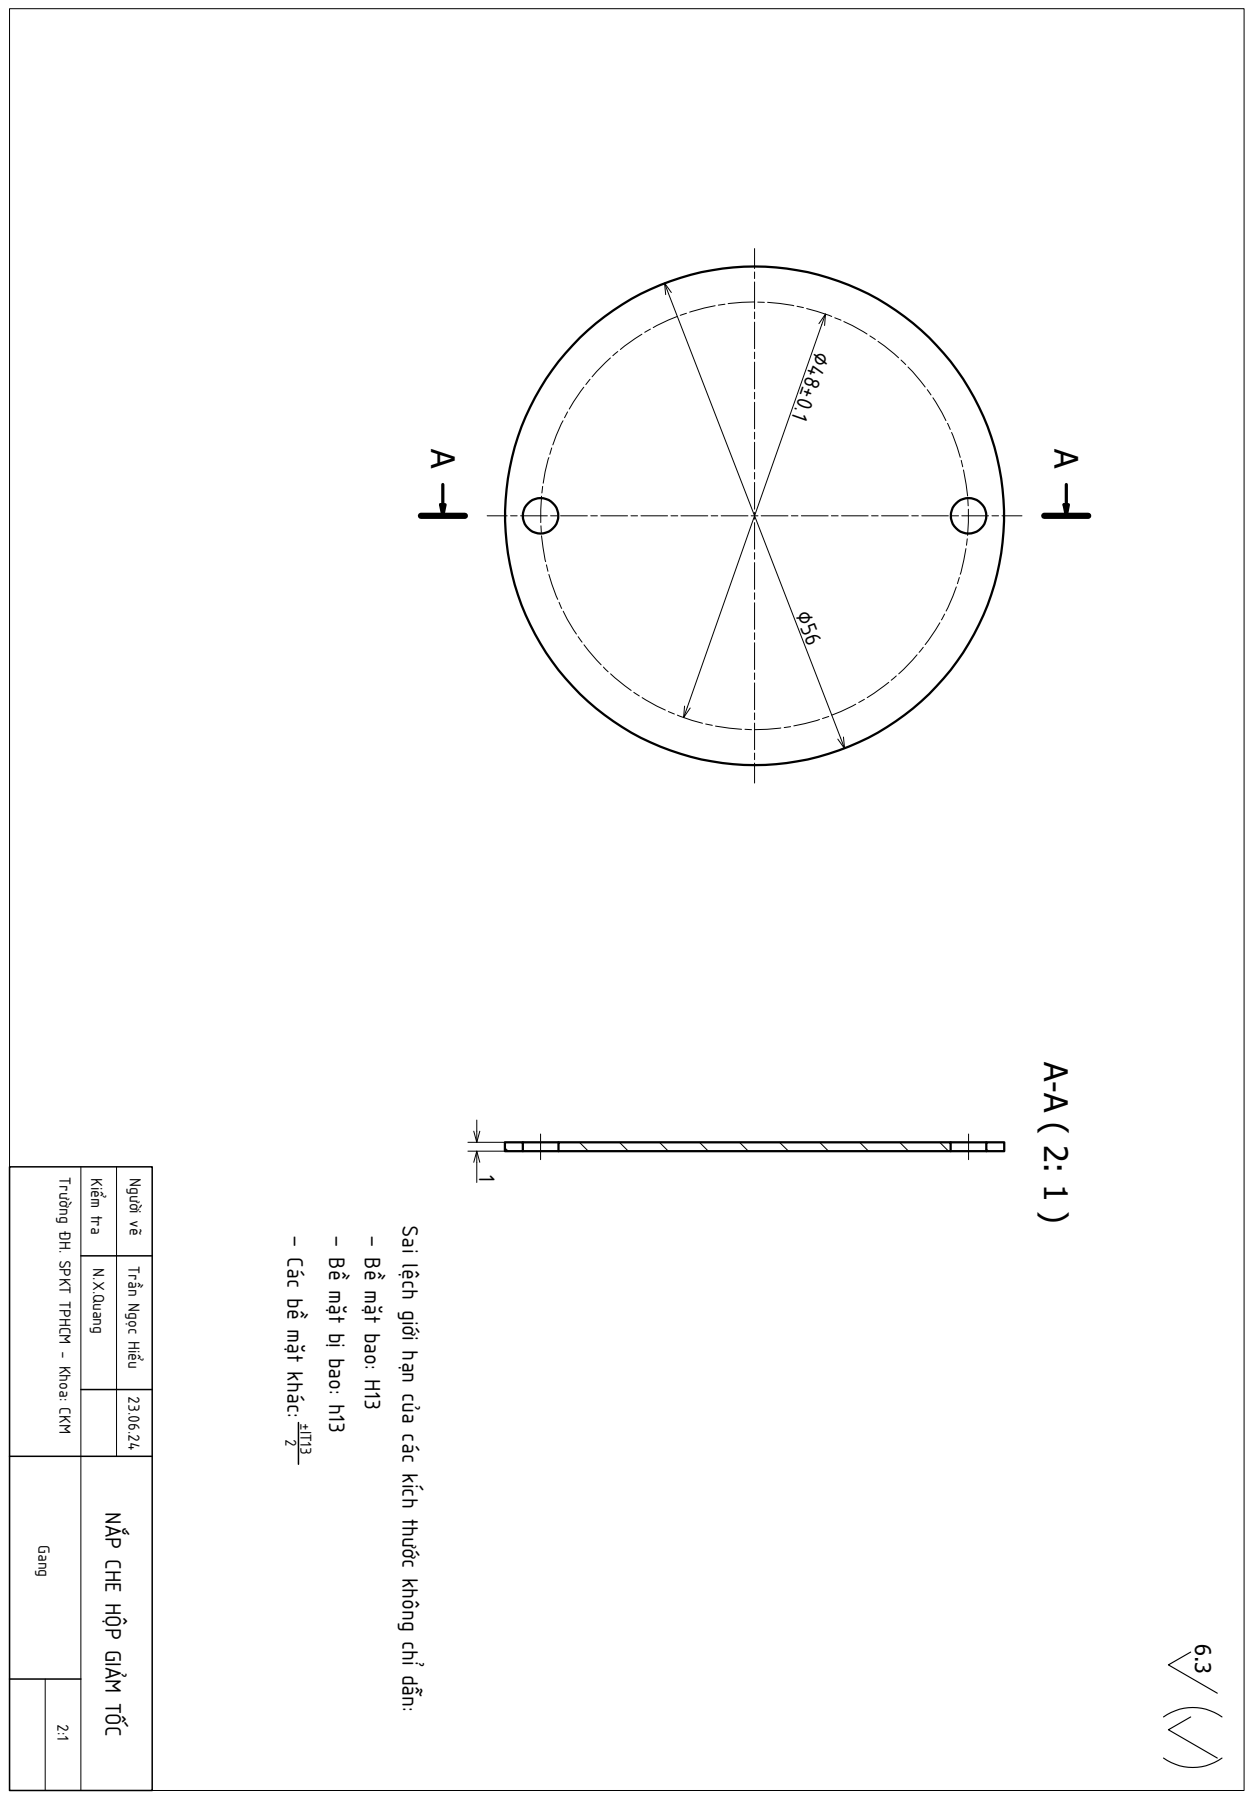
[picture p414: page 1]

NẮP CHE HỘP GIẢM TỐC Trường ĐH. SPKT TPHCM - Khoa: CKM Kiểm tra Người vẽ Gang 2:1 AA A-A ( 2: 1 ) 6.3 ∅56 ∅48±0.1 1 2 ±IT13 – Các bề mặt khác: – Bề mặt bị bao: h13 – Bề mặt bao: H13 Sai lệch giới hạn của các kích thước không chỉ dẫn: Trần Ngọc Hiểu 23.06.24 N.X.Quang
