TNH510/5_DOF_Robot_Arm/tong_hop_ban_ve/ban_ve_canh_tay_robot/pdf/HCMUTE_unknow_2.pdf

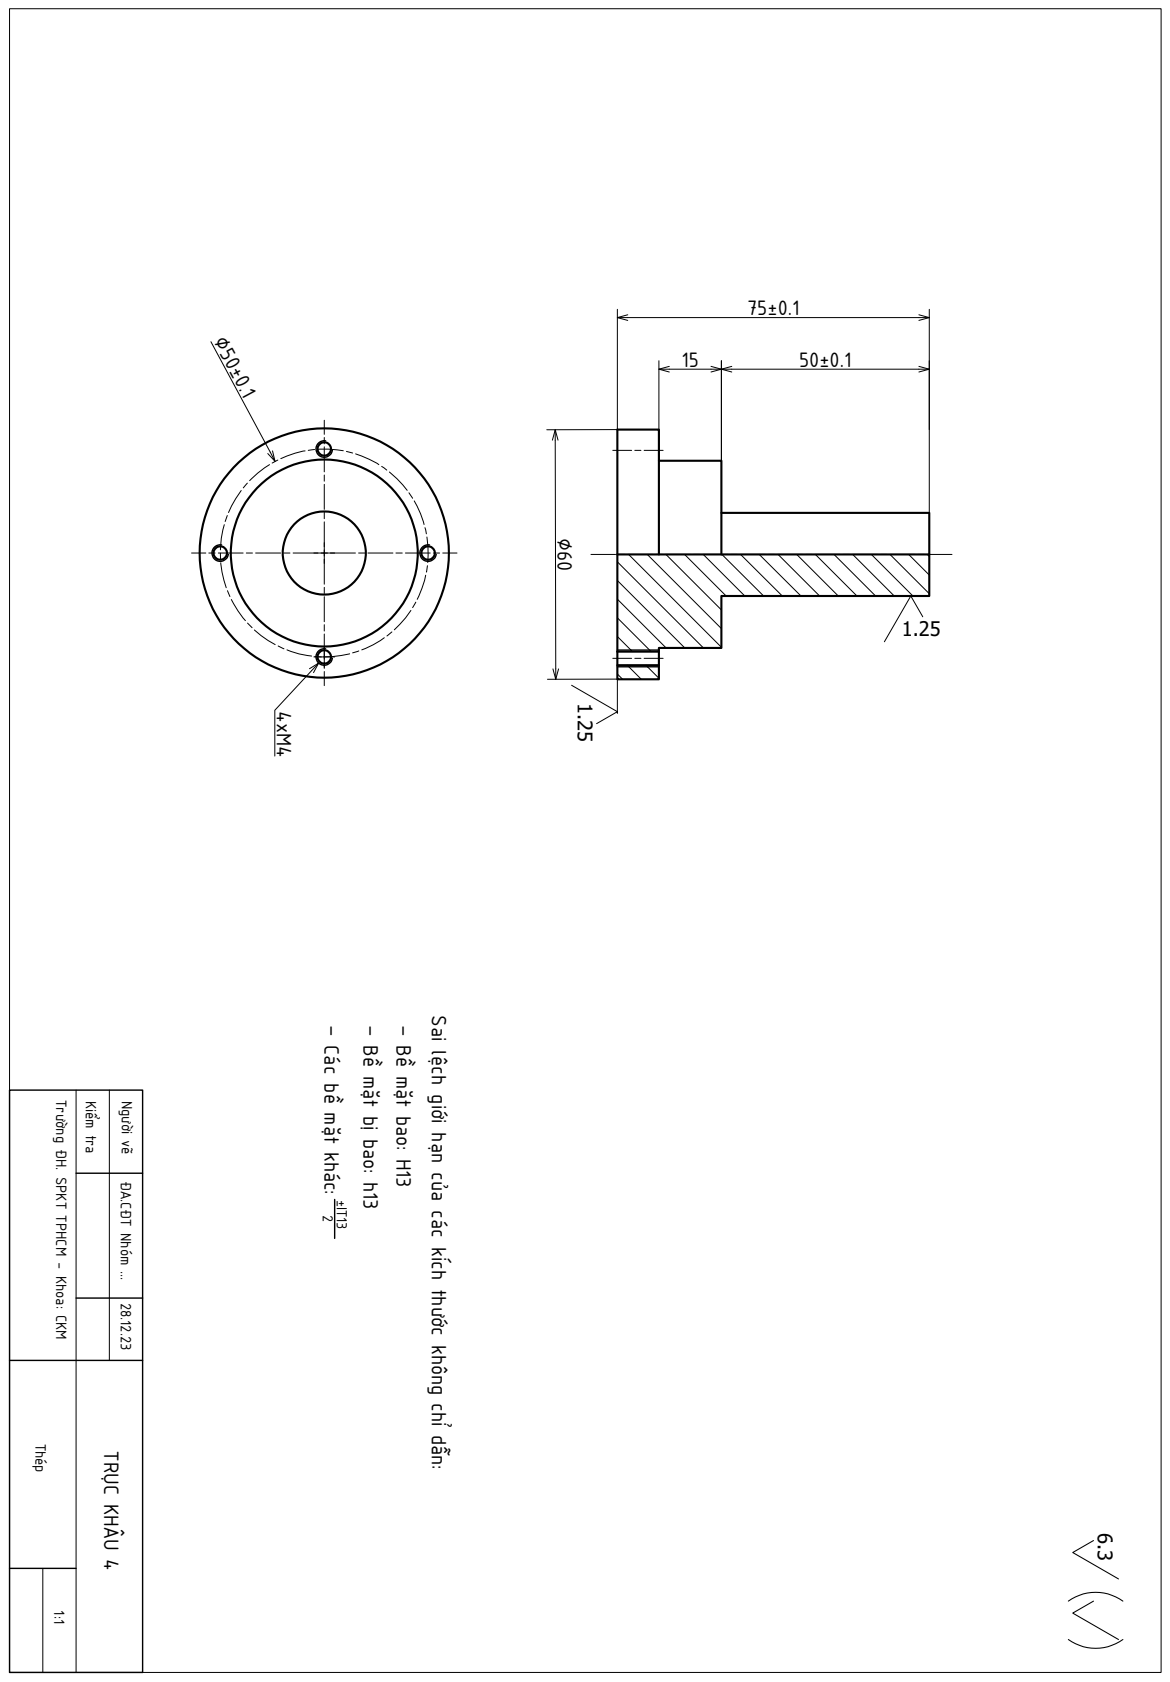
[picture p415: page 1]

2 ±IT13 – Các bề mặt khác: – Bề mặt bị bao: h13 – Bề mặt bao: H13 Sai lệch giới hạn của các kích thước không chỉ dẫn: TRỤC KHÂU 4 28.12.23 ĐA.CĐT Nhóm ... Trường ĐH. SPKT TPHCM - Khoa: CKM Kiểm tra Người vẽ Thép 1:1 ∅50±0.1 4xM4 ∅60
