TNH510/5_DOF_Robot_Arm/tong_hop_ban_ve/ban_ve_thiet_bi_theo_doi_chuyen_dong/pdf/BAN_VE_LAP_THIET_BI_THEO_DOI_CHUYEN_DONG.pdf

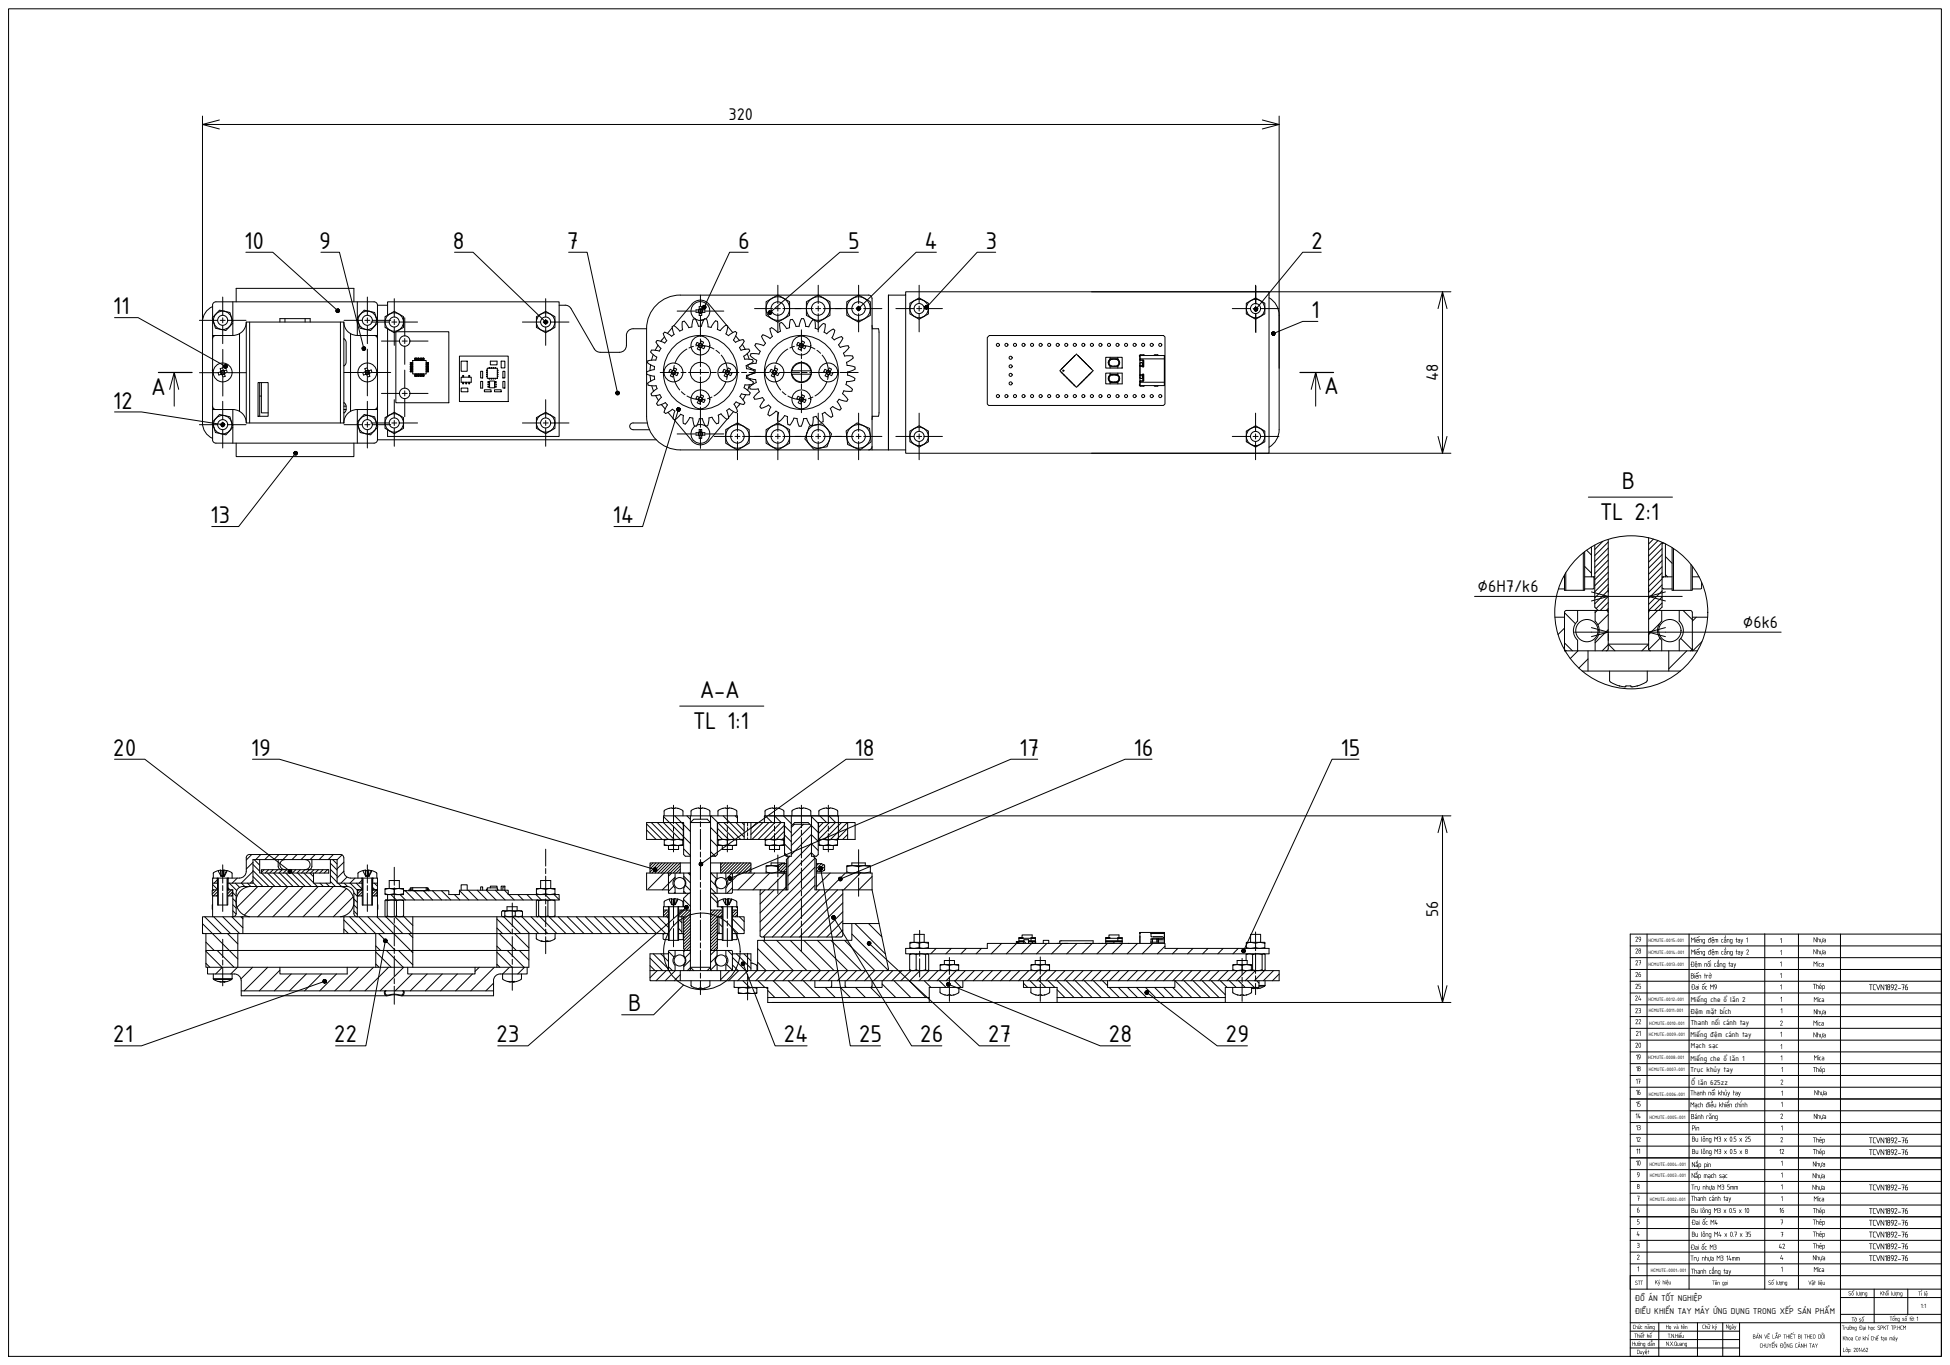
[picture p416: page 1]
Bu lông M4 x 0.7 x 35; Số lượng; Khối lượng; Tổng số tờ: 1; 1:1 Tên gọi; Vật liệu; Đai ốc M3; 7 Đai ốc M4

48 56 B B TL 2:1 ∅6H7/k6 ∅6k6 A A A-A TL 1:1 Chức năng

HCMUTE-0007-001 | Mạch điều khiển chính HCMUTE-0006-001 Đệm mặt bích Đai ốc M9 Miếng đệm cẳng tay 1 Miếng đệm cẳng tay 2 Mạch sạc Bu lông M3 x 0.5 x 10 Trụ nhựa M3 5mm Trụ nhựa M3 14mm Bu lông M3 x 0.5 x 25 | 12 1 HCMUTE-0012-001 1 Đệm nối cẳng tay 1 HCMUTE-0014-001 2 1 Biến trở 1 HCMUTE-0013-001 1 1 Miếng đệm cánh tay 11 HCMUTE-0010-001 HCMUTE-0008-001 1 | Nhựa HCMUTE-0003-001 Nhựa HCMUTE-0004-001 Nhựa Bu lông M3 x 0.5 x 8 Thép Thép Thép ThépMicaMica 23456789101112131415161817 Thép HCMUTE-0002-001 Thép HCMUTE-0005-001 Thép Nhựa 1122121111116741 Nhựa Thanh nối cánh tay HCMUTE-0009-001 Nhựa Nhựa Mica HCMUTE-0015-001 HCMUTE-0011-001 2923 Mica Miếng che ổ lăn 1 Miếng che ổ lăn 2 Nhựa Thép Nhựa | TCVN1892-76 Nhựa HCMUTE-0001-001 TCVN1892-76 TCVN1892-76 TCVN1892-76 TCVN1892-76 TCVN1892-76 TCVN1892-76 TCVN1892-76 202122192425262728 TCVN1892-76 MicaMica

Trục khủy tay
Ổ lăn 625zz
Thanh nối khủy tay
Bánh răng PinNắp mạch sạc

Nắp pin

Thanh cánh tay

Ký hiệu 1 T.N.Hiểu STT 42 ĐỒ ÁN TỐT NGHIỆP ĐIỀU KHIỂN TAY MÁY ỨNG DỤNG TRONG XẾP SẢN PHẨM | Trường Đại học SPKT TP.HCM Khoa Cơ khí Chế tạo máy Thanh cẳng tay N.X.Quang

Họ và tên | Chữ ký | Ngày | BẢN VẼ LẮP THIẾT BỊ THEO DÕI CHUYỂN ĐỘNG CÁNH TAY | Lớp: 201462

Thiết kế
Hướng dẫn
Duyệt
