TNH510/5_DOF_Robot_Arm/control_glove/pcb/control_glove_v0.1/control_glove_v0.1.kicad_pcb

## KiCad design control_glove/pcb/control_glove_v0.1/control_glove_v0.1.kicad_pcb (2024-06-29)

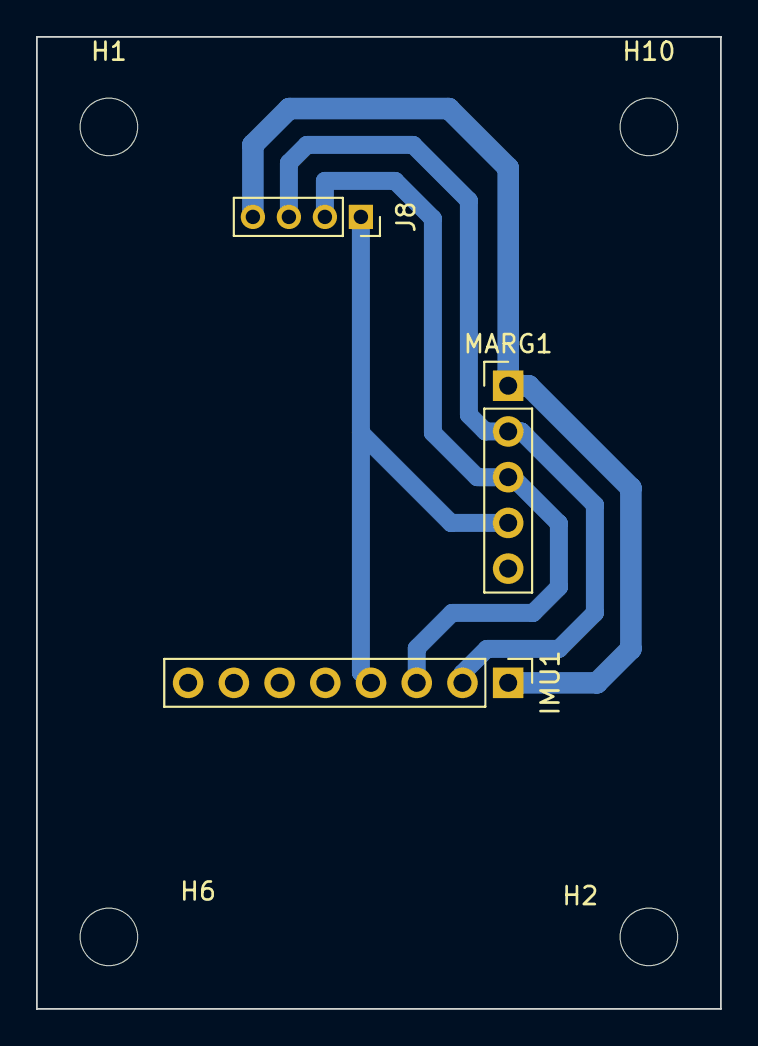
[picture p419: board control_glove_v0.1.kicad_pcb from above]

Board: 2 copper layers, 38.0 x 54.0 mm, 7 parts (0 on the bottom side), 4 nets.

Parts:
H1, H2, H6, H10: MountingHole; MountingHole_3.2mm_M3
IMU1: GY-521; PinHeader_1x08_P2.54mm_Vertical
J8: Conn_01x04_Female; PinSocket_1x04_P2.00mm_Vertical
MARG1: HMC5883L; PinHeader_1x05_P2.54mm_Vertical

Connections:
unnamed: IMU1.1 (VCC), J8.4, MARG1.1 (VCC)
unnamed: IMU1.2 (GND), J8.3, MARG1.2 (GND)
unnamed: IMU1.3 (SCL), J8.2, MARG1.3 (SCL)
unnamed: IMU1.4 (SDA), J8.1, MARG1.4 (SDA)
