TNH510/5_DOF_Robot_Arm/control_glove/control_glove/Core/Src/main.c

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
/* Includes ------------------------------------------------------------------*/
#include "main.h"
#include "system_manager.h"

ADC_HandleTypeDef hadc1;

I2C_HandleTypeDef hi2c1;
I2C_HandleTypeDef hi2c2;
DMA_HandleTypeDef hdma_i2c1_rx;
DMA_HandleTypeDef hdma_i2c2_rx;

TIM_HandleTypeDef htim11;

UART_HandleTypeDef huart1;

void SystemClock_Config(void);
static void MX_GPIO_Init(void);
static void MX_DMA_Init(void);
static void MX_I2C1_Init(void);
static void MX_I2C2_Init(void);
static void MX_USART1_UART_Init(void);
static void MX_TIM11_Init(void);
static void MX_ADC1_Init(void);
/* USER CODE BEGIN PFP */
#ifdef __GNUC__
  #define PUTCHAR_PROTOTYPE int __io_putchar(int ch)
#else
  #define PUTCHAR_PROTOTYPE int fputc(int ch, FILE *f)
#endif /* __GNUC__ */
PUTCHAR_PROTOTYPE  
{
    HAL_UART_Transmit(&huart1, (uint8_t *)&ch, 1, 100);
    return ch;
} 
/* USER CODE END PFP */

/**
  * @brief  The application entry point.
  * @retval int
  */
int main(void)
{
  /* MCU Configuration--------------------------------------------------------*/

  /* Reset of all peripherals, Initializes the Flash interface and the Systick. */
  HAL_Init();

  /* Configure the system clock */
  SystemClock_Config();

  /* Initialize all configured peripherals */
  MX_GPIO_Init();
  MX_DMA_Init();
  MX_I2C1_Init();
  MX_I2C2_Init();
  MX_USART1_UART_Init();
  MX_TIM11_Init();
  MX_ADC1_Init();
  /* USER CODE BEGIN 2 */
  system_manager_init();
  // bsp_mpu6050_calib();
  /* USER CODE END 2 */

  /* Infinite loop */
  /* USER CODE BEGIN WHILE */
  while (1)
  {
    /* USER CODE END WHILE */
	system_manager_task();
    /* USER CODE BEGIN 3 */
  }
  /* USER CODE END 3 */
}

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
