TNH510/5_DOF_Robot_Arm/control_glove/control_glove/Core/Inc/main.h

#define USER_LED_Pin GPIO_PIN_13
#define USER_LED_GPIO_Port GPIOC
#define RV1_Pin GPIO_PIN_0
#define RV1_GPIO_Port GPIOA
#define SET_UART_Pin GPIO_PIN_7
#define SET_UART_GPIO_Port GPIOA
#define LED_RED_Pin GPIO_PIN_1
#define LED_RED_GPIO_Port GPIOB
#define LED_GREEN_Pin GPIO_PIN_0
#define LED_GREEN_GPIO_Port GPIOB
