TNH510/5_DOF_Robot_Arm/control_glove/control_glove/Core/Inc/bsp/bsp_mpu6050.h

/**
 * @file       bsp_mpu6050.h
 * @copyright  Copyright (C) 2024 TNH510
 * @version    1.0.0
 * @date       2024-03
 * @author     Hieu Tran
 * @brief      BSP for MPU6050
 * @note       None
 */
/* Define to prevent recursive inclusion ------------------------------------ */
#ifndef __BSP_MPU6050_H
#define __BSP_MPU6050_H

#ifdef __cplusplus
extern "C" {
#endif

/* Includes ----------------------------------------------------------------- */
#include <stdint.h>
#include "bsp_common.h"

/* Public defines ----------------------------------------------------------- */
/* Public enumerate/structure ----------------------------------------------- */
/* Public macros ------------------------------------------------------------ */
/* Public variables --------------------------------------------------------- */
/* Public APIs -------------------------------------------------------------- */
base_status_t bsp_mpu6050_get_data(float *gxrs, float *gyrs, float *gzrs, float *axg, float *ayg, float *azg);
base_status_t bsp_mpu6050_init(void);
base_status_t bsp_mpu6050_calib(void);

/* -------------------------------------------------------------------------- */
#ifdef __cplusplus
} /* extern "C" { */
#endif

#endif /* __BSP_MPU6050_H */

/* End of file -------------------------------------------------------------- */
