TNH510/5_DOF_Robot_Arm/control_glove/reference/mag-cal-example-main/mag-cal-example-main/log-mag-readings.py

"""

READ MAGNETOMETER MEASUREMENTS AND OUTPUT TO TEXT FILE FOR CALIBRATION

This code is designed to create a text file of points to calibrate the 
magnetometer with Magneto.

Code By: Michael Wrona
Created: 14 Jan 2021

Resources
---------

Magnetometer/IMU I used:
    https://www.adafruit.com/product/3463

Magneto magnetometer calibration software download:
    https://sites.google.com/site/sailboatinstruments1/home


"""


import csv
import time
import serial
import numpy as np
import matplotlib.pyplot as plt


# GLOBAL VARIABLES
SER_PORT = 'COM20'  # Serial port
SER_BAUD = 115200  # Serial baud rate
SAMPLE_FREQ = 8  # Frequency to record magnetometer readings at [Hz]
T_SAMPLE = 40  # Total time to read mangetometer readings [sec]
OUTPUT_FILENAME = 'mag-readings-1.txt'  # Output data file name



class SerialPort:
    """Create and read data from a serial port.

    Attributes:
        read(**kwargs): Read and decode data string from serial port.
    """
    def __init__(self, port, baud=115200):
        """Create and read serial data.

        Args:
            port (str): Serial port name. Example: 'COM4'
            baud (int): Serial baud rate, default 9600.
        """
        if isinstance(port, str) == False:
            raise TypeError('port must be a string.')

        if isinstance(baud, int) == False:
            raise TypeError('Baud rate must be an integer.')

        self.port = port
        self.baud = baud

        # Initialize serial connection
        self.ser = serial.Serial(self.port, self.baud, timeout=1)
        self.ser.flushInput()
        self.ser.flushOutput()
    

    def Read(self, clean_end=True):
        """
        Read and decode data string from serial port.

        Args:
            clean_end (bool): Strip '\\r' and '\\n' characters from string. Common if used Serial.println() Arduino function. Default true
        
        Returns:
            (str): utf-8 decoded message.
        """
        # while self.ser.in_waiting:
        bytesToRead = self.ser.readline()
        
        decodedMsg = bytesToRead.decode('utf-8')

        if clean_end == True:
            decodedMsg = decodedMsg.strip('\r').strip('\n')  # Strip extra chars at the end
        
        return decodedMsg
    

    def Write(self, msg):
        """
        Write string to serial port.

        Args
        ----
            msg (str): Message to transmit
        
        Returns
        -------
            (bool) True if successful, false if not
        """
        try:
            self.ser.write(msg.encode())
            return True
        except:
            print("Error sending message.")
    

    def Close(self):
        """Close serial connection."""
        self.ser.close()



class PlotPoints3D:
    """Plot magnetometer readings as 3D scatter plot.
    
    Attributes:
        AddPoint(x, y, z): Add 3D point to plot.

    """

    def __init__(self, fig, ax, live_plot=True, marker='o', c='r'):
        """Plot points as 3D scatter plot.

        Args:
            fig (matplotlib.pyplot.figure): MPL figure object.
            ax (matplotlib.pyplot.figure.add_suplot): MPL 3D axes object
            live_plot (bool): Choose wheter or not to plot the data live
            marker (str): MPL marker symbol. See reference [1].
            c (str): MPL color letter. See reference [2].
        
        Resources:
            [1] Matplotlib plot marker symbols,
                https://matplotlib.org/3.2.1/api/markers_api.html#module-matplotlib.markers
            [2] Matplotlib plot/line color letters,
                https://matplotlib.org/2.0.2/api/colors_api.html
        """
        self.fig = fig  # fig and axes
        self.ax = ax
        self.live_plot = live_plot
        self.ptMarker = marker  # Point symbol
        self.ptColor = c  # Point color
        self.edgeColor = 'k'  # Border/edge of point
        self.ax.set_xlim((-1000, 1000))  # Set axes limits to keep plot shape
        self.ax.set_ylim((-1000, 1000))
        self.ax.set_zlim((-1000, 1000))
    

    def AddPoint(self, x, y, z):
        """Add 3D point to scatter plot.

        Args:
            x (float): X-coordinate.
            y (float): Y-coordinate.
            z (float): Z-coordinate.
        """
        self.ax.scatter(x, y, z, marker=self.ptMarker, 
            c=self.ptColor, edgecolors=self.edgeColor)
        
        if self.live_plot == True:
            plt.pause(0.001)


Arduino = SerialPort(SER_PORT, SER_BAUD)
N = int(SAMPLE_FREQ * T_SAMPLE)  # Number of readings
DT = 1.0 / SAMPLE_FREQ  # Sample period [sec]


# Create live plot for logging points
fig_rawReadings = plt.figure()
ax_rawReadings = fig_rawReadings.add_subplot(111, projection='3d')
RawDataPlot = PlotPoints3D(fig_rawReadings, ax_rawReadings, live_plot=False)


# Take a few readings to 'flush' out bad ones
for _ in range(4):
    data = Arduino.Read().split(',')  # Split into separate values
    time.sleep(0.25)


measurements = np.zeros((N, 3), dtype='float')

for currMeas in range(N):
    data = Arduino.Read().split(',')  # Split into separate values

    mx, my, mz = float(data[0]), float(data[1]), float(data[2])  # Convert to floats, [uT]
    
    print('[%0.4f, %0.4f, %0.4f] uT  |  Norm: %0.4f uT  |  %0.1f %% Complete.' % 
        (mx, my, mz, np.sqrt(mx**2 + my**2 + mz**2), (currMeas / N) * 100.0)
    )

    # Store data to array
    measurements[currMeas, 0] = mx
    measurements[currMeas, 1] = my
    measurements[currMeas, 2] = mz
    
    RawDataPlot.AddPoint(mx, my, mz)  # Add point to 3D plot



# After measurements are complete, write data to file
Arduino.Close()
print('Sensor Reading Complete!')

print('Writing data to {} ...'.format(OUTPUT_FILENAME))
for i in range(N):
    with open(OUTPUT_FILENAME, 'a', newline='') as f:
        writer = csv.writer(f, delimiter='\t')
        writer.writerow([measurements[i, 0], measurements[i, 1], measurements[i, 2]])

plt.show()
