TNH510/5_DOF_Robot_Arm/control_glove/reference/mag-cal-example-main/mag-cal-example-main/plot-calibration-data.py

"""

PLOT UNCALIBRTED AND CALIBRATED MAGNETOMETER MEASUREMENTS

Read data file with raw measurements and compare calibrated vs. uncalibrated
measurements.

Code By: Michael Wrona
Created: 14 Jan 2021

The calibration equation is:
    h_calib = A * (h_meas - b)

h_calib: Calibrated measurements (3x1)
A: Soft iron, scale factor, and misalignment correction matrix (3x3, symmetric)
h_meas: Raw measurements (3x1)
b: Hard-iron offset correction vector (3x1)

Calibration parametrers were determined by the Magneto calibration software (see below).

Resources
---------

Magnetometer/IMU I used:
    https://www.adafruit.com/product/3463

Magneto magnetometer calibration software download:
    https://sites.google.com/site/sailboatinstruments1/home

"""


import numpy as np
import matplotlib.pyplot as plt


# Define calibration parameters
A = np.array(   [[0.779461, 0.008545, -0.002906],
                [0.008545, 0.819412, -0.018728],
                [-0.002906, -0.018728, 0.963059]])
b = np.array([129.605404, -251.437191, -24.113506])


# Read raw data and apply calibration
rawData = np.genfromtxt('mag-readings-1.txt', delimiter='\t')  # Read raw measurements

N = len(rawData)
calibData = np.zeros((N, 3), dtype='float')
for i in range(N):
    currMeas = np.array([rawData[i, 0], rawData[i, 1], rawData[i, 2]])
    calibData[i, :] = A @ (currMeas - b)


# Plot XY data
plt.figure()
plt.plot(rawData[:, 0], rawData[:, 1], 'b*', label='Raw Meas.')
plt.plot(calibData[:, 0], calibData[:, 1], 'r*', label='Calibrated Meas.')
plt.title('XY Magnetometer Data')
plt.xlabel('X [mG]')
plt.ylabel('Y [mG]')
plt.legend()
plt.grid()
plt.axis('equal')

# Plot YZ data
plt.figure()
plt.plot(rawData[:, 1], rawData[:, 2], 'b*', label='Raw Meas.')
plt.plot(calibData[:, 1], calibData[:, 2], 'r*', label='Calibrated Meas.')
plt.title('YZ Magnetometer Data')
plt.xlabel('Y [mG]')
plt.ylabel('Z [mG]')
plt.legend()
plt.grid()
plt.axis('equal')

# Plot XZ data
plt.figure()
plt.plot(rawData[:, 0], rawData[:, 2], 'b*', label='Raw Meas.')
plt.plot(calibData[:, 0], calibData[:, 2], 'r*', label='Calibrated Meas.')
plt.title('XZ Magnetometer Data')
plt.xlabel('X [mG]')
plt.ylabel('Z [mG]')
plt.legend()
plt.grid()
plt.axis('equal')


# Plot 3D scatter
fig = plt.figure()
ax = fig.add_subplot(111, projection='3d')

for i in range(N):
    xraw = rawData[i, 0]
    yraw = rawData[i, 1]
    zraw = rawData[i, 2]

    xcalib = calibData[i, 0]
    ycalib = calibData[i, 1]
    zcalib = calibData[i, 2]
    ax.scatter(xraw, yraw, zraw, color='r')
    ax.scatter(xcalib, ycalib, zcalib, color='b')

ax.set_title('3D Scatter Plot of Magnetometer Data')
ax.set_xlabel('X [mG]')
ax.set_ylabel('Y [mG]')
ax.set_zlabel('Z [mG]')


plt.show()
