TNH510/5_DOF_Robot_Arm/(commit log)

2023-09-30 update: Add khop_1 3d file
    [Khop_1.SLDPRT]
2023-09-30 update: Add 2 new files
    [HG_KG73B.stp, Khop_2.SLDPRT]
2023-09-30 update: Merged 2 file to folder 3d
    [HG_KG73B.stp, Khop_2.SLDPRT]
2023-09-30 update: Add assembly file
    [HG_KG73B.stp, Khop_2.SLDPRT, robot_assembly.SLDASM]
2023-09-30 update: Add a component
    [Khop3.SLDPRT]
2023-09-30 update: Clean
    [HG_KG73B.stp, Khop_2.SLDPRT]
2023-09-30 update: Add a new component
    [Khop_6.SLDPRT, robot_assembly.SLDASM]
2023-09-30 update: Add khop_4 3d file
    [Khop_4.SLDPRT]
2023-09-30 update: Add part_6
    [Khop_6.SLDPRT]
2023-09-30 update: Add khop_5
    [Khop_3.SLDPRT, Khop_5.SLDPRT, robot_assembly.SLDASM]
2023-09-30 update: Add Khop_1_2_Shield
    [Khop_1_2_Shield.SLDPRT]
2023-09-30 fix: Component 3
    [Khop3.SLDPRT]
2023-09-30 update: Complete assembly files
    [Khop_4.SLDPRT, robot_assembly.SLDASM]
2023-10-01 refactor: Arrange folder
    [robot_assembly.SLDASM]
2023-10-01 update: Change robot color
    [Khop3.SLDPRT, Khop_1.SLDPRT, Khop_1_2_Shield.SLDPRT, Khop_2.SLDPRT, Khop_4.SLDPRT, Khop_5.SLDPRT, Khop_6.SLDPRT, robot_assembly.SLDASM]
2023-10-01 update: Simulink MATLAB files
    [HG_KG73B.stp_Default_sldprt.STEP, Khop3.SLDPRT, Khop3_Default_sldprt.STEP, Khop_1_2_Shield_Default_sldprt.STEP, Khop_1_Default_sldprt.STEP, Khop_2_Default_sldprt.STEP, Khop_4.SLDPRT, Khop_4_Default_sldprt.STEP]
2023-10-01 update: Delete unused files
    [robot_assembly.SLDASM]
2023-10-01 update: Caculate robot kinematics
2023-10-07 update: Reduce kinematic
    [optional footer]
2023-10-07 update: File caculate Inverse Kinematic
2023-10-08 update: New kinematic equation
2023-10-08 fix: Conflict between 2 branch
    [optional body]
    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
    [Khop3.SLDPRT, Khop_2.SLDPRT, Khop_6.SLDPRT, robot_assembly.SLDASM]
2023-10-08 update: compare by youself :)
    [robot_assembly.SLDASM]
2023-10-08 update: Complete matlab simulink
    [Khop3.SLDPRT, Khop_1.SLDPRT, Khop_1_2_Shield.SLDPRT, Khop_2.SLDPRT, Khop_4.SLDPRT, Khop_5.SLDPRT, Khop_6.SLDPRT, robot_assembly - HG_KG73B.stp-1.STL]
2023-10-08 update: Clean code
    [robot_assembly.SLDASM]
2023-10-15 update: Code guide for check kinematic and inverse kinematic
2023-10-15 update: Detail robot components
    [Khop3.SLDPRT, Khop_1.SLDPRT, Khop_2.SLDPRT, Khop_4.SLDPRT, Khop_5.SLDPRT, Khop_6.SLDPRT, robot_assembly.SLDASM]
2023-10-19 update: Caculate moment using Solidworks
    [Khop3.SLDPRT, Khop_1.SLDPRT, Khop_2.SLDPRT, Khop_4.SLDPRT, Khop_5.SLDPRT, Khop_6.SLDPRT, robot_assembly.SLDASM]
2023-11-02 update: Format khop_1, khop_2, khop_3
    [Khop3.SLDPRT, Khop_1.SLDPRT, Khop_2.SLDPRT, Khop_4.SLDPRT, Khop_5.SLDPRT, Khop_6.SLDPRT, robot_assembly.SLDASM]
2023-11-04 update: Optimize brake and turn on servo
2023-11-04 update: Complete Servo button, Gohome, Sethome, Connect, Disconnect
2023-11-04 update: Add execute button
2023-11-04 update: complete 3D file and GUI on matlab
    [Assem1 - Khop3-1.STL, Assem1 - Khop_1-1.STL, Assem1 - Khop_2-1.STL, Assem1 - Khop_4-1.STL, Assem1 - Khop_5-1.STL, Assem1 - Khop_6-1.STL, Assem1.SLDASM, Khop3.SLDPRT]
2023-11-04 update: Complete inverse kinematic
2023-11-05 update: Review foward kinematic caculation
2023-11-05 update: Complete timer to update value every 250ms
2023-11-05 update: Complete set the joint limitation
2023-11-05 update: Merge execute function to run button
2023-11-05 update: GUI and simulation
    [Assem1 - Khop_1-1.STL, Assem1 - Khop_2-1.STL, Assem1 - Khop_6-1.STL, Assem1.SLDASM, Khop_1.SLDPRT, Khop_6.SLDPRT, robot_assembly.SLDASM]
2023-11-08 update: Reference gripper
    [13mm_gear_link.SLDPRT, 30mm_gear_4mm.SLDPRT, Gripper_Assembly.SLDASM, M2.5_Screw_for_Base_10mm.SLDPRT, M2.5_Screw_for_platform.SLDPRT, MX28T.SLDPRT, Nut_M2.5.SLDPRT, Retaining ring for 4mm.SLDPRT]
2023-11-09 update: Add driver files
2023-11-09 update: Fit driver file to control_glove project (build_status: OK)
2023-11-09 test: Driver uart transmit pollin ok
2023-11-09 test: Button APIs OK
2023-11-11 update: Clean matlab code
    [Assem1 - Khop3-1.STL, Assem1 - Khop_1-1.STL, Assem1 - Khop_2-1.STL, Assem1 - Khop_4-1.STL, Assem1 - Khop_5-1.STL, Assem1 - Khop_6-1.STL, HG_KG73B.stp_Default_sldprt.STEP, Khop3_Default_sldprt.STEP]
2023-11-12 update: Add reference gripper and docs
    [13mm_gear_link.SLDPRT, 30mm_gear_4mm.SLDPRT, Gripper_Assembly.SLDASM, M2.5_Screw_for_Base_10mm.SLDPRT, M2.5_Screw_for_platform.SLDPRT, MX28T.SLDPRT, Nut_M2.5.SLDPRT, Retaining ring for 4mm.SLDPRT]
2023-11-12 update: Caculate gripper
2023-11-15 update: Create timer for controlling MoveL
2023-11-15 update: Update feature for branch thach-test-plc
    [Assem1 - Khop3-1.STL, Assem1 - Khop_1-1.STL, Assem1 - Khop_2-1.STL, Assem1 - Khop_4-1.STL, Assem1 - Khop_5-1.STL, Assem1 - Khop_6-1.STL, HG_KG73B.stp_Default_sldprt.STEP, Khop3_Default_sldprt.STEP]
2023-11-23 update: A gripper
    [Assem1_mica.SLDASM, Part1-print.SLDPRT, Part1-print.STL, Part1.1-print.SLDPRT, Part1.1-print.STL, Part1.SLDPRT, Part1_mica.DWG, Part1_mica.SLDPRT]
2023-11-25 update: Set up drawing folder
    [De.0003.dwg, K2_Than.dwg, K4_Nắp.dwg, Template.0011.dwg, Template.dwg, [K0].0001.dwg, [K0].dwg, [K0]Nắp_dây_điện.0002.dwg]
2023-11-25 update: Add reference files
    [Khop_1.DWG, Khop_1.SLDDRW, Khop_2.SLDDRW, [K0].dwg, [K0]Nắp_dây_điện.dwg, [K0]Thân_Trụ.dwg, [K0]Tấm ốp.dwg, [K0]Đế.dwg]
2023-11-30 update: Clean name and folder
    [[K0]Than.SLDPRT, [K0]Vo_than.SLDPRT, [K1]Than.SLDPRT, robot_assembly.SLDASM]
2023-11-30 update: General format for 2D AutoCAD drawing
    [Template.dwg, [K0]Than.SLDPRT, [K0]Vo_than.SLDPRT, [K0]Đế.dwg, [K1]Than.SLDPRT]
2023-12-02 update: Clean and add template folder
    [Template.dwg]
2023-12-02 update: Clean template
    [Template.dwg]
2023-12-02 update: Khau 0 - Vo De
    [Template.dwg, [K0]VoDe.dwg]
2023-12-02 update: Khau 0 - Nap day dien
    [[K0]NapDayDien.dwg]
2023-12-02 update: Khau 0 - Than Tru
    [[K0]ThanTru.dwg]
2023-12-02 update: Khau 0 - De
    [[K0]De.dwg, [K0]ThanTru.dwg]
2023-12-02 update: Complete Mat_bich drawings
    [Template - Copy (2).dwg, Template - Copy (3).dwg, Template - Copy (4).dwg, Template - Copy.dwg, Template.dwg, Trục_Bánh răng.dwg, [K2.dwg, [K2]Mặt_Bích.dwg]
2023-12-03 update: Complete the drawings [K2]Nap
    [Template - Copy (2).dwg, [K2]Nắp.dwg, [K2]Nắp_temp.dwg]
2023-12-10 update: Xong cac chi tiet khong tieu chuan khau 0
    [[K0]NapDayDien.dwg, [K0]VoDe.dwg, [K1]MatBich.dwg]
2023-12-10 update: Xong cac chi tiet rau ria cho khau 0 va khau 1
    [[K0]VoDe.dwg, [K1]MatBich.dwg, [K1]NapKhau1.dwg, [K1]VongCan.dwg, [K1]Vòng cản.dwg]
2023-12-10 update: chi tiet khau 3 va tinh toan luc, vị tri tay gap
    [[K3]Nap.dwg, [K3]Nap_che_day_dien.dwg, [K3]Nap_che_than.dwg, [K3]Ong.dwg, [K3]Tam_Bat_dong _co.dwg, [K3]Tam_Cang_Dong_Co.dwg, [K3]Than.dwg, [K3]Tấm bắt_ĐộngCơ.dwg]
2023-12-16 update: Complete draw velocity and angle
2023-12-22 update: Start drawing [K2]Nap_che
    [Template - Copy (3).dwg, [K2]Nắp_che_temp.dwg, [K2]Nắp_temp.dwg]
2023-12-23 update: Clean khau 0
    [Khop_1.DWG, Khop_1.SLDDRW, Khop_2.SLDDRW, [K0]De.DWG, [K0]De.SLDDRW, [K0]De.SLDPRT, [K0]De.dwg, [K0]De_0.DWG]
2023-12-23 update: Save data to csv file and update realtime
    [data_robot_tinh_toan.csv]
2023-12-23 update: Add timer control button, start, stop record and close run_realtime button
2023-12-23 update: Clean project
    [13mm_gear_link.SLDPRT, 30mm_gear_4mm.SLDPRT, Gripper_Assembly.SLDASM, M2.5_Screw_for_Base_10mm.SLDPRT, M2.5_Screw_for_platform.SLDPRT, MX28T.SLDPRT, Nut_M2.5.SLDPRT, Retaining ring for 4mm.SLDPRT]
2023-12-24 update: Finish drawing and start drawing 3D
    [Khop_3.SLDPRT, Template - Copy - Copy (2).dwg, Template - Copy - Copy.dwg, [K2]Nắp_Thân.dwg, [K2]Nắp_che.dwg, [K2]Nắp_che_temp.dwg]
2023-12-26 update: Create drawings for frame 2 and 4
    [Template - Copy.dwg, [K4]Nắp.dwg, [K4]Thân.dwg, [K4]Trục.dwg]
2023-12-28 update: Finish converting Inventor2Solid 3D files
    [[K0]Nắp.stp, [K0]Nắp_dây_điện.stp, [K0]Thân_Trụ.stp, [K0]Đế.stp, [K0]Ốp_thân.stp, [K1]Mặt_Bích.stp, [K1]Mặt_nối.stp, [K1]Nắp_Đậy.stp]
2023-12-29 update: Modified Mat_Bich and finish assembling frame 2
    [Template - Copy - Copy (2).dwg, Template - Copy - Copy.dwg, Template - Copy.dwg, [K2]Assembly.SLDASM, [K2]Mặt_Bích_mod.stp, [K2]Mặt_Bích_mod.stp.SLDPRT, [K2]Nắp.stp.SLDPRT, [K2]Thân.dwg]
2023-12-29 update: Finish assembling frame 4
    [[K4]Assembly.SLDASM]
2023-12-29 fix: Merge conflict
    [Template - Copy (2).dwg, [K2]Nắp.dwg, [K2]Nắp_temp.dwg]
2023-12-29 update: gripper
    [Assem1.SLDASM, Assem1_mica.SLDASM, Khop_noi_mat_bich.stp.SLDPRT, Part1-1.SLDPRT, Part1-1.STL, Part1.1.SLDPRT, Part1.SLDPRT, Part1.STL]
2023-12-29 update: report is on-going at "Mô phỏng vị trí dựa trên kết quả tính toán"
2023-12-29 update: Trinh bay xong phan qua trinh tinh toan dong luc hoc
    [moment_quan_tinh.dwg]
2023-12-30 update: Finish "Mô phỏng vị trí dựa trên kết quả tính toán"
2023-12-30 update: bao cao C4-C5
    [Assem1.SLDASM, Assem1_mica.SLDASM, K2.SLDASM, [K0].SLDASM]
2023-12-30 update: Ve moment oke V va G
    [data_robot_tinh_toan.csv]
2023-12-30 update: Plot moment with D(q)
    [data_robot_tinh_toan.csv]
2023-12-31 update: Add result files
    [data_robot_L_J.csv, data_robot_hinh_tron.csv]
2024-01-01 update: Tay gap
    [Assem1_mica.SLDASM, Part1.left - p1.SLDPRT, Part1.left - p2.SLDPRT, Part1.right - p1.SLDPRT, Part4-3 - Copy.SLDPRT, Part4-3.SLDPRT, Part5.SLDPRT, mat-bich-m3.SLDPRT]
2024-01-01 update: Convert K0 K1
    [[K0]Nắp.stp.SLDPRT, [K0]Nắp_dây_điện.stp.SLDPRT, [K0]Thân_Trụ.stp.SLDPRT, [K0]Ốp_thân.stp.SLDPRT, [K1]Mặt_Bích.stp.SLDPRT, [K1]Mặt_nối.stp.SLDPRT, [K1]Nắp_Đậy.stp.SLDPRT, [K1]Vòng_Cản.stp.SLDPRT]
2024-01-01 update: Lap rap khop 0
    [K0.SLDASM, [K0].SLDASM, [K0]De.SLDPRT, [K0]Nắp.stp.SLDPRT, [K0]Nắp_dây_điện.stp.SLDPRT, [K0]Than_tru.SLDPRT, [K0]Thân_Trụ.stp.SLDPRT, [K0]Ốp_thân.stp.SLDPRT]
2024-01-01 update: Lap khop 1
    [K1.SLDASM, [K1]Than.SLDPRT]
2024-01-01 update: "Kết nối với MATLAB để thực hiện xử lí dữ liệu góc" is on-going, draw flowchart
    [Template.dwg, [K0]De.dwg, [K2]Nắp_Thân.dwg, [K2]Thân.dwg, [K2]Thân_3D.DWG, [K2]Thân_3D.SLDPRT]
2024-01-01 update: Ket qua chuong 7
    [data_robot_L_J.csv, data_robot_L_J_phan_tich.xlsx, data_robot_hinh_tron.csv, data_robot_tinh_toan.csv, data_robot_tinh_toan_cu.csv, data_robot_tinh_toan_moi.csv]
2024-01-02 update: Formatted chuong5 and drew flowchart for it
2024-01-02 update: Them chuong 8 va hinh chup vi tri robot
    [Assem1.SLDASM, Assem1_mica.SLDASM]
2024-01-02 update: Fullfil chuong6 by drawing some flowcharts
2024-01-03 update: Add file powerpoint
2024-01-03 update: Delete uneccessary files
    [Khop_3.SLDPRT, [K2]Mặt_Bích_temp.dwg, [K2]Nắp_Thân_temp.dwg, [K2]Thân_3D_temp.DWG]
2024-01-03 update: Clean powerpoint
2024-01-03 update: Create template
    [Template.dwg]
2024-01-03 Update: ban ve dien
    [Assem1_mica.SLDASM, Nguon.dwg, PLC Q02.dwg, Part1.left - p1 - x1 .STL, Part1.left - p1.STL, Part1.left - p2.STL, Part1.right - p1 - x1.STL, Part1.right - p1.STL]
2024-01-03 update: Xong khau so 0
    [K0.SLDASM, K0.dwg, K0_lap_rap.DWG, K0_lap_rap.SLDDRW, K1.dwg, [K0]De.SLDPRT, [K0]Hop_giam_toc.SLDPRT, [K0]O_lan.SLDPRT]
2024-01-03 update: Thao khau 2
    [K1.SLDASM, [K1]Than.SLDPRT]
2024-01-04 update: Xong khau 1
    [K1.SLDASM, [K1]HopGiamToc.SLDPRT, [K1]Nắp_Đậy.stp.SLDPRT, [K1]Than.SLDPRT, [K1]Thân.oke.SLDPRT, [K1]Thân.stp.SLDPRT, [K1]Truc.SLDPRT, [K1]Vòng_Cản.stp.SLDPRT]
2024-01-04 Update: ban ve lap K3-K4
    [Template.dwg, [K3-K4].SLDASM]
2024-01-04 update: them truc quay cho tay gap
    [Assem1_mica.SLDASM, truc-2cm.SLDPRT, truc.SLDPRT]
2024-01-04 update: Ban ve lap khau 1
    [K0.dwg, K1.SLDASM, K1.SLDDRW, K1.dwg, K1_temp.DWG, [K0]01.dwg, [K0]1_oke.dwg, [K0]2.dwg]
2024-01-04 update: finish ban ve lap khau 2
    [[K2]Assembly.DWG, [K2]Assembly.SLDASM, [K2]Mặt_Bích.stp, [K2]Mặt_Bích.stp.SLDPRT, [K2]Nắp.stp.SLDPRT, [K2]Thân_3D.SLDPRT, [K2]Thân_3D_temp.DWG, [K2]Vòng_Cản.stp]
2024-01-04 update: Editing K0
    [K0.dwg]
2024-01-04 update: Finish drawing ban ve lap khau 0 + 1
    [K0.dwg, K1.dwg, khau2.dwg]
2024-01-04 update: close all the drawing files
    [K0.dwg]
2024-01-04 update: So do dat luc
    [dat_luc.dwg]
2024-01-04 update: Export 5 ban ve dien
    [Nguon.dwg, PLC Q02.dwg, Servo1.dwg, Servo2.dwg, Servo3.dwg]
2024-01-04 update: Export drawings for completed cads files
    [[K0]1_oke.dwg, [K0]2.dwg, [K0]3.dwg, [K0]4.dwg, [K0]VoDe.dwg, [K1]10.dwg, [K1]6.dwg, [K1]7.dwg]
2024-01-04 update: Ban ve chi tiet tay gap
    [Assem1_mica.SLDASM, Part 5.dwg, Part-4.3.dwg, Part1-left-2.dwg, Part1-left-p1.dwg, Part1-right-p1 .dwg, Part1.left - p1.SLDPRT, Part1.right - p1.SLDPRT]
2024-01-04 UPdate: ban ve lap K5
    [Assem1_mica.DWG, [K5].dwg]
2024-01-04 update: Arrange files
    [[K0]1_oke.dwg, [K0]3.dwg, [K0]VoDe.dwg, [K1]6.dwg, [K1]7.dwg, [K2]Mặt_Bích_temp.dwg, [K2]Nắp_Thân_temp.dwg, [K2]Nắp_che_temp.dwg]
2024-01-04 update: Tong quan powerpoint
2024-01-04 update: Finish ban ve chi tiet
    [K0.dwg, K1.dwg, Part 5.dwg, Part-4.3.dwg, Part1-left-2.dwg, Part1-left-p1.dwg, Part1-right-p1 .dwg, [K0]3.dwg]
2024-01-04 update: Cherry-pick ban ve lap tay gap
    [[K5]-1.dwg]
2024-01-04 update: fix ban ve lap K5
    [[K5]-1.dwg]
2024-01-04 update: Fix the drawing titles
    [Part1-left-p1.dwg, Part1-right-p1 .dwg, [K5]-1.dwg]
2024-01-04 update: Finish ban ve lap
    [[K5]-1.dwg]
2024-01-04 update: ban ve 3d K3
    [[K3-K4].SLDASM, [K3[Nắp.stp.SLDPRT, [K3]Căn_chỉnh_ĐC.stp.SLDPRT, [K3]Mặt_Bích.stp.SLDPRT, [K3]Nap.stp.SLDPRT, [K3]Nắp_Thân.stp.SLDPRT, [K3]Nắp_Thân_22.stp.SLDPRT, [K3]Nắp_Đầu.stp.SLDPRT]
2024-01-04 update: cherry-pick ban ve
    [[K3-K4].SLDASM, [K3[Nắp.stp.SLDPRT, [K3]Căn_chỉnh_ĐC.stp.SLDPRT, [K3]Mặt_Bích.stp.SLDPRT, [K3]Nap.stp.SLDPRT, [K3]Nắp_Thân.stp.SLDPRT, [K3]Nắp_Thân_22.stp.SLDPRT, [K3]Nắp_Đầu.stp.SLDPRT]
2024-01-04 update: Final commit for drawings
    [Assem1_mica.SLDASM, K0.SLDASM, K1.SLDASM, Part5.SLDPRT, Template.dwg, [K1]Vòng_Cản.stp.SLDPRT, [K1]Động_cơ.stp.SLDPRT, [K2]Assembly.SLDASM]
2024-01-07 update: Findings for gripper
2024-01-09 update: Create 5 stl files for robot controlling
    [K1.STL, K3.STL, K4.STL]
2024-01-10 update: Complete embedding our robot into WPF
    [K0.SLDASM, K1.SLDASM, K1.STL, K3.STL, K4.STL, K5.STL, [K2]Assembly.SLDASM, [K4]Assembly.SLDASM]
2024-01-11 update: Temporarily finish set the axis for each joint
2024-01-18 update: New gripper
    [Gripper.SLDASM, Part1.SLDPRT, Part2.SLDPRT, Part3.SLDPRT, Part4.SLDPRT, Part5.SLDPRT, Part6.SLDPRT, Part7.SLDPRT]
2024-01-20 update: Create timer2 for optimizing FPS
2024-01-20 update: Timer 2 set 5s
2024-01-22 update: Finish reading data from camera on C#
2024-01-24 update: Create 2 buttons for checks and show image
2024-01-26 update: Finish fixing the mis-arranged image Reason: The data sent from camera is much than one pictures. Solution: Delete some bytes at the begining to meet the desired result
2024-02-04 update: Create project to use EmguCV to show the image from received data of camera
2024-02-04 update: Finish getting and displaying image from camera
2024-02-25 update: Format driver and bsp files
2024-02-25 update: Get data from magnetic success
2024-02-25 update: Plot data receive from magnetic sensor
2024-02-25 update: Test send data via UART from main app success
2024-03-08 update: Clean docs
    [moment_quan_tinh.dwg]
2024-03-10 update: Use thread instead of timer
2024-03-10 update: IMU filter run success
2024-03-10 update: Success to send data from uart to control robot
2024-03-10 update: Success to updatm real uart to robot to control
2024-03-16 update: Design angle control schematic
2024-03-16 update: Finish testing uart with adaptive control from PLC
2024-03-16 update: Control robot using apdative control through uart
2024-03-17 update: Apply madgwickAHRS for IMU success
2024-03-17 update: Apply madgwickAHRS for IMU and MARG success
2024-03-17 update: Optimize uart receive
2024-03-17 update: Add start frame
2024-03-17 update: Remove start frame
2024-03-23 update: Complete schematic design
    [control_glove_v0.1.kicad_pcb, control_glove_v0.1.kicad_sch]
2024-03-24 update: Test marg sensor calib
2024-03-29 update: Calib IMU success
2024-03-31 update: Read ADC very success
2024-03-31 update: Send pitch, roll yaw for test
2024-04-03 update: Get 3 angle correct
    [bsp_mpu6050.c]
2024-04-06 update: Success caculate forward kinematic for glove
2024-04-07 Update: Filter Noise
2024-04-07 update: Complete list and connect all components
    [control_glove_v0.1.kicad_pcb, control_glove_v0.1.kicad_sch]
2024-04-07 update: Pins for PCB
2024-04-12 update: Complete basic main module
    [glove_assembly.SLDASM, mieng_dem_cang_tay.SLDPRT, module_chinh.SLDPRT, thanh_noi_cang_tay.SLDPRT]
2024-04-12 update: PCB setup and arange component positions
    [MPU6050.stp, control_glove_v0.1.kicad_pcb, control_glove_v0.1.kicad_sch]
2024-04-13 update: Complete connect all components on PCB
    [GY-271 HMC5883L Triple 3 Axis Digital Compass.step, control_glove_v0.1.kicad_pcb, control_glove_v0.1.kicad_sch]
2024-04-14 update: Complete fix pcb
    [control_glove_v0.1.kicad_pcb, control_glove_v0.1.kicad_sch, coponents_list.xlsx]
2024-04-14 update: Connect to camera
2024-04-15 update: Excel file
    [coponents_list.xlsx]
2024-04-16 update: Test Control Glove v0.1 PCB success
    [control_glove_v0.1.kicad_pcb, control_glove_v0.1.kicad_sch]
2024-04-18 update: Success calib for shoulder IMU
2024-04-18 update: Add low pass filter average for RV1
2024-04-18 update: Convert RV1 ADC value to elbow angle success
2024-04-18 fix: Wireless UART module do not respone
    Set Pin need to HIGH
    [control_glove.ioc, main.c]
2024-04-18 update: Add Wireless UART module note
2024-04-19 update: Test reset sensor by power off success
    [bsp_i2c.c, bsp_i2c.h, main.c, sensor_manager.c]
2024-04-19 update: Success encrypt and decrypt data between device and MATLAB
2024-04-19 update: Complete test kinematic with shoulder and elbow
    [data.csv]
2024-04-20 update: Control glove space (not correct l1, l2)
    [get_data.py]
2024-04-20 update: Complete filter line noise in hough transform
2024-04-21 update: Add invert kinematic function
2024-04-21 update: Complete basic glove hardware v0.1 (need fixed size)
    [6mm Rigid Flange Coupling v2.step, 6mm Rigid Flange Coupling v2.step.SLDPRT, RV24 v6.step, RV24 v6.step.SLDPRT, USB-C PCB vertical.stp.SLDPRT, day_vecro.SLDPRT, glove_assembly.SLDASM, mieng_dem_cang_tay - Copy.SLDPRT]
2024-05-04 update: Update position and show on robot in GUI
    [data.csv]
2024-05-04 update: Optimize data transmission speed for UART
2024-05-04 update: Control virtual robot over glove successfully
    [data.csv]
2024-05-05 update: Vo pin
    [hexagonal_spacer_MF_M3_H05_HEX5_FTD3_MTL8.step.SLDPRT, nap_mach_sac.SLDPRT, vo_pin.SLDPRT]
2024-05-05 fix: Limitation for Z axis
2024-05-10 update: Design the transmission system at the wrist join
    [banh_rang.SLDPRT]
2024-05-11 update: Component list
    [coponents_list.xlsx]
2024-05-11 update: Add function in timer in order to test
2024-05-11 update: Add function to timer2
2024-05-11 update: Add glove_v0.1_part_1
    [8mm Rigid Flange Coupling v2.step, 8mm Rigid Flange Coupling v2.step.SLDPRT, glove_v0.1_part_1.SLDASM, hexagonal_spacer_MF_M3_H05_HEX5_FTD3_MTL8.step.SLDPRT, khuy_tay.SLDPRT, thanh_cang_tay.SLDPRT, thanh_khuy_tay.SLDPRT]
2024-05-12 update: Add 2 gear for control glove
    [banh_rang.SLDPRT, glove_v0.1_part_1.SLDASM, hexagonal_spacer_MF_M3_H05_HEX5_FTD3_MTL8.step.SLDPRT, truc_khuy_tay.SLDPRT]
2024-05-12 update: Design and optimize control glove mechanical
    [6mm Rigid Flange Coupling v2.step.SLDPRT, KFL08 - Mancal Flange oval Ø8.stp.SLDPRT, glove_v0.1_part_1.SLDASM, khuy_tay.SLDPRT, thanh_cang_tay.SLDPRT, thanh_khuy_tay.SLDPRT, truc_khuy_tay.SLDPRT]
2024-05-15 update: Add hole for imu module wires
    [glove_v0.1_part_1.SLDASM, thanh_khuy_tay.SLDPRT]
2024-05-17 update: Add switch and trigger button and remove unused components
    [control_glove_v0.1.kicad_pcb, control_glove_v0.1.kicad_sch, glove_v0.1_part_1.SLDASM]
2024-05-17 update: Change pcb size to 38 x 100
    [control_glove_v0.1.kicad_pcb]
2024-05-18 update: Complete connect thanh_cang_tay and thanh_khuy_tay
    [khuy_tay.SLDPRT, mieng_dem_canh_tay.SLDPRT, noi_cang_tay.SLDPRT, thanh_cang_tay.SLDPRT, thanh_khuy_tay.SLDPRT]
2024-05-19 update: Add mieng dem cang tay tay optimize design
    [khuy_tay.SLDPRT, mieng_dem_cang_tay.SLDPRT, mieng_dem_canh_tay - 2.SLDPRT, mieng_dem_canh_tay.SLDPRT, nap_mat_bich.SLDPRT, thanh_cang_tay.SLDPRT]
2024-05-19 update: Add autocad file for mica cutting
    [khuy_tay.DXF, khuy_tay.SLDDRW, khuy_tay_autocad.dwg, khuy_tay_autocad.dxf, thanh_cang_tay.DXF, thanh_cang_tay.SLDDRW, thanh_cang_tay_autocad.dwg, thanh_cang_tay_autocad.dxf]
2024-05-19 update: Connect all component completely
    [mica_3mm.dxf, mica_5mm.dxf, mieng_dem_cang_tay.SLDPRT, mieng_dem_canh_tay - 2.SLDPRT, mieng_dem_canh_tay.SLDPRT, nap_mach_sac.SLDPRT, thanh_khuy_tay.SLDPRT, vo_pin.SLDPRT]
2024-05-19 update: Print PCB v0.2
2024-05-24 update: Prepare files for mica cutting and 3d printing
    [khuy_tay.DWG, khuy_tay.DXF, khuy_tay.SLDDRW, khuy_tay.dwg, khuy_tay_5mm.dxf, khuy_tay_autocad.dwg, khuy_tay_autocad.dxf, mica_3mm.dxf]
2024-05-24 update: Add 3d estimate print file
2024-05-25 update: Re-cut mica
    [cat_lai_5mm.dwg, cat_lai_5mm.dxf]
2024-05-26 update: Create robot_data for trajectory planning
    [data.csv, test.csv]
2024-05-26 update: Calculate inversed jacobian for robot
    [test.csv]
2024-05-26 update: Create function to move every 10 points
    [test.csv]
2024-05-26 update: add Data .csv
    [outputfile1.csv, outputfile10.csv, outputfile2.csv, outputfile3.csv, outputfile4.csv, outputfile5.csv, outputfile6.csv, outputfile7.csv]
2024-05-31 update: Test get data and button handle
2024-05-31 update: Change UART module settings to reduce power consumption and I2C issues cause by lack of power
    [get_data.py]
2024-06-01 update: Design robot UART protocol
2024-06-01 update: filter noise by erosion and dilation.
2024-06-01 update: I'm try my best to filter noise in image, ye?
2024-06-02 update: Complete uart protocol encode and send (untested)
2024-06-02 fix: UART position data always zero
    [sensor_manager.c]
2024-06-02 update: Test frame sending Create graph to show data Create CRC function
2024-06-06 update: Optimize uart module send 19 bytes at one time and use 210 ms
2024-06-06 Update: Create Servo_manual.docx In progress for2. Giới thiệu từng module điều khiển
2024-06-07 update: Complete update nap pin
    [glove_v0.1_part_1.SLDASM, nap_mach_sac.SLDPRT, thanh_khuy_tay.SLDPRT, vo_pin.SLDPRT]
2024-06-07 update: Create tay cam file
    [tay_cam.SLDPRT]
2024-06-07 update: Export .stl files
    [nap_mach_sac.SLDPRT, nap_mach_sac_v2.STL, vo_pin_v2.STL]
2024-06-07 update: Add 2D drawing for thanh cang tay, thanh khuyy tay and thanh noi
    [Template.dwg, khuy_tay.dwg, thanh_cang_tay.dwg, thanh_khuy_tay.dwg, thanh_noi.dwg]
2024-06-08 update: Finish til 2. Q172HCPU và Servo Motor:
2024-06-09 docs: Update to design control robot arm algorithm
2024-06-09 update: Add K7 program to control velocity Add adaptive velocity control
2024-06-09 update: Send velocity to control robot
2024-06-09 update: Create function to using adaptive control with controlling velocity
2024-06-09 update: Test receive UART success
2024-06-09 update: Rename robot tool gui folder
    [K1.STL, K3.STL, K4.STL, K5.STL]
2024-06-10 fix: UART break when move control glove
2024-06-14 update: Add custom gear 6 mm
    [6mm Rigid Flange Coupling v2.step.SLDPRT, banh_rang.SLDASM, custom_gear.SLDPRT, glove_v0.1_part_1.SLDASM, spur gear_iso_m3.SLDPRT, thanh_khuy_tay.SLDPRT, truc_khuy_tay.SLDPRT]
2024-06-14 update: Add bearing 6 mm
    [Part1.SLDPRT, banh_rang.SLDASM, glove_v0.1_part_1.SLDASM, instrument ball bearing_68_am.SLDPRT, khuy_tay.SLDPRT, thanh_khuy_tay.SLDPRT, truc_khuy_tay.SLDPRT, vong_chan_truc_6mm.SLDPRT]
2024-06-15 update: Velocity control more stable
2024-06-15 update: Save velocity and position to .csv file success
    [data_handle.csv, test.csv]
2024-06-15 update: omega 1, omega 2, omega look like stable
    [5theta_3vel.csv]
2024-06-15 update: Control LED to "make color"
2024-06-16 update: Create the final ver for image processing
    [outputfile1.csv, outputfile10.csv, outputfile2.csv, outputfile3.csv, outputfile4.csv, outputfile5.csv, outputfile6.csv, outputfile7.csv]
2024-06-16 update: Optimize-tool Change velocity unit
2024-06-16 update: Enable velocity control
2024-06-16 fix: Velocity do not transmit to plc
2024-06-16 update: cherry pick polynomial regression
    [good.csv]
2024-06-16 update: Not send stream command when hold left button
2024-06-16 update: Reset raw data for test.csv
    [test.csv]
2024-06-16 update: Facing uncorrect data from poplynomial regression Need to modify the source code
    [good.csv, test.csv]
2024-06-16 update: Add hieu_packet to test uart
2024-06-17 update: polynomial_regression on matlab
    [polynomial_regression.csv, test.csv]
2024-06-17 update: Test UART failed, need to optimize C#
2024-06-17 fix: UART error fixed
2024-06-18 docs: Add 6mm bearing datasheet
2024-06-18 update: Add control glove v3
    [6mm Rigid Flange Coupling v2.step, 6mm Rigid Flange Coupling v2.step.SLDPRT, 8mm Rigid Flange Coupling v2.step, 8mm Rigid Flange Coupling v2.step.SLDPRT, KFL08 - Mancal Flange oval Ø8.stp.SLDPRT, Part1.SLDPRT, RV24 v6.step, RV24 v6.step.SLDPRT]
2024-06-19 update: Done the polynomial regression
    [test.csv]
2024-06-19 update: Complete basic concept design of v0.3
    [banh_rang.SLDASM, control_glove_v0.3.SLDASM, mieng_dem_canh_tay - 2.SLDPRT, mieng_dem_canh_tay.SLDPRT, noi_cang_tay.SLDPRT, thanh_cang_tay.SLDPRT, thanh_khuy_tay.SLDPRT]
2024-06-19 update: Still facing polynomial regression algorthim
    [good.csv, test.csv]
2024-06-20 update: Add red and green button
    [banh_rang.SLDASM, control_glove_v0.3.SLDASM, green_button.SLDPRT, red_button.SLDPRT, tay_cam.SLDPRT, tay_cam_asm.SLDASM]
2024-06-20 update: Complete tay_cam_asm
    [tay_cam.SLDPRT, tay_cam_asm.SLDASM, vo_tay_cam_2.SLDPRT]
2024-06-20 update: Optimize angle
    [banh_rang.SLDASM, control_glove_v0.3.SLDASM, dem_mat_bich.SLDPRT, khuy_tay.SLDPRT, mat_bich_6mm.SLDPRT, mieng_che_o_lan.SLDPRT, noi_cang_tay.SLDPRT, thanh_khuy_tay.SLDPRT]
2024-06-21 update: Optimize min angle to 60 degrees
    [banh_rang.SLDASM, mieng_dem_cang_tay.SLDPRT, mieng_dem_cang_tay_2.SLDPRT, mieng_dem_canh_tay - 2.SLDPRT, mieng_dem_canh_tay_2.SLDPRT, mieng_lot_dem_canh_tay_1.SLDPRT, noi_cang_tay.SLDPRT, thanh_cang_tay.SLDPRT]
2024-06-21 update: Fix all bug
    [banh_rang.SLDASM, mieng_dem_cang_tay.SLDPRT, mieng_dem_canh_tay - 2.SLDPRT, mieng_lot_dem_canh_tay_1.SLDPRT, thanh_khuy_tay.SLDPRT, vo_pin.SLDPRT]
2024-06-21 update: Complete control glove asembly
    [banh_rang.SLDASM, khuy_tay.SLDPRT, mieng_che_o_lan.SLDPRT, mieng_dem_cang_tay_2.SLDPRT, noi_cang_tay.SLDPRT, tay_cam_asm.SLDASM, thanh_cang_tay.SLDPRT, thanh_khuy_tay.SLDPRT]
2024-06-21 update: Add driver to control LED
2024-06-22 fix: I2C fail to communicate with IMU
    [sensor_manager.c, system_manager.c]
2024-06-22 fix: Bug in low pass filter
    [sensor_manager.c]
2024-06-22 update: Clean code and fix low pass filter in velocity control
    [sensor_manager.c]
2024-06-22 update: Add STL for 2 part of control glove
2024-06-22 update: Create low pass filter for stable the input data
    [good.csv, test.csv]
2024-06-22 update: Success import glove.stl to view
2024-06-22 update: Create function to save csv files
    [trajectory.csv, trajectory_1.csv]
2024-06-22 update: Create delete function, write status and point status
    [trajectory.csv, trajectory_1.csv]
2024-06-23 update: Create folder to handle cad files
    [Template.dwg, banh_rang.SLDPRT, custom_gear.SLDPRT, dem_mat_bich.SLDPRT, khuy_tay.SLDPRT, khuy_tay.dwg, mieng_che_o_lan.SLDPRT, mieng_dem_cang_tay.SLDPRT]
2024-06-23 update: Finish testing take data from csv to control robot trajectory Remember everytime to run -> Set speed for robot
    [trajectory.csv]
2024-06-23 fix: Swap led red and led green
    [main.h]
2024-06-23 update: Add led indicator to check status of device
2024-06-23 update: Print yaw angle
2024-06-23 update: Draw 2d for dem mat bich and add some docs
    [dem_mat_bich.DWG, dem_mat_bich.SLDDRW, dem_mat_bich.dwg, khuy_tay.DWG, khuy_tay.SLDDRW, thanh_khuy_tay.DWG]
2024-06-23 update: Export schematic file to .dwg success
    [control_glove_v0.1_dung_ki_hieu.dwg, control_glove_v0.1_dung_ki_hieu.dxf, control_glove_v0.1_dung_ki_hieu.kicad_sch, glove_0.2.dwg]
2024-06-24 update: Test init yaw success and need to improve elbow angle
2024-06-24 fix: Yaw angle do not update value when calib mode
    [sensor_manager.c, system_manager.c]
2024-06-24 update: Add velocity feature and change some params
2024-06-24 update: Prepare files to mica cutting and 3d printing
    [2d.DWG, 2d.SLDDRW, 3mm.dwg, 3mm.dxf, 5mm.dwg, 5mm.dxf, banh_rang.SLDASM, banh_rang.SLDPRT]
2024-06-24 update: Change 3d printing from 80% to 90%
    [banh_rang.SLDPRT, banh_rang_1.STL, banh_rang_2.STL, dem_mat_bich.SLDPRT, dem_mat_bich.STL]
2024-06-24 update: Create update 100 points for velocity create velocity function
2024-06-24 update: Modify velocity funtion
2024-06-24 docs: Complete basic content of electric drawing
    [control_glove_v0.1_dung_ki_hieu.dwg, control_glove_v0.1_dung_ki_hieu.dxf, control_glove_v0.1_dung_ki_hieu.kicad_sch, glove_0.2.dwg]
2024-06-24 update: Create velocity conversion
    [conveyor1_in.csv]
2024-06-25 update: Creation function to load velocity for plc
2024-06-25 update: delete small regions to filter noise
2024-06-25 update: Complete content of electric drawing, need optimize line width
    [glove_0.2.dwg]
2024-06-25 update: Create function to load image
    [conveyor1_in.csv, home.csv]
2024-06-25 update: Create raw data for 8 points
    [conveyor1_in.csv, conveyor1_out.csv, conveyor2_in.csv, conveyor2_out.csv, conveyor3_in.csv, conveyor3_out.csv, home.csv]
2024-06-25 update: Test khong gian gang tay
    [data.csv]
2024-06-25 update: Successfully testing moving to the last point
    [conveyor1_in.csv, conveyor1_out.csv, conveyor2_in.csv, conveyor2_out.csv, conveyor3_in.csv, conveyor3_out.csv, home.csv]
2024-06-25 update: Temporary finish trajectory control for robot
    [conveyor1_in.csv, conveyor1_out.csv, conveyor2_in.csv, conveyor2_out.csv, conveyor3_in.csv, conveyor3_out.csv, conveyor4_in.csv, conveyor4_out.csv]
2024-06-26 update: create home position for robot finish state machine for plc trajectory
    [conveyor1_out.csv, conveyor2_out.csv, conveyor3_out.csv, conveyor4_out.csv]
2024-06-27 update: Complete conveyor plc code v15.0
2024-06-28 update: Unknow commit 27-6
    [data.csv]
2024-06-28 update: Complete basic 6 drawings
    [banh_rang.DWG, banh_rang.SLDASM, banh_rang.SLDDRW, banh_rang.dwg, khuy_tay.dwg, mieng_che_o_lan_1.DWG, mieng_che_o_lan_1.SLDDRW, mieng_che_o_lan_1.dwg]
2024-06-29 update: Convert all part
    [hop_tay_cam_1.DWG, hop_tay_cam_1.SLDDRW, hop_tay_cam_2.DWG, hop_tay_cam_2.SLDDRW, mieng_dem_cang_tay_1.SLDDRW, mieng_dem_cang_tay_2.DWG, mieng_dem_cang_tay_2.SLDDRW, mieng_dem_canh_tay.DWG]
2024-06-29 update: Add .asm files
    [banh_rang.SLDASM, canh_tay_cang_tay_asm.DWG, canh_tay_cang_tay_asm.SLDDRW, control_glove_v0.1.kicad_pcb, mach_sac.SLDPRT, phan_cang_tay_asm.SLDDRW, phan_canh_tay_asm.DWG, phan_canh_tay_asm.SLDASM]
2024-06-29 update: Firmware architector and frame
2024-06-29 update: ađ Circle detection
    [conveyor1_in.csv, conveyor1_out.csv, conveyor2_in.csv, conveyor2_out.csv, conveyor3_in.csv, conveyor3_out.csv, conveyor4_in.csv, conveyor4_out.csv]
2024-06-29 update: Create Circle detection Add M111 to control valve
2024-06-29 update: Only use select button
    [conveyor1_in.csv, conveyor1_out.csv, conveyor2_in.csv, conveyor2_out.csv, conveyor3_in.csv, home.csv]
2024-06-29 update: Create csv and update code
    [conveyor1_in.csv, conveyor1_out.csv, conveyor2_in.csv, conveyor2_out.csv, conveyor3_in.csv, conveyor3_out.csv, conveyor4_in.csv, conveyor4_out.csv]
2024-06-29 update: Delete csv files
    [conveyor1_in.csv, conveyor1_out.csv, conveyor2_in.csv, conveyor2_out.csv, conveyor3_in.csv, home.csv]
2024-06-29 update: Test buoi toi t7
    [conveyor1_in.csv, conveyor1_out.csv, home.csv]
2024-06-29 update: Add so do luc
    [banh_rang.SLDASM, dat_luc.dwg, moment_quan_tinh.dwg, phan_canh_tay_asm.SLDASM, robot_cac_so_do.dwg, truc_khuy_tay_6mm.SLDPRT]
2024-06-30 update: complete báo cáo phần xử lí ảnh
2024-06-30 update: Complete sensor chart and
    [ban_ve_lap_.dwg, hop_tay_cam_1.DWG, hop_tay_cam_1.dwg, hop_tay_cam_2.DWG]
2024-06-30 update: Update current final report
2024-06-30 update: Finish seeding data and test system control
    [conveyor1_in.csv, conveyor1_out.csv, conveyor2_in.csv, conveyor2_out.csv, conveyor3_in.csv, conveyor3_out.csv, conveyor4_in.csv, conveyor4_out.csv]
2024-06-30 update: Modify code to run system control
    [conveyor1_out.csv, conveyor2_out.csv, conveyor3_out.csv, conveyor4_out.csv]
2024-06-30 update: Add moment data
    [moment_oke.csv, moment_oke.xlsx]
2024-07-01 update: Xong phan calib va li thuyet
    [bientro.csv, data.csv, gia_tri_acc_sau_calib.csv, gia_tri_acc_truoc_calib.csv, gia_tri_gygro_sau_calib.csv, gia_tri_gygro_truoc_calib.csv]
2024-07-01 update Temp
    [ban_ve_lap_.dwg, ban_ve_lap_tay_cam.dwg, ban_ve_lap_thiet_bi_theo_doi_chuyen_dong.dwg, banh_rang.SLDASM, canh_tay_cang_tay_asm.DWG, canh_tay_cang_tay_asm.SLDDRW, phan_canh_tay_asm.SLDASM]
2024-07-01 update: complete report băng tải và cảm biến.
2024-07-03 update: Ban ve lap
    [ban_ve_lap_thiet_bi_theo_doi_chuyen_dong.dwg, banh_rang.SLDASM, canh_tay_cang_tay_asm.SLDDRW, phan_canh_tay_asm.SLDASM, thiet_bi_theo_doi_chuyen_dong_oke.dwg]
2024-07-03 update: update documents
    [mieng_dem_cang_tay2.dwg, mieng_dem_cang_tay_1.DWG, mieng_dem_cang_tay_1.SLDDRW, mieng_dem_cang_tay_1.dwg, mieng_dem_cang_tay_2.DWG, mieng_dem_canh_tay.DWG, mieng_dem_canh_tay.dwg, nap_pin.dwg]
2024-07-03 update: Xong phan tinh ma tran xoay gang tay
    [robot_cac_so_do.dwg]
2024-07-04 update: Lưu đồ băng tải, cấu hình AL1100
2024-07-04 update: tong hop ban ve dien
    [2.dxf, 6.dxf, Servo1.dwg, _6 - Copy.dwg]
2024-07-04 update: Them phan test ket qua
    [bien_tro.csv, data.csv, do_chinh_xac.xlsx, giu_nguyen_tay.csv, lap_lai_quy_dao_lien_tuc.csv, thay_doi_dot_ngot.csv]
2024-07-05 update: Rename drawing prepare for final clear
    [HCMUTE-001-.dwg, HCMUTE-002-.dwg, HCMUTE-003.dwg, HCMUTE-004.dwg, HCMUTE-005.dwg, HCMUTE-006.dwg, HCMUTE-007-.dwg, HCMUTE-008.dwg]
2024-07-05 update: Hoan thanh 70% tat ca ban ve
    [HCMUTE-001-.dwg, HCMUTE-001.dwg, HCMUTE-002-.dwg, HCMUTE-002.dwg, HCMUTE-003.dwg, HCMUTE-004.dwg, HCMUTE-005.dwg, HCMUTE-006.dwg]
2024-07-05 update: Changing files for update moment of iteria and update latest document
    [K0.SLDASM, K0.STEP, K1.SLDASM, K1.STEP, K1.STL, K3.STL, K4.STL, K5.STL]
2024-07-05 update: Add final test data
    [5theta_3vel.csv, conveyor1_in.csv, conveyor1_out.csv, conveyor2_in.csv, conveyor2_out.csv, conveyor3_in.csv, conveyor3_out.csv, conveyor4_in.csv]
2024-07-05 docs: Clean folder
    [moment_oke.csv, moment_oke.xlsx]
2024-07-05 complete: doc và bản vẽ điện
2024-07-05 update: Finish editing parameter for joints in Solidworks
    [Assem1.SLDASM, Assem1_mica.SLDASM, Khop3.SLDPRT, Khop_2.SLDPRT, Khop_4.SLDPRT]
2024-07-06 update: lựa chọn giác hút
2024-07-06 update: lưu đồ điều khiển băng tải
2024-07-06 update: kết quả phần thực hiện hệ thống 5.1.1
2024-07-06 update: create csv
    [outputPath.csv, outputPath_result.csv, outputPath_result.xlsx]
2024-07-06 update: Add ket qua moment va auto test
    [conveyor1_in.csv, conveyor1_out.csv, conveyor2_in.csv, conveyor2_out.csv, conveyor3_in.csv, conveyor3_out.csv, conveyor4_in.csv, conveyor4_out.csv]
2024-07-07 update: Fix bản vẽ điện
    [PLC Q02.dwg]
2024-07-07 update: Xong noi dung cho toan bo ban ve
    [HCMUTE-001.dwg, HCMUTE-002.dwg, HCMUTE-003.dwg, HCMUTE-004.dwg, HCMUTE-005.dwg, HCMUTE-006.dwg, HCMUTE-007-.dwg, HCMUTE-008.dwg]
2024-07-07 update: Clean autocad files
    [BAN_VE_LAP_THIET_BI_THEO_DOI_CHUYEN_DONG.dwg, HCMUTE-001.dwg, HCMUTE-002.dwg, HCMUTE-003.dwg, HCMUTE-004.dwg, HCMUTE-005.dwg, HCMUTE-006.dwg, HCMUTE-007-.dwg]
2024-07-07 update: Clean ban ve lap
    [BAN_VE_LAP_THIET_BI_THEO_DOI_CHUYEN_DONG.dwg]
2024-07-07 docs: Add ban ve A0 cho robot 5 bac
    [BAN_VE_LAP_THIET_BI_THEO_DOI_CHUYEN_DONG.dwg, HCMUTE-001.dwg, HCMUTE-002.dwg, HCMUTE-003.dwg, HCMUTE-004.dwg, HCMUTE-005.dwg, HCMUTE-006.dwg, HCMUTE-007.dwg]
2024-07-08 update: Tong hop full ban ve va danh so bang, hinh anh
    [K0.dwg, K1.dwg, ROBOT_A0.dwg, ROBOT_ALL.dwg, ROBOT_ALL_CONVERT.DWG, [K0]1_oke.dwg, [K0]3.dwg, [K0]VoDe.dwg]
2024-07-08 update: Con thieu truoc calib gygro
    [bientro.csv, bientro.xlsx, gia_tri_acc_sau_calib.xlsx, gia_tri_gygro_truoc_calib.csv]
2024-07-08 update: Hoan thanh phan lien ket ca 3 lai voi nhau
    [gia_tri_acc_sau_calib.xlsx]
2024-07-11 update: Them so hieu vao ban ve lap
    [ROBOT_A0.dwg, dat_luc.dwg, data.csv, khau2.dwg, khau3_4.dwg, khau_0_A0.dwg, khau_1_A0.dwg, khau_2_A0.dwg]
2024-07-14 update: Xong ban ve
    [BAN_VE_LAP_345_A3.dwg, BAN_VE_LAP_THIET_BI_THEO_DOI_CHUYEN_DONG.dwg, HCMUTE-013.dwg, HCMUTE_0001_001.dwg, HCMUTE_0002_001.dwg, HCMUTE_0003_001.dwg, HCMUTE_0004_001.dwg, HCMUTE_0006_001.dwg]
2024-08-18 update: Final drawings
    [BAN_VE_LAP_THIET_BI_THEO_DOI_CHUYEN_DONG_A0.dwg, BAN_VE_LAP_THIET_BI_THEO_DOI_CHUYEN_DONG_A3.dwg, BĂNG TẢI.dxf, CÁNH TAY ROBOT.dxf, HCMUTE-001.dwg, HCMUTE-002.dwg, HCMUTE-003.dwg, HCMUTE-004.dwg]
